sparkiscool/nox/nox/box/box-electronics.md

# Box electronics v1 (24 Oct 2026)

The box's electrical system end to end: mains to the 24 V supply, four rails, the box computer and its I/O, the stepper board, the keep-alive to the funnel panel probes, the two live bays and their charger, the swap state machine with every abort, wire gauges, connectors and the cut list. Numbers: `nox/box/box_electronics.py` (placement search, nets, drops, budget, cut list, diagrams); run `runs/box_electronics/v1/` (`result.json`, `diagram.html` with `schematic.svg`, `brake.svg` (the brake relay wiring and the keep-alive / seat-sense circuit), `layout.svg`, `states.svg`). Interface numbers: `nox/dimensions.md` I "Box electronics v1". Arm harness (the 22-wire twist bundle): `nox/box/box-wiring.md`. Buy rows: `nox/parts-list.md` Box. C unless tagged; board sizes spec or E; **DEFAULT** = chosen without Spark, alternative in `nox/log.md`.

No printed part: every board sits on nylon standoffs on the rear clear sheet, so nothing here goes through `solid_check`.

## What it is
| Block | Choice | Tag |
|---|---|---|
| Supply | Mean Well LRS-350-24 (on hand), 24 V 14.6 A, on the rear sheet (moved from the floor spot, see Layout); IEC C14 fused switched inlet; **set the PSU's 115 / 230 V selector to 115 V** | spec / DEFAULT |
| 24 V distribution | 6-way blade fuse box with negative bus: F1 10 A charger, F2 5 A motion (through the E-stop), F3 3 A keep-alive buck, F4 2 A logic buck, 2 spare | DEFAULT |
| E-stop | 22 mm mushroom, NC, in F2: cuts the SKR (steppers) and the servo buck (all 6 servos). Pi, keep-alive and charger stay on: the drone stays powered and the latch self-locks | DEFAULT |
| Keep-alive | XL4016-class CC/CV buck, **13.0 V CV, 3.0 A CC** (one setting for both drones: Scout ~8.5 W, Overseer ~24 W, E) → relay K1 → INA226 (0x41) → **2 spring pins in the +x plain funnel face (B+); 2 in the −x plain face (B−) = box GND**, panel v9 plain (keep-alive concept, `runs/keepalive_contacts/concept/` (catch, Spark 24 Oct: face probes, belly post and KW11 gone)); seat sense through the drone's 10 kΩ across its pads | E / DEFAULT |
| Servo rail | XL4016-class buck, **6.0 V** for all 6 servos (4 hook-latch MG90S, DS3218, MG995) | DEFAULT |
| Logic rail | 24 → 5.1 V 5 A buck (Pololu D36V50F5 class): Pi on its 5 V pins, relay JD-VCC, the 5 hall switches | DEFAULT |
| Box computer | **Raspberry Pi 4 B 2 GB** + GPIO screw-terminal HAT: Klipper host + Moonraker + `boxd` (the swap state machine, Python) | DEFAULT |
| Steppers | BTT SKR Mini E3 V3 (on hand), Klipper MCU over USB: X = head A, Y = head B, Z = axle, E spare | DEFAULT |
| Servos | PCA9685 (I2C 0x60, A5 bridged) on the Pi: ch 0..3 latch L1, L2, R1, R2; ch 4 gripper A (DS3218), ch 5 gripper B (MG995); 50 Hz | DEFAULT |
| Current sense | 3 x INA226 modules, shunt replaced by **R010 2512** (full scale 8.19 A, LSB 0.25 mA): keep-alive 0x41, bay S 0x44, bay O 0x45 | DEFAULT |
| Relays | one 4-ch 5 V opto board (SRD-05VDC-SL-C, 10 A 30 VDC): K1 keep-alive, K2 bay S, K3 bay O, K4 gripper servo power (stall cut) | DEFAULT |
| **Head and axle brake (arm v6 / v7 requirement, 24 Oct)** | **3 DPDT 24 V relays KB1 / KB2 / KB3 (Omron G2RL-2 DC24 class, 8 A contacts, spec), one per head motor and one on the axle motor, one pole per coil: de-energised (NC) each coil is shorted on itself, energised (NO) it is on its TMC2209; coils on the motion branch after the E-stop, switched by a bare ULN2003A from one SKR `output_pin` per motor, sequenced against the driver enable; self-test at every boot** (section Head brake) | DEFAULT / CHECK |
| Charger | dual-channel DC charger on the 24 V bus, **iCharger 456DUO class (MODBUS over USB to the Pi, CHECK that the 456DUO speaks the 4010DUO map before buying)**, input limit 6.5 A, end 4.15 V per cell, starts below 35 °C | DEFAULT / CHECK |
| Live bays | 2 (Spark 16 Oct: one per drone size): **Scout bay at −90°**, **Overseer bay at 180° (= −180°)**, both bays of that type in the v2 ring (box structure v2 layout, `dimensions.md` System box structure; arm v7 BAYS); 9 bays built (Spark 24 Oct), the other 7 bench-charged until more charger channels (Spark); each bay's XT60E1-M (float carrier) through its relay | DEFAULT |

**Why 6.0 V and not 6.8 V for the servos:** the MG90S is rated 4.8..6.0 V (E); one rail at 6.0 V serves all six with one buck. The grippers need ~0.18 N·m (E, `dimensions.md` I XT60 mate) against ≥ 1.0 N·m available at 6.0 V (E), so the 6.8 V of `box-wiring.md` bought nothing. Alternative: 6.8 V gripper rail + 5 V latch rail (two bucks).

## Gripper servos (heads v7, 24 Oct)
The head grabber's servo (DS3218 on head A, MG995 on head B) opens the blades with a printed cam on two 623ZZ rollers and needs only 2.3 kg·cm (C, heads v7). A DS3218 stalled on a jammed blade puts ~163 N on a roller (76 MPa Hertz on the PETG cam, it dents; heads v7, E). So (heads v7 ask, DEFAULT here):
- **Two dwell positions only:** `boxd` commands each gripper to open or rest, nothing between, and moves one gripper at a time.
- **Stall cut:** the shared 6.0 V gripper pair runs through relay K4 (the spare channel) and an INA226 (0x40; the PCA9685 moves to 0x60, A5 bridged, so every INA226 address is a plain A0 / A1 jumper, CHECK the modules). During a move the idle gripper's PWM channel is off and `boxd` reads the pair's baseline for 100 ms first (E); a rise over the stall threshold for 0.5 s (E) opens K4 and aborts the move (A5): DS3218 1.8 A, MG995 1.0 A (E, CHECK on the bench against the running current at 2.3 kg·cm). K4 cuts both grippers: in PRESTAGE head B waits open under the seat, so its gripper must hold open unpowered: heads v7 confirms both dwells hold unpowered (rest: the spring closes the carriers, the cam 1.0 clear of the rollers; open: both rollers on the cam's constant-radius open dwell, 10° wide, E, forces through the shaft and cancelling), on condition the open command lands inside that dwell (CHECK on the bench: the DS3218 / MG995 settle to about 1..2°, E).
- **Grip halls:** two analog halls per head (DRV5055A4 class, at 3.3 V) at the grip, as in the latch's seat check. Their 3.3 V comes from the rear sheet upstream of K4 (an AP2112K-3.3 on the 5.1 V bus, also feeding the ADS1115 at 3.3 V, so no hall output exceeds the ADC's VDD and the I2C pull-ups stay at 3.3 V), so they stay live through a stall cut and at boot. On each head the two outputs are summed 3:1 through resistors (10 k / 30 k, E) onto one line (DEFAULT): open / squeezed on either side give 4 distinct levels (E, CHECK on the bench); the ADS1115 (0x48) reads H_A and H_B single-ended against the ribbon's servo ground, so `boxd` samples them only with that head's servo idle (no current in the return, DEFAULT; alt: a hall ground of their own, a 6th ribbon conductor). Each head ribbon gains 2 wires (H, 3.3 V) and the twist bundle 3 (19 → 22, `box-wiring.md`). Alt: both hall lines per head (ribbon 6, bundle 24).

## Box computer I/O (Pi 4, BCM numbers)
| Pin | Use | Notes |
|---|---|---|
| GPIO 2 / 3 | I2C1 SDA / SCL, 100 kHz | PCA9685 0x60 (A5 bridged), INA226 0x40 / 0x41 / 0x44 / 0x45 (A0 / A1 jumpers, CHECK), ADS1115 0x48 (ADDR to GND, at 3.3 V); avoid 0x70 (PCA all-call) |
| GPIO 4 | PCA9685 OE | 10 kΩ pull-up to 3.3 V: servo outputs off until `boxd` pulls it low (no twitch at boot) |
| GPIO 5, 6, 7, 8 | relay IN1..IN4 (K1 keep-alive, K2 bay S, K3 bay O, K4 gripper servo power) | active low; these pins boot pulled up (relays off); SPI0 disabled; board VCC = Pi 3.3 V, JD-VCC = 5.1 V bus, JD jumper removed |
| GPIO 17, 27, 22, 23 | hook-latch halls L1, L2, R1, R2 | A3144 open collector on 5 V, 10 kΩ pull-up to 3.3 V at the HAT; **low = plunger fully out** |
| GPIO 24 | seat sense (replaces the KW11) | 100 kΩ (E) pull-up to 3.3 V at the HAT, a 1 kΩ series resistor, a 5 V TVS leaking ≤ 1 µA at 3.3 V (ESD9L5.0 class, CHECK) from the BAT54 side of the 1 kΩ to GND, then a BAT54 Schottky (anode toward the GPIO, cathode on the B+ line at the INA226 out, downstream of K1); an SMBJ15A on the B+ line takes ESD from the exposed pins. With K1 open a seated drone's **10 kΩ** (concept) pulls the pin to ~0.52 V (E, CHECK: 0.29 pull-up current on 10 kΩ + 0.03 on the 1 kΩ + ~0.2 BAT54 at 30 µA) = low = seated; **this needs an ideal diode on both drones** (concept: LM74700, reverse leakage ~µA); a Schottky ORing diode leaks up to ~100 µA warm (PMEG4050EP class, E), 1.0 V on 10 kΩ, over the Pi's 0.8 V low (then 2.2 kΩ, the alternative). The INA226 cannot read the concept's 1.3 mA with K1 closed: its ±10 µV offset on R010 is ±1 mA (spec). No drone = high; with K1 closed the line is at 13.0 V, the diode blocks and the pin reads high (`boxd` ignores it from LATCH_OUT to LATCH_IN, as the KW11 was) |
| GPIO 25 | INA226 0x41 ALERT | open drain, 10 kΩ pull-up; set at 2.5 A: fast trip for A3 |
| USB | SKR (Klipper), later the hub camera | |
Unit naming: L = the W −X seated face, R = +X; 1 = Y_C − 100 (stub side), 2 = Y_C + 100 (`dimensions.md` G Hook latch: drone ±y faces are W ∓X).

## SKR Mini E3 V3 (Klipper, `printer.cfg` sketch; pin names from Klipper's SKR Mini E3 V3 sample config, CHECK)
- `[printer] kinematics: none`; three `[manual_stepper]`: **head_a** on the X driver (PB13 / PB12 / PB14, UART addr 0), **head_b** on Y (PB10 / PB2 / PB11, addr 2), **axle** on Z (PB0 / PC5 / PB1, addr 1). TMC2209 UART PC11 / PC10.
- Heads: `rotation_distance` 50.27 (16T m1 pinion, `dimensions.md` I Rack and pinion v5), run current 2.0 A (XT60 insert), last 12 of an insert at ≤ 20 mm/s. Homing sensorless into a **park hard stop** (X / Y DIAG jumpers on, `endstop_pin: tmc2209_<stepper>:virtual_endstop`, 10 mm/s; the hard stop is the arm session's, PR "kept").
- Axle: `rotation_distance` 72 (degrees per motor turn at 5:1, 16T pulley, C from arm v7); home on the axle A3144 at Z-STOP (PC2, `^`, Z DIAG jumper off), then the detent picks the notch (`box-arm.md` Homing). **Per-bay gravity offset (required, arm v7 concept PASS, PR 79):** each bay's axle step target = its nominal angle + an offset in steps measured at commissioning (jog until the head's insert pose lines up with the bay receiver, store it in `boxd`'s bay table); without it the Overseer roll reads 1.19° against the XT60's ±1.06° float (C, arm). **Sag check** (DEFAULT): at commissioning and after any arm service, per bay, the head's roll at the insert pose with the offset applied is measured (inclinometer on the head flat) and must be ≤ ±0.55° (E: the residual the arm's XT60 budget allows, ≤ ~65 % of the Overseer's 0.85° free roll; the offset as designed leaves 0.43°, E, arm PR 79); a bay that fails is re-offset before use. **Slow notch pass:** every axle move runs ≤ 100 full steps/s (E, arm) through each detent notch it crosses and into the target notch, fast between notches.
- Stall: TMC2209 StallGuard on X / Y reported through `[gcode_button]` on the DIAG pins during fast moves; `boxd` aborts (A5). StallGuard is unreliable at the slow insert speed, so the gate there is the outcome check (mate current, full stroke).
- Hold: idle = the brake order (section Head brake): `MANUAL_STEPPER ... ENABLE=0` on all three, `G4 P30`, then all three brake pins to 0; Klipper's `[idle_timeout]` gets that as its `gcode:` (its default M84 would disable the drivers and leave the brakes released). The detent holds the arm at rest (`box-wiring.md`).

## Head brake (arm v6 / v7 requirement, hub 24 Oct)
**Why:** unpowered, a head carrying a cartridge outweighs the NEMA17's cogging and falls 77.6 (E, arm v7: head + carriage + cartridge onto the TPU bumper) with the driver off. With an Overseer cartridge that fall reads 2.43 on the 625ZZ (E), so the arm's gate is a passed bench drop before the first Overseer swap. With the Scout, the arm's fallback (sized for the fall, 0.83, E) holds. The numbers are in `dimensions.md` System box swap: arm (Head brake, Results; branch part/swap-arm-v7). With each coil shorted on itself, back-EMF brakes the fall to a creep: about 8 mm/s with a Scout head (391 g, E) and about 19..23 mm/s with an Overseer head (~930 g, E). That uses Kt 0.21 N·m/A and 1.4 Ω per coil, rising to ~1.75 Ω with the 26 AWG bundle, pigtails and contacts (E). It lands gently in both cases.
- **Contacts (3 relays, one DPDT per motor, one pole per coil):** pole common = coil wire 1, NO = driver output 1, NC = coil wire 2. Coil wire 2 also stays wired to driver output 2. **De-energised: each coil is shorted on itself and driver output 1 is open, so the driver is never shorted.** Energised: the coil is on its driver as usual. KB1 is on head A, between the arm bundle and the SKR X header; KB2 is on head B, on the Y header; **KB3 on the axle motor, on the Z header (arm v7, hub 24 Oct; kept, required with the boot self-test):** with the detent springs x1.3 at 5:1 the detent holds with a head out at a horizontal Overseer bay (index 1.04, no creep, E from arm v7 PR 79, which also has the brake damp the rest); the brake is the second line on a power cut. The axle runs 5:1 (16T pulley, C).
- **Coils:** 24 V, ~17 mA each (E), from the motion branch after the E-stop (F2). Each is switched low-side by one channel of a **bare ULN2003A** (DIP-16 on a small perfboard, COM pin 9 to the 24 V motion branch for its flyback diodes, pin 8 to the SKR's GND). Do not use a 28BYJ-48 "ULN2003 module": it is rated 5..12 V and its LEDs on COM take ~22 mA each at 24 V (E). **Power off, E-stop, F2 open, a Klipper shutdown or an MCU reset leaves the input low or floating, the relay drops and the brake is on.**
- **Signal (its own pin, never the driver enable):** one free 3.3 V (C, STM32 I/O) SKR pin per motor (EXP1, which pins: CHECK on the SKR Mini E3 V3 pinout), as `[output_pin head_a_brake]` (and `head_b_brake`, `axle_brake`) with `value: 0` and `shutdown_value: 0`. The order is fixed so that the relay never switches a live driver (Trinamic: never connect or disconnect a motor on an energised driver):
  - start: release the brake, dwell ≥ 30 ms, then `MANUAL_STEPPER STEPPER=head_a ENABLE=1` (the heads are `[manual_stepper]`s), then move;
  - stop: `MANUAL_STEPPER STEPPER=head_a ENABLE=0`, dwell ≥ 30 ms, then drop the brake pin. A carrying head is disabled only at its park stop (DEFAULT): off the stop it would drop ~6 mm (E) in the ~35 ms (E) before the NC contacts close, the short then carrying ~5 A (E), inside the 8 A contacts (spec).

  The dwell covers the G2RL's operate time (≤ 15 ms max, spec) and its release with the ULN's flyback diode (several times its bare ~5 ms, E). The motor is unbraked only inside that dwell. `boxd` never moves a head or the axle with an implicit auto-enable: every move goes through this sequence (DEFAULT); the axle is disabled only at a detent stop (DEFAULT).
- **Wiring:** the 8 head-motor wires come off the arm bundle at the rear sheet (26 AWG, C from `box-wiring.md`); the axle motor's 4 the same way. Each coil-1 wire goes to its relay common; each coil-2 wire goes to both its relay's NC and its driver output 2. Short 22 AWG (DEFAULT) pigtails run from NO to the SKR's X / Y / Z motor headers. The ULN board needs 6 wires: 24 V (COM + the 3 relay coil ends), GND to the SKR, and 3 inputs (24 AWG, E). The board sits on 2 nylon standoffs beside the SKR (rerun the placement with the real size, Problem 5).
- **Self-test at every boot (DEFAULT, arm v7 / hub), per motor, before homing:** the TMC2209's open-load flags (`ola` / `olb` in DRV_STATUS, `DUMP_TMC STEPPER=head_a REGISTER=DRV_STATUS` (`head_b`, `axle`: Klipper names a TMC by the section's last word), parsed by `boxd`) are valid only during slow motion (Trinamic datasheet note, CHECK), so both reads are taken during a slow commanded move in spreadCycle (`SET_TMC_FIELD STEPPER=head_a FIELD=en_spreadcycle VALUE=1` for the test, stealthChop back on after for the sensorless homing): (1) **brake off first** (release, dwell 30 ms, enable; so stealthChop's standstill tuning never sees an open coil, CHECK): 8 full steps out and back at ~2 full steps/s (E): `ola` = `olb` = 0 (proves NO closed, coil whole); (2) disable, dwell 30 ms, **brake on**, dwell ≥ 50 ms (DEFAULT: the NC contacts close ~35 ms after release, E), enable, the same slow move: `ola` = `olb` = 1 (output 1 open on NO: proves both poles opened; the shaft does not turn); (3) disable, dwell, brake stays on. Then the normal homing (heads into the park stop, axle on its hall) proves motion. Any mismatch: `boxd` stays in FAULT, no swap, a log line naming the relay. The NC short itself has no sense path; the bench drop proves it once.
- **Bench drop test (current-parts Spark, Tests):** a head carrying a loaded **Overseer** cartridge (~930 g with head and carriage, E), driver off, brake on, released at the top of its stroke. It must creep (≤ ~25 mm/s, E: 77.6 in ≥ 3.1 s) and land without a bang. Repeat with the relays dropped by the E-stop. Then once with a Scout cartridge (391 g, ≤ ~10 mm/s, E).

## Keep-alive and mate check (no current is ever switched by the XT60 or the panel probes)
1. K1 closes only after the latch is out, while the drone's old pack is above 13.0 V: 0 A through the pads (the drone's ORing diode is reverse biased).
2. The pull unmates the drone XT60; the pads take over: INA226 0x41 reads > 100 mA at the end of the pull stroke.
3. The new pack mates: the drone bus rises above 13.0 V and the box current falls: **< 50 mA within 1.0 s = mate** (`dimensions.md` I XT60 mate).
4. K1 opens at ~0 A; the pins are dead before the latch goes in and the drone lifts off.
**Face pins (the catch's, keep-alive concept, `runs/keepalive_contacts/concept/` (catch, Spark 24 Oct: face probes, belly post and KW11 gone)):** 2 spring pins per plain ±x face of panel v9 plain (B+ on +x, B− on −x), ~1.5 A each, travel 7.5, on a 22 x 12 copper pad on the drone's lower ring; the pin follows the pad from landing through the XT60 lift (pressed ~6 at seat, 2.0 at the top), so WAIT_SEAT sees the drone before LATCH_OUT (concept). + on the INA226 output, − to the keep-alive buck's −; the 10 kΩ seat-sense resistor sits on the drone across its pads. **Drone side (Scout v3, Overseer):** an ideal diode (LM74700) from the + pad into the bus on both (the seat sense needs its low leakage) and ~1.2 mF (Scout) / ~4.5 mF (Overseer) (research 2026-10-11, E); the drone must run from ~12.9 V during the swap (13.0 less the ideal diode's drop, E).

## Live bays and charging
- Charger CHn + → relay Kn → INA226 (bay side) → 16 AWG → the bay's XT60E1-M +; **CHn − goes straight to the bay's XT60 −, never to box GND** (it would bypass the charger's own current shunt). The INA226 reads the bay's bus voltage through the charger's input ground: check with a meter that each CH − is within 1 Ω of the charger's input − (non-isolated, E, CHECK); if isolated, tie each CH − to the GND bus at one point.
- **A bay mates and unmates only with its relay open:** before any head move into a live bay, `boxd` stops the channel, waits for I < 50 mA, opens the relay (A9 interlock). After a store, **bay mate = bus voltage 13.0..17.0 V with the relay open** (the INA226 bus input, ~830 kΩ, is the only load). The relay then closes onto the idle charger (inrush into the charger's output capacitors on the relay contacts, never on the XT60) and the channel starts.
- Charge end: the charger's done flag, or current under C/10 with a rest voltage ≥ 4.15 V per cell read through the open relay. Scout bay 2C (3.0 A), Overseer bay ~1C (6.0 A) under the 6.5 A input limit (E).
- The other bays hold bench-charged packs. Rotation rule (DEFAULT): take the fullest pack; the dead pack goes to the live bay when it is free, else to the free bay, and the arm shuffles the live bay while the drone flies.

## Layout (rear sheet, `box_electronics.py` search)
Everything electrical sits on the **rear clear sheet's inner face (Y −66)** and the floor behind the stub, in Y −66..−2: the stub face is Y 0 and the motor bodies start at Y 2 (`dimensions.md` I), so nothing reaches the arm sweep. Boards on **10 mm nylon M3 standoffs**, holes drilled in place through each board's own holes (≥ 15 from a sheet edge, as every sheet hole). Wire the whole sheet flat on the bench, then stand it in; only the arm bundle, the latch leads, the 2 panel probe leads and the bay leads cross to the rest of the box.
- **PSU on the sheet:** X 42..157, Z −170..45, its bottom face on the sheet with 4 x M4 x 6 through the 3.0 sheet (3.0 thread engagement = the spec max), terminal end up, air out the bottom end 31 over the floor. **The floor spot in `box-stand.md` (X 25..89, Y −50..−10, kb keep-out) is 64 x 40 and cannot take a 215 x 115 x 30 PSU**; it is released (stand part: "kept").
- **Charger** standing on the floor against the sheet, X −162..−44, Z −200..−29, Y −66..−7 (5 to the stub face), strapped through 2 sheet holes. IEC inlet over the PSU (X 78..128, Z 56..86, cut-out 48 x 28 E); E-stop X 112..152, Z 188..228 (hole 22.5).
- Keep-out: mast + kb X ±40, Z ≤ 50 (mast X ±30, head top Z 40, + 10). The arm bundle leaves the stub v3 lead channel at X −27 and drops beside the mast to the SKR.
- **Search:** 14 boards placed by simulated annealing over centres (2.5 grid) and 90° turns, legal moves only (sheet X ±160, Z −195..232, 6 board-to-board, keep-outs), objective Σ conductors x (0.25 + I cont) x route length; 12 seeds, best taken (`result.json` `search`). Result (centres, W X / Z): SKR (−22.5, 185); relay (−112.5, 10); INA226s keep-alive (−82.5, 62.5), bay S (−57.5, 10), bay O (−137.5, 55), gripper (−32.5, 67.5); ADS1115 (145, 65); fuse box (97.5, 125); keep-alive buck (−5, 120); servo buck (70, 185); Wago bus (35, 72.5); PCA9685 (−95, 182.5); 5 V buck (−127.5, 170); Pi (−117.5, 115). Closest pair 6.0 (ADC to PSU, C); every board inside Y −2 (C).

## Nets, gauges, drops (`result.json` `nets`; E resistance and ampacity tables in the script)
| Net | Wire | Peak A | Drop at peak (C on E lengths) |
|---|---|---|---|
| Mains (IEC → PSU) | 3 x 18 AWG, fork crimps, PE to the PSU FG | 6.8 (115 VAC, spec) | |
| PSU → fuse box | 2 x 14 AWG | 11.9 | 0.16 % |
| F1 → charger | 2 x 16 AWG (charger input plug CHECK) | 6.5 | 0.33 % |
| F2 → E-stop → SKR, servo buck | 2 x 18 AWG | 5.2 | ≤ 0.12 % |
| F3 → keep-alive buck; F4 → logic buck | 2 x 18 / 2 x 20 AWG | 1.8 / 1.0 | ≤ 0.07 % |
| Keep-alive → K1 → INA → +x panel probes, −x panel probes | 18 AWG | 3.0 | 0.28 + 0.11 % |
| Charger → K2 / K3 → INA → bay XT60, CH − → bay | 16 AWG | 6.5 | ≤ 0.29 % |
| 6.0 V servo bus; → PCA9685 V+ | 2 x 18 AWG | 8.0 / 3.2 | 0.83 % |
| 6.0 V gripper pair (in the twist) | 2 x 22 AWG | 5.0 (both stalled) | 2.3 % via K4 and INA226 0x40 (servo rail rule 10 %) |
| Latch servos (PCA ch 0..3 → unit) | 3 x 22 AWG servo extension, stock plug at the servo | 0.8 | ≤ 0.86 % |
| Latch halls, seat sense, axle hall, PWM | 3 / 2 x 28 AWG | signal | |
| Steppers (SKR → motor, through the twist) | 4 x 26 AWG each (`box-wiring.md`) | 2.0 | 1.0 % |
| 5.1 V → Pi pins 2 / 4, 6 / 9; → 5 V bus | 2 x 20 AWG | 3.5 | 0.30 % |
| I2C chain Pi → PCA → INA x3; relay IN | 4 / 5 x 26 AWG | signal | |
| GND bus → fuse box negative bus (star) | 18 AWG | 8.0 | |
Every net is inside its E ampacity (`result.json` `checks`).

## Connectors
| Where | Connector | Qty |
|---|---|---|
| Mains | IEC C14 fused switched inlet + cord; fork crimps M3.5 on the PSU (3 mains, 2 x 14 AWG out) | 1, 5 |
| Bays | XT60E1-M panel mount on each live bay's float carrier, 16 AWG soldered (the drone receiver's is the Scout's) | 2 |
| Bay leads at the sheet | XT60 pair inline (sheet side female, bay side male) so the sheet unplugs | 2 |
| Panel probes | 3.5 mm bullet pair per panel, one conductor each (keep-alive B+ on +x, B− on −x), inline at the sheet | 2 |
| Latch units | servo plug at the PCA9685 header (22 AWG extension), hall soldered + heat-shrink at the housing, ferrules at the HAT | 4 + 4 |
| Steppers | JST-XH 4-pin crimped at the SKR end (motor ends keep their pigtails, `box-wiring.md`) | 3 |
| Axle hall | JST-XH 3-pin at Z-STOP (VCC from the 5 V bus) | 1 |
| Gripper servos | signal + GND into PCA ch 4 / 5 (3-pin housing, V+ pin empty); power pair into the 6.0 V Wago | 2 |
| Buses | Wago 221-415 (6.0 V, 5.1 V, GND) | 3 |
| Screw terminals (fuse box, bucks, relay, INA226, HAT) | bootlace ferrules on every stranded end | ~60 |
| Pi → SKR | USB-A to USB-C, 0.3 m | 1 |

## Cut list (sheet side; +20 % and 2 x 20 strip, E; arm side in `box-wiring.md`)
- **14 AWG** red / black: PSU → fuse box 2 x 275.
- **16 AWG** red / black: F1 → charger 2 x 595; CH1 + → K2 225, K2 → INA 110, INA → bay S 725, CH1 − → bay S 605; CH2 + → K3 225, K3 → INA 125, INA → bay O 475, CH2 − → bay O 560.
- **18 AWG** red / black: F2 → E-stop 2 x 200; E-stop → SKR 2 x 270; E-stop → servo buck 2 x 160; F3 → keep-alive buck 2 x 170; buck → K1 305, K1 → INA 140, INA → +x face pins 730, buck − → −x face pins 325; servo buck → bus 2 x 220; bus → PCA V+ 2 x 330; GND bus → star 180; mains 3 x 205 (3-core cord).
- **20 AWG**: F4 → 5 V buck 2 x 365; 5 V buck → Pi 2 x 120; → 5 V bus 2 x 355.
- **22 AWG**: latch servo extensions 3-core L1 305, L2 545, R1 535, R2 775; relay JD-VCC 2 x 295; gripper 6.0 V bus → K4 295, K4 → INA 0x40 205.
- **26 AWG**: relay IN + VCC 5 x 175; I2C 4-core 150 + 200 + 135 + 190 + 185 + 260; INA 0x41 ALERT to GPIO 25, 1 x 300 (E, laid with the I2C chain).
- **28 AWG**: latch halls 3-core L1 355, L2 595, R1 640, R2 880; seat sense 1 x 145 (GPIO 24 → 1 kΩ → BAT54 at the INA226 out); grip halls 3 x 555 (H_A, H_B, 3.3 V) to the stub exit (board end; arm side in `box-wiring.md`).
- **Arm bundle fixed tails (stub exit → board), now from the layout:** steppers and axle hall 268, servo pair 152, servo signals 330, grip halls 316 (C on E positions; the placement moved with the gripper INA226 and the ADS1115). Totals per gauge, every net end to end incl. the bundle: 14 AWG 0.6 m, 16 AWG 4.2 m, 18 AWG 5.0 m, 20 AWG 1.7 m, 22 AWG 8.3 m, 26 AWG 13.9 m, 28 AWG 12.3 m (`result.json` `wire_totals_mm_by_awg`).

## Power budget (E; `result.json` `budget`)
| Load | Rail | W cont | W peak |
|---|---|---|---|
| Pi 4 + HAT + a later USB camera | 5.1 V | 6.0 | 9.0 |
| relay coils, halls, PCA, INA logic | 5.1 V | 0.9 | 1.6 |
| SKR + 3 NEMA17 at 2 A (drivers off while idle) | 24 V | 1.5 | 30 |
| 2 gripper + 4 latch servos (budgeted together) | 6.0 V | 1.8 | 49 |
| keep-alive (CC 3.0 A at 13.0 V) | 13.0 V | 8.5 | 39 |
| charger, input limit 6.5 A | 24 V | 156 | 156 |
| **at the PSU (bucks 90 %)** | 24 V | **177** | **296 = 85 % of 350 W (12.3 A)** |
The research's ~600 W of nonstop 2C charging does not fit the LRS-350; the 6.5 A charger input limit keeps the box under it with the Overseer bay at ~1C. Alternative: an LRS-600-24 for the charger alone (research 2026-10-11).

## Swap state machine (`boxd`; DEFAULT, times E; `states.svg`)
| State | Action | Pass | Limit | Fail |
|---|---|---|---|---|
| IDLE | drone away; live bays charge; heads parked; K1 open; latch in | swap request from the mission script | | |
| PRESTAGE | head A picks the fullest charged pack (its bay relay open, I < 50 mA first); head B waits open at 81 under the seat | both heads at pose, no stall | 6 s | A5 |
| WAIT_SEAT | drone lands under its own landing mode, kill at first touch | seat sense low 100 ms | 30 s | mission retries |
| LATCH_OUT | PCA ch 0..3 to OUT (per-unit pulse from calibration); seat sense ignored from here | all 4 halls low | 0.5 s | A1 |
| KA_ON | close K1 (old pack higher: 0 A) | bus 12.8..13.2 V, I < 0.5 A for 0.2 s | 0.5 s | A3 |
| PULL | head B rises to 89.6, closes, retracts with the dead pack (XT60 unmates) | full stroke, no stall, I > 100 mA at its end | 2 s | A4 |
| TURN | axle 90°: head A to the top, ≤ 100 full steps/s through each notch, step target + the bay's gravity offset | no stall, hall matches phi | 1.1 s (E: ~0.5 s for the slow notch pass) | A5 |
| INSERT | head A extends, last 12 at ≤ 20 mm/s, to the bolt seat, 1 over-travel into the TPU strip | full stroke | 2 s | A5 |
| MATE_CHECK | hold the stroke, read INA 0x41 | I > 100 mA seen during INSERT (the pins carried the drone), then I < 50 mA (the new pack took over); CHECK: also the drone's bus voltage ≥ 14.0 V (E) over the mission link | 1.0 s | A6 |
| RELEASE | gripper opens, head A to park | park, no stall | 1 s | A5 |
| KA_OFF | open K1 at ~0 A | I < 50 mA before, bus < 1 V after | 0.3 s | A3 |
| LATCH_IN | PCA ch 0..3 to IN, only with a pack mated (MATE_CHECK passed) | all 4 halls high | 0.5 s | A11 |
| READY | SWAP_DONE to the mission (it arms the drone); take-off | seat sense high | 60 s | mission decides |
| STORE | axle to the free bay (the live bay when free); head B inserts the dead pack, bay relay open | full stroke | 4 s | A5 |
| BAY_MATE | read the bay INA bus voltage, relay open | 13.0..17.0 V | 1.0 s | A7 |
| CHARGE | close the relay at 0 A, start the channel | done flag, or I < C/10 and rest ≥ 4.15 V/cell | | A8 |
| CHARGE_END | stop the channel, wait I < 50 mA, open the relay | relay open | 5 s | A8 |
The box never arms or disarms the drone: it disarms on the kill and the mission script arms it after SWAP_DONE. The swap request comes from the mission script over the network (Moonraker JSON-RPC, DEFAULT).

## Aborts
**Pack-out hold (box catch PR 93, DEFAULT):** the hook latch never retracts while the drone's pack is out. With the pack out the face pins' spring force lifts 2.8 of a Scout's 3.3 N and puts a 48 N·mm yaw couple on it (C, `box-hook-latch.md`), so only the latch holds the drone. Every abort after PULL keeps the latch OUT and K1 closed until a pack mates (mate check passes; then the normal KA_OFF, LATCH_IN) or a person lifts the drone off (A12). LATCH_IN runs only after MATE_CHECK has passed (or before PULL, with the old pack still in). Alt: the B− pins at y +12 / +22 (C, catch), which moves the Scout's −x pad.

| Abort | Trigger | Action |
|---|---|---|
| A1 latch not out | a hall still high 0.5 s after OUT | all 4 IN, OUT once more; second fail: IN, SWAP_FAIL, the drone keeps its pack (nothing has moved) |
| A2 latch lost mid-swap | a hall goes high between LATCH_OUT and LATCH_IN | stop all motion, K1 as it is, alarm (the plungers self-lock under load) |
| A3 keep-alive fault | bus outside 12.8..13.2 V, or I > 2.5 A for 0.2 s (ALERT) with the old pack in, or K1 will not open at 0 A | open K1; before PULL: SWAP_FAIL with the old pack in; after PULL: alarm, K1 and the latch stay as they are (pack-out hold) |
| A4 pull / keep-alive lost | I < 100 mA at the end of the pull | the pack did not come out or the pads did not make: head B re-inserts what it holds; the keep-alive current cannot prove a mate here (the pins were not carrying), so always the pack-out hold (latch OUT, K1 closed), SWAP_FAIL, alarm; Spark clears it (DEFAULT; alt: LATCH_IN on the drone's bus voltage ≥ 14.0 V (E) over the mission link, CHECK) |
| A5 stall | TMC2209 DIAG on a fast head move, Klipper shutdown, E-stop, the axle hall out of its window, or the gripper pair (INA226 0x40) over its stall threshold for 0.5 s | stop all motion, latch stays out, K1 as it is (closed with the pack out: the drone stays powered); a gripper stall also opens K4 (both grippers unpowered); alarm; Spark clears by hand, heads re-home before the next cycle |
| A6 mate fail | I ≥ 50 mA 1.0 s after the full stroke | back off 5, push again once at 10 mm/s; still ≥ 50 mA: pull the pack back into head A, the drone stays on keep-alive (no time limit), alarm |
| A7 bay mate fail | bay bus not 13.0..17.0 V with the relay open | re-insert once; then leave the pack uncharged, alarm (off the flight path) |
| A8 charge fault | charger error, bay I > 7 A, pack over 45 °C (charger probe, CHECK), or no current 5 s after the start | stop the channel, wait I < 50 mA, open the relay, mark the pack |
| A9 bay interlock | a head move into a live bay with its relay closed or I ≥ 50 mA | refused before the move |
| A10 seat lost | seat sense high before LATCH_OUT | back to WAIT_SEAT |
| A11 latch stuck out | a hall still low 0.5 s after IN | OUT, IN once more; then alarm, no SWAP_DONE: the drone sits disarmed on its new pack |
| A12 keep-alive at 0 A, pack out | after PULL, no pack mated, keep-alive I < 50 mA for 2 s (E) | open K1 (~0 A by then) and read seat sense: high (no 10 kΩ, the drone was lifted off) → latch IN, SWAP_FAIL, alarm; low (the drone is still seated: pins lost contact, or K1 / buck / F3 failed) → latch stays OUT, alarm "keep-alive lost" (DEFAULT, catch PR 93) |

## Interfaces other parts use (`dimensions.md` I "Box electronics v1")
- Face pins (box catch PR 93, panel v9 plain): 2 brass spring probes in each ±x A panel, ~1.5 A a pin (catch), 13.0 V CC 3.0 A behind K1 on +x, GND on −x; one 18 AWG conductor per panel (+ on +x, − on −x) from the sheet top, a 3.5 mm bullet pair inline at the sheet; seat sense on the + line (GPIO 24 through 1 kΩ and a BAT54).
- Drone (Scout v3, Overseer): an ideal diode (LM74700) + bulk capacitance on the + pad; 10 kΩ across its two pads (seat sense); 22 x 12 copper pads on the lower ring (concept), dead unless K1 is closed; runs from ~12.9 V during a swap.
- Arm (v5 rails): a park hard stop per head for sensorless homing; drivers at 2.0 A.
- Hook latch: per unit one 3-core 22 AWG servo extension (stock plug) + one 3-core 28 AWG hall lead; plunger OUT = hall low.
- Stand: the electronics own Y −66..−2 behind the stub on the rear sheet; the PSU leaves the kb floor spot; 4 x M4 + standoff holes drilled in the rear sheet in place; charger strap holes.
- Bays: Scout live bay −90°, Overseer live bay 180°; XT60E1-M + 16 AWG pair per live bay.

## Problems
1. **Driver heat in a closed box:** TMC2209 at 2.0 A on the SKR without a fan. The detent keeps the drivers off between moves, so the duty is low (E). Check the driver temperature in the first soak test; fix = the priced 24 V 4010 fan on SKR FAN1 (`controller_fan`) over the drivers on 2 standoffs.
2. **Charger protocol (CHECK before buying):** the MODBUS map names only the 4010DUO (sold out). Without a protocol, the alternative (2 x ISDT PD60 on USB-C bricks, or a ToolkitRC M8D) charges but someone presses start; the box still switches relays and reads every number it needs through the INA226s.
3. **Charge without balance leads:** `dimensions.md` I Balance charging drops the balance lead; most balance chargers refuse a LiPo program without it. CHECK the charger's non-balance LiPo mode (iCharger: yes per its menu, E); else the bays need the balance path back (Spark).
4. **Face pins** (Q20, box catch's part): spring pins ~1.5 A, travel 7.5 in panel v9 plain; their model and the drone pads are the catch's (was: pogo pins with ≥ 8 travel on a belly post).
5. **Board sizes E** (relay, INA226, bucks, fuse box, Wago strip): the placement keeps 6 between boards; re-run `box_electronics.py` with the real sizes when they arrive (a minute), then drill.
6. **Route lengths are E** off the sheet (latch, panel probes, bays): cut long, trim at fit.
7. **PSU on 3.0 acrylic:** 0.76 kg on 4 x M4 with 3 of thread; add 2 fender washers outside (E). The 115 / 230 V selector: CHECK before first power.
8. **Charger output and input grounds:** measure (Live bays section) before wiring the bay − leads.
9. **Brake pins and the self-test (CHECK):** which free SKR Mini E3 V3 pins take the three brake `output_pin`s (EXP1); on the bench, that `ola` / `olb` read 0 / 1 reliably in the slow spreadCycle move with the brake off / on (and whether they behave in stealthChop); and `boxd` must route every head and axle move through the brake sequence (an implicit Klipper auto-enable would energise the driver with the brake on: harmless to the driver, since its outputs are open on NO, but the head would not move).

## Status
24 Oct (box structure system session, hub ask): brake on the axle too (3 relays), boot self-test (section Head brake). Earlier: head brake added: 2 DPDT relays, bare ULN2003A, its own SKR pin per head sequenced against the enable; bench drop with the Overseer cartridge in the Spark Tests line.
24 Oct: v1 designed (docs + `box_electronics.py` + `runs/box_electronics/v1/`). Next: Spark buys (`parts-list.md` Box, status to buy); bench-wire the rear sheet; first power with no loads (rails 13.0 / 6.0 / 5.1, K1 at 0 A); latch calibration (OUT / IN pulse per unit until its hall reads); mate check on the bench with a pack and the drone receiver.
