sparkiscool/nox/runs/keepalive_contacts/concept/summary.md

keepalive_contacts concept: visual only (not a part yet)
Artifact: https://claude.ai/artifact/Vq39eVb3z1mKJnuXByFjie (source keep_alive.html here)
Design: spring pins in the plain funnel faces (panel v9 plain, next) on a copper pad on the drone lower ring; numbers in nox/dimensions.md G (6) / (8) when v9 plain lands.
