sparkiscool/nox/nox/dimensions.md

# Nox: dimensions (current values only)

The only source for Scout and box numbers. mm unless stated. Tags: P part, M mesh, C CAD, E estimate. **CHECK** = unconfirmed. Changes: one line in `nox/log.md`. Rules: `CLAUDE.md`. Box system: `nox/box/box.md`. Sections E, G, H and J hold Scout v2 numbers carried into v3 until v3 replaces them (`archive/scout-v2/` for the v2 design).

**Coordinates.** Drone axes: x forward (nose +), y left +, z up, CG at x 0. Plate top z 22; z 0 is the old pusher prop plane (kept so part numbers stay valid). **Props are on top since 14 Oct 16:41: prop plane z ≈ +41.2 (E: plate top 22 + D12 19.2, listing; Spark 17 Oct 00:52: go with it; row "Motor / prop layout" in C).** Rows below that still describe props at z 0 (prop rule in H, the underside's below-the-props placement) are pusher-era until their chats update them (`nox/current-parts.md` Scout v3 row). Each part doc defines its own part coordinates.

## A. Bought hardware (Scout)
| Item | Value | Tag |
|---|---|---|
| Frame | SpeedyBee Bee35 arm plate, 153 wheelbase, ducts off; details in C | P |
| Props | Gemfan 3520, 3.5 in (r 44.45), 3 blade; hubs at (±54.1, ±54.1); tips span ~197 square | P / C |
| Motor shaft / prop mount | Ø3 motor shaft; prop on a T-mount, Ø1.5 locating shaft, two M2 (section M, 22 Oct) | C / spec |
| Battery 4S 1500 | 70 x 32 x 33, 165 g; leads and balance lead out one end | P |
| FC MicoAir743 AIO | 36 x 36 diamond at (1.9, 0) (was 35 x 35; MicoAir spec, section M, 22 Oct), hangs under the plate on standoffs; USB-C at the tail corner, slightly right. Board detail: section H | P |
| Camera | DECXIN 2633V2 global shutter, 102° diagonal; board 38 x 38, M2.5 on 28 x 28 (Spark 23 Oct: the board takes M2.5; read as M2 before), M2.5 heat-set inserts in the mount (E: OD 3.5 x 5.7, hole Ø3.2) | P / E |
| Flow sensor MTF-02P | board 22 x 16, 8 tall (P, spec 6.5 CHECK), 1.5 g; lens 6 from the nose edge and 6 from the drone-right edge; plug exits the tail; `SENS_FLOW_ROT 4` | P |
| Companion Radxa Zero 3W | section H | C |
| Firmware, radio, wiring | `nox/scout/scout.md` | P |

## C. Scout shared numbers
| Item | Value | Tag |
|---|---|---|
| All-up now | about 500 g | Spark 23 Oct, approximate (P reading CHECK) |
| All-up target | none (Spark 23 Oct: no weight target) | Spark |
| Frame | Bee35 arm plate, every mount cut off except the arms and the FC area (Spark 8 Oct). Listed as 3.5 thick carbon; bare mass 24 to 32 g. Still has the v1 pocket holes and the XT60 cut-out (Spark 11 Oct). **Motor centres 153 apart on both diagonals (Spark 12 Oct 21:33, P): motors at (±54.1, ±54.1).** **Width at the side bolts about 94 across, edge at y ±47 (E, 93.8 M).** The XT60 cut-out sits at the tail edge of the plate; Spark can grind the plate end shorter if needed. Plate tail end about x -50 (E, CHECK). **Plate is the carbon one, 3.5 thick (D8, Spark 17 Oct 00:52; listing 3.5): underside z 18.5, top 22** | P / listing / E, CHECK: weigh |
| Frame plate decision line | under ~22 g keep it; over that, quote a 3 mm X plate with narrower arms (~20 g) | E |
| Motor / prop layout | **tractor: motors on top of the arms, props above (Spark 14 Oct 16:41; was pusher).** **Prop plane z ≈ +41.2 (D12 = arm top to prop hub face 19.2: EMAX ECO II 2004 listing height, E; Spark 17 Oct 00:52: go with it, not caliper-measured; was 40.5)**, blade sweep ±4. Motor centres unchanged. Standard (not reversed) props on top; motor spin directions re-checked after the flip (PX4 quad X, Actuators test) | Spark / listing / E |
| Prop gap | closest reach of two diagonal props 65 (Spark 12 Oct 21:39, P) = 153 - 89 disk; adjacent disks 19 apart. **Centre strip \|y\| ≤ 9.6 is never reached by a disk at any x or z.** Disk edge is 13.8 from (±32.5, 0) and 9.6 from (±54.1, 0) | P / C |
| Battery | **XT60 back, contact pads dropped (Spark 23 Oct: the touch contacts won't work). Pack still under the drone on the bottom latch (DEFAULT); the swap push now has to mate and the pull unmate an XT60 (box chat). Older text:** contact pads, no XT60 (Spark 8 Oct); kept over the XT60 for the machine-only swap, subject to the bench gate in `archive/scout-v2/s2-contacts.md` (Spark 12 Oct). **Mounted under the drone, installed from below straight up on the drone axis, held by the S2 bottom latch (Spark 14 Oct 16:31 / 18:12 / 21:56; section J)** | decided |
| Contacts | **Retired 23 Oct (Spark: XT60). History:** Mill-Max 0854-0-15-20-82-14-11-0 spring pins on the drone, hard-gold PCB strips on the cartridge sides (Spark 12 Oct); 1000 µF 35 V low-ESR cap on the drone bus; INA226 in the box for an after-swap resistance check. **8 pins horizontal, B+ 4 left, B- 4 right, straight to the bus, no diodes; pads make only after the latch seats.** Same pins and strips in every charging bay. Positions follow the bottom layout (current-parts Problem 31); pin and strip data in section E | Spark 11 / 12 Oct, DEFAULT 14 Oct |
| Flight current | hover about 6 to 10 A, bursts 30 A+ | E, not measured |
| Battery swap | **Box swap wheel (Spark 14 Oct 18:12 / 19:26 / 21:56, `nox/box/box.md`; arm v4 16 Oct, `nox/box/box-arm.md`):** the drone lands in the static collar funnel, the hook latch holds it (23 Oct; was an electromagnet), two pogo pads keep it powered. Under it a vertical wheel on one horizontal axle: bolted bay modules round it (the box's standing frame), the drone position at the top, and two 2040 bars at 90° on the axle, one head each. Each head = a two-finger gripper on a belt-driven carriage; the fingers squeeze the cartridge's two central tabs: that grips the pack and retracts its side bolts in one motion. Pack out: squeeze, retract. Pack in: extend with the pack held, open the fingers, the bolts spring into the pockets (drone and bays alike). **Cartridges lie long side along the axle (Spark 16 Oct 17:34): a wheel turn rotates a pack, never mirrors it.** Section I | Spark 14 / 16 Oct, C 16 Oct |
| Cartridge | **v3 (16 Oct 19:15, `archive/scout-v2/s2-cartridge.md`, `archive/scout-v2/s2_cartridge.py`, `archive/scout-v2/tray_to.py`): flat-bottom box 38 x 48 x 79, 40 over the full-length guide rails; tabs sunken in a recess in the bottom (Spark 15 Oct 01:17); generated tray (run 4, fixed 2.0 plates) 20.1 g + latch block 6.3 g (M); drone receiver v1 with 30° lead-ins (±3.3 capture) carries the pockets and pin blocks, 18.6 g (M) (Spark 16 Oct 17:51 / 17:54: centering, function first).** Positions on the drone from the bottom layout | C 16 Oct |
| Prop protection | **S2 guard v2 (16 Oct 19:02 / 19:33): two rings around the raised prop plane, side contact only, top and bottom open; 8 print-in-place PETG wheels built into the corner nodes are the catch contacts (no pyramid, no foot frame).** Mount: 2 side hubs on the side plate bolts + 1 tail hub under the plate carry 3 struts; 4 floor feet tie in by legs to the side hubs. Section G | Spark 12 Oct / 16 Oct 19:02, DEFAULT 14 Oct |
| Box catch | **static collar funnel v4 on top of the box (Spark 16 Oct 19:02 / 19:33, all PETG): 4 flat 45° faces, 76 tall, mouth 320 square, open bottom 168 square; the drone's 8 node wheels roll down the bare PETG faces and centre.** The drone lands under its own control, seated switch, electromagnet on. **One funnel for both drones (Spark 12 Oct 22:37); the only shared numbers are the catch interface (section G).** The pack hangs through the open bottom to the swap wheel's top head (section I). Section G, `nox/box/box-funnel.md`, scripts `archive/scout-v2/catch_v4/` | Spark 16 Oct 19:02 |
| Camera | redesigned for v2 (Spark 12 Oct 21:20); placeholder: board centre z 5, 13° up, lens x 92.7, outside the prop disks. **Collar keep-out: bottom above z 13 at x 95 (section G)**. Mount owner open (nose bracket). Recheck against the new prop plane (Problem 33) | E, open |
| Underside | S2 underside (Spark 12 Oct 22:13 / 22:22): one stack under the plate on the drone axis, top to bottom FC, Radxa, flow sensor. Section H. **The bottom pack now shares this space (Problem 31)** | Spark 12 Oct |
| Prop keep-out | 12 from the prop disks and ±4 sweep. **One exception (Spark 14 Oct 01:25): the S2 underside's nose post (x 33.5 to 38.3, \|y\| ≤ 2.5) sits ≥ 9.5 from the front disks in plan (9.52, C)**; the Radxa's front corners 7.8 from the disk + sweep. Both moot once the props are up (Problem 33) | C, Spark 14 Oct |

## D. To measure (Spark)
Closed 17 Oct 00:52 (Spark: go with these, carbon plate): D8 plate thickness 3.5; D12 arm top to prop hub face 19.2 (listing, E). Both in section C.
1. Bare Bee35 arm plate (g), next time it is apart.
2. The cage alone (g), or the drone without the battery (g), and which cage is fitted.
3. Exact all-up scale reading.
5. Motor base temperature after a full-pack hover (decides what may be printed near the motors).
6. Pin as delivered: body / collar diameters (bore 3.4 E; potted, so a few tenths only change the epoxy).
7. Hover scatter over the box, 2 min ulog, tag fused: sigma x, y, z and yaw. Not a gate; sets the funnel size (Problem 36).
9. MG90S on hand? (head gripper, section J).
10. Overseer: pack size done (148 x 48 x 45, Spark 16 Oct 19:02); still pack mass, landing gear height and skid spacing, lowest point under the frame plate.
11. ~~Electromagnet~~ retired 23 Oct (hook latch).
13. Arm hardware (section I, last row): NEMA17 length and boss, 80T pulley OD / width / boss / web, 20T width, idler OD / bore / width, slip ring body and flange, servo body / ears / shaft offset. One number at a time, before the hub and head prints.
14. Wheel coupon: one printed corner node with its print-in-place wheel on a printed PETG 45° face: the wheel turns free after printing (no fused pin), and the node slides sideways on PETG at μ ≤ 0.4 (section G gate).
15. Head belts (nox/box/box-arm.md "Head belt clamp v2" (tension bullet)): weigh the 918 spare GT2 6 mm piece (g, for the pluck target's g/m); the M3 heat-set inserts' OD and length; belt clamp coupon: 10 kg hang, slip or not.
16. 3.0 solid carbon rod on hand: length (m) and true diameter (P); current-parts item 23. It is now the only rod size in the project.
18. MG90S (hook latch): body length / width / height, shaft from the body end, dome Ø and height, ear span, thickness, height and hole spacing, and the radii of the stock horn's holes (P). Until then E in `nox/box/hook_latch.py`.
17. XT60 mate and pull force (box swap, section I "XT60 mate"): a luggage scale on one new pair and on a pack's own plug, push in and pull out, 5 times each (P); which half (pins or sockets) the packs carry.

## E. Cartridge and contacts (DEFAULT unless tagged)
| Item | Value | Tag |
|---|---|---|
| Pack in the cartridge | 70 x 32 x 33 (P); 0.5 clearance per side; ~6 of lead room at the lead end; leads and balance lead exit that end face | C / P |
| Cartridge | **v3 (16 Oct 19:15, `archive/scout-v2/s2-cartridge.md`): box 38 x 48 x 79; guide rail x ±19..±20 at y 38..48 full length = the x datum for the receiver and the bays (2 x 5 pin chamfer on top); five 2.0 plates with generated holes; drawn end top bands (z datum) and bottom bands 0..4 all round (flat bottom, bay lip edge); open under the floor; pack snaps in under 0.6 lips, cavity y 14 to 47.2 (fits 32 or 33 tall); tray run 4: 20.1 g (M), worst index 0.29 (pins, sustained), one body at print resolution; latch block 38 x 14 x 14 at z 30.5 to 44.5 (pack centre), 6.3 g (M); total 26.4 g (M) + 1 spring.** Orientation key: both strips at the same z off the bolt plane, so a turned pack touches no pin | C / M |
| Receiver (drone side) | **v3.3 (17 Oct 14:00, `archive/scout-v2/receiver_v33.py`; Spark 02:23: fits the ring's open slot like any bay, mounts on the 3 plate holes; 09:16 more support; 12:38 the cage's nodes): one generated PETG part on the 3 plate bolts, 42.5 g (M), prints mouth down.** Cartridge interface = the bay's (`s2_cartridge.py`: 30° lead-ins ±3 at y 2, locating faces x ±20.3 and z -0.3 / 79.3, both latch pockets, both copper shoe modules). **Placement (the bottom layout, Problem 31): pack long side nose-tail, cartridge z 0 (closed end) at drone x 37.5, pack centre on the CG; cartridge x = drone y; cartridge y 0 (flat bottom) at drone z -44.5 (E), so the seated pack bottom sits at ring r 100 like every bay.** Pads: nose Ø15, sides Ø17.2 (outboard rim trimmed flat at y ±39, C) x 2.5, M3 nylocs under them in 3.5 rings (wrench slots open). **Cage C3 skirt sockets (cage chat's `archive/scout-v2/cage_v2/receiver_skirt.py`): roots (±30.5, ±26.5, 5), 10 deep, 0.48 inside the slot planes (C); cut for 2.5 rods (2.8 bore) in v3.3. Rods are 3.0 since 17 Oct 21:33 (section G "Cage rods"): v3.3 prints get drilled to 3.3 by hand, v3.4 is drawn at 3.3 (Problem 49).** Rest of the part 1.3 inside the open slot's ±15° planes (C). Camera mount keep-out kept clear. Carries the flow sensor (section H) | C / M / E |
| Pins | **Retired 23 Oct (Spark: XT60).** 8 Mill-Max 0854 lying horizontal, B+ 4 on the drone's left, B- 4 right, one group, straight to the bus, no diodes; bores 3.4 (E, D6), potted; free tip set by gauge; compression 1.14 on a pad (2.29 max); cups and wires out the side. **In cartridge coords (v3): pins at y 41.5, z 58.4 to 74.6 (pitch 5.4, centre 66.5), free tip x ±18.56, in the receiver; a pin reaches gold only in the last 1.5 of the install (DEFAULT)** | C |
| Pin data | **Retired 23 Oct (Spark: XT60).** 9 A at 10 °C rise (12 A max at 30 °C); 20 mΩ max; stroke 1.14 mid, 2.29 max; 25 g initial, 120 g at mid stroke; 15.21 long; solder cup ≤ 16 AWG, tail Ø2.54 | Mill-Max datasheet |
| Pads (cartridge) | **Retired 23 Oct (Spark: XT60).** hard-gold PCB strips 0.6 thick (FR4, 2 oz copper, hard gold ≥ 50 µin over ≥ 100 µin nickel, not ENIG), 4 wide, **22 long (both sides), in a 0.9 recess in the guide rail, y 39 to 43, z 55.5 to 77.5, face 0.3 under the rail (19.7); rail top edge 21.8° lead-in; 45° sanded ends; solder window 5 x 3 at the lead-end end** (make only after the latch seats) | Spark 12 Oct (gold) / C 16 Oct |
| Plate bolts (shared) | **round holes, no slots (Spark 12 Oct 21:39):** sides (3.9, ±31) M3 socket head, through the plate and the S2 underside, nylocs under the underside; whatever carries the guard sockets sits on these two above the plate. Nose (45, 0): the S2 underside's, button head on the plate top | Spark / C |

## G. Guard and box collar funnel (DEFAULT unless tagged)
Guard: `archive/scout-v2/s2-cage-v2.md` (C3; the older rows below that say 2.5 / 2.0 rings, struts, hubs, feet and legs are pre-C3 and superseded by that doc). Catcher: `nox/box/box-funnel.md`. Scripts: `archive/scout-v2/catch_v4/` (`s2_catch_opt.py` layout search, `s2_collar_settle.py` MuJoCo drop sim with Coulomb friction, `s2_corner_opt.py` and `s2_dome_place.py` contact placement, `s2_slope_trade.py`, `s2_node_wheels.py` node wheels and slope). **One funnel for both drones (Spark 12 Oct 22:37); the only numbers they share are the "Catch interface" row. Every guard row is Scout only.** Seat frame = drone coordinates of a seated Scout. Sim cases: offsets 0 / 20 / 40 in 8 directions, ±5° yaw, 0 / 2° tilt, 0.15 m/s drift in and out, 204 drops; centred = within 0.5 and 0.3° of the centred seat.
| Item | Value | Tag |
|---|---|---|
| **Shared bottom ring (Spark 27 Oct: one reverse funnel for both)** | the Overseer's base loop on the datum: catch (grip line) centre, plane 3.0 under the cartridge flat bottom, Ø20 nodes. **The Scout uses its 4 side nodes** (cage v5, PR 122: (+85.8, ±116.1), (−68.9, ±119.7) about the catch), plane 2.12 lower so both cartridges stop alike (rods bear; ramps stop 20 short of the nodes); no link within 30 above the plane inside the opening or 40 past its ends, shell items only where the ramp check clears them (System Scout v3) | C |
| **Carbon rods (whole project)** | **3.0 solid carbon is the default stock for every rod and pin** (Spark 17 Oct, was 2.5 / 2.0); thicker solid or tube carbon is allowed where the frame model needs it (Spark 24 Oct). Epoxied socket bore 6.2 (6 mm tube) / 3.2 (3.0 rod), standing or sideways (Spark 27 Oct, coupons v2: the largest fits; OD + 0.3 was loose in PETG), 0.6 lead-in, depths per the cage doc; a rolling bore (wheel on its pin) = 3.4. 3.0 properties (C): area 7.07 mm², I 3.98 mm⁴, ~11.0 g/m (1.55 g/cm³ E). Cut list: `archive/scout-v2/s2-cage-v2.md` | Spark / C |
| Guard outline | clipped square: flats at ±112 (224 across), chamfer corners (±112, ±100) to (±100, ±112) (c 100 from the contact placement sweep). Rods to the prop disks: flats 12.1 static (need 12), chamfers 27.7 (C); worst 1 m/s hit ~2.2 left (E, scaled from the legs-era frame model: rerun). Motors at (±54.1, ±54.1) (P) | C / E |
| Guard rings | **pre-C3 row, superseded: rods are 3.0 (row above), rings at z 33.2 / 49.2 per the cage doc.** lower 2.5 solid carbon, centre z 32.5; upper 2.0 solid, centre z 48.5 (set on prop plane 40.5 ± 8; **prop plane is now 41.2 (D12, 17 Oct): the cage chat moves the rings with it in the frame rerun**); 13.75 between rod surfaces; upper ring joined at the corner nodes only, free over the tees (as v1). Cut list (C, superseded): 2.5 rod 1 x 189 (nose flat) + 6 x 90 (either side of a tee) + 2 x 57.5 skids; 2.0 rod 4 x 189; 3.0 rod: struts 2 x 51 + 1 x 63.7, legs 4 x 69.5 | C / E |
| Catch wheels | **8 print-in-place PETG wheels, one in each corner node (Spark 16 Oct 19:02 / 19:33)**, at (±112, ±100) and (±100, ±112): **bore 3.4 on a Ø3 carbon pin epoxied in the node cheeks (3.3 holes) (Spark 17 Oct 21:45; was a Ø2 pin). Radius: printed cage v3.2 = R 4 (rim 2.25 proud of the 3.0 rod); v4 node set (18 Oct) = R 5 (rim 2.5 proud); the shared interface is the wheel points and the 45° face planes, not the radius**, radial gap 0.2, axial 0.40 (E until D14), **axle horizontal along its face so the wheel rolls down the slope**; rim **2.5** proud of the lower-ring rod surface toward its face (v4 set; v3.2 2.25, same rim position in space) (cage v2 CAD 16 Oct 20:50: node walls 1.35 beyond the rod + 1.0 face clearance); 2 per face, 200 apart. Everything but the wheels stays ≥ 1.0 off the faces (1.02, C). Seated, the drone rides 3.5 above ring-on-face. Node sweep on bare PETG (μ 0.4, 35°): fixed dome 6 %, wheel rolling across the slope 92 %, at 45° in the face 50 %, mixed 65 %, **rolling down the slope 92 % (100 % at 0.3)** | C (sim) |
| Nodes | **cage v2 drawn v1 (16 Oct 20:50, `archive/scout-v2/cage_v2/`): 4 corner nodes, PETG, each spanning a chamfer and carrying both its wheels (the 17 chamfer is too short for a rod), 3.08 g each solid (M) + 2 wheels 0.17 g each (M); 3 tee nodes TPU for AMS (the tail one is its own variant for its lower strut), 1.05 g each (M).** Lower-ring sockets 12 deep, upper 10, strut 12; bores rod + 0.3, 0.6 lead-in. Pinwheel rods, foot frame and pyramid sockets removed | C / M, DEFAULT |
| Guard mount | **2 side hubs + 1 tail hub (16 Oct 21:50; the one-piece bracket is gone: its cross bar and tail spine ran through the FC zone and the pack-lead lane once the top case put the FC on the plate top).** Side hub (PETG, 1.86 g M each, mirrored pair): on its side M3 bolt (3.9, ±31), pad Ø9.5 x 4 under the top case's own pad (bolt 4 longer), a lip hooking the plate edge (y ±47.1) so one bolt can't let it turn; side strut root (0, ±58, 25) plus both leg sockets. Tail hub (PETG, 0.48 g M): under the plate's tail end, root (-47, 0, 15.5) (`archive/scout-v2/cage_v2/tail_route.py`), flat top on the plate underside; the underside is built around it. **3 struts, 3.0 solid: sides 2 x 51, tail 63.7 (C); 12.01 to the swept prop disks (C, need 12).** Top case v2 can absorb the side hubs (its problem 2) | C / M, DEFAULT |
| Guard mass | **42.0 g (M, solid prints + rods + pins, feet, legs and skids included; 17 Oct 04:00) + epoxy ~1.5 (E)**; budget 55. **C3 at 3.0 rods ~70 g (E, cage doc): over budget, Spark's call** | M / E |
| Guard strength | frame model rerun pending: hits with props on top, c 100 and PETG corners; floor landing (now on the cartridge); 50 N swap pull on 2 wheels (XT60, was 15 N push) | open |
| Lowest point / floor feet | **4 TPU floor feet + 2 skids (17 Oct 03:27, receiver v3 bottom layout, Spark: feet and skids only; `archive/scout-v2/cage_v2/foot_opt.py`, `cage_cad.py`):** pad R 3.2 centred (±25.75, ±30.75, -45.24), flat bottoms z -47.5 = 3 under the pack bottom (the drone's lowest point); each foot carries a 3.0 leg socket and a 2.5 skid socket. **Skids 2.5 solid, 2 x 47.5, along x at y ±30.75, axis z -44.6, each joining a side's front and back foot (never under the pack or the head path).** Legs 3.0 solid, 4 x 61.9, foot to the side hub root (0, ±50, 20.75) (C). Foot 0.84 g each (M, was 0.49), leg 0.68 each, skid 0.36 each (C). Stance 51.5 x 61.5, tip-over 26.6° (C, was 28.8; CG (0.57, 0, 2.79) E with the pack lowered). Gaps (C): pack + lead-in prism 2.82, flow view cone 24.4, collar planes extended below the opening at ±5° yaw / ±2° tilt: x faces 3.08, **y faces 0.07 (need 3; no y gives both 3.0 to the collar and 1.0 to the pack)**. **Sim (`s2_feet_sim.py`, seat at the 33.2 ring, 300 drops, gate ±40): 100 % centred; feet + legs alone 98.7 % (previous layout 98.7 %), touching the collar in 30 of 300 drops (previous 28), 2 of them at 20 off (legs, ∓y side); floor drops at 0.5 to 1 m/s, 0 to 30° tilt land on the feet and settle upright.** **Frame model (F): the x-skids lower the foot hit to 1.66 (no skids 1.73) and the 6 g landing to 0.16 (0.23); worst stays 1.84 (side strut)** | C / M / sim / F |
| Catcher type | **collar funnel v4: 4 flat faces at 45°, all PETG, static on the box top, open bottom (Spark 16 Oct 19:02 / 19:33)**; nothing on it moves; only the 8 node wheels touch it | Spark / C |
| Funnel | **collar 75.9 tall: bottom edge z -0.8 (opening 168 square), top z 75.1 (mouth 320 square), seat frame (wheels 2.5 proud).** 4 faces, each printed as 2 half-faces on the A1 mini (contact face down, DEFAULT), glued on the face centre lines and the valley bisector planes x = ±y; ribs generated behind (noxopt, next); bare PETG faces, no tape; ~475 g (E, v3 panel density). v3 panels, hub and corner blocks retired. **In the box (Spark 17 Oct 02:28, lowered ~15 so the Scout pack sits at r 100 like a bay): seat z 0 = W Z 144.5 (E, was 159.2), collar centred on the tab line W Y = Y_C 175 (C); the funnel-post chat checks the ribbed panels against the neighbour bays (~1 clear, E)** | C / E |
| Slope choice | same mouth 320 and opening 168, down-slope wheels, centred %: 35° (53 tall) 92 / 40 at μ 0.4 / 0.5; 40° (64) 95 / 82; 42.5° (70) 97 / 84; **45° (76) 100 / 84**, 100 at μ 0.4 with axle μ 0.7 too. At 35° and 40° the only misses are 40 straight off with outward drift. 45° keeps all of ±40 on bare PETG | C (sim) |
| Opening limit | **v8 plain (24 Oct, DEFAULT): 191 along drone x x 168 along drone y** (the ±x faces end at seat z 12.8, the ±y faces at z 1.3, C). Centring is unchanged: a wheel only runs on its face above its seat contact, which is 43.6 up the slope from the z 1.3 edge, 27.3 above the ±x faces' new edge (C); at 40 off along x the near wheel meets its face at seat x 152, z ≈ 69 and the far one hangs at x −72 at that height, ≈ 56 above the new edge, until it reaches its face at or above its seat (C, wheel centres, E). The 16 Oct sweep (168 the largest at 35° that centres 100 %; 176: 94 %, 188: 85 %, the far side dropping into the hole at 40 off) was square openings with the whole face ring ending lower (a different case, C sim). Everything of either drone below the edges stays inside the opening at ±5° yaw, 3 a side (G (2)) | C (sim) / C, DEFAULT |
| Seated switch and hold | **Seat sense and keep-alive through 4 spring probes in the plain ±x faces (panel v9 plain, Spark 24 Oct: keep-alive stays; G (6), row Keep-alive probes); the KW11 and the belly post are gone.** **Hold = the hook latch (row below, Spark 23 Oct: a hooked latch, no steel belly, no magnets); the electromagnet and steel belly plate are retired.** The XT60 insert push is ~60 N (E, section I "XT60 mate"), ~55 N net up on the Scout (4.9 N weight). The pull-out (~50 N E) seats the drone harder on its wheels and needs no hold | Spark / E, DEFAULT |
| **Hook latch v2** (24 Oct, on the panel v7 skin 2.0: flange w −9.0..−13.0, plunger 32.95; v1 23 / 24 Oct; `nox/box/box-hook-latch.md`, `nox/box/hook_latch.py`, system `nox/box/catch_system.py`) | **4 plungers, one behind each catch wheel on the two seated faces (drone ±y, over the 45 / 135° bays): PETG 8 (along the slope) x 12 (along the edge), square to the face, out 12 through a 9 x 13 skin window at x ±100, axis 54.1 up the slope from the bottom edge (wheel contact 43.6 + R 5 + gap 1.5 + 4.0, C); 45° lead-in 2.0 on the downhill top edge (C, DEFAULT).** The XT60 push lifts the drone 2.12 (C) onto them; the held wheel centre is 6.5 off the face (C). The wheel loads each plunger across its travel, so it holds with the servos off; a hall switch per plunger (A3144 + Ø3 x 2 magnet, E) reads fully out. **Error tolerance (Spark 24 Oct, swept, C): wheel e −2.5 .. +1.0 along the slope held with 0.5 rise clearance (drone lift 0.71 .. 5.66), ±4.5 sideways with the whole rim on the plunger; beyond +1.5 the plunger stalls on the wheel and the swap aborts.** MG90S per unit, scotch yoke (pin r 13, ±27.5°, C). Housing 23.7 g (M) on 4 M3 into panel v7 bosses; plunger 3.9 g (M); set of 4 110.3 g (M). System pass (C, E loads): worst plunger 28.3 N in the XT60 insert, 85.8 N in a 100 N hand lift at a cage corner, assembled worst index 0.44; the piece's own 100 N misuse 0.51 (C hand calc) at the highest held wheel centre 9.0 (C). Out after the seat sense (the drone's 10 kΩ across the probes, G (6)), in after the head clears; the probes follow the 2.1 .. 5.7 lift (pad 4.0 further off the face, travel 7.5, C) | C / M / E, DEFAULT |
| **Funnel panel v7** (24 Oct, the 4 panels of the seated faces, `nox/box/box-funnel.md`, `nox/box/catch_v4/funnel_panel_v7.py`) | **skin 2.0** (v6 1.6 fails the 2.0 floor; contact face unchanged), square to the face at the bottom edge (no lip under it); skin window 9.0 (slope) x 13.0 (edge) at lateral ±100, centre 54.1 up the slope; 4 bosses Ø12 x 7 per latch from the skin's back (**w −2.0 .. −9.0, housing flange face −9.0**), M3 x 5.7 heat-set, hole Ø4.0 x 6.5; low ribs 6.7 behind the skin over the housing footprint + 1.0 (0.3 under the flange), **nothing behind the skin over the guide block + 1.0 (unit u ±13.2, v −10.2 .. 11.2): the guide top must sit at w ≤ −2.3** (hook latch `SKIN` 2.0); 80.0 / 79.9 g A / B (M). **v8 plain** on the 2 unlatched faces (drone ±x, 24 Oct, box catch DEFAULT; DESIGN, do not print: v9 plain next; supersedes v7 plain 75.1 / 75.0 g, also not printed): the same skin 2.0, no latch features, **bottom edge at seat z 12.8** (half 95.5, 16.26 up the slope from the v7 edge), seat block + M3 14 up the slope from it (entry (105.4, ±36, 22.7) seat frame, **bay posts under it +11.5**, the landing must clamp the panel square: the FE hangs it there), rib fraction 0.062, grow 1.0, wheel-track strut at u 100, as-built FE 0.911 on the seat landings + valleys (C), 53.8 / 53.7 g (M), files only in `runs/funnel_panel/v8_plain/`; the v6 1.6-skin panels are retired (reprinted as v9 plain). **v9 plain** (24 Oct, READY, the ±x faces, `catch_v4/funnel_panel_v9.py`): v8 plain + the 2 keep-alive probes in each A panel (row below) + on the −x pair (W −Y side) the arm notch: r ≥ 161 about the axle over W X −37..49.5, W Y ≤ 75.75 (2.0 off the carriage lane, DEFAULT; v8 plain cleared it by 0.61), 4.55 mm³ off each seam flange heel (C); 4 files A px / B px / A nx / B nx, A 60.3 g, B 53.7 g (M); as-built FE on the seat landings 0.786 A / 0.795 B (C, v8 plain 0.911) | C / M, DEFAULT |
| **Keep-alive probes** (panel v9 plain, 24 Oct; `nox/box/box-funnel.md` v9 plain, `catch_v4/funnel_panel_v9.py`) | **2 per plain face, in panel A: tips on the contact face at seat (±115.7, ±12, 33) and (±115.7, ±22, 33) (+x: y +12 / +22 = B+; −x: y −12 / −22 = B−), axis on the face normal (C).** Each: brass pin Ø3.0 x 36.5, domed tip (E, DIY), in a Ø3.2 guide bore 6.0 deep from the face (skin 2.0 + 4.0 of boss); brass collar 4.0 / 3.0 x 3.0 soldered 14.0 from the tip stops on the floor of a Ø5.0 spring bore: **free tip 8.0 off the face, fully pushed 0.5 (stroke 7.5)** (C). Spring (E, buy): music wire OD 4.0 x wire 0.25 x free 25.0, ~16 active coils, **k 0.045 N/mm**, installed 13.0 at the free tip (preload 0.54 N), 5.5 at full stroke (solid ~4.6), τ ≈ 590 MPa (E, music wire allowable ~1200). **Force (C on that spring): 0.585 N with the pad 7.0 off the face, 0.81 N seated (2.0 off), 0.855 N at 1.0 off, 0.88 N solid (target ≥ 0.5 / ≤ 1.0; holds for k −14 % .. +17 %).** Boss: one drawn block per panel A (both bores + a cap screw lobe), wall 4.0 round each Ø5.0 bore (3.2 at the cable-tie groove, w 13.0 .. 16.2), 22.0 deep behind the face, 4.4 gussets into the seam flange and the seat strut (C); back cap PETG 2.4 (tail holes Ø3.3, drill), 1 x M2 x 6 self-tapping into a Ø1.6 x 6 pilot: springs serviceable from behind. Lead: 20 AWG silicone soldered to the pin tail 4.1 behind the cap, service loop ≥ 15, tied in the boss groove, both pins of a panel to its 3.5 mm bullet (box electronics v1). **Current: 3.0 A CC total (13.0 V), 2 probes a pole, ~1.5 A each (3.0 A if one lifts): brass pin 0.36 mΩ (E) → < 3 mW; 20 AWG silicone is good for ≥ 5 A in free air (E); contact on the copper pad at ≥ 0.5 N ~10..20 mΩ (E) → ≤ 45 mW at 1.5 A, 0.18 W at 3 A.** Fits (C): pins, collars and springs 0 mm³ in their bores at free / seated / solid; boss 0 mm³ in front of the face, 3.0 off the post room, nothing cut of the seat block, keys or valley, 21.5 inside the wheel track's u 50; boss, cap, pins at solid and the lead room (r 3 to w 40) 0 mm³ to every box structure v2 part, ≥ 15.7 (M). Drone side: G (6), (8) | C / E, DEFAULT |
| Capture and pose | ±40 offset, ≤ 0.15 m/s drift, ±5° yaw, ±2° tilt (Spark 21:26 / E). **Sim at 45°: 100 % centred at wheel-to-face μ ≤ 0.4 (PETG on PETG, E), 84 % at 0.5.** **Full flight physics (`s2_catch_real.py`: 402 g build-up inertia, velocity controller on the approach from a gate 10 above first contact, kill at touch, props spin down τ 0.08 s, drag, compliant bouncy contacts): inside a ±30 gate 100 % of 300 drops; ±35 95 %; full ±40 spec 86 %: every miss is 40 off drifting outward, which reaches the face 46 to 61 off, past the mouth (a taller mouth only gets 97 %). Open (Spark, shared number): landing gate ±30 in the landing mode.** Gate: wheel coupon (D14). Fixed contacts need μ ≤ 0.20 (they jam: two faces carry the weight and their friction stops the slide in the other direction); the v3 pyramid's 2D "μ 0.3, 2.3x margin" did not hold in 3D | C (sim) / E |
| Catch sequence | drone descends into the mouth under its own landing mode, first face touch = motors kill, wheels roll onto their faces, seat sensed (1.3 mA through the drone's 10 kΩ across the keep-alive probes, G (6)) (~0.5 s E), hook latch out (0.1 s E). Miss (no switch within 1.0 s of the kill): climb, retry. Leaving: hook latch in, spin-up, take off out of the mouth | C / E, DEFAULT |
| Catch loads | face hit ≤ 0.09 m/s normal at 0.15 m/s drift: 0.004 J Scout, 0.02 J Overseer (E); nothing fixed inside the mouth above the faces | C / E |
| Camera keep-out | the 45° face reaches x 98 at z 13.2 (seat frame): the nose camera's bottom above z 13 at x 95; the placeholder (z 8 to 26) overlaps 5 | C |
| **Catch interface: the only dimensions both drones share** (Spark 12 Oct 22:37 one catcher; 16 Oct 19:02 node contacts and collar; 19:33 all PETG) | **(1) Wheels:** 8 PETG wheels (**R 4 (v3.2 printed) or R 5 (v4 set), 3 wide, Ø3 carbon pin**, 17 Oct 21:45 / 18 Oct 06:40; was Ø2) built into the drone's own nodes or belly frame, at the Scout's points (±112, ±100), (±100, ±112), axles horizontal along their faces, rims on the 45° face planes when seated; the Overseer uses the same points on its belly frame so it seats the same way and keeps the ±40 capture (DEFAULT). Nothing else of the drone within 1.0 of a face. **(2) Below the wheels:** everything inside 191 along drone x (the ±x faces end at seat z 12.8) x 168 along drone y (±y faces end at z 1.3), ±5° yaw, 3 a side (box catch 24 Oct, DEFAULT; alt 181 square by cutting all 8 panels at z 7.83); **the latch set (receiver + cartridge) must be centred on the catch centre along drone x** (hub DEFAULT 24 Oct + arm PR 79: each drone's catch centre on its set's centre; E until the Overseer chat moves its wheel nodes). Checked on the latch v1 meshes (M) centred, ±5° yaw, lift 0..5.7, cartridge swept down: Overseer 190.2 fore-aft incl. 3 a side (|x| ≤ 92.08), 3.42 / 3.42 (latch_ctx meshes as on main after PR 86; the motion artifact shows the earlier meshes at 3.15 / 3.27) to the +x / −x panels (at the ±x bottom edge, yaw 5°), 0 mm³; Scout 40 / 38.99 to +x / −x with its receiver as placed by the layout (C, `runs/funnel_panel/v9_plain/`; v8: `runs/funnel_panel/v8_plain/opening_sets.json`, motion `runs/funnel_panel/v8_plain/motion.html`). **(3) Hover:** within ±40 and ±5° yaw at the gate, ≤ 0.15 m/s. **(4) Friction:** wheel sideways on the face μ ≤ 0.4, wheels turn free. **(5) Each drone's own check:** its wheels take its own face hit (Scout 0.004 J; Overseer 2.0 kg 0.02 J), its floor landing at 6 g and **a 50 N swap pull on two wheels (XT60 pull-out, E, 23 Oct; was a 15 N push)**. **(6) Keep-alive (Spark 24 Oct: keep-alive stays, face probes; panel v9 plain):** 2 spring probes in each plain ±x face (B+ in +x at y +12 / +22, B− in −x at y −12 / −22, tips at seat x ±115.7, z 33, on the face normal; row Keep-alive probes), pads on the drone's lower ring (8); **no belly post, no KW11**; seat sense = a 10 kΩ across the drone's pads (1.3 mA at 13.0 V) + an ideal diode (LM74700 class) from the + pad into the bus, so the pack never drives the pads (box electronics v1). 13.0 V CC 3.0 A total, ~1.5 A a probe. Through the hook latch: rejected (the wheel is 0.5..4.0 off the plunger except under the push, C). The probes push the drone up ≤ 4 x 1.0 x 0.71 = 2.8 N and put a 48 N·mm yaw couple on it (C, at 1.0 N): the Scout stays seated with its pack (4.9 N) and, pack out, with the latch out (catch system, C). **(7) Latch zone (23 / 24 Oct, hook latch):** nothing of the drone within 1.0 of the extended plunger uphill of each ±y-face wheel (12 wide at x ±100, slope 50.1..58.1 from the bottom edge, 12 off the face, C): no corner post straight up from those wheel nodes; each of those 4 wheels, its pin and node take 34 N along the slope (functional, E; Overseer insert with the pack out, `catch_system.py` 24 Oct, was 30) and 175 N misuse (Overseer 100 N lift at a guard corner, E; was 100) (DEFAULT: one number for both drones; alt per drone, Scout 30 / 100); the drone rises up to 5.7 (C) before it is held. **Overseer:** pack 148 x 48 x 45 (P), latch v1 cartridge 174 x 55 and receiver 179.6 x 76.2 (M, battery latch PR 69): 3.3 a side in the 191 x 168 opening, centred (C, (2)); S500 skids come off or stay above the faces; the L2 at the nose stays above the faces. **(8) Keep-alive pad and keep-out (drone side, agreed 24 Oct; the Scout v3 and Overseer chats draw it):** a copper pad 22 x 12 x 1.6 on the lower ring at each ±x face, its face 2.0 ± 1.0 off the funnel face seated, y +6..+28 (+x, B+) / −28..−6 (−x, B−), along the slope 8 below to 4 above the probe line (z 33), lower edge 45° so a pin rides on; the pad covers ±4.5 sideways and the 4.0 slide up the slope under the 5.7 lift (C); **nothing else of the drone within 9.0 of the ±x faces over y −35..+69 (+x) / −69..+35 (−x) below the pad top** (the pins stand 8.0 proud before landing, C) | C / P / E |

## H. Underside: FC, Radxa, flow sensor stack (DEFAULT unless tagged)
Under the plate on all three plate bolts (M3, Spark 13 Oct 17:16; nose bolt back 14 Oct 01:25). All heights in drone z. **Stack, top to bottom: FC, Radxa, flow sensor, one above the other on the drone axis (Spark 22:13). The FC cannot move up.** The "below the props" rule and the prop rule below are pusher-era (Problem 33): with the props on top the stack and the bottom pack can sit right under the plate. **The bottom pack goes on the drone axis too (section J): lay out pack and stack together before latch CAD (Problem 31); the flow sensor stays lowest.** Problems and fixes: `archive/scout-v2/s2-underside.md`.
Prop rule (pusher-era): blade tips sweep z -4 to +4. In plan nothing is under a disk inside \|x\| ≤ 9.6 or \|y\| ≤ 9.6; along the axis the clear half-width is 20.5 at \|x\| 25 and 15.25 at \|x\| 32.5 (C).
| Item | Value | Tag |
|---|---|---|
| FC MicoAir743 AIO | top of the stack, on its plate standoffs as now, **on grommets (Spark 14 Oct 00:24: nothing hangs from its bolts)**, cannot move up (Spark 22:22). Board 36 x 36 x 8, mounting 25.5 x 25.5, Φ3 holes (MicoAir spec, 12 Oct 22:38; replaces "30 square"). Lowest point 9 below the plate (Spark 22:13, read as below the plate underside, CHECK) = drone z 9.5 (3.5 plate) / 11.0 (2.0 plate). v1 said 11 below the plate face (P): if both hold, the plate is 2.0 thick. **Plate is 3.5 carbon (D8, Spark 17 Oct 00:52): use z 9.5** | P / spec / CHECK |
| Radxa Zero 3W, from Radxa's official STEP (v1.11, read 12 Oct 22:46) | Board coords: origin at a corner, X along the 65, Y along the 30, Z 0 = PCB top (component side). Board 65 x 30, PCB 1.6. **Holes Ø2.8 (M2.5) at (3.55, 3.60), (3.60, 26.45), (61.40, 3.60), (61.40, 26.50)**: 57.85 x 22.85 to 22.90. Top side: two USB-C 3.16 tall (X 37.1 to 46.0 and 49.6 to 58.5), micro HDMI 3.03 (X 9.2 to 15.7), all three on the Y 0 long edge and overhanging it by 1.25 to 1.5; everything else on top ≤ 1.6. Bottom side: ≤ 1.55 under the PCB, except the microSD slot 2.86 under at the X 0 short end (X 0 to 4.9, Y 7.8 to 22.3; the card sticks out past X 0). **No 40-pin header on Spark's board (Spark 22:55, P): body 6.31 thick (7.62 over the SD slot).** The header rows (Y 24 to 29) are bare plated holes, used as solder pads | C / P |
| Radxa Zero 3W, placement (underside v2, pusher-era) | component side up toward the FC (DEFAULT), board centre on the drone axis, long side along x; ports edge (board Y 0) to drone y -15 (right), header-pad edge to y +15, SD end (board X 0) to the tail (DEFAULT). Holes in drone coords (-28.95, -11.40), (-28.90, +11.45), (+28.90, -11.40), (+28.90, +11.50). **z: USB-C tops -7, PCB top -10.16, PCB bottom -11.76, body bottom -13.31, SD slot bottom -14.62 at the tail end only.** 5 V in on GPIO pins 2 / 4 and the FC UART on GPIO, soldered, no plug; USB-C 1 = OTG + 5 V in, USB-C 2 = USB 3 host (camera), micro HDMI, microSD, optional eMMC, WiFi antenna onboard or external. Runs without cooling at light to moderate load; SoC throttles at 85 °C. Plug room for the camera USB-C on the drone-right edge. **Moves with the bottom layout (Problem 31)** | C / DEFAULT |
| Flow sensor MTF-02P | **on receiver v3.3 (17 Oct; Spark 12:3x: under the camera, the camera mount keeps its pose): board centred on the axis, x 47..69, z -24..-16, tape land z -16..-14 with a 1.2 rim (1.2 under the camera board, C); lens at (63, -2, -24) (C), lens to the nose, ToF to the tail (`SENS_FLOW_ROT` unchanged), plug out the tail end, lead chases up both sides.** 23° view half-angle (42° FOV + 2) clears the cartridge corner (C). PX4 flow position from the CG (FRD): x +0.063, y +0.002, z +0.028 m (CG z 4.2, E). Stiffness cases 10 N each axis: index ≤ 0.36 (C). MicoAir spec 21.6 x 16 x 6.5, 1.5 g; 8 tall kept (P). Flow works from 8 cm up, ToF from 2 cm (MicoAir spec) | P / spec / C |
| Carrier path (underside v2) | **all three plate bolts (Spark 14 Oct 01:25):** M3 through Ø3.3 holes in Ø9.5 x 2.5 pads under the plate, M3 nylocs under the pads (5.5 open wrench from outboard / from the nose). **Nose post** x 33.5 to 38.3, y ±2.5, from a 2.5 strip on the plate face back from the nose pad down to z -21, 1.0 in front of the Radxa. Side posts: fore-aft blades at y ±22.6 to ±26.0 (9.0 wide tapering to 7.6, z -9 to the pads). Below them the generated frame to the 4 bosses and the sensor land, down to z -22 (2.5 above the lens). FC to Radxa gap z 9.5 to -7 holds only the FC-to-Radxa leads | C / E |
| **Required by the catch** | everything of the underside and the pack below the collar's bottom edge (z -0.8) inside the 168 opening at ±5° yaw, and ≥ 3 off the faces above it (section G). The guard is no longer the lowest point (props on top) | C, DEFAULT |
| Camera | not on the underside: its own part, the S2 camera bracket (DEFAULT 22:13; the README's PETG-CF trial part). Collar keep-out: bottom above z 13 at x 95 (section G) | DEFAULT / C |
| Wiring | Radxa 5 V and FC UART on its GPIO pads (no plug, DEFAULT 22:38); camera on USB-C 2, plugged; all leads run up the centre strip to the FC and toward the tail | E, DEFAULT |
| Mass and modes (underside v2) | budget was 8 g (E); **v2 11.8 g (M)** (v1 10.9, never printed), set by stiffness; first modes 230 Hz sway, 251 fore-aft (C), inside 80 to 350: checked in the first hover (`archive/scout-v2/s2-underside.md` Problem 2) | E / M / C |

## I. Box swap wheel: arm, bay modules (C unless tagged; `nox/box/box-arm.md`, `nox/box/box-case.md`, numbers in `nox/box/arm_layout.py`)
Wheel coordinates (W): origin on the axle at the inner face of the stub-side wall; Y axial (+ away from that wall) = the cartridge's length z (closed end toward −Y); Z radial, up at the drone position; X tangential at the top = the cartridge's slide axis (X = −x, a proper rotation: a wheel turn rotates a pack, never mirrors it). phi = head A's bar direction; head B's bar at phi + 90 (counter-clockwise). Head frame: bar along +Z, u from the glide's inner end, s = Y − Y_C.
| Item | Value | Tag |
|---|---|---|
| Ring | **R 100 = flat bottom face of a seated cartridge (v3), bays and drone alike**; contact strips r 139..143 (retired 23 Oct, XT60), pack top r 148, TPU strip to r 149.5, bay back plates r 149.5..152.5, casing inner half width 154. **8 positions at 45°: drone at the top; Scout bay modules at 0, −45, −90, −135° (one arc; the 0° bay is 90° from the drone so head A picks while head B waits); Overseer bays reserved at 45, 135, 180°** (positions from the swap cycle, DEFAULT) | C |
| Axial stack (Y) | stub flange 0..6, stub Ø50 to 42; hub 7..50 (6010s 8..24, 24..40); motor plate 50..54 (motor bodies 2..50); 80T 54..64, its belt 56..62 and head B's belt 56..62; head A's belt 66..72; posts 52..74; bars 74..94; glide top 97.3; **tab centre Y_C 136, pack Y 98.5..177.5** (1.2 past the glide); head servo Y 125.5..166 (ears 118.5..173); bay modules Y 94..182; **Y 184 = the wheel envelope's far end** (+10 vs v3; no casing); stub spider and electronics: `nox/box/box-stand.md` | C |
| Motors (XZ, rotated squares 42.3, bodies Y 2..50) | head A (34, −59) turned 25°; head B (61, 55) 0°; axle (−34.7, −60.1) 50° (`arm_pose.py`) | C (pose search) |
| Axle drive | **v4 (17 Oct, Spark 01:37: no closed belt, only 6 mm open GT2 on hand): planetary: the 80T sun is fixed on the sun post (Stub axle row), the axle motor rides on the arm and walks its 20T round it (4:1).** Loop of 122T cut from the open belt (cut 274 = 244 + 30 lap), lap-spliced (15 teeth, rubber-toughened CA), C 69.4. **Axle motor seat slotted ±1 along the motor-to-axle line (hub v4): C 68.4..70.4 = loop 242.2..246.0, tensions the jig-made loop (C).** The lap only ever passes the 80T: 422° of arm travel before it reaches the 20T, the cycle uses 315° (phi −225..90, E): bounded travel, soft limits phi −278 / +143. **Leads (DEFAULT, slip ring retired): a 12-wire bundle twists along the axle inside the post's Ø8.5 bore, ±210° over ~90, outer wire strain 0.75 % (E).** Printed m1 gears 28T : 111T (C 69.5) rejected: the 111T hits the inner bar posts, head B's belt and head B's clamp at every Y 50..80. 80T: bore drilled Ø12, web drilled for 3 x M3 on Ø36 at 0 / 120 / 240° (DEFAULT, CHECK) | C / E, DEFAULT |
| Bars (v4 demo build) | two 2040s, 112 each, flat (Y 74..94 x X ±20), r 22..134 along each head's axis; two hub posts each (r 32 and 76, 2 x M5); idler ends under each bar end | C |
| **Arm v5 rails (layout)** (`nox/box/arm_v5_layout.py`; drawn `arm_v5_cad.py`, rails A / B v1, 24 Oct) | printed PETG V-rail per head on the hub posts: Y 74..93 (top 1.0 under the carriage plate), r 27..134, body X ±9 full depth, 90° ridges to X ±12 at Y 88 ±3 (tip flat at 11.5, ends tapered to X 10 over 2.5), foot pads X ±16 x Y 74..80 x r ±10 at the posts; **rail to post: 1 x M5 x 16 socket head per post down from the rail top at X 0 (counterbore Ø9 to Y 84, Ø5.5 through) into an M5 heat-set insert in the post top (hole Ø6.4 x 8, E) at r 35 (A) / 38.75 (B) and 76**; ribbon channel X −2..2, Y 89..93 (4 at the floor, 3.2 mouth); **park hard stop X ±9 x Y 93..97 x r 27..31 (carriage plate inner edge meets it at z0 31; home = stall there)**; 49.7 / 50.0 g (M) | C / M / E |
| **Carriage v5** (in heads A / B v6; B = A mirrored in X) | plate Y 94..98, X −28..28, **u 0..40** + **boss r 8.6 round the eccentric bush bore Ø11.2 at (−22, u 18)**; wing X 28..46.5, u 0..30; 3 printed V-wheels v1 OD 24 x 10 (90° groove, apex flat r 10.25) on 2 x 625ZZ (press + epoxy), M5 x 25 axles at X ±22, Y 83..93, **at (22, u 4), (22, 32), eccentric (−22, 18)** (24 Oct: moved 6 inward, the +6 drone push kept the reach at r 141.3 / 138.5) in the **printed eccentric bush v1** (shank Ø11 x 3.9, hex flange AF 13 x 2.5 at Y 98..100.5, 0.8 throw); 5 x 10 x 1 shims Y 93..94; nylocs Y 79..83; **rack web X 40.5..46.5, Y 64..94, u −47..30** (rack 77), m1 teeth on +X at Y 64..73 (pitch X 45.5); head keep-outs Ø10 x Y 98..106 over each axle, Ø26 x Y 98..101 over the bush, nothing at u < 0 inside X ±10 Y 93..98 (park stop) | C |
| **Rack and pinion v5** | pinion v1 16T m1 involute 20° (r 8, tip 8.9 with 0.06 tip relief, root 6.75, 0.1 backlash), teeth Y 64.5..72.5, boss Ø14 Y 56.5..63 + Ø12 neck to 64.5, D-bore Ø5.15 (flat 2.075 off the axis), M3 grub tapped in the boss at Y 59.75; axis at head X 53.5, Z 55 (6.4 / 7.0 inside the rack at the drone insert / park); 50.3 mm per turn, stroke 63.6 = 1.27 turns; 3.0 g (M) | C / M |
| **Motors v5** (XZ, bodies Y 2..50) | head A (53.5, 55) turned 45.8°; head B (−55, −53.5) turned −135.8°; axle (53.9, −43.7) at −39° on C 69.4 (balance search, residual 10.1 g·m E); loop band at −39°; drop lane r 34; **detent roller at −135° (`detent.CHOSEN_V5`, 24 Oct: pivot (−7.4, −28.6), hook (31.6, −28.6), anchor (31.6, −66.6), tower column (18.5, −28.4), ring v1 unchanged)**; hub v6 stays ≤ Y 72 under the carriage path (X ±24.5: the M5 x 25 tails reach Y 73) | C (search) |
| **Axial stack options (v5 compaction)** | v5 on the posts: rails 74..94, Y_C 175, modules 94..255, funnel 15..335, enclosure −66..337 (403). C1 Scout-length modules: Y_C 138, modules 94..184, funnel −22..298, enclosure 366. C2 rails on the motor plate (hub v6 without posts): rails 54..74, pinion plane 55..63, carriage plate 74..78, Y_C 118, modules 74..164, funnel −42..278, enclosure 346. Height, width unchanged. Spark decides (`current-parts.md` Spark section, Decide: arm v5 stack) | C |
| Head (x2, 90° apart, A and B mirror variants) | v1-style glide 44 long round the flat bar, **belt clamp v2 (`nox/box/box-arm.md` clamp section; the Head v5 features line below)**; a generated body under the carried pack (Y 97.3..183, u −26..14) to a **rack guide block** (X 17..44, u −12..−2) and a **servo plate** (u −21..−15, 4 x M3 heat-set). **Gripper v4: servo standing radially, shaft +u at X 33.5 (B −33.5), body u −50.5..−14, 40.5 along s (−10.5..30); 12T module-1 pinion (axis u) at u −10..−4; racks side by side, s ±(6..12), moving along X; blades 13 wide (s ±6.5), 3 thick to u 22.9, 5 thick below u 14; inner faces X ∓10 on the tabs, ∓11 open, ∓6 squeezed; rib 0.8 at u 19.4.** Placement rules: parked, X + z0 + u ≥ 1.5 (heads ≥ 3 apart); at every position outside the own mouth (|X| ≤ 19) inside r 98.5. **Heads A and B v5 with the belt clamp v2 (A v5 56.1 g M, worst 0.45; v4 was 50.0 g, worst 0.34)** | C / M |
| Head belts | A: 20T at (34, −59), idler at u 120, runs X 27.65 / 40.35, Y 66..72. B: 20T at (55, −61) in B's frame, idler at u 124, Y 56..62. **Loops A 398, B 410 (idler pitch = 20T's, CHECK); open-belt cuts with clamp v2: A ~445, B ~457 (each end uses 38.1 inside the clamp + ~5 tail, mouths 39.7 apart; nox/box/box-arm.md clamp section), cut long, trim the tails. Preload 20 N (E, DEFAULT): pluck the free return run to A 143 Hz (span 179), B 139 Hz (span 185) at 7.6 g/m (E, D15)** | C / E |
| Head stroke (z0 = glide inner end) | **v5 (24 Oct, XT60 + hook latch): park 32, wait 81, bay 86.1, drone 89.6, drone insert 95.6 (+6 E: the drone rises 2.1..5.7 onto the plungers), home 31 (park stop); the last 12 of every insert at ≤ 20 mm/s (E)**. v4: **park 32** (packs r 47.4..95.4, corners r 97.5: 2.5 inside the seated packs' faces; glides 11 apart); bay 84.6 (+1.5 into the TPU strip); drone 89.6 (the latched pack sits at r 105); B waits at 81 until the drone has landed. Drawn layout swept every 1 s and 6° of turn: 0 overlaps, closest 0.14 (rack teeth on the pinion); full sweep after the reruns | C |
| Hub | **v5 (17 Oct 09:05, `arm_run_hub.py` h 2.5, 55 cm3, `arm_layout.HUB_DETENT`): hub v4 + the detent tower drawn in (Ø10 column at (17, −29.4) on head A's motor spoke, webs Y 66.3..71.3 to the pivot boss and the anchor post, hall pocket; 5.3 g C), loaded with the pivot 22 N and the anchor 8.4 N (E).** From v4: no pulley; Ø45.5 hole through web and motor plate for the sun post (1.0 radial, C / M); plate held at Y ≤ 53 inside r 29 (1.0 under the 80T flange); inner bar posts r 35 (A) / 38.75 (B) (1.0 off the 80T, 1.04 off the loop, C); axle seat slotted ±1. Bore Ø80 x 33, motor plate Y 50..54, four bar posts 32 x 12, Y 52..74. **215.8 g (M; v4 211.3), worst 0.31 (detent pivot, across layers, misuse; v4 0.15), function 0 / 0 / 0, one body, thin 0 on 3 offset grids (M; on-grid: 25 one-voxel slabs on the Y 44 / 50 faces, sampling artefact).** Sweep `arm_kinematics.py 1.0 all` / `axle` (drawn heads and bay modules): 158 states, 0 overlaps; closest to the hub 0.3 (roller arm over the tower web, designed, C). Print sleeve end down, plate up, tree supports under the motor seats and the tower webs (E), 172 x 172 x 67 (M) | C / M / E |
| Stub axle | **v2 (17 Oct): Ø90 x 6 flange, 4 x M5 at r 38 on the 45° diagonals; Ø50 x 34 shaft to Y 40, flush with bearing 2's inner race (seat Ø49.9 E); Ø24 bore; 2 x M3 heat-set at Z ±21 for the sun post; slip ring pocket and inserts removed; 109.7 g solid (C).** **Sun post v1 (fixed, replaces the cap):** flange Ø57 x 4 (Y 40..44) clamps bearing 2's inner race (r ≤ 28.5, 6010 d1 58.3 E, CHECK), 2 x M3 x 10 into the stub down two open Ø6.5 flutes; column Ø43.5 to Y 54 with 3 x M3 heat-set on Ø36 at 0 / 120 / 240° for the 80T; spigot Ø11.9 x 8 into the 80T bore; Ø8.5 lead bore; 30.4 g solid (C); prints flange face down, no supports. Assembly: bearings on the stub, post, hub over bearings and post, 80T, loop | C / E |
| Bay module (Scout, one design, printed 4x) | **drawn = the drone receiver** (`archive/scout-v2/s2_cartridge.py` receiver(): 30° lead-ins ±3 at r 102, locating faces 0.3 off the guide rails and end faces, the latch pockets, both contact shoe modules (**retired 23 Oct: the receiver's XT60 float carrier instead, row "XT60 mate"**)) + back plate r 149.5..152.5 with a TPU 95A strip 36 x 76 x 1.5 + **5 AA spring contacts for the balance pads** (holder at X 23.5..26.5, r 124, Y 106.5..146.5 at 10 pitch, ~2 compressed, ~1.5 N each E) + 4 link bosses on the −Y face (r 125, 146, 6 inside each 22.5° plane). Sector ±22.5° less 0.3 per side; modules never touch. **Link plate** per joint: PETG 3 thick, 2.5 g (C), 4 countersunk M3, Y 95.5..98.5. No snap lips: the latch bolts hold the pack in the bay. Supported by its link bosses (no casing). **Without springs / shoes (20:00): 67.8 g (M), worst 0.13; rerun running.** **Linked modules = the standing frame (Spark 16 Oct 23:39, `nox/box/box-stand.md`); the bay ring chat adds the front feet, 4 funnel seats and 4 spider-tie bosses** | C / M / E |
| Casing | **retired (Spark 16 Oct 21:09)**: the linked bay modules stand the box (`nox/box/box-stand.md`). Funnel hub slot for the Scout cartridge path: X ±23, Y 96..180 | C |
| Balance charging (bays) | **Through each bay's XT60 (23 Oct; was the copper shoes), no balance lead. 2 bays wired live (one per drone size) on the dual-channel charger; the rest hold bench-charged packs. All 7 live needs more channels or a relay mux (purchase): Spark decides after DubHacks** | Spark 16 Oct 20:39 |
| **XT60 mate (box side, 23 Oct, Spark: XT60 back, contact pads retired)** | **Every swap mates and unmates an XT60 along the install axis (radial in the wheel = drone z = cartridge y).** The pack's own plug is fixed in the cartridge facing that axis; the mating half (an XT60E1-M panel mount, section M) sits on a **float carrier** in the drone receiver and in every bay module, the bay a copy of the receiver as before: carrier ±1.0 lateral, ±2° tilt, axially hard (2 screws in holes 2.0 over size, TPU 95A washers, DEFAULT); the receiver lead-ins (±3.3) and locating faces (0.3) centre the cartridge before the XT60 noses meet (pins touch in the last ~9, E). Where on the cartridge: the Scout v3 bottom layout (DEFAULT: the lead end, facing the drone); its stack sets full mate at or before the bolt seat, the 1 mm over-travel goes into the TPU strip, never the XT60 housing. **Forces: mate 18 to 44 N, pull 18 to 44 N (Amass XT60L spec sheet, 1.8 to 4.5 kgf; plain XT60 CHECK, D17); design insert push 60 N (45 XT60 + 12 preload + 3 lead-ins, E; was 15 to 20 N), pull-out 50 N (45 XT60 + bolt wedge, E; was ~8 N).** Hold: section G "Hook latch": the drone rises 2.1 (R 5 wheel at its interface point) to 5.7 (the tolerance band's edge) (C) onto the plungers before it is held, so the drone insert stroke runs up to 6 further (E, arm session). Head: v5 pinion r 8 needs 0.48 N·m at 60 N; stall ~74 N at 2 A (E, from the 93 N at r 6.37 in `box-wiring.md`), 1.2x: the last 12 of every insert at ≤ 20 mm/s (E, DEFAULT), drivers at 2 A (the 1.2 A fallback is out); alternative 12T m1 pinion (r 6, ~99 N stall E). Carriage at 60 N: ~4.5 N·m, ~165 N on a wheel flank (E, 3x the v5 layout's 20 N case). Gripper: a 50 N pull through the 10° tab pockets splays each finger ~8.3 N (E, scaled from 2.5 N at 15 N) against the 8 N spring: spring ≥ 15 N per finger (DEFAULT; the servo opens it, ~0.18 N·m at the 12T, E). Bay module load cases: insert 60 N, pull 50 N (were 20 / 20); the shoe ±10 N cases drop. Electrical: drone mates onto its bus held at 13.0 V by the face pins (no arc, `claude/research/2026-10-11-keepalive-swap-power.md`); a bay mates and unmates only with its charger relay open; mate check = box keep-alive current under 50 mA (E), seat check = latch, as before | Spark / spec / E, DEFAULT |
| Swap timing | axle 90° 0.38 s at speed (5:1, GT2 16T on the axle motor at 200 rpm; 0.3 s at round 2's 4:1) + **~0.5 s for the slow pass through its 3 detent notches** (≤ 100 full steps/s near each, ~36°/s at the arm, E) = ~0.9 s; head stroke 0.6 s, +0.6 s on an insert for the slow last 12 (E, XT60); drone seated to leaving ~4.3 s (one 90° turn between the pick and the insert, E) | E |
| **Box electronics v1** (24 Oct, `nox/box/box-electronics.md`, `nox/box/box_electronics.py`) | **Rails:** LRS-350-24 (on the rear sheet, X 42..157, Z −170..45, Y −66..−36; the kb floor spot is released); keep-alive **13.0 V CV, CC 3.0 A** behind relay K1 and INA226 0x41 to 2 spring probes in each plain ±x funnel panel (B+ +x, B− −x, panel v9 plain; keep-alive concept `runs/keepalive_contacts/concept/`, Spark 24 Oct: belly post and KW11 gone), seat sense = the drone's 10 kΩ across its pads (needs an ideal diode on both drones, E) on GPIO 24 through 1 kΩ + a BAT54, low-leakage 5 V TVS, SMBJ15A on B+; servo rail **6.0 V** for all 6 servos (was 6.8); logic 5.1 V. **Panel probes (was the pogo post):** 2 spring probes per plain ±x panel (≥ 1.5 A per probe, E; stroke the catch's), dead unless the latch is out and K1 closed. **Grippers (heads v7, DEFAULT):** each gripper servo only to open / rest; stall cut on the shared 6.0 V pair via K4 + INA226 0x40 after 0.5 s (E; DS3218 1.8 A, MG995 1.0 A, E), PCA9685 to 0x60; 2 analog grip halls per head at 3.3 V (upstream of K4) summed 3:1 onto one line, read on an ADS1115 0x48; the twist bundle 22 wires (Ø7.6 E in Ø8.5, CHECK arm). **Pack-out hold (catch PR 93, DEFAULT):** the latch never retracts with the pack out; aborts after PULL keep the latch out and K1 closed until a pack mates or the drone is lifted (A12: I < 50 mA for 2 s with no pack, then K1 open and seat sense high; low keeps the latch out, E). **Checks:** drone pull = keep-alive I > 100 mA at the end of the pull; drone mate = I < 50 mA within 1.0 s; **bay mate = bus 13.0..17.0 V with the bay relay open**; a head enters a live bay only with its relay open and I < 50 mA. **Live bays:** Scout −90°, Overseer 180° (DEFAULT), 16 AWG pair per bay XT60E1-M, CH − never to box GND; charger input limit 6.5 A. **Electronics zone:** Y −66..−2 behind the stub on the rear sheet, keep-out mast + kb X ±40, Z ≤ 50; boards on 10 nylon standoffs. **Hook latch I/O:** plunger out = hall low (GPIO 17 / 27 / 22 / 23 for L1 / L2 / R1 / R2; L = W −X face, 1 = Y_C − 100); PCA9685 ch 0..3, grippers ch 4 / 5. **Budget:** 177 W cont, 296 W peak = 85 % of 350 W. **Head and axle brake (24 Oct):** 3 DPDT 24 V relays (8 A contacts, G2RL-2 class, spec), one per head motor and one on the axle motor (arm v7 PR 79: detent springs x1.3 at 5:1 hold a head out at a horizontal Overseer bay, index 1.04, no creep, E; the brake stays as the second line, required with the boot self-test; per-bay gravity offset in the axle step target measured at commissioning + a sag check ≤ ±0.55° roll at the head (E, the arm's residual budget), required; ≤ 100 full steps/s through each notch (E); swap ~4.3 s seated to leaving (E, arm); numbers from arm PR 79, open: follow it if they change), one pole per coil, self-test at every boot (TMC2209 open-load flags read during a slow spreadCycle move, ~2 full steps/s E: 0 with the brake off, 1 with it on; then the normal homing), NC = coil shorted on itself; coils ~17 mA each (E) on the motion branch via a bare ULN2003A from one SKR `output_pin` per motor; sequence: brake released, ≥ 30 ms (DEFAULT; G2RL operate ≤ 15 ms, spec), then the driver enabled, the reverse to stop; fall 77.6 (E, arm v7), creep ~8 mm/s Scout head 391 g, ~19..23 mm/s Overseer head ~930 g (E; Kt 0.21 N·m/A, 1.4..1.75 Ω per coil, E); bench drop CHECK | C / E, DEFAULT |
| Hardware sizes assumed (CHECK, DEFAULT until D13, Spark 16 Oct 23:39) | NEMA17 42.3 x 48, boss Ø22, holes 31; 80T OD 51.6 / flange 56 / 10 wide / boss Ø24 x 8; 20T Ø12.7, 14 wide; idler Ø16 x 10, bore 5; slip ring Ø22 x 18, flange 44 x 1.5; servo 40.5 x 20 x 36.5, ears 54.5 at 27 up, shaft 10.5 from the front; AA spring contact free ~7 | E |
- **Head v5 features (17 Oct 19:10, head A chat, C):** belt clamp v2 in the head: slot centre X 27.77 (A) / 48.77 (B, own frame), body X ±5.63 about it, Y 63.8..74.2 (A) / 53.8..64.2 (B), pins (Ø3.3 along Y) at u −3.0 and 5.5 (A) / 0.0 and 8.5 (B), mouths u −18.6 / 21.1 (A), −15.6 / 24.1 (B); slot width = coupon pick (1.8 / 2.0 / 2.2), DEFAULT 2.0. Wiring entry: Ø4.5 channel along Y at X −10 (A; B +10), u 8, through the glide top skin (Y 94.3..97.3) to Y 100.3; zip fin on the skin X −7..−5 (A), Y 97.3..102.3, u 4..12, slot 3.4 x 1.6 through it along X at Y 98.3..99.9; servo plate zip tab X P_SH ±6, s 41..47, u −20.6..−14.6, slot 3.4 (X) x 1.6 (s) at s 43..44.6.

## System box swap: arm (v7 round 3d after concept review round 3 FAIL, 24 Oct 2026, swap arm system worker; model `nox/box/swap_system.py` (NOX_ARM v7), layout `arm_v7_layout.py` (LOW stack), assembly `nox/box/box_swap_arm.assembly.json`, results `runs/arm/v7/system.json`; C geometry, E loads unless tagged; v6 pass: PR 71, `runs/arm/v6/`)
The system pass of the swap arm carrying both packs (Spark 24 Oct: 9 bays, 4 Overseer + 5 Scout). Every arm part in pose through the swap cycle (`arm_kinematics.py 1.0 v7:<pack>:<pick>:<ret>`), the latch cartridges from **main's `battery_latch.py` (latch v4, 24 Oct; was 258becf staged read-only)** (`battery_latch.latch_assembly`; XT60 end at the arm side; the latch's TAB_OFF and receiver pitch guidance), every bay at R 113 as a latch receiver with a seated cartridge. Frame model (beams + contact springs) with every case where it acts; the receiver as gap + spring (0.3 gaps, 0.40° tilt, then 2e3 N/mm / 2e6 N·mm/rad, E); every guided case also free (misuse bound). Not yet in the model: the funnel and hook latch (the catch moves `box_catch.assembly.json` to Y_C 167.1, was 165; its panel v9 notch keeps the insert lane below). Each piece's run takes the rows below as its parameters.
| Item | Value | Tag |
|---|---|---|
| **Concept check** | **PASS (review round 4, 24 Oct)** after round 2 FAIL (6 findings) and round 3 FAIL (roll lever, head-out pose and indexing torque, grabber guide and cam, pinion face, stale values), fixed in rounds 3b to 3d. Piece pass: hub v6 topology, detent v6, pinion16 v3, then the heads v7 pieces (Spark 24 Oct: plug / unplug loads, parts-optimised, servo research `claude/research/2026-10-24-servo-gripper-head-v7.md`). The funnel at Y_C 167.1 with the insert-lane notch is the catch's part (session catch) | E |
| Layout v7 round 3b (DEFAULTs) | rails on the hub motor plate to **r 151**, carbon ties (2 x 3.0 per rail, hub lower rim Y 22.5 / r 78 to the keel at Y 41.6 / r 128); **one ring R 113**; **grip line Y_C 167.1 = each cartridge's tab line = the funnel centre** (24 Oct: 165 → 167.1 for latch v4's Overseer receiver v2, DEFAULT; see Sets on the grip line) (hub DEFAULT; one funnel for both drones, the 191 opening): the Overseer's tab line on its latch set's centre, the Scout's on its swap CG (its set 3.7 off its catch centre, inside the opening); **TAB_OFF (tab line from the swap CG toward the XT60): Scout 0 (latch / hub DEFAULT: its tail corner vs the collar; the Scout set 3.7 off its catch centre), Overseer 5.18** (latch 258becf); low carriage stack: nothing under a cartridge above Y 74.35; rack tails A u −63, B u −54; **detent v6: tower (21.9, −28.6)**; **axle 5:1 (GT2 16T on the axle motor)**, driver on for every insert and pull, each detent notch passed at a slow step rate; **detent springs x1.3** | C / E |
| Low carriage stack (C) | rail top Y 66.75, ridge 62.75, wheels Y 57.75..67.75, shim to 68.75, **plate Y 68.75..74.35** (X ±28, u 0..40 in the arm model, heads v7 may grow it to u −18 inside the keep-out; top 74.35 per heads v7, 24 Oct: 1.0 under the Overseer receiver, was 72.75); wheel axles **M5 x 20 ISO 10642 countersunk, flush in the plate top**, DIN 439 thin nuts under the wheels (Y 55.05..57.75, threadlocker), tails Y 54.35 (1.35 over the hub's wheel lanes); eccentric bush flange flush in a plate counterbore (Y 71.85..74.35); rack teeth Y 59.25..73.25 (grown down, the top 1.1 under the plate top 74.35) and pinion16 v3 teeth Y 59.75..73.25 (X 40.5.., beside the cartridge); park stop on the rail top Y 66.75..72, bumper over Y 68.75..72 | C |
| Bays (box structure v2 set, via the hub) | 30° pitch, **Overseer 0, −60, −120, −180; Scout 30, −30, −90, −150, −210**; drone 90; alternating (two Overseer receivers side by side overlap 937 mm³ at R 113). Either head reaches every bay in phi −300..90 | C / M |
| Strokes (z0) | park 32 (home 31), wait 94, bay 99.1, drone 102.6, drone insert 108.6; every insert commanded 2.7 past its seat at 2 A, ending on stall detection (bay 101.8, drone 111.3); wheel rim r 156.9 at the commanded drone insert (**the stand's arm lane to ≥ 159**) | C / E |
| Cases | **swap** (≤ 0.5): insert 60 N at the drone and at every bay of the pack at its angle, by head A and head B, pull 50 N at the drone and every bay, receiver gaps, driver on; **XT60 mate** at all 20 places with gravity and the driver on; **misuse** (≤ 1.0): each free, head stall 74 N, axle stall 2.95 N·m, dropped cartridge 50, hand 50 N on a rail tip, power cut carrying (bumper at X 0), **power cut with a head out at each bay (driver off)**; **handling** 3 g + 2 g; **sustained**. Scout 216.5 g, Overseer 755.4 g (latch v4, C / M + P) | E |
| Results (worst index per class) | Scout: swap 0.45 (16T on the rack tail, drone insert), handling 0.29; Overseer: swap 0.49, handling 0.43; misuse free 0.57 / 0.61 (16T at the 74 N stall). **Power cut carrying without the brake: Scout 1.34, Overseer 2.80 (625ZZ, Y_C 167.1)**: the brake is required for both packs (row Head brake). Hub turn in the power cut 2.8° / 2.0° | E |
| XT60 mate and budget | **per axis (the latch: the XT60E1-M float carrier allows ±2.37° about the cartridge x axis = the arm's slide-tangential axis, ±1.06° about z = roll):** free tilt (absolute, gravity, driver on, all 20 places) + the arm RSS 0.41°: **about x Scout 0.87 + 0.41 = 1.28° (46 % margin), Overseer 1.07° (55 %)** (Y_C 167.1, F), + a 5 mrad stub 1.56 / 1.36°, the stub allowed 10.8 / 14.4 mrad at a 20 % margin: no pitch guide needed; **about z (roll): free Scout 0.46, Overseer 0.86° (the arm's in-plane turn under gravity at the horizontal bays); with the per-bay gravity offset in the axle's step target (30 % left, DEFAULT; **required: without it the Overseer reads 1.19°, out; inside the float needs ≤ ~65 % left**, to box electronics: a per-bay offset measured at commissioning and a sag check) 0.32 / 0.43°, inside the receiver's x side faces' hold (2 x 0.3 over the cartridge height engaged at first pin contact: 31 / 44 → 1.10 / 0.78°): 0.74° (31 %) / 0.85° (20 %) vs ±1.06** (Y_C 167.1, F) | C / E |
| **Receiver pitch guidance (to the latch)** | not needed about x (±2.37° float, row above): the guide posts can go, which also removes the moment they force back (with posts: Scout ≤ 2.1 / 2.9 / 5.6 N·m at stub 1.9 / 5 / 15.1 mrad, Overseer 1.6 / 2.4 / 5.0; arm pitch stiffness at the mate 4.6 N·m/°, F); the x side faces stay; ≤ 40.7 N across at the seat | E / F |
| **Stub stiffness (to box structure)** | the arm puts **5.9 N·m (Scout) / 5.5 N·m (Overseer) about the tangent + 57 N** on the mast front face (Y 0) at an insert; **tilt ≤ 10 mrad (k ≥ 0.59 N·m/mrad, DEFAULT)**: the XT60 about x keeps ≥ 20 % margin up to 10.8 mrad (row above, Y_C 167.1, F; close to the 10 mrad target); v1 measured 15.1 mrad (Scout 2.14° vs ±2.37, 10 %, F) | E |
| Capture at the lead-ins | positional RSS 0.30° (ring on the 80T 0.10, homing 0.10, belt backlash and splice 0.22, microstep 0.03, **each bay located to the mast ±0.15°, not chained**) + the driven axle's load turn (k 198 N·m/rad at 5:1; belt run on the 80T's pitch radius 25.46) with the cartridge at the side faces' mouth: worst **0.55 of the 1.20° capture**, 0.34 with the per-bay gravity offset (DEFAULT); once centred the lead-ins force the 0.30° offset: **≤ 7.6 N side, 1.05 N·m on the receiver** | E |
| Seat state vs TARGET 0.5 mm / 0.5° | Scout ≤ 0.42 mm / 0.42°; Overseer ≤ 0.42 mm / 0.43°; receiver after the gaps close ≤ 40.7 N across, ≤ 0.08 N·m | E |
| Unpowered arm (driver off) | **detent v6, springs x1.3 at 5:1 (DEFAULT), hold 1.065 N·m:** passing a notch at a slow step rate (0.5 N·m pull-out x 5, E) against the detent peak + both parked heads carrying: **1.28** (1.51 on holding torque); **a power cut mid-swap, both heads parked carrying: 1.20**; **a cut with a head just out of a horizontal Overseer bay's side faces (z0 45.9, carrying; inside them the bay holds the arm): 1.09**; the axle motor on the head brake's relay damps the rest. Alternatives: x1.5 (1.21 / 1.31 / 1.20), x1.25 (1.34 / 1.09 / 1.00); 4:1 x1.8 indexes at 1.04 on holding torque | E |
| Alternatives | one ring R 113 (chosen) vs two radii (infeasible, a carried Overseer passes seated Scout packs); low stack at Y_C 165 (chosen) vs round 2's carriage at Y_C 177 (the least it clears at: 1.85 to the Overseer receiver; box 12 longer; free tilt about x 1.10 / 0.88° vs 0.82 / 0.62°; `runs/arm/v7/alternatives.html`) vs the low stack without the keel (Scout 0.83°, out); keel (chosen, rail 18 x 28.75 from r 89) vs ties alone; 5:1 + x1.3 (chosen) vs 4:1 + x1.8 (index 1.04 on holding torque) | E |
| Compact (system_check, M) | **arm alone at Y_C 167.1: Scout cycle park 11.43 L, 227.9 x 212.1 x 236.5, largest 236.5, hull 4.5 L, worst 12.59 L / 253.0; Overseer cycle worst 15.65 L / 266.0**; fit 0.0 mm³ at all 10 poses, access 9/9; sweeps 0 overlaps (Scout pick −210 / return 30, Overseer −180 / 0), wheel-axle tails Y 54.35, 1.35 over the hub's wheel lanes (C); closest sweep pairs detent arm / hub 0.30 (the arm's pivot seat), axles / receivers 1.00 at the insert (M) | C / M |
| Hub v7 (topo, `hub_v6_topo.py` + `hub_v6.py`, NOX_ARM v7; v6 runs 1..3 superseded) | as round 2 (envelope r 110 clipped ±88, Y 7..54 + pads + tower, 6010 seats, drawn plate Y 50..54, 4 pads at r 40 / 78 with one M5 heat-set each (insert hole Y 47..54 in a boss Y 44..54; rail v5's M5 x 10 tip at Y 47.75, 0.75 above the hole floor, C), 4 tie sockets at Y 22.5 / r 78, **tower at detent v6's (21.9, −28.6)**, Ø9 harness hole) **plus: wheel lanes X ±13..31 along each rail at Y 53 (the axle tails 1.35 over it), plate edge at r 88 (the keel starts at r 89), the axle motor's 16T**. Loads: the 82 cases of the round 3d frame with detent v6 (`runs/arm/v7/system.json`; setup checked at h 2.0, design 800 cm³); run 1 (`runs/hub/v6/`, h 2.25, FAILED: solid FAIL on the drawn hall pocket's 0.8 side walls, misuse 3.40 in the unbraked Overseer power cut, swap 0.561, M / F); run 2 (`runs/hub/v6r2/`, h 2.05, 40 cm³, FAILED: 15 sub-0.25 mm lips under the plate where the generated region met its underside edge-on, swap 0.596 under the wheel lanes, sustained 1.33 at the tower column root, 184.4 g, M / F; power cuts out (the head brake is required for both packs, DEFAULT; alt a drawn gusset at the park stop), cases enveloped at 15 % (E), hall pocket walls 2.0 (C)); run 3 (`runs/hub/v6r3/`, h 2.05, 52 cm³: solid PASS, 199.3 g M, swap 0.523 at the sleeve-to-plate corner r 43, sustained 1.075 on the single tower column above its flare, misuse 0.47, F): the generated region 1.0 into the plate, column flare r 7.5 → 5 over 6 (C). **Three strikes: system pass (24 Oct) → hub v7: (1) the axle loop is two tangent strands round the 80T and the 16T (C; the old 8 band on the centreline filled the loop's inside and read the hub 0.00 off it); (2) the detent tower's column is a 14 x 14 block inside the loop (s 33..47 along it), 1.05 off the strand's tooth tips (C; GT2 tips 1.0 inside the pitch line; the splice lap is on the belt's back, outside the loop), on a plate pad 3.0 larger all round (the attachment gusset), no leg outside the loop (the spliced loop slides on under the free web ends); net tower load 15.3 N at the web, sustained ≤ 0.5 (E, hand: section modulus 457 vs 98 mm³ gives ~0.23 at run 3's moment, ~0.5 with the full lever to the pad top); legs under P / A rejected (they close a window round the strand, concept review FAIL); (3) swap 0.5 at a stated mass: gen 62 cm³, ~212 g, ~0.46 (E, the run 2 → 3 slope 0.0061 per cm³, 0.5 at ~56; a landing 0.5..0.52 counts as v7's first strike); skirt rejected (a structural member, not mounting); (4) the generated region 1.0 into the plate (C, the lips of runs 1 / 2). Loads, supports and cases as run 3 (power cuts out, 15 % envelope: a merged case is within 15 % of a kept one, E; the 6010 seats rigid over Y 8..40, E: a corner miss may be the support model). Run on `run/hub-v6r2` → `runs/hub/v7/` (h 2.05)**. **Hub v7 result (`runs/hub/v7/`): solid PASS on the file (M), 213.3 g (M), sustained 0.596, misuse 0.468, swap 0.524 at (37.4, 47.6, 22.1) (F): hub v7 strike 1 (swap 0.524 > 0.5; the concept's ~0.46 estimate (E) missed). Next (DEFAULT): find whether the corner is the model (rigid 6010 seats, the voxel corner) by an FE on the saved mesh with the seats compliant; alt: a drawn fillet at r 43 / Y 47.5, then a rerun.** Index ≤ 0.5 swap, ≤ 1.0 misuse; budget_g 215 (DEFAULT 24 Oct, was 180; v5 214 M, v6 run 3 199.3 M) | C / M / F / E |
| Rails A / B v5 (`arm_v7_cad.py`, PETG; DESIGN, `runs/arm_rail/v5/`; v4 superseded) | rail v2 on the low stack (top Y 66.75, no feet, **M5 x 10 ISO 4762 heads Y 57.75..62.75 under the channel floor, cbore Y 57.75**; **ribbon channel X ±3.25 at the floor Y 62.75, 5.0 mouth at Y 66.75** for the 5-conductor head ribbon ~6.1 wide (E, box electronics PR 103); arm bundle 22 wires Ø7.6 (E) in the post's Ø8.5 bore (0.45 radial, E), the hub's Ø9 drop and stub v3's 10 x 6 lead channel, twist strain ~0.54 % (E); inner step and park stop from r 27.5: 1.0 off detent ring v4) + **keel X ±9 x Y 38..54 from r 89 to r 151** + tie sockets in the keel at r 128; 56.5 g each (M); solid_check PASS | C / M |
| Heads A / B v7 (requirements) | carriage on the low stack: **nothing above Y 74.35 within X ±28.6 under a cartridge**; inside the insert-lane keep-out; wheels (22, u 4), (22, 32), eccentric (−22, 18); TPU bumper in the plate notch X ±10, u 0..5; rack web X 40.5..46.5, Y 59.25..74.35, **teeth Y 59.25..73.25** (tail u < −40 from Y 63, over the axle loop): A u −63..30, B u −54..30; grabber at **Y_C 167.1** to the latch's grabber interface (PR 69: recess x ±15.5, z ±11.5, tabs, halls at x ±7.5); carried cartridge bottom u 15.4, Scout top u 61.0, Overseer u 74.0 | C / E |
| **Heads v7 grabber concept (Spark 24 Oct: plug / unplug loads, parts-optimised; `nox/box/head_v7_concept.py`, `runs/head/v7-concept/`)** | **two PETG blades (3 x 13) sprung closed by bought steel compression springs (15 N squeezed, 19.5 open, k 1.0 E) onto the tabs: squeezed = unlatched and held; one servo cam between them opens them (base 4.5 + rise 6.0 = the open position 10.5, over 90°, a dwell at open)**: holds with the servo unpowered; release margin x5.0 / x3.3; hold while the XT60 unmates 26.1 / 28.6 N per tab vs an opening 4.7 / 4.9 N (x3.2 / x3.1); servo 1.98 kg·cm (DS3218 x10.1, MG995 x4.6), the blades' forces cancel on the spline (≤ 5.8 N friction imbalance; bought metal horn, no outboard pin); **pull path pocket → blade → a guide boss 16 long in x in line with the tab (≥ 15 slides without racking), outboard of its blade (x 1..17 squeezed, 5.5..21.5 open: 2.0 apart at the centre) and above the cam (y −11..−5 vs its top −14.5) → 2 x 3.0 carbon rods along x fixed in the head body's walls (span 52: 14.3 N each, 70 MPa, index 0.07, 0.09 mm)**; head body 5.3 N·m pull / 6.8 N·m stall at the grip (lever 92.2): its topology run. Alternatives: servo toggle fingers (more parts, a tuned stop per pack), v4 servo fingers (the servo holds: a power cut drops the pack), a push pad under the XT60 (tilt 0.822 → 0.817°: not taken). Research: `claude/research/2026-10-24-servo-gripper-head-v7.md` | C / E |
| Pinion16 v3, detent v6 (ring v4, arm v3), V-wheels v1, bush v1 | **pinion16 v3** (`runs/arm_pinion16/v3/`, solid_check PASS, 3.7 g): teeth Y 59.75..73.25 (13.5, fully on the rack; 10.25 on its tail), D-bore on the shaft's flat (Y 59..74), boss Y 55..59.25 with an M3 grub on the round shaft: Lewis 0.45 / 0.49 at the 60 N drone insert, 0.57 / 0.61 at the 74 N stall, 0.66 dropped Overseer. **Detent v6** (`detent_v6.py`, `runs/detent/v6/`, CHOSEN_V8; the x1.3 springs put ~54 MPa on ring v3's rim under the 683ZZ, index ~0.8, and 0.68 on arm v2's pivot): **623ZZ roller (Ø10 x 4) on the 3.0 carbon axle, ring v4 r 12.25..26.5 with a rim the roller's width (Hertz 30.6 MPa, index 0.45; walls to the 80T bolt pockets 2.24 / 2.34), arm v3 3.5 with r 6 bosses (0.16), tower at (21.9, −28.6), every gap 1.0; two springs x1.3 hold 1.065 N·m**; solid_check PASS on ring v4 (8.7 g) and arm v3 (3.3 g). 625ZZ 1.34 / 2.80 unbraked (Y_C 167.1, F) (Scout / Overseer power cut carrying: the brake is required); GT2 16T 6 mm on the axle motor (bought, replaces the 20T) | C / E |
| **Head brake (to box electronics)** | NC relay contacts short both coils of each head motor **and the axle motor** whenever its driver is not enabled, driver side broken first; heads creep ~8 mm/s (E). **Required for both packs at Y_C 167.1** (unbraked power cut carrying: Scout 1.34, Overseer 2.80, F). **Gate: a bench drop of a loaded head passes before the first swap, and a brake self-test at every boot** (one coil short read back) | E |
| Sets on the grip line (Y_C 167.1, C) | **Overseer (latch v4 receiver v2, main): receiver Y 75.35..258.95 (1.0 over the plate top 74.35), cartridge body 81.65..252.65, XT60 axis Y 88.85; Scout: receiver 110.35..215.95, cartridge body 116.65..209.65, XT60 123.85** (C, `system.json` sets_on_the_grip, latch v4); each receiver inside the 191 opening's ±92.5 about the catch centre. Y_C ≥ 167.1 is the limit (the Overseer receiver's end 1.0 over the plate top 74.35; Y_C 167.1 sits on it, F). 24 Oct (DEFAULT, latch session agreed): latch v4's receiver v2 lead end is 2.15 longer (its 3.0 capture lead-in); a trim to 1.0 capture needs the arm's lead end within ±0.7 along Y, and the arm's Y error is ±1..1.8 (stub tilt ≤ 10 mrad under load ±1.1..1.6 at r 113..158, 6010 play ±0.1, print stack ±0.3, E): the grip line moves instead (alt: the latch trims, Y_C 165). Rerun at 167.1: sweeps 0 overlaps both cycles, fit 0.0 at 10 poses, access 9/9 (M); assembly 6534 / 6865 g (E, latch v4 parts). The Overseer's catch centre ~21 behind its thrust axis (the Overseer's call) | C |
| **Insert-lane keep-out (to the catch and the structure)** | at the drone (head A along +Z, X tangential, Y along the axle): **carriage lane X −35..47.5, Y 53.75..75.35, r 89..159** (wheel rim r 157.0 at the commanded insert, carriage X −34..46.5, M; plate top 74.35 + 1.0); **head and grabber X ±47.5, Y 75.35..219.1 (Y_C + 52), r 95.0..159.6** (heads v7, 24 Oct: the plate grows to u −18 where the arm leaves room; checked against the catch (Z ≥ 154), box structure v2's bay envelopes and the arm sweep with the head envelope, 0 overlaps); the carried pack: the latch cartridge. Drawn orange in the layout pages | C / M |

## System Scout v3 (27 Oct 2026, layout v3 / cage v2, race-car shape; `nox/scout/v3/layout_v3.py`, assembly `nox/scout/v3/scout.assembly.json`, run `runs/scout_layout/v11/summary.md` (earlier: `v6/` cage v1, `v7/` octagon, `v8/` camera on top, `v9/` v3 middle rectangle, `v10/` Radxa standing); drone frame: x nose, y left, z up, plate underside 18.5, thrust centre = plate centre x 0; C geometry on E sizes unless tagged)
| Item | Value | Tag |
|---|---|---|
| Brief (Spark 27 Oct) | the latest Scout layout (PR 94 run v5) in a triangulated cage: **every rod 3 mm, about half the rods, any rod length; the bottom = the Overseer base loop's 4 side nodes (one reverse funnel, the Scout on fewer ramps); a race-car look; the camera low, no sharp section under it; small triangles to one node**; one camera; the Bee35 carbon base kept; one design | Spark |
| **Bottom (G Shared bottom ring)** | the Overseer cage v5 base loop's 4 side nodes (PR 122; Spark 27 Oct): (+85.8, ±116.1), (−68.9, ±119.7) about the catch centre, 154.7 long, 232.2 / 239.4 wide; plane 3.0 + 2.12 seat under the cartridge flat bottom (DEFAULT); nodes Ø20, rods 3.0; catch (tab line) x −2.50 (2.5 aft of the thrust centre, v13 re-trim for the real node mass), plane z −49.6; funnel band clear of links; swap column: receiver + 26.5 at the nose end, + 17.6 at the tail, + 30 at the sides | C |
| Rods | **58 (layout v13), all 3.0 solid carbon**: shell 50 (61..239, 6.34 m) on 19 nodes (4 on the ring, PETG nodes with 3.2 epoxy sockets, incl. the waist pair (−1.0, ±125.1, −11.9)); links 8, none on the carbon arms: 4 a side from the tie saddle's face (y ±44.3, z −7); none in the funnel band; nose top node (v13 node 17) sockets toward +x within 5 of its centre (camera mount 5.45 away, C); **every rod 3.0, every socket 3.2 (Spark 27 Oct: "lets just stick with 3mm rods for the scout"; the frame model's 6/4 sizing dropped)** (seat −2.12 and the catch's side sleeves stay) | C / Spark |
| Tie saddle | printed PETG (DEFAULT 27 Oct), 17 g E: a rail a side x −50..42, y ±36.3..42.3, z −15..6, outside the belly mount and the receiver TPU end pieces, rail and ties ≥ 2 off the flow bipod and cradle (y −50..−27.5, x −30..30, z −32..18.5; now 2.8 rail, 9.8 saddle ties, 42.3 shell rods, C); 2 tabs a side to the plate underside at x ±14..26, 4 M3 into the plate (4 new plate holes); rod sockets 3.2 epoxied; the cage ties' root and fuse, ahead of the latch; alt: core ties on the plate edges (42 rods, 651 g, bare carbon roots) | C / E |
| Shell (race-car look) | flat roof at the drone's top (109 between node centres), a clean raked front behind the camera (no nose point, Spark), a raised tail point (55 behind the margin hull, 18 under its top; it adds 54 of length), corners of the margin hull grown 24 mm along 6 directions; no triangle with all edges under 70, no rod under 45 (small triangles merged to one node); mirror-exact; node extents 362 x 266 x 111, 6.4 L, largest cell Ø129 (v13); rods 13.9 off the swept disks | C / DEFAULT |
| Strength (frame model v4 on v13, `runs/scout_frame/v4/`) | 35 g crash (313 N at 912 g) through the saddle ties: **every rod 3.0 fails** (31 of 58 buckle, 12 crash and 22 handling stresses over 600 MPa, first mode 34 Hz, nodes by the fit); **Spark 27 Oct: 3.0 everywhere, accepted** (rods are the fuse, a cheap swap; lift it by the nodes or the plate); the camera mount v2 must reach 100 Hz on 3.0 rods (clips near nodes) | F on E / Spark |
| Balance | **tail bay out of the prop wash, CG in the middle of the props** (Spark 27 Oct, DEFAULT): Radxa on edge and the UBEC behind the rear disks, riding with the catch on the electronics session's mount (round 5 concept 49.2 g + cables 6.3 g, E; Radxa post keep-outs cut); XR2 fixed in the frame at x −110..−94, y −27..−15 (3.8 out of the wash); catch set **2.5 aft** (v13, for the real node mass): CG 0.7 mm off pack in, 0.7 pack out (system_check, x and y); FC IMU offset x −2.50 (PX4) | C on E |
| Camera (one) | DECXIN 2633V2 89 x 73 (E), horizon, **lens (149, 0, 42), close in at the nose, outside the cage, printed PETG only** (Spark 27 Oct): cradle 0.5 clear, lips 6 over and under (x 128..153, z 17..67); mount v1: one PETG print 21.8 g (M), lens hood 4.0 ahead (DEFAULT 3), truss arms into **4 snap clips pushed on from the front after the cage is built** (9 long, bore 6.2, mouth 5.6 into the cage): top (110.5, ±18.0, 61.1) rod 7-8, bottom (122.6, ±18.0, 11.5) rod 14-15; 2 CA'd stop collars; pop 23 N a clip (E) = the fuse; 109.3 Hz (F) | C / M / E / F |
| Funnel fit | funnel band (30 above the plane, inside the opening or 40 past its ends): no link in it; the shell rods leaving the 4 bottom nodes rise through it; 2 shell rods reach it at the nose low node (106.7, 0, −19.0); no tail low node (every node past x −130 about the catch ≥ 91 above the plane); the design center's ramp check decides | C |
| Landing | the 4 bottom nodes are the lowest points; no link lands on them. **Box catch F (PR 155, DEFAULT):** TPU foot caps Ø16 x 3 under the 4 ring nodes, the same as the Overseer's (both drones' side tubes at one height, cartridge 16.2 above the deck, C); 6 mm printed sleeves on the 2 side rods over x ±32 (2 x ~1 g E; they fall away if the ring rods go 6/4); alt: the loop 9.2 lower, ring on the deck | C / E / DEFAULT |
| Props shadow | 3.0 % above, 8.2 % below (plan shadow weighted by r, v13) | E |
| Mass | 912 g all-up (system_check, v13, E): cage 298 (shell rods 70, nodes + caps 203 by the fit to the saved nodes v2, saddle ties 8, tie saddle 17); camera 10 (E) + mount v1 21.8 + 2 collars 0.5 (M) = 32.3 (M + E); the electronics session's tail bay mount 49.2 and cables 6.3 (round 5 concept); bought, latch set and wires 526; budget 500 soft (L) | E |
| Access | swap down (cartridge, pack, plug); 4 receiver bolt keys from below; FC USB-C cable out the tail-left through a cell: 8 / 8; 25 / 25 with the belly mount v1's keys and paths | C |
| Electronics tail bay (mount v2 on v12) | v12 poses, catch −5.0 (C); tail block 15.9 g E (web under the plate to x −31.0, 2 M3 through the tab at (−42.0, ±16.0) C, fin + foot to z 34) + carrier 33.2 g E (4-M3 yoke = lateral fuse, tube spine 14, UBEC box 6, XR2 floor z 21); mount 49.2 g E at (−84.0, −0.2, 10.7) C, cables 6.3 g E; L crash worst 0.27 E; 235 / 476 Hz E; CG 0.56 / 1.49 at −5.0 C (main, camera mount); belly mount tail face x −31.0 (req). `runs/scout_electronics/v2/envelope.json` | C on E |
| Belly mount (concept v1) | PETG 25.0 g E at (2.1, −10.7, 6.8) C: 2 yokes, plate to receiver; receiver 4 M3 inserts (−37.65, ±26.55), (48.28, ±26.55); 4 new plate M3 (−25, ±13), (30, ±13), Bee35 holes empty; tail face x −31; ESC vents x ±18 (641 mm²); flow (0, −40, −30) on a bipod; flow clear air DEFAULT slipstream (10.7 out), alt column (2.6 % under a disk; no pose passes); FC on AIO holes, soft-mount req 5.2 columns, rib ≤ 6.5. `runs/scout_belly_mount/v1/` | C on E |

## System Overseer v5 (27 Oct 2026, layout v5 / cage v5; `nox/overseer/layout_v5.py`, assembly `nox/overseer/overseer.assembly.json`, frame `nox/overseer/cage_frame.py`, runs `runs/overseer_layout/v5/summary.md`, `runs/overseer_frame/v1/`; drone frame: x nose, y left, z up, z 0 bottom plate top; C geometry on E sizes, F frame model unless tagged)
| Item | Value | Tag |
|---|---|---|
| Brief (Spark 26-27 Oct) | the L2 and 2 cameras outside a geodesic disk cage, half v3's tubes, close nodes merged, perfect mirror; the L2 and cameras on one printed PETG head; the lidar stiff ("max performance"); 6 / 3 mm tubes only | Spark |
| Base loop (shared, G) | 6 nodes at z −57.0 (cartridge bottom − 3): (−98.9, ±119.7), (55.8, ±116.1), (161.2, 0), (−242.6, 0); 404 x 239, node r 10.15; swap zone centre x −30 | C |
| Cage | 24 nodes, 63 tubes 6/4 (116..446, 15.9 m), 670 x 655 x 211, mirror-exact; nodes PETG (15 designs with node 17; Spark 27 Oct, was TPU); links 31: 25 tube 6/4 (incl. the 3 head rods) + 6 rod 3.0 (bay ties), 5.54 m | C |
| Sensor head (one print) | PETG, v5: drawn only the 4 L2 bolt bosses (Ø16), 4 insert bosses per camera (Ø12) and 3 rod sockets 6.2 x 12 deep with a 3.0 floor (rod forces <= 126 N F; 21.1 g drawn, C), the topology between them; no guard ring, camera plates or bars, no cage node; the L2 rolled 180 about its axis (cable down, DEFAULT 28 Oct); on 3 rods 6/4 to the cage (row Sensor head supports); drawn 167 across (fits 180, C); 143.7 g in the system model (E, v4 M) | C / E |
| Sensor head requirements | all 3 rod sockets hold the head (28 Oct); the head's own 35 g in 14 directions and flight 4 g: the L2 230 g (P) at its CG (411.3, 0, 46.0) through its 4 M3 (force + moment), cameras 15 g (E) at their bosses, the mount's mass; the cage-crash forces through the rods (<= 25 N, F) left out; first mode >= 100 Hz (DEFAULT): 119.4 / 94.2 Hz rigid / PETG joints (F on E), under on the PETG bound, Spark to decide | F on E |
| Node requirements | a socket per member that ends there (6/4 tube bore 6.2, 15 deep; 3.0 rod bore 3.2, 10 deep; Spark 27 Oct, coupons v2), 2.0 walls (28 Oct, was 2.5), a 3.0 solid floor behind each bore, PETG; drawn Ø7 arms to a Ø12 hub (one body); loads from `node_loads.json` (largest axial 1405 N, F); drawn first: saved v5, 24 nodes 289.4 g (M), worst 0.252 (F); node 17 a cage node again; breaking order: the halved cage's long tubes buckle first (row Frame results, exception) | F / DEFAULT |
| Frame results | reported over in the 35 g crash: tubes 11-18 / 12-19 1.59, 15-16 1.21 (k L buckling, pinned ends); every link <= 0.74; lowest mode 104 Hz with the head moving (rigid joints, lumped); no member over stress; the body tie roots taken as rigid core (parked, Spark 27 Oct). Breaking order: these tubes buckle before a node fails (nodes <= 0.27), an exception of the halved cage (Spark 27 Oct "ignore the tests"), reported | F |
| Arm requirements (to the arm session) | spokes from the arm nodes (ARM_NODE: front (178.9, ±146.7, 8), rear (−53.3, ±119.7, 25), C); nothing else ends on an arm (no L2 braces or keels since the 3-rod head, 27 Oct); summed link force on the arm: rear spoke node 2027 N, front 1147 N (drone 3405 g E) (35 g crash, core rigid; `arm_loads.json`); the arm root joint carries it (Spark 27 Oct: "just assume those are good"); the arms' third screw (arm v8): top clear (arm 2 once core v4 moves the RX), bottom blocked by the receiver (top only, DEFAULT) | F on E |
| Balance and mass | CG 0.2 off the thrust centre pack in, 25.4 pack out (L exception, Spark); 3405 g (layout) / 3447 g (system check), the nodes 289.4 g M, the head 143.7 g E (v4 M) until v5 saves; T/W 1.94 | E / M |

## J. Bottom latch: battery under the drone (DEFAULT, C from the coupon, E where tagged)
Doc: `archive/scout-v2/s2-bottom-latch.md`. CAD: `archive/scout-v2/s2_latch_coupon.py`. Research: `claude/research/2026-10-14-bottom-cartridge-latch.md` (hook era). Coupon coords: x = slide axis (0 at centre), y = up toward the drone, z = thickness = print Z (14). Positions on the drone come from a sweep once the bottom layout (pack + underside stack, Problem 31) is set; the numbers below are the slider, pocket and gripper themselves.
| Item | Value | Tag |
|---|---|---|
| Loads (pack 165 P + cartridge ~9 E + sliders ~5.4 E = ~180 g, all pulling the pack out) | hover 1.8 N; flight 4 g 7 N; catch 6 g 10.6 N; upright drop 35 g 62 N; side hit 35 g 62 N in shear | E |
| Sliders (cartridge side, 2, mirrored) | one-piece PETG: side bolt + bar + tab, printed in place in a channel in the latch block (**v2: bar y 8 to 12, channel 7.65 to 12.35, 0.35 clearance; the tabs sit in one 29 x 14 x 7.65 recess open to the flat bottom, x 4 to 10 at rest, 0 to 6 squeezed: the tabs meet at 4.0 = the stop**); outboard stop = the block wall; 2.0 g each (M; coupon 3.9) | C 15 Oct |
| Bolt | 13 wide (z 0 to 13) x 4 thick; **fitted v3: bar x 4 to 23.3, receiver face at x 20.3 (0.3 off the guide rail) = 3.0 overlap** (coupon 25 to 28); **bearing face = underside**, undercut 10° over the 3.0 overlap (tip drops 0.53) so pull-out drives it outward; 1.0 lead-in chamfer on the tip's top edge; wall hole 0.7 deeper than the channel for the wedge. Worst overlap left 2.35 after ±0.2 per part and 0.25 lateral play | C / E |
| Return | **fitted v2 (15 Oct 02:40): one Ø3 pen-type coil spring, free ~17, between the two tabs in Ø3.2 x 4 blind seats at y 9; ~1.5 N at full squeeze (E), compressed to 8 when the tabs meet (DEFAULT; fallback a 2.4 TPU strip).** No printed leaf: with sunken tabs it would run over 2 % strain. Coupon leaf stays in the coupon only | DEFAULT / E |
| Tab | 6 thick x 14 wide, **v2: faces x 4 and 10 at rest (0 and 6 squeezed), y 0 to 12, inside the bottom recess (nothing below the flat bottom)**; outer face carries the grip pocket: 8 (z) x 4 (y) mouth, 10° included taper on all four walls, 3.0 deep, centred y 4. **Box fingers: 3.0 blades, open at x 11 to 14, reach 7 into the recess, 1.0 clearance** | C 15 Oct |
| Pockets (drone side, passive) | one per side, **in the receiver (v3, 16 Oct)**: mouth y 7.75 to 12.3 at x 20.3, 3.3 deep, floor dropping 10° going in (7.17 at the back), flat ceiling, 1.0 chamfer on the mouth's top edge, **14.6 wide in z (bolt + 0.8 per side: the receiver locates z, the pocket only holds)**; 3.0 walls behind and beside it; bolt bottom 0.25 above the floor at rest. Nothing on the drone moves | C 16 Oct |
| Preload | TPU 95A strip between cartridge top and drone, 12 N (≥ the 6 g catch load, so the pads never lift); it presses the cartridge down onto the pocket floors, so through the undercut it wedges each bolt outward ~1 N and adds ~1.8 N friction: the preload locks the bolts | E |
| Strength (hand calc) | per bolt at 35 g + preload 37 N: bolt bending ~1.3 MPa, index ≤ 0.1; pocket wall index ≤ 0.1; outward wedge into the frame stop 6.5 N. Side hit 35 g along the slide: coupon slider inertia 1.3 N vs 2.8 N hold, index ~0.5 (0.3 slimmed) | E |
| Gripper (box side, one per swap-wheel head) | **drawn 15 Oct on the head (section I, `nox/box/box-arm.md`): rack and pinion on one standard servo (DS3218 / MG995), two 13 x 3 blades on 6 x 6 racks, inner faces x ±10 on the tabs, ±11 open, ±6 squeezed; frustum rib 0.8 deep (0.15 per side) at pocket height: shallow, the fingers open only 1 before a deeper rib drags (`nox/box/box-arm.md` Problem 11: v3 recess 31 wide).** Spring-closed at 8 N per finger (servo only opens; spring not drawn, DEFAULT a band); **≥ 15 N per finger with the XT60 pull (section I "XT60 mate", 23 Oct)**. Squeeze seats the ribs (zero play from the taper) and drives the tabs to the stop: bolts out. Hold in any orientation through the pocket walls, 10 N design (3 g index x 2); ~0.3 MPa in the rib. Coupon finger (20 x 30 x 14 block, 10.5 g M) is superseded | C / E |
| Release and insert | **XT60 (23 Oct): the release now also pulls the XT60 apart (~45 N E) and the insert pushes it home (~60 N E in all); forces and speeds in section I "XT60 mate"; the steps below stand, "pads make" = the XT60 is home.** Release: fingers open, head extends to the tabs, spring closes: 4 N per finger while the bolt wedges out under preload, 2 N after; head retracts with the pack (no lift step; 1 mm over-travel is the fallback). Insert: head extends with the pack held, bolts retracted, **the receiver's lead-ins capture the cartridge (±3.3) and its faces locate it (0.3)**, to the preload (~15 N through the pocket upper walls; 10° taper splays the fingers ~2.5 N, under the 8 N spring), 1 mm over-travel, servo opens: the spring pushes the bolts into the pockets, preload wedges them home, pads make | E |
| Contacts | **Retired 23 Oct (Spark: XT60).** pads reach the pins only after the bolts seat (a half-in pack can't arm); latched check = pack voltage on the drone bus via the keep-alive link (no tug test). Orientation is fixed by the swap wheel (section I), so B+ left / B- right stands | DEFAULT |

## System box swap: latch (24 Oct 2026, battery latch v1 + receiver v2 (Scout v3) + cartridge v6; `nox/box/battery-latch.md`, `nox/box/battery_latch.py`, run `runs/battery_latch/v4/` (v3, v2, v1 superseded); C unless tagged; owner: battery latch worker)
One latch + cartridge standard for every pack: the v2 squeeze latch (J) as one module, the same on every cartridge; supersedes J's positions and E's cartridge v3 / PR 44 v4 rows for new work. Cartridge coords c: x across the pack, y up the install axis (0 = flat bottom = ring R 113 in every bay and at the drone, arm v6), z along the pack (0 = closed end); tab line z_T = the swap CG + TAB_OFF toward the XT60 end (Scout 0, Overseer 5.18). **The lead (XT60) end faces the arm side (−Y) = the drone nose (hub 24 Oct, arm passes; DEFAULT); the XT60E1-M's float carrier takes the mate's pitch (row XT60 pitch).** W: X = x, Y = Y_C − (z − z_T), Z = R + y (R 113, grip Y_C 165, arm v7 PR 79). Scout drone: d = (z − z_T, x, y − 44.5).
| Item | Value | Tag |
|---|---|---|
| Packs | Scout 4S 1500 70 x 32 x 33 (P), 165 g (P); Overseer 4S 6000 148 x 48 x 45 (P), 650 g (E, Q9). Cavity +0.5 a side, floor top y 12.0, 0.6 keeper lips 1.0 over the pack | P / E |
| **GRABBER INTERFACE (identical on every cartridge, relative to the tab line)** | **Recess** open from the flat bottom: x ±15.5, z z_T ± 11.5, y 0..12.0, 1.0 x 45° on its mouth edges. **Tabs** (one per slider): faces x ±5.0 (inner) / ±10.0 (outer) at rest = latched, **±2.0 / ±7.0 squeezed on the cartridge v6 centre rib (stroke 3.0 per tab; v5: ±0 / ±6, the tabs met each other). Centre rib x ±2.0 (4.0 thick: 3.0 necked in the gate's erosion), y 0..11.5, notched to y 7.9 over z_T ± 2.5 for the spring, held by two 6.0 cross walls frame to frame at z_T ± 11.5..17.5 (heads v7 ask, DEFAULT): each tab stops on it, so the squeezed tabs clamp the cartridge to the head and both bolts retract 3.0 at any head offset (need 2.6); rib index 0.25 at the 43.5 N across, 0.04 / 0.13 at a 3 g carry (E)**, y 0..11.5, z z_T ± 11.0, 1.0 x 45° on the bottom outer edge. **Grip pocket** in each outer face: mouth 8 (z) x 4 (y) centred y 4.0, z z_T, 3.0 deep, 5° per wall (10° included), 0.5 mouth chamfer. Blades (heads v7): inner faces ±11 open, ±7 squeezed. Same y stroke for both packs: the flat bottom sits at R 113 (arm v6) in every bay and at the drone | C |
| Grabber forces and tolerance | squeeze to release (cartridge v6): spring 2.0 N squeezed + the 1 g hang's wedge and friction = **2.6 N (Scout) / 4.1 N (Overseer) per finger** (E); **hold while the XT60 unmates: 57 N + 1 g of the swap mass = 59.1 / 64.4 N, 30 / 32 N per tab along y** (tab bar index 0.37 / 0.40, E); finger spring ≥ 15 N (heads v7: 16.3 N per blade); **head offset ±1.0 in x**: each tab stops on the rib, both retract 3.0, each bolt's tip ends 0.7 inside the locating face (needs 0.3), 0 mm³ against cartridge, receiver and each other, pull-out clear (swept) | C / E |
| Grip moment (Overseer, tab line 5.18 off its swap CG) | 0.04 N·m at 1 g, 0.11 N·m at 3 g about x; rib on the pocket's y-walls: index 0.04 / 0.11 (functional SF 4, E). Scout tab line on its swap CG (no moment) | E |
| Latch module | slider = tab + bar + bolt, one part for both sides (turned 180° about y), PETG, printed loose; bar y 6.5..11.5, z z_T ± 9 (18 wide), channel 0.35 clearance; **bolt 2.3 into the pocket past the locating face**, underside **undercut 15°**, 1.0 tip chamfer; one o 3 compression spring between the tabs (music wire 0.3, mean o 2.7, ~20 active coils, free 20, k 0.2 N/mm E: spring slots 3.0 deep: rest 0.8 N at the 16 gap, squeezed 2.0 N at 10.0, solid ~6.6); **receiver pocket**: mouth y 5.75..11.85 at x ±RF, 2.6 deep, floor 15° down going in, 1.0 mouth chamfer, z z_T ± 9.8, 3.0 walls; bolts bear after a 0.8 drop. **Side hit 35 g along x: the inboard slider's 1.0 / 1.3 N inertia against spring + its 1 g share's wedge and friction 1.4 / 2.9 N (x1.42 / x2.27, E); the outboard bolt is pushed in** | C / E |
| Engage / release | insert stroke alone: the receiver feet's 30° lead-ins (capture ±3.0 from y 0.2) cam each free bolt in, it snaps into its pocket at the seat (cartridge top on the TPU strips, y = Y_TOP); releasing the grip lets the spring throw the bolts out = locked; squeezing retracts both = unlatched and held. Insertion swept every 1.0 from 50 below seat, also 0.3 off in x: no stuck step, 0 mm³ cartridge vs receiver | C |
| **Latched state** | **o 2 x 2 N52 magnet press-fit in each tab bottom at x ±7.0, z z_T + 8, y 0..2.2**; **one analog hall per tab on the head (DRV5055A4-class, ±169 mT, E, CHECK) at x ±7.5, 1.0 under the flat bottom, z z_T + 8**, read separately: 157 mT latched, 1.7 half in (bolt on the plate face, retract 2.6), 2.9 squeezed at nominal (C, model); **worst over head offset ±0.5 and gap ±0.3: latched ≥ 109, half in ≤ 16 (x6.8, threshold ~62 mT); at ±1.0: ≥ 76 vs ≤ 38 (x2.0, threshold ~57)**, so the head's x offset is held to ±0.5 at the read (DEFAULT, calibration). **Seat check (box, DEFAULT): after an insert the head opens, both halls must read latched AND the keep-alive current < 50 mA (XT60 home) before the hook latch lets the drone go; else re-push once, then pull and flag.** A half-in pack has no preload and both bolts on the plate faces: it reads unlatched, only the XT60's friction holds it | C / E, DEFAULT |
| XT60 | pack plug (battery side, E) face up at z Z_X, face y Y_TOP − 2.0, keyed pocket 15.8 x 8.4 on its rear 10, 2 x M3 cup-point set screws in the end wall; receiver XT60E1-M in the **XT60 carrier** (receiver v2: base with the pull lips 2.0 under the flange + cap = the float ceiling, clamped by the lead-end bolts, replaceable with its pigtail), float ±1.0 x / z (2.0 over size), 0.5 axial; plug face 1.5 under the flange at seat: 6.0 engaged, 0.5 to the housing with the 1.0 head over-travel (PR 44 stack). **Mating life: Amass lists ~100 cycles for most XT60s (GB/T 5095.1), one sheet 1,000 (E, CHECK): the XT60 sets the service interval (carrier swap), far below the 5,000 / 10,000 swap life** | C / E |
| **XT60 pitch and roll (hub ask 24 Oct, arm PR 79; receiver v2)** | the XT60E1-M floats ±2.37° in pitch (about the cartridge's x: 0.5 axial play over the flange's 12.1 depth) and ±1.06° in roll (over its 27.1 width) (C). **Pitch: the arm's free mate 1.23° (Scout) / 1.03° (Overseer) fits, so no guide posts on either pack and no guide couple (arm 24 Oct); the receiver allows > 4° at first contact. Roll: the x side faces (gap 0.3, the cartridge's full length) engage before the XT60's first contact and hold it to 0.40° (arm: 0.80 vs ±1.06)**. End gap 0.3; below the rails the end walls stand 3.3 off the cartridge ends | C |
| Scout set (**HOLD, do not print**: until the Scout's own pass reads fit 0 and probes PASS on run v4) | cartridge 93.0 x 40.0 x 45.6 (z x x x y), z_T 42.55 (= swap CG; the arm's 3.71 would put the pack's tail-bottom corner 6.4 inside the collar planes: DEFAULT 0), swap 216.5 g (with the strips and skids) at z_T 42.55; Z_X 85.8; **cartridge ends clipped at inset 14.0 except round the pack, 2 TPU end skids (1.4 / 3.1 g) fill back to the set's clip at 11.0**; **receiver v3** (Scout v3 keel back + PR 109 review, 24 Oct): **head flats at y 24.5, bolts at x ±26.55, tail pair at z −0.1** (every seat bearing 1.0, ring 1.0, C); clip inset 11.5 (collar 7.45); **|x| ≤ 25.5 below y 6.5 (drone z −38)** (the clip already held the columns inside 25.9 there; the pocket blocks' outer 0.4 shaved for y 5.75..6.5, wall 2.6), so the keel's printed nodes (r 4 at drone (x, ±29.6, −47.5)) clear it by 1.2 (need 1.0); x ±32.75 at the seat rings, y 0.2..54.1, z −6.3..99.3 | C |
| **Scout TPU skids (cartridge v6 / receiver v3, Scout v3 asks 24 Oct: cage role, bonded on)** | **cartridge strips** (2, move with it, every cartridge): L section, foot x ±19.2..23.2 under the flat bottom (y −2.0..0, 2.0 proud of the sliders), leg x ±19..21 to y 3.0 on the wall, z z_T ± 32; bonded by the leg, 192 mm² each, peel-loaded (E, DEFAULT; alternative: a dovetail rail); **receiver end pieces** (drone receiver only, DEFAULT, alternative every receiver), one TPU print each, bonded on: **nose** = 2.2 plate on the lead end wall face (x ±27, drone z −22..−6) + 2 Ø3.5 bars on the 45° chamfer at drone y ±34 (axis 1.0 off it) from (59.2, ±34, −16) to (35.2, ±34, −40), joined by ears at \|y\| 26..34.5, bond 369 mm²; **tail** = 2.2 on the tail end wall face and its chamfer (\|y\| ≤ 27, drone z −31.5..−6, Ø9 round each tail bolt key; below −31.5 the swap path and the key holes leave slivers, the bars cover) + 2 bars from the wall (−49.95, ±34, −25.25) to (−35.2, ±34, −40), bond 1198 mm² (M). Bars at y 34 (Scout spec 31: the bolt rings at y 26.55 cut 31 / 31.5 to 0.5 skins), stopping at z −40 (keel); the receiver bottom strips are dropped (keel). **Clipped at funnel inset 6.25: margins at ±5° yaw / ±2° tilt nose 1.21, tail 2.24, cartridge strips 3.15 (need 1.0); bolt key lines 5.7 / 4.5 / 11.2; keel nodes 5.6 clear** (C, `result.json` skids, keel). Heads v7 deck and pads \|X\| ≤ 18.2 clear the cartridge strips. TPU: cartridge strips 2 x 1.1, nose 3.2, tail 5.0 g (M). **A 0.81 J hit through 2 mm of TPU peaks ~4 kN on a flat floor (E): the skids are a scrape layer, the Scout's suspension takes the hit** | C / M / E |
| Overseer set (**DESIGN, do not print**: mount bolts and the Overseer system open; files in `runs/battery_latch/v4/stl/`) | cartridge 171.0 x 55.0 x 58.6 (prints 174 tall), **tab line z_T 85.5 = swap CG (0, 33.1, 80.3) + 5.18 toward the XT60 end (arm v7 PR 79)**, swap 755.4 g; Z_X 163.8; **receiver v2 66.8 wide (x ±33.4: pocket blocks; walls ±32.8), y 0.2..68.8, z −6.3..177.3 (183.6: prints deck down on the bed's diagonal, needs 177.1 of 180)**; Overseer bays alternate with Scout bays at R 113 (arm v7) | C / E |
| **Receiver mount interface (drone belly frame, Overseer sled, bay body)** | mount plane y Y_M (Scout 54.1, Overseer 68.8), unchanged by v2; the v2 body's top bears on it (bosses, walls, end walls, ribs, the carrier cap) except a 1.0 relief over the Scout's FC (tab line −5..+9); **bolt positions (±BX, tail z) and (±BX, Z_X); Scout (receiver v3, PR 109 review 24 Oct, DEFAULT; the Scout frame and the Scout bay bodies) BX 26.55, tail z −0.1, i.e. drone (−42.65, ±26.55) and (43.25, ±26.55) (v2: 25.6, z −1.3); Overseer 27.8, tail z −1.3 (+ (±27.8, z_T 85.5))**; M3 bolts up from below into M3 x 5.7 heat-set inserts in the partner. **Scout: each bolt in a full-height column beside the wall, head on a flat at y 24.5 (drone z −20.0), the seat and the 3.0 ring round the head's band (y 21.5..24.5) whole inside the collar clip (bearing 1.0, ring 1.0, C): 4 x M3 x 35, 5.4 past the mount plane, the partner's hole ≥ 6 deep under each M3 x 5.7 insert (DEFAULT, E); the lead-end pair clamps the XT60 carrier (body boss → base ear → cap → partner).** **Overseer: open (v1 too): from below its bolts pass through the cartridge's rail zone (rails x 26.5..27.5 to y 58.6); options (a) from above into heat-set inserts in deck bosses, (b) outboard bosses, 76.2 wide (Overseer and box sessions).** The partner keeps the XT60E1-M rear + leads window x ±9.25, z Z_X ± 5.55 clear. Scout in the drone: mount plane drone z 9.6, bolts at drone (−41.85, ±25.6) and (43.25, ±25.6); the FC (z 9.5..17.5) sits on the partner side | C / E |
| Joint reactions per boss (rigid plate, E; tension = away from the partner; receiver v2; the Scout's v3 pattern (x 26.55, tail z −0.1) moves them by < 5 %, `runs/battery_latch/v4/result.json` reactions) | Scout (4): hover 0.5, flight 3.2, catch 3.1, crash −y 18.2, crash +x 19.7 (shear 18.2), crash +z 11.6 (shear 18.1), corner (+x −y +z) 28.5 (shear 14.8), insert 60 N 14.9 compression, pull 50 N 25.0 on the lead-end pair. Overseer (6): hover 1.9, flight 10.7, catch 11.3, crash −y 66.0, crash +x 55.0 (shear 65.8), crash +z 27.3 (shear 64.2), corner 85.6 (shear 53.3), insert 14.5 compression, pull 25.0. Swap set: the 74 N stall is at most 18.5 (Scout) / 12.3 (Overseer) compression per boss if the bosses alone took it; the body top bears on the partner too. Full table: `result.json` reactions | E |
| Strength (receiver v2, `battery_latch_topo.py --swap-v2`: body + XT60 carrier + cap clamped, bolts at the boss seats, the mount face bearing on the partner for +y; deck-down print, layers across the install axis; misuse SF 2.5 / flight SF 4; Scout h 1.0, Overseer h 1.5; M mesh, E loads) | **Swap set (hub / arm 24 Oct: 74 N stall insert, 57 N pull, 43.5 N across, 7.6 N / 1.05 N·m centring, no guide couple; every swap case flight class = 10.8 MPa in-layer / 5.4 across at 1.0): Scout worst 0.51 (receiver v3 0.413, 43.5 N across 0.34 mm), Overseer 0.55 (43.5 N across: 4.6 / 2.7 MPa in-layer, 2.8 / 3.0 across layers)**; 74 N + 43.5 N 0.41 / 0.45; deflection at 74 N 0.001 / 0.001 mm (≤ 0.1), 43.5 N across 0.35 / 0.78 mm (inside the float's ±1.0). L cases: crash 0.07 (Scout at 15.3 g) / 0.39 (Overseer 35 g), handling 0.12 / 0.07, flight 0.03 / 0.07. **First mode of the seated pack 546 Hz (Scout, receiver v3) / 458 Hz (Overseer)** (≥ 100 Hz). Hand calc: sliders at a 74 N stall on one bolt 0.22, grip pull 57 N + 1 g 0.37 / 0.40, cartridge v6 rib 0.25. v1 on the same set: across 2.08 / 1.53 with 5.4 / 4.4 mm (`fe/fe_*_receiver_v1.json`) | M / E |
| Mass (`budget_g`, soft; **the slots are the v4 masses, not a system split**) | Scout: cartridge v6 37.9 + 2 sliders 5.8 + 2 TPU end skids 4.6 + 2 TPU strips 2.2 = **50.5**, receiver v3 94.4 + XT60 carrier 4.8 + cap 5.5 + 2 strips 2.0 + TPU end pieces 8.2 = **114.9** (bays without the end pieces: 106.7); **165.3 g per drone set, 157.1 per bay set (v3 159.6, v1 91.0)**; the v4 grams buy the whole head seats, the tail end piece and the wider bolt pattern. Overseer: cartridge v6 97.6 + 2 sliders 7.5 = **105.0**, receiver v2 216.2 + 5.0 + 8.1 + 4.1 = **233.5**; **338.5 g (v1 185.9)**. The cartridge v6 rib and its cross walls are +5.7 / +7.2 g. The grams buy the swap set: solid 5.0 walls and 6.0 end walls to the feet; truss windows on the Overseer save ~34 g but moved 1.15 mm across. A receiver topology pass is the follow-up. Bought per receiver: XT60E1-M 6 (E) + pigtail, M3 bolts (inserts in the partner); per cartridge: spring, 2 magnets, 2 set screws | M / E |
| Scout fit (the Scout chat's latch refit, snapshot `runs/battery_latch/v1/scout_v3_refit/`, current latch parts (receiver v2, cartridge v6) with every skid as a cage-role part; `battery_latch.scout_system()`) | **The Scout's own pass decides** (Scout v3 session, its cage with the keel back and the v3 bolt pattern, run v4 meshes). Reference only: the latch manifest on its collar-band stand-in `System: battery_latch_scout, cage first 5.8 mm (E), fit 0.0 mm³ (E), mass 515 g (E), CG 0.9 / 1.8 mm (E), probes 2.9 mm (E) (cartridge)`; my old refit snapshot (its cage predates the skids, the keel and the bolt pattern) `System: Scout v3, cage first 4.5 mm (E), fit 2.6 mm³ (E) (mount + nose legs (Scout) / receiver skid nose) FAIL, mass 812 g (E), CG 1.3 / 1.8 mm (E), probes −27.9 mm (E) (receiver) FAIL, access 7/7 clear`. **Probe exemption (DEFAULT): the cartridge set and the receiver round the swap opening are exempt to 40° (the swap path); alternative: no exemption, the receiver recessed ≥ 3 inside the cage's bottom plane.** **Scout set HOLD** until that pass reads fit 0 and probes PASS. Assembled worst index (one set of numbers): Scout frame model every case ≤ 0.98 (F); the latch parts under them: receiver crash ≤ 0.08 at the suspension's ~16.7 g, flight 0.03, landing 0.05, handling 0.12, swap set ≤ 0.413; sliders ≤ 0.37, cartridge v6 rib 0.25; cartridge floor 0.14 (E) | C / F / E |
| Overseer fit | **pack 30 behind the thrust axis (Spark 24 Oct: B, decided)**; `overseer.assembly.json` on main, cartridge, pack and receiver replaced: `System: Overseer, cage first −59.0 mm (E) (Unitree L2) FAIL, fit 27792.2 mm³ (E) (belly sled + pods / receiver) FAIL, bbox 85.7 L, extents 634 x 570 x 237 mm, mass 2636 g (E), CG 10.7 mm off thrust axis, 26.8 mm without swap parts FAIL, probes −0.0 mm (E) (Unitree L2, unshielded) FAIL` (pose B, XT60 end forward); the latch set 66.8 x 68.8 x 183.6 (0.84 L, M); the belly sled was cut for receiver v1 and must be cut round the v2 box + 1.0; also cage lower vs pack, feet and down camera vs receiver (Overseer session). The balance numbers are the Overseer layout's | C |
| **Overseer vs the funnel opening (catch G (2), box structure v2, 24 Oct)** | everything below the wheels passes the 168 opening at ±5° yaw, 3 a side: need = 0.996 L + 0.087 W + 6. **The 162 target is not reachable with the 148 pack**: an empty tray round it (153 x 55, no lead room, no receiver end plates) needs 163.2; a shortest credible set (lead room 6, XT60 over the pack end, receiver z located by its pockets) 159 x 55 needs 169.2, with receiver end plates 178.8. **The v1 set (receiver 179.6 x 66.8) needs 190.7 along the drone's fore-aft. Hub DEFAULT 24 Oct: latch v1 stays as drawn; the catch widens the opening along the drone's fore-aft (~191); the arm (now Y_C 165, PR 79) clears the arm-side ends (at Y_C 165: Scout Y 111.6..207.6 incl. the set-screw boss, Overseer Y 76.5..250.5).** Set centre: 9 toward the XT60 end from the pack centre; the pack centre 30 behind the tab line (the thrust axis, Spark B) | C |
| Scout crash case (Spark / Scout v3 24 Oct) | the cage's preloaded TPU suspension gives above ~120 N (plateau, Scout refit), so the core (receiver, cartridge) sees ~16.7 g (120 N / 0.734 kg), the pack ~35 N (E); receiver v2 at 15.3 g: crash 0.07 (FE), its Scout worst is the swap set (0.51), not the crash | E |
| **Build count (Spark 24 Oct: 9 bays, 4 Overseer + 5 Scout)** | receivers: Scout 5 bays + 1 drone = **6 sets** (receiver v3 + XT60 carrier + cap + 2 strips; TPU end pieces on the drone one only: 114.9 g drone, 106.7 g bay), Overseer 4 + 1 = **5 sets** (233.5 g); cartridges: one per bay + one flying = **Scout 6** (50.5 g), **Overseer 5** (105.0 g). Print time per unit (E, ~10 g/h PETG with tree supports, CHECK on the slicer): Scout receiver ~9.5 h, Overseer receiver ~22 h; totals ~2.63 kg, ~263 h. Spare XT60 carriers (with XT60E1-M + pigtail) per bay for the XT60 service interval | M / E |

## O. Overseer (bought hardware)
| Item | Value | Tag |
|---|---|---|
| Mass | 2.0 kg with battery | P |
| Frame | S500 **2015 edition, PCB version with carbon fibre landing gear (Spark 23 Oct, AliExpress listing in M)**. **Stock motor centres r 243.2, wheelbase 486.4 (derived: Holybro S500 V2 STEP, the same S500 moulding, M row; listings round it to 500 or 480; CHECK one diagonal with a tape).** **Printed shorter arms (Spark 23 Oct; motor placement now per Cage v0: square 279 kept, 52.1 ahead of the plate centre): wheelbase 395 (C at 25 tip gap, DEFAULT; alt 15 gap 380), motor r 197, tip-to-tip span 533 (C): each arm 46 shorter than stock (stock tip gap 89.9). Floor 359 (tips touching). Roll authority (torque / inertia) x1.07 vs stock (E): retune rates (PX4 autotune) on the new arms. `nox/overseer/arm_reach.py`** | Spark / derived / C / E |
| Arms and hub (printed, Spark 23 Oct: the arms are what the plates screw into, so make that part taller and put the electronics between the plates) | **arm root 45 tall between the plates (DEFAULT; stock gap 17.94, derived), top flat at the arm-top level, bottom tapering to 16 under the motor; the hub grows down 27 so the top plate and the L2 keep their height.** **Plate interface (derived, M row): per arm 2 x M3 into the top plate (Ø3.1 at u 63.17, v ±15), 2 x M3 into the bottom plate (Ø3.0 at u 63.74, v ±10; drill 3.2), 2 Ø6 locating pegs up into the top plate (u 57.66, v ±11, pegs Ø5.8 x 1.5); M3 heat-set inserts in the root (hole Ø4.0, boss Ø10); the stock third top screw (u 34.66, v 0) and its 5 mm tongue are dropped so the Pi deck reaches the top plate (DEFAULT, alt keep it and lower the deck).** Root inner face u ≥ 58 for |v| ≤ 20, so a centred rectangle fits between the roots when its half sizes sum ≤ 82: Pi 5 85 x 56 (sum 70.5) fits with ~8 to spare (C); Pi beside the FC stack does not (sum 90), so two decks: FC stack (17.5) on the bottom plate, Pi deck above (Pi with cooler ~21, E). First vertical bending, symmetric arms at r 197 (v0; Cage v0 has front r 237 / rear r 165 and their modes), PETG box arm, wall 2.4, clamp u 75 (E, `arm_reach.py`): root 18: 93 Hz (on 1P hover 87, bad); 32: 160 Hz (top of 1P 87..158); **45: 223 Hz** (above 1P full, 28 % over 2P at hover 174); ~37 g per arm. Stock arm (CAD sections, PA66-GF 6 GPa, no carbon rod modelled): ~27 Hz (E), below the band; the tune flies on it. Sides stay open between the roots for air and cables. Hub under the disks at 395: 140 square 1.5 % of disk area (C) | derived / C / E, DEFAULT |
| **Layout v0 (rough, 24 Oct, Spark: no cage, everything between the two plates, L2 on top, down camera + flow at the bottom, battery centred under; `nox/overseer/layout_v0.py`, `runs/overseer_layout/v0/`)** | drone frame x fwd, y left, z up, z 0 = bottom plate top. **Between the plates (z 0..45):** FC + ESC stack 36 x 36 x 17.5 at the centre on 1.0 standoffs; printed Pi deck z 20..22 on 4 posts, Pi 5 on it z 22.5..42 (3.0 under the top plate, E Pi height; deck corner 3.6 off the root faces); FCHUB-12S PDB on the rear wing (x -95..-45); UBEC, 12 V buck and RX on the front wing (x 50..98); 4 ESCs under the arms at u 92..137 (model open). **Top:** L2 on a printed mast: a 4-leg spider on the top plate under the arm-top screws (load straight into the arms), 44 square column, Ø75 seat; **L2 base z 125** = props z 82 + 5 blade band at r 324 under the -6° cone + 3 (C on E prop height: pad + 37). Front camera on the column face, centre z 95, 30° up: **the props sit in its lower corners (9 % of the disk points, ≤ -4° elevation, E): mask them in the colouring (DEFAULT); alt 45° tilt clears them and loses the view below the horizon.** **Under:** printed belly sled on the bottom plate; pack 148 x 48 x 45 centred, top z -7 (5 for the latch block, E), bottom z -52; down camera in a pod at y +49, flow MTF-02P in a pod at y -42, both lenses at the pack bottom level looking down, views clear of the pack, feet and wheels (C); 4 TPU feet at (±68, ±34) to z -61 (lowest point). **Catch wheels hang from the arms:** each pair at the G points sits under its arm (u 149.9, v ±8.5), wheel centres z -12 on a short leg: no belly ring (DEFAULT, alt a belly ring). **Funnel, seated:** bottom plate top at seat z 44.9; closest non-wheel point to a face 3.2 (G rule ≥ 1.0); below seat z -0.8 max 75.8 at ±5° yaw vs 84; props at seat z 127 over the funnel top 75.1. Span 533, height 251 (feet to L2 top). Mass ~2.12 kg (E), CG (0.4, 0.5, 25.2), 57 under the prop plane; PX4 flow position from the CG (FRD) x 0.000, y +0.043, z +0.080 m (C on E masses) | C / E, DEFAULT |
| **Layout v1 (rough, 24 Oct, Spark: L2 turned 105° so its axis points 15° below +x, at the nose clear of the props, balanced with the battery and parts; `nox/overseer/layout_v1.py`, `runs/overseer_layout/v1/`; supersedes v0 for the L2, the camera, the arms and the catch; follows the hook latch of 24 Oct: no steel plate, R 5 wheels, plunger keep-out)** | drone frame as v0, plate centre x 0. **L2:** base centre (352.8, 0, 49), axis 15° below +x: every drone point behind its field in both modes (96° negative-angle cone kept clear; closest the props 1.0, C on E prop height); body lowest z 2.7, 1.9 over the funnel top seated (z 0.8). Front camera rigid to it on a bracket behind the L2 base plane (30 behind, 74 up the plane), aimed at the horizon, portrait (DEFAULT, O Camera): lens (352, 0, 128), L2 and props out of its view. Nose boom: root block between the plates on the front wing, beam over the funnel top to a block behind the L2 seat. **Balance (CG 0.1 off the thrust centre, E masses):** the printed arms carry the motor square 76.5 ahead of the plate centre: motors (216.0, ±139.5) front, (-63.0, ±139.5) rear, tip gaps 25 kept; front arms r 257, 34 → 28 wide, 38 deep at the motor, first bending ~164 Hz (over 1P full 158, under 2P hover 174, E); rear r 153, ~443 Hz. The catch (wheels, cartridge, pods, feet) sits 30 aft of the plate centre (best of 0 / 10 / 20 / 30 aft, searched with the first front arm size and rerun at 30 aft with the final one: the shortest front arms, C). Hub as v0, but the UBEC, buck and RX sit on the PDB on the rear wing (the front wing carries the boom root). **Funnel and latch:** the front arms run past the mouth, so the R 5 wheels hang lower (centres z -40) and the drone sits higher (bottom plate top at seat z 74.3); the cartridge hangs to keep v0's cartridge bottom (seat z -7.7 on R 5 wheels; the swap wheel's R 100 fixes it for both drones, matching the Scout's is the cartridge part's job, CHECK). Legs from the arms, longest 89 in plan; the ±y-face wheel legs knee 15 inboard at axle height before rising, so the hook latch plungers (G (7)) keep 2.0 (≥ 1.0). Closest other point to a face 2.9 (≥ 1.0); below seat z -0.8 incl. the 157 cartridge 80.6 at ±5° yaw vs 84. Pogo pads (G (6)) not placed yet. **Size and mass:** 607 long (rear prop tips x -190 to the L2 nose x 417), 533 wide, 237 tall; ~2.54 kg (E; v0 2.12 E, the 2.0 kg P was the stock frame: + nose boom and camera bracket, deeper front arms, longer wheel legs). T/W ~2.6 at 6.6 kg static. PX4 offsets from the CG (FRD, m): flow x -0.107, y +0.043, z +0.090; IMU (FC centre) x -0.077, z -0.003 | C / E, DEFAULT |
| **Cage v5 (27 Oct; `nox/overseer/cage_v5_shell.json`, frame `runs/overseer_frame/v1/`)** | 24 nodes, 63 tubes 6 mm (15.9 m, 116..446), 670 x 655 x 211; base loop 6 nodes (404 x 239) at **z -79.9** (cartridge bottom -3; was -57); 31 links (25 tube 6/4, 6 rod 3.0; the head on 3 of them); front core ties from (114, 0, 20) aimed forward; TPU feet Ø16 x 3 caps under the loop nodes, contact z -93.1; ~3226 g, T/W 2.04 | C / E / F, DEFAULT |
| Sensor head supports (Spark 27 Oct: max 3 rods) | 3 carbon 6/4 rods to the cage, none to the body: head rod c from (u +40 on the L2 up axis, 12 behind its base plane) to node 17, head rod ±1 from above the cameras (u +100, y ±80, 12 behind) to nodes 15 / 16; every socket boss clear of the head's keep-outs; 119.4 / 94.2 Hz rigid / PETG joints (F on E); cameras 5.2, L2 51 behind the cage (system_check, E); `runs/overseer_head_rods/v1` | F on E / C, DEFAULT |
| **Cage v3 (26-27 Oct, superseded 27 Oct by Cage v5: half the tubes)** | 48 nodes, 131 tubes (`nox/overseer/cage_v3_shell.json`) | C / E |
| **Cage v2 (26 Oct, superseded the same day by Cage v3: Spark wanted the L2 and the front camera outside the cage)** | disk round everything, L2 inside; `runs/overseer_layout/v4/summary.md` | C / E |
| **Cage v1 (26 Oct, superseded the same day by Cage v2: Spark wanted the v2 layout kept, not a sphere)** | sphere R 363, L2 on top; `runs/overseer_layout/v3/summary.md` | C / E |
| **Cage v0 (superseded 26 Oct by Cage v1; layout v2, rough, 24 Oct, Spark: "the lidar should be mounted on the cage and not extend out from the body to save weight, lets make the cage first, it must fit in the funnel"; "use the 3mm rods whenever we can"; `nox/overseer/layout_v2.py`, `runs/overseer_layout/v2/`; supersedes v1 for the L2 mount, the wheels and the balance)** | drone frame as v0. **Rods and nodes:** every cage member is 3.0 solid carbon (G Carbon rods); every node PETG (corner, ring, apex, front hub; DEFAULT 24 Oct: rigid L2 mount, epoxied sockets, catch rule all PETG; alt TPU on the 6 rear and side ring nodes for crash give), TPU feet only; 36 rods, 6.69 m, 74 g (C); thicker carbon only where a 3.0 rod cannot carry the load (DEFAULT, Spark 24 Oct; none needed yet). **Guard:** two octagon rings round the motor square at z 68 and 92 (prop plane 82 -14 / +10, DEFAULT: the lower one low enough that the arm-tip spokes pass 15.2 under the swept band, ≥ 12), flats 280 from the motor-square centre, chamfers on x + y = 477.7: every ring rod 12.0 off the swept disks in plan (C, the Scout's 12); 8 ring nodes; 2 spokes per motor from the arm tip to the 2 nearest ring nodes. The front flat is a V to the L2 apex node: sockets on side lugs beside the L2 body (y ±46, behind its base plane), so the V never comes inside the front flat; 2 keels from a front hub on the bottom plate front wing to the lower sockets. **Wheel ring (in the funnel):** 4 corner nodes at the catch points, each spanning its chamfer with 2 R 5 wheels (Scout-style), a lower ring of 4 rods on the wheel centre lines (rims 3.5 proud), wheels at z -38; one strut per corner node from the x-face wheel cheek up to the nearest arm (longest 88), clear of the hook latch plungers. **L2 on the cage:** base centre (336.4, 0, 51), axis 15° below +x; the normal 90° field is kept clear (DEFAULT; the 96° negative-angle mode would see the far ends of the front V unless the L2 moves ~20 further out, E): closest the apex 2.0 behind it; body lowest z 4.7, 1.9 over the funnel top seated. The L2 body is the only thing ahead of the cage. Front camera on a 3 printed plate on three 3.0 rods from the apex block, horizon, portrait, lens (336, 0, 130). **Balance (CG on the thrust centre, 0.0 off, E masses):** motor square 52.1 ahead of the plate centre: motors (191.6, ±139.5), (-87.4, ±139.5); front arms r 237 (34 → 28 wide, 38 deep) ~197 Hz, rear r 165 ~359 Hz (E); catch 30 aft (best of 0 / 10 / 20 / 30: 71.4 / 65.1 / 58.6 / 52.1 ahead, C). **Funnel:** bottom plate top at seat z 72.3; closest non-wheel point 2.9 (≥ 1.0); plungers 2.0 (≥ 1.0); below seat z -0.8 incl. the cartridge 80.6 at ±5° yaw vs 84; guard rings and arms above the funnel top. **Size and mass:** 615 long (rear prop tips x -214 to the L2 nose x 401), 533 wide, 237 tall; cage ~96 g without the apex (E); drone ~2.33 kg (E; v1 2.54 with the boom). PX4 from the CG (FRD, m): flow x -0.082, y +0.043, z +0.087; IMU x -0.052, z -0.003 | C / E, DEFAULT |
| Props | 1045 (254 dia); disks reach 304 from the centre along x and y at 500; adjacent tips 99.6 apart (C), the room the printed arms take back | C |
| Propulsion | SunnySky X2216 II 880 KV x4, 4S; 1650 gf per motor at 27.2 A = 6.6 kg static (C); T/W ~3.3 at 2.0 kg (stock frame, P mass), ~2.8 at the cage v0 ~2.33 kg (E) | C / E |
| FC / PDB | **ESC: 4-in-1 under the FC in the hub stack (Spark 27 Oct; model open), none on the arms.** MicoAir743-Lite (single IMU, no compass), 30.5 mount, Ø4 holes; MATEK FCHUB-12S V2, 30.5 mount, Ø3 holes (section M) | P / spec |
| Battery | 4S 6000, XT60, 3 on hand; out the bottom. **148 x 48 x 45 (P, Spark 16 Oct 19:02); mass and lead exit E until weighed (Spark 16 Oct 23:39: go on these)**; balance pads: the Scout's 5-pad layout and pitch (Spark 16 Oct 20:39) | P / E |
| Flow + range | MTF-02P, lens at X +22.5, Y 0, Z +74 from the FC centre (FRD) on the stock frame (P); **moves to the belly pod beside the cartridge in the new layout (layout v1 row: offsets from the CG), set SENS_FLOW_POS when it flies** | P / C |
| Lidar | Unitree L2, 230 g, 75 x 75 x 65, 12 V 10 W. **At the nose, axis 15° below +x (Spark 24 Oct), outside the cage with nothing in its field (Spark 26 Oct): Cage v5 base (384.0, 0, 51) (C); every cage member 3.0+ behind its base plane; guard ring r 62 behind the plane; mount: the printed sensor head mount (Spark 27 Oct, topology; `runs/overseer_layout/v5/head_system.json`) with 2 carbon keels and 4 braces; the lugs are the fuse (let go before the L2 base); field cone 75° (cage first gated outside it), 64 out along its axis** | P / Spark / C |
| Camera | **2 x DECXIN 2633V2 global shutter, 102° diagonal (same as the Scout), both beside the L2, field maximized; no down camera (Spark 27 Oct)**. Landscape (89 x 73), yawed 45° out, pitched 10° down, lenses (390, ±75, 122) (C), 13 behind the L2 base plane, so the head and both cameras are one print (Spark 27 Oct, box ≤ 175); 3.42 sr together, no overlap, fields meet at the nose (2° gap), 54 % of the L2 field; nothing of the drone in view (C). On the printed sensor head mount; a guard bar over each behind its lens. Yaw ≤ 30°/s while colouring (E) | P / Spark / C / E, DEFAULT |
| Firmware | PX4 1.18.0rc, airframe 4001, DShot, CRSF; flies perfectly in Position mode (Spark 23 Oct); `MAV_SYS_ID` not set yet (Spark 23 Oct; DEFAULT Overseer 1, Scout 2); backup `claude/overseer_params_2026-09-26.params` | P |
| Catch | **Cage v2 (26 Oct): no wheels; the new funnel is designed round the shell (box catch session).** Was: the shared collar, section G "Catch interface", 8 PETG R 5 wheels on the cage v0 corner nodes | DEFAULT |

## System Overseer: arms (27 Oct 2026, arms system pass on layout v5 / cage v3; script `nox/overseer/arm_topo_v1.py`, page `nox/overseer/arm_view_v1.py`, doc `nox/overseer/arms.md`, runs `runs/overseer_arm_front/`, `runs/overseer_arm_rear/`, pair `runs/overseer_arms/v1/`; C geometry, E loads unless tagged)
- Plate gap 45 kept (27 Oct, with the core session: its stack + leads reach z ~26.5, Pi 5 on the rear wing to 39.6, its minimum ~32; the arms want ≥ 45; O Arms and hub).
- Pose v1 (layout v5 at af98ac52, pinned in `runs/overseer_arms/v1/inputs`, C): motors (200.3, ±139.5), (-78.7, ±139.5). **Pose v2 (cage v5 on main, C): motors (205.9, ±139.5), (-73.1, ±139.5); root centre to motor 183.9 front, 96.1 rear; front rods 145.7; keep-outs = the core session's parts + 1 (`arm_topo_v2.py`).** z 45 motor face = arm top = top plate underside, z 0 bottom plate top; root centre r 66.5 on each 45° diagonal; root centre to motor 179.0 front, 97.8 rear (C).
- Pairs: front and rear differ; each right arm is the mirror of its left (every case is mirror-symmetric). Motor holes are radial slots r 8..9.5 on all four 45° lines, so a mirrored pad takes the X2216 with its leads to the root.
- Left off v1 (Spark 27 Oct: "ignore the cage nodes on the arms for now"): cage nodes, spokes, L2 brace sockets. The cage pass adds them and the arms rerun (spokes and L2 braces are 6/4 tube: arm sockets 6.2 x 15, `nox/overseer/link_sizes.json`); the spoke socket sits off the motor axis (the Ø27 screw pocket under the pad is the key path, open below).
- **Cage links (v2, Spark 27 Oct "add the arm nodes"):** 3 spokes of each arm meet in a printed node beside the motor, off the key column (front (178.9, ±146.7, 8), rear (-53.3, ±119.7, 25); every spoke line ≥ 17 from the motor axis in plan, C); 2 L2 braces ended in the front beam at (72.95, ±62.11, 30 / 39) until v5b (now on the cage's top-plate block, none on the arms, cage session 27 Oct); 6/4 sockets 6.2 x 15 + 0.6, wall 2.5.
- Cage link loads: the cage frame model's summed force per case (`arm_joint_loads.py`, `runs/overseer_arms/v2/joint_loads.json`): worst front tip 1108 N, rear tip 1811 N, braces 904 N (F, core held rigid).
- **Root joint (Spark 27 Oct: "just assume those are good"):** the 4 M3 heat-set inserts and the S500 plates are taken as adequate for the cage crash loads (worst bolt ~2.4..2.7 kN least-norm, no contact, vs ~0.6 kN an insert, E; frame v1 arm_loads: rear node 2320 N, front 1075 N, braces 896 N, F). One printed arm, no fuse node. Reported, not a gate.
- Supports: the two plate contact faces of the root (main), and the 4 M3 insert bores alone for the thrust and handling cases (concept review 27 Oct).
- Joint (E): a vertical tip load's root moment goes into the plates in plane over the 45 root height: handling 9.0 / 4.9 N·m gives 199 / 109 N along the arm, ~100 / 55 N shear per insert if friction carries none; twist about the arm axis gives < 60 N tension per insert.
- Masses: motor 81 (M) + prop 10 + screws 5 = 96 g at the motor CG z 60. ESC: a 4-in-1 under the FC, the stack on top of the top plate (Spark 27 Oct, core session), none on the arms. Motor leads along each arm's flat top (z 45) to the ESC corners, zip-tied (front: round the top rods).
- Loads (E): thrust 1650 gf at 14.8 V (C) x (16.8 / 14.8)² = 21 N; yaw reaction 0.5 N·m both signs (DShot braking); prop gyro 0.2 N·m (5.4e-5 kg·m² x 995 rad/s x 3 rad/s + margin).
- Rotor band at 3380 g (E): 1P hover 113 / full 158 Hz, 2P hover 227 / full 317 Hz. **Mode target: every first mode ≥ 190 Hz (1.2 x 1P full; lateral counts: 1P imbalance is in-plane) with the root on the 4 inserts alone (DEFAULT; alt ≥ 300 Hz).**
- FC requirement (2P passes 190 Hz in descents): PX4 dynamic notch on ESC RPM (`IMU_GYRO_DNF_EN`, `DSHOT_BIDIR_EN`); the 4-in-1 runs AM32, BLHeli_32 or Bluejay (DEFAULT; parts list when the ESC is chosen).
- **Front pair carbon chords, v1..v4** (superseded by the v5 tube chords below; concept review 27 Oct: PETG alone tops out near 190 Hz at ~60 g; a plain 30 wide box read lateral 130 Hz, C): 4 x 3.0 rods, top z 41 / bottom z 4 each side, from shoulders (arm frame x 25, y ±35, outside both plates) to y ±12 at x L - 15; 140.9 each (C); bore 3.2 (Spark 27 Oct from the printed coupons, P; was 3.3) open at the shoulder, blind in the pocket wall.
- Rods in the topology: `Part.insert` (engine 27 Oct): solid at 120 / 2.78 GPa = x43, voxel area corrected to Ø3, never printed, out of the PETG indices; tie cases see them absent, so the print holds its drawn bodies by itself. Drawn: 18 mm sockets (OD 8.6) at each end (epoxy ~340 N an end, E); the bore cuts collars through webs.
- Rod install (Spark 27 Oct, `--rodcheck`): bore clear from 160 behind the shoulder to the blind end, sockets ≥ 80 % gripped; the insertion line past the 30 mm bore cut lies outside the envelope (0 mm³, C).
- Assembly: ream the bores with a 3.2 drill, epoxy in the tip socket, rod in from the shoulder, wick epoxy into the collars (`arms.md`). A free span carries its chord force (3.0 over 60 buckles at ~1.3 kN, E). Shaft bore Ø8.6 (2.0 web to the slots; stock Ø10.5; CHECK P, DEFAULT).
- **Strength, generous (Spark 27 Oct: "if this arm is flimsy the drone is fucked"):** index targets half of L: ≤ 0.25 flight and landing, ≤ 0.5 crash, handling and blow; handling 100 N (2 x L); a direct 150 N blow on the motor end in 6 directions (crash class); generated volume front 40, rear 25 cm³ (E). Weight reported, never traded for strength. Breaking order (L) once the cage nodes exist.

- **v5 system pass (27 Oct, after three strikes on each pair; `arm_topo_v5.py` .. `arm_topo_v5d.py`, chain to `arm_topo_v1.py`):** chords on both pairs are 6/4 carbon tube (OD 6, ID 4, bore 6.2, C), top z 38.5 / bottom z 6.5 (C), 20 mm sockets (C), a full-length 2.5 sleeve (C) and a 2.5 wall closing the blind tip end (C); front shoulders arm x 25, y ±35 (C), rear x 20, y ±28 (C), both to y ±12 at the motor (C); tubes front 145.7, rear 63.1 (C).
- **v5 root:** solid root block (u 58..84, C), top / bottom flanges 6 thick (C) x 0..40 and from the root to both shoulder sockets.
- **v5 loads:** no L2 brace sockets; the cage frame `arm_loads.json` (cage branch claude/gracious-mccarthy-5rctc9 @ b61353a9, snapshot `runs/overseer_arms/v5/arm_loads.json`): rear spoke node 2354 N, front 1013 N (F on E); main's System Overseer v5 line still reads 2317 / 1074 (before the brace move; the cage session updates it). Generated volume rear 50, front 45 cm³ (E).
- **v5 results (M unless tagged):** rear v5d HOLD (balance: the assembled CG gate; `print/overseer_arm_rear_v5d.stl`, `_mirror.stl`): 187.4 g PETG + 6.1 g tubes (E), modes 435 Hz on the inserts, worst index flight 0.04, handling 0.16, blow 0.11, cage crash 11 0.94 at the top plate corner (the root joint, Spark 27 Oct), 0.77 in the arm at the shoulder socket:
- **Rear v5d crash margin:** the 0.5 crash target is missed in that one cage case; reported, not a gate (DEFAULT keep; alt: more volume or a lighter cage load on the rear node).
- **Front v5d DESIGN:** 228.2 g + 14.2 g tubes (E), strength 0.62, solid PASS, modes 131 Hz vertical / 162 lateral < 190: back to the system pass (v6: carbon space frame, 12 x 3.0 diagonals, modal what-if 193..200 Hz, C).
- **Assembled (system_check on `runs/overseer_arms/v5d/overseer_arms_v5d.assembly.json`, E):** cage first 7.7, fit 0.0 mm³, access 21/21, mass 3555 g (was 3212 with the layout's arm meshes), CG 5.8 mm aft of the thrust axis (FAIL, tol 3; was 0.2): the pack position is the layout's (cage session told 27 Oct).

| Piece (qty) | Envelope | Interfaces | Cases (front / rear root moment) | budget_g | Stiffness | Worst index |
|---|---|---|---|---|---|---|
| Front arm (arm 1, mirror 4), v5d + 4 tubes 6/4 x 145.7 | hull of root block (u 58..84, v ±21), 2 Ø18 shoulders, Ø40 at the motor, the spoke node; z 0..45; less core keep-outs (+ 1) | root: 2 + 2 M3 heat-set (top u 63.17 v ±15, bottom u 63.74 v ±10), Ø4.0 x 7, boss Ø12, pads 9; motor pad Ø36 x 6, slots, Ø8.6 bore, Ø27 pocket; tube sockets 6.2 x 20, sleeves 2.5; spoke node 3 x 6.2 x 15 | as the loads bullets; cage crash x14 + flight 4 g (1013 N node, F) | 60 soft; v5d 242 (M + E) | modes ≥ 190 Hz on inserts (v5d 131: v6) | ≤ 0.25 / ≤ 0.5; v5d 0.62 |
| Rear arm (arm 2, mirror arm 3), v5d READY + 4 tubes 6/4 x 63.1 | root block + 2 Ø18 shoulders + Ø40 at the motor + the spoke node | as front | as front (2354 N node, F) | 55 soft; v5d 193.5 (M + E) | 435 Hz on inserts | ≤ 0.25 / ≤ 0.5; v5d 0.94 cage crash (joint), 0.77 arm |

## System Overseer core (27 Oct 2026, Spark: everything inside the cage but the arms and the nodes; core v4 (27 Oct): no head load, the cage hangs the L2 on 3 rods to its own nodes; the battery side an empty rectangular slot (latch later); cameras, lidar head and cage nodes not this section's; screwdriver access, fewest pieces; FC stack on the top plate, no mount; system pass `nox/overseer/core_v4.py` (older: `core_v1.py`..`core_v3.py`), assembly `nox/overseer/overseer_core.assembly.json`, results `runs/overseer_core/v4/`; drone frame as O; C geometry on E sizes, loads E unless tagged)
| Item | Value | Tag |
|---|---|---|
| Latch set in pose (battery latch v4 Overseer meshes) | receiver mount plane (deck top) **z -8.1** = bottom plate underside -2.1 - sled 6.0 (DEFAULT: receiver v2 asks a hole >= 6 deep under each M3 x 5.7 insert); XT60 end aft (x -108.3); receiver x -121.8..61.9, y ±33.4 | M / C |
| Latch set (cont.) | **pack top z -19.9, cartridge bottom z -76.9**; the cage shell (opening plane = cartridge bottom - 3) and the funnel follow it. **v2: the drone side is an empty rectangular slot x -121.8..61.9, y ±33.4, z -76.9..-2.1 (Spark 27 Oct: "the drone side just have an empty rectangle slot for now")**; its top 6 (z -8.1..-2.1) is kept for the receiver's own mount (DEFAULT); the latch set's masses stay in the model for balance | M / C |
| FC stack (Spark 27 Oct: no PDB, the ESC under the FC; "the fc mounts to the top plates lines", no mount) | MicoAir743-Lite 36 x 36 x 8, 10 g (spec) on a MicoAir 55A AM32 4-in-1 44 x 43.5 x 5.2, 14 g (listing; model CHECK); turned 45° so its 30.5 holes sit on the plate axes at r 21.57 in the top plate's 3.0 slots ("the lines": r 14.5..35.5 on -X, ±Y; r 25.2..35.5 on +X, so the +X hole sits at the central cutout's edge, CHECK); ESC z 49.6..54.8, FC top z 67.1 (C); PX4 SENS_BOARD_ROT yaw 45 | spec / C / E |
| Pi 5 + Active Cooler | board 85 x 56 x 1.6, holes 58 x 49 (3.5 from the far edge, 23.5 from the ports, spec); Active Cooler 63.5 x 42.5 x 13.7, intake on top (Raspberry Pi product brief, Jan 2026); right side up between the plates, board x -53.5..31.5, z 8..9.6 (C); cooler top z 23.3, 21.7 under the top plate; ports aft through the gap between the rear roots; GPIO 5 V from the UBEC (DEFAULT) | spec / C |
| Hub deck (PETG, on the bottom plate; core v4, 27 Oct: no head load) | 6 feet Ø14 x 6.5, M3 x 5.7 inserts in Ø4.0 through holes, on the plate's 360° holes (-24, ±36.5), (65, ±22.5) Ø3.1, (96, ±17) Ø3.5 (v4: the (60, ±17) pair and its slot pockets dropped); M3 x 8 up from below (x 10 through the clip's flange); drawn (v12): 6 feet, 4 Pi posts Ø7 x 8 on Ø12 x 6 root webs (M2.5 self-tapping Ø2.2 x 4), 4 pads Ø12 a bay under the UBEC (x 34..82, y -19..2) and buck (x 34..58, y 4..22), VHB tape; 11.8 cm³ drawn (E), the topology joins them (the bars are core v4's concept body only) | C / DEFAULT |
| Hub deck head load (core v4) | **none**: the cage session hangs the L2 head on 3 rods to cage nodes 15 / 16 / 17 (Spark 27 Oct: "max of 3" rods to the lidar); the 2 keel and 4 brace sockets, the tower and its loads (core v3, hub deck v9..v11) are gone | C |
| Hub deck (cont.) | carries Pi 55, UBEC 15, buck 6, wires 20 g (on the bays); v12: FE bolt reactions <= 11.4 N a foot, pull <= 0.5 N (35 g, SF 1.1, `runs/overseer_hub_deck/v12/modes.json`, C on M); worst 0.17; Pi mount >= 100 Hz (L): first mode 432 Hz; budget_g 30 (DEFAULT), v12 37.1 (M) | C / M |
| Flow clip (PETG, under the front wing) | MTF-02P pocket (21.6 along x, 16 along y, + 0.2), sensor top on the plate underside, lens z -8.6, centre (94, 0); 3.0 floor and walls with the lens window 12 x 10 (E); a 3.0 flange at (96, ±17): the deck's 2 front M3 x 10 clamp it (no screws of its own); 42° view clear of the slot, cage and links (C). budget_g 5 (5.0 M, print/overseer_flow_clip_v1.stl) | C / DEFAULT |
| Assembly order (every bolt with a straight screwdriver, Spark) | 1. hub deck: 6 M3 x 8 up from below into its inserts (slot empty); 2. flow clip: 2 M3 x 10 up into the deck's front inserts; 3. Pi: 4 M2.5 down; 4. UBEC, buck on VHB tape; 5. on the bench: 4 M3 x 30 up through the top plate's slots as studs, nylon standoff nut on top of each (+X stud: Ø9 washer); 6. arms, top plate; 7. stack onto the studs, 4 M3 nylon nuts from above, before the cage shell (its top tubes cross 2 nut lines). Nothing of the head lands on the core (core v4). | C / DEFAULT |
| Service | FC service: nothing off. Pi service: boots from a USB stick in an aft port (DEFAULT; its microSD end is 2.5 from the UBEC, unused), plugs aft; the Pi itself: top plate off (8 M3, the stack comes with it on its studs) | C / DEFAULT |
| Floor contact | TPU feet on 4 opening ring nodes of the cage (cage session; review alternative B: no cantilevered skids, no rails in the prop wash), contact <= 6 under the lenses (z <= -82.9), footprint round the CG (61.4, -0.2, 15.8) | DEFAULT |
| Asks of other sessions | **cage** (core v4, 27 Oct): the front core ties still root at (114, 0, 20), the deleted tower's point: nothing of the core is there now (body tie roots parked with the body nodes, Spark 27 Oct; theirs to re-root); keep body nodes off x 83..107, \|y\| <= 10 under the plate and the flow's view cone; shell on this belly (unshielded slot at -X); top tubes off the stack's nut lines (sent 27 Oct). | |
| Asks (cont.) | **arms**: gap 45, roots u >= 58 for \|v\| <= 21; motor leads over the arm tops; the arm v8 top screws at (±24.5, ±24.5) keep an Ø8 driver + 1 clear (RX moved, core v4). **latch**: the slot is its own (core v4: no pockets; the (60, ±17) feet are gone) | |

**Mounting holes, every part this section holds (checked 27 Oct; plate holes re-read from the STEP's cylinder faces, 360° only)**
| Part | Holes and screws | Positions (drone frame) | Source | Tag |
|---|---|---|---|---|
| Bottom plate, hub deck feet | Ø3.1 / Ø3.5 (360°), M3 up through the plate (x 8; x 10 through the flow clip's flange at the front pair) into an M3 x 5.7 insert in the deck foot (Ø4.0 through) | (-24, ±36.5), (65, ±22.5) Ø3.1; (96, ±17) Ø3.5 (core v4); every head clears the slot ((24, ±36.5), (-65, ±22.5) free) | S500 STEP | derived |
| Bottom plate, arm bottom screws (clear below the plate: the slot is empty) | Ø3.0 (360°) | (±52.14, ±38), (±38, ±52.14) | S500 STEP | derived |
| Not holes (do not use) | (-72.5, ±31.75) R3 outline fillets (90° faces); (-65, ±36.5) Ø3.1 sits under the rear arm roots | | S500 STEP | derived |
| Top plate, FC stack | the top plate's 3.0 slots on its axes (r 14.5..35.5 on -X, ±Y; r 25.2..35.5 on +X: the +X hole at r 21.57 sits at the central cutout's edge, CHECK on Spark's plate); M3 studs up through them | (±21.57, 0), (0, ±21.57) (the 30.5 square turned 45°) | S500 STEP ray probe (review 27 Oct) + Spark 27 Oct | derived / CHECK |
| MicoAir743-Lite | 30.5 x 30.5, Ø4 (M3 + grommets) | on the stack | maker | spec |
| MicoAir 55A AM32 4-in-1 (assumed model) | 30.5 x 30.5 (Ø4 one listing, M3 another) and 20 x 20 M3 | under the FC | listings disagree | listing, CHECK |
| Pi 5 | 58 x 49, Ø2.7, M2.5 self-tapping into Ø2.2 x 4 posts (DEFAULT) | holes 3.5 from the far edge, 23.5 from the ports: (-30, ±24.5), (28, ±24.5) | Raspberry Pi | spec |
| MTF-02P, XR2, UBEC, buck, cap | no holes: pocket (MTF-02P 21.6 x 16 x 6.5 + 0.2 / 0.3), tape or zip ties | | makers | spec / E |
| RX XR2 (top plate, core v4) | taped / zip-tied, x -30..-18, y 30..46, z 46.6..52.6: 5.5 off arm 2's top screw axis (-24.5, 24.5), the Ø8 driver + 1 needs 5 (cage ask 27 Oct) | | core_v4.py | C |

## S. Scan stick (23 Oct 2026; `nox/overseer/scan_stick/scan_stick.md`; C from the run scripts unless tagged; one bolted unit on the pole tip, Spark 23 Oct)
| Item | Value | Tag |
|---|---|---|
| Pole | EXTEND-A-REACH 1.5-3 ft telescoping extension pole (B08LL28XZW); tip 3/4"-5 ACME (major 19.05, pitch 5.08) | spec |
| Thread | base socket: female 3/4-5 ACME, 27 deep, 0.40 radial clearance, boss Ø40 x 34 (v12; Ø32 left a feather at the tube step), no entry chamfer; test ring 12 tall | C |
| Base | 168 tall; drawn column: thread boss Ø40 x 34 then a Ø36 tube (4 wall), Ø28 bore z 36..154 (wires), Ø10 cable hole through the flange centre from z 150, 10 x 30 cable window in the tube wall at y -19.5..-12.5, z 40..70 (shelf side); top flange Ø40 x 8 at z 160 with 4 x M4 heat-set (Ruthex RX-M4x8.1, spec: Ø5.6 holes 9.5 deep from z 158.5, 4.5 floor over the bore; M4 x 12 = 4 clamp + 8 in the insert) at (±8.5, ±8.5) = 17 square, Ø24 bolt circle; Pi tray plate 5 thick x 15..20, y ±32, z 8..99 and the switch strip y ±44, z 99..123 (one plate), standoffs Ø8 x 7 from x 20 on 58 x 49 (Pi holes 3.5 off the board edges), Ø2.3 x 6 deep for M2.5 self-tap; panel strip: rocker 19.4 x 13.2 at y +28, button Ø12.3 at y -26, LED Ø5.2 at y -39 (beside the Ø36 tube; 4.25 between the button and LED holes, 2.4 to the strip end), body keep-outs behind: rocker 22 x 22 x 21 deep (flattens the tube at y 17 to a 3.0 wall, M), button Ø14 x 15, LED Ø7 x 8 (E); pack face x -20: 5 mm back plate x -20..-15, y ±39, z 5..160; ledge 6 thick z 5..11, lip 4 thick at x -69..-65 to z 20, web x -20..-12, y ±16, z 11..70; rails 14 wide at y ±(25..39), x -30..-20, full height, strap slots 20 x 3.5 through rail + plate at y ±(30.25..33.75), z 47 / 121; shelf plate 5 thick y -23..-18, x ±26, z 5..66, 6 zip slots 3 x 8 at x ±12, z 12 / 32 / 52; UBEC bay (keep-out) x ±14, y -53..-23.5, z 4..68; keep-outs 0.5 off every drawn face, bore ends 2 off the boss top and the flange bottom | C |
| Head | 34 tall; flange Ø40 x 8, 4 x Ø4.3 at (±8.5, ±8.5) (17 square, Ø24 circle) with Ø8 counterbores 4 deep and Ø8 driver pockets to z 26 (open sideways between the arms, 18 mm, M; Ø5 key holes from z 25 up through the arms), Ø10 cable hole through the centre; L2 pads Ø12 x 6 on Ø51 at 22.5°, seat z 34 (world 202), Ø3.4 holes with Ø6.0 counterbores 3 deep from below (3.0 wall) and Ø9 driver clearance down to z 10, 6 x 10 gussets to r 8; camera block 34 x 10.5 x 30 at x ±17, y 12..22.5, z 2..32 (the 112.5° pad's Ø9 driver clearance passes its -X end, 2.9 wall, M); 2 x Ø4 heat-set (Ruthex M3, 5.7 long, spec) 20 apart at z 6, 7 deep from y 22.5 (3.5 floor, 3.0 to the M4 pockets, 2 below the pad clearances that start at z 10); bracket screws M3 x 12 (6 pad + 6 of the 7 deep holes, v7), L2 screws M3 x 8 (3 under the head + 5 of the L2's 6 deep holes); camera-bracket keep-out y 22.5..44, z -1..25 (the bracket hangs from its tab holes at z 6); L2 cable notch 14 wide on -X. Bolted to the base turned -90° about z: camera block over the Pi tray (+X), cable notch on +Y | C |
| Camera bracket | 44 x 60 x 16 envelope (6 plate + 10 posts; Spark 23 Oct: room for the plug and parts behind the board; plate 6 since v7, a 4 mm layer is under the topo engine's 4.53 mm robust plate); 2 bolt pads Ø12 x 6 at y 53, 20 apart (M3); posts Ø9 x 10 above the plate on Ø12 x 6 foot pads, Ø3.2 through (M2.5 inserts pressed 7 deep from the top), 2.9 wall; centre 32 below the bolt holes, 8 x 10 gussets; USB slot 16 x 4 | C |
| Keep-outs | pack 148 x 48 x 45 + 1 all round (P + C); Pi board + parts 30 deep off the standoffs; UBEC / buck bay 28 wide x 30 deep x 64 tall off the shelf (Spark 23 Oct: the UBEC is taped on, Q4 closed); camera bracket plate 48 x 21.5 x 26 off the block (y 22.5..44), hanging from head z 6 down to world z 121 beside the base's +X side; posts and board reach world x 39.5..41.1 (v7), board centre at world z 142 | C |
| Loads | 25 g knocks (14 dirs) on lidar 0.23 kg, camera 0.03, Pi 0.08, pack 0.59, head 0.30; 50 g impact (6 dirs); 100 N side hits; 150 N drop; hand 20-50 N; strap 120 N | E |
| Power | 4S 6000 → rocker → 12 V 2 A buck (L2, spec) + 5 V 5 A UBEC (Pi 5 + camera); ~19 W | spec / E |
| Network | L2 192.168.1.62 → Pi 192.168.1.2, UDP 6101 → 6201 | spec |
| Masses | base v17 340.1, head v13 42.0, cam v7 13.35 on the unit; thread test ring 8.3 (PETG); unit 395 printed + 230 L2 + ~30 camera + ~50 Pi + 590 pack (E) ≈ 1.30 kg | M / E |

## L. Standard drone cases and design targets (every drone part, Scout and Overseer; CLAUDE.md "Every drone design"; DEFAULT unless tagged)
Each case acts at the CG of the mass it moves (a mount carries its payload's mass x the case at the payload's CG, never at the bolt face). A part's own section may raise a value, never lower it.

| Case / target | Value | Tag |
|---|---|---|
| Hover | 1 g down at every mass | E |
| Flight (max thrust, manoeuvre) | 4 g along the thrust axis; 2 g lateral | E (from J Loads) |
| Landing / catch | 6 g up at the cage feet or catch wheels | E (from J, G) |
| Crash | 35 g along each of the 6 face directions and the 8 corner directions, the drone hitting through the cage member that touches first | E (from J Loads) |
| Swap | insert push 60 N, pull-out 50 N on the cartridge and receiver (G XT60 mate); **plus, once the receiver's 0.3 gaps close, ≤ 40.7 N across and ~0 N·m from the arm's compliance; once the lead-ins centre it with the axle driver on, ≤ 7.6 N / 1.05 N·m from the arm's position error (v7 round 3c, Y_C 165; no pitch guide couple: the XT60's ±2.37° float about x takes the arm's tilt; System box swap: arm)**. Same receiver in the drone and every bay | E |
| Handling | 50 N on any one cage member or node, any direction | E |
| Cage first | cage ahead of every protected part by ≥ 3 mm in every direction; box openings ≥ 0 inside their cone; a field sensor outside the cage (Spark 26 Oct) free inside its field cone only (`field: true`: Overseer L2 75° on its axis, each camera 55° on its lens axis), gated everywhere else | DEFAULT (alt 1 mm) |
| Balance | CG within 3 mm horizontally of the thrust centre, pack in and pack out. **Overseer exception (Spark 27 Oct: "as long as with battery the drone is centered we are okay"): pack in gated, pack out (pack + cartridge out, receiver stays) reported: 32.0 mm (E, Cage v5: the pack aft of the thrust centre balances the nose L2); alt pack on the thrust axis (0.6 mm, front arms r 373, +263 g, T/W 1.81)** | Spark |
| Sensor mounts (FC, camera, lidar) | first mode ≥ 100 Hz, reported in Hz | DEFAULT, E until the vibration log |
| Breaking order | in the crash case the frame, every mount and the pack holder stay at ≤ 1 / 1.5 of the worst cage node or foot index (the node goes first) | DEFAULT |
| Index target | worst as-built index ≤ 1.0 in the crash case, ≤ 0.5 in flight and landing | DEFAULT |

**Mass budget (24 Oct; soft, Spark: "as low as we can but never sacrifice design for weight").** The system pass splits each structure allowance into a `budget_g` per printed piece in its "System <name>" section as a target, not a limit: each piece's topology aims at its slot, but strength, stiffness, cage first, access and function come first. `system_check` reports mass against `mass_budget_g` / `budget_g` and warns when over; it never fails on mass. An over-budget piece says in its summary what the extra grams buy.

| System | Whole (`mass_budget_g`) | Bought, fixed | Structure allowance (printed + rods + fasteners) | Tag |
|---|---|---|---|---|
| Overseer | 2200 g (DEFAULT, 5 % under the 2330 g cage v0 estimate; alt 2330) | 1649 g: L2 230, pack 650, 4 motor + prop 364, 4 ESC 100, Pi 5 + cooler 55, plates 84, wires 80, cameras 30, PDB 21, UBEC 15, FC 10, buck 6, RX 2, flow 2 (`layout_v2.py` cg_of) | ≤ 551 g: cage rods + nodes, arms, apex / L2 mount, deck, sled + pods, feet, cartridge | E |
| Scout v3 | 500 g (DEFAULT: never heavier than today's ~500 g; Spark set no target, alt none) | from the Scout v3 bottom layout (pack 165 P, frame 24 to 32 E, ...) | 500 minus bought, split by the Scout v3 system pass | E |
| Box | no cap (ground station); each piece reports its mass, a new version may not be heavier without a reason in its summary | | | DEFAULT |
| Scan stick (on the Overseer) | counts inside the Overseer's 2200 g when mounted; its own section sets its slot | | | DEFAULT |

## T. Strength calibration (24 Oct 2026; protocol `docs/tests.md`, coupons `nox/tests/coupons.py`, readings `tools/calibrate.py`)
**Spark 24 Oct: use assumed numbers, no tests.** Every factor stays 1.0 (E) and the assumed PETG strengths, XT60 forces, glue bond and rod pull-out stay as tagged; the design margins (index × 0.85 / 2.5, the L index targets) carry the uncertainty. The table is kept in case a test is run later.
Predicted = break load: the load at which the method's stress reaches the material strength (nox/topo as-built index, misuse class, x 0.85 / 2.5 = 1; grid h 1.0 as the parts use). Factor = measured / predicted; use the min factor: a part's real index = its reported index / factor. Until a row reads P every factor is 1.0 (E) and the attachment rule stands (index ≤ 0.5 at attachments, log 17 Oct). PETG allowables behind the predictions (nox/topo `material.py`): Xt 51 (E), **Zt 25.5 (= 0.5 Xt, E)**, S 25.5 (E) MPa; bond 2.0 MPa (E, `box/box-funnel.md` 7). `tools/calibrate.py` reads the Predicted cell of these rows.

| Key | Test (coupon) | Predicted (N) | Measured (N) | Factor | Tag |
|---|---|---|---|---|---|
| `post_pull_6x6` | post pull, 6 x 6 post upright, side pull 25 above the root, copy A 100 % (`print/test_post_pull_v1.stl`) | 37.7 (nox/topo FE h 1.0, across layers at the root; h 0.5 26.4; beam 36.7) | to test | 1.0 | E |
| `post_pull_4x3` | post pull, 4 x 3 post upright (pulled across the 3), side pull 18 above the root, copy A 100 % | 13.3 (nox/topo FE h 1.0; h 0.5 8.4; beam 8.5) | to test | 1.0 | E |
| `post_pull_6x6_B` | post pull 6 x 6, copy B at the box-part default (4 walls, 15 % gyroid) | 37.7 (as copy A) | to test | 1.0 | E |
| `post_pull_4x3_B` | post pull 4 x 3, copy B (4 walls, 15 % gyroid) | 13.3 (as copy A) | to test | 1.0 | E |
| `layer_pull` | layer pull, 3.6 x 3.6 neck upright, straight pull: Zt = F / A, A 12.96 mm² (`print/test_layer_pull_v1.stl`) | 326.8 (nox/topo FE h 1.0, gauge / flare junction; h 0.5 258.0; Zt A 330.5) | to test | 1.0 | E |
| `glue_epoxy` | glue lap, 2-part epoxy, 24 h, single lap A 60 mm² (`print/test_glue_lap_v1.stl` x 2) | 120 (2.0 MPa x 60, hand) | to test | 1.0 | E |
| `glue_methacrylate` | glue lap, methacrylate (MMA) adhesive, 24 h, A 60 mm² | 120 (2.0 MPa x 60, hand) | to test | 1.0 | E |
| `socket_pull` | socket coupon, 3.0 rod epoxied 24 h in the bore the fit picks, pull out; A 88.6 mm² (rod face, `print/test_socket_coupon_v2.stl`) | 177 (2.0 MPa x π x 3.0 x 9.4, hand) | to test | 1.0 | E |
| `xt60_insert` | XT60 push-in force, new pair and a pack's own plug (D17) | 60 (I "XT60 mate", E) | to test | 1.0 | E |
| `xt60_pull` | XT60 pull-out force (D17) | 50 (I "XT60 mate", E) | to test | 1.0 | E |

Socket bore fit (no load): the bore a 3.0 rod slides into by hand without wobble, of 3.5 / 3.6 / 3.7 (socket v2 uses 3.6, C): to test.

## System Box catch (24 Oct 2026; system pass `nox/box/catch_system.py`, assembly `nox/box/box_catch.assembly.json`, results `runs/box_catch/v9_plain/system.json` + `system_table.md` (v8 plain and before: `runs/hook_latch/v2/system.json`); C unless tagged, loads E)
Seated drone on 8 catch wheels (Scout 4.9 N with its pack, 3.3 N without; Overseer below), collar (panels v7 on ±y, v9 plain on ±x: opening 191 along x x 168 along y), 4 hook latches, **4 keep-alive probes at ≤ 1.0 N each on every case**, cartridge push. **Cases (v9 plain): per drone and CG, seat and 6 g with the latch in, pull 50 N (pack in) or insert 60 N and the latched seat (pack out), head stall 74 N up (every insert ends on stall detection: swap class, flight index), hand lift 100 N (misuse); Overseer at CG 25 / 36.3 (hub) and 29.7 / 41.0 (v1B). The receiver pitch couple is not a case (the XT60 float takes it; reference: plunger 55.5 N, index 0.45, Overseer pack out). Result (C): every operating case seated (residual 0), all 8 wheels loaded on landing for both drones; stall 74 N worst plunger 43.7 N, index 0.36 / guide 0.21 (Overseer pack out), Scout 37.0 N, 0.30; probes add ≤ 1 N to a plunger. The Scout without its pack with the latch in is not held by the model (residual 0.03 N, C): the probes lift 2.8 N of its 3.3 N and their 48 N·mm yaw couple (B+ at y +12/+22, B− at y −12/−22) needs wheel side friction μ ≈ 0.63 at 1.0 N probes, 0.24 at the nominal 0.81 N (C), over the 0.4 ceiling. DEFAULT: the latch never retracts while the pack is out (an abort keeps the latch out and K1 closed until a pack is in or a person lifts the drone), so that state does not occur; alt: put B− at y +12/+22 (panel B on −x) so the couple is 0, which moves the Scout's −x pad. Landing drag: brass on copper μ 0.4 x 0.81 N x 4 = 1.3 N (E) along the faces over the last 8.5 mm; the pack-in Scout still has ~3.2 N net down of 4.9 N (E), so it seats.** Supports unilateral (8 face normals, 4 plungers along the slope), equal joint stiffness (DEFAULT; alt measured per joint after first fit), least-norm non-negative reactions. Target: assembled worst index ≤ 0.5 in flight / swap cases, ≤ 1.0 in misuse (L Index target, misuse as crash, DEFAULT). **The catch needs from box structure: the two ±x posts rise 11.5 (C) and must clamp the seat landing square (M3 + the flat 45° post seat on the landing disc r 8): v8 plain reads 0.911 clamped, 1.10 pinned (r 3), 4.0 on a point (C); panel v7 0.827 / 0.854 / 1.09 (C).** Result: Scout latch-path worst 0.44 in the hand lift; catch worst 0.91 (Overseer hand lift, panel v7 skin at the seated wheel); fit 0.0 mm³ (M) latch out and in with the probe pins seated and at solid (4 pins + 2 caps in the file, pins 'moves' −6.0 free .. +1.5 solid), mass 689 g (E, v9 plain on ±x + probes; was 665), CG [-0.0, 165.0, 197.4] in W (E, `assembly.py --check`). **The assembly file is posed in box W of box structure v2 (24 Oct): pose = SEAT_TO_W @ seat pose, Y_C 165, Y_FUN 165 (the funnel centre on the grip line, L v2 layout), Z_SEAT 155.3, R_RING 113 (C, `catch_system.py`; seat y → W −X, seat x → W Y); the loads stay in the seat frame.** **Overseer (layout B, hub 24 Oct: pack 30 behind the thrust axis; run v1B E: 2850 g, CG 29.7 ahead of the catch centre, seat z 91.9; pack out 2065 g, CG 41.0 ahead):** landing on the faces with the latch in: all 8 wheels loaded at both CGs (min 0.6 N seated, 4.5 N at 6 g, C); insert 60 N (pack out) plunger 33.7 N, index 0.28; pull 50 N 5.3 N; hand lift 100 N at a guard corner (300, 200) plunger 175 N, plunger 0.89 / guide 0.53 (misuse), bolts 43.8 N shear each, panel FE 0.15 and bosses 0.26 scaled linearly (C), boss deflection 1.28 mm; panel skin at the seated wheel spot (FE press u100 v40, linear, C): v7 0.91 hand lift (122.5 N wheel), 0.41 at 6 g (55.2 N), v8 plain 0.25 / 0.17 at its seated wheel (u100 v43.6, wheel-track strut; v7 plain was 0.58 / 0.40) (19.5 MPa rule). **Catch worst under the Overseer loads 0.94 (panel v7 wheel spot on its real supports, hand lift, ≤ 1.0, flight allowable so a ceiling; 0.91 on the old bottom-edge support); latch pieces 0.89; panels' own cases v7 0.83 (press u60 v90), v8 plain 0.91 (top edge), C**. Boss stiffness target ≤ 1.0 mm holds in flight and swap cases (0.37 Overseer insert); in misuse it is reported (1.28), not a target (DEFAULT; alt a stiffer boss web).
| Piece (qty) | Envelope | Interfaces | Joint reactions per case: insert 60 N / pull 50 N / hand lift 100 N / catch 6 g | budget_g | Stiffness at the joint | Worst index to reach |
|---|---|---|---|---|---|---|
| Hook latch housing A / B (2 + 2) | 57.5 x 49.8 x 44.4 unit with servo and plunger out, behind the panel v7 skin in the rib field | 4 M3 into the panel v7 bosses (valley at u ±18.5, v 0); guide top at w −2.3; window 9 x 13 | guide top 45.4 / 2.7 / 137.8 / 0 N (Overseer 54.2 insert / 281 hand lift; head stall 74 N: Scout 59.5, Overseer 70.1, v9 plain run); bolt shear 7.1 / 0.4 / 21.5 / 0 N each (Overseer 8.4 / 43.8) | 24 (M 23.7) | guide holds the plunger square: ≤ 0.2 mm tip deflection at 34 N (E) | ≤ 0.5 flight, ≤ 1.0 misuse (reached 0.16 / 0.53, Overseer insert / hand lift; Scout 0.14 / 0.26) |
| Hook latch plunger A / B (2 + 2) | 8 x 12 x 32.95 | guide slot 0.25 clearance; yoke pin r 13; hall magnet Ø3 x 2 | 28.3 / 1.7 / 85.8 / 0 N along the slope at the wheel (Overseer 33.7 / 5.3 / 175 / 0); head stall 74 N (swap): Scout 37.0 N, index 0.30, Overseer 43.7 N, 0.36 (C, `runs/box_catch/v9_plain/`) | 4 (M 3.9) | ≤ 0.3 mm at the wheel at 34 N (E) | ≤ 0.5 flight, ≤ 1.0 misuse (reached 0.28 / 0.89, Overseer insert / hand lift; Scout 0.23 / 0.44) |
| Funnel panel v7 (2, ±y) | panel v7 envelope (`box/catch_v4/funnel_panel_v7.py`) | 4 latch bosses Ø12 per unit, gussets; window 0.5 a side | 2 units: Scout 28.3 N x 2 / 1.7 N / 85.8 N at one unit / 6.1 N per face wheel; Overseer 33.7 N x 2 / 5.3 N / 175 N + 67 N on the two units of one panel / face wheel 15.8 / 32.2 / 122.5 / 55.2 N | 80 (M 80.0) | boss deflection ≤ 1.0 mm in flight / swap (C 0.31 Scout, 0.37 Overseer insert); misuse reported, not a target (DEFAULT): 0.63 Scout, 1.28 Overseer (linear, C) | FE util ≤ 0.5 flight / ≤ 1.0 misuse (reached 0.12 / 0.15 Overseer, 0.10 / 0.08 Scout; linear from the one-unit FE, rerun with both units loaded in the next panel version); bosses 0.08 / 0.26; skin at the seated wheel 0.41 (6 g) / 0.91 (hand lift) Overseer |
| Funnel panel v9 plain (2, ±x: A px + B px on +x, A nx + B nx on −x) | panel v8 plain envelope (bottom edge seat z 12.8) + the probe boss behind the A skin (22 deep) + the −x notch (r ≥ 161 about the axle over W X −37..49.5) | face wheels; 2 probes per A panel (≤ 1.0 N each, sustained); seat landing clamped on a bay post 11.5 taller | Scout 11.9 / 9.6 / 0 per plain face wheel (pull / hand lift / stall, pack in); Overseer 17.4 / 50.8 / 35.2 N (pull / hand lift / 6 g) | 61 A / 54 B (M 60.3 / 53.7; v8 plain 53.8 / 53.7) | face ≤ 1.0 mm at a wheel (E; 0.30 Overseer hand lift, C); probes 0.005 mm | its own FE 0.786 A (top edge u40) / 0.795 B (press u−60 v90), probes 0.005 mm / 0.2 MPa; skin at the seated wheel 0.17 (6 g) / 0.25 (hand lift) Overseer (C) |

**Concept F, push-bar catch (27 Oct, concept, `runs/box_catch/bars_concept/summary.md`, artifact https://claude.ai/artifact/XfUFHJZZrfnNdi9nnuuHQB; replaces the funnel + hook latch + wheels + probes when drawn; C unless tagged).** Seat frame: catch centre, z 0 = the Overseer's ring tube centres; deck at z −4.0 (its TPU feet, M). Shared interface: the Overseer base loop side nodes (85.8, ±116.1), (−68.9, ±119.7) = the Scout's rectangle (v11 and v12), tubes r 3 (Overseer) / r 1.5 in a 6 mm printed sleeve over x ±32 (Scout, DEFAULT).
| Piece | Numbers |
|---|---|
| End pads (2) | 3 tall from the deck (top z −1); face profile along y: notch ±6, flanks 30° from y (120°), apex at x_n / x_t; relief |y| 6..28 receding 14 behind the apex; V wings |y| 28..80, 18° from y, inner end 7.4 behind the apex, outer corners 9.5 ahead; nose : tail travel 1 : 1.361; nose apex 203.2 (Overseer clamped), 97.1 (Scout); tail apex −224.6 / −80.2; park 293.2 / −347.1; nose travel at the clamp 90 / 196 |
| Pad slide and spring | preload 30 N, 0.5 N/mm (E), stroke 80 (used ≤ 74) |
| Side bars (2) | x −25..25, 6 thick, 11.5 tall; face on the tube line + 3.25 (gap 0.5 over the surfaces, the line tapers 3.6 over 155); lip 3 thick, underside z 4.5, edge 2 inside the tube line; park |y| 258; travel 137 over 60 of carriage (2.3 : 1 lever), after the x clamp only |
| Carriage | T8 x 2, NEMA 17 (the fourth), thrust bearing F8-16M; travel to the stall 150 (Overseer) / 256 (Scout); at the stall ~120 N (E) |
| Hold-down | 74 N head stall on the two lips (5 MPa cantilever, E); the screw holds the bars |
| Envelope (C) | Scout: every landing in |y| ≤ 60, any x, yaw ±15; Overseer: yaw 0: |y| ≤ 40 at every x, y ±80 at x −40..60, y ±60 only at x 0; ±5: |y| ≤ 40 at every x; ±10: y 0 at every x, y ±20 for |x| ≤ 20; ±15: y 0 at every x. Seated: y ≤ 0.23, yaw ≤ 0.9°, x median 0.8 / 0.5, 90 % 2.7, max 6 (Overseer inside ±20: 86 % of the seated within 2.3, 81 % of all) |
| Scout plane | −50.7 with the sleeves (cartridge 7.0 above the deck like the Overseer's), −47.5 with a 6/4 ring (Scout session) |

## System box structure (24 Oct 2026; system pass v1 `nox/box/box_system.py`, assembly `nox/box/box_structure.assembly.json`, results `runs/box_system/v1/` (`summary.md`, `requirements.md`, per-piece `req/<instance>.json`); W frame; C geometry, M mesh, F model, loads E)
**Model (F):** the built demo (stand, bay modules v4i at −90 / −60, 5 mid + 2 end frames, enclosure), every piece from its exact print file (sha match or `topo.compare` fit 0 mm³), the catch (panels v7 + hook latch v2 from `box_catch.assembly.json`, seat frame → W: z 0 = W Z 142.3, x → W Y + 177, C) and the arm (stub, sweeps) as context. Voxel FE h 4 (119k cells, 520k dofs): every piece keeps its own nodes, pieces join only where their surfaces come within 1.33 mm, ring neighbours only at r ≥ 150 (lugs, dovetail); floor contact unilateral (active set). Then each piece alone at its own grid (box-stand FE grids) with the system's joint reactions as loads, held at its largest joint or its floor contact. Index targets (DEFAULT, as System Box catch): ≤ 0.5 functional (flight class, SF 4, C `topo.material`), ≤ 1.0 misuse (SF 2.5, C) and sustained (SF 10, C); new versions aim ≤ 0.8 of that (coarse system model). Alt: ≤ 1.0 in every class (then only kb and the frames fail).
| Case | Class | Load (E unless tagged) |
|---|---|---|
| Standing, Scout / Overseer seated; uneven floor (front-right quadrant unsupported) | sustained | 1 g: pieces (M), sheets (C), arm 2900 g at (0, 60, 0) on the stub face, funnel + latch 640 g on the 4 pads, electronics + PSU 2000 g on the rear sheet, 2 loaded bays 440 g, drone 520 / 2330 g |
| Scout / Overseer catch, 30 off on the diagonal at 0.15 m/s (G Capture, gate ±30) | functional | energy / 3 mm (box-stand weak spot 4): 0.16 J → 53 N, 0.71 J → 237 N at (±60, 177 ± 30, 175), 0.25 F inward; the Overseer both diagonals |
| Scout free fall 0.15 m; Overseer motors cut at the gate (10 above + 30 roll) | misuse | 255 N; 314 N, same point |
| XT60 insert 60 N / pull 50 N at the drone, at the −90 bay (pull too), at the −60 bay | functional | I "XT60 mate": on the funnel pads or the bay back plate / receiver, reaction on the stub face at the arm tip (r 140, Y 175) |
| Axle motor stall | functional | 1.8 N·m about Y on the stub (0.45 x 4:1) |
| 50 N sideways on the funnel rim; set down hard 5 g; knocked over onto the +X side 5 g lateral | misuse | (a full fall from standing is ~19 g, a crash the box is not designed for) |
| Lifted by the two side sheets (hands Y 100..250, Z 0..150) | functional | 2 g |
**Results (`runs/box_system/v1/summary.md`):** box 10.31 kg (M pieces, E bought / lumps); with the Overseer seated 12.64 kg, CG (16, 100, 29) (E), tip 36.3° (−Y edge, E); the System line's 5080 g counts the structure, sheets and PSU only (no arm, catch, lumps). Fit: 0 mm³ between pieces (M) except the cradle seat 0.15 (M, module mesh 0.08 into the cradle top, a seat face) and cradle_keel / barB 0.2 (E, system_check's voxel fallback; 0.0 M on manifold); **front sheet vs panels v7 9.8 cm³ (the panels reach Y 345.4, M; the sheet is at 337)**; **the end frames' +Y seat pads (Y 213) vs panels v7 320 mm³ each** (X ±91..104, Y 204..224, Z 144..157, M; the Y 141 pads clear); access: the −90 module cannot slide out (+Y) past cradle_keel (75 mm³). Stiffness (F): XT60 insert at the drone tilts the stub face 15.1 mrad (mast lean on the kb and its floor), the arm tip moves 3.8 (Y) / −3.0 (radial) mm against the drone receiver; at the −90 bay 2.2 mm radial; the Overseer catch moves the pads 0.9 mm.
| Piece | Assembled worst (case) | Own FE | Verdict |
|---|---|---|---|
| mast v6 | 0.59 (XT60 insert at the drone) | 0.08 | FAIL (> 0.5) |
| cradle_keel v6 | 0.60 (XT60 pull at the −90 bay) | 0.18 | FAIL (> 0.5) |
| kb v7b | 1.08 (XT60 insert at the −60 bay); 3.77 (knocked over, misuse) | 0.09 | FAIL; also the lean compliance above |
| toe v7b | 0.08 | 0.19 | strength PASS; fit FAIL (its front plate sits on the front sheet, which moves) |
| bar_half v8 (x2) | 0.35 (XT60 insert at the drone) | 0.38 | PASS |
| frame_mid v6 (x5) | 1.60 at 0°, 1.49 at −180° (Overseer catch) | 0.59 | FAIL |
| frame_endR / L v7b | 1.59 / 1.65 (Overseer catch) | 0.86 / 0.90 | FAIL; fit FAIL vs panels v7 |
| post_seg v7 (x12) | 0.16 | 0.16 | PASS |
| bracket_jA v8 (x2) | 0.62 (Overseer catch, 165°) | 0.05 | FAIL (> 0.5) |
| bracket_jB v7 (x2) | 0.33 | 0.09 | PASS |
| bracket_e v7c (x2) | 0.24 | 0.14 | PASS |
| bay module v4i (x2) | 0.55 (Overseer catch, −60) | 0.05 | FAIL (> 0.5; solid FAIL already) |
| sheets 3.0 acrylic | 0.47 misuse (rear, knocked over), 0.33 functional (side, Overseer catch) | | PASS strength; front sheet fit FAIL |
**Piece requirements (the next versions' topo parameters):** per piece and instance `runs/box_system/v1/req/<instance>.json`: every joint (partner, contact points W, F and M on the piece per case), external loads, floor contact per case, case class and acceleration; the largest reactions per joint in `runs/box_system/v1/requirements.md` (e.g. frame_endR ↔ frame_mid@0 342 N / 4.9 N·m, bracket_jA ↔ side sheet 307 N, mast ↔ kb 147 N / 17.1 N·m, kb ↔ rear sheet 99 N / 24 N·m). Stiffness the base must give (DEFAULT): stub face tilt ≤ 5 mrad (DEFAULT) at the XT60 insert (arm tip ≤ 1.0 mm against the receiver, a third of its ±3.3 lead-in, C), pads ≤ 1.0 mm at the Overseer catch. Envelopes: the piece's present envelope, plus the decisions below. budget_g: no cap (L Box); a new version may be heavier only for strength or stiffness.
**Interfaces for the other box systems:** *swap arm:* stub v3 on the mast front face Y 0 (4 x M5 at X ±10, Z ±30); the structure takes the arm's wrench there (case loads above, up to 60 N at the tip, 2.9 kg at Y 60) and keeps r ≤ 145.5 clear over Y 7..222 outside the bays and r 106.5 over Y 2..50 (0 mm³, C). *catch:* the 4 seat pads of the v1 demo (end frames, seat face 37.4 off the 45° / 135° end planes, rho 166.5..186.5, Y 141 / 213 ± 10, M3 x 25 into the collar inserts; v2: the 8 seat landings of the v2 layout); the pads carry the catch cases above (up to 342 N between the end frame and its neighbour); the panels must stay ≥ 1.0 inside the sheets (front sheet inner face, decision 1) and clear of the end pieces.
**Decisions (DEFAULT, `log.md`):** (1) front sheet inner face Y 337 → 347 (panels v7 reach 345.4); side sheets 407 long (C); the toe's front plate moves with it (alt: trim the panels' front rim). (2) Sheets' top Z 240 → 220, level with the panel rim Z 219.5 (Spark 19 Oct "walls level with the funnel"; the stand's 237 was from the v6 mount); posts 3 x 140.33 (C) (alt: keep 240). (3) **Box structure v2 = the system pass on Spark's 9-bay ring (24 Oct: every cartridge slot built, 4 Overseer bays at −60..−150, 5 Scout; PR 67) with the swap arm v6 asks (PR 71: seated faces at R 113, Overseer modules 172 long at Y_C 175, arm lane ≥ 159, all C on the arm's E)**: R 113 accepted (alt: the Overseer cartridge lowered 13 so R 100 stays). The frames are retired as ring pieces (every slot is a bay); the end slots (30°, −210°) take end-bay modules that carry the funnel pads and the end-bracket blocks. Every failing piece above gets its new version from the v2 requirements; none is run on the v1 envelopes, which v2 moves (R +13: floor, sheets, brackets, pads). (4) Crash probes off in `box_structure.assembly.json` (floor-standing box, the floor shields the open bottom; alt: probes on read −34.0 mm (E) at −Z on the PSU, a bottom sheet would clear it). (5) Targets: alt ≤ 1.0 in every class (then only kb and the frames fail).

**v2 layout (concept, 24 Oct; `nox/box/box_layout_v2.py`, `runs/box_system/v2/layout/`; alternatives `layout_clip_bottom/`, `layout_R128_bottom/`, unclipped `layout_bottom/`; 3D https://claude.ai/artifact/AioyNWKzpTH96znsmfrAXp, the four side by side https://claude.ai/artifact/Mn5JGDkjEGSQXyPhjqrpxb (`box_layout_v2_views.py`); system file `nox/box/box_structure_v2.assembly.json` with both drone-insert keep-outs, for the catch and arm checks):** 9 bays at 30° (C) and **R 113** (C, arm v6), **Overseer at 0, −60, −120, −180 and Scout at 30, −30, −90, −150, −210** (DEFAULT, hub-confirmed 24 Oct; alt the arm's set, Overseer 30 / −30 / −90 / −150); **common grip line Y_C 167.1** (C, arm DEFAULT 24 Oct: latch v4's longer Overseer lead end, Y_C_min 167.1 F; was 165 from arm PR 79 via the hub, 24 Oct; alt 138 (arm v7 round 3, its dimensions row until it is updated) or 175; was 175, then 138). **Funnel centre = the grip line = each drone's catch centre = its latch set's centre (hub 24 Oct, C)**, placed in the layout by each latch's tab line Z_T on Y_C (hub DEFAULT 24 Oct: the arm grips there and fixes Y_C; the Scout set's mid sits 5.4 off the funnel centre, inside the 191 x 168 opening; the Scout chat keeps its catch centre within 2 of its tab line): receivers Scout Y 110.35..215.95, Overseer 75.35..258.95 (latch on main @ b70e63d, `latch_ctx_export.py`, M; was 258becf). The v1 seat pads (Y 141 / 213 above) are the v1 demo's. **Funnel v8 plain (catch PR 81, merged; now panel v9 plain on main; `box_catch.assembly.json` in W at Y_C 167.1 since catch PR 115, R 113; the layout recentres any W file on Y_C by its panels): opening 191 along W Y x 168 along W X (C), made by raising the plain panels' bottom edge to seat z 12.8 (W Z 168.1), not by moving the faces out; the v2 model now loads this file as is.** Latch v1 receivers (`runs/box_system/v2/latch_ctx/`, 258becf, M): 0 mm³ between neighbours (M). Bay body envelopes (design spaces, C): the sector from r R − 1.0 (the parked heads' r R − 1.5, arm v6, + 0.5) to the mount plane + 12 (Scout r 179.1, Overseer 192.1) over the receiver's Y range ± 4, less each neighbour's receiver swept toward −Y (so a body slides out +Y past them), less the arm's rail disc + 1.0 (below). Catch at the new seat: seat frame z 0 = W Z 155.3 (C, +13), rim Z 232.5, panels Y -3.4..333.4 (M); 8 seat landings in `layout.json` (C; funnel v8 moves the 2 under the ±Y plain panels 11.5 out and 11.5 up, below). **Enclosure (C): sheets' inner faces X ±206, Y -66..337, floor Z -236, top Z 234; outer 418 x 409 x 470 (80.4 L; v1 demo 70.4 L, M); cut list side 2 x 397 x 470, front / rear 2 x 406 x 470; posts 3 x 156.7; the front sheet is the service door (DEFAULT: bay bodies leave along +Y with it off; alt: a bay leaves inward past the parked arm).** Alternatives (C): Overseer at the 4 bottom slots with receivers clipped to their sectors less 0.3 (unclipped neighbours overlap 3324.9 mm³, E, `layout_bottom/`): 406 x 409 x 476, 79.0 L (E), needs the latch clip; bottom slots at R 128: 434 x 409 x 506, 89.8 L (E). Concept check (`concept.assembly.json`, `concept_check.json`; its mass counts the envelopes as solid PETG, not a design mass): cage first 3.0 mm (E, the PSU at the rear sheet, at the threshold); arm turning envelopes (hub r 88 Y 7..74, rail disc r 151 Y 38..73, motors r 106.5 Y 2..50, parked heads r R − 1.5, drone insert: the carriage r ≤ 159, Z ≥ 89 over X −35..47.5, Y 53.75..75.35 and the head + grabber X ±47.5 over r 95..159.6, Y 73.75..Y_C + 52 (arm, heads v7: plate top 74.35, 24 Oct; was Y ..73.75, r 111.5, arm PR 79; C), v1 mast and PSU clear every structure envelope (0 mm³, M); access 18 / 18 (every cartridge out to park; every bay body out +Y 270 with the front sheet off). **Fit with the catch file on main (funnel panel v9 plain, catch): PASS, 0.0 mm³ (E, system_check), access 18 / 18: the Overseer drone set passes the 191 opening and both drone-insert lanes clear the −Y plain panel, at r ≥ 161.0 over the carriage band (C on M: 2.0 over the lane's r 159; v8 read 159.61). With panels v7 it read 980.6 (drone set) + 123.5 / 512.3 mm³ (lanes) (E); `v8_lane_check.json` now measures the v8 file as is (0 mm³, M).** **Coarse system topology (`runs/box_system/v2/topo_r2/`, round 2, PR 105; round 1 `topo/` had the sheets carrying the box, record only):** sheets are clip-on cladding (DEFAULT; alt 3 mm acrylic at its stiffness, not run), the floor the only support; 3000 cm³ chosen (sweep 2000 / 3000 / 3000 + ring / 4000): every bay, seat post and the stub on one floor-standing body (M), 3.89 kg generated + 0.81 kg drawn at 1.27 g/cm³ (E), stub tilt 0.41 mrad (M on h 8), worst bay rotation about the axle 1.8 mrad against 2.6 (±0.15°) without the datum ring (DEFAULT: no ring; with it 1.3 mrad for +1.09 kg), floor contact 9 cm² in 7 patches on the bay −60 / −120 / −90 bodies and the mast (M, TPU feet there). Load path: a top frame under the funnel, bay-to-bay links r 150..200, a rear frame round the board stack (M). The cut and its system FE: `runs/box_system/v2/cut/` (worker). Overseer bay bodies 184..200 long: split at Y 158 (DEFAULT). The rear-sheet boards are re-placed round the frame after the cut (DEFAULT; was: the frame round the boards). **Stub stiffness (to the XT60 float): tilt ≤ 10 mrad (arm DEFAULT) at a 60 N insert (v1 demo 15.1, F, fails it); the v2 number comes from the v2 system FE on the cut pieces.**

**v2 requirements from the swap arm (round 3, 24 Oct; `dimensions.md` System box swap: arm, PR 79), DEFAULT for the v2 pieces:** (1) **stub face stiffness**: an insert puts 5.9 N·m (Scout) / 5.5 N·m (Overseer) about the slide-tangential axis + 57 N radial on the mast front face (E); allowed tilt **≤ 10 mrad at the mast face, k ≥ 0.59 N·m/mrad (E) (arm worker DEFAULT 24 Oct: without the pitch guide the arm's tilt about the cartridge x axis sits in the XT60's ±2.37° float, which at a 20 % margin leaves 11.6 mrad (Scout) / 15.2 (Overseer) for the stub; replaces 1.9, then 5 mrad)**; v1 demo 15.1 mrad, ~0.39 N·m/mrad (F): the mast / base load path is redesigned round it (the v1 kb + floor lever is out). (2) **bay location: each bay located to the mast (the stub's frame) within ±0.15° (±0.30 mm at R 113, C), not chained module to module**: the v2 cut needs a direct datum from every bay body to the axle frame. (3) **arm's rail disc Y 38..73 out to r 151 (C)**: bay body envelopes stay 1.0 off it (C, trimmed in `box_layout_v2.py`); at Y_C 167.1 the Overseer receivers start at Y 75.35 inside r 152 (M): 2.35 off it. Lane r ≥ 159 over the carriage and grabber (layout paragraph above). **Receiver bolts (battery latch PR 69, via the hub 24 Oct): each receiver's M3 bolts come up from below through Ø3.4 holes in its bosses into M3 x 5.7 heat-set inserts in the bay body (latch PR 69 258becf, 0.15 end gap: Scout 4 x M3 at (−41.70, ±25.6), (43.25, ±25.6); Overseer 6 x M3 at x ±26.8, z_c 0.85 / 85.5 / 163.8, receiver frame; mount plane R 113 + Y_M, C): every bay body carries those inserts in bosses (wall ≥ 3), keeps the bolt access from below clear (the corner guide posts are dropped, hub 24 Oct). Receiver spans: the layout paragraph above (tab line on the grip line, hub DEFAULT).** **Funnel seat posts (catch PR 81, funnel v8 plain): the 2 posts under the plain ±x faces (W ±Y) rise 11.5 out and 11.5 up the face: landing (109.6, ±36, 18.5) seat frame = W (±36, Y_C ± 109.6, R + 60.8) (C); every post must clamp its landing square (catch FE: v8 plain 0.911 clamped, 1.10 pinned, 4.0 point; latched v7 0.827 clamped, 0.854 pinned): the post end is a flat 45° seat matching the landing disc (r 8) with the M3 drawn tight (C, catch PR 81).** **XT60 swap loads for the v2 piece runs (Spark 24 Oct via the arm and hub, arm v7 round 3b at Y_C 165, E; the arm row and L Swap still give 54 N across and 5.5 N·m + 69 N at stall at Y_C 175, the arm's to update): each bay receiver takes 60 N insert (functional), 74 N at head stall (misuse), 50 N pull-out, 43.5 N across (hub; the arm's L Swap gives ≤ 40.7, the larger is kept) and the centring 7.6 N / 1.05 N·m (the pitch-guide couple is gone: the XT60 float allows ±2.37° about the arm's worst tilt axis, so the latch drops its guide posts, hub 24 Oct); the stub / mast face takes the arm's reaction 5.9 N·m + 57 N. Bay-body and mast / stub cases carry these at the receiver mount plane and the stub face.**

## M. Mounting interfaces of bought parts (22 Oct 2026 web research; for every future mount)
Maker numbers for every bought part a printed mount bolts to. Tags: **spec** maker datasheet, drawing or CAD; **listing** store page; **typical** one maker of a generic part; **derived** measured off a maker's drawing or CAD. None is P yet: when a part is measured, its P value replaces the cell. **Rule (Spark 22 Oct): where sources agree or differ only slightly, the value is used; where they are not close, or no source has it, the cell says "open, Qn" and the question below is settled by the chat that first designs a mount for that part (measure the part, then write P here).** Sources and the long tables: `claude/research/2026-10-22-mounting-dimensions.md`.

**Flight electronics**
| Part | Body | Mounting | Notes | Tag |
|---|---|---|---|---|
| MicoAir743v2-AIO-35A (Scout FC) | 36 x 36 x 8, 10 g | 4 x Ø3 (M3) on 25.5 x 25.5 | grommet size open, Q1; USB-C on one edge, battery pads on the next, DJI SH1.0-6P opposite USB | spec |
| MicoAir743-Lite (Overseer FC) | 36 x 36 x 8, 10 g | 4 x **Ø4** on 30.5 x 30.5 | screw size open, Q2; FC + ESC stack 17.5 tall, 24 g | spec |
| Matek FCHUB-12S V2 (Overseer PDB) | 55 x 50 x 6, 21 g | 4 x Ø3 (M3) on 30.5 x 30.5 | battery pads on a top tab, ESC pads at the 4 corners, JST-SH 8-pin at bottom centre | spec |
| MicoAir MTF-02P flow + ToF | 21.6 x 16 x 6.5, 1.5 g | **no holes**: pocket, clamp or tape | SH1.0-4P on a short edge, exits sideways; flow FOV 42°, ToF 2°, both windows face down, clear; protocol jumper on the back | spec |
| Radxa Zero 3W | 65.0 x 30.0 | 4 x Ø2.82 (M2.5) at 57.85 x 22.85 | Radxa DXF v1.11 agrees with section H's STEP to 0.05 | spec |
| DECXIN 2633V2 camera | board 38 x 38 (A, P); lens and thickness open, Q3 | M2.5 on 28 x 28 (A, P; Spark 23 Oct) | no maker data online | P / open |
| RadioMaster XR2 (Nano) | 16 x 12 x 6, 0.8 g | **no holes**: solder pads, tape or heat-shrink | on-board tower antenna | spec |
| 5 V 5 A UBEC (generic) | open, Q4 | no holes: tape or zip tie | leads out both short ends | open |

**Airframes, motors, props, lidar, packs**
| Part | Body | Mounting | Notes | Tag |
|---|---|---|---|---|
| SpeedyBee Bee35 frame (Scout) | 153 wheelbase, 138 g | FC stack 20 x 20, 25.5 x 25.5 (AIO) or 30.5 x 30.5 (maker: not recommended), hole size open, Q5; motors 12 x 12 M2 | top plate 3.5, bottom 2.0 (Pro: aluminium bottom); camera width 19 / 20; frame kit uses M2.5 x 20 and M3 x 15 standoffs | spec |
| EMAX ECO II 2004 (Scout motor) | bell size open, Q6; 16.4–18 g | base 4 x M2 on 12 x 12 | motor shaft Ø3; prop T-mount on a Ø1.5 locating shaft, 2 screws (spacing open, Q6); KV 1600 / 2000 / 2400 / 3000 | spec / listing |
| Gemfan Hurricane 3520 prop | Ø89.5, hub 5.5 tall, 1.8 g | T-mount 1.5 | the D90 is a different prop (ducted, 3.0 in pitch) | listing |
| S500 frame (Overseer): "S500 Quadcopter Multicopter Frame Kit PCB Version With Carbon Fiber Landing Gear" (Spark 23 Oct: AliExpress item 2251832276919319; listing 500 wheelbase, 454 g with gear). Geometry from Holybro's S500 V2 STEP (`nox/overseer/s500/S500-C1_ASM.step`, read by `s500_cad.py`): the same S500 moulding (arm 234 x 42 vs generic spare S500 arm listings 233 x 40; top plate arm holes match an independent Printables S500 top plate to 0.7) | top plate 120.5 square, 1.6 thick; bottom plate 196 x 118, 2.0, PDB pads; plate gap 17.94; arm 234 long (u 30.1..264.3), 42 wide at the root block (u 55..75, full 18.04 between the plates), outer beam ~23 x 8.5 rising ~4° to the motor pad (top y 32.5) | arm to top plate: 3 x M2.5 x 6 (Ø3.1 plate holes at u 63.17 v ±15 and u 34.66 v 0; X / Z (±55.27, ±34.06), (±34.06, ±55.27), (±24.51, ±24.51)), 2 Ø6 pegs at u 57.66 v ±11; arm to bottom plate: 2 x M2.5 x 6 (Ø3.0 at u 63.74 v ±10; X / Z (±52.14, ±38.00), (±38.00, ±52.14)); u along each 45° diagonal, v across, from the plate centre | motor pad M3 on 16 and 19 + slots, centre bore Ø10.5 at r 243.2; landing gear Ø16 poles, Ø10 rails 59 apart (section M note). Not the 480 glass fibre / polyamide "S500" (405 g, 170 tall) | listing / derived; top plate arm holes 30 apart P (Spark 24 Oct); wheelbase CHECK |
| SunnySky X2216 II 880 KV (Overseer motor) | bell Ø27.7, can 32, 68 g + 13 g parts | base 4 x M3 x 0.5, 2.8 deep, pairs at 16 and 19, 45° to the leads | shaft Ø3.175; prop adapter M5 x 0.8 on 3 x M2 at Ø12; X-mount cross 34 x 34 x 3 | spec |
| 1045 prop | Ø254, hub 9.5–10 thick; mass open, Q8 | bore 6, rings to 5 for the M5 adapter | | listing |
| Unitree L2 lidar (Overseer) | 75 x 75 x 65, 230 g, base flange Ø75 | 4 x M3, 6 deep, on a Ø51 circle (≈ 36.06 square), 22.5° off the cable axis; 4 locating slots 3.5 wide in the base rim | cable notch at the base on -X; FOV 360 x 90° hemisphere above the base (96° in negative-angle mode): nothing in it, not even clear glass; cooling room on all 4 sides; body carries no load; base ≤ 85 °C | spec |
| 4S 1500 pack | section A (P) | strap | | P |
| 4S 6000 pack | section O envelope; mass open, Q9 | strap | | P / open |

**Box**
| Part | Body | Mounting | Notes | Tag |
|---|---|---|---|---|
| NEMA 17 (StepperOnline 17HS19) | 42.3 square, 48 long (38 and 48 common) | 4 x M3, 4.5 deep min, on 31 ± 0.2 | pilot Ø22 x 2; shaft Ø5 x 24 with a 15 D-flat | spec |
| BTT SKR Mini E3 V3 | 103.75 x 70.25 | 5 holes in the Ender-3 pattern, not a rectangle: offsets in the research note 3.2; hole size open, Q10 | microSD sticks out 2.8 past one edge | spec |
| Mean Well LRS-350-24 | 215 x 115 x 30 | bottom 4 x M4 on 150 x 50, 32.5 from the terminal end and from each side, screw in ≤ 3; sides 4 x M4 at 150, 12.5 up, screw in ≤ 5 | terminals on a 115 end; fan on top, air out the far end | spec |
| DS3218 servo | 40 x 20 x 40.4 | ears 4 x Ø4.5 on 49.5 x 10; 54.5 over the ears; ear underside 27.7 above the base | 25T spline; output axis position open, Q11 | spec |
| MG995 servo | 40.9 x 20, 37 to case top, 55 g | 54 over the ears, ear underside 26.8 above the base; ear holes open, Q12 | 25T (listing); not the DS3218 ears | spec / open |
| 6010-2RS bearing | 50 x 80 x 16, r 1 | shaft shoulder 54.6–59.7, housing shoulder ≤ 75.4 | C 22.9 kN | spec |
| 2020 / 2040 extrusion, 6 slot | 20 x 20 / 20 x 40, R1 corners | slot opening 6, inner 12, lip 2, ~6 deep; core Ø4.2 tapped M5 (2040: two, 20 apart) | V-slot (opening 6.13, 6.1 deep) is close enough to use the same slot features | spec |
| GT2 80T, 8 bore (Phidgets) | OD 50.42, belt width 11, 19 long | hub Ø36 x 8, 2 x M4 set screws | no flanges | spec |
| GT2 20T, 5 bore (kit) | OD 12.22, 16 long (LDO) | hub Ø15 x 7.8; set screw size open, Q13 | | spec / open |
| GT2 toothless idler (kit) | 8.5 wide | flange and bore open, Q14 | | open |
| KW11-3Z microswitch (Omron SS-5GL footprint) | 19.8 x 10.2 x 6.4 | 2 x Ø2.35 at 9.5 ± 0.1 (Ø2.4 or M2.3 in the mount) | generic KW11 listed 20 x 10 x 6, which is close | spec |
| A3144 hall module | open, Q15 | open, Q15 | | open |
| 24 V P20/15 electromagnet (retired 23 Oct, hook latch) | Ø20 x 15 | rear thread open, Q16 | 2.5 kg at zero gap on flat steel | typical / open |
| Heat-set inserts (Ruthex = CNC Kitchen) | M3 OD 4.6 x 5.7; M4 OD 5.6 x 8.1 (RX-M4x8.1); M5 OD 7.1 x 9.5 (short M5 5.8) | hole M3 Ø4.0, M4 Ø5.6, M5 Ø6.4; depth ≥ L + 1 | short M3 length open, Q17 | spec |
| ISDT PD60 charger (listed as PD60S) | 56 x 85 x 21, 87 g | no holes | USB-C PD in, 60 W | spec |
| 4010 fan | 40 x 40 x 10.5 | 4 holes on 32 square; hole size open, Q18 | | spec / open |
| XT60 | F face 15.5 x 8.1, pins 7.2 apart; mate and pull 1.8 to 4.5 kgf (XT60L-M.G sheet; plain XT60 CHECK, D17) | panel XT60E1-M: flange 27.1 x 12.1 x 3.0, screws 20.5 apart; screw size and cutout open, Q19 | | spec |
| JST-XH | housing 2.5 (n − 1) + 4.8 long, 5.7 deep | 2.5 pitch | 9.8 tall mated above the PCB | spec |
| Mill-Max 0854 pogo pin | body Ø2.413 x 5.563, flange Ø3.175 x 0.762, 15.215 overall | press or bond in a Ø2.413 bore on the flange | stroke 2.286 max, 120 g at mid; 12 A. Other pogo pins (P75): open, Q20 | spec |

**Open questions (settle when a mount for the part is designed: measure, write P in the cell, strike the line)**
- Q1 Scout FC grommet size: not published.
- Q2 MicoAir743-Lite screw: Ø4 holes, size not stated (M3 in grommets is usual).
- Q3 DECXIN 2633V2 lens barrel Ø and height, board thickness, mass: no maker data anywhere online.
- Q4 UBEC body: makers range 43–50 x 17–25 x 7–10, 11–21 g.
- Q5 Bee35 FC stack hole size: not published.
- Q6 EMAX 2004 bell: listings give 24.7 x 19.2 without saying which is the diameter; prop screw spacing not published.
- Q7 S500 frame: answered from Holybro's S500 V2 STEP (M row, derived, 24 Oct); top plate arm holes 30 apart confirmed (P, Spark 24 Oct). Left: motor centre diagonal, 486 CAD vs 500 listing (Spark 24 Oct: ruler too short; plate centre to a motor shaft is 243 vs 250 and fits a 30 cm ruler).
- Q8 1045 prop mass: listings 7 to 12 g.
- Q9 4S 6000 pack mass: listings ≈ 590 g for 144 x 45 x 40, ours is a larger envelope.
- Q10 SKR Mini E3 V3 hole size: not published (M3 in practice).
- Q11 DS3218 output axis: about 10 from one end, scaled off the drawing only.
- Q12 MG995 ear holes and output axis: not published.
- Q13 20T pulley set screws: LDO uses M4, generic kits often M3.
- Q14 Kit idlers: listings have flange 13 or 18 with bore 3, or 18 with bore 5; the buy list's Ø16, 5 mm bore exists in none.
- Q15 A3144 module: sellers give 29.2 x 11.2 with one Ø2 hole, or 32 x 14 / 27 x 15.5 with a 2 or 3 hole.
- Q16 Electromagnet thread: M3 on most listings, M4 on one; the Heschen part has no maker data.
- Q17 Short M3 insert length: 4.0 (Ruthex) vs 3.0 (CNC Kitchen).
- Q18 4010 fan hole size: Ø4.3 on one maker, others not stated.
- Q19 XT60E1-M panel cutout and screw size: not in the Amass sheet.
- Q20 P75 pogo pins: barrel 1.0 to 1.5 and length 16.5 to 33 across listings.
