sparkiscool/nox/nox/log.md

# Nox: log (from 14 Oct; Scout v2 lines are history)

- 28 Oct (Scout v3): layout v13 (`runs/scout_layout/v13/`): node mass fitted to the saved nodes v2 (192 g M; v12 assumed 39, CG read 4.65): catch 2.5 aft (was 5.0 fwd), 58 rods on 19 nodes, 912 g E, CG 0.7 / 0.7 E; frame v4 34 Hz F. Nodes, electronics stale (redraw); camera v1 for mass only (6.2 clips).
- 28 Oct (Overseer): cage nodes v5 saved READY: 24 print files (15 designs + 9 mirrors), drawn first (no topology run), 2.0 walls (v4 2.5: 345 g), 289.4 g PETG (M), each solid_check PASS, worst 0.252 (F); in the assembly, system_check PASS; runs/cage_nodes/v5
- 28 Oct (Overseer): head v5 sweep (3 rods) all solid FAIL, worst 1.6-2.7 (M): one held socket took all load; the L2 plane cut the side bosses (1.2 wall, M). Fix: all 3 sockets hold; bosses checked on the exact keep-outs; L2 rolled 180 (DEFAULT); rods 12 behind (C): 119.4 / 94.2 Hz (was 151.8, unbuildable) (F on E)
- 27 Oct (Overseer hub deck v12): saved, READY. Core v4 deck (no head load): 6 feet, Pi posts, bay pads joined by topology, 37.1 g (v9 68.0), worst 0.17, 432 Hz, solid PASS; assembled on main (cage PR 165) fit 0, access 39/39. `print/overseer_hub_deck_v12.stl`, `runs/overseer_hub_deck/v12/summary.md`; v9 print removed.
- 27 Oct (Overseer core v4): the cage hung the L2 head on 3 rods to its nodes (no keels, braces), so the hub deck carries no head load: no tower or sockets, 6 feet (the (60, ±17) pair dropped), worst bolt 13.5 N (E); RX 6 to +y off arm 2's top screw (cage ask), access clear. `overseer/core_v4.py`, `runs/overseer_core/v4/`. Hub deck v12 next.
- 27 Oct (Overseer core v4, DEFAULT): hub deck A, one topology deck on the plate's 6 holes (~29 g, E), over B, the Pi on nylon standoffs through 4 holes drilled in the carbon plate (~4 g, heads in the receiver's zone), and C, v9 with empty sockets (68 g). Seat rails became pads (drawn is attachment only). `runs/overseer_core/v4/alternatives.png`.
- 27 Oct (Overseer hub deck v9, Spark): HOLD, "the topology looks so sloppy, material towards the surface of the nodes and not the back": 76 % of the tower ahead of x 55 is my drawn patches (v7 core blocks, v9 bars, constant-wall sockets), design room past the mouths. Third strike (v6, v8, v9): back to the system pass for the front hub.
- 27 Oct (Overseer, Spark: max 3 rods to the lidar): head on 3 6/4 rods to the cage only (centre to node 17, pair from above the cameras to 15/16; head_rods.py search 2241 sets): 151.8 / 128.4 Hz rigid / PETG (F on E), cams guarded 9.6 (system_check), no braces/keels/struts, node 17 a cage node. Alt y±85 169 Hz, over the bed
- 27 Oct (rule, Spark: why run topology after checks passed): Drawn first: run_estimate runs topo.drawn_check (drawn part alone: solid gate + strength on system loads); PASS = save drawn, no run (run_bg refuses, --force + Forced: line); review_precheck 14. Node load lookup missed every tube (fixed). All 14 nodes drawn-first running
- 27 Oct (Overseer): head redo (Spark: v4 flimsy, ring does nothing). Guard ring + camera bars off (cage guards L2 52.8, cams 7.7, E); keels off (duplicate low braces: 186 vs 187 Hz F); head loads from cage_frame head_loads.json (node-17 hit 758 N, F); head_mount.py v5 draws only bosses + sockets (31.7 g C, 8-rod; 21.6 g on 3 rods). Sweep h 4 running (alt: keep ring, V5_HEAD_GUARDS=1)
- 27 Oct (rule, Spark): Drawn is attachment only ("the extra materials cannot happen again"): the smoke (`tools/run_estimate.py`) now audits that every loaded drawn feature faces the design room (>= 35 %, else no run), and `review_precheck` 16 fails drawn growth after a FAILED version. CLAUDE.md, generative.md, review and run-part agents.
- 27 Oct (box master, Spark): every designed box component in the one artifact: the 3D viewer now sits in the master view (262 real meshes): full latch sets in every bay (battery_latch.latch_assembly posed as box_layout_v2.place), the printed v1 stand + frames and the superseded funnel + hook latch as off-by-default groups. `nox/box/ground_unit_export.py`, `ground_unit_page.html`
- 27 Oct (rule, Spark): "Saved parts go into their system as CAD" replaces the cage-sync line: the turn a part is saved its mesh replaces its placeholder in the system assembly and the system artifact is republished (CLAUDE.md, `docs/generative.md` Save and print, `docs/sessions.md`, review item 15).
- 27 Oct (Overseer): head mount v4 (run/head_mount-v4) solid FAIL: 8 voxel specks where each drawn socket boss ended on its bore floor. `head_mount.py` socket gets a 3.0 solid floor (FLOOR, as the cage nodes, DEFAULT); the v4 mesh plus the new drawn passes solid_check (C). v5 run next (strike 3) (alt: ream the floors on the mesh, not allowed)
- 27 Oct (Scout v3, Spark): every rod 3.0, sockets 3.2 (6/4 sizing dropped; crash fails accepted, rods are the fuse); FC on top of the plate; camera mount v2 by topology (worker). Rows: dimensions Rods, Strength; current-parts; v12 summary.
- 27 Oct (Scout v3): Scout artifact v24 (Spark: no visible part updates): the other sessions' parts now stand out, saved teal (camera mount v1), concepts amber (belly v1, tail block, carrier), listed first, plus "camera mount" and "belly" views (`layout_v3_view.py`).
- 27 Oct (Overseer): cage nodes: solid boss floor 3.0 behind each socket (was 1.0; `cage_node.py` FLOOR, DEFAULT). Node 2 at the lowered loop failed solid_check: the Ø7 arm met the boss through the 1.0 floor, a neck under 1.8. All 14 designs pass drawn-alone; node 2 to rerun (alt: flared arms, cut into by neighbour bores) (C)
- 27 Oct (box catch): the Overseer cage sync moved its loop to z -79.9 on foot caps 13.2 under the tube centres (ee944ce8): concept F takes it as parameters (DECK, OVR_PLANE_Z, OVR_REF, SCOUT_CAPS; pads 12.2 tall, bars 20.7, same plan); the Scout gets the same caps under its 4 ring nodes (DEFAULT, alt its loop 9.2 lower). Smoke in `runs/box_catch/bars_concept/`; full sweep: box catch session.
- 27 Oct (Scout v3): Landing row takes the box catch F requirements (PR 155, DEFAULT): TPU caps Ø16 x 3 under the 4 ring nodes like the Overseer's, 6 mm sleeves on the side rods over x ±32 (fall away if the ring goes 6/4); alt: loop 9.2 lower. No Scout geometry moved.
- 27 Oct (Overseer hub deck v9): saved, print/overseer_hub_deck_v9.stl 68.0 g (M), worst 0.30, solid_check + build test PASS, first mode 659 Hz, FE insert pull <= 70 N; low brace roots. v8 build test FAIL (+y tower via the centreline) fixed by drawn bars to the mid feet. Open: head mode with the socket springs (cage).
- 27 Oct (Overseer hub deck v6/v8): v6 (tower, braces at z 22/32) FAILED strength 2.72 (top hit, keel/front-foot joint); DEFAULT: brace roots lowered to z 12/18 (cage what-if: max root force 190 vs 403 N, tipping 8 vs 20 N m, head 166 -> 155 Hz; alt: v7 with more material, stopped). v8 running on the low roots.
- 27 Oct (Overseer core v3, cage + arm ask): the L2 braces root on a tower in the hub deck (B over a top-plate block A: 788 N a fastener), closed by deep webs to 4 mid feet + feet (60, ±17) after 2 review FAILs (pried toe; one-way pads); concept PASS. Hub deck v6 next (per-case root forces). v4/v5 not to print.
- 27 Oct (Overseer hub deck v4): READY, print/overseer_hub_deck_v4.stl 38.9 g (M), worst 0.24 (keels push), solid_check PASS, run 1.60 h (smoke 0.94..2.25), 6.25 members; flow clip v1 READY (5.0 g); keel hub coupon v2 (13.0 g). Rear Pi posts 99.8 % in the build drawn test (reported).
- 27 Oct (Overseer hub deck v3/v4): v3 ran 2.08 h (smoke said 1.5..3.6), 34.5 g, worst 0.35, CLI gate PASS but the drawn-body test FAILED: the arm box cut the mid feet and the zip-tie channels split the deck, capping members at 4.44. v4: real arm envelope, feet Ø14, UBEC/buck on VHB tape (DEFAULT; alt zip ties), every body reachable at 6.25.
- 27 Oct (Overseer core v2, Spark): scope = everything but arms and nodes, the L2 keel roots included; battery side an empty slot. Sled v3 stopped (it 68), hub deck v2 stopped. `core_v2.py`: hub deck + keel front hub (2 sockets 6.2 x 15, 6 insert feet, 129 N a bolt), flow clip under the front wing; fit 26.5 mm³ with a parked cage body node. Restored the core rows in current-parts.
- 27 Oct (Overseer): core's saved parts (hub deck v9 etc.) in the assembly (`runs/overseer_layout/v5/saved/core/`); cage base loop down 22.9 to z -79.9 (cartridge bottom -3); front core ties root on the deck tower (114, 0, 20), aimed forward (clear of the FC nut lines); TPU feet = caps under the loop nodes; bay ties root on the sled sides (y ±56). system_check PASS, CG 0.2 (C/E)
- 27 Oct (Overseer): L2 brace roots moved off the front arms into the core's hub deck tower, low: lo (97, ±26, 12), hi (97, ±14, 18) (C; head 155 Hz F on E); nodes get drawn arms to a hub (one body); saved node 20 / node 2 and the rear arm v5d shown in the layout artifact; head v3 solid FAIL (socket-rim specks), socket fixed; core_root_forces.json.
- 27 Oct (Overseer arms): rear v5d READY -> HOLD (review): assembled CG 5.8 mm with the pack in fails the 3 mm gate; the cage session rebalances (motor square) when the front is final, which moves the rear arm's ends, so the rear reruns then. Do not print v5d.
- 27 Oct (Overseer arms): v5 system pass written to dimensions System Overseer: arms; assembled system_check with the v5d arms: cage first 7.7, fit 0, access 21/21, 3555 g, CG 5.8 aft (FAIL tol 3, was 0.2; the layout's pack, cage session told). `runs/overseer_arms/v5d/`
- 27 Oct (Overseer arms): front v5d 228 g: solid PASS, strength 0.62 (cage crash 6), rods OK, modes 131 Hz vertical / 162 lateral (target 190): third front strike, back to the system pass. DEFAULT front v6: carbon space frame (4 x 6/4 chords + 12 x 3.0 Warren diagonals, sides, top, bottom; modal what-if 193..200 Hz on v5d's mass); alt: accept 131 Hz (in the 1P band).
- 27 Oct (Overseer arms): rear v5d READY: solid PASS, 187 g (M), modes 435 Hz, flight 0.04, handling 0.16, blow 0.11, cage crash 11 0.94 at the top plate corner (joint), 0.77 in the arm (generous target 0.5 missed in that case, reported). `print/overseer_arm_rear_v5d.stl` + `_mirror.stl`.
- 27 Oct (Overseer arms): front v5c 228 g: strength PASS (worst 0.62, cage crash 6), solid FAIL only at the blind tip socket walls (1.58), same as rear; front v5d (tip caps) runs in the sibling. Build OOM fixed by the voxelise chunking.
- 27 Oct (Overseer arms): rear v5c 174 g: solid FAIL (1.58 walls at the blind tip sockets); crash 11 1.10 at the top plate corner (joint), 1.01 in the arm; modes 418 Hz; rods OK. v5d: 2.5 tip caps, rear gen 50. `arm_topo_v5d.py`
- 27 Oct (Overseer arms): correction: the front v5b OOM was a sibling box missing /usr/local/lib/libmkl_rt.so.3 (pypardiso failed, fem fell back to splu, 14 GB); fixed there with `pip install --force-reinstall --no-deps mkl`. Threaded Pardiso climbing past 6 GB here was seen only beside another run (M). Front v5c runs single-threaded, done ~09:31..11:03 PDT (E).
- 27 Oct (Overseer arms): rear v5b: solid FAIL (1.1 collar walls where webs met bare tubes), cage crash 11 1.47 at the shoulder socket off the flange corner, 161 g. v5c (both): full-length 2.5 tube sleeves + flanges spanning root to shoulders. `arm_topo_v5c.py`, picture `runs/overseer_arms/v5c/layout.png`
- 27 Oct (Overseer arms): front v5b smoke OOM'd (14 GB) on a sibling: threaded MKL Pardiso climbs past 6 GB in the run's early iterations at 240k dofs; MKL_NUM_THREADS=1 holds 3.2 GB (M, probe). Front reruns single-threaded (DEFAULT; alt h 2.5). Engine fix left to a topo session.
- 27 Oct (Overseer arms): v5 stopped; v5b runs: L2 braces off the front arm (top-plate block, cage session), cage arm_loads.json (rear spoke node 2354 N, front 1013 N, F). Rear on this box, front in a sibling. `nox/overseer/arm_topo_v5b.py`
- 27 Oct (Overseer arms, system pass after 3 strikes each): rear v4: solid PASS, 96 g, modes 277 Hz, flight 0.09, handling 0.35, cage crash 1.09. v5 front + rear: 6/4 carbon tube chords (bore 6.2, 20 sockets), rear shoulders, solid root, flanges; braces-to-core asked of the cage. `nox/overseer/arm_topo_v5.py`
- 27 Oct (Overseer arms): front v3 FAIL (strike 3: v1 unchecked, v2, v3): solid (5 walls 1.1..1.5), 165 g, modes 104 / 123 Hz, cage crash 1.94, handling 0.65; rods OK; bed fits on the diagonal (168 square, C). Back to the system pass: cage loads (front tip 1.1 kN, braces 0.9 kN) vs 3.0 rod chords. Rear v4 running here (its box never started).
- 27 Oct (Overseer arms): front v2 built here (layout done on its box): 93.1 g, 1 body, solid FAIL (1.2 wall under a bottom rod bore), root open middle: flight 1.58, handling 5.5, cage crash 9.1. Front v3 started: solid root block, flanges to x 50, bottom rods z 5.5, gen 45. `nox/overseer/arm_topo_v3f.py`
- 27 Oct (Overseer arms): rear v3: 80.9 g, solid PASS, flight 0.09, handling 0.26, modes 268 / 274 Hz; cage crash 1.22 on the arm top face past the top plate edge (pivot). Rear v4 started: drawn root flanges 6 thick to x 40 (third rear version). `nox/overseer/arm_topo_v4.py`, `arm_strength_band.py`
- 27 Oct (Overseer arms): rear v2 done: solid PASS, 56.8 g, flight 0.22, handling 0.58, cage crash 2.44 at the top-plate edge (joint, Spark: assume good), modes 158 / 184 Hz. Rear v3 started: gen 45, root pads to the plate corners. `nox/overseer/arm_topo_v3.py`
- 27 Oct (Overseer arms, Spark): one printed part per arm (no fuse node); root joint (4 M3 inserts, S500 plates) assumed good for the cage crash loads (reported, not a gate). Replaces the fuse-node DEFAULT. `dimensions.md` System Overseer: arms
- 27 Oct (Overseer arms, decide): cage crash 2320 N at the rear node (frame v1 arm_loads, F) beats the S500 root joint (~1 kN an insert vs ~600). DEFAULT B: replaceable fuse spoke node (~600 N), arm sized for 1.5x; alt A through-bolts (plate holes not coaxial, PCB bearing ~1.2 kN), C printed hub plates. Runs keep full loads meanwhile. `runs/overseer_arms/v2/joint_options.png`
- 27 Oct (Overseer arms v2, Spark): cage nodes on the arms: one spoke node beside each motor (off the key column), 2 brace sockets in the front beam (inside, flat top); frame-model loads front 1108 / rear 1811 / braces 904 N (F). Root inserts at ~1 kN: asked the cage to cap the spokes. `runs/overseer_arms/v2/`
- 27 Oct (Overseer arms v2): cage v5 on main moved the motors 5.6 forward (205.9 / -73.1); v2 runs start beside v1 (v1 pinned to its inputs, finishes as the method check): core parts as keep-outs, bore 3.2, front rods 145.7. Fit 0 mm³. `nox/overseer/arm_topo_v2.py`
- 27 Oct (Overseer arms): rod bore 3.2 (Spark's coupon pick, P; was 3.3): the v1 meshes are rebuilt from their layouts with it (no rerun: the cut is exact at the build); spoke / brace sockets 6.2 x 15 for arms v2. `nox/overseer/arm_topo_v1.py`
- 27 Oct (Overseer arms, Spark): rod install check `arm_topo_v1.py --rodcheck` (bore clear 160 behind the shoulder to the blind end, sockets ≥ 80 % gripped, bonded length); insertion line outside the envelope (0 mm³). `nox/overseer/arms.md`
- 27 Oct (Overseer arms): runs restarted at h 2.0 front / 1.5 rear (topo README: h ~ min member / 3): at h 1.5 / 1.0 the solver fell to multigrid with 86 cases, no fine iteration in 80 min; now direct, ~2.4 GB. `nox/overseer/arm_topo_v1.py`
- 27 Oct (Overseer arms): cage v5 (PR 122, unmerged) moves the motor square 1.6 forward (62.4); arms v1 keep main's 60.8 (DEFAULT: CG 1.6 off < 3, runs not restarted); arms v2 takes the merged motors with the spoke sockets. Alt: restart both runs now
- 27 Oct (Overseer arms, Spark): strength generous: index targets half of L (≤ 0.25 flight, ≤ 0.5 crash / handling), handling 100 N, a 150 N blow on the motor end x6, generated front 40 / rear 25 cm³. Both runs restarted. `dimensions.md` System Overseer: arms
- 27 Oct (Overseer arms + core): plate gap stays 45 (core stack + leads z 26.5, Pi on the rear wing to 39.6, its minimum ~32; arms want ≥ 45). Core's arm-1 motor lead stand-in to go beside the root, not through it. `dimensions.md` O Arms and hub
- 27 Oct (topo engine): `Part.insert`: a bought stiff insert (carbon rod) solid in the layout and strength FE at its own modulus, never printed, out of the PETG indices; ties see it absent and never let it join two drawn bodies. Default off; test_topo 15/15. First use: Overseer front arms. `nox/topo/part.py`, `layout.py`, `build.py`
- 27 Oct (Overseer arms v1): system pass for the 4 printed arms (`dimensions.md` System Overseer: arms), topo setup front + rear (`nox/overseer/arm_topo_v1.py`); reviews 1-2 fixed: front on 4 x 3.0 carbon chords (engine inserts), insert-only cases, motor slots; ESC under the FC (Spark). Cage nodes off (Spark). `runs/overseer_arms/v1/`
- 27 Oct (Scout v3): belly mount v1 concept (PR 150) system model in `scout/v3/scout.assembly.json` (`scout_assembly_updates.py` belly(); FC 36 x 36 C and flow at (0, −40) C in `runs/scout_layout/v12/belly_v1/`); view draws the assembly's parts. 746 g E, CG 0.2 / 2.2 E, access 25/25. Saddle ≥ 2 off the flow (2.8 C). Open: FC 1.0 / 0.9 C to plate / receiver (under 2.0). Artifact v23.
- 27 Oct (Scout electronics mount): belly mount v1 round 2 (review FAIL): rails beside the FC removed, ESC vents 641 mm² both sides; flow on a bipod; options drawn; inserts 600 N, prying: crash 0.23 E; flow clear air DEFAULT slipstream (alt column: no pose); FC A as built DEFAULT (alt B on the plate top); soft-mount req to redo. `runs/scout_belly_mount/v1/`
- 27 Oct (box master): ground unit artifacts updated for catch concept F (PR 125): the sheet's top board, numbers and decisions; the 3D scene draws the concept's deck footprint 656 x 528 (C) in the reserved slot, wider than the enclosure (X ±206, Y −66..337): the parks come in or the top grows. Nothing drawn. `nox/box/ground_unit_export.py`
- 27 Oct (Scout electronics mount): belly mount v1 concept: PETG 25.2 g E, receiver partner + 4 new plate M3, tail face x −31; FC on the plate AIO holes (M2 grommets DEFAULT, alt M3), flow by search at (0, −40) on a post; system_check PASS, CG 0.2/2.2 C; FC 1.0/0.9 gaps fail 2.0 (as built). `runs/scout_belly_mount/v1/`
- 27 Oct (box catch, Spark: one-motor latch for both cages): concept F, push-bar catch on a flat deck: NEMA 17 + T8 x 2 carriage; two end pads clamp x through a sprung slide, then two side bars with lips (y, yaw, 74 N hold-down); stall = seated. C: Scout all landings in |y| <= 60, yaw +-15; Overseer |y| <= 40 at every x at yaw 0, y 0 at every yaw. `runs/box_catch/bars_concept/`, PR 125.
- 27 Oct (Scout electronics mount): v2 round 5 on v12: fit table 33/33, no allowances (C); sized on L (14 crash dirs): variant V8, mount 49.2 g E, crash worst 0.27 E; CG 0.56/1.49 at −5.0 C (main assembly, camera mount): PASS; system_check PASS; belly mount tail to x −31.0 (DEFAULT, alt: inserts in it). `runs/scout_electronics/v2/`
- 27 Oct (Scout v3): electronics round 5 (concept) in `scout/v3/scout.assembly.json` via new `scout_assembly_updates.py`: mount 49.2 g E, cables 6.3 g E at their CGs, 4 Radxa post keep-outs (Ø8.4, H); 746 g E, CG 0.6 / 1.5 E, catch held. Artifact republished.
- 27 Oct (Scout v3): the saved camera mount v1 (PR 146) replaces the layout's cradle in `scout/v3/scout.assembly.json` (layout_v3.py, view) and the Scout artifact (v21): 735 g E, cage first 6.2 E, CG 1.9 E. Frame model v3 (`runs/scout_frame/v3/`): real clip points, 32.3 g M+E mount, tube mass: sized 111 Hz F (810 g E), all 3.0 fails. Node 16 socket rule in dimensions.
- 27 Oct (Scout v3): camera mount v1 READY: one PETG print 21.8 g M (cradle, lens hood 4.0 C ahead, truss arms, Ø12 board pads, 4 snap clips on tubes 7-8/14-15, pop 23 N each E) + 2 CA'd stop collars; nothing in view, 109.3 Hz (F), system_check PASS. Alt B (bolted clips) for Spark. `runs/scout_camera_mount/v1/`
- 27 Oct (box master, Spark): no design work yet; the 4 part sessions stopped and archived. Nox Ground Unit 3D https://claude.ai/artifact/VyTyzuieTjrbBnURYPDgmG: 143 real meshes in W (arm v7 + its 22 s cycle, PR 113 cut pieces, receivers, cartridges, electronics, sheets, reserved top slot); `nox/box/ground_unit_export.py` -> `runs/ground_unit/v1/`, page `ground_unit_3d.html`.
- 27 Oct (box master, Spark): Nox Ground Unit artifact https://claude.ai/artifact/RX2CexkfhB5UoQHnGTVgCC (`nox/box/ground_unit_page.html`): the whole box to scale, the top slot reserved for the design center's landing mechanism (no funnel), one session per system started (arm, latch, structure v2, electronics v2); owners in current-parts System recheck.
- 27 Oct (Scout v3, Spark rule via PR 143): the sessions making the Scout's cage parts are listed in `nox/scout/v3/README.md` (electronics mount, design center funnel, the camera mount worker); every cage change goes to each, and each saved part goes into the assembly and the Scout artifact.
- 27 Oct (rule, Spark): cage sessions keep their parts in sync: every cage change goes to every session making its parts, and the cage artifact is republished with the newest saved parts each time one is saved (CLAUDE.md, docs/sessions.md, review item 15).
- 27 Oct (Scout v3): DEFAULT for the cage pieces: 6/4 tube on the 39 members the frame model sizes (6.2 sockets), 3.0 on the rest (3.2); the layout keeps 3.0 per the Scout clause until Spark rules (alt: 3.0 everywhere fails every crash case). `runs/scout_frame/v2/`
- 27 Oct (Scout v3): rerun on the electronics mount (38.6 g + cables 6.4 g, UBEC 7 out, XR2 kept off the rear prop): catch 5.0 forward, CG 0.9/0.8, 55 rods, 730 g E; alt bay fixed in the frame (61-64 rods, CG 1.3/2.9) out. Frame v2: all-3.0 fails, 6/4 on 39 (+74 g) passes at 138 Hz. `runs/scout_layout/v12/`
- 27 Oct (Overseer): arm session ends in (spokes from the arm nodes, L2 brace roots in the front beam) and core v2 (keels 5 into the hub deck, hub block off the head); frame: rear arm node 2317 N, front 1074, braces 897 (F, `arm_loads.json`), the arm root takes it (told); `cage_node.py recut` makes saved sockets 6.2 / 3.2 (C) without a rerun (Spark).
- 27 Oct (Scout v3, Spark): firmware check: the AM32 ESC can reverse; PX4 has no ESC passthrough (why the app failed) and no turtle mode; `dshot reverse/save` sets direction without soldering; ArduPilot Copter has Turtle mode on this board. Choice: ArduPilot, or PX4 + flip arm. `runs/scout_selfright/v1/summary.md`
- 27 Oct (Scout v3, Spark question): one-way props cannot right the Scout (upside down they press it down, on its side they roll it onto its back); the v11 cage rests in 6 poses. Ways: turtle mode (reverse ESC + ArduPilot or a PX4 add-on), a flip arm (~15-20 g), or a self-righting cage (sides ±170). `runs/scout_selfright/v1/`
- 27 Oct (Scout v3): frame model v1 (`nox/scout/v3/cage_frame.py`, `runs/scout_frame/v1/`): the all-3.0 cage fails the 35 g crash (31 of 50 buckle, saddle ties 2800 MPa) and the camera mode is 25 Hz; 6/4 tube on 38 members (+73 g) passes all, 79 Hz. Spark decides vs the 3 mm Scout clause; nodes wait on it.
- 27 Oct (rule, Spark): socket bores from the coupons: "the largest of the coupons we just printed was the one": 6.2 (6 mm tube) / 3.2 (3 mm rod), standing and sideways; CLAUDE.md, docs/generative.md, dimensions.md Carbon rods, head_mount.py, cage_node.py. Fixed a merge duplicate in generative.md. All socket sessions told.
- 27 Oct (Scout v3, Spark): rod sockets 3.2 for the 3 mm rods (coupon pick, the largest bore) in the cage nodes, tie saddle and every epoxied Scout socket; the camera snap clips keep their own grip fit. `dimensions.md` System Scout v3
- 27 Oct (Scout v3, Spark): tail bay out of the prop wash (Radxa on edge on the centre plane, UBEC behind the rear disks; DEFAULT, alt flat Radxa in the wash) and CG centred: tail bay + catch scanned on true centroids, CG 0.8/0.9 off (was 2.7/1.3); no low tail node; 50 rods, 680 g E, 387 long. `runs/scout_layout/v11/`
- 27 Oct (rule, Spark): Measure before quoting. `tools/run_estimate.py` smokes a topo run (3 iterations a stage: s/it, cases, peak GB) into `estimate.json` before it starts; times quoted as a range in Pacific; parallel only if peaks fit 75 % RAM. CLAUDE.md, generative.md Heavy runs, run-part step 2, precheck 14.
- 27 Oct (rule, Spark): socket bore = the coupon pick (DEFAULT 6.1 / 3.1; OD + 0.3 was loose in PETG) in CLAUDE.md and docs/generative.md; TPU only for feet, skids and strips. PR 122 review round 4 PASS, its notes fixed.
- 27 Oct (rule, Spark): cage nodes PETG, not TPU ("would it be better using petg if so we will just use that"): F on E, PETG joints lift the L2 head 120 -> 206 Hz and the cage's lowest mode 26 -> 126 Hz; CLAUDE.md Hard rules, docs/generative.md Geodesic cage, review check 14, cage_node.py material. Plus PR 122 review round 3 fixes.
- 27 Oct (Overseer): PR 122 review fixes: System Overseer v5 in dimensions.md (head and node requirements), shared ring row to the v5 loop, cage alternatives picture `cages_alt.png`, frame report with modes and cage mass, summary rewritten on current numbers, artifact labels (head printed, cage v5) republished.
- 27 Oct (Overseer): the head's 4 struts are layout links now (mass, props 13.7, views clear): 3215 g, T/W 2.05, links 36 (30 tube 6/4); frame: every link ≤ 0.63, 4 shell tubes reported over in the crash (1-19 / 3-18 1.59 on the top hit, 11-18 / 12-19 1.29); system_check cage first 7.7, fit 0, CG 0.2.
- 27 Oct (Overseer): socket bores DEFAULT 6.10 / 3.10 (v2 coupons' middle; v1 OD + 0.3 loose) in head_mount.py and cage_node.py until Spark picks; cage_node takes the one-piece head's 4 struts (6/4) at nodes 15/16/18/19.
- 27 Oct (Overseer, Spark): one-piece head (L2 + both cameras, `head_mount.py head`): drawn 56 x 177 x 163 (fits 180), L2 loaded at its CG with its moment through the 4 bolts, 4 struts 6/4 to side nodes 15/16/18/19 (searched clear of views): head mode 222 / 119 Hz rigid / TPU (F on E). Top hit now on the camera guards: tubes 1-19 / 3-18 1.62 (reported).
- 27 Oct (Overseer, Spark): cameras on the same print as the L2 mount: the camera search gets a one-print fit (the head oriented box ≤ 175, `HEAD_ONE` in `layout_v5.py`): lenses (390, ±75, 122), same field 3.42 sr; system_check cage first 7.4, fit 0, CG 0.2. One-piece head setup next.
- 27 Oct (Overseer, Spark): rod coupons v2 ready to print: v1 loose in PETG, bores 6.00/6.10/6.20 and 3.00/3.10/3.20, each standing and sideways (a sideways hole prints tighter; sockets take the bore by their angle to the bed); solid PASS; `runs/rod_coupons/v2/`.
- 27 Oct (Overseer): frame v1 rerun on the fixed solver: 9 links 3.0 -> 6/4, buckling k 0.7 for links with a core end (E); 4 members reported over in the 35 g crash (tubes 11-18 / 12-19 1.15, core ties left.1 / right.1 1.06), not split: each split moved it to the next long tube (halved cage, Spark "ignore the tests"; buckling is reported, not gated).
- 27 Oct (Overseer, Spark): head stays on the keels + 4 L2 braces ("keep the design we have right now i need the lidar to have max performance"): 200 / 119 Hz rigid / TPU, the stiffest option; head-on-cage kept as alt `V5_HEAD_ON=cage` (32 Hz). Frame: 6 members still buckle (4 core ties 1.2..2.2, tubes 11-18 / 12-19 1.15): next.
- 27 Oct (Overseer, Spark): L2 on the cage tried (`head_cage_concept.py`, `runs/overseer_head_cage/concept/`): cage-only ~50 Hz on TPU nodes vs 100 target; DEFAULT keep 4 L2 braces, drop 2 keels (101 Hz); alt cage-only D. Frame solver regularisation bug fixed: 9 links to 6/4, 6 members still buckle (core ties, 2 side tubes), node runs stopped.
- 27 Oct: Overseer v5 docs: one head mount mass (100 g E, system model = head_system.json), mass 3178 g, T/W 2.08, shell 63 tubes 15.9 m, L2 base 384, camera field cones per lens; `layout_v5.py`, `runs/overseer_layout/v5/summary.md`.
- 27 Oct (Overseer, Spark): rod socket coupons v1 ready to print: 6 mm tube (bores 6.30/6.45/6.60) and 3 mm rod (3.30/3.45/3.60), glue rings, floor vent, entry chamfer; solid PASS. Spark picks the bore. `print/rod_coupon_*_v1.stl`
- 27 Oct (Overseer): frame model v1 (`nox/frame_model.py`, `nox/overseer/cage_frame.py`): 19 links buckled as 3.0 -> 6/4 tube, 3 long tubes split; cage 24 nodes / 63 tubes, worst 0.87 (3 core ties 1.01-1.15 pinned, marginal). Head centre v2 + 14 TPU node runs restarted on it. 3178 g E. `runs/overseer_frame/v1/`
- 27 Oct (Overseer, Spark): cage v5 close nodes merged (tubes < 95 become one node; base loop 8 -> 6, told funnel + Scout), node angles >= 20: 21 nodes, 54 tubes, 3084 g, T/W 2.14. Head mount (centre + wing) and 12 TPU node topology runs started. `runs/overseer_layout/v5/`
- 27 Oct (Overseer, Spark): cage v5 = cage v3 with half the tubes (25 nodes, 64 tubes, mirror-exact, 3120 g, T/W 2.12); same-length cage v4 (11 lengths) dropped by Spark. Camera pair beside the L2 (landscape 45° out), flow pod 15 fwd, printed sensor head mount replaces the short rods (budget 73 g). `runs/overseer_layout/v5/`
- 27 Oct (Overseer, Spark): flow pod 15 forward (every rear arm screw through a sled hole, nothing unplugged); pack-out CG 32 mm accepted by Spark ("as long as with battery the drone is centered"), the L Balance exception. CG 0.2 mm pack in. `runs/overseer_layout/v5/`
- 27 Oct (Overseer, Spark): down camera removed; the 2 cameras beside the L2, orientation searched for the largest union field: portrait, 50° out, 15° down, 3.45 sr with no overlap, nothing of the drone in view (alt landscape 3.44). L2 31 forward, motors 72.4 ahead, 3368 g E. `runs/overseer_layout/v5/`
- 27 Oct (Scout v3, Spark): bottom on Overseer v5 loop's side nodes, plane 2.12 lower; links out of funnel band; no rods on carbon arms: 6 ties from a printed tie saddle by the receiver (DEFAULT reading of "cartridge"; alt core ties on plate edges 42 rods 651 g); 50 rods, 679 g E, CG 2.4/0.9. `runs/scout_layout/v10/`
- 27 Oct (Scout electronics mount): tail fin concept v1 failed review x3 (root joint, CG true centroids need catch set 7.4 fwd, hand-placed): back to the system pass v2 (later on scout_layout v10..v12). `runs/scout_electronics/v1/`
- 27 Oct (Scout electronics mount, Spark: pointed tail): concept A, PETG fin in the race-car tail bolted to a belly mount block, C-clip fuse on the tail tie: Radxa on edge, UBEC, XR2; out of the wash, walls ≥ 13.9; CG needs catch set 3.5 fwd (DEFAULT; alt B tray: 3.8 aft). `runs/scout_electronics/v1/`
- 27 Oct (Scout v3, Spark): the Scout = race-car cage: 54 x 3.0 rods (was 123), flat roof, raked front, tail point, no small triangles; bottom = Overseer ring's middle rectangle (+13.7/+21.6 ends, was +30); camera close in, PETG cradle snap-clipped onto cage rods after the build; DEFAULT tail bay; CG 2.3/1.0; 662 g E. Rule: CLAUDE.md, generative 0, precheck 13. `runs/scout_layout/v9/`
- 27 Oct (Scout electronics mount, Spark): list confirmed (FC AIO, XR2, MTF-02P, Radxa + microSD, UBEC, camera, wiring); no lights; battery side (pack, XT60, cap, pads, diode) left out of the mount. `scout/v3/README.md`, `scout/scout.md`
- 27 Oct (Overseer core, Spark: "do we really need that many"): 4 plate bolts, not 6 ((24, ±36.5), (-65, ±22.5)): 193 N a bolt in the 35 g crash vs 137 (E); coupons 16.0 / 28.1 g, solid PASS. `runs/overseer_core/v1/`
- 27 Oct (Overseer core, review): FC stack turned 45° into the top plate's slots ("the lines", r 21.57; +X hole at the cutout edge, CHECK), on bench-set M3 studs with nuts from above; front bay bars inside |y| 20 (arm envelopes); access 34/35 (Pi plugs vs v5 body ties: cage). `runs/overseer_core/v1/`
- 27 Oct (Overseer core, Spark): round 5: no stack mount, the FC + 4-in-1 bolts straight through the carbon top plate (Spark); 2 pieces, 2 coupons (hub deck 17.9 g, sled 29.2 g); every mounting hole checked against the STEP (360° faces) and the makers, table in dimensions System Overseer core
- 27 Oct (Overseer core, Spark): round 4: FC + 4-in-1 stack on the top plate (stack mount), Pi 5 between the plates, UBEC + buck on the front wing; rear feet on real holes (-65, ±22.5) (review: (-72.5, ±31.75) were outline fillets); 3 coupons 8.6 / 17.9 / 29.2 g, solid PASS. `runs/overseer_core/v1/`
- 27 Oct (Overseer core, Spark): round 3: no PDB (4-in-1 under the FC), cameras/lidar off our list, 2 pieces (hub deck: stack, Pi 5 aft right side up, UBEC/buck/RX; sled: receiver face + flow pod), every screw straight down; mounting coupons hub deck 33.8 g + sled 27.9 g READY. `runs/overseer_core/v1/`, `print/overseer_core_coupon_*`
- 27 Oct (Overseer core, Spark): system pass for everything inside the cage but the arms: hub frame, power tray, sled, mirror skids with the pods, TPU feet; real latch set in pose puts the cartridge bottom at z -76.9 (22.9 under v5); feet now span the CG. Shell FAILs go to the cage session. `runs/overseer_core/v1/`
- 27 Oct (rule, Spark): Parallel by default tightened: a check / smoke run never gates its full runs (all start in the same turn; a failed check stops the full run), a full box means a sibling session at once. `run_bg.txt` records the start; `review_precheck` 12 fails runs started > 30 min apart without `Waited for:`. CLAUDE.md, docs/generative.md Heavy runs
- 27 Oct (Scout v3, Spark): layout v3 / cage v1 geodesic: PR 94 drone + geodesic shell (34 nodes, 91 tubes 6 mm), bottom ring = the Overseer's (same 8 nodes, 3 under the cartridge bottom: funnel shared), one nose camera outside on a braced boom, Bee35 base kept; catch 13.5 aft, CG 2.2 / 1.3; 933 g E. Alts drawn: own ring 935 g, camera on top +31 tall. `runs/scout_layout/v6/`
- 27 Oct (superseded by F) (box catch, Spark: drop keep-alive, one servo): **hook catch, one servo**: a lift frame under the deck round the swap column drives all 4 hooks through sprung links, over-centre lock at the bottom; keep-alive contacts dropped (seat sense: a hall at frame locked + servo current). Not yet checked. `runs/box_catch/hooks_concept/`
- 27 Oct (superseded by F) (box catch, Spark: servo hooks idea): **hook catch concept**: flat deck, 4 servo hooks rise after landing and pull the 4 shared bottom nodes (Overseer v5 hexagon side nodes = Scout v11 bottom) into V-seats, over-centre lock for the swap; vs ramps (Scout +-20/25, Overseer +-25, yaw +-2.5). Not yet checked. `runs/box_catch/hooks_concept/`
- 27 Oct (superseded by F) (box catch + Scout v3, Spark: no rim, ramps into the opening): **catch concept E**: Scout opening = Overseer's middle rectangle; 2 shared side ramps, 2 Overseer end, 2 Scout end (low, beside its receiver); cages unchanged. Tolerance (kinematic): Scout +-5, Overseer +-30 x / +-10 y; pods in to |y| 46: +-15..25 / +-30. `runs/box_catch/ramps_concept/`
- 27 Oct (superseded by F) (box catch + Scout v3, Spark: "funnel that works for both and only depends on the bottom opening"): **catch concept D (DEFAULT)**: 4 posts at 45 deg into a shared 220 rim at each cartridge bottom; +-30 landings pass on Scout + Overseer v5, one head stop. Alt C: belly crown, funnel 79 lower; B: Overseer 61 off. `runs/box_catch/posts_concept/`
- 27 Oct (superseded by F) (Scout v3, Spark: bottom looks bad, wastes performance): **bottom concept B (DEFAULT)**: wheels on the shell crown (box catch unchanged), pack 1.0 under the FC, receiver box -> 2 latch rails in the shell's bottom ring: -73 g, -7.4 mm, hover -15 % (E); system_check PASS. Box ask: head stop +7.4. Alt C: wheels on the bottom ring + new funnel. `runs/scout_bottom/concept/`
- 27 Oct (Overseer, Spark): cage v3 structure kept (same 48 nodes, 131 tubes; scan pinned); symmetry already exact (0 tubes without a mirror, links too), none to add; cameras back to v2's format (down camera + flow pods at v2's place, v4 had them 35 forward); 3 rear-arm screws need a pod board unplugged. `runs/overseer_layout/v5/`
- 27 Oct (Overseer, Spark): cage v3 mirror-exact (symmetric triangulation, system_check mirror gate), no tube-length limit, 6/3 mm tubes only; review fixes: camera guard bar, L2 braces to the arm beams, lug fuse, field cones replace exempt (L2 75°, camera 55°). 48 nodes, 131 tubes, CG 0.6 mm, 3382 g E. `runs/overseer_layout/v5/`
- 26 Oct (Overseer, Spark): cage v3: L2 + front camera outside the geodesic disk, nothing in their views (shell 25 behind the L2 plane, under the camera view), guard ring behind the L2; one layout, CG 0.6 mm (pack out 29 mm: L exception). 636 x 678 x 190, 3375 g E. Rule: field sensors outside the shell. `runs/overseer_layout/v5/`
- 26 Oct (Overseer, Spark): cage v2 = v2 layout + geodesic disk cage (freq 2, 6 mm tubes, 715 x 703 x 253), pack top z -7, L2 nose; prop shadow 7.4 / 14.6 % (secondary to structure). Pack out 22.7 mm: L Balance exception (DEFAULT, alt pack on axis r 336 arms). 3288 g E. Rule: shells formed to the drone. `runs/overseer_layout/v4/`
- 26 Oct (Overseer, Spark): cage v1 = geodesic sphere (Elios format, v0 scrapped): NU 2, 6 mm tubes, R 363, opening clear Ø305 for pack + swap; L2 on top (DEFAULT, alt nose fails pack-out balance; L2 blind below -6°). 3361 g E, T/W 1.96. Rule + system_check shell. `runs/overseer_layout/v3/`
- 24 Oct 16:39 scan stick nodes v2 x8 printed in PETG on Jarvis (Spark: "just use petg", TPU not loaded); rigid test set, against the TPU-nodes rule; reprint in TPU 95A for flight. Row in `nox/print-log.md`.
- 24 Oct (rule, Spark): carbon rods are 3.0 wherever one passes, thicker solid or tube only where the frame model needs it; CLAUDE.md Hard rules, generative.md rule 0 (Carbon rod size), dimensions.md G row, review_precheck 11 message
- 24 Oct (usage session, Spark: implement the usage plan): sessions compact at 300k; loops in workers; heavy runs via tools/run_bg.py (one wake); sync by pull (CLAUDE.md rule reworded); Spark notified only when done, print-ready or a decision; review_precheck.py, dim.py, opus-run sweep report; organiser 12 h, cheap exit, paused. `docs/sessions.md` Usage, `docs/usage-plan.html`.
- 24 Oct (swap arm worker): **swap arm grip line Y_C 165 → 167.1** (DEFAULT, latch session agreed): latch v4's Overseer receiver v2 lead end is 2.15 (M) longer (3.0 capture, C); a trim needs ±0.7 Y (E), the arm holds ±1..1.8 (E). Rerun: 0 overlaps, fit 0.0, access 9/9 (M), swap 0.45 / 0.49, XT60 x 1.28° / 1.07° (F). Shared: latch, catch, structure, heads told. Alt: latch trims.
- 24 Oct (box structure system session): grip line Y_C 165 → 167.1 (arm DEFAULT: latch v4's longer Overseer lead end); latch receivers re-exported from main (b70e63d). Variants rerun: A fit 0.0, 418 x 409 x 470 (80.4 L), lanes clear the catch by 2.0 (C on M). `box_layout_v2.py`, dimensions.
- 24 Oct (box catch chat, box structure): catch moved to the new grip line Y_C = Y_FUN 167.1 (was 165; swap arm DEFAULT, latch v4): `catch_system.py` constants, box_catch.assembly.json poses +2.1 in W Y, fit 0.0 (E); v9 plain unchanged (the -Y panel clears the arm lane by 2.0 in r at 167.1, structure C on M).
- 24 Oct (swap arm worker): **hub v7** (PR 111): solid PASS (M), 213.3 g (M), sustained 0.60, misuse 0.47 (F), swap 0.524 (F) at the sleeve-to-plate corner: **hub v7 strike 1** (concept est. 0.46, E). Next DEFAULT: an FE on the saved mesh with compliant 6010 seats; alt a drawn fillet. Assembled recheck: latch v4 receiver clash (Y_C_min 167.1, F). `runs/hub/v7/`
- 24 Oct (swap arm worker): **hub v6 run 3**: solid PASS, 199.3 g (M), swap 0.523, sustained 1.075 (F): third miss, so a system pass → hub v7 (DEFAULT): belt loop modelled as strands; tower column 14 x 14 inside the loop (C, sustained ~0.5 E); gen 62 cm³, ~212 g, swap ~0.46 (E); budget 215 g. Rejected: legs (close the belt window), skirt. `runs/hub/v7-concept/`
- 24 Oct (swap arm worker): **hub v6 run 2 FAILED** (h 2.05: solid FAIL on 15 sub-0.25 mm lips under the plate (M), swap 0.596, sustained 1.33 at the tower column root, F). Run 3 (`run/hub-v6r2`): generated region 1.0 into the plate, column flare r 7.5 → 5 (C), gen 52 cm³; h 3.0 test solid PASS, swap 0.32, sustained 0.76 (F). `runs/hub/v6r2/summary.md`
- 24 Oct (swap arm worker): **hub v6 run 1 FAILED** (h 2.25: solid FAIL at the drawn hall pocket's 0.8 walls, misuse 3.40 in the unbraked Overseer power cut, swap 0.561, F). Run 2 (`run/hub-v6r2`, h 2.05): power cuts out (brake required, DEFAULT; alt gusset), cases enveloped 15 % (E), pocket walls 2.0 (C). `runs/hub/v6/summary.md`
- 24 Oct (battery latch worker): **battery latch v4** (PRs 69 + 109): receiver v2 closed channel + XT60 carrier; Scout receiver v3 (head seats in the clip, bolts x 26.55, narrowed under its keel, worst 0.413); cartridge + slider v6 rib (heads v7); Scout TPU end pieces; Scout HOLD, Overseer DESIGN. DEFAULT: 40° probe exemption, M3 x 35, end pieces on the drone only. `box/battery-latch.md`.
- 24 Oct (organiser): light pass 12:04: 8 nox sessions, none to archive; XT60 chat blocked on Spark's go to print funnel v9 plain panels (reported); check_state clean; hub mentions removed from docs/organiser.md and README (no hub since 09:00); tools/sweep_eval.py added.
- 24 Oct (box structure system session, box electronics): heads v7 confirms both gripper dwells hold unpowered, so K4 cutting both grippers is safe if the open command lands inside the 10° open dwell (bench CHECK); the 5-wire ribbon and the 3:1 hall sum are fine on the head. box-electronics.md.
- 24 Oct (box structure system session): round 2 topology recorded in dimensions System box structure (sheets as cladding, 3000 cm³, no datum ring, DEFAULT; Overseer bay bodies split at Y 158, DEFAULT; boards re-placed round the frame after the cut, DEFAULT; alt: frame round the boards). Cut + system FE worker started.
- 24 Oct (box_system v2 topo round 2, run-part): sheets as cladding, floor only support: 3000 cm3 stands alone (9/9 bays, 8/8 posts, stub tilt 0.41 mrad, bay rot 1.8 mrad, 9 cm2 floor, 3886 g generated E); 2000 too soft, 4000 2x stiffer +1.2 kg; datum ring not needed; Overseer bays 200 long. `runs/box_system/v2/topo_r2/`.
- 24 Oct (swap arm worker): **rails A / B v5** (DESIGN): ribbon channel X ±3.25 / mouth 5.0 (C) for the 5-conductor head ribbon ~6.1 wide (E, box electronics PR 103), M5 x 10 heads sunk under its floor (C; v4 had them in it). 56.5 g (M), solid PASS, access 9/9 (M), rest unchanged. Bundle 22 wires Ø7.6 (E) fits the Ø8.5 post bore (C). `runs/arm_rail/v5/`
- 24 Oct (box structure system session, box electronics): heads v7 gripper items: dwell positions only, stall cut (K4 + INA226 0x40, 0.5 s, E; PCA9685 to 0x60), grip halls at 3.3 V upstream of K4, 2 per head summed 3:1 on an ADS1115 0x48 (DEFAULT; alt 2 lines per head); bundle 19 → 22 (CHECK arm). Script rerun.
- 24 Oct (swap arm worker): **swap arm v7 recheck**: carriage plate top 74.35 and insert-lane keep-out Z 89 / 95 (heads v7 asks, DEFAULT; Y_C_min 165.0); rerun 0 overlaps, swap 0.45 / 0.49, XT60 x 1.25° / z 0.84°; review notes folded. Shared: keep-out row (catch, structure told). `box-arm.md` v7
- 24 Oct (box structure system session): insert keep-outs per the arm / heads v7: carriage Y to 75.35 (plate top 74.35), Z ≥ 89; grabber from r 95 (was 111.5). Variants rerun: fit 0.0, the lanes clear the catch (panel v9 plain) by 2.0 (C on M), box 80.0 L unchanged. `box_layout_v2.py`, dimensions.
- 24 Oct (control chat, Spark: "we dont need a digest session"): no hub; one task per session with Agent workers inside it, a new cloud session only for heavy runs or a full box; sessions message Spark only for print-ready files or his decisions (`CLAUDE.md`, `docs/sessions.md`). The control session is archived.
- 24 Oct (tooling, from scout v3): system_check crash probes: protected parts shadow each other (a probe stops at the first solid); failing probe rows Scout v3 (live layout) 21 -> 12, Overseer 28 -> 24, worst margins unchanged (-27.8, -0.0 unshielded); box manifests have no probes. `system_check.py`, `ASSEMBLY.md`.
- 24 Oct (hub, Spark: "only use tokens when absolutely needed"): no timed 30 min digests; the hub messages Spark only for ready-to-print files or his decisions (`CLAUDE.md` Quiet workers, `docs/sessions.md` Reporting).
- 24 Oct (box_system v2 coarse topology round 1, PR 96, run record): 3000 cm³ (3.84 kg generated, E) joins every bay and post (M; at 1500 only bays 30 / −210 join); top frame under the funnel, mast on the rear sheet, sheets carry the box (floor 12 cm², M); stub tilt 0.37 mrad (M). Not cut from: round 2 with the sheets as cladding. runs/box_system/v2/topo/summary.md.
- 24 Oct (hub, Spark: "no need for that"): belt connector measurement dropped from the Spark list; swap arm heads A / B v5 HOLD, superseded by heads v7 (rack and pinion, no belt connector).
- 24 Oct (box structure system session, box electronics): pack-out hold (catch PR 93, DEFAULT): latch never retracts with the pack out; aborts keep it OUT and K1 closed; A4 always holds (alt: drone bus voltage); A12 reads seat sense first; MATE_CHECK needs I > 100 mA during INSERT first. box-electronics.md.
- 24 Oct (box catch chat): **funnel panel v9 plain READY** (±x): 2 keep-alive spring probes per A panel (u 12/22, z 33), −x pair notched r ≥ 161 (2.0 off the arm lane, DEFAULT); FE 0.80 (C); catch + probes + 74 N stall: all seated, worst 0.91 (C). DEFAULT: latch never retracts while the pack is out (alt B− at y +12/+22). `runs/funnel_panel/v9_plain/`.
- 24 Oct (swap arm worker): **swap arm v7 round 3d, concept PASS** (PR 79): Y_C 165 = tab line (latch 258becf), low carriage + rail v4 keel, 5:1 axle, detent v6 x1.3 (623ZZ), pinion v3; XT60 x 1.24° / ±2.37, z 0.84° / ±1.06; stub ≤ 10 mrad; heads v7 grabber concept. Shared: L Swap. `box-arm.md` v7
- 24 Oct (box structure system session): funnel v8 file (catch PR 81) loaded as is: fit 0.0 mm³, both arm insert lanes clear the −Y panel (r 159.61 vs 159, C on M), v9 notch not needed for fit; v8 needs no Y room, box 418 x 407 x 470 (80.0 L). `box_layout_v2.py`, dimensions System box structure.
- 24 Oct (rule): carbon where its length earns it (Spark): short cage members printed, break-even 33 mm DEFAULT; CLAUDE.md Hard rules, generative.md The rule 0, review check 11.
- 24 Oct (box structure system session, box electronics): from arm v7 (PR 79): per-bay gravity offset in the axle step target (commissioning) + sag check ≤ ±0.55° (E, arm budget), ≤ 100 full steps/s through each notch, TURN 1.1 s; detent now holds (x1.3, index 1.04), KB3 stays. box-electronics.md, dimensions I.
- 24 Oct (box catch chat): **funnel panel A / B v8 plain** (±x, DESIGN, do not print: v9 plain next): bottom edge seat z 12.8, opening 191 x 168 (DEFAULT; alt 181 sq), Overseer set centred 3.3 a side (C); FE on the seat landings 0.911 (C), 53.8 / 53.7 g (M); v7 plain do not print; box_catch.assembly.json in box W (Y_C 165). `runs/funnel_panel/v8_plain/`.
- 24 Oct (box structure system session): stub tilt ≤ 10 mrad at the mast face, k ≥ 0.59 N·m/mrad (arm worker DEFAULT: XT60 float ±2.37° at 20 % margin leaves 11.6 / 15.2 mrad; replaces 1.9 mrad, merged an hour ago). dimensions System box structure.
- 24 Oct (box structure system session): stub tilt back to ≤ 1.9 mrad, k ≥ 3.1 N·m/mrad (DEFAULT, arm: the pitch guide that allowed 5 mrad is gone; alt 5 mrad); across load kept at 43.5 N (hub) over the arm's 40.7. dimensions System box structure.
- 24 Oct (box structure system session): the receiver pitch-guide couple (3.5 / 6.1 N·m) leaves the bay-body and stub cases and the guide posts leave the bay-body clearances (hub: the XT60 float takes ±2.37°, the latch drops its guide posts). dimensions System box structure.
- 24 Oct (box structure system session): insert keep-outs from the arm's swept meshes (PR 79); latch receivers at PR 69 258becf placed by tab line on Y_C (hub DEFAULT; alt receiver mid); box 82.1 L; funnel v8 ±x landings +11.5, posts clamp; v8 lane check committed (492.6 mm³, E); XT60 loads for bay / mast cases.
- 24 Oct (box structure system session): v2 layout visual, the four variants side by side from the concept meshes (`box_layout_v2_views.py`, artifact Mn5JGDkjEGSQXyPhjqrpxb); system file `nox/box/box_structure_v2.assembly.json` with both insert keep-outs (hub); bay bodies take the receiver inserts from below (latch PR 69); summary at Y_C 165.
- 24 Oct (box structure system session, box electronics): axle brake (3 relays), boot self-test (open-load flags, slow spreadCycle), idle = brake order; keep-alive to the face pins per the keep-alive concept; seat sense GPIO 24 (1 kΩ, BAT54, TVS) on the drone's 10 kΩ, needs ideal diodes (alt 2.2 kΩ with a Schottky); brake + seat wiring sheet; script rerun.
- 24 Oct (organiser): full pass 1: sweep 0 archived (all 9 nox sessions active); check_state clean; CLAUDE.md 12.8 to 11.0 KB (design list and session rules to one line each, detail moved to generative rule 0 and sessions.md, no meaning change); no new slim candidates; docs drift sent to owners.
- 24 Oct (box catch chat, Spark: "for all future designs when showing me an idea it should always a a visual not just words"): rule: every idea shown to Spark comes with a visual (artifact, source committed). CLAUDE.md Hard rules, `docs/generative.md` The rule 0 Visuals, review checks (concept mode + PR check 10), part skill reply.
- 24 Oct (box structure system session): **v2 at Y_C 165** (arm / hub; alt 138): funnel on the grip line, room for funnel v8 (±Y 11.5, C), box 81.4 L (C); arm round 3: stub ≤ 5 mrad (E, DEFAULT), bays located to the mast within ±0.15°, rail disc keep-out. New: the −Y funnel panel's bottom meets the carriage wheels at the drone insert (hub).
- 24 Oct (box structure system session): **v2 layout** (`box_layout_v2.py`): 9 bays at R 113 (C), Overseer 0 / −60 / −120 / −180 alternating (DEFAULT, alt arm's set), Y_C 138 (C), funnel Y 140 (DEFAULT, alt 177), room for funnel v8 at +Y (32.5, E: the Overseer set is lopsided), box 80.6 L (C), front sheet = service door (DEFAULT), access 18/18 (M).
- 24 Oct (box structure system session, box electronics): **head brake** (hub / arm ask): 2 DPDT 24 V relays (G2RL-2 class), one pole per coil, NC shorts each head-motor coil; bare ULN2003A from its own SKR pin, released 30 ms before the driver enables (never switched on a live driver); E-stop or power off = brake on. Overseer bench drop in Spark Tests.
- 24 Oct (swap arm worker): **swap arm v6 system pass** (supersedes PR 43 / 45), `swap_system.py`: concept FAIL x2 (XT60 mates free: 2.56° Scout, 3.47° Overseer vs ±1.06°, E), v7 follows. Shared L Swap row: + receiver pitch moment 3.5..5.5 N·m (E). v6 pieces, wheels, bushes DESIGN (head brake). DEFAULTs: dimensions System box swap: arm
- 24 Oct (box catch chat, hub: Overseer cartridge 171 vs the 168 opening): fallback worked out, not built: cut the collar bottom edge to seat z 7.85 (opening 181 at ±5° yaw + 3 a side, C); mouth, capture, centring and hook latch v2 unchanged, collar 69.4 tall, seat blocks and bay posts up 6.55, panel v8 rerun ~1 h. `box/box-funnel.md`.
- 24 Oct (box catch chat, hub: Overseer cartridge 171 vs the 168 opening): fallback worked out, not built: cut the collar bottom edge to seat z 7.83 (opening 181 at ±5° yaw + 3 a side, C); mouth, capture, centring and hook latch v2 unchanged, collar 69.4 tall, seat blocks and bay posts up 6.53, panel v8 rerun ~1 h. `box/box-funnel.md`.
- 24 Oct (box catch chat, hub: Scout v3 blocked): keep-alive through the hook latch plungers rejected (needs ≥ 5.5 travel along an 8 plunger, pad off the plunger at ±4.5 sideways, halls give no seat), DEFAULT: belly post + KW11 stay, pads move off the +y belly, Scout v3 places them (alt: hook latch v3 with leaf contacts). G (6), box-hook-latch.md.
- 24 Oct (box structure system session): **system pass v1** (`nox/box/box_system.py`, `box_structure.assembly.json`, `runs/box_system/v1/`): whole box, 18 cases, joint-loaded piece FE. FAIL: frames (1.65 Overseer catch), kb, mast, cradle_keel, jA, bay v4i; front sheet vs panels v7. DEFAULT (alts in dimensions): targets 0.5 / 1.0, sheet Y 347, top Z 220, probes off (floor), v2 on 9 bays at R 113.
- 24 Oct (box catch chat, hub: Overseer layout B): `catch_system.py` Overseer pack in / out (2850 / 2065 g, E): lands on all 8 wheels; plunger 33.7 N insert, 175 N hand lift; catch worst 0.91 (panel skin at the wheel, C). G (7) nodes 34 / 175 N both drones (DEFAULT, was 30 / 100; alt per drone). DEFAULT: boss 1.0 mm for flight / swap only (alt stiffer web).
- 24 Oct (box catch chat, hub): funnel panel v7: one preview per print file (`runs/funnel_panel/v7/preview_A`, `_B`, `_A_plain`, `_B_plain.png`, render_preview on each exact file), named in summary.md (PR 68 picture rule).
- 24 Oct (box catch chat, Spark: "for all future print ready parts i expect to see a picture of the part"): rule: every ready-to-print reply shows a picture of each print file (preview PNG per file, SendUserFile render). CLAUDE.md Hard rules, `docs/generative.md` Save and print, check in the `review` agent (6).
- 24 Oct (box catch chat): **hook latch v2 READY** on panel v7 skin 2.0 (v1 do not print). `catch_system.py`: plunger 28.3 N insert, 85.8 N hand lift (E loads), assembled worst 0.44 over plunger, guide, panel FE, bosses (C); `dimensions.md` System Box catch. Concept: belly hook and rim swing hook (clash 5.8 < 6.0) rejected. DEFAULTs: equal joint stiffness (alt panel FE); node cheeks 1.0 (alt 3mm).
- 24 Oct (funnel chat): **funnel panel A / B v7 + v7 plain READY**: skin 2.0 (C), latch window + 4 Ø12 bosses on the 4 seated-face panels, plain on the other 4; 80.0 / 79.9 and 75.1 / 75.0 g (M); plate FE 0.913 / 0.933 (C); collar 1 body, hook latch v2 fit 0 mm³ (C). The 3 printed v6 panels fail the gate: reprint as v7 plain (DEFAULT, alt keep).
- 24 Oct (workflow chat, Spark: "just use assumed numbers for all those"): strength / XT60 calibration tests dropped; coupons HOLD (files kept), `dimensions.md` T factors 1.0 (E) stand, Spark Tests line trimmed.
- 24 Oct (workflow chat, Spark: weight is a soft limit, never sacrifice design for weight): system_check `mass_budget_g` / `budget_g` never FAIL or change the exit code; System line keeps "mass <g> of <budget> g (<pct> %)" + "over budget (...)", report adds a WARN line.
- 24 Oct (workflow chat, Spark: "weight a soft limit, as low as we can, never sacrifice design for weight"): mass budget soft: reported + warned, never a gate; CLAUDE.md design list item 1, dimensions L, review check 7 (FAIL only if lightening broke a target), generative mass target.
- 24 Oct (workflow chat): **system_check v2**: `access` paths (swept cylinder / box / the part itself vs every part, ≤ 0.5 mm³, names the blocker), crash probes (infinite edge + r10 post, 12000 orientations, cage ahead ≥ 0 DEFAULT, ~6 s at 73k tris), `mass_budget_g` / `budget_g`; all gate.
- 24 Oct (workflow chat): **assembly.py**: one assembly file per system (`nox/<machine>/<system>.assembly.json`, system_check format + owner, version, source, moves), every tool reads it; seeded Overseer (cage v0), box catch (panels v6 + hook latch v1), Scout v3 skeleton; `nox/ASSEMBLY.md`.
- 24 Oct (workflow chat): **CI** `.github/workflows/checks.yml` on every PR: state, tests (topo stays local), solid_check on changed print/*.stl, log lines ≤ 400. `tools/pr.py merge` refuses on red CI, waits ≤ 15 min on pending. solid_check: noxopt-free voxeliser (contains fallback ran OOM).
- 24 Oct (workflow chat, Spark: an organisation agent that runs without me): **organiser** `docs/organiser.md`: every 6 h into the workflow session (tagged keep; fresh sessions lack the repo and session tools), light pass (sweep, check_state, board) + daily full pass (rules in one place, ownership, stale work, weight, log).
- 24 Oct (workflow chat, Spark: no status updates from running parts, one session reports every ~30 min): **quiet workers, one reporter**: hub = control session, digest every 30 min only on change, board refresh; `tools/board_data.py` + Nox Board dashboard; CLAUDE.md, sessions.md, /part, run-part.
- 24 Oct (workflow chat): **mass budget** in `dimensions.md` L: Overseer 2200 g (DEFAULT, alt 2330; structure ≤ 551 g), Scout v3 ≤ 500 g (DEFAULT, Spark set no target); system passes split slots `budget_g` per piece; review check 7 fails a piece over its slot.
- 24 Oct (workflow chat, Spark ok): repo slim: 46 retired runs, 741 MB of meshes, .npz and videos removed from the tree (history kept; `RETIRED.md` in each has the recovery `git checkout`); 29 runs kept (print sources, newest, inputs). PR chore/slim-runs; DEFAULT window (c) 1 h not 48 h.
- 24 Oct (test coupons): post pull, layer pull, glue lap v1 + socket v2 READY (solid PASS); predicted via nox/topo FE: posts 37.7 / 13.3 N, layer 326.8 N; `docs/tests.md`, `tools/calibrate.py`, `dimensions.md` T. DEFAULT copy B at 4 walls 15 % (alt 100 % only).
- 24 Oct (workflow chat, Spark: clean up sessions whose use is over, autonomously): `docs/sessions.md` lifecycle + sweep rules; CLAUDE.md rule; 10 finished idle sessions archived; scheduled sweep every 6 h (fresh session). DEFAULT idle 6 h before archive (alt 24 h).
- 24 Oct (workflow chat, Spark: light, compact and accessible, cage first, balanced, mounted for what it carries): CLAUDE.md **Every drone design** ordered list 1-9 (6-9 added DEFAULT: sensor modes, breaking order, air / view / wiring, fits the box); `dimensions.md` L standard cases + targets; generative rule 0 mount rule; review check 4.
- 24 Oct (workflow chat): **system_check.py**: one manifest of the assembled system (parts, poses, roles, openings, contact pairs) gates cage first (≥ 3 mm, 0 in openings), fit (≤ 0.5 mm³/pair), CG ≤ 3 mm off thrust axis with and without swap parts; reports bbox, extents, mass; System line.
- 24 Oct (workflow chat): **workflow v2**: root `README.md` (map + session prompts); `tools/check_state.py` (print files, orphans, cell / log length, branches); CLAUDE.md rules compressed, step 6 one rule one place; concept check + three strikes DEFAULT (`docs/generative.md` 0; alt: none); `review` concept mode.
- 24 Oct (control chat, relayed from the scan stick chat, Spark: "use the most compact design possible ... compact is the way to go never just stack things together"; "confirm all parallel sessions any main session controls is always up to date"): **compact by default** (`CLAUDE.md` hard rule, `docs/generative.md` rule 0 Compact layout: the system pass minimises assembled bounding volume and largest extent, reports both) and **children stay in sync** (`CLAUDE.md` hard rule: a controlling session sends every decision and rule change to each live child the same turn, children merge `origin/main` each step, the controller checks each child's state before reporting, finished children are archived). Text as written on `claude/zen-mccarthy-vqak7h`.
- 24 Oct (scout v3 chat, Spark: "this design seems very flimsy, for all future designs for all it needs to be as structurally secure while light as possible but all drones need to have a full cage meaning in all contact points the cage should be touching first"): **new CLAUDE.md hard rule "Cage first, strong and light"** and review check 4. Every drone: full cage top, sides, bottom; the cage touches first in every direction (support check, cage ahead ≥ 3 mm DEFAULT; alt 1 mm); box openings recessed behind cage members; cage layout from an optimisation on the system load cases.
- 24 Oct (control chat, Spark: "make sure the entire ground station system is being worked on with no overlapping"; "new arm design here"; "new latch system for all batteries so the grabber can follow it"): **box owners, no overlap**: the control session owns Box swap = arm v5 + heads / grabber + the battery latch and cartridge as one standard for every pack (drone receiver and every bay, Scout and Overseer); the box swap arm session is stood down. Box structure owns bay module bodies (latch block from Box swap), box electronics and the whole-box model; box catch keeps funnel and hook latch; Scout v3 and Overseer keep where the receiver sits on their drone. Handoffs into Box swap: PR 43 (hub / heads v6), PR 45 (detent + sweep), the receiver v4 / cartridge v4 latch parts of PR 44.
- 24 Oct (control chat, Spark: "all parts that are ready or being made" ... "sessions can still run topology in their own chats"): **system first, revised**: (1) every READY, BUILT, HOLD and DESIGN part gets the assembled recheck now (was: from the next version on); a READY part that fails goes back to DESIGN, do not print; PRINTED / PRINTING parts are reported and fixed in their next version. (2) The system pass writes each piece's requirements (envelope, interfaces, joint reactions per case, stiffness and worst index for the assembled strength) to `dimensions.md` "System <name>"; each piece then runs its own `topo` in its own session with those parameters; no engine assembly mode needed (removed from `nox/topo/README.md`). Owners per system in `current-parts.md` System recheck; new sessions for box swap arm and box structure. `CLAUDE.md`, `docs/generative.md`, `/part`, `run-part`, `review`.
- 24 Oct (control chat, Spark: "think about the whole drone or thing as a system ... then cut it into its individual pieces"): **system first, then cut**: every design models the assembled system (all parts and bought parts in pose, system load cases, load path through the joints), lays out and checks strength on the whole, then splits it into printable pieces with joints drawn at low-stress cuts; checks report the assembled result. `CLAUDE.md` hard rule + step 5 (a system session owns its pieces), `docs/generative.md` The rule 0 + System line in the ready block, `/part`, `run-part`, `review` (new check 3), `nox/topo/README.md` assembly mode wanted. DEFAULT: until `topo` has an assembly mode, a system solve over the whole envelope sets the cuts and each piece takes its joint reactions as loads (alt: wait for the engine mode). DEFAULT: applies to designs merged from 24 Oct on; printed and READY parts stay until their next version (alt: re-check every READY part now).
- 24 Oct (overseer arms chat, Spark): **Overseer cage v0** (`nox/overseer/layout_v2.py`, `runs/overseer_layout/v2/`): "the lidar on the cage, not out from the body", "cage first, it must fit in the funnel", "3 mm rods whenever we can". 36 rods of 3.0 carbon, 6.69 m, 74 g (C): two octagon guard rings 12 off the disks on arm-tip spokes, a front V to the L2 apex node (L2 body the only thing ahead of the cage), a wheel ring with 4 corner nodes in the funnel; camera on three 3.0 rods. Balanced: motors 52.1 ahead, catch 30 aft (C). Funnel 2.9, plungers 2.0, guard 12.0 (C). ~2.33 kg (E; v1 2.54). DEFAULTs: L2 normal 90° mode kept clear (alt negative-angle mode, L2 ~20 further out, E); every node PETG, TPU feet only (alt TPU rear and side ring nodes); rings at prop -14 / +10 (C); thicker carbon only where 3.0 cannot carry (none yet).
- 24 Oct (control chat, Spark: "never wait on something queued unless it needs the other things done first"): **parallel by default**: independent work (runs, parts, checks, research, reviews) goes to separate workers at once, worktrees for anything that commits, sibling cloud sessions when the box is full; only a real dependency waits. `CLAUDE.md` hard rule, `docs/generative.md` Heavy runs (several runs per box inside one 75 % memory budget, was one run per box), `run-part` and `/part`. DEFAULT: the box's memory budget is split evenly over its runs (alt: one run per box, the rest in sibling sessions).
- 24 Oct (topology control session, Spark: "make this the new default"): **`nox/topo` is the default engine** for every generated part, organic finish on (smooth round members, fillets; only holes and contact faces geometric). Final engine merged from `topo/new-engine`: mounting features stay whole, held ties, gate member 6.25 mm, sliver-free build. Final organic runs, all solid_check PASS (M): holder organic-v11 11.73 g, worst 0.493 (battery channel edges r 3 mm, Spark); bracket_jA organic-v5 36.85 g, same-grid 0.127 (v8 38.37 g, 0.133); bar_half organic-v2 74.94 g, same-grid 0.833 (v8 77.58 g, 0.929); motor_mount organic-v2 18.03 g, 0.122. `docs/generative.md`, `CLAUDE.md`, `/part` and `run-part` now point at `nox/topo`; `noxopt` is kept for old scripts only.
- 24 Oct (arm-mech worker): **arm v5 rails A / B v1, V-wheel v1, pinion16 v1, eccentric bush v1 READY** (`nox/box/arm_v5_cad.py`, `runs/arm_rail/v1/`), solid_check PASS on all 5; layout changes forced by checks (`runs/arm/v5-layout-b/`): rail top 94 → 93 (0.0 under the plate), rail to post = 1 x M5 per post from the top at X 0 into a hub-post insert (inner posts have no bolt access from below), ribbon channel centred (1.0 wall), drone insert +6 → rack web u −47, carriage wheels and plate 6 inward (u 4 / 32 / 18, plate u 0..40: the push had put the wheel rim at r 147.3), bush boss r 8.6 (3.0 wall), park hard stop on the rail (box electronics v1) and rail start r 27. DEFAULTs: rail body full depth Y 74..93 (alt: foot-only bottom, 3.1x less stiff); wheel bearings press + epoxy with no centre lip (alt 12-wide wheel with a 2.0 lip); printed eccentric bush (alt OpenBuilds spacer); grub tapped in PETG (alt M3 nut trap). Loads E: carriage couple 6.39 N·m (rack plane), 228 N per outer wheel, Hertz 60 MPa (0.66). Open: the −45° detent spot is closed by the longer rack tail (next PR).
- 24 Oct (box electronics worker): **box electronics v1 designed** (`nox/box/box-electronics.md`, `box_electronics.py`, `runs/box_electronics/v1/diagram.html`): LRS-350-24 on the rear sheet (the kb floor spot is 64 x 40, too small), fuse box, E-stop on the motion branch, keep-alive 13.0 V CC 3.0 A through relay K1 + INA226 to the pogo pads, Pi 4 (Klipper host + `boxd`), PCA9685 for 4 latch + 2 gripper servos, SKR for the 3 steppers, 2 live bays through relays with INA226 mate checks (bay mate = bus 13..17 V relay open), state machine with 11 aborts; board placement by annealing, 296 W peak (85 %, E). DEFAULTs: one 6.0 V servo rail (alt 6.8 V grippers + 5 V latch); Pi 4 (alt Pi 5); iCharger 456DUO class on 24 V, input limit 6.5 A (alt 2 x ISDT PD60 started by hand, or an LRS-600 for the charger); live bays −90 / 180 (alt any Scout bay); electronics on the rear sheet (alt a printed tray); no driver fan (alt the 4010 if the soak test runs hot). `dimensions.md` I "Box electronics v1"; `box-wiring.md` rail 6.0 V and fixed tails 164 / 311 / 276 (was 250 E).
- 24 Oct (overseer arms chat, Spark): **Overseer layout v1**: L2 turned 105° (axis 15° below +x) at the nose, base (352.8, 0, 49) (C), all of the drone behind its field in both modes; balanced (CG 0.1 off the thrust centre, E) by printed arms that carry the motor square 76.5 ahead of the plates plus the catch 30 aft (C, DEFAULT; alt a counterweight, or keep the L2 on top); front arms 34 wide, 38 deep, ~164 Hz (E); follows the box chat's hook latch: no steel plate, R 5 wheels, legs from the arms hang to z -40 (C) and the ±y ones knee clear of the plungers (2.0, C); cartridge hung to keep its seat height (CHECK vs the Scout); front camera at the horizon behind the L2 (alt 30° up, O Camera). 607 long (C), ~2.54 kg (E). v0 review notes folded in.
- 24 Oct (box chat, Spark: "a hooked latch, not a steel belly, no magnets"; "a bit more error tolerance"): **hook latch v1 READY** (`nox/box/box-hook-latch.md`, `hook_latch.py`, `runs/hook_latch/v1/`): 4 PETG plungers (8 x 12, out 12, 2.0 lead-in) slide out of the two seated collar faces 1.5 uphill of the catch wheels at x ±100; the XT60 push lifts the drone 2.12 (C) onto them and the wheel loads them across their travel, so they hold with the servos off; a hall switch per plunger reads out. Tolerance (swept, C): wheel −2.5 .. +1.0 along the slope with 0.5 rise clearance, ±4.5 sideways (first draw 0 .. +1); a wheel past +1.5 stalls the plunger and the swap aborts. MG90S + scotch yoke (r 13, ±27.5°, the lightest of a 20-case servo-pose search); housing A / B 23.7 g, plunger 3.9 g (M); solid_check PASS on all 3; 0 mm³ moving overlaps, bolts reachable, 0 mm³ vs the panel bosses; index 0.49 misuse / 0.24 functional (hand calc, E). Review fixes: round 3 (walls under 2.0 at the hall recess, magnet pocket and yoke pocket), round 1 (blocked bolts, 0.95 ear-hole webs now open slots, plunger pocket walls, held wheel height vs plunger top, Ø12 panel bosses), round 2 (valley-row bosses into the guide block, now at u ±18.5; the lead-in does not move a seated wheel, so the claimed band was cut to what holds and a hall switch added). Electromagnets + steel belly plate retired. Shared: Catch interface (6) no steel plate, new (7) latch zone (no corner post straight up from the ±y wheel nodes) and 30 / 100 N on those 4 wheels; drone insert stroke up to +6 (E, arm session); pogo pins ≥ 6 travel (E). Needs funnel panel v7 (spec in the part doc; the 3 printed v6 panels go on the unlatched faces). DEFAULT: plunger through the face (alt: a belly hook on a post, needs a drone feature and room in the swap opening; a swinging rim hook hits the upper cage ring when it opens). DEFAULT: out-sensing by a hall switch + Ø3 x 2 sense magnet per plunger (a sensor, not a hold; alt: a microswitch per plunger tripped by a ramp on the plunger side).
- 24 Oct (overseer arms chat, Spark): **Overseer layout v0** (`nox/overseer/layout_v0.py`, `runs/overseer_layout/v0/`): no cage, all electronics between the plates (FC stack centre, Pi deck over it, PDB rear wing, UBEC / buck / RX front wing, ESCs under the arms), L2 on a mast (base z 125 so the props clear its -6° cone), pack centred under, down camera + flow in pods beside it. DEFAULTs: catch wheels hang from the arms (alt belly ring); front camera props in its lower corners masked (alt 45° tilt). All clearances pass; ~2.12 kg (E). Spark: top plate arm holes 30 apart (P); wheelbase still 486 CAD vs 500 listing.
- 24 Oct (scan stick chat): **scan stick cam v7** READY `print/scan_stick_cam_v7.stl`: 4 Ø9 x 10 (C) standoffs with Ø3.2 (E) through holes for M2.5 inserts (Ø9 on the mesh from z 6 to 16, M), generated web in a 6 thick (C) plate layer only, 13.35 g (M; v4 12.5), worst 0.32 (F) in the 50 g E impact, solid_check PASS, assembly fit 0 mm3 (M) for every pair. v6 stopped because its 4 mm layer was under the engine's 4.53 mm (M, run log) robust plate (eroded design in 6 pieces, M); v5 (13.0 g M, gate PASS) was not saved because its web wrapped the posts; bracket screws now M3 x 12 (C). DEFAULT: 6 mm plate; alternative: a 4 mm plate with a drawn web (no optimisation). Cam v4 superseded, kept in `print/` and marked do-not-print in `print/README.md`.
- 24 Oct (overseer arms chat): **S500 plates found: Holybro S500 V2 STEP is the same S500 moulding** (arm 234 x 42 = generic spare arm 233 x 40; top plate holes match a Printables S500 plate). STEP + `nox/overseer/s500/s500_cad.py`: plate gap 17.94, top 120.5 sq x 1.6, bottom 196 x 118 x 2.0, per arm 3 x M2.5 top (u 63.17 v ±15, u 34.66) + 2 bottom (u 63.74 v ±10) + 2 Ø6 pegs, motor r 243.2 (486 wheelbase, not 500). Printed arm: 395 (46 shorter per arm), root 45, M3 inserts, inner tongue dropped DEFAULT (alt keep it, lower the Pi deck); modes 18 / 32 / 45 root: 93 / 160 / 223 Hz (E). dimensions O + M, Q7 closed but a tape check.
- 23 Oct (scan stick chat): **rule: ready to print = a slicing prompt** (Spark): every reply that calls a file ready to print ends with a filled-in, ready-to-paste prompt for a laptop slicing session (template in `docs/generative.md`, Save and print; line in `CLAUDE.md`). DEFAULT: the prompt slices and reports, sends to the printer only after Spark says go; alternative: it sends straight away.
- 23 Oct (overseer arms chat, Spark): **S500 identified: AliExpress "S500 ... Frame Kit PCB Version With Carbon Fiber Landing Gear"** (item 2251832276919319). Listings: 500 wheelbase, 454 g with gear, motor holes 16 / 19 / 25, carbon rod in the arms, PDB pads on the centre plate. AliExpress specs blocked by captcha; no seller or CAD gives the plates: outline, arm bolt holes, thickness and plate gap stay Q7 (calipers). `dimensions.md` M S500 row, O Frame.
- 23 Oct (overseer arms chat, Spark): **S500 is the 2015 edition; arm roots made tall so the hub between the plates holds the Pi 5 and electronics.** Wheelbase 395 at 25 tip gap (C; floor 359, alt 380 at 15), 53 shorter per arm than 500; root 45 tall DEFAULT (alt 32, one deck): first bending ~209 Hz vs 92 at a stock 19 root (E, `nox/overseer/arm_reach.py`); hub grows down, top plate stays. `dimensions.md` O Frame + Arms and hub, Q7 lists what to measure.
- 23 Oct (box chat): **box re-sized for the XT60 swap** (Spark: XT60 back, pads retired): every swap mates and unmates the pack's XT60 on the install axis, insert 60 N / pull-out 50 N (E; Amass 18 to 44 N, D17 to measure; were 15 to 20 N); mating half = XT60E1-M on a ±1.0 float carrier in the drone receiver and every bay (the shoes go); hold ≥ 85 N: DEFAULT 4 x P20/15 on a ≥ 3 mm steel belly plate (alt: hooked latch on the post, no steel); heads: last 12 of an insert slow at 2 A on the 16T (1.2x stall margin; alt 12T pinion); gripper spring ≥ 15 N per finger (was 8); carriage, heads, bay module and stand cases to 60 / 50 N; catch interface (5) now a 50 N pull on two wheels (shared, was 15 N push); bays charge through the XT60 with the relay open; swap ~3.7 s (was 3.1). `dimensions.md` D17, G, I "XT60 mate", J, M; `box.md`, `box-arm.md`, `box-case.md`, `box-stand.md`, `box-wiring.md`, `parts-list.md` (3 x XT60E1-M, 2 more magnets, steel plate to buy). No geometry drawn: the bay module and arm v5 sessions draw it.
- 23 Oct (session cost chat): **`.claude/settings.json` tidied**: allow list cut to blanket tools (the 11 `Bash(...)` lines were covered by `Bash`), added Write, Glob, Grep, NotebookEdit and the GitHub, Gmail, Drive and Docs connectors (Spark: sessions keep as much access as possible); merge rule names `tools/pr.py merge`. Session start ~73k tokens (E), repo share ~2k (E); settings are not in context, so 0 tokens saved.
- 23 Oct (briefs chat, Spark): **XT60 back, contact pads retired** (dimensions C / E / J); Scout no weight target, ~500 g; both fly in Position; no MAV_SYS_ID set; Overseer generic S500, printed arms ~395 wheelbase (E) DEFAULT (alt: stock arms); camera 30° up.
- 23 Oct (briefs chat): **Scout v3 and Overseer scope briefs filled** from the record (`nox/scout/v3/README.md`, `nox/overseer/README.md`): job, what stays, priorities, done-when, parts order, open questions; Spark-dated lines are his, the rest DEFAULT.
- 23 Oct (lidar chat): **Overseer cameras: 2 (front + underside), lidar coloured by yawing the drone** (Spark). L2 top-mounted kept (collar opening, landings, scan stick match). Front camera portrait 30° up DEFAULT (alt 45°: reaches the zenith, worse forward view); a fixed ring would need 5 at 27° up (+1 up) with 10 % overlap (E, 4:3 assumed). Underside camera colours almost no lidar points. `dimensions.md` O Camera, `parts-list.md` camera qty 2.
- 23 Oct (scan stick chat): **scan stick base v17** = the v7 nox/topo layout (finish drawn, 25 cm3 E, h 2.0 C) rebuilt with the exact cuts, a Ø40 C thread boss (the Ø32 C boss left a 0.14 mm M feather at the Ø36 C tube step in v8-v11) and the review fixes of PR 22 (round 1: a drawn 5 mm C Pi tray plate with Ø8 C standoffs, UBEC bay x ±14 C so it no longer cuts the -Y rail; round 2: the switch strip beside the tube with the rocker, button and LED bodies cut free behind it, M4 insert holes Ø5.6 x 9.5 C for Ruthex M4 x 8.1 (spec) on a 4.5 mm C floor, bore top at z 154 C; round 3: strip to y ±44 C, LED at y -39 C, 4.25 mm M between the button and LED holes): 340.1 g (M; v12 300.1), worst 0.26 (F; v12 0.56) in the 50 g E pack impact, 67 cases (E) incl. 100 N side hits and a 150 N drop (E), solid_check PASS, READY `print/scan_stick_base_v17.stl`; cradle v1, v12, v15, v16 retired. Lessons: `Part` widens the envelope by the drawn bodies, so exact drawn bodies swapped in at a rebuild need the exact envelope = layout envelope + exact drawn or they are clipped (v13 / v14); a cut through a plate is measured against what sits behind and beside it on the mesh (v15: 0.7 mm M of tube wall; v16: 1.25 mm M between two holes). The scan stick set is complete: base v17 + head v13 + cam v4 + thread test v1, 395 g (M) on the unit; `assembly_view.py` fit check 0 mm3 (M) overlap for every pair incl. bracket x board. DEFAULT: the engine's pre-export body count (4, M) is reported in the summary, the gate on the exact file (1, M) rules; alternative: a v18 with the boss / tube step moved off the grid.
- 23 Oct (scan stick chat): **scan stick head v13** (nox/topo v8 layout: finish drawn, 12 cm3 E, h 1.5 C, bolt flange to the base, impact cases E; rebuilt with the Ø10 C flange cable hole, Ø6.0 C pad counterbores for a 3.0 mm C wall, Ø5 C key holes through the arms above each M4 pocket, and the camera block 34 x 10.5 x 30 C with its Ruthex M3 (5.7 long, spec) insert holes 7 deep C at z 6 C: 3.3 mm M from the M4 pockets and below the pad driver clearances, reviews of PR 22): 42.0 g (M), worst 0.30 (F) in the 50 g E lidar impact, solid_check PASS, READY `print/scan_stick_head_v13.stl`; bolts on turned -90° (C) so the camera hangs over the Pi side from the block's bottom (board centre world z 142 C); the M4 x 12 go in sideways between the arms (18 mm M of room) and a 3 mm C key reaches them from the top; screws M4 x 12, M3 x 8 into the L2, M3 x 10 for the bracket (C). History: v2 noxopt 61.9 g (M) with no gussets, v4 organic FAIL, v5 keep-out sheet, v6 hung in Pardiso on the coarse grid, v7 a 1.5 mm C hole floor (lesson: blind insert holes leave ≥ 3 mm C), v8 40.8 g (M), v9 2.9 mm C pad wall, v10 4.5 deep C camera holes, v11 holes 0.5 mm M from the M4 pockets, v12 the -X hole inside the 112.5° pad's Ø9 C driver clearance (lesson: every new cut is probed on the mesh against every pocket and clearance round it, both sides).
- 23 Oct (scan stick chat): **scan stick cam v4** (nox/topo, finish drawn, 5 cm3 E): 12.5 g (M), worst 0.28 (F) with the impact cases, solid_check PASS, READY `print/scan_stick_cam_v4.stl`. v2 (organic) failed on necks and 0.96 (F); v3 failed on Ø8 (C) posts at the 2.0 mm (C) drawn erosion (lesson: a drawn post needs ≥ 4.3 mm (C) wall round its hole, so Ø12 (C) round M2 / M3).
- 23 Oct (env check): **Claude in Chrome handoff** (Spark): a GitHub action a cloud session cannot do goes to Spark as one paste-ready Claude in Chrome prompt (CLAUDE.md Git).
- 23 Oct (env check): **`noxopt._voxelise` casts its Z rays in chunks of 20k**: all 425k rays of bar_half v8 at pitch 0.25 in one call took over 14 GB and was killed; now `solid_check.py` peaks at 2.45 GB (P) and bar_half v8 passes at the default pitch. Voxels identical to the old code on 4 parts (P); every file in `print/` rechecked with the same results (31 files, 25 PASS, the same 6 FAIL); `test_noxopt.py` PASS.
- 23 Oct (scan stick chat): **scan stick head v2** topology run (`run/scan_stick-v2`, `head_topo_run.py` h 1.75 (C), 20 cm3 generated (DEFAULT, E)): 61.9 g (M) vs 86.8 g (M) drawn, worst 0.03 (F) in the 25 g (E) lidar knock, solid_check PASS, 35 min / 3.5 GB (M); far over-strong, next run at 10 then 6 cm3 (E).
- 23 Oct (scan stick chat): **scan stick assembly visual**: `nox/overseer/scan_stick/assembly_view.py` builds the motion artifact (`runs/scan_stick/assembly/motion.html` + mp4 / gif / png; the folder moved from `runs/scan_stick/v2` with the one-piece layout) of every printed part on the pole with the L2, camera, Pi 5 and pack as context (sizes spec / P / E as tagged in the script).
- 23 Oct (scan stick chat): **scan stick v1** (`nox/overseer/scan_stick/`): the Overseer's L2 + DECXIN camera + Pi 5 + 4S 6000 on the EXTEND-A-REACH 3/4-5 ACME pole; printed head (ACME female thread, L2 pads, camera block), thread test ring, camera bracket, Pi / pack cradle; `pi/` recorder (ROS 2 bag or pcap + video, button + LED). DEFAULTs: lidar up-facing (Overseer L2 is top-mounted, section O; `lidar_facing="down"` exists), pole lower tube OD 25.4 (E) until measured, 12 V (spec) buck for the L2, 25 g (E) misuse loads for the v2 topology run; head rear notch removed after review. `dimensions.md` section S, `parts-list.md` Scan stick, `cloud/setup.sh` installs openscad + xvfb.
- 23 Oct (env check): `tools/pr.py merge` waits up to 20 s for the repo's auto-delete before reporting the head branch (it said "left on origin" for PRs 6 and 15, whose branches were deleted seconds later).
- 23 Oct (env check): **solid_check backlog run on every file in `print/`** (27): PASS stub v3, sun post v1, idler ends A / B v3, 4 fingers v4, mast v6, cradle_keel v6, kb v7b, toe v7b, bar_half v8 (pitch 0.3: 0.25 peaked over 14 GB and was killed, P), frame_mid v6, frame ends v7b, post_seg v7, brackets jA v8 / jB v7 / e v7c. **FAIL: hub v5 (1.0 wall, the bore film), detent ring v1 (2 necked blobs), detent arm v1 (1.5 wall), pinion v4 (2 eroded bodies), bay module v4i (necked blob)**: those rows go back to DESIGN, files kept, "do not print"; belt clamp coupon set is 3 loose coupons (HOLD, unchanged). DEFAULT: the swap arm set row split into its passing parts (READY) and the failing ones (DESIGN); alternative: one row at DESIGN.
- 23 Oct (engine check): **lidar mount row added (Overseer, DESIGN, not started)** so it is generated with the new `nox/topo` engine, not `noxopt` (Spark: lidar mount must use the latest engine). `topo/new-engine` not merged yet: beats v8 on bracket_jA and bar_half, solid PASS on every round 2 part, but the default organic finish has run on bracket_jA only and `/part` + `run-part` still name `noxopt`.
- 23 Oct (arm-v5 chat, Spark: no 2040 bars): **arm v5 layout** (`nox/box/box-arm.md` v5; `nox/box/arm_v5_layout.py`; `runs/arm/v5-layout/`): printed V-rails on hub v5's posts, 3-wheel carriages (printed V-wheels on 625ZZ, one eccentric), 16T m1 pinion per head motor on a 71 rack in the head; bars, belts, idlers, idler ends, T-nuts, head 20Ts and glides out; motors v5 A (53.5, 55) / B (−55, −53.5) / axle −39° (10.1 g·m E), every 2D gap ≥ 1.0 over the stroke, detent re-placed at −45° (candidate, ring unchanged); compaction C1 / C2 = Y_C 138 / 118, enclosure 403 → 366 / 346 (Spark section, Decide); dimensions I rows; found: the v4 axle shaft tip runs through the detent anchor post (box-arm Problem 24); artifact "Nox Box Mechanism" v4 / v5 / v5-compact.
- 23 Oct (env check): **PR 5 (docs/session-reads) brought up to main** (merge, no rebase): CLAUDE.md = PR 5's slim form + main's newer facts (`tools/pr.py` open / merge, review then self-merge, never wait on Spark, `/part`, amazon-parts, GraphQL 403, no LFS); `nox/README.md` gone (its cloud lines are in CLAUDE.md, the rest in `docs/generative.md`); **`nox/parts-list.md` kept** (DEFAULT: the amazon-parts skill writes its status words there; alternative: fold it into `current-parts.md` Spark section as PR 5 had); `print/latest/` dropped as PR 5 had (the `/part` skill now points at `docs/generative.md` Save and print).
- 23 Oct (cloud check): `cloud/setup.sh` now also installs the amazon-parts MCP deps (`mcp`, `httpx`), so the Nox environment snapshot has them; fallback smoke check (script run outside the repo, as when pasted) no longer imports pypardiso without noxopt's MKL path, which aborted the script; tested both ways, exit 0 (P). Spark creates the "Nox" environment (cloud sessions cannot create one) and pastes the script.
- 23 Oct (cloud check): PR 11 merged by Spark (a cloud session may not merge a PR that touches `.claude/`). Branch deletion is refused from cloud boxes both ways (`git push --delete` and REST DELETE ref, 403), as is the repo-settings write that would turn on auto-delete: `tools/pr.py merge` tries the delete, checks the branch and prints the true outcome; Spark turns on "Automatically delete head branches" once in the repo settings (Settings -> General). Stale `tooling/cloud-fixes` branch left for that.
- 23 Oct (cloud check): first Claude Code cloud session on the repo, checked end to end: attach + clone + push OK, `cloud/setup.sh` 2.5 min (P), `test_noxopt.py` PASS 61 s (P), hook 2 s with packages present, ffmpeg + Chromium + three.js present, box 4 cores / 16 GB / 30 GB (P). Found: cloud boxes block GitHub GraphQL, so every `gh pr` subcommand fails (403, `create` and `merge` included); new `tools/pr.py` opens and merges PRs over REST (`gh api`); CLAUDE.md step 4, `/part` steps 5 and 6 and `run-part` step 6 name it. LFS steps removed from `cloud/*.sh` (no-LFS rule). README: the "Nox" environment does not exist yet (only Default, no setup script); every session must be started on the repo. A cloud session cannot edit `.claude/` files itself (auto-mode classifier); the `/part` step 6 line went in as a PR suggestion Spark clicked.
- 23 Oct (connector chat): **no Spark gates** (Spark: automate every restriction that can be): `.claude/settings.json` defaultMode bypassPermissions, allow Bash / Edit / WebFetch / WebSearch / amazon-parts, deny force-push, auto-mode rules for merging any PR after review or self-check, AskUserQuestion auto-continues after 60 s; CLAUDE.md step 4 + "Never wait on Spark" (was "Ask Spark"), README rule, `/part` steps 1 and 6. Sessions still do not spend money or delete work on `main` alone.
- 23 Oct (connector chat): **`tools/amazon-parts-mcp/`** + root `.mcp.json`: the `amazon-parts` MCP server (parts catalog per build by ASIN, one-click Amazon cart links, order log; PA-API and Amazon Business ordering optional, off by default). `cloud/session_start.sh` installs its two packages; skill `.claude/skills/drone-parts/`; `catalog.json` seeded with scout, overseer, box.
- 23 Oct (workflow chat): **sessions merge their own reviewed PRs**: `.claude/settings.json` allows `gh pr merge` / the REST merge call and tells the auto-mode classifier a merge after `review` PASS is expected; CLAUDE.md step 4, README Split the work, `/part` step 6 updated. Spark merges only what a session could not.
- 23 Oct (workflow chat): **`nox/motion.py` + `.claude/skills/part/`**: generic motion artifact (any meshes + a pose function or frame list -> one HTML file (meshes embedded, three.js from the CDN) with scrub / views / groups / printed-only / exploded / readout strip, and headless mp4 + gif + png via Playwright Chromium + ffmpeg; replaces per-part artifact pages) and the `/part` skill (one prompt from brief to Done = saved + motion artifact + PR). `cloud/setup.sh` now installs shapely (print_orient needed it), fast_simplification (arm artifact needed it), playwright, and caches three.js from npm (the CDNs are blocked in cloud boxes). Smoke test in this box, output not committed (tool test, not a design): hub v5 (207k faces, M) + detent ring / arm + pinion, 0.67 MB page (M), 180 frames (C), 113 s incl. video (T, measured in the box).
- 23 Oct (docs chat): **model and effort per agent and session** (PR docs/session-reads, Spark): `run-part` sonnet medium, `review` opus high (agent frontmatter); `.claude/settings.json` default model opus with per-model effort (opus / fable high, sonnet medium, haiku low); `CLAUDE.md` table says which model and effort each kind of session runs on.
- 23 Oct (docs chat): **session reads cut to the minimum** (PR docs/session-reads, Spark's keep-or-drop pick): `CLAUDE.md` = session loop + 5 hard rules + where things are (2.4 KB); `nox/open.md` and `nox/parts-list.md` folded into `nox/current-parts.md` (rows + a Spark section; open-item numbers retired); `docs/printing.md`, `docs/rules.md`, `docs/workflow.md` folded into `docs/generative.md` and `CLAUDE.md`, then deleted; `print/latest/` dropped (DEFAULT on Problem 52: `print/` + the File cell is the source); `claude/` kept as a citation only; `dimensions.md` numbers untouched.
- 23 Oct (docs chat): **session reads reorganized** (PR docs/session-reads): `CLAUDE.md` cut to the session loop, a "read when you need it" table and the hard rules; the rule book `nox/README.md` split into `docs/` (`rules.md`, `workflow.md`, `generative.md` incl. the old `nox-generative.md`, `printing.md`, `README.md` map); `nox/current-parts.md` rewritten to current facts only, Scout v2 rows frozen in `archive/scout-v2/current-parts.md`; open problems + Spark questions moved to `nox/open.md` (new Problem 52: `print/latest/` is empty); `dimensions.md` title and headings stripped of history, rows unchanged; `nox-print-log.md` renamed `print-log.md`; `dubhacks-queue.md` archived; `cloud/PROMPT-migrate-docs.md` and the 16 Oct bundle manifest deleted; every live pointer updated.
- 22 Oct (parts chat): **`nox/parts-list.md`** (every part of the box, Scout and Overseer, bought + printed, with status) and **`dimensions.md` section M** (mounting holes and sizes of every bought part, web research, spec / listing / CHECK; sources `claude/research/2026-10-22-mounting-dimensions.md`). Close conflicts applied to rows A (FC 36 x 36, motor shaft Ø3) and O (FC holes); the rest are open questions Q1..Q20 in M, settled when a mount needs them (Spark 22 Oct).
- 22 Oct (repo reorg): **Scout v2 retired to `archive/scout-v2/`** (docs, scripts, `s2_*` print files); Scout v3 starts in `nox/scout/v3/`, Overseer development in `nox/overseer/`; box docs into `nox/box/` unchanged; `current-parts.md`, `dimensions.md` and this log moved up to `nox/`; box funnel doc + scripts into `nox/box/`. Older lines keep their old paths.
- 21 Oct 03:10 (layout chat): **cage v13 finish v2** (Spark 23:41 "much smoother"; `v2/s2-layout.md` Finish pass v2; artifact "Scout v2.1 Layout" v15): fillet 2.0 / round 0.9, field low-pass 0.8 (generator contours gone), exact sockets + foot pads blended back, rounded 0.5 off keep-outs, hub as one field from 25 tiles; all 17 pass the current solid check, index ≤ 0.44, 100.0 g, cage ~152 g E; collar 0.70, arm 0.55, head lane 0.64.
- 20 Oct 22:45 (layout chat): **cage v13 finished** (Spark 22:16: smooth every node, one body, no sharp edges; `v2/s2-layout.md` Finish pass; artifact "Scout v2.1 Layout" v14): SDF pass per part (fillet 1.0 in, round 0.6 out, rounded blend into keep-outs, bores / pad holes / foot faces re-cut exact); tail knees + rail sleeves rerun with the skeleton (rail sleeve glove socket at tip 7, side glove rods 110.4); all 17 pass the current solid check, index 0.12..0.40, 101.6 g, cage ~154 g E; collar 0.64.
- 20 Oct 20:50 (layout chat): **cage v13: thick drum + flat feet** (`v2/s2-layout.md`; artifact "Scout v2.1 Layout" v13; Spark 20 Oct: thicker topology parts round the prop guard, rods stay 3.0; 20:23: flat feet that fit the funnel): drawn skeleton + socket sleeves + 3.0..4.2 members on the 8 columns and hub (ring r 36 x 6 x 6), 4 flat pads (bottoms z -52, stance 100 x 78) on the nose legs and sled tails with a 6 g landing case; 13 of 17 parts pass the current solid check incl. the neck test (tail knees, rail sleeves still v12); 101.2 g printed, cage ~153 g E; clearances held (collar 0.39, arm 0.54, lens 0.32).
- 20 Oct 18:40 (kb chat): kb v8 topology run 1 **not shipped**: solid PASS, 158.7 g, but FE 0.096 vs v7b 0.091 (yaw at the spigot corner under the sleeve); **kb v7b stays**; kb setup fixed (access shells, 0-element support, PSU keep-out) + OOM fixes in `stand_v7_topo*.py` (box-stand Problem 24).
- 20 Oct 18:25 (bar_half chat): **bar_half v8 READY** (topology; roofed M5 boss at the tip, flat bed skin): worst 0.38 vs v7b 0.54, 77.6 g, solid PASS, fits 0; v7b file removed.
- 20 Oct 17:55 (bracket_jA chat): **bracket_jA v8 READY** (topology; cheeks widened + 3.0-walled U-bosses round the lug bolts, ring keep-out r 180.2): worst 0.05 vs v7 0.12, 38.4 g, solid PASS, fits 0 / 0.3; v7 file removed.
- 20 Oct 17:05 (stand chat): bracket_e topology run 4 (drawn = v7c cheeks + bosses, h 1.5, gmg, 107 it) **rejected**: solid check PASS but worst 0.26 on the same FE (v7c 0.14), 125.1 g, a 3.4 mm³ sealed void inside; **bracket_e v7c stays the print part**; no more bracket_e topology runs (drawn beats generated here).
- 20 Oct 16:25 (layout chat): **cage v12: sockets v2 + merged parts** (`v2/s2-layout.md`; artifact "Scout v2.1 Layout" v12; Spark 02:42 wider resin sockets, 02:43 merge touching nodes, no too-short rods): socket v2 = 3.6 bore, 4 ribs on 3.3, 2 lock rings 3.9, bleed slot, 45° lead-in, closed 2.0 floor, OD 7.9; posts / nose legs / camera rails folded into 8 columns + 2 nose legs: 17 printed parts 73.1 g M, 29 rods, cage ~125 g E; keep-outs now cuts (v11 nose legs were 1.2 in the arm sweep, nose post in front of the lens): nose x 37.5, tail knee (-66, ±52), tail cross x -52; all pass index ≤ 0.96, function 0/0/0, 02:30 solid check; **fail the 14:45 neck test** (socket roots, 3 necks): skeleton fix ~+20..30 g, Spark to decide; coupon `s2_socket_v2_coupon_v2` READY (v1 removed, reamed bores).
- 20 Oct 14:45 (stand chat): **neck test + bracket_e v7c READY** (Spark 14:19 "why is the bracket disconnected"): v8 run 3's bolt pads hung on 2..3 mm necks (r 5.5 access cut wider than the 10.2 pad; the 0.9 erosion passed it): pulled. `solid_check.py` neck test (erode 1.2 / 1.5, joint < 4 t² fails); v7b fails it too; **v7c** drawn (cheeks to t −18, 10-long bolt bosses, r 5 counterbores): worst 0.14 (v8 0.20, v7b 0.55), 109.8 g, PASS, fits 0, `box_bracket_e_v7c.stl.b64.txt` (55f717ab05f8); every other stand file PASSES; README access-cut rule; topology run 4 on the v7c cheeks running.
- 20 Oct 05:00 (stand chat): **bracket_e v8 topology run 3 READY** (`box_bracket_e_v8.stl.zip.b64.txt`, sha dda1d41a1b06): drawn = 2 bolt pads + flange only, ring band opened outside the pads, h 1.5 gmg 60 cm³: worst 0.20 on the 1 mm FE (drawn v7b 0.55), drop deflection 0.07 mm (0.49), 101.3 g, solid check PASS, fits 0; run 2 (h 2.0) rejected at 1.00 on the same FE; v7b bracket_e removed. gmg wrapper fixed (prune passed `masked`), script in Nox Source. **Pulled 14:30 (see 14:45 line).**
- 20 Oct 02:30 (stand chat): **no disconnected structures, hard gate** (Spark 01:08): `nox/solid_check.py` (one body after a 0.9 mm erosion, every drawn feature in it, no wall under 1.8) in Nox Source, built into `arm_topo.run_part`, `stand_v7_topo_build.py`, `stand_v7_parts.py`; README Rules "Solid parts" + Done / ready-to-print lines; project preference saved. bracket_e topology run 1 pulled (cheeks on 0.85 mm ligaments beside the M5); every stand file checked: kb, bar_half, toe, frame_endR / L, bracket_e reissued as **v7b** (walls ≥ 2.35 round holes, hex pockets turned, bar tip ribs), all PASS, fits 0, FE unchanged or better; v7 files removed; topology setups get fastener access keep-outs; current-parts Problem 51 (backlog: every other READY part to be checked by its owner).
- 20 Oct 00:50 (layout chat): **cage v11 nodes generated + assembled CAD** (superseded by the 17:30 v12 line) (`v2/s2-layout.md` Topology run; artifact "Scout v2.1 Layout" v9, 3D view now the glTF assembly with Nodes-only and per-node close-ups; Nox Source `nox/v2/lantern/`; Spark 23:25: run through topology, show the assembled artifact with CAD): 12 node types through noxopt (h 1.25, hub 2.0, PA12-CF E values, sockets drawn, 80 N E per socket in 6 directions, ring / peg held, mass stepped): 27 nodes **54.5 g M** (was ~50 E), indices 0.15..0.67, all one body, function 0/0/0, thin 0; knees and the corner elbow needed the full target (pure bending), hub 8.2 g with a drawn octagon ring (slab envelope starved, ring envelope split into 3 bodies); cage ~116 g E. Gate before print: finer pass h 1.0 / 0.5, 25 g case, D21 load, recheck at h ≤ 1.5.
- 20 Oct 00:25 (stand chat): bracket_e v8 run 1 published (worst 0.43, 77.2 g); **retracted 01:10** by the solid check (see 02:30 line).
- 19 Oct 22:10 (layout chat): **cage v11 = lantern + research applied** (`v2/s2-layout.md` Applied from the research; report `claude/research/2026-10-19-cage-collision-designs.md`; artifact "Scout v2.1 Layout" v8; Spark 21:13 deep research + compare, 22:00 apply and show): geometry unchanged; nodes PA12-CF (or PC; buy a spool) 61 → ~50 g; TPU sleeves on both drum rings +6 g; 8 UHMW skid strips 90 x 5 x 2.5 on the skid ring flats replace the 8 pads (line contacts, yaw clocking kept) +4 g; TPU 95A grommets at the 2 side hubs and 4 sled sleeves (~1.5 mm cage-to-core travel) +2 g; clip-in tees as the sacrificial joint; turtle mode as fallback (D22 ESC firmware); ToF ring and 4-pad seat not applied; ~102 g E. Field: Elios 1 cage ~100 g, ASIO <100 g, Gimball 3 m/s / 1.7 J with ABS nodes, every benchmark fails at a node or glue line, never the carbon. New gates: D21 rod bend test (0.5 J / 100 span assumes ~130 GPa; measured hobby rod 85..113), settle sim rerun with the mount travel, D14 strip coupon.
- 19 Oct 21:35 (stand chat): **box stand v7 enclosure READY** (Spark 20:43 bolt the ring to the side walls, compact; 21:03 design all of it): 4 clear 3.0 sheets (2 x 397 x 441, 2 x 366 x 441) inside X ±186, Y −66..337, Z to 240, in 12 identical corner post segments (42.5 g each, one part for all corners); ring bolted to the side sheets through 6 brackets (jA / jB U-clips on the ±15° joint lug pairs with M5 x 25, bracket_e on the end frames' station blocks with M5 x 35 along Y); kb v7 (rear plate), bar_half v7 (tip pad to the sheet), toe v7 (front plate), end frames v7 (webs 5.0, bracket holes); mast, cradle_keel, mid frames stay v6; no inner bolt pair (the groove leaves no room) and no front / rear cross bars (KB runs under the mast). Chain FE with brackets 0.017 (v6 0.22, ~9 mm play); worst parts: end frames 0.86 / 0.92 and bracket_e 0.80 under a Scout drop (misuse); fits 0 mm³ everywhere; tip-over 2.5, no ballast (decision 31 closed). 24 new pieces 1127 g (M). Nox Print Files: 9 v7 files added, v6 kb / bar_half / toe / end frames removed; Nox Source: `stand_v7_parts.py`, `_check.py`, `_fe.py` + jsons, `ring_chain_fe` 4 configs; `stand_v7_walls` / `v7c` / `v7d` deleted. `box-stand.md` rewritten; current-parts rows + enclosure row + decision 32 + buy 15; queue rows 8 / 8b / 8c.
- 19 Oct 21:25 (layout chat): **cage v10 lantern, structure first** (`v2/s2-layout.md` The structure; artifact "Scout v2.1 Layout" v6 with side / front / top drawings and every keep-out; Spark 21:01: structure first, then the drone inside it): v5..v9 retired. Four rings, one rod size, four node types, one hub: sled (z −47, y ±32, x −50..40, nose open for the swap head) → glove (8 rods on the funnel's 45°, tail knees at the opening, nose knees at z −7 + legs for the arm sweep) → drum (skid ring z 33.2 with 8 fixed UHMW pads + shoulder ring z 60 + 8 posts; 27 x 100 window, plank-proof) → crown (8 spokes to a printed hub r 40 at z 85). 41 rods 3.78 m 42 g, 27 nodes ~61 g, ~111 g E, 132 tall; props 12.5, collar 1.3, yawed opening 2.2, arm sweep and head body clear; hub flat is the only upper rest (0.16 N·m, climb 34..38 mm, forward blip, D20); catch interface wheels → pads (D14 skid coupon, settle sim rerun); receiver v4 ties by 4 sled sleeves.
- 19 Oct 21:10 (stand chat): **weak-spot sweep** (Spark 20:48): ring arc as a bolted chain (`ring_chain_fe.py`, 3 configs): v6 joints worst 0.22, tip 1.1 mm, but bolt + dovetail play lets the tip move up to ~9 mm; + inner bolt pair 0.20; + v7e wall brackets 0.01 / 0.02 mm; end-frame pads under a Scout drop ~64 N (> the 50 N case, ~0.9): webs 4 -> 5 + the 45° bracket; 12 hand checks (posts, sheet, acrylic bearing, laps, bolts, inertia, creep) all fine; `box-stand.md` Weak-spot sweep + Problems 11 / 13.
- 19 Oct 20:15 (stand chat): **stand v6 FE check + v7 walls proposal**: voxel FE (printopt PETG, misuse) on every v6 part: worst 0.71 end-frame pad web at 50 N on a pad, 0.59 frame lug neck hanging 80 N, 0.58 bar root (6 mm tip flex), rest ≤ 0.2; nothing fails. v7: 4 clear 3.0 sheets (2 x 388 x 441, 2 x 410 x 441) in slot blocks built into the bar tips, toe and KB + 8 corner clips, standing on the floor: tip-over 2.2 with no ballast (E); awaiting approval. `stand_v6_fe.py` / `.json`, `stand_v7_walls.py` / `.json` in Nox Source; `box-stand.md` sections Load path, Structural check, v7 proposal, Problems 6 / 7.
- 19 Oct 19:45 (stand chat): **box stand v6 parts + ring frames READY** (Spark 19:09: all but the servo heads): mast 99.1, KB 116.5, cradle_keel 70.1 (cradle v5e + front keel merged), bar half 43.5 x2, toe 15.7, frame_mid 47.6 x5, frame_endR 81.6, frame_endL 81.2 = 789 g (M); end adapters merged into the end frames (their lug blocked the pad M3 axis); fits 0 / 0 (C / M), tip-over 1.61 / 1.06 (E); found: arm_cad module dovetail has 0 flank clearance (box-case Problem 7, current-parts 50); `box_bay_cradle_v5e`, `box_seat_pad_v5e_A/B` removed from Nox Print Files; `stand_v6_parts.py`, `_check.py`, `_render.py` in Nox Source.
- 19 Oct 19:40 (layout chat): **Scout v2.1 layout** (`v2/s2-layout.md`; artifact "Scout v2.1 Layout"; Spark 19:12: v2 worse than v1, keep only the bottom battery + funnel fit, full cage back): FC on the plate top (only board that clears the disks), Radxa under the plate on the axis on the receiver v4 ceiling, UBEC + RX on a right wing, camera in a nose window at x 99, flow moved to x 63..85 z 2..10 (v3.3 spot is in the box arm sweep); cage v5: wheel ring 33.2 + top ring 60 + top cross + 7 verticals + nose ladder + skirt V to (±44, ±28, −5) + v2 side hubs, 2.84 m rod, 74 g E (over 55). Retired: top case, crown, cage C3/v3.2/v4 (corner nodes carry over), receiver v3.3/v3.4, camera mount v2.
- 19 Oct 18:05 (stand chat): **box stand v6, all printed** (Spark 17:25): mast sleeve on KB's spigot (stub v3 pattern kept, bolts M5 x 12 button), two-piece keel into cradle v5e, one cross bar (2 x 220 halves to X ±200), toe; the bay ring closed with 7 printed 30° frames and carrying the funnel on 2 end adapters; tip-over 1.52 with the PSU on the keel (1.03 without, E); 2040, brackets, seat pads retired; `nox/box/stand/stand_v6.py` + `_parts.json` in Nox Source; `box-stand.md` rewritten, `box.md` 4, `box-case.md` Ring frames, current-parts rows (stand DESIGN, frames, adapters), queue row 8.
- 18 Oct 06:40 (status chat): **cage v4 node set READY** (Nox Print Files `s2_cage_v4_{corner_node,vtee,side_node,side_node_M,wheel}.stl.zip.b64.txt`): corner 6.10 g worst 0.99 (v3 1.13), side node 4.97 g 0.38, vtee 2.99 g 0.06 (M, 3.0-rod loads at 0.89 m/s), wheels R 5 bore 3.4; crown stays v3.2 (v4 crown run: 9 bodies, dropped); side node needed `NOX_OVERHANG=0`; frame model C4 v 0.89, catch sim R 5 95 % vs R 4 100 % at μ 0.4; `layout_C4.json`, `export_c4.py`, patched `node_gen.py` / `layout_v3.py` in this chat, not yet in Nox Source; v3.2 stays the printing cage, v4 = optional upgrade (decision 30).
- 18 Oct 01:15 (stand chat): **stand v5e prints READY**: `box_bay_cradle_v5e.stl` (37.5 g M, back face down), `box_seat_pad_v5e_A.stl` + `_B.stl` (24.8 g M each, print 2 each) in Nox Print Files; cradle bolts placed on the module mesh at (±26, 154) / (±26, 189) (12.6 / 17.6 deep M); the mesh shows the plate face flat at Z −152.6..−152.8 (not r 152.5) and the module sides as ±12° planes, so the cradle body is X ±20.4 with lips to ±30, Y 140..197; `stand_v5_parts.py`, `render_views.py` in Nox Source; `box-stand.md` Problem 2 closed.
- 18 Oct 00:20 (receiver chat): **S2 receiver v3.4 READY**: `s2_receiver_v34.stl` in Nox Print Files (print pose, pads on the bed, sha 28fe49d9da09, 45.7 g M); plate attachment drawn (full 2.0 nut-cup rings, nose cup as a 2.0 skirt into the end tab, r 9.5 collars, 3.0 pocket posts, gussets to y 35), attachment index ≤ 0.43 on every must-hold case (2 reinforcement passes); skirt sockets 3.3 x 10 aimed at (±3.2, ±112, 33.2), loads at 3.0 rods (183 N); shoe-lead channel rerouted off the tail sockets; mouth-down bed columns removed; camera keep-out = mount v2 envelope. `v2/receiver_v34.py` in Nox Source; `v2/s2-receiver.md` written. The v3.3 fit print keeps its own current-parts row.
- 17 Oct 22:50 (arm hub chat): arm hub set READY in Nox Print Files: hub v5 regenerated (214.2 g M, worst 0.31→0.30 pivot, bore Ø80.2 now drawn in `arm_cad.hub_parts`, 0 overlaps), stub v2, sun post, detent ring + arm, idlers A / B, pinions, fingers x4; scripts in Nox Source.
- 17 Oct 22:13 (stand chat): box stand v4 drill template v1 published (artifact "Stand v4 Drill Template", PDF 15 letter pages, 20 board holes + 6 on face patterns); `nox/box/stand/stand_v4_template.py` in Nox Source. v3 board kit runs stopped, nothing published.
- 17 Oct 21:50 (status chat): **every carbon rod in the project is 3.0, wheel pins included (Spark 21:45; decision 22 closed)**: dimensions G row renamed "Carbon rods (whole project)", Catch wheels + Catch interface rows R 5 / Ø3 pin (was R 4 / Ø2); cage v4 adds wheels R 5 bore 3.4, cheek holes 3.3; test 8 coupon rod 3.0; buy 13 one rod size (~2.7 m 3.0). Problem 49 widened.

- 17 Oct 21:36 (status chat): **all cage rods 3.0 solid (Spark 21:33; was 2.5)**: dimensions G "Cage rods" + E receiver row; cage v3 / v3.1 back to DESIGN (2.8 bores, do not print), v4 at 3.3 bores + frame rerun; receiver v3.3 skirt sockets drilled 3.3 by hand, v3.4 at 3.3; wheel pins stay 2.0 (DEFAULT, decision 22); rods ~27 g C, cage ~70 g over the 55 budget (Problem 7 in the cage doc); current-parts Problem 49, items 22 / 23 / 24, buy 13 rewritten.
- 17 Oct 21:24 (bay module chat): bay module v4i saved: `box_baymod_v4i.stl` (print pose, near end Y 133 down, from the Project viewing OBJ, 83.4 g M, sha 472f8808ea9c) in Nox Print Files + `latest\box_baymod.stl`; print_orient pass (462 mm² M); READY, print 2. nb modules dropped.
- 17 Oct 21:21 (cage print chat): S2 cage v3.1: fit check of every socket in drone coords; corner pin holes came out Ø1.98..2.15 (M), re-cut 2.3; plate sliced 38.57 g, 2 h 47, supports 0 g; receiver skirt sockets 1.85° off (Problem 48).
- 18 Oct 04:30 (head B chat): Project hit its 2 MB cap: all 195 scripts, configs, research notes, params and the bay mesh moved to the artifact "Nox Source" (same paths, MANIFEST sha256) + `head_reinforce.py`; README "Where files live".
- 17 Oct 20:11 (head B chat): head B v5 generated (clamp v2, slot 2.0 DEFAULT): 55.5 g (M), worst 0.96 after 1 reinforcement pass (was 1.33, belt stall at the clamp bridge), thin 0, 0 overlaps; BUILT until the coupon pick. New `head_reinforce.py` not saved: Project full.
- 17 Oct 19:10 (head A chat): head A v5 generated with belt clamp v2 (`belt_clamp_v2_head.py`, slot 2.0 DEFAULT as a build-time cut) + wiring entry channel: 56.1 g (M), worst 0.45, thin 0, 0 overlaps; BUILT, READY after the coupon slot pick. Shared `arm_cad.py` now draws the v2 clamp for both heads (v1 `belt_clamp.py` no longer imported).
- 17 Oct 19:20 (head A chat): dimensions I: belt clamp v1 row retired, Head row points at clamp v2.
Change lines, newest first, **one line each, under ~200 characters**. No archive: retired designs are deleted, not kept (Spark 14 Oct 18:18).

## Change log
| Date | Item | Change | Why |
|---|---|---|---|
| 17 Oct 20:05 | S2 cage v3, layout C3, all PETG (`v2/s2-cage-v2.md`, `v2/cage_v2/node_gen.py`, `export_c3.py`; queue 3) | Saved + `latest\`: one plate 42.5 g (M, 19 parts) + rods 18.7 (C); worst corner 1.13 (noted), crown 0.81, side 0.28, vtee 0.08 (F); 2 case side spacers; READY | Spark 03:01 / 03:52 / 09:20 / 10:39 |
| 17 Oct 18:30 | Orientation + supports rule (`nox/README.md` Printing; `nox/print_orient.py`; queue Rules; current-parts header, Problem 47 closed) | Largest flat face down, tree supports, bed contact (M) with every slice, `print_orient.py` pass in Done; Scout READY parts checked: tray, block, camera mount keep their faces; top case stays (printing fine) | receiver v3.3 stood on 8 posts, 94 mm² on the bed (Spark 18:05: well-supported is the default) |
| 17 Oct 18:25 | Receiver v3.3 reprint setup + camera mount v2 sliced (`latest\s2_receiver.3mf` bosses down; `latest\s2_receiver_v33_flipped_supports.gcode.3mf` 48.24 g, 3 h 21; `latest\s2_camera_mount_v2_supports.gcode.3mf` 4.01 g, 48 min) | Receiver READY again (bosses down, 596 mm² M on the bed); camera mount v2 synced to `latest\` and sliced; neither on the SD card (reader I/O errors) | Spark 18:05: make the flipped receiver the default, slice every Scout part ready for the card |
| 17 Oct 17:30 | Attachment rule (`v2/current-parts.md` Problem 46) | Anything that ties a printed part to the plate, a bolt or a mating part is drawn (pads ≥ Ø12, posts ≥ 6 x 6, gussets), never left to the generator; index ≤ 0.5 there until a coupon calibrates printopt (DEFAULT) | receiver v3.3 + cartridge plate snapped at thin members that passed ≤ 0.76 |
| 17 Oct 17:10 | S2 camera mount v2 (`v2/s2_camera/run_cam.py`, `cam_place.py`, `.json`; queue 4) | 4°, props 41.2, collar +0.7, receiver flow seat + nose tube kept out: lens x 81.31 (C), 3.47 g (M), worst 0.65, 0/0/0, thin 0; saved, READY (sha 12419b7a720f) | decision 17 (Spark 15:50) |
| 17 Oct 16:50 | S2 top case v1 (`v2/s2-top-case.md`, `v2/s2_top_case/`; current-parts) | FC on its grommets; UBEC 44 x 20 on edge + XR2 on a tape land; Radxa parts-down on 4 bosses; drawn posts, ears; side pads on cage hub pads; 12.85 g (M), worst 0.84; READY, tree supports | Spark 16 Oct 19:46; UBEC 17 Oct 11:34 |
| 17 Oct 16:12 | S2 receiver v3.3 saved for Gideon (`v2/receiver_v33.py`; laptop `latest\s2_receiver.stl` + `s2_receiver_plate.gcode.3mf`) | Bambu flagged a floating lead-end tab (mouth down): 2 drawn bed columns 3.5 x 3 under it, 43.7 g (M), real ≤ 0.76; sliced 39.03 g, 2 h 35 min; READY, SD card for Gideon | Spark 15:44: slice for Gideon, latest version |
| 17 Oct 15:55 | Head belt clamp v2 (`nox/box-arm.md` clamp section, `nox/box/belt_clamp_v2.py`, `_figure.py`) | Loop and pin: belt folded teeth in, meshed in a slot, M3 pin through the loop; 6 teeth per end, 39.7 per head (C). Coupon set v2 (slots 1.8 / 2.0 / 2.2, 11.6 g M) saved, READY | Spark 15:35: v1 didn't work, use a proven design |
| 17 Oct 15:55 | Every session rule + decisions 15 / 16 / 17 (`nox/README.md` Every session; `v2/current-parts.md`) | Start: read your row + mating rows; every design change reaches Project + Nox Print Files same turn, local = mirror. Latch coupon dropped (`s2_latch_coupon.py` deleted), `s2-guard.md` + `s2-underside.md` deleted, camera 4° (v1 superseded, v2 DESIGN) | Spark 15:37: defaults, clean up, every session on the latest |
| 17 Oct 15:45 | Latest folder (`nox/README.md` Printing; Nox Print Files page) | `Documents\Nox\latest\`: one file per part, fixed name, + `LATEST.md`; done = saved also overwrites it; print chats sync first, slice only from it, reuse the open Bambu window; files > 10 MB zipped | wrong v11 sliced + 9 Bambu windows (Spark 15:34) |
| 17 Oct 15:40 | S2 tray v11 (run 9a) + block v4 (`v2/tray_to9.py`, `tray9_fix.py`, `s2_blade.py`; `v2/s2-cartridge.md`) | Saved: Nox Print Files + `latest\` (tray 15.8 g M, sha 8a159ddb…; block 6.26 g, fdaffa18…; plate 19.27 g); READY; feeler blades, under-floor band, twist 0.90° | Spark 11:07 feeler, 11:32 optimize |
| 17 Oct 15:40 | Live status (`nox/README.md` Live status, `v2/current-parts.md`, `nox/dubhacks-queue.md`) | A part's state lives only in its current-parts State cell (fixed words); queue = order only; "ready" without a saved file = BUILT | Spark 15:25: status inconsistent across docs |
| 17 Oct 15:12 | S2 camera mount v1 (`v2/s2_camera/run_cam.py`; queue row 4) | Saved: `s2_camera_mount_v1.stl.b64.txt` in Nox Print Files (3.61 g M, worst 0.75, sha256 897cc4f9…); READY TO PRINT; tilt 13 / 4 still open (Spark) | Done = saved rule |
| 17 Oct 14:00 | S2 receiver v3.3 (`v2/receiver_v33.py` + `_build.py`, cage `v2/cage_v2/receiver_skirt.py`; dimensions E / H) | Cage C3 skirt sockets + loads in; flow seat under the camera (lens (63, -2, -24)); mouth-down, no supports beyond bridges; side pads r 8.6 + 3.5 rings: 42.5 g (M), one body, thin 0, real ≤ 0.76, pinch 1.36 (misuse); v3 33.4 g needed supports, flow seat on a 30 mm³ link | Spark 02:23 bay slot; 09:16 more support; 12:3x flow under camera; 12:38 cage nodes |
| 17 Oct 12:45 | Arm hardware measured (`arm_layout.py`, `detent.py`, `nox/box-arm.md` Ring) | 6010 50x80x16, NEMA 42.4 (17HS19-2004S1), 20T Ø15.7 x 15.7, 80T flange Ø55 / collar Ø30 / total 18 (P); ring bore Ø24.5 -> Ø30.5, 5.0 g (M); ring base follows the 80T width | Spark calipered |
| 17 Oct 11:50 | Arm print prep (`nox/box-arm.md` hub row + Detent Hardware, `detent.py`) | Hub v5 print file: bearing bore post-cut Ø80.2 (was flats at Ø80.00), 214.9 g (M); ring bore Ø24.5 (r 12.25), 6.92 g (M); pivot backed off 1/4 turn + threadlock, smooth Ø3 band pins | final prep check |
| 17 Oct 11:00 | Detent pull = rubber bands (`nox/box-arm.md` Detent Pull + 20) | One band per pin groove; ≥ 6.7 N total at 38 (margin 1.5), fit 7.5..10 N (E); hang test 0.38 kg on one band, ≤ 38; steel springs stay the later option | Spark 11:00: rubber bands for now |
| 17 Oct 10:55 | Detent solved motion (`nox/box-arm.md` Detent + 20, `detent_kin.py`; artifact "Nox Arm Detent") | Roller rides the notch edges, not the 60° flanks: 0.277 N·m per spring (C, was 0.39 E); margin 0.76 / 1.51, both springs fitted; 0 overlaps, closest 0.30 | moving check asked |
| 17 Oct 10:45 | Cage all PETG (`v2/README.md` Thickness and materials; cage chat to update `v2/s2-cage-v2.md`, dimensions G, `cage_cad.py` / `export_print.py`) | No TPU on the cage: tees, hubs, feet (if any) PETG Basic like the corner nodes; one PETG plate; tee / foot sockets take the PETG socket spec | Spark 10:39: PETG for all of them |
| 17 Oct 10:45 | Engine (`nox/noxopt.py` thin_check, `nox/test_noxopt.py` thin_built) | As-built thin member counts only if 2 shifted grids also see it (`THIN_OFFSETS`, `offsets=()` = old check); hub v5 25 -> 0; real 0.8 rod still fails; self-test passes | face-aligned slabs forced re-prunes |
| 17 Oct 09:05 | Hub v5 regen (`nox/box-arm.md` table, dimensions I, `arm_kinematics.py`, `hub_render.py`, `thin_offset.py`) | Detent tower drawn in: 215.8 g (M; v4 211.3), worst 0.31 detent pivot (v4 0.15), one body, thin 0 off-grid; 158 states, 0 overlaps | arm detent (Spark 04:16) |
| 17 Oct 07:00 | Neighbour bay modules nb v1, 30° / 150° (`nox/box-case.md` 2 / 3 / P7, `nox/box/arm_run_baymod_nb.py`, `post_nb.py`) | Posts (seats X ±98.14, Z 151.46 C) + tie boss; 155.7 g (M), worst 3.27 (1 kN landing, tie root); built on v4c, superseded by v4i: rerun | Spark 03:0x: 30° / 150°, mirror + joint swap |
| 17 Oct 06:30 | Universal bay modules v4i (`nox/box-case.md`, `nox/box-arm.md`, `arm_layout.py` v4c/v4d, `arm_cad.py`, `arm_run_baymod.py`, `post_v4.py`) | Y_C 175; 9 bays at 30°, 90° opening; M5 + nut lugs + dovetails, slide out +Y; DS3218 from photos; module 83.5 g (M), worst 0.05; print near end down | Spark 02:00..04:29 |
| 17 Oct 05:30 | Arm detent, next arm version (`nox/box-arm.md` Detent, `detent.py`, `arm_cad.py` hub v5 tower, `arm_run_hub.py`, `arm_kinematics.py`) | Ring on the 80T, 12 V-notches; 683ZZ roller arm + 0.5x5x25 spring(s) on a hub v5 tower; margin 1.07 / 2.13 (E); hall homing; 0 overlaps | Spark 04:16 / 04:17 |
| 17 Oct 04:25 | Cage v2 re-export + frame rerun (`v2/s2-cage-v2.md`, `v2/s2_guard_frame.py`, `cage_v2/s2_feet_sim.py`, `contact_force.py`, dimensions G) | x-skids: foot hit 1.66, landing 0.16, worst 1.84; plates re-exported (foot 0.84, hub 1.73 g); 42.0 g; flow sensor touches the +x face in 8 to 12 / 300 drops | Spark 03:51: do all here |
| 17 Oct 04:00 | Hub v4 + sun post (`nox/box-arm.md` 2, dimensions I, `arm_layout.py`, `arm_cad.py`, `arm_run_hub.py`, `arm_kinematics.py`, `hub_section.py`) | Fixed sun post through a Ø45.5 hub hole; posts r 35 / 38.75; axle seat slotted ±1; leads twist in the post; hub 211.3 g (M), worst 0.15; 0 overlaps | sun must be fixed |
| 17 Oct 03:50 | Floor feet + skids, receiver v3 layout (`v2/cage_v2/foot_opt.py`, `s2_feet_sim.py`, `cage_cad.py`, dimensions G) | Feet (±25.75, ±30.75), bottoms z -47.5; 2.5 skids 2 x 47.5 along x at y ±30.75; legs 4 x 61.9; tip 26.6°; side hub leg bores re-aimed; y-face collar gap 0.07 | Spark 03:27: pack nose-tail, 3 lower |
| 17 Oct 03:40 | Head belt clamp v1 (`nox/box-arm.md`, `nox/box/belt_clamp.py`, `arm_layout.py` CLAMP_DZ / CLAMP_DZ_B, `arm_cad.py`, `arm_run_head.py`, dimensions I) | Open slot out: toothed bed 8+8+8 land in each head, cover plate + 1 M3; A u −18.6..21.4, B −15.6..24.4; cuts 390 / 402; pluck 143 / 139 Hz; heads rerun as v5. Retired 15:55 (v2) | Spark 03:12: no way to connect the belts |
| 17 Oct 02:00 | Axle drive v4 (`nox/box-arm.md` 2 / 4, dimensions I, `nox/box-buy-list.md`, `arm_layout.py`, `arm_kinematics.py`) | m1 gears 28:111 rejected (111T hits posts, B belt, B clamp at every Y); 80T + 122T loop lap-spliced from open belt (cut 274), 422° travel; sun must be fixed: hub change open | Spark 01:37: no closed belt |
| 17 Oct 01:45 | Balance pads removed (`v2/s2-cartridge.md`; tray run 9 stopped, `tray_to9.py` deleted) | No band, pocket or windows on the tray; bay balance leaves out with it (box chat to update `nox/box-case.md`, `arm_layout.py` BAL_*) | Spark 01:39: no more balance pad |
| 17 Oct 01:45 | S2 tray v8 = print version (`v2/tray_to5.py` run 8 at 3.6 cm³, `v2/s2-cartridge.md`) | 15.3 g (M), worst 0.57 (crash), print 1/1, function 0/0/0, thin 0, fits; cartridge 21.6 g. v7 (4.25): 15.9 g, 0.37. Search stopped | mass search ends: next step ~0.5 g |
| 17 Oct 01:35 | S2 receiver v2, belly-plane run (`v2/receiver_to.py`, re-uploaded: staged `--lean` flow) | 3.0 cm³ on the whole belly plane: 16.9 g (M), 6 bodies, worst 7.42 preload across-layer; not printed | belly support never joins the features: use the 3-bolt mount |
| 17 Oct 01:10 | Shoe-contact receiver (`v2/receiver_to_shoe.py`, `v2/s2_cartridge.py`) | Drawn frame (full-height posts, nut cups, slim shoe modules) + 4 cm³ generated: 29.2 g (M), one body, print 1/1, function 0/0/0; worst 1.28 pinch 20 N (misuse), real cases ≤ 0.92 | Spark 19:19 stronger receiver; 20:08 parts on hand |
| 17 Oct 01:10 | Project file clash | The contacts chat overwrote `v2/receiver_to.py` (the other receiver v2 chat's script) at 01:05; its own script moved to `v2/receiver_to_shoe.py`; the other chat must re-upload `receiver_to.py` | two chats on one part |
| 16 Oct 20:40 | Contacts on hand only (`v2/s2-contacts.md`, `v2/s2_cartridge.py`) | Pins + gold strips retired: copper-clad strips (MCIGICM FR-4 1.6) on sprung copper shoes pushed by AA leaf contacts (B0GTVNBSB5 = MPD BK-209); steel carries no current | Spark 20:08: no new parts |
| 17 Oct 00:52 | D8 + D12 closed (dimensions C / D / G / H, current-parts) | Plate = carbon, 3.5; D12 = 19.2 (EMAX ECO II 2004 listing, E); prop plane z 40.5 -> 41.2; cage, top case and camera chats recheck at 41.2 | Spark 00:52: carbon plate, go with these |
| 16 Oct 23:50 | Box arm v4 + bay modules (`nox/box-arm.md`, `nox/box-case.md`, `nox/box/`, dimensions I, `v2/s2-cartridge.md` Balance pads) | Cartridge long side on the axle; servo radial at X 33.5, racks side by side; bolted bay modules with 5 AA balance leaves; casing retired; head A 50.0 g (M), worst 0.34 | Spark 17:34 / 19:28 / 20:39 / 23:39 |
| 16 Oct 23:25 | S2 tray v6 (`v2/tray_to5.py` run 6 at 5.0 cm³, `v2/s2-cartridge.md`) | 17.0 g (M), worst 0.36 (pinch), one body, function 0/0/0, thin 0, fits; core check = 1 body + 5 single voxels (grid artifact). Run 7 at 4.25 cm³ running | v2 mass search |
| 16 Oct 22:05 | S2 tray v5 (`v2/tray_to5.py` run 5, 6.0 cm³) | Shoe strips z 49.65..65.65; old drawn strip block removed; ramp drawn; pins 6 N -> shoes 2 N/side: 18.3 g (M), worst 0.30, one body, function 0/0/0, thin 0 | Contacts 20:08 (copper shoes); mass |
| 16 Oct 23:20 | Engine (`nox/noxopt.py`; artifact "Nox Engine Bundle") | `Layout.run(vol_gain=1.0)`: damped volume-limit refresh, default unchanged, self-test passes; receiver v2 uses 0.3 + `--lean` (noxopt_local) | receiver v2 limit-cycled 2 to 4.5 % vol, cut load paths |
| 16 Oct 22:40 | Funnel panels v4 ribbed (`v2/box-funnel.md`, `v2/catch_v4/panel_opt.py`, `funnel_panel.py`, `rib_mask.json`) | 8 flat panels (4 A + 4 B), contact face down, no supports; plate-FE rib optimizer: skin 1.6 + 9 ribs, 70.4 g each, 562 g; 2.8 + band panel failed 3.6x | Spark 21:19 flat only; 22:06 optimize |
| 16 Oct 22:00 | Feet tied to the cage; bracket split (`v2/s2-guard.md`, `v2/cage_v2/`, dimensions G; artifact "Scout Cage v2") | Legs 3.0 x 69.5, foot to side strut root (grazes 0.7 % at ±30); bracket -> 2 side hubs (one bolt + plate-edge lip) + tail hub under the plate (FC now on the plate top); 38.6 g | Spark 21:35: the feet connect to the main cage |
| 16 Oct 21:30 | Floor feet (`v2/s2-guard.md`, `v2/cage_v2/foot_opt.py`, `s2_feet_sim.py`, dimensions G; artifact "Scout Cage v2") | 4 TPU foot nodes at (±30.75, ±30.75), bottoms z -44.5, 2.5 skids 57.5, 3.0 mount socket up; tip 32°; never stick in the collar (100 %, grazes 3 to 4 %) | Spark 20:54 / 20:56: support without the funnel, nodes where needed |
| 16 Oct 20:50 | S2 cage v2 drawn v1 (`v2/s2-guard.md`, `v2/cage_v2/`, dimensions G / H / C; artifact "Scout Cage v2") | 4 corner nodes (PETG, 2 wheels each), 3 TPU tees, plate bracket, 3 struts (0, ±58 / -58, z 25), cut list; wheels 2.5 proud; 32.4 g + epoxy; checks pass | Spark 20:31: build the cage nodes, save as the cage |
| 16 Oct 20:40 | Catch full-physics check (`v2/catch_v4/s2_catch_real.py`, dimensions G, `v2/box-funnel.md`; artifact "Scout Collar Catch") | Flown approach, 402 g inertia, prop spin-down, bouncy contacts: ±30 gate 100 %, ±40 86 % (outward drift reaches the face past the mouth); landing gate ±30 proposed | Spark 20:10: realistic physics |
| 16 Oct 19:50 | Catch all PETG (`v2/s2-guard.md`, `v2/box-funnel.md`, dimensions C / D14 / G / H / O, `v2/catch_v4/s2_node_wheels.py`) | Domes + PTFE tape out: 8 print-in-place PETG wheels in the corner nodes roll down the faces; faces 45° (shared, was 34.99°), collar 76 tall, mouth 320, opening 168; 100 % centred at μ 0.4 (sim) | Spark 19:33: optimize the nodes, tweak the funnel, everything PETG |
| 16 Oct 19:30 | S2 guard v2 + collar funnel v4 (`v2/s2-guard.md`, `v2/box-funnel.md`, dimensions C / D / G / H / O, `v2/catch_v4/`) | Pyramid + foot gone: 8 PETG domes in the corner nodes (c 100) on a 53-tall collar, open bottom 168; rings up to z 32.5 / 48.5; Overseer pack 148 x 48 x 45 | Spark 17:12 / 18:37 / 19:02: compact, always centred, PETG in the nodes |
| 16 Oct 19:15 | S2 cartridge v3 + receiver v1 (`v2/s2-cartridge.md`, `v2/s2_cartridge.py`, `v2/tray_to.py` run 4, dimensions E / J) | Guide rail 20.0 full length; plates of fixed 2.0 thickness (topology picks holes only); drone receiver with 30° lead-ins ±3.3; pockets 14.6; tray 20.1 g, worst 0.29, one body at print res | Spark 17:51 / 17:54: centering lost, function first, more support |
| 16 Oct 19:15 | v2 rules (`v2/README.md` Thickness) | Function first: every functional surface drawn, every use load a case; thin-walled parts are fixed-thickness plates; rule 1 restored (overwritten 17:58 by the cartridge chat) | Spark 17:51 / 17:54 |
| 16 Oct 18:58 | Sparks Book cleanup (`nox/README.md` Docs + Cloud sessions, `nox-generative.md` step 5; artifact "Nox Engine Bundle") | `noxopt_local.py`, `interfaces.py`, `reconstruct.py`, `v2/s2_underside/`, Scout params into the Project; noxopt_local + sparse_dot_mkl in the bundle (tests pass); current meshes in its mesh store | Spark 18:36: nothing Nox needs lives only on Sparks Book |
| 16 Oct 18:05 | Cloud setup (`nox/README.md` Cloud sessions, `v2/README.md` rule 1, `nox-generative.md`; artifact "Nox Engine Bundle") | Project is the only source; engine unpacked from a bundle, not read through the chat; meshes rebuilt per chat; PC paths out | Spark 17:23: run the whole project in the cloud as v2 |
| 16 Oct 18:05 | Engine (`nox/noxopt.py`, `nox/test_noxopt.py`) | `prune_thin` keeps the run's `masked` choice; self-test adds a masked=False gradient check; self-test + demo pass in the cloud (10.4 g, 0/0/0, thin 0): closes the 17:30 CHECK | a masked=False run was re-settled with the masked filter |
| 16 Oct 17:34 | Box orientation (`nox/box.md` 4, 8, Open 1 and 5; `nox/box-case.md` Problem 6) | Both cartridges long side along the axle, slide axis tangential, one head for both; ring sweep, bays, top opening and hub v4 reopened; bay v1 and top tiles superseded; everything waits on the Overseer pack (D10) | Spark 17:30: opening 88 x 46 can't pass an Overseer pack; 17:34: same orientation for both |
| 16 Oct 17:30 | v2 rules (`v2/README.md` Thickness, Optimizer settings, Pass line) | 2.0 class dropped: floor = printability 1.2; connectivity at print resolution is the hard rule; shell design band ≥ 3 cells, plain filter | Spark 17:20: no hard limits that leave disconnected walls; the layout decides |
| 16 Oct 17:30 | Engine option (`nox/noxopt.py`) | `Layout(..., masked=False)` and `MaskedFilter(..., masked=False)`: plain cone filter; default True keeps old behaviour. `test_noxopt.py` not rerun in the cloud (CHECK on Sparks Book) | tray runs 1 and 2 made 1-cell sheets along the keep-outs |
| 15 Oct 04:50 | S2 tray generated, run 2 (`v2/s2-cartridge.md`, `v2/tray_to.py`, dimensions C / E) | h 1.0, pack rest pads drawn, 4.5 cm³, clip 0: 12.1 g, worst 0.93 (pinch), thin 7; run 1 (tree, 10.1 g) deleted | Spark 03:35: v1-style generated frame |
| 15 Oct 02:40 | S2 cartridge v2 (`v2/s2-cartridge.md`, `v2/s2_cartridge.py`, dimensions C / E / J) | Flat-bottom box 37.8 x 48 x 78.8, tabs sunken in a bottom recess, 3 mm finger blades, coil-spring return, walls 2.0 | Spark 01:17: notches sunken in, flat bottom |
| 15 Oct 00:45 | S2 cartridge v1 (superseded 02:40) | Fitted cartridge = tray + glued latch block; diagonal cantilever leaves; bolt to x 22.4, rail face 19.4; strips 22 long on 1.0 bosses; bare pocket + pin blocks | Spark 00:18 |
| 15 Oct 00:06 | S2 bottom latch locked (`v2/s2-bottom-latch.md`, dimensions J) | Squeeze-release latch is the design: sliders + leaves on the cartridge, passive drone pockets, spring-closed 2-finger gripper on the head; artifact "S2 Latch Cycle" | Spark 00:06 on the artifact |
| 14 Oct 22:30 | Latch coupon v1 (`v2/s2_latch_coupon.py`, dimensions J) | Standalone rig drawn: cartridge (sliders in place), drone pockets, finger x2; bearing face = bolt underside; leaf 0.8x13x26 fixed-guided 1.4 % (was 1.2x10x25); bolt 13 wide | Spark 22:13: mechanism first, no pack fit |
| 14 Oct 21:56 | S2 bottom latch (`v2/s2-bottom-latch.md`, dimensions J, I; `nox/box.md`) | Squeeze-release sliders on the cartridge (bolt 10x4, 3.0 overlap, 10° undercut, 4.0 travel, leaf 1.2x10x25), passive drone pockets; head = spring-closed 2-finger gripper, holds any orientation; cup, lips, blades, hooks out | Spark 21:50 / 21:56 |
| 14 Oct 20:29 | Box design saved (`nox/box.md`) | Funnel + magnet + vertical swap wheel saved as the box; `v2/box-swap-arm.md` folded in; all retired design docs and scripts deleted; box-funnel and bottom-latch docs cleaned of old mechanisms; Problem 36 (funnel size) | Spark 20:29 |
| 14 Oct 19:26 | Box swap wheel (`nox/box.md`, dimensions I) | Wheel is vertical: one horizontal axle, bays in the wheel's plane, drone at the top, heads radial; cup + bay get TPU snap lips ~5 N (DEFAULT) since packs invert; Problem 35 | Spark 19:26 corrected the 18:12 read (not a flat pivot) |
| 14 Oct 18:18 | Project cleanup | v1 hardware rows moved to dimensions A, Overseer hardware to O | Spark: no old designs in the project |
| 14 Oct 18:18 | Box funnel static (dimensions G) | No Z stage for now; corner blocks lose the LM12UU / T8 features; drone lands into the funnel itself | Spark 18:18 |
| 14 Oct 18:12 | Box swap concept (`nox/box.md`) | Charging bays + one double-ended arm, lead-screw heads (DEFAULT, not scissors), blades on the head; electromagnet hold + 2 pogo keep-alive pads (DEFAULT); batteries = bays | Spark whiteboard 18:12 |
| 14 Oct 16:41 | Scout no longer a pusher (dimensions C "Motor / prop layout") | Motors + props on top; drone z stays on the plate; prop plane z ≈ +40.5 (E, CHECK); Problem 33 | Spark 16:41 |
| 14 Oct 16:31 | S2 bottom latch concept (`v2/s2-bottom-latch.md`, dimensions J) | 2 flexure hooks on the drone, 3.0 overlap, 10° undercut, ledge pocket 0.8; battery under the drone | Spark 16:31 locked |

## Failure log
| Date | Part + version | Print | What happened | Where | Action |
|---|---|---|---|---|---|
| 17 Oct 17:27 | S2 receiver v3.3 (`receiver_v33.py`) | 16:12 / 16:38 plate (Gideon, SD card), mouth down | Snapped (Spark 17:27): the attachment to the carbon plate is too thin. Print setup also wrong (print chat 17:45): mouth down = 8 free-standing posts for 48 mm, two of 10.5 mm², 94 mm² (M) on the bed | plate attachment: the two 3.2 mm² (M) necks are where the nose nut cup (a half ring, drawn to the deck underside only) crosses the deck's end bar; the side cups were drawn to the deck, the nose was not (receiver chat 18 Oct, C) | Re-sliced bosses down with tree supports (reprint, Spark 18:05); **v3.4 (18 Oct 00:20): nose cup runs on as a 2.0 skirt into the end tab on a 15-wide deck tongue, every cup a full 2.0 ring, attachment ≤ 0.43 on every must-hold case**; weigh the broken piece (P) |
| 17 Oct 16:25 | S2 cartridge plate (tray v11 run 9a + block v4) | 15:22 plate, no supports, SD card | Snapped (Spark 16:25 / 16:36); where not recorded | tray (overhangs printed unsupported) | Supports on every part from 16:36; tray reprint `s2_tray_v11_supports` (block + blades on hand) |
| 17 Oct 15:35 | Belt clamp coupon set v1 (`belt_clamp.py`) | 13:18, SD card | Did not work (Spark; mode not recorded) | printed tooth grooves + cover plate | Retired; v2 loop and pin from proven designs (`belt_clamp_v2.py`) |
