sparkiscool/nox/docs/generative.md

# Generative parts, heavy runs, save and print

Every generated part uses the topology engine `nox/topo` (default since 24 Oct, Spark). The old `noxopt.py`, `noxopt_local.py`, `printopt.py` and `noxopt_demo.py` stay in the repo for history and old part scripts only; no new part uses them. Method, settings and test results: `nox/topo/README.md`. Tags: T measured in a cloud run, E estimate.

## The rule
0. **System first, then cut (Spark 24 Oct).** The unit of design is the assembled system, never one piece. Applies to every part that is READY, BUILT, HOLD or in DESIGN, not only new versions.
   - **System pass (one per system, before any piece):** a system model places every printed and bought part in its assembled pose (the system model is `nox/<machine>/<system>.assembly.json` loaded with `nox/assembly.py`, `nox/ASSEMBLY.md`) (`interfaces.py` features, `s500_cad.py`, bought-part data in `dimensions.md` M); the motion artifact and fit checks use the same model. It carries the system cases: flight (hover, max thrust, yaw), crash (drop on an arm, a corner, the nose), swap and catch loads, handling and transport, masses from the parts list, each applied where it acts on the real machine (motor, pack, wheel, plunger). Solve the assembled system (a coarse `topo` run over the joined envelope, or an FE / frame model) and decide the cuts there: pieces that fit the 180 cube, print on their largest flat face, assemble in order and can be serviced, joints where the stress is low.
   - **Piece requirements (the system pass's output):** for every piece, in `dimensions.md` section "System <name>": envelope, interfaces (positions, fasteners, pins, pads), joint reactions per system case, its mass slot `budget_g` (a soft target, `dimensions.md` L Mass budget), the stiffness it must give at each joint, and the worst index it must reach so the assembled system meets its own target. These are the piece's `topo` parameters.
   - **System cases and targets:** `dimensions.md` L for every drone (hover, flight, landing, crash in 14 directions, swap, handling; cage margin, balance, sensor-mount mode, breaking order, index targets), plus the system's own section. Every case acts at the CG of the mass it moves.
   - **Mounted for what it carries (Spark 24 Oct):** a piece's supports are the faces and fasteners it really bolts to, its loads are the masses it holds times the L cases at their CG plus the joint reactions from the system pass. A heavy or one-sided payload (the L2: heavy, one mounting face) is modelled as its mass at its CG on a rigid link to its mounting face, so the piece sees the full moment, and gets a stiffness / first-mode target and a load path back into the core (triangulated, never a stalk).
   - **Piece pass (own session or chat, in parallel):** each piece runs its own `topo` (or drawn design) with those parameters: loads = the joint reactions, supports = the neighbour interfaces, targets from the table. Never an invented support or a guessed load on one piece.
   - **Assembled recheck:** the pieces go back into the system model: fit 0 mm³ between pieces and with bought parts, the assembled worst index per case with the joints modelled, mass and CG of the whole, first modes where it flies. A miss goes back to the system pass, not to a local patch.
   - **Compact layout (Spark 24 Oct, every design):** the system pass places the parts by an optimization that minimises the assembled bounding volume and the largest extent (with the guard / bumper offsets included) under the fit, view (lidar hemisphere, camera frustum), access (fasteners, battery swap, cables) and service constraints. Nest parts round the load path, heaviest on the support axis; no empty column or plate between parts that are only stacked or bolted on. The run reports bounding volume (L) and extents (mm) of the assembled system.
   - **Cage first (every drone, Spark 24 Oct):** the full cage (top, sides, bottom) is in the system model. Contact-first check on the assembled model: for every direction, the support distance of the cage exceeds that of every protected part (pack, cartridge, receiver, electronics, props, motors, camera) by ≥ 3 mm (DEFAULT; alt 1 mm); openings the box needs (cartridge path, head) are recessed behind cage members (margin ≥ 0 inside their cone). The cage layout comes from an optimisation (frame or `topo`) on the system cases, triangulated with load paths closed into the core; report its worst index, mass and lowest mode.
   - **Geodesic cage (every drone, Spark 26 Oct, with a photo of the Flyability Elios 3: "for all cages in the future i want it to be in this format"; "go with the larger cells that save weight, since we will use 6mm diameter tubes"; "not necessarily a sphere, it needs to form itself to the drone and try to be as compact as possible, probably closer to a disk"; "think of it as adding the triangle shapes to the original drone layout ... replacing that cage only"):** the drone layout is designed as usual and only the cage changes. Shell: the convex hull of every part with its margin (prop disks 12 off, the rest 3 off the tube surface, the belly clipped at the opening plane) is the target; a class-I icosahedral geodesic (frequency 2 DEFAULT, Spark; a vertex up, xz a mirror plane, so the shell is symmetric) is laid on an ellipsoid of the hull's half extents x a start scale, then every node is pushed out along its direction until the convex hull of the nodes holds the target; the start scale is scanned and the smallest valid shell is kept (converged, opening ring intact, prop disks 12 off, swap column clear, DEFAULT; no tube-length limit, Spark 27 Oct: "there is no limit for the tube length ... just create the structure ... stay to using 6mm and 3mm tubes"). Mirror symmetry (Spark 27 Oct: "perfect left and right symmetry, the nose and tail can be different"): every node has its mirror partner and moves with it; the hull is merged into flat facets, a facet and its mirror take one triangulation, a facet on the centre plane is fanned from a centre node (or its on-plane vertex near the centre) when its own triangles are not their own mirror; every link without its mirror gets it. Balance: the motor square goes onto the CG with the shell rebuilt each time; where the shell pattern flips between two neighbours (a node more or less) the closer one's pattern is kept and the motor square trimmed onto the CG with it. Tubes 6 mm carbon (6/4 DEFAULT, socket bore 6.2, Spark 27 Oct from the coupons, `runs/rod_coupons/v2/`) on printed PETG nodes (Spark 27 Oct: PETG, not TPU; on the frame model PETG joints lift the cage's lowest mode from ~26 to ~126 Hz and the L2 head from 120 to 206 Hz, F on E, `runs/overseer_head_cage/concept/`; a node is the cheap part that cracks first in a crash and is replaced). Opening: a ring of nodes on an ellipse round the swap zone (the receiver footprint + 30 a side, DEFAULT), 3 under the cartridge, chords outside the zone. Load paths: 3 spokes from each arm tip, 2 core ties from each bottom plate edge, the sensor mount tied behind its field, the belly tied to the ring; every link 12 off the disks and clear of the pack. The box funnel, latch zone and keep-alive contacts are designed round the shell by the box catch session. Check: `system_check` shell (the manifest's `cage_shell`: closed outside its declared openings, a cone or the ring of nodes round the hole) gates with cage first. Sensors with a field (Spark 26 Oct: "the lidar needs to be outside the cage and not be blocked at all ... guard is okay as long as it's outside the view"; the cameras' views unobstructed): they are left out of the target; every shell node stays NODE_R + 3 behind each view limit (the L2 base plane for its 90° mode; for each camera the one view face, + 2°, that the target clears; a mirror pair of limits is applied worst-first per node and the pair averaged so the shell keeps its mirror), the sensor placed so the target fits behind those limits with a little slack, a node grid laid on the resulting flat front face; their mount and guard (a ring behind the L2 base plane; a guard over a camera only behind its lens) and every link are kept out of every view; the mount is braced into the core (lugs to the front arm beams, a pyramid, never a stalk on the keels) and its lugs are the printed fuse that lets go before the sensor. In `system_check` such a sensor is a field opening (`field: true`, its field cone: L2 75° of its 90° field so the ring's lateral cover stays gated, each camera its diagonal + 4°). Cameras (Overseer, Spark 27 Oct: "put the two cameras on either side the lidar pointing so their field of view is maximized"): every orientation of the mirrored pair ranked by the union of their fields, then the share of the L2 field they see; the first with a mount beside the sensor where nothing of the drone is in view and the shell target clears a view face wins: no cage-first requirement inside the cone, gated outside it, probes skipped for it (a probe can always reach a face outside the cage) and its protrusion past the cage reported. Thinning (Overseer cage v5, Spark 27 Oct: "divide the number of rods by half", "get rid of the number of same length rule"): the free nodes thinned (mirror pairs, farthest first), the base loop kept, re-triangulated mirror-symmetric, the nodes moved only as far as the target, the view limits and the swap zone need (`nox/overseer/cage_equal.py`, CE_MODE=reduce); the drone is then built round the fixed cage (`layout_v5.py`, `V5_FROZEN`). Reference: `nox/overseer/layout_v5.py`. **Shared ring and the Scout (Spark 27 Oct):** the Overseer's bottom ring is the shared funnel interface (its nodes on the datum: catch centre, 3 under the cartridge flat bottom); the Scout's bottom is that loop's 4 side nodes, its "rectangle part" (nose and tail nodes dropped: "the scout can just use less ramps"; on the Overseer cage v5 hexagon since 27 Oct), so one reverse funnel takes both; its swap opening is what they leave round the receiver. A ring of thinner rods sits (r_overseer − r_scout)·√2 further under its cartridge (a thinner rod rides that much lower on a 45° ramp) so both cartridges stop at the same height, and no link comes within 30 above its plane inside the opening or 40 past its ends (the ramps; design center 27 Oct); shell nodes and rods enter that band only where the funnel's ramp check clears them. The Scout's cage is every rod 3.0 solid ("these are all 3mm"), about half of cage v1's 123 rods (≤ 62), any rod length, a race-car look and no small triangles: a free pattern, not a geodesic: the margin hull is grown by an offset along 6 directions, clipped at the drone's own top (a flat roof), with a raised tail point behind (no nose point under the camera: Spark "get rid of that sharp section under the camera"); nodes go on its corners farthest-outside first in mirror pairs until the hull holds the drone; a hull triangle with every edge under 70 and a mirror pair closer than 70 collapse to one node, and the shell is pushed again; the offset is scanned and, within the rod cap, the most compact shell with no small or sliver triangle (every rod ≥ 45) wins; bottom nodes stay Ø20 (the funnel contact), the others are printed Ø12 for 3.3 sockets. Lean links: up to 2 spokes per arm tip to nodes on its own side, 1 bay tie per receiver corner (nose and tail) to the bottom nodes, the camera as close to the drone as its clear view allows ("as compact as possible"), in a printed PETG cradle round it (lips over and under it, all behind its lens) on printed arms into at least 3 non-collinear cage nodes ("not on rods but on printed petg": no carbon to it, nothing to the drone body; PETG for the ≥ 100 Hz mount, TPU only as board washers); the arm roots are the printed fuse. Balance: the catch shift, with the Radxa and the UBEC in a tail bay behind the receiver to carry the nose camera. The frame model then sizes the long rods (thicker only where it needs). Check: `tools/review_precheck.py` 13 (every rod r 1.5, `cage_shell` total_rods ≤ 62). Reference: `nox/scout/v3/layout_v3.py`.
   - **Carbon rod size (every drone, Spark 24 Oct):** start every rod at 3.0 solid (the geodesic shell: 6 mm tubes, above); the sizing steps a rod to a thicker stock (4.0 / 5.0 solid, then tube from 6/4 up) only where a load case or a cap needs it, socket bore 6.2 / 3.2 (Spark 27 Oct from the coupons, `runs/rod_coupons/v2/`: the largest v2 coupon fits standing and sideways; OD + 0.3 was loose in PETG). Every non-3.0 rod is listed with its stock and length in the summary (carbon list) and in `nox/parts-list.md`.
   - **Carbon where its length earns it (every drone, Spark 24 Oct):** cage members are typed by length in the system model. Break-even L = 2 x socket (0.57 g, M) / (PETG strut g/mm - rod g/mm), with a 6 x 6 PETG strut 0.0457 g/mm (C, 1.27 g/cm3) and a 3.0 carbon rod 0.011 g/mm (C): about 33 mm (DEFAULT). Members shorter than that, or linking printed parts that sit close together, are modelled as printed PETG struts (E 2000 MPa E, sigma allow 25 MPa E; >= 6 x 6 per the attachments rule) with no sockets, and their nodes merge into one printed piece (into the mount when one end is a core joint). The summary lists the carbon rods (count, shortest length, a reason for each below the break-even) and the printed struts; the count objective (fewest carbon pieces + printed parts) is reported next to mass.
   - **Clear air, clear view, clean wiring (CLAUDE.md design list 8, DEFAULT):** nothing but arms and thin rods in the prop wash; lidar and camera fields of view free except thin rods, blocked share reported; every cable has a drawn route, strain relief and a connector it can be unplugged at; heat sources sit in airflow. Sensor mounts (FC, camera, lidar): first mode ≥ 100 Hz (E until the vibration log gives the rotor band), reported in Hz. Breaking order: `dimensions.md` L.
   - **Concept check (before any piece run or detailed CAD, 24 Oct DEFAULT):** the system pass ends with (1) the rule checks run on the layout (the CLAUDE.md "Every drone design" list: cage first, compact bounding volume and extents, access, fit, mass and CG pack in and out, sensor-mount modes; `python3 nox/system_check.py <manifest>`; the manifest's `access` paths (pack swap, connectors, USB, fastener key lines, swept and checked against every part) and the crash probes (edges and posts between cage members, not only flat walls) are part of it and gate like cage first); (2) two alternatives weighed in one line each (what each wins and loses, the numbers); (3) the `review` agent in concept mode on the layout; (4) the layout artifact published and one line to Spark.
   - **Visuals (Spark 24 Oct):** every idea put to Spark (a concept, the alternatives weighed, a proposed change, a decision he is asked about, a mechanism he asks to understand) is shown, not only described: a published artifact drawn from the real geometry and numbers (top view and section to scale, the sequence of states for anything that moves, the wiring for anything electrical, side by side for alternatives), its link in the same reply, its source file committed (`runs/<part>/<version>/` or the part's folder) so the repo stays the only source. A reply that proposes or explains a design without one is incomplete. Then continue on the chosen layout as DEFAULT, never wait. This is where a flimsy, stacked or column layout is caught, before hours of runs.
   - **Three strikes:** a part whose third version in a row fails the gate, a check, the assembled recheck or Spark's look goes back to its system pass (requirements, layout, cuts), never to a fourth version of the same piece. The log line names the strike.
   - **Existing parts:** a READY, BUILT or HOLD part gets the assembled recheck against its system's requirements. Pass: it keeps its state and its summary gets the System line. Fail: State back to DESIGN, File cell marked do not print, a new version from the piece pass. A PRINTED or PRINTING part is reported (the result in its row) and fixed in its next version.
1. **Drawn = mounting + must-haves only:** fastener seats with their boss walls, mating and contact faces, pin bores, rod sockets, connector seats, flexures, hooks, windows, TPU feet, each at its smallest volume. Everything else is generated. Every drawn body lies inside the envelope and the design space can reach it. Access cuts for bolt heads and tools are never wider than the pad they serve. A drawn body must keep a 2 mm core at the solid gate's 2.0 mm erosion (bosses about 12 mm round on an M3, plates at least 6 mm under 6.25 mm members); `topo` checks reachability before the first solve and raises if a body cannot be joined.
2. **Organic finish (default, Spark 23 Oct):** the whole part is one smooth field of round members blended with fillets; only holes, bores and flat contact faces stay geometric. Drawn bodies stay only as 2.5 mm functional skins next to cuts and the envelope's outside; the mounting features the main support holds stay whole. Do not switch it off (`finish="drawn"`) without Spark.
3. **Layout:** robust (eroded / nominal / dilated) stiffness design to a mass target over every load case plus tie loads on every drawn body (`topo` adds those). Minimum member in mm; the engine raises it to what the solid gate needs (6.25 mm). Pick the bed face first.
4. **Stop** at ≤ 2 % grey or the end of the beta 32 stage. Hard cap 6 h, then build from the last checkpoint.
5. **No patching:** no grey fill, dilation, member growing or "keep the largest body". A detached feature means a setup or engine fix and a rerun. `solid_check` PASS or the part does not exist.
6. **Strength:** `topo` writes every case's as-built index. A topology part replaces a drawn or older one only if it beats the old part's worst index on the same FE grid (`python3 -m topo.compare`) and passes the solid check.
7. **Engine first:** a fix that would help every part goes in `nox/topo`, never in one part's script or mesh. One session edits the engine at a time.

## How-to
Worked parts: `nox/topo/demos/holder.py` (strut frame, the look test part), `nox/topo/demos/stand.py` (box stand parts), `nox/overseer/scan_stick/*_topo_*.py`.
```python
from topo import Part, Settings, optimise
def setup(h):
    p = Part("my_part", h, drawn, cuts, env, build="+z", material="PETG")
    p.support("default", region); p.load("case", region, (fx, fy, fz), cls="misuse")
    return p
optimise(setup, h=1.0, gen_cm3=6.0, out_dir="runs/my_part/v1", name="my_part", settings=Settings(), git=True)
```
The run writes `runs/<part>/<version>/` with the STL, `<part>_view.stl`, `preview.png`, `log.txt`, `result.json` (mass, worst index per case, solid check, function check), checkpoints. Then `print_orient.py` and the save steps below. Any `Settings` field can be set per run: `python3 -m topo.run <demo> --set key=value`.

| Default | Value |
|---|---|
| Grid | h 1.0 (a coarse 2h stage runs first); small parts 0.5 to 0.8 |
| Minimum member | 3.2 mm asked, raised to 6.25 mm for the solid gate |
| Finish | `organic`: 2.5 mm skins, 2.5 mm fillets, 1.0 mm rounded rims |
| Case weighting | p-mean, P 6, cases over the full solid's compliance; ties weight 0.5 |
| Mass target | `gen_cm3`, generated volume; lower it while the as-built worst index stays at target; never below what the strength, stiffness and function targets need, whatever the budget slot says |
| Solver | Pardiso on active dofs; multigrid CG beyond the RAM budget, chosen automatically |

Known limits (T): the layout is a stiffness design; strength is reported per case, not optimised. A keep-out with a sharp edge that members must bend round sets the worst index (holder: rounding the battery channel edge r 3 mm took 0.569 to 0.493 at 11.7 g). Engine edit: `cd nox && python3 -m topo.test_topo` once, commit, one `log.md` line.

## Heavy runs (cloud box)
- Branch `run/<part>-<version>`, one `run-part` worker per run, each in its own worktree. Independent runs start together (Spark 24 Oct): as many as fit the box's memory budget below, the rest in sibling cloud sessions (`create_session`), never a queue. Only a run that needs another's result waits for it. **Checks run beside, never before (Spark 27 Oct):** every piece of a system pass (a left / right pair counts once, its mirror is the same run), every variant and every quick check of them (a coarse smoke run, a gate test, a fit probe) start in the same turn; a check that fails stops the full run it covers, which restarts with the fix. A run that does wait writes `Waited for: <the run or result>` in its `summary.md`. `run_bg.txt` records each run's start, and `tools/review_precheck.py` item 12 fails a PR whose runs started over 30 min apart without that line. Start it with `python3 tools/run_bg.py runs/<part>/<version> -- python3 <script>` under Bash `run_in_background` (a run lives only while a command runs; it commits + pushes checkpoints `ckpt <n>` every 10 min and wakes its starter once, `docs/sessions.md` Usage). Checkpoint every ~10 iterations; a reclaimed box keeps the branch, not the files. Commit checkpoints to the run branch while running; the PR to `main` carries only the final mesh, preview, summary, `result.json` and log (drop `ck.npz`, `coarse_ck.npz`, `nohup*.txt`, videos and any `ckpt` subfolder from the PR; keep `density.npz` only if a later rebuild reads it). A run that a newer version supersedes (not in `print/`, not named in `current-parts.md`, `dimensions.md` or a script as an input) is slimmed: delete its meshes, `.npz`, `.npy`, `.mp4`, `nohup*.txt` and checkpoint folders, add `RETIRED.md` with the recovery command; summary, result, preview and log stay.
- **Drawn first (Spark 27 Oct: "why were they doing [topology] after checks passed ... fix it for the future").** The cage node runs spent about an hour each to add 0.3 g to a 14.9 g drawn node (node 7, v3). So before any topology run, `tools/run_estimate.py` first runs `topo.drawn_check` on the exact setup the run would use: the drawn bodies minus the cuts, alone, through `nox/solid_check.py` and the as-built strength check (`topo.build.strength`, every real load case of the part, the system's loads). PASS (solid PASS, worst index <= 1.0, `topo.run.DRAWN_MAX`): `estimate.json` says `"run": "not needed"`, no smoke and no run; the drawn part is saved (it is the part: Save and print below, on that mesh). FAIL: the smoke and the run go ahead, and the run's summary names what the drawn part failed. `--force` runs anyway, only with a `Forced: <reason>` line in the run's summary (a lighter shape the drawn bodies cannot give, a stiffness target the strength check does not see). A part script can do the same step itself (`cage_node.py <node> --drawn`). The load cases must be the system's (a lookup that misses a member falls back to an estimate and passes what it should not: check every member found its load).
- **Drawn is attachment only (Spark 27 Oct).** What a setup draws is only what the part must have at an interface: the pad, post, boss or socket wall round a hole, bore or contact face, and the gusset that joins it (Attachments are drawn). Everything that carries load between them is generated. Two ways this went wrong on the Overseer hub deck, and the check that now stops each: (1) a failed run patched by drawing solid (v7 core blocks after v6's strength fail, v9 bars after v8's drawn-body fail: 76 % of the front was drawn and Spark saw the bulk at the socket mouths) -> `review_precheck` 16 fails a PR whose drawn mass (`result.json` drawn_g) grew > 5 % and > 1 g after a FAILED version unless `summary.md` has a `Drawn added:` line naming each new feature and its interface, which the review checks is an attachment; (2) loaded drawn features left outside the design room (v10: the keel sockets beyond the room's end, so nothing could grow behind them) -> the smoke's room audit measures, for every loaded drawn feature (the solid cells at a load case's nodes and the drawn cells within 8 mm), the share of its exposed surface on the design room and stops below 35 % (exit 3, `estimate.json` room_audit FAIL, no run; `review_precheck` 14 fails the PR). The fix for either is in the setup: open the room round the loaded feature to just short of its mouth or face, move the cuts that pinch it, add volume, or change the loads; then smoke again.
- **Measure before quoting (Spark 27 Oct).** Before a run starts or is quoted, smoke it: `python3 tools/run_estimate.py runs/<part>/<version> -- python3 <script> <args>` (the exact command the run will use). It swaps `topo.optimise` for 3 coarse and 3 fine iterations (no checkpoint, no build, no engine edit) and writes `estimate.json`: s per iteration per stage, cases (load + ties: each is a solve and a full-grid F and U column, so memory scales with cases x cells), design cells, peak memory GB (M), and the wall time as a range (E: coarse 40..70 iterations, fine 50..120, build 5..15 min, the spread of the runs to 27 Oct). The smoke is part of the run: it takes minutes, it is committed in the run folder, and the run-part worker starts the job only after it. Quote Spark that range in Pacific time ("about 1:30 to 2:40 AM PDT"), never a number carried from another part. Runs share a box only when their smoke peaks x 1.15 sum under 75 % of its RAM (about 11.8 GB of 16); the next run goes to a sibling session (`create_session`), never a queue. A smoke whose peak alone is over that budget: cut cases (lean loads, tie settings) or coarsen h before starting. Report only the final numbers. Hard cap 6 h. `review_precheck` 14 fails a PR whose topo run started after this rule without `estimate.json`.
- A box that does not fit in RAM: run it coarse first (h 3.0), then h 2.0 with cells outside that region + 10 mm set void. Give the mass target as volume, not a share.
- Done: `runs/<part>/<version>/summary.md` in the form below, `result.json` (mass g M, worst index + case, solid_check pass, bed face, bed contact mm², peak memory GB, wall time), `preview.png`; `python3 tools/runs_index.py`; commit, push, PR.

## Save and print (done = saved)
A part is finished only when one turn does all of: `solid_check.py` PASS on the exact file; `print_orient.py` pass with the STL saved on its largest flat face (no first-layer island under 20 mm² lasting over 10 mm, no free-standing post over 10 mm); file at `print/<part>_<version>.<ext>` (zip over 50 MB; the File cell in `current-parts.md` is the only pointer to it); State READY; one `log.md` line; `summary.md` + `preview.png` (`render_preview.py <mesh> --mat PETG|TPU --prev <last g>`); committed, pushed, PR open. **Picture of every print file (Spark 24 Oct):** one PNG per file in `print/`, rendered from that exact file (`render_preview.py print/<name> --out runs/<part>/<version>/preview_<name>.png`; a one-file part may keep `preview.png`), named on the summary's Previews line, and sent in the ready-to-print reply with SendUserFile (`display: render`, one call, every file) before the text. Spark sees the pictures and this before "ready to print":
```
<part> <version>: ready to print
System: <system>, assembled worst index <x> in <case> (was <y>), fit <mm³> (M), mass <g> (M), CG <where>
Weight: <g> (M), was <g>
Strength: worst index <x> in <case> (was <y>); weakest spot <where>   [box parts: "fits" + support g]
Solid: solid_check PASS
Print: <bed face>, bed contact <mm²> (M), tree supports <g>; file print/<name>
```
**Into the system as CAD (Spark 27 Oct: "if the nodes are done why wasnt it merged into the artifact as its actual cad files ... thats the default").** Saving a part includes putting it in its system: the saved mesh (the print file placed in the drone or box frame, or its assembled copy in the run) replaces the part's placeholder (box, sphere, mass point, envelope) in `<system>.assembly.json`, system_check reruns on it, and the system artifact is republished at the same URL showing it, saved parts marked apart from concepts. The session that owns the system does it the turn it hears of the save (`docs/sessions.md`); a part session that cannot reach it does it in its own PR. Concept pieces may go in too, marked concept.
Every "ready to print" reply (and every reply that names a file to print) ends with one ready-to-paste prompt for a print and slicing session on the laptop (Spark 23 Oct), in a code block, filled in for that file:
```
Print and slicing session (opus, medium, computer control on the laptop). In the nox clone: git pull on main.
Part: <part> <version>, file print/<name> (<g> g <material>, <x> x <y> x <z> mm, solid_check PASS).
Bambu Studio, A1 mini, <material>: import the file as saved (<bed face> down, do not re-orient), tree(auto) supports 30° global<, brim 5 mm if bed contact < 400 mm²><, part rules>.
Ctrl+R slice; report time, filament g, support g (over ~25 % of the part mass: stop and tell Spark). Check <what to keep clear, e.g. the thread>.
Send to the A1 mini only after Spark says go. Then one row at the top of nox/print-log.md (State PRINTING), commit, push.
```
Slicing: tree(auto) supports, 30°, global; brim 5 mm under 400 mm² of bed contact; box parts 4 walls, 15 % gyroid. Report bed face, bed contact, support g, time; over ~25 % of the mass in supports goes back to the designer. A print that fails for orientation is re-sliced; one that snaps at a member is a design failure (`log.md` failure log). The moment a print is sent: one row at the top of `nox/print-log.md`, State PRINTING. A printed version is frozen; any change is a new version. Bambu Studio on the laptop: one window, never launch it while running, type paths, Ctrl+R slice, Ctrl+G export; set orientation in the `.3mf` transform if a remote session must re-orient.
