sparkiscool/nox/runs/index.md

# Runs

_107 runs · rebuilt 2026-10-27 07:48_

## Latest per part

| Part | Version | Status | Mass | Worst index | Solid | Summary |
|---|---|---|---|---|---|---|
| arm | v5 | DONE | · | ·  | PASS | [runs/arm/v5](runs/arm/v5/summary.md) |
| arm_eccbush | v1 | DONE | 0.8 (M) | 0.11 in eccentric wheel load 52 N (E: preload 30 + separating) bending the shank, 2.8 MPa (E, hand calc) vs 25 across layers (E) | PASS | [runs/arm_eccbush/v1](runs/arm_eccbush/v1/summary.md) |
| arm_pinion16 | v2 | · | 3.1 (M) | [0.76, 'power cut, bumped head']  | · | [runs/arm_pinion16/v2](runs/arm_pinion16/v2/summary.md) |
| arm_rail | v2 | · | 49.4 (M) | [0.28, 'head stall free']  | · | [runs/arm_rail/v2](runs/arm_rail/v2/summary.md) |
| arm_vwheel | v1 | DONE | 2.8 (M) | 0.66 in insert 60 N (E): 228 N (E) axial on an outer fixed wheel, all on one flank, Hertz 60 MPa (E) vs 92 yield onset (E, hand calc) | PASS | [runs/arm_vwheel/v1](runs/arm_vwheel/v1/summary.md) |
| bar_half | organic-v2 | · | 74.9 (M) | ·  | PASS | [runs/bar_half/organic-v2](runs/bar_half/organic-v2/summary.md) |
| battery_latch | v1 | · | · | ·  | · | [runs/battery_latch/v1](runs/battery_latch/v1/summary.md) |
| box_catch_assembly | v0 | DONE | 673 (E) | ·  | · | [runs/box_catch_assembly/v0](runs/box_catch_assembly/v0/summary.md) |
| box_electronics | v1 | DONE | · | ·  | · | [runs/box_electronics/v1](runs/box_electronics/v1/summary.md) |
| bracket_jA | organic-v1 | · | 43.5 (M) | ·  | PASS | [runs/bracket_jA/organic-v1](runs/bracket_jA/organic-v1/summary.md) |
| detent | v3 | · | 6.7 (M) | [0.18, 'detent holding 0.55 N.m, keyed bearing (E)']  | · | [runs/detent/v3](runs/detent/v3/summary.md) |
| funnel_panel | v7 | DONE | 80.0 (M) | 0.91 in press u60 v90 | PASS | [runs/funnel_panel/v7](runs/funnel_panel/v7/summary.md) |
| holder | organic-v1 | · | 10.2 (M) | ·  | FAIL | [runs/holder/organic-v1](runs/holder/organic-v1/summary.md) |
| hook_latch | v1 | · | · | ·  | · | [runs/hook_latch/v1](runs/hook_latch/v1/summary.md) |
| hub | v6 | · | 188.6 (M) | 3.40 in power cut carrying: head A falls to the park stop [Overseer] [misuse] | FAIL | [runs/hub/v6](runs/hub/v6/summary.md) |
| motor_mount | organic-v1 | · | 17.9 (M) | ·  | FAIL | [runs/motor_mount/organic-v1](runs/motor_mount/organic-v1/summary.md) |
| overseer_assembly | v0 | DONE | 2332 (E) | ·  | · | [runs/overseer_assembly/v0](runs/overseer_assembly/v0/summary.md) |
| overseer_core | v1 | · | 3419.7 (M) | ·  | · | [runs/overseer_core/v1](runs/overseer_core/v1/summary.md) |
| overseer_layout | v3 | · | · | ·  | · | [runs/overseer_layout/v3](runs/overseer_layout/v3/summary.md) |
| scan_stick | v13 | DONE | 42.0 (M) | 0.30  | PASS | [runs/scan_stick/v13](runs/scan_stick/v13/summary.md) |
| scan_stick_base | v13 | · | 328.1 (M) | ·  | FAIL | [runs/scan_stick_base/v13](runs/scan_stick_base/v13/summary.md) |
| scan_stick_cam | v7 | DONE | 13.3 (M) | 0.32 in impact 50 g 4 | PASS | [runs/scan_stick_cam/v7](runs/scan_stick_cam/v7/summary.md) |
| scout_layout | v11 | · | · | ·  | · | [runs/scout_layout/v11](runs/scout_layout/v11/summary.md) |
| test_glue_lap | v1 | DONE | 3.9 (M) | ·  | PASS | [runs/test_glue_lap/v1](runs/test_glue_lap/v1/summary.md) |
| test_layer_pull | v1 | DONE | 28.6 (M) | ·  | PASS | [runs/test_layer_pull/v1](runs/test_layer_pull/v1/summary.md) |
| test_post_pull | v1 | DONE | 34.6 (M) | ·  | PASS | [runs/test_post_pull/v1](runs/test_post_pull/v1/summary.md) |
| test_socket_coupon | v2 | DONE | 7.9 (M) | ·  | PASS | [runs/test_socket_coupon/v2](runs/test_socket_coupon/v2/summary.md) |

## All runs, newest first

| Date | Part | Version | Status | Mass | Worst index | Solid | Bed face | Peak mem | Wall | PR |
|---|---|---|---|---|---|---|---|---|---|---|
| 2026-10-27 07:47 | scout_layout | [v11](runs/scout_layout/v11/summary.md) | · | · | · | · | · | · GB | · min | · |
| 2026-10-27 06:53 | scout_layout | [v10](runs/scout_layout/v10/summary.md) | · | · | · | · | · | · GB | · min | · |
| 2026-10-27 06:02 | overseer_core | [v1](runs/overseer_core/v1/summary.md) | · | 3419.7 (M) | · | · | · | · GB | · min | · |
| 2026-10-27 06:02 | scout_layout | [v7](runs/scout_layout/v7/summary.md) | · | · | · | · | · | · GB | · min | · |
| 2026-10-27 06:02 | scout_layout | [v8](runs/scout_layout/v8/summary.md) | · | · | · | · | · | · GB | · min | · |
| 2026-10-27 06:02 | scout_layout | [v9](runs/scout_layout/v9/summary.md) | · | · | · | · | · | · GB | · min | · |
| 2026-10-27 04:36 | scout_layout | [v6](runs/scout_layout/v6/summary.md) | · | · | · | · | · | · GB | · min | · |
| 2026-10-27 02:37 | arm_pinion16 | [v2](runs/arm_pinion16/v2/summary.md) | · | 3.1 (M) | [0.76, 'power cut, bumped head'] | · | · | · GB | · min | · |
| 2026-10-27 02:37 | arm_rail | [v2](runs/arm_rail/v2/summary.md) | · | 49.4 (M) | [0.28, 'head stall free'] | · | · | · GB | · min | · |
| 2026-10-27 02:37 | arm_rail | [v3](runs/arm_rail/v3/summary.md) | · | 56.6 (M) | [0.11, 'dropped Overseer'] | · | · | · GB | · min | · |
| 2026-10-27 02:37 | bar_half | [organic-v2](runs/bar_half/organic-v2/summary.md) | · | 74.9 (M) | · | PASS | · | · GB | · min | · |
| 2026-10-27 02:37 | bar_half | [topo-v2](runs/bar_half/topo-v2/summary.md) | · | 76.1 (M) | · | PASS | · | · GB | · min | · |
| 2026-10-27 02:37 | bar_half | [topo-v3](runs/bar_half/topo-v3/summary.md) | · | 71.2 (M) | · | PASS | · | · GB | · min | · |
| 2026-10-27 02:37 | battery_latch | [v1](runs/battery_latch/v1/summary.md) | · | · | · | · | · | · GB | · min | · |
| 2026-10-27 02:37 | battery_latch | [v2](runs/battery_latch/v2/summary.md) | · | · | · | · | · | · GB | · min | · |
| 2026-10-27 02:37 | battery_latch | [v3](runs/battery_latch/v3/summary.md) | · | · | · | · | · | · GB | · min | · |
| 2026-10-27 02:37 | battery_latch | [v4](runs/battery_latch/v4/summary.md) | · | · | · | · | · | · GB | · min | · |
| 2026-10-27 02:37 | bracket_jA | [organic-v1](runs/bracket_jA/organic-v1/summary.md) | · | 43.5 (M) | · | PASS | · | · GB | · min | · |
| 2026-10-27 02:37 | bracket_jA | [organic-v2](runs/bracket_jA/organic-v2/summary.md) | · | 34.6 (M) | · | PASS | · | · GB | · min | · |
| 2026-10-27 02:37 | bracket_jA | [organic-v3](runs/bracket_jA/organic-v3/summary.md) | · | 36.8 (M) | · | PASS | · | · GB | · min | · |
| 2026-10-27 02:37 | bracket_jA | [organic-v4](runs/bracket_jA/organic-v4/summary.md) | · | 36.8 (M) | · | PASS | · | · GB | · min | · |
| 2026-10-27 02:37 | bracket_jA | [organic-v5](runs/bracket_jA/organic-v5/summary.md) | · | 36.9 (M) | · | PASS | · | · GB | · min | · |
| 2026-10-27 02:37 | bracket_jA | [topo-v2](runs/bracket_jA/topo-v2/summary.md) | · | 35.9 (M) | · | FAIL | · | · GB | · min | · |
| 2026-10-27 02:37 | bracket_jA | [topo-v3](runs/bracket_jA/topo-v3/summary.md) | · | 36.0 (M) | · | PASS | · | · GB | · min | · |
| 2026-10-27 02:37 | bracket_jA | [topo-v4](runs/bracket_jA/topo-v4/summary.md) | · | 36.0 (M) | · | PASS | · | · GB | · min | · |
| 2026-10-27 02:37 | detent | [v3](runs/detent/v3/summary.md) | · | 6.7 (M) | [0.18, 'detent holding 0.55 N.m, keyed bearing (E)'] | · | · | · GB | · min | · |
| 2026-10-27 02:37 | holder | [organic-v1](runs/holder/organic-v1/summary.md) | · | 10.2 (M) | · | FAIL | · | · GB | · min | · |
| 2026-10-27 02:37 | holder | [organic-v10](runs/holder/organic-v10/summary.md) | · | 12.5 (M) | · | PASS | · | · GB | · min | · |
| 2026-10-27 02:37 | holder | [organic-v11](runs/holder/organic-v11/summary.md) | · | 11.7 (M) | · | PASS | · | · GB | · min | · |
| 2026-10-27 02:37 | holder | [organic-v12](runs/holder/organic-v12/summary.md) | · | 12.5 (M) | · | PASS | · | · GB | · min | · |
| 2026-10-27 02:37 | holder | [organic-v2](runs/holder/organic-v2/summary.md) | · | 10.9 (M) | · | FAIL | · | · GB | · min | · |
| 2026-10-27 02:37 | holder | [organic-v3](runs/holder/organic-v3/summary.md) | · | 12.5 (M) | · | FAIL | · | · GB | · min | · |
| 2026-10-27 02:37 | holder | [organic-v4](runs/holder/organic-v4/summary.md) | · | 10.8 (M) | · | FAIL | · | · GB | · min | · |
| 2026-10-27 02:37 | holder | [organic-v5](runs/holder/organic-v5/summary.md) | · | 11.7 (M) | · | FAIL | · | · GB | · min | · |
| 2026-10-27 02:37 | holder | [organic-v6](runs/holder/organic-v6/summary.md) | · | 11.3 (M) | · | FAIL | · | · GB | · min | · |
| 2026-10-27 02:37 | holder | [organic-v7](runs/holder/organic-v7/summary.md) | · | 11.7 (M) | · | PASS | · | · GB | · min | · |
| 2026-10-27 02:37 | holder | [organic-v8](runs/holder/organic-v8/summary.md) | · | 11.7 (M) | · | PASS | · | · GB | · min | · |
| 2026-10-27 02:37 | holder | [organic-v9](runs/holder/organic-v9/summary.md) | · | 11.7 (M) | · | FAIL | · | · GB | · min | · |
| 2026-10-27 02:37 | holder | [topo-v1](runs/holder/topo-v1/summary.md) | · | 10.3 (M) | · | FAIL | · | · GB | · min | · |
| 2026-10-27 02:37 | hook_latch | [v1](runs/hook_latch/v1/summary.md) | · | · | · | · | · | · GB | · min | · |
| 2026-10-27 02:37 | hook_latch | [v2](runs/hook_latch/v2/summary.md) | · | · | · | · | · | · GB | · min | · |
| 2026-10-27 02:37 | hub | [v6](runs/hub/v6/summary.md) | · | 188.6 (M) | 3.40 | FAIL | +y (sleeve end on the bed, as v5) | · GB | · min | · |
| 2026-10-27 02:37 | hub | [v6r2](runs/hub/v6r2/summary.md) | · | 184.4 (M) | · | FAIL | · | · GB | · min | · |
| 2026-10-27 02:37 | hub | [v6r3](runs/hub/v6r3/summary.md) | · | 199.3 (M) | · | FAIL | · | · GB | · min | · |
| 2026-10-27 02:37 | hub | [v7](runs/hub/v7/summary.md) | · | 213.3 (M) | · | PASS | · | · GB | · min | · |
| 2026-10-27 02:37 | motor_mount | [organic-v1](runs/motor_mount/organic-v1/summary.md) | · | 17.9 (M) | · | FAIL | · | · GB | · min | · |
| 2026-10-27 02:37 | motor_mount | [organic-v2](runs/motor_mount/organic-v2/summary.md) | · | 18.0 (M) | · | PASS | · | · GB | · min | · |
| 2026-10-27 02:37 | motor_mount | [topo-v1](runs/motor_mount/topo-v1/summary.md) | · | 13.1 (M) | · | FAIL | · | · GB | · min | · |
| 2026-10-27 02:37 | motor_mount | [topo-v3](runs/motor_mount/topo-v3/summary.md) | · | 17.2 (M) | · | PASS | · | · GB | · min | · |
| 2026-10-27 02:37 | overseer_layout | [v3](runs/overseer_layout/v3/summary.md) | · | · | · | · | · | · GB | · min | · |
| 2026-10-27 02:37 | overseer_layout | [v4](runs/overseer_layout/v4/summary.md) | · | · | · | · | · | · GB | · min | · |
| 2026-10-27 02:37 | overseer_layout | [v5](runs/overseer_layout/v5/summary.md) | · | · | · | · | · | · GB | · min | · |
| 2026-10-27 02:37 | scan_stick_base | [v13](runs/scan_stick_base/v13/summary.md) | · | 328.1 (M) | · | FAIL | · | · GB | · min | · |
| 2026-10-27 02:37 | scan_stick_base | [v14](runs/scan_stick_base/v14/summary.md) | · | 296.6 (M) | · | FAIL | · | · GB | · min | · |
| 2026-10-24 18:00 | box_electronics | [v1](runs/box_electronics/v1/summary.md) | DONE | · | · | · | · | · GB | · min | · |
| 2026-10-24 | arm | [v5](runs/arm/v5/summary.md) | DONE | · | · | PASS | · | · GB | · min | · |
| 2026-10-24 | arm | [v5-layout-b](runs/arm/v5-layout-b/summary.md) | DONE | · | · | · | · | · GB | · min | · |
| 2026-10-24 | arm | [v5-layout-c](runs/arm/v5-layout-c/summary.md) | DONE | · | · | · | · | · GB | · min | · |
| 2026-10-24 | arm_eccbush | [v1](runs/arm_eccbush/v1/summary.md) | DONE | 0.8 (M) | 0.11 | PASS | hex flange face down | · GB | · min | · |
| 2026-10-24 | arm_pinion16 | [v1](runs/arm_pinion16/v1/summary.md) | DONE | 3.0 (M) | 0.56 | PASS | gear face (Y 72.5, C) down with a 0.3 (C) elephant-foot inset step, boss up | · GB | · min | · |
| 2026-10-24 | arm_rail | [v1](runs/arm_rail/v1/summary.md) | DONE | 49.9 (M) | 0.23 | PASS | bottom (Y 74 (C): body + both feet, coplanar) | · GB | · min | · |
| 2026-10-24 | arm_vwheel | [v1](runs/arm_vwheel/v1/summary.md) | DONE | 2.8 (M) | 0.66 | PASS | either face (symmetric, C) | · GB | · min | · |
| 2026-10-24 | box_catch_assembly | [v0](runs/box_catch_assembly/v0/summary.md) | DONE | 673 (E) | · | · | · | · GB | 1 min | · |
| 2026-10-24 | detent | [v2](runs/detent/v2/summary.md) | DONE | 2.3 (M) | 0.22 | PASS | arm top face (Y 74.1) down | · GB | · min | · |
| 2026-10-24 | funnel_panel | [v7](runs/funnel_panel/v7/summary.md) | DONE | 80.0 (M) | 0.91 | PASS | contact face | · GB | · min | · |
| 2026-10-24 | funnel_panel | [v8_plain](runs/funnel_panel/v8_plain/summary.md) | DONE | 53.8 (M) | 0.91 | PASS | contact face | · GB | · min | · |
| 2026-10-24 | funnel_panel | [v9_plain](runs/funnel_panel/v9_plain/summary.md) | DONE | 60.3 (M) | 0.80 | PASS | contact face | · GB | · min | · |
| 2026-10-24 | overseer_assembly | [v0](runs/overseer_assembly/v0/summary.md) | DONE | 2332 (E) | · | · | · | · GB | 8 min | · |
| 2026-10-24 | overseer_layout | [v1](runs/overseer_layout/v1/summary.md) | DONE | 2538 (E) | · | · | · | · GB | · min | · |
| 2026-10-24 | overseer_layout | [v2](runs/overseer_layout/v2/summary.md) | DONE | 2332 (E) | · | · | · | · GB | 30 min | · |
| 2026-10-24 | scan_stick_cam | [v7](runs/scan_stick_cam/v7/summary.md) | DONE | 13.3 (M) | 0.32 | PASS | plate bottom | 3.1 (P) GB | 16 min | · |
| 2026-10-24 | test_glue_lap | [v1](runs/test_glue_lap/v1/summary.md) | DONE | 3.9 (M) | · | PASS | flat face (as saved) | · GB | · min | · |
| 2026-10-24 | test_layer_pull | [v1](runs/test_layer_pull/v1/summary.md) | DONE | 28.6 (M) | · | PASS | plate bottom (as saved) | · GB | · min | · |
| 2026-10-24 | test_post_pull | [v1](runs/test_post_pull/v1/summary.md) | DONE | 34.6 (M) | · | PASS | plate bottom (as saved) | · GB | · min | · |
| 2026-10-24 | test_socket_coupon | [v2](runs/test_socket_coupon/v2/summary.md) | DONE | 7.9 (M) | · | PASS | plate bottom (as saved) | · GB | · min | · |
| 2026-10-23 23:31 | scan_stick_cam | [v5](runs/scan_stick_cam/v5/summary.md) | FAILED | 13.0 (M) | 0.31 | PASS | · | 5.7 (P) GB | 44 min | · |
| 2026-10-23 19:52 | scan_stick | [v13](runs/scan_stick/v13/summary.md) | DONE | 42.0 (M) | 0.30 | PASS | -z (flange) | 4.3 (P) GB | 2 min | · |
| 2026-10-23 18:46 | scan_stick_base | [v17](runs/scan_stick_base/v17/summary.md) | DONE | 340.1 (M) | 0.26 | PASS | -z (bottom) | 5.6 (P) GB | 6 min | · |
| 2026-10-23 18:38 | scan_stick | [v12](runs/scan_stick/v12/summary.md) | RETIRED | 42.8 (M) | 0.28 | PASS | -z (flange) | 4.3 (P) GB | 2 min | · |
| 2026-10-23 18:13 | scan_stick_base | [v16](runs/scan_stick_base/v16/summary.md) | RETIRED | 338.9 (M) | 0.26 | PASS | -z (bottom) | 5.6 (P) GB | 6 min | · |
| 2026-10-23 17:52 | scan_stick | [v11](runs/scan_stick/v11/summary.md) | RETIRED | 40.8 (M) | 0.34 | PASS | -z (flange) | 4.3 (P) GB | 2 min | · |
| 2026-10-23 17:31 | scan_stick_base | [v15](runs/scan_stick_base/v15/summary.md) | RETIRED | 334.3 (M) | 0.26 | PASS | -z (bottom) | 5.6 (P) GB | 6 min | · |
| 2026-10-23 17:11 | scan_stick | [v10](runs/scan_stick/v10/summary.md) | RETIRED | 40.0 (M) | 0.36 | PASS | -z (flange) | 4.3 (P) GB | 2 min | · |
| 2026-10-23 15:31 | scan_stick_base | [v12](runs/scan_stick_base/v12/summary.md) | RETIRED | 300.1 (M) | 0.56 | PASS | -z (bottom) | 5.6 (P) GB | 7 min | · |
| 2026-10-23 15:13 | scan_stick_cam | [v4](runs/scan_stick_cam/v4/summary.md) | DONE | 12.6 (M) | 0.28 | PASS | plate bottom | 3.0 (P) GB | 18 min | · |
| 2026-10-23 | arm | [v5-layout](runs/arm/v5-layout/summary.md) | DONE | · | · | · | · | · GB | · min | · |
| 2026-10-23 | scan_stick | [v1](runs/scan_stick/v1/summary.md) | DONE | 86.8 (M) | · | PASS | head: lidar seat | · GB | · min | · |
| 2026-10-23 | scan_stick | [v2](runs/scan_stick/v2/summary.md) | DONE | 61.9 (M) | 0.03 | PASS | lidar seat (4 pads) down | 3.5 (P) GB | 35 min | · |
| 2026-10-23 | scan_stick | [v4](runs/scan_stick/v4/summary.md) | FAILED | 30.4 (M) | · | FAIL | · | · GB | · min | · |
| 2026-10-23 | scan_stick | [v5](runs/scan_stick/v5/summary.md) | FAILED | 40.1 (M) | · | FAIL | · | · GB | · min | · |
| 2026-10-23 | scan_stick | [v6](runs/scan_stick/v6/summary.md) | FAILED | · | · | · | · | · GB | · min | · |
| 2026-10-23 | scan_stick | [v7](runs/scan_stick/v7/summary.md) | FAILED | 40.7 (M) | 0.36 | FAIL | · | · GB | · min | · |
| 2026-10-23 | scan_stick | [v8](runs/scan_stick/v8/summary.md) | DONE | 40.8 (M) | 0.36 | PASS | flange | 4.3 (P) GB | 53 min | · |
| 2026-10-23 | scan_stick | [v9](runs/scan_stick/v9/summary.md) | DONE | 40.0 (M) | 0.36 | PASS | flange | 4.3 (P) GB | 2 min | · |
| 2026-10-23 | scan_stick_base | [v10](runs/scan_stick_base/v10/summary.md) | FAILED | 291.4 (M) | 0.57 | FAIL | · | · GB | · min | · |
| 2026-10-23 | scan_stick_base | [v11](runs/scan_stick_base/v11/summary.md) | FAILED | 291.4 (M) | 0.57 | FAIL | · | · GB | · min | · |
| 2026-10-23 | scan_stick_base | [v2](runs/scan_stick_base/v2/summary.md) | FAILED | · | · | · | · | · GB | · min | · |
| 2026-10-23 | scan_stick_base | [v3](runs/scan_stick_base/v3/summary.md) | FAILED | · | · | · | · | · GB | · min | · |
| 2026-10-23 | scan_stick_base | [v4](runs/scan_stick_base/v4/summary.md) | FAILED | 123.4 (M) | 5.52 | FAIL | · | · GB | · min | · |
| 2026-10-23 | scan_stick_base | [v5](runs/scan_stick_base/v5/summary.md) | FAILED | 188.5 (M) | 2.35 | FAIL | · | · GB | · min | · |
| 2026-10-23 | scan_stick_base | [v6](runs/scan_stick_base/v6/summary.md) | FAILED | 234.8 (M) | 2.23 | FAIL | · | · GB | · min | · |
| 2026-10-23 | scan_stick_base | [v7](runs/scan_stick_base/v7/summary.md) | FAILED | 290.7 (M) | 0.58 | FAIL | · | · GB | · min | · |
| 2026-10-23 | scan_stick_base | [v8](runs/scan_stick_base/v8/summary.md) | FAILED | 294.5 (M) | · | FAIL | · | · GB | · min | · |
| 2026-10-23 | scan_stick_base | [v9](runs/scan_stick_base/v9/summary.md) | FAILED | 291.3 (M) | · | FAIL | · | · GB | · min | · |
| 2026-10-23 | scan_stick_cam | [v2](runs/scan_stick_cam/v2/summary.md) | FAILED | 5.5 (M) | · | FAIL | · | · GB | · min | · |
| 2026-10-23 | scan_stick_cam | [v3](runs/scan_stick_cam/v3/summary.md) | FAILED | 10.2 (M) | · | FAIL | · | · GB | · min | · |
| 2026-10-23 | scan_stick_cam | [v6](runs/scan_stick_cam/v6/summary.md) | FAILED | · | · | · | · | · GB | · min | · |
