sparkiscool/nox/nox/dubhacks-queue.md

# DubHacks print queue (17 Oct 2026; hand-off = Nox Print Files 17 Oct 15:10; state moved to current-parts 15:40; supports rule 16:38; orientation rule 18:30; receiver v3.4 in row 1, 18 Oct 00:20; stand v5e prints row 8, 01:15; stand v6 all printed, rows 8 / 8b, files saved 19 Oct 19:40; stand v7 enclosure: rows 8 / 8b updated, row 8c added, 19 Oct 21:35; **20 Oct: rows 8 / 8b / 8c moved to the v7b files (strict solid check) and bracket_e v8 topology run 3; 14:45: bracket_e v8 pulled (pads on necks), row 8c prints bracket_e v7c; 17:55: row 8c prints bracket_jA v8 (topology); 18:25: row 8 prints bar_half v8 (topology)**)

**Priority (Spark 16 Oct 23:58): the Scout flown at DubHacks is v2.** Scout v2 flight parts print first; box parts (funnel panels) only fill idle printer time. v1 stays intact until every v2 flight part is printed and fit-checked (v1 is the only fallback: same arm plate and electronics).

Two printers all day. Any chat linked by Remote Control to the Windows CAD laptop (Bambu Studio) can send a print. Design chats generate parts in the cloud and drop files in the artifact **"Nox Print Files"** (https://claude.ai/artifact/7fsE6Y9U8pU91zYkGGo4Lp); the print chat pulls from there.

## How it works
This page holds **print order and print notes only. Every part's state lives in one cell: its row in `nox/current-parts.md`.** Never write a state here.
1. A design chat finishes a part (`nox/README.md` Printing, Done = saved): same turn, it publishes the file into "Nox Print Files" as `<part>_<version>.<ext>.b64.txt`, names that file in its row below, sets its `current-parts` state to READY, and writes its log line. It never needs the laptop.
2. Spark tells a linked chat "next" (or a printer finishes). That chat syncs `Documents\Nox\latest\` (README Printing, Latest folder), takes the top row below whose `current-parts` state is READY, opens that part's file from `latest\` in the Bambu Studio window that is already open (never launch a second copy; close other project windows), runs `print_orient.py` on it, slices, reports bed face / bed contact (M) / time / g / support g, Spark confirms the bed is clear, sends.
3. Same turn: one row in `nox-print-log.md`, `current-parts` state PRINTING. When Spark reports the result: PRINTED, or FAILED with a failure-log line. That's all the logging.

- Printers: Jarvis and Gideon, both A1 mini, both bound in Bambu Studio (17 Oct 15:54). PETG on both (cage all PETG, Spark 17 Oct 10:39; no TPU plate any more).
- Network: both printers + laptop on Spark's phone hotspot (venue wifi blocks printer traffic). SD card when the network fails (prints from 12:58 on went by SD). The card reader on the laptop threw I/O errors at 17:44 and 18:25: re-seat the card before copying.
- Throughput: ~15 g/h per printer at 0.20 Strength (E, from the log), so ~420 g across two printers in a day; the fast profile aims for ~2x. The queue is a priority list, not a plan to finish.

## Profiles
- Drone parts: 0.20 mm Strength @BBL A1M, 6 walls, as before, tree(auto) supports.
- Box parts and coupons (fast): 0.28 mm Extra Draft @BBL A1M, 3 walls, 15 % gyroid, tree(auto) supports, flow calibration off, speed Ludicrous (Sport if it has thin tall features). PETG's volumetric limit caps the gain; trust the slicer time.
- Bambu Studio note: at 100 % sparse infill it forces rectilinear (grid/gyroid can't do 100 %). Typing into a field that already has a value can append (3 -> 23): select all first.

## Rules for DubHacks parts (on top of `nox/README.md` Generative parts)
- **Orientation and supports: `nox/README.md` Printing, "Orientation and supports" (one place).** Short form: largest flat face down, tree(auto) supports on (global + per object, 30°), brim 5 mm on small footprints, `print_orient.py` before every slice, report bed contact (M) and support g. The 15:22 cartridge plate (no supports) and the 16:38 receiver (standing on 8 posts, 94 mm² on the bed) are the two failures behind it.
- **Solid parts only (Spark 20 Oct 01:08):** a part that has not passed `solid_check.py` (README Rules, Solid parts; neck test since 20 Oct 14:45) is not printed; its row in `nox/current-parts.md` says whether it has.
- **Flat prints only** (Spark 16 Oct 21:19): low build height, largest face on the plate; Spark sands seams.
- **Walls, not infill.** Members 2.0 to 3.6 mm so 3 walls fill them; no small holes, no thin webs, one body.
- Done line adds: bed face, bed contact (M), support g, est. time at the fast profile.

## Queue (print order only; **state lives in `nox/current-parts.md`**: print a row only when its state there is READY)
| # | Part | Saved file (Nox Print Files) | Print notes |
|---|---|---|---|
| 1 | S2 receiver v3.4 (18 Oct 00:20) | `s2_receiver_v34.stl.b64.txt` (sha 28fe49d9da09, print pose: pads on the bed, z up) → `latest\s2_receiver.stl` (not synced yet: the print chat pulls it; base64 only, no zip). Superseded files: `latest\s2_receiver_v33_flipped_supports.gcode.3mf` (the v3.3 fit print running on Gideon, Spark 23:06), `F:\s2_receiver_v33_supports.gcode.3mf` (mouth down, snapped) and `latest\s2_receiver_plate.gcode.3mf` (no supports): don't print again | **Gideon, after the v3.3 fit print.** PETG, slice as saved (pads on the bed, 599 mm² M, 3 islands 155 / 222 / 222, `print_orient.py` best of the 6), tree(auto) supports 30° (4453 mm² overhang M, ~9 g E like v3.3), outer + inner brim 5 mm, 0.20 Strength, 6 walls; 45.7 g (M) model, ~3 h 30 (E). Flight-critical. Report bed contact, support g, time |
| 2 | S2 tray v11 + block v4 | `s2_tray_v11.stl.zip.b64.txt`, `s2_cartridge_block_v4.stl.zip.b64.txt`, plate `s2_cartridge_v11_v4_plate.gcode.3mf.zip.b64.txt` (laptop `latest\`) | **Tray only (block + blades on hand, Spark 16:43): `latest\s2_tray_v11_supports.gcode.3mf`** (16:47, 19.34 g incl. 5.17 g tree supports, 2 h 7 min); on the SD card 17:24. Orientation checked 18:20: closed end down is the best face (813 mm² M on the bed, least overhang of the 6), keep. The 15:22 plate snapped, printed without supports; every older plate file here and `F:\s2_cartridge_run9_block_v4.gcode.3mf` has none: don't reprint them. PETG, tray closed end down; 0.20 / 3 walls / 40 % gyroid. Block (if ever reprinted): flat as saved, 378 mm² (M), supports off on the slider gaps (they print in place) |
| 2b | S2 top case v1 | `s2_top_case_v1.stl.zip.b64.txt`; laptop `latest\s2_top_case.stl` | **Sliced: `latest\s2_top_case_v1_supports.gcode.3mf`** (16:58, 16.54 g incl. 5.06 g tree supports, 1 h 52 min), on the SD card 17:24, **printing well on Gideon (Spark 18:15): keep this orientation.** PETG, right side down as saved, outer brim 5 mm, 0.20 Strength, 6 walls. Note: that face has 3 mm² (M) on the bed; the brim + tree supports carry it. A flat alternative is sliced as `latest\s2_top_case_v1_flat_supports.gcode.3mf` (367 mm² M on the bed, 11.48 + 2.92 g, 1 h 21 min) if a reprint ever wobbles |
| 3 | S2 cage v3 (layout C3), whole PETG set on one plate | `s2_cage_PETG_plate_v3.3mf.b64.txt` (19 parts: 4 corner nodes, 2 vtees, side node L + R, crown, 8 wheels, 2 top case side spacers); single STLs `s2_cage_<part>_v3.stl.b64.txt`; laptop `latest\s2_cage_plate.3mf` (17 Oct 20:05) | **Slice `latest\s2_cage_plate.3mf` as saved.** PETG, 0.20 Strength, 6 walls, tree(auto) supports, brim 5 mm on the wheels and spacers. Every part sits on its best face (`print_orient.py`: corner 130, vtee 137, side node 106, crown 548 mm² M on the bed; no thin islands). 42.5 g (M) model; est. ~3 h at 0.20 Strength, ~1 h 30 at the fast profile (E, 15 g/h). Support g from the slicer. Superseded plates in `dubhacks\` (02:58 / 04:00, TPU) must not be printed |
| 4 | S2 camera mount v2 (4°) | `s2_camera_mount_v2.stl.b64.txt` → `latest\s2_camera_mount.stl` (synced 18:09, sha 12419b7a720f) | **Sliced: `latest\s2_camera_mount_v2_supports.gcode.3mf`** (18:23, 4.01 g incl. 0.72 g tree supports, 48 min; project `latest\s2_camera_mount.3mf`). PETG, lies as saved (lower boss flats on the bed, 115 mm² M, the least-overhang face of the 6), 0.20 Strength, 6 walls. Goes on the SD card when it reads |
| 5 | Belt clamp coupon set v2 (3 coupons, slot 1.8 / 2.0 / 2.2) | `belt_clamp_coupon_set_v2.stl.b64.txt` | PETG, fast profile but 100 % infill (small walls), lies flat as saved, tree supports (pocket and slot roofs). 11.6 g (M). Gates heads A / B v5 |
| 6 | Funnel panels A v6 + B v6 (8 total) | none (laptop `dubhacks\` and the SD card) | Idle printer time only. 0.28 Extra Draft, 3 walls, 100 % rectilinear, contact face down, flow cal Off, Ludicrous. 3 printed, 5 on the SD card (sliced without supports, before the 16:36 rule; flat panels, Spark's call whether to re-slice) |
| 6b | Bay module v4i, universal (print 2) | `box_baymod_v4i.stl.b64.txt` → `latest\box_baymod.stl` (21:24, sha 472f8808ea9c) | PETG, box fast profile, 2 copies, near end (Y 133) down as saved: 462 mm² (M) on the bed, one first-layer island, no thin posts (`print_orient.py`, best of the 6). Tree(auto) supports ~21 g each (E); 83.4 g (M) model each. Not sliced yet: report slicer time + support g. Idle printer time, after the Scout parts |
| 7 | Box arm hub set: hub v5, stub v3, sun post v1, detent ring v1 + roller arm v1, idler ends A / B v3, pinion v4 x2, fingers v4 x4 | `box_hub_v5.stl.zip.b64.txt` (sha 6d6b9344e7f6), `box_stub_v3`, `box_sun_post_v1`, `box_detent_ring_v1`, `box_detent_arm_v1`, `box_idler_end_A_v3`, `box_idler_end_B_v3`, `box_pinion_v4`, `box_finger_A_for_head_A_v4`, `box_finger_B_for_head_A_v4`, `box_finger_A_for_head_B_v4`, `box_finger_B_for_head_B_v4` (each `.stl.b64.txt`) | Box fast profile, PETG, every STL as saved (print pose). Hub: sleeve end down (748 mm² M on the bed), tree(auto) supports under the motor plate (12163 mm² overhang M), report support g; 214.2 g (M) model, ~67 tall. Stub plate face down, sun post flange down; ring, roller arm, idlers, pinions, fingers flat as saved (`print_orient.py` pass on all). Small parts fit on one plate. Heads A / B are being regenerated (Spark 19 Oct). Stand prints: row 8 |
| 8 | Box stand base (`nox/box/box-stand.md` v7b): mast v6, cradle_keel v6, KB v7b, **bar half v8 x2 (topology)**, toe v7b | `box_mast_v6.stl.b64.txt` (sha 1fa9e08c17d0), `box_cradle_keel_v6.stl.b64.txt` (c360aed46fc8), **`box_kb_v7b.stl.b64.txt` (f718facc8b4c), `box_bar_half_v8.stl.zip.b64.txt` (aacd009b7ae1, print 2; zip then base64), `box_toe_v7b.stl.b64.txt` (74892913179a)** → `latest\box_<part>.stl` (not synced). v6 / v7 kb / toe and v6 / v7 / v7b bar_half files are gone from Nox Print Files (never printed). **Retired, do not print and delete from `latest\`: `box_bay_cradle.stl` (cradle v5e, now inside cradle_keel), `box_seat_pad_A.stl`, `_B.stl`, `box_seat_pads_x4_layout.3mf`, `box_seat_pads_v5e_x4_2plates_supports.gcode.3mf`, `box_seat_pads_v5e_plate1_3pads_supports.gcode.3mf`** | Box fast profile, PETG, **4 walls** on all (every piece carries bolts), tree(auto) 30°, every STL as saved. Mast standing on its bottom (384 mm² M, 172 tall, brim 5; tall and narrow: Sport speed if it wobbles), 99.1 g. KB floor down (4840 mm²), 115.0 g. Cradle_keel back face down (2030 mm², 135 tall), 70.1 g. **Bar halves v8 on the Y 46 face, saved at 45.12° to fit the bed (164 x 160 x 16; 5833 mm² M on the bed, 2797 mm² overhang at the tip boss roof and the lap step: tree(auto) 30°, report support g), 77.6 g each.** Toe floor down (3384 mm²), 52.7 g. 492.1 g (M), ~18 to 20 h on one printer at the fast profile (E). Print KB + cradle_keel + bars first (they make the base). **Topology v8 versions of KB and toe may come from other chats: if a v8 file has replaced the v7b one here by the time you print, print the v8** |
| 8b | Ring frames: frame_mid v6 x5, frame_endR v7b, frame_endL v7b (`nox/box/box-case.md` Ring frames, `nox/box/box-stand.md`) | `box_frame_mid_v6.stl.b64.txt` (sha 01ff810f6f31, print 5), **`box_frame_endR_v7b.stl.b64.txt` (5bdbb4a9a085), `box_frame_endL_v7b.stl.b64.txt` (35d3bdd29e25)**; v6 / v7 end frame files removed | Box fast profile, PETG, 4 walls, tree(auto) 30°, every STL as saved (joint plane down: mid / endL on the −X plane, 867 mm² M in 4 islands ≥ 128; endR on the +X plane, 1131 mm²). 2 or 3 per plate (mid 51 x 84 x 89; ends 54 x 94 x 126). Supports under the top lugs / tongue (mid, ~1600 mm²) and the funnel pads + station blocks (ends, 3900..4400 mm²): report support g. 415.9 g (M). After the bay modules; the ends are needed before the funnel goes on. Topology v8 end frames may replace the v7b files (same rule as row 8) |
| 8c | Box enclosure (`nox/box/box-stand.md` Enclosure + Topology): post segments x12, **bracket_jA v8 x2 (topology; U-bosses on widened cheeks)**, bracket_jB x2, **bracket_e v7c x2 (drawn; wider cheeks + bolt bosses)** | `box_post_seg_v7.stl.b64.txt` (sha 5cab526b8391, print 12), **`box_bracket_jA_v8.stl.zip.b64.txt` (21af8faad391, print 2; zip then base64)**, `box_bracket_jB_v7.stl.b64.txt` (a48119676bb0, print 2), **`box_bracket_e_v7c.stl.b64.txt` (55f717ab05f8, print 2; base64 only, no zip)**; `box_bracket_jA_v7` and every earlier bracket_e file (v7, v7b, both v8s incl. `box_bracket_e_v8.stl.zip.b64.txt`) are removed: if a copy of any of them is in `latest\`, delete it | Box fast profile, PETG, 4 walls, every STL as saved: posts on leg A's outer face (3107 mm² M, 21 tall; the lengthwise slot roof is a 3.2 bridge, supports off inside the slots), 6 to 8 per plate (147 x 21 x 21), 42.5 g each; **bracket_jA v8 flange face down (3036 mm² M, 43 x 84 x 33.5, 539 mm² overhang = the boss undersides: tree(auto) 30°, report support g), 38.4 g each**; bracket_jB flange face down (2542 mm² M), tree(auto) 30° under the cheeks, 23.0 g; **bracket_e v7c flange face down (3886 mm² M, 80 tall, 200 mm² overhang = the tops of the two r 5 counterbores: tree(auto) 30°, report support g), 109.8 g each**. 852 g (M) total, ~28 h at the fast profile (E): last of the box prints, after the frames. Sheets (2 x 397 x 441, 2 x 366 x 441, 3.0) are cut, not printed. A topology bracket_e v8 (run 4) replaces v7c here only if it beats v7c's 0.14 and passes the neck test |

**Print only from `Documents\Nox\latest\`.** Everything in `dubhacks\` is history. Known traps there: `s2_tray_v11.stl` (02:51, the old soft tray with no blade posts, NOT run 9), `s2_cartridge_v11_block_v4.gcode.3mf` (built on that file), `Resume head A v5 ….gcode.3mf` (misnamed export of the 15:22 plate), `s2_tray_v8/v9/v10.stl`, `s2_cartridge_block_v3.stl`, cage plates `s2_cage_v2_PETG_plate.3mf` / `_TPU_plate.3mf` (02:58 / 04:00), funnel panels v4 / v5, belt clamp v1 (`belt_clamp_coupon_v1*.stl`, `belt_clamp_plate_v1.stl`, `F:\belt_clamp_coupon_v1_plates.gcode.3mf`). In `latest\`: `s2_receiver_flipped.3mf` is a duplicate of `s2_receiver.3mf` (delete); the cradle v5e and seat pad files (row 8) are retired. History of what left the queue: `nox/log.md` and `nox-print-log.md`.

## Setup
1. Link the laptop to a chat; grant Bambu Studio + File Explorer; connect `Documents\Nox`; make `dubhacks\`. DONE 16 Oct 23:40
2. Both printers online in Bambu Studio over the hotspot. (Jarvis online; P2 missing)
3. Filament: ~1 PETG spool per printer per day.
