sparkiscool/nox/nox/box-stand.md

# Box stand v7b: all printed + clear enclosure (v6 base 19 Oct 18:05; v6 parts 19:40; FE 20:10; weak-spot sweep 21:10; v7 enclosure 21:35; **20 Oct: strict solid check (Spark 01:08 "no disconnected structures") → v7b fixes 02:00; bracket_e v8 topology run 3 05:00, pulled 14:30 (pads on necks, Spark 14:19); neck test + bracket_e v7c READY 14:45; bracket_jA v8 (topology, U-bosses) READY 17:55; bar_half v8 (topology, roofed tip boss, bed skin) READY 18:25; kb v8 (topology) not shipped 18:40, weaker than v7b (Problem 24)**)

**Spark 19 Oct 17:25: fully 3D printed, structure first. 19:09: everything except the servo heads. 19:48: analyse the load path and weak spots, then a final design that mounts 4 clear plastic walls. 20:24: funnel inside the walls, walls properly mounted. 20:30: corner connectors in contact with all faces. 20:37: walls level with the funnel. 20:40: skeptical of the bay loop. 20:43: bolt the ring to the side walls, box as compact as possible. 20:48: find the rest of the weak spots. 21:03: design all of it. 23:24: run all of those in topology, don't worry about the weight, make them stronger than the geometric shapes. 20 Oct 01:08: no disconnected structures, make sure that is always true moving forward. 14:19: something is wrong with the topology, why is the bracket disconnected.**
A **mast** behind the wheel carries stub v3; a **keel** on the floor (KB at the back, the front keel inside the cradle part) ties the mast to the −90° bay; one **cross bar** (two identical halves) gives the sideways stance; a **toe** runs from the cradle's back to the front wall. The **bay ring is closed with printed frames** (5 mid + 2 end frames carrying the funnel's 4 seat pads). **The enclosure is 4 clear 3.0 sheets standing on the floor**, held by 12 identical printed corner post segments, and **the ring is bolted to the side sheets through 6 brackets**; the keel and the toe bolt to the rear / front sheets, the cross bar tips to the side sheets. Kept: bay module v4i, stub v3 (M5 x 12 bolts), funnel collar v4 seat faces, floor Z −201. **Retired:** v5e (2040), the v7..v7e proposal layouts (walls in bar grooves, front / rear cross bars, inner bolt pair: see Problem 14), the v7 kb / bar_half / toe / end frames / bracket_e (thin walls, Problem 19), bracket_e v7b and every bracket_e topology run so far (Problems 20, 21), bracket_jA v7 (replaced by v8, Problem 22), bar_half v7b (replaced by v8, Problem 23).
Scripts (Nox Source `nox/box/stand/`): `stand_v6.py` (base layout), `stand_v6_parts.py` (v6 parts, still the source of mast, cradle_keel, frame_mid), `stand_v7_parts.py` (every drawn changed / new part; `VTAG=v7b python3 stand_v7_parts.py [part]` writes `box_<part>_v7b.stl` in print pose + `_W.stl` and runs the solid check; `VTAG=v7c ... bracket_e` for the current end bracket), `stand_v7_check.py` (fits + assembly picture; `V7B=<parts>` swaps the v7b files in, `TAGS=bracket_e=v7c` picks any other tag), `stand_v7_fe.py` (voxel FE, `VTAG` picks the files), `ring_chain_fe.py` (ring arc as a bolted chain, 4 configs), `stand_v7e.py` (enclosure layout numbers, tip-over), `stand_v7_topo.py` (topology regeneration of every part, one part per chat; drawn interfaces, fastener access keep-outs, solid check built in), `stand_v7_topo_build.py` (rebuild from a saved density; **`BED_SKIN` adds a flat bed face from the part's own outline, bar_half**; **saves the `_W.stl` and runs the solid check in its own process before `wrinkle` and the as-built FE, drops 0-volume sheets only (Problem 24)**), **`kb_setup_check.py` (kb setup audit: ≥ 3 drawn round every access cut, design cells, support count)**, **`stand_v8_bar_export.py` (bar_half v8: clean W + print pose at 45.12°)**, `bar_half_v8_hero.py` (preview sheet), **`nox/solid_check.py` (the strict connectivity + thin-wall + neck check, README Rules "Solid parts")**; needs `arm_cad.py`, `arm_layout.py`, `arm_topo.py`, `models/box_baymod_v4i_W.obj`, `nox/printopt.py`, `noxopt.py`, `noxopt_local.py` (pymoto, pypardiso + mkl, `sparse_dot_mkl` for the gmg backend's fast products). Coordinates W (`box-arm.md`): X across, Y along the axle away from the stub face (Y 0), Z up, axle X 0 Z 0, floor Z −201. All C unless tagged.

## Enclosure (C)
- Sheets 3.0 acrylic [DEFAULT], inner faces **X ±186, Y −66 .. 337**, floor to **Z 240** (level with the funnel rim 237). **Cut list: 2 x 397 x 441 (sides, Y −63..334), 2 x 366 x 441 (front / rear, X ±183)**; the sheets stop 3 short of each corner, the post's solid 9 x 9 corner fills it. ~2.4 kg (E).
- **Corner posts:** 4 x 3 identical segments `post_seg` (147 tall; stack = 441), an L of two 9.2-thick legs (3.0 wall + 3.2 slot + 3.0 wall), legs 21.7 long, each sheet in a 15-deep slot closed 3 before the corner; segments butt on each other (the sheets keep them in line), stand on the floor; 1 x M3 x 16 per leg per segment through sheet and post (nut inside). One part serves all 4 corners by 90° turns (`post_place`).
- **Ring to side sheets, 6 brackets:** at the ring's joint planes −15° (frames −30 / 0) and +15° (0 / endR) and at endR's free end 45°; mirrored on the left (165°, 195°, 135°). `bracket_jA` (−15°, and 165° turned 180° about Y), `bracket_jB` (+15°, and 195°), `bracket_e` (45°, and 135° turned about the vertical axis through Y 177). Joint brackets = U-clips on the joint's lug pair (3.7 cheeks on both lug faces, Y 137..149.7 and 204.3..217; the joint's outer M5 pair becomes **M5 x 25** through the cheeks), two arms to a 4-thick flange on the sheet, **2 x M3 x 10** through the sheet at Y 160 / 194. **bracket_jA v8 (topology):** cheeks widened to Y 136..149.7 / 204.3..218, rho 163..183.6, each with a 3.0-walled **U-boss** outside it round the lug bolt (r 8.5, access r 5.5 as an obround, 8 long: head 5 + 3, DEFAULT), open toward the frame's rib web, which sits 5 from the bolt (a full r 8.5 tube hits the rib, 95..215 mm³); the M5 x 25 clamps on the cheek face, head and key down the head-side boss, the bolt tip in the nut-side boss (nut in the lug's pocket, as v7); generated arms to the same flange. **End bracket v7c (drawn):** two cheeks on the end frame's station blocks (t −18..−0.8, rho 153.5..183.6, Y 126..131 / 223..228; the block itself stays t −11..−0.3), each with a 10-long bolt boss outside it (Y 116..126 / 228..238, t −18..+4: the end frame starts at Y 130, so the boss may cross the end plane there), **2 x M5 x 35 along Y** at (t −5.9, rho 170) through cheek + block, head in an r 5 counterbore through the boss (key from outside), nut on the block's inner face between the blocks; arms (hull of the saddle and a pad inside the flange) to a 4-thick flange Y 116..238 on the sheet (M3 at Y 150 / 204). No inner bolt pair on the frames (Problem 14): the brackets alone hold every joint.
- **Base to the sheets:** cross bar tips end in a 9-thick pad at X 177..186 against the side sheet (**M5 x 16** along X at Z −186, nut outside; **bar_half v8: pad Z −201..−175, the head inside a drawn boss r 8.5 (X 165..177) with a flat roof 6.0 over an r 5.0 access along −X**, v7b had the head between two 3.0 ribs); the keel's rear plate (X ±36, Y −66..−60) and the toe's front plate (X ±36, Y 331..337) each take **2 x M5 x 16** at X ±26 through the sheet into nut pockets in 16-wide bosses behind the plate (hex flats facing X, pockets open toward the inside, nut dropped in). Mast and cradle_keel unchanged. PSU beside the mast at X 25..89, Y −50..−10 on the floor, 2 zip ties through KB's +X wall (DEFAULT).
- Tip-over (E): walls' outer faces 378 x 409, ~8.6 kg: **2.5** with no ballast (`stand_v7e.py`); catch tolerance = the collar's ±76; the walls touch the collar mouth at the front, 26 / 83 clear at the sides / back.

## Solid check (20 Oct; `nox/solid_check.py`, README Rules "Solid parts")
One body after a 0.9 mm erosion, every drawn feature in it, no wall under 1.8; **since 14:45 also the neck test: eroded at 1.2 / 1.5 mm, no piece may split off that is ≥ 1.6 thicker than its neck and joins the rest over less than 4 x its thickness²** (a 2.0 erosion was tried and dropped: it flagged 4.0 bolt-down plates joining two thick lumps, e.g. the bracket flange, which are plates, not necks). Run on every stand file 20 Oct 01:30, again with the neck test 14:45:
| Part | Result | Cause | Fix | Now |
|---|---|---|---|---|
| bracket_e (drawn v7 and topology run 1) | **FAIL**: each cheek split off (2 x ~380 mm³ eroded pieces), walls 1.1 | M5 Ø5.5 through a 7.2-wide cheek: 0.85 per side | v7b: cheek and station block from t −8 to **t −11**, hole from t −4.4 to **t −5.9**: walls 2.35 / 2.35 | superseded |
| **bracket_e v7b (drawn)** | **FAIL the neck test** (14:45): the lower cheek (5.0 thick) hangs on a neck under 2.4, joint 30 mm² (M) | the 2.35 walls beside the M5 are the only link between the cheek below the hole and the arm above it | **v7c**: cheek widened on the open side to t −18 (8.4 of material beside the hole there), from r 153.5, + a 10-long bolt boss outside the cheek with an r 5 counterbore | **v7c PASS** (0 necks, 0 thin walls) |
| **bracket_e v8 (topology run 3)** | **FAIL the neck test**: both bolt pads (5.7 thick) on necks under 3.0, joint 44 / 47 mm² (M); passed the 0.9 test (Spark spotted it, 14:19) | the r 5.5 access cut behind each pad was wider than the 10.2 pad (t −11.4..−0.4 vs −11..−0.8): nothing could reach the pad from behind, only round its corners | pulled; topology run 4 draws the v7c cheeks (Problem 21) | pulled |
| frame_endR / endL v7 | FAIL: walls 1.0..1.1 in the station blocks | the same M5 through a 7.7-wide block | v7b: blocks t −11..−0.3, hole t −5.9 | **v7b PASS** incl. neck test |
| bar_half v7 | FAIL: wall 1.5 at the tip | the tip M5 split the 8-wide gusset; that gusset also sat where the bolt head goes | v7b: two 3.0 ribs at Y 46..49 / 59..62, the head between them, hole through the pad only | v7b PASS incl. neck test; superseded by v8 |
| kb / toe v7 | line-thin 1.0 beside the hex pockets | hex corners pointed into 12-wide bosses | v7b: bosses 16 wide (X 18..34), plates X ±36, hex flats facing X: walls 3.7 | **v7b PASS** incl. neck test |
| mast, cradle_keel, frame_mid v6; post_seg, bracket_jA / jB v7 | PASS | (cradle_keel: its 2.4-walled cradle box splits from the keel at 1.5 but joins over its whole perimeter, so it is not a neck) | unchanged | PASS incl. neck test |
| **bracket_jA v8 (topology)** | **PASS** (1 body, 1 eroded body 20319 mm³ M, 0 necks, 0 drawn features outside, 0 thin walls; 7 acute edges, not counted) | (setup: U-boss round each lug bolt, Problem 22) | | **PASS**, watertight, 0 non-manifold edges |
| **bar_half v8 (topology)** | run 1 **FAIL** (drawn tip core split at the 2.0 erosion: 2 x 93 mm³, M); retry + bed skin **PASS** (1 body, 1 eroded body 42220 mm³ M, 0 necks, 0 drawn features outside, 0 thin walls, 0 acute edges) | run 1: two 6-thick generated rails landed on the boss's back top, and its 3.5 wall was their only link to the pad (Problem 23) | flat roof 6.0 over the access cut (boss and pad top to Z −175) | **PASS** on `box_bar_half_v8_W.stl`, watertight, 1 shell |
| **kb v8 (topology run 1)** | **PASS** on `_W.stl` and print pose (1 body, 1 eroded body 72333 mm³ M, 0 necks, 0 drawn features outside, 0 thin walls, 0 acute edges) | (setup: 3.0 shells round the rear nut access and the base-joint head pocket, Problem 24) | | PASS, but not shipped: FE 0.096 vs v7b 0.091 |
The dovetails' 45° lips and similar acute edges show as knife-edge residue, not walls; the check counts them separately (`acute_edges`) and does not fail on them. A FE at 1.0..2.0 mm voxels missed every one of these: the strict check is what catches them.

## Topology regeneration (v8; `stand_v7_topo.py`)
Every part is rerun as a generated part: **drawn** = bolt pads with their bosses, cheeks, plates, slot walls, spigot (the interfaces only); **envelope** wider / taller than the drawn shape; **cuts** = holes, nut pockets, the ring band, sheets, funnel collar, arm sweep, bracket seats, pad key lanes **and an access cylinder for every bolt head, nut and its tool, never wider than the pad it serves**; **loads** = the drawn parts' FE cases; **mass target** high (Spark: weight free). Every run ends in the solid check (`solid_ok` in `<part>_result.json`, neck test included) and, before it ships, the same FE (`stand_v7_fe.py`, same grid) as the drawn part it replaces: it ships only if it is stronger. Cloud RAM: `NOX_BACKEND=gmg` (pardiso dies at 6 GB above ~60k design cells; the gmg wrapper drops noxopt's `masked` keyword, 20 Oct 03:30; **since 18:40 it also moves the as-built recheck onto gmg**); nothing else heavy on the same box during a run.
| Part | Run | Result |
|---|---|---|
| bracket_e | run 3: drawn = 2 bolt pads (10.2 x 20 x 5) + flange, h 1.5, gmg, 60 cm³ | worst 0.20, 101.3 g; **pulled 14:30: pads on 2..3 mm necks (neck test FAIL, above)** |
| **bracket_e** | **run 4 (20 Oct 14:45, running): drawn = the v7c cheeks with their bolt bosses + flange, r 5 counterbore access, h 1.5, gmg, 60 cm³; 293k cells, 198k design** | ships only if it passes the solid check and beats v7c's 0.14 |
| **bracket_jA** | **v8 (20 Oct 17:55): drawn = widened cheeks (Y 136..149.7 / 204.3..218, rho 163..183.6) + a 3.0-walled U-boss outside each (r 8.5, obround access r 5.5, 8 long) + flange; ring keep-out r 180.2; h 1.5, gmg, 12 cm³ generated; 45k cells, 20k design; 75 iterations + 1 prune round (2 rods r 0.5 removed), 438 s; rebuilt from the saved density after the access became an obround (Problem 22)** | **READY: solid check PASS, watertight, function 0 / 0 / 0, thin 0; worst 0.05 on the v7 FE grid (h 1.0; v7 0.12), deflection 0.01 mm (v7 0.02); 38.4 g (M; v7 23.4); fits 0 mm³, 0.3 to both frames, 0 in the collar; wrinkle 0.79 / 0.88 (M)** |
| **bar_half** | **v8 (20 Oct 18:25): drawn = lap + tip pad (X 177..186, Z −201..−175) + M5 boss r 8.5 X 165..177 with a flat roof to Z −175 (6.0 over the r 5.0 access) + 2 feet; envelope Z to −165 (36 tall, v7b 20); h 1.5, gmg, 45 cm³ generated; 51k cells, 22.6k design; 78 iterations, 0 pruned, 478 s; run 1 (no roof) failed the solid check, retry = the roof (Problem 23); then rebuilt from the retry's density with `BED_SKIN` (Y 46..48, the part's own outline at Y 48)** | **READY: solid check PASS, watertight, function 0 / 0 / 0, thin 0; worst 0.38 on the v7b FE grid (h 1.5; v7b 0.54), tip 0.70 mm (v7b 4.64); 77.6 g (M; v7b 45.4); fits 0 mm³; bed 5833 mm², 2797 mm² overhang (M)** |
| **kb** | **run 1 (20 Oct 18:40): drawn = spigot (2.0 wall, bore open) + floor + end plate + rear plate + 2 nut bosses + 3.0 shells round the rear nut access (r 8.5, Y −54..−50.5) and the merged base-joint head pocket (Y 28..46); PSU keep-out; support fixed (Problem 24); h 2.0, gmg, 40 cm³ generated; 170k cells, 43k design; 77 iterations, 0 pruned, 781 s; rebuilt from the saved density after 2 OOM kills** | **NOT SHIPPED: solid check PASS, watertight, function 0.01 / 0 / 0, thin 0, 158.7 g (M); FE (h 2.0, same grid) worst 0.096 vs v7b 0.091: lean 0.078 (v7b 0.091), yaw 0.096 (v7b 0.073) at the spigot corner Z −128, where the generated collar stops (the −130 sleeve keep-out); kb v7b stays** |
| bracket_jB, post_seg, toe, frame_endR, frame_endL | queued, one chat each; any chat started before 20 Oct 14:45 restarts with the fixed `solid_check.py` and the access-cut rule; **bracket_jB uses the same `bracket_j_setup`, so it already gets the U-bosses and the r 180.2 keep-out**; **every part printed on a flat face: check the generated body reaches that face (Problem 23 c)**; **check every setup's support count is > 0 (Problem 24 b)** | the drawn v7 / v7b files stay READY until each v8 beats them |

## Parts (print files in Nox Print Files; every STL saved in print pose; g M; solid check PASS on every file, neck test included)
| Part | File | Qty | g | What it is | Bed face (`print_orient.py`) | sha |
|---|---|---|---|---|---|---|
| mast | `box_mast_v6` | 1 | 99.1 | Hollow 40 x 60 sleeve Z −128..44 on KB's spigot, stub v3 holes, nut bars, 2 cross bolts | bottom, standing (384 mm², brim) | 1fa9e08c17d0 |
| cradle_keel | `box_cradle_keel_v6` | 1 | 70.1 | Cradle v5e interface + front keel Y 62..140 + start plate; toe nut blocks | back face Y 197 (2030 mm²) | c360aed46fc8 |
| frame_mid | `box_frame_mid_v6` | 5 | 47.6 | 30° ring frame at −30, 0, −120, −150, −180 (lugs, tongue / groove, ribs, X-braces) | −X joint plane (867 mm²) | 01ff810f6f31 |
| kb | `box_kb_v7b` | 1 | 115.0 | Back keel Y −66..40: U-channel + spigot + gussets + end plate Y 40..46 (base joint) + rear plate X ±36 on the rear sheet with 2 nut bosses 16 wide; zip slots in the +X wall | floor (4840 mm², 149 tall) | f718facc8b4c |
| **bar_half** | **`box_bar_half_v8`** (`.stl.zip.b64.txt`) | 2 | **77.6** | X −20..186, Y 46..62, topology: 8-thick lap, generated deep web (Z to −165.6), flat bed skin on the Y 46 face; tip pad X 177..186 to Z −175 with the M5 boss (r 8.5, roofed 6.0 over an r 5.0 access), M5 along X | Y 46 face, 45.12° on the bed (5833 mm², 164 x 160 x 16; 2797 mm² overhang = the boss roof and the lap step) | **aacd009b7ae1** |
| toe | `box_toe_v7b` | 1 | 52.7 | Upstand on the cradle's back (2 M5), foot bar X ±10 x 10 tall to Y 331, gussets, front plate X ±36 at Y 331..337 with 2 nut bosses 16 wide | floor (3384 mm²) | 74892913179a |
| frame_endR | `box_frame_endR_v7b` | 1 | 89.2 | End frame at 30°: +X joint + 45° end with 2 station blocks (t −11..−0.3) + 2 funnel pads (webs 5.0, pads 22 x 20 x 15) + M5 along Y through the blocks at t −5.9 | +X joint plane (1131 mm²) | 5bdbb4a9a085 |
| frame_endL | `box_frame_endL_v7b` | 1 | 88.7 | Mirror at −210°, pads at 135° | −X joint plane (867 mm²) | 35d3bdd29e25 |
| post_seg | `box_post_seg_v7` | 12 | 42.5 | Corner post segment (above) | leg A's outer face (3107 mm², 21 tall) | 5cab526b8391 |
| **bracket_jA** | **`box_bracket_jA_v8`** (`.stl.zip.b64.txt`) | 2 | **38.4** | Joint bracket, −15° / 165°, topology: widened cheeks with U-bosses round the lug bolts, generated arms to the flange (above) | flange face (3036 mm², 43 x 84 x 33.5; 539 mm² overhang = the boss undersides) | **21af8faad391** |
| bracket_jB | `box_bracket_jB_v7` | 2 | 23.0 | Joint bracket, +15° / 195° | flange face (2542 mm²) | a48119676bb0 |
| **bracket_e** | **`box_bracket_e_v7c`** | 2 | **109.8** | End bracket, 45° / 135°: wide cheeks + bolt bosses (r 5 counterbores) on the station blocks, arms to the flange (above) | flange face (3886 mm², 80 tall; 200 mm² overhang = the counterbore tops) | **55f717ab05f8** |
**Prints: 24 enclosure / base pieces 1344 g (M)**; with the unchanged v6 mast, cradle_keel and 5 mid frames: 31 pieces, ~1755 g + tree supports (end frames ~3900..4400 mm² overhang, bar halves ~2800, mid frames ~1600, the rest ≤ 540). Kept: bay module v4i x2, stub v3.
**Funnel seat pads (end frames):** 22 x 20 x 15 block 22.4 outside the 45° / 135° end plane on two 5.0 webs + a floor, a 12-wide lane between the webs along the M3 axis (r 176.5): M3 x 25, head on the pad back, driven with a short L-key down the lane.

## Load path (E)
Arm (2.0 kg at Y 60) + head push (20 N at r 150, Y 175) → stub v3 → mast (4.7 N·m lean, 3.5 N·m yaw) → sleeve → spigot (76 engaged, 2 cross bolts) → KB's keel floor. Ring + funnel + Scout (1.7 kg) → the two arcs → the −90° module → the cradle lips → cradle_keel's floor; each arc is held at three stations by a side sheet loaded in its own plane (brackets), so a hand on the rim (13 N) or a drone drop goes into the sheet, not down the chain. The base joint (KB plate + 2 laps + keel plate, 4 x M5) carries the keel's bending; the bar tips, keel plate and toe plate tie the base into the sheet box; the 4 sheets + posts form a stiff tube on the floor: a push on the box loads the sheets in-plane.

## Structural check (voxel FE, printopt PETG, misuse class = SF 2.5; index 1.0 = allowable; load spots masked; `stand_v6_fe.py` for the v6 parts, `stand_v7_fe.py` with `VTAG` for v7 / v7b / v7c / v8)
| Part (voxel) | Load case (E) | Worst index | Where | Max deflection |
|---|---|---|---|---|
| mast (2.0) | lean 4.7 N·m / yaw 3.5 N·m / side 20 N | 0.05 / 0.08 / 0.07 | sleeve wall at the spigot top | 0.04 mm |
| kb v7b (2.0) | the same moments at the spigot top / 13 N on the rear plate | 0.09 / 0.07 / 0.00 (v8 run 1: 0.078 / **0.096** / 0.00, not shipped) | spigot root (v8: spigot corner at Z −128) | 0.08 mm (v8 0.07) |
| cradle_keel (2.0) | 37 N ring weight + pull / 13 N rim push via both roots / fore-aft | 0.03 / **0.18** / 0.06 | lip at the front up-bolt | 0.06 mm |
| **bar_half v8 (1.5)** | the box's full 50 N on one tip (misuse) | **0.38** (v7b 0.54) | lap end at X 22.5, Z −177 (v7b: root web at X 39) | 0.70 mm at the tip (v7b 4.6) |
| toe v7b (1.5) | 13 N push / 13 N lift at the plate / 50 N misuse | 0.02 / 0.19 / 0.09 | foot bar at the cradle gusset | 1.1 mm |
| frame_mid (1.5) | chain couple + thrust / 20 N hand / 80 N hanging on the joint (misuse) | **0.53** / 0.05 / **0.59** | top lug neck at the rib | 0.4 mm |
| frame_endR / L v7b (1.5) | 6 N + 6.5 N rim / 50 N on one pad (misuse) / **Scout drop 64 N on one pad** | 0.08 / 0.67 / **0.86** (L 0.70 / **0.90**) | lug neck at the fixed joint | 0.97 mm |
| **bracket_e v7c (1.0)** | drop 2 x 64 N + 13 N side / 20 N rim pull outward | **0.14** / 0.04 (v8 run 3 0.20, v7b 0.55 / 0.21, v7 0.80 / 0.30) | flange edge at Y 215, Z 143 | 0.10 mm (v7b 0.49) |
| **bracket_jA v8 (1.0)** | 30 N down + side / 30 N up + fore-aft at the lugs | **0.03 / 0.05** (v7 0.03 / 0.12) | cheek corner at Y 137 (W 178, 137, −40) | 0.01 mm (v7 0.02) |
| bracket_jB v7 (1.0) | as jA | 0.09 / 0.08 | arm root at the flange | 0.03 mm |
| post_seg (1.0) | 13 N at the top, one segment standing alone | 0.16 | leg root | 0.6 mm |
**Ring arc as a bolted chain** (`ring_chain_fe.py`): v6 joints worst 0.22, tip 1.1 mm sideways, but bolt + dovetail play can move the tip ~9 mm (E); + inner pair 0.20 (play ~6); **v7 = outer pair + wall brackets: worst 0.017, tip 0.025 mm**. The end frames alone under a drop are the only items near 1 (0.86 / 0.90), and the end bracket at the pad station carries the drop into the sheet (bracket_e v7c 0.14 with the whole drop on it).

## Weak-spot sweep (19 Oct 21:10; E unless M / C)
| # | Where | Check | Result | Verdict |
|---|---|---|---|---|
| 1 | Ring chain, v6 joints | FE | 0.22, tip 1.1 mm; play up to ~9 mm at the tip | the play, not the stress: brackets (v7) |
| 2 | + inner M5 pair at r 150 | FE | 0.20, play ~6 mm | not enough alone, and the groove leaves no room (Problem 14) |
| 3 | + wall brackets | FE | 0.017, 0.025 mm | **the fix, built in v7** |
| 4 | End-frame pads under a Scout free-fall (0.52 kg, 0.15 m, 0.77 J over ~3 mm, 4 pads) | energy | ~64 N per pad: frames 0.86 / 0.90, bracket_e v7c 0.14 | webs 5.0 + the end bracket at the pad station; Overseer (~245 N per pad) out of scope |
| 5 | Posts alone (one segment, 13 N) | FE | 0.16, 0.6 mm | the sheets carry; a bare post stack is floppy: fit the sheets as you stack |
| 6 | Sheet 3.0 x 397 x 441, 13 N at the centre | plate | 2.7 mm, < 2 MPa | fine |
| 7 | Acrylic at the M3 / M5 holes | bearing | ~1 MPa | fine; keep holes ≥ 15 from an edge (Problem 8) |
| 8 | Cross bar lap | clamped 28 thick between the keel plates | the bar root governs (v8 0.38, v7b 0.54) | fine |
| 9 | Bar tip pad under 13 N on the wall | bending | ~1 MPa | fine |
| 10 | Cradle up-bolts (M5 x 11 in PETG) | thread shear | 1500 N allowable vs 9 N | fine |
| 11 | Stub bolts (lean 4.7 N·m over 60) | tension | 39 N per bolt | fine |
| 12 | Wheel indexing inertia (180° in 0.6 s) | 0.7 N·m yaw | case used 3.5 | fine |
| 13 | Head belt stall 12.5 N·m on the hub | `box-arm.md` | arm chat's | |
| 14 | PETG creep under the standing ring load | < 1 MPa sustained | none | fine |
| 15 | Module dovetail flank clearance 0 (C) | geometry | the two printed modules bind | Problem 2: sand |
| 16 | Walls round holes and nut pockets (20 Oct) | `solid_check.py` | 5 parts under 1.8 (above) | v7b |
| 17 | Pads on necks (20 Oct 14:45) | `solid_check.py` neck test | bracket_e v7b and v8 only | v7c |

## Checks (`stand_v6_check.py` for the v6 set, `stand_v7_check.py` with `V7B=bar_half,toe,kb,frame_endR,frame_endL TAGS=bracket_jA=v8,bracket_e=v7c`, 20 Oct 17:50; **bar_half v8: `V7B=kb,toe,frame_endR,frame_endL TAGS=bar_half=v8,bracket_e=v7c`, 18:20**)
| Check | Result | Tag |
|---|---|---|
| Every v7 / v7b / v7c / v8 part vs every part it meets (36 placed bodies, exact volumes) | **0 mm³** at every pair; bracket_e v7c: 0 vs endR v7b / frame 0 / bracket_jB, its 135° copy 0 vs endL v7b (the cheek face sits on the block face: closest 0.0, no volume); bracket_jA v8 0 vs frames −30 / 0 and its 165° copy 0 vs −180 / endL; **bar_half v8 (both halves) 0 vs KB, cradle_keel, toe, each other and every other part (the 18:20 run placed bracket_jA v7; the bars stay below Z −165, the brackets above Z −65)** | C |
| Every part vs the 4 sheets (as 3.0 solids) | 0 mm³ (bar_half v8 too) | C |
| Brackets and end frames vs the bay module mesh at −90 / −60 | 0 vertices inside | M |
| Joint brackets vs their frames | closest 0.3 (the designed gap), 0 inside (bracket_jA v8 too) | C |
| Brackets and posts vs the funnel collar (outer surface rule) | 0 vertices inside | C |
| Ring neighbours, frames vs module, pads vs collar, base stack, arm keep-outs | as v6 (0 / 0 / 0.09 closest); bracket_e v7c cheeks start at r 153.5, the arm keep-out | C / M |
| Frame dovetails | own groove grown 0.3 with 45° flanks, own tongue flanks in 0.2 (0.14 in a module groove) | C |
| Tip-over, as drawn | **2.5** with no ballast (E) | E |
| Funnel vs the walls | mouth X ±160, Y 17..337 at Z 237 vs inner faces ±186 / −66 / 337, top 240: touches the front wall, 26 / 83 clear elsewhere | C |
| **Solid check (one body after 0.9 mm erosion, drawn features in it, no wall under 1.8, no neck under 3)** | **PASS on every file in the Parts table** (bar_half v8 on its `_W.stl`, Problem 23 d) | M |

## Hardware (M5 bolts / nuts on hand unless noted)
- Stub to mast: **4 x M5 x 12 ISO 7380 button head (buy)** + 4 nuts in the side slots. Sleeve to spigot: 2 x M5 x 50 along X + nuts.
- Base joint (KB plate, both laps, keel plate): 4 x M5 x 35 + nuts at (X ±12.5, Z −193.7) and (X ±6, Z −186). Toe to cradle: 2 x M5 x 16, nuts in the cradle's blocks. Cradle to the −90 module: 4 x M5 x 16 up through the lips (drill Ø4.2 x 11 / 14).
- Ring: 2 x M5 x 16 + nut per joint at the 4 unbracketed joints (−45, −105, −135, −165: 8); **the 4 bracketed joints take M5 x 25** (8); end brackets 4 x M5 x 35 + nuts (along Y through cheek + station block, head down the r 5 counterbore).
- Funnel: 4 x M3 x 25 into the collar inserts.
- Sheets: 4 (cut list above); posts 24 x M3 x 16 + nuts; brackets 12 x M3 x 10 + nuts; bar tips 2 x M5 x 16 + nuts; keel plate 2 x M5 x 16; toe plate 2 x M5 x 16 (nuts in the pockets).
- PSU: 2 zip ties through KB's +X wall.

## Assembly
1. KB, the two bar halves and cradle_keel on the floor, the 4 base-joint bolts. 2. Toe on the cradle's back. 3. −90 module on the cradle (4 up-bolts). 4. Mast over the spigot, 2 cross bolts. 5. Stub v3 on the mast face, then the arm. 6. Ring outward from the −90 module both ways: −60 bay, frames −30, 0, endR on the right; −120, −150, −180, endL on the left; each joint slides along its dovetail; at −15 / +15 (and 165 / 195) put the joint bracket's cheeks over the lug pair and use the M5 x 25 (bracket_jA v8: head and hex key down the head-side boss); end brackets onto the station blocks, M5 x 35 along Y dropped down the counterbore, hex key through the boss, nuts between the blocks. 7. Funnel onto the 4 pads, M3 x 25 down each lane. 8. PSU beside the mast. 9. Bottom post segments at the 4 corners; side sheets in, pushed onto the 6 bracket flanges, the bar tip pads (bar_half v8: M5 x 16 head and key in through the boss from the −X side), then front and rear sheets against the toe and keel plates; middle and top post segments as the sheets go up; drill the sheets in place through every printed hole (Ø3.2 / Ø5.5, ≥ 15 from a sheet edge), bolt.

## Problems
1. **Ballast.** None needed with the enclosure (2.5); bare v6 needs the PSU on the keel (1.61).
2. **Module dovetail has 0 flank clearance (arm_cad's design).** `arm_cad._dovetail(-1, 0.2)` grows width and depth by 0.2 each: the groove's 45° flank lies on the nominal tongue's flank (C). Fix now: sand / file the −90 module's tongue flanks ~0.2 before joining; next module version: grow the groove's width only (as `stand_v6_parts.groove_frame`).
3. **Mast fit slop** ~0.3° (0.2 sleeve gap + bolt holes): ~0.9 mm at the far bay, inside the receiver's ±3.3 capture. If the arm wobbles, shim with tape before the cross bolts.
4. **Supports:** end frames ~3900..4400 mm² of overhang (pads, webs and the wider station blocks), bar halves v8 ~2800 (boss roof, lap step), mid frames ~1600, the rest ≤ 540 (bracket_jA v8 539, bracket_e v7c 200): tree(auto) 30°. Report support g with the slice; > 25 % of the part mass sends it back.
5. **Stub bolts** are M5 x 12 button head; `box-arm.md` Problem 23 and the buy list still say x 8 (arm chat).
6. **Cross bar tip flex** 0.70 mm under the box's weight on one tip with bar_half v8 (FE, misuse; v7b 4.6 mm): fine, and the sheet box braces the tips.
7. **FE loads are estimates (E):** 2 kg arm, 20 N head push, 13 N rim hand case; the hang, 50 N pad and 128 N bracket cases are deliberate misuse. Coupon calibration of `printopt` (current-parts test 20) applies here too.
8. **Sheet holes are drilled in place** (DEFAULT): every hole ≥ 15 from a sheet edge (acrylic cracks nearer than ~3 x the hole).
9. **Flat around the funnel mouth:** walls level with the rim, so a drone more than 76 off centre lands on the open flat beside the collar (26 at the sides, 83 behind). The landing gate is ±30 (`v2/box-funnel.md`): margin lost, not a failure; sheet aprons are the fix if the scatter turns out larger.
10. **Sheets' top edges** are free between posts (~2 mm flex under a hand, E); a top rail if it rattles.
11. **Ring chain play without the brackets** ~9 mm at the tip: until the side sheets are on, the ring is floppy, not weak. Fit the sheets before swinging the arm hard.
12. **End bracket reach** is ~60 from the ring to the sheet; v7c's solid arms carry it at 0.14.
13. **Funnel pads under a drone drop:** ~64 N per pad from a Scout free-fall: end frames 0.86 / 0.90 alone; the end bracket at the pad station carries it. An Overseer drop (~245 N per pad) is not covered by this ring.
14. **No inner bolt pair on the frame joints:** the full-length dovetail groove (rho 150..164) and the arm keep-out (r ≥ 145.5) leave no radial room for a second lug; the brackets alone do the job (0.017), so the pair was dropped (DEFAULT).
15. **Posts are 12 loose segments** bolted only to the sheets: nothing holds a post until its sheets are in; assemble corner by corner with the sheets, never stack bare posts.
16. **Corner posts don't touch the floor parts:** the base ties to the sheets through the bar tips, keel plate and toe plate instead.
17. **Topology runs and the cloud's 6 GB:** pardiso OOMs above ~60k design cells; run every part with `NOX_BACKEND=gmg` (3.4 GB at 202k design cells, 38 s / iteration on 2 cores, T). A check or FE beside a run can push the box over: bracket_e run 4's first start died at iteration 1 (20 Oct 14:40). Install `sparse_dot_mkl` first: without it gmg's sparse products run ~3x slower (bracket_jA: 4 s / iteration at 20k design cells with it; bar_half without it: 6 s at 22.6k). **`solid_check.py` on a print pose turned 45° (bar_half v8: 164 x 160 x 16 box, ~27M voxels at 0.25) needs over 7 GB and killed the cloud box once (20 Oct 18:15): run it on the `_W.stl` (axis-aligned, 4M voxels).**
18. **Topology and wide-cheek parts are heavier, by design** (Spark 23:24: weight free): bracket_e 54 → 110 g, bracket_jA 23.4 → 38.4 g, bar_half 45.4 → 77.6 g; the tip-over only gets safer.
19. **Thin walls round holes (found 20 Oct by the solid check, all fixed in v7b):** five drawn parts had walls of 0.85 to 1.5 beside an M5 hole or a nut pocket; the 1..2 mm voxel FE could not see them. Any new hole or pocket gets ≥ 2.0 of material all round, and the solid check confirms it.
20. **bracket_e topology runs 1 and 2 rejected:** run 1 drew 36-long cheeks with the thin-hole flaw and the generated body reached them only in a 4 mm strip (pulled from Nox Print Files 01:10); run 2 fixed the cheeks but the h 2.0 layout left members at the floor (1.00 on the 1 mm FE vs 0.55 drawn).
21. **bracket_e topology run 3 pulled (Spark 14:19 "why is the bracket disconnected"):** it drew only the 10.2-wide bolt pads, but the bolt-head access cut (r 5.5) was wider than the pad, so the generator could reach each pad only round its corners: both pads hung on 2..3 mm necks (joint ~45 mm², M) and the 0.9 mm erosion test passed them. Its 0.20 came from a 1.5 mm FE grid that cannot resolve a 2 mm neck. Fixes: neck test in `solid_check.py`; access cuts never wider than the pad, with a drawn boss wall round the counterbore (README Rules, Solid parts); the drawn bracket redone as v7c (0.14, beats every topology run so far). Lesson for every v8 chat: draw the clamped interface **with its boss**, keep access cuts inside it, and judge on a FE grid at most a third of the smallest neck.
22. **bracket_jA v8 setup (20 Oct 17:55), three findings, all fixed in `bracket_j_setup` (bracket_jB inherits them):** (a) the v7 setup's lug-bolt access cuts (r 5.5) were 11 wide on a 12.7-wide cheek, the bracket_e v8 flaw; Spark: draw an r 8.5 boss tube (≥ 3 wall) round each bolt outside each cheek. A full tube hits the frames' rib webs (Y 150..156 / 198..204, 5 from the bolt): 95..215 mm³ per tube (C). DEFAULT: a **U-boss**, full 3.0 wall on the free side and both rho sides, open toward the rib where the frame already blocks any material; cheeks widened to Y 136..149.7 / 204.3..218, rho 163..183.6 so every boss sits fully on its cheek (0 mm³ outside, C). Moving the ribs would mean new mid / end frames (asked first, not done). (b) **The ring keep-out (r 179.3) sat inside the frames:** frame_mid's X-brace node corners reach r 179.85 (C, Y 150.5); run 1 put generated material 0.6 into them (7..9 mm³, fit check). Keep-out now **r 180.2** (frames + 0.3); `bracket_e_setup` still uses 179.3 (no bracket_e run is planned after run 4's rejection, `v2/log.md` 17:05; raise it before any new one). (c) A box-shaped access slot tangent to the r 5.5 bore left 2 edges shared by 4 faces at the boss end (rerun, M): the access is now one obround (hull of two bores), rebuilt from the saved density; watertight, 0 non-manifold edges.
23. **bar_half v8 (20 Oct 18:25), four findings, all fixed in `bar_half_setup` / `stand_v7_topo_build.py` / `stand_v8_bar_export.py`:** (a) **the v7 setup's tip-bolt access cut (r 5.5, X 140..177) reached Z −180.5, above the pad top (Z −181)**, so it could cut the pad off from behind (Spark 17:07). Fix: drawn boss r 8.5 (X 165..177) round an **r 5.0 access** (DEFAULT: the 16-wide bar leaves only 2.5 beside an r 5.5 cut; r 5.0 = bracket_e v7c's counterbore, M5 head 8.5), pad grown to the boss top. Tip bolt position, lap holes and the sheet plane X 186 unchanged. (b) **Run 1 failed the solid check:** two 6-thick generated rails ran along the top of the access path and landed on the boss's back end, whose 3.5 wall was their only link to the pad; at the 2.0 erosion they and the boss top split off (2 x 93 mm³, M). Run 1 was otherwise strong (0.39, 0.68 mm). Retry: a flat roof 6.0 over the cut (boss and pad top Z −175), so anything landing on the boss reaches the pad through ≥ 4: PASS. (c) **The generated web stopped 0.6 off the bed face** (Y 46.61..61.41, M): the density ends at the grid's cell edge (Y 46.5) and the build holds generated material 0.5 inside the envelope, so ~7400 mm² of the web floated 0.6 above the bed (bed contact 1207 mm², M). Fix: `BED_SKIN` in `stand_v7_topo_build.py`, the part's own outline at Y 48 extruded flat to Y 46 as a drawn body, rebuilt from the retry's density (no new layout; +3.7 g, M): bed 5833 mm², overhang 7408 → 2797 mm². Every v8 part printed on a flat face needs the same check. (d) **Export:** the build leaves ~270 near-degenerate faces (3.6e-12 mm², M) that split into a zero-area shell after the 45° turn and a float32 write; `stand_v8_bar_export.py` merges corners within 1e-3 mm and drops the faces that collapse (volume change 0.0). At exactly 45° one z-ray column of the solid check's voxeliser lands on an edge and reads a 1-voxel second body that is outside the part at 0.05 / 0.1 pitch (as the arm hub, 0.12° turn): the print pose is 45.12°, same bed face. The gate runs on `box_bar_half_v8_W.stl` (Problem 17).
24. **kb v8 run 1 (20 Oct 18:40), not shipped; five findings, (a)..(d) fixed in `kb_setup` / `stand_v7_topo.py` / `stand_v7_topo_build.py`:** (a) **access cuts vs their pads (C):** the rear nut + driver cut (r 5.5) left 2.5 in the 16 x 18 boss; the 4 base-joint head cuts (r 5.0) reached the plate top (0 above the upper pair), sat 0.08 apart and notched the floor to 2.3. Fix (DEFAULT): a 3.0 shell r 8.5 round the rear access (Y −54..−50.5, stops at the PSU) and one head pocket (hull of the 4 cuts, floor kept at 3.0 as v7b) in a 3.0 shell Y 28..46 that also closes the end plate over the upper holes (5.25 above them, was 2.25). `kb_setup_check.py`: 0 mm³ of the 3.0 ring missing round every cut. Spigot bore, sleeve keep-out, joint holes and rear plate bolts unchanged. (b) **the support region held 0 elements** (box Z −201.5..−200 missed the h 2.0 cell centres at −199): the FE would have run unsupported; now the first cell layer (1896 elements). (c) **no PSU keep-out:** the envelope (X ±36) let v8 fill the PSU spot (X 25..89, Y −50..−10, DEFAULT); keep-out X 24.5..89, Y −50.5..−9.5, floor to −129. (d) **OOM after the build (6.1 GB, killed twice):** `noxopt.strength_report` always used pardiso, and `solid_check` at 0.25 pitch shared the box with the build's own grids. Fixes: under `NOX_BACKEND` the as-built recheck runs on `noxopt_local` gmg (`stand_v7_topo.py` and the rebuild); the rebuild saves the `_W.stl` first and runs the solid check as its own process (it PASSES standalone); a 2-triangle 0.0 mm³ sheet at the spigot bore floor (Z −198, a coplanar face from the generated surface) is dropped, components under 0.01 mm³ only. (e) **weaker than v7b:** FE 0.096 vs 0.091 (h 2.0, same grid); lean improved (0.078 vs 0.091) but yaw rose (0.096 vs 0.073) at the spigot corner Z −128, where the generated collar must stop below the mast sleeve (keep-out from Z −130): the bare 2.0 spigot twists against a stiff root. Not fixed: the spigot and the sleeve are fixed interfaces, and the run cannot taper what the keep-out forbids. kb v7b stays.

## Status
20 Oct 18:40 (kb chat): **kb v8 topology run 1 not shipped**: solid check PASS, watertight, 158.7 g, but FE worst 0.096 vs v7b 0.091 (yaw at the spigot corner under the sleeve, Problem 24 e); **kb v7b stays READY**; kb setup fixed (access shells, support, PSU keep-out) and the OOM fixes for every topology run in Nox Source.
20 Oct 18:25 (bar_half chat): **bar_half v8 READY** (`box_bar_half_v8.stl.zip.b64.txt`, sha aacd009b7ae1, print 2): topology with a roofed tip bolt boss and a flat bed skin, worst 0.38 (v7b 0.54) on the same FE, tip 0.70 mm (v7b 4.6), 77.6 g, solid check PASS, watertight, fits 0; v7b file removed (Problem 23).
20 Oct 17:55 (bracket_jA chat): **bracket_jA v8 READY** (`box_bracket_jA_v8.stl.zip.b64.txt`, sha 21af8faad391): topology on widened cheeks with U-bosses, worst 0.05 (v7 0.12) on the same FE, 38.4 g, solid check PASS, watertight, fits 0 / 0.3; v7 file removed; ring keep-out fix r 180.2 (Problem 22).
20 Oct 14:45 (stand chat): **bracket_e v7c READY** (`box_bracket_e_v7c.stl.b64.txt`, sha 55f717ab05f8): worst 0.14 (v8 run 3 0.20, v7b 0.55), 109.8 g, solid check PASS with the new neck test, fits 0; v8 file pulled (pads on necks, Problem 21); `solid_check.py` neck test; every other stand file PASSES it; topology run 4 on the v7c cheeks running.
20 Oct 05:00: bracket_e v8 (topology run 3) READY, pulled 14:30.
20 Oct 02:30 (stand chat): **strict solid check** (Spark 01:08) built (`nox/solid_check.py`, README Rules "Solid parts", in `arm_topo.run_part`, `stand_v7_topo_build.py`, `stand_v7_parts.py`); every stand file checked; **kb, bar_half, toe, frame_endR, frame_endL, bracket_e reissued as v7b** (all PASS, fits 0, FE unchanged or better); v7 files removed from Nox Print Files; bracket_e topology run 1 pulled; topology setups given fastener access keep-outs.
20 Oct 00:25: bracket_e topology run 1 (retracted 01:10). 19 Oct 21:35: v7 enclosure. 21:10: weak-spot sweep. 20:50: v7e proposal. 20:15: v6 FE. 19:40: v6 parts READY. 18:05: v6 layout. 18 Oct 01:25: v5e (2040), retired 19 Oct.
