sparkiscool/nox/nox/box-case.md

# Box bay modules + ring frames (v4i 17 Oct 2026; ring closed with printed frames on the printed stand, 19 Oct)

**Casing and ring frame: retired.** Numbers: `v2/dimensions.md` I, `nox/box/arm_layout.py` (v4c block). Scripts: `arm_cad.bay_module_parts` / `bay_strip`, `arm_run_baymod.py`, `post_v4.py`; the module's drawn receiver comes from `v2/s2_cartridge.py`. Arm: `nox/box-arm.md`. Stand: `nox/box-stand.md` (v6, all printed). Coordinates: W (arm doc).

## Bay modules (v4i, printed 2x as is)
**Spark 17 Oct 02:00..02:29:** every bay is the same module, at least Overseer size, the Scout receiver centred so the gripper lands in the middle of the receiver's notch; modules bolt long side to long side round the ring with one opening for the drone; the opening gets as much room as the funnel allows; M5 bolts and nuts. Scout only now: no Overseer receiver is drawn.
**Positions (C):** 12 positions at 30° (the pitch that packs the modules and divides the heads' 90°); the drone at 90°; the **opening is 90° wide (60..120°)**: a module at 60 / 120 would reach into the collar's 168 opening column and the drone's feet and plate; with the 45° opening edges every module point above Z 102 has |X| > 84. **Built now (stand v6, 19 Oct): the −90° bay on the cradle, the second bay at −60° (DEFAULT, lowest root moment), a printed ring frame (below) in each of the other 7 positions (30, 0, −30, −120, −150, −180, −210); every piece hangs on its neighbour's lugs and dovetail, and the two end frames (30°, −210°) carry the funnel's seat pads on their 45° / 135° ends.** Head A picks from the −90° bay while head B waits under the drone and returns the dead pack to the same bay (`box-arm.md` Swap cycle).
**Each module** (`box_baymod_v4`, v4i) holds one Scout cartridge (v3) long side along the axle, flat bottom toward the axle at r 100, top at r 148, **tab line Y_C 175** (cartridge Y 137.5..216.5):
- **Drawn functional surfaces = the drone receiver** (`v2/s2_cartridge.py` receiver() as of 16 Oct 23:40, mapped X = −x, Y = Y_C + z − 37.5, Z = 100 + y): 30° lead-ins at the mouth (r 102, ±3.3 capture), locating faces 0.3 off the guide rails (±20.3) and the end faces, **the two latch pockets** (the cartridge's bolts spring into them exactly as in the drone), both **contact shoe modules** (copper-clad shoe on an AA spring). The drone receiver's 01:10 slim shoe walls are not in yet (a few grams, next rerun).
- **Back plate** r 149.5..152.5 with a **TPU 95A strip** 36 x 76 x 1.5 under it (`box_bay_strip_v1`): the head installs to the strip as at the drone.
- **Charging: main contacts only (Spark 17 Oct 01:18).** Problem 4.
- **Joints to both neighbours, long side to long side (C):** each module stops 0.3 short of its ±15° planes. Per side, at Y 145 and 209 (over the receiver, Spark 03:25: no long arms): an **M5 lug pair** at r 165..179 outside the frame (14 x 14; head side +X 7 thick with Ø5.5, nut side −X 9 thick with Ø5.5 and an M5 nut pocket 8 AF x 4.3 on its far face; **M5 x 16 + nut, E**), and a **dovetail segment pair** (Y 135..155, 199..219; tongue on +X, groove on −X, 45° flanks, 6 → 12 wide over 3, centred r 157, walls ≥ 4) that holds the joint shut. The groove runs the module's full length. **Its flank clearance is 0 (Problem 7).**
- **Swap a bay:** take out its 4 M5 bolts (heads and nuts outside the ring) and **slide the module out along +Y** (away from the arm); checked at every distance to fully out: no contact with either neighbour (C).
**Run (v4i, 17 Oct 06:20):** env = its 30° sector less 0.3 per side, r 99.5..163, **Y 133..221** (the Scout receiver's length; its near end is the print bed); kept clear: both heads swept to the seat (dilated 1), the cartridge path, the bars' sweep, the groove. Overhang filter on, built from the near end. Load cases (11): head insert push 20 N through the strip, extract pull 20 N through the pockets, contact shoe springs ±10 N, a hand on the back plate 20 N four ways, the pack at 3 g three ways. Support: its joints.
**Result v4i: 83.4 g (M; drawn 54.6), one body, function 0 / 0 / 0 after the post cut (`post_v4.py` cuts every keep-out back out and trims dead-end horns flush), thin 0, wrinkle 0.22 / 0.38, worst 0.05 (extract pull 20 N). Print near end (Y 133) down: 92.6 x 73.2 x 87.6, bed 462 mm², tree supports ~21 g (E, overhang 2714 mm²).** Files: `box_baymod_v4.stl` (print pose), `box_baymod_v4_W.stl` (wheel coords, for the sweep). **Printed as is (no v4j):** publish it to Nox Print Files and print 2.

## Ring frames (v6, drawn 19 Oct 19:40; `nox/box-stand.md` Parts, `stand_v6_parts.frame()`)
A frame is a bay module with no receiver: the same 30° sector and the module's lug pairs (from `arm_cad`), dovetails with real flank clearance (`tongue_frame` / `groove_frame`), and a drawn truss: two ribs at Y 153 / 201 (beside the lugs so nut pockets and bolt heads stay reachable; chords r 148..153 and 174..179, one diagonal each) and X-braces on the outer and inner faces. Drawn, not generated (DEFAULT, speed): the loads are small (E: 2.5 N·m per chain root) and a truss of 2.0+ members prints on the joint plane with vertical ribs. **frame_mid x5** (−30, 0, −120, −150, −180), 47.6 g (M); **frame_endR** (30°, +X joint with a flat pad instead of a tongue so it prints on that face, pads on the 45° end), 81.6 g; **frame_endL** (−210°, −X joint, pads on the 135° end), 81.2 g. Any frame is later swapped for a bay module. Checks: 0 mm³ at every frame joint, 0 module vertices inside the frames at −90 / −60 (M).

## Charging (open, Spark decides after DubHacks)
Main contacts only (17 Oct 01:18), no balance leads in the box. The dual-channel charger charges only 2 bays; parallel charging is unsafe (packs arrive at different voltages). **For now: 2 bays wired live, the rest filled with packs charged on the bench.** With 2 bays the dual-channel charger covers both.

## Problems
1. **Overseer:** not drawn (Spark 17 Oct 02:02: Scout only). A full Overseer cartridge (est. 153 x 51 x 57 E) carried at park reaches r ~107 and only just fits the 30° sector at r 100: grow R ~9 or lower its cartridge when it is designed. Its module reuses this joint pattern (Y 145 / 209).
2. **Module overhangs:** v4i needs ~21 g tree supports each (E, 2714 mm² over 45°). Accepted for this build (no rerun).
3. **Joint stiffness:** the joints sit only at the outer rim (lugs r 172) and r 157 (dovetail); the inner edges near r 100 are unjoined. With the frames the ring is closed through the funnel (end frames' pads), which takes the racking out of each joint (stand v6); check the first chain by hand anyway; add an inner lug pair if it racks.
4. **No cell balancing in the box (17 Oct 01:18):** charging through the main contacts only never balances the packs (`v2/s2-contacts.md` Problem 5). Fix (DEFAULT): CHECK the charger charges LiPo with no balance lead; charge in the box to 4.15 V/cell (E); balance-charge each pack on the bench every 10 cycles (E) or when a cell checker shows > 0.05 V spread (E).
5. **Funnel and drone centre along the axle:** the tab line is Y_C 175, so the seated pack is centred near Y 177; the collar sits on Y 177 on the end frames' pads (`box-stand.md` v6). The collar panels themselves are unchanged.
6. **Dead-end spikes (Spark 17 Oct 09:2x):** the smoothed surface can leave a horn that carries no load. Fix for every generated part: before sending, look for dead-end branches (skeleton endpoints away from drawn parts) and trim them flush with a plane or box at the nearest drawn face.
7. **Module dovetail flanks have 0 clearance** (found 19 Oct): `arm_cad._dovetail(-1, 0.2)` grows width and depth by 0.2 together, which slides the groove's 45° flank along itself, so it lies on the nominal tongue's flank (C). Fix: sand / file the −90 module's tongue flanks ~0.2 before joining the −60 module; next module version grows the groove width only (as `stand_v6_parts.groove_frame`).

## Status
19 Oct 19:40 (stand chat): ring frames drawn and READY (frame_mid x5, frame_endR, frame_endL; `box-stand.md`); the end adapters of the 18:05 layout are merged into the end frames. 17 Oct 09:30: bay module v4i 83.4 g (M), one body. Nothing printed.
