sparkiscool/nox/claude/research-queue.md

# Nox research queue

Driven by a continuous research loop in Spark's research chat. Spark, 11 Oct 15:37: keep running in every direction until he says stop. Spark, 11 Oct 20:58: ramp up, and stop Monday 12 Oct at 7:00 am when his usage limit resets (am assumed). Waves of 10 agents in parallel, one topic and one report each at `claude/research/<YYYY-MM-DD>-<slug>.md`, up to 60 searches+fetches each, every wave time-boxed to ~90 min. WebSearch is capped at 200 per turn, shared by all agents, so each wave runs in its own turn (the loop logs a wave, schedules a 1-minute wake-up, and the next wave starts with a fresh budget; 18 WebSearch per agent, WebFetch for the rest). A scheduled stop fires Mon 12 Oct 7:00; the last wave ends by 6:40. Between waves the loop alone edits this doc: items to Done, follow-ups straight into Open, one Digest line per report, one Run log line per wave. The Mon-Fri scheduled task "Nox research" stays paused.

Spark: add, reorder or delete items freely. Top of Open = next wave. Items starting `!` jump the queue. Other chats may add items, Done or Digest lines; they are kept.

Focus (Spark, 11 Oct): tech first. Competitors' hardware and designs Nox can borrow, then every other direction. Business, market and regulation items sit lower but still run.

Rules for reports:
- Research only. Never edit `nox/` docs, numbers or parts. A finding that suggests changing a shared number or part goes under "For Spark" in the report, tagged E, with the source, naming the Nox doc and quoting the Nox value it was compared against.
- Competitor items: the mechanism (how it actually works, with patents or teardowns where found), the key numbers, and a "Steal for Nox" list naming the Nox part, one line each.
- Every number carries its source, or E. No em dashes. Short, under ~1000 words.
- Primary sources first: datasheets, papers, maker docs, patents, teardowns, product pages.
- Check `claude/*-research.md` and `claude/research/*.md` for overlap first, and build on them.

## Running now (wave 4, 11 Oct ~22:50 to ~00:20)
- Two-drone RC and failsafe setup: ELRS Model Match, second handset, COM_RCL_EXCEPT, box-side kill path, datalink-loss action, MAV_SYS_ID and DDS namespaces (comms, Scout, Overseer firmware)
- PX4 EKF2 without GPS or compass: yaw from external vision or a box tag, EV dropouts and resets, height-reference switching over the box edge (Scout, Overseer firmware)
- Box camera tag pipeline: upward camera tracking a tag on a drone 0.3 to 1.5 m up, latency and pose accuracy, relay latency to PX4 (Box X11)
- Ground effect and downwash at the catcher: sparse bars and closing jaws under 3.5 in and 10 in props (Box catcher, Overseer catch frame)
- Thin carbon-strip rib cages: flexural data, arch buckling and inward crumple, hook mounts, weights (Scout v2 cage)
- Overseer lidar mount: L2 field of view vs props and frame, tilt, motorized sweep (Overseer)
- In-flight collision recovery on caged drones: Flyability US12134488B2 anti-tip, contact-recovery controllers, PX4 options (Scout firmware)
- Inspection payloads that sell on small drones: thermal, gas, UT, zoom; masses, prices, what customers pay for (Scout, Overseer, business)
- US drone sourcing rules: FCC Covered List, NDAA, Blue UAS, state bans; what they mean for the MicoAir FC, Unitree L2, ELRS and Radxa (business)
- Manway and hatch sizes in target facilities vs the Scout cage (277.4 across corners) and a Scout v2 envelope target (Scout v2 cage, pitch)

## Open
1. Box charger control: iCharger 456DUO / X6 / X8 MODBUS map vs the 4010DUO (sold out), ISDT CM1620 CAN / RS-485 protocol and balance-port behaviour, cheaper per-slot CC/CV modules (Box X10; from fast charging and balance/ID reports)
2. Inspection data delivery and export: Orbit, Korial Connect, Gecko Cantilever, Flyability Inspector, Skydio 3D Scan, Nearthlab grading, ScoutDI API into integrity systems, point-cloud viewers; report contents and CMMS/EAM links customers expect (data product)
3. Radxa Zero 3W hardware: Wi-Fi chip, 5 GHz, AP and monitor mode, throughput with the u.FL antenna; 40-pin I2C buses vs UART3 on pins 3/5; Linux / ROS 2 drivers for VL53L1X / L7CX on the RK3566 (Scout; from comms and standoff reports)
4. ROS 2 over Wi-Fi for two drones and the box: Zenoh vs a Fast DDS discovery server, multicast cost, uXRCE-DDS namespaces (comms, firmware; from comms and multi-drone reports)
5. Downwash and wake of a 2 kg S500 on a 0.5 kg caged quad: safe horizontal and vertical separation indoors, measured data (Overseer, Scout; from multi-drone report)
6. Unitree L2 firmware and timing: SDK issue #25 half-rate time base, IMU stamp gaps, 2.8.x firmware notes; how to bench-measure L2-to-Pi latency (Overseer; from Pi 5 SLAM report)
7. Market: will Ondas/Airobotics + Cyberhawk and Beam/ScoutDI dock-plus-data combos move indoors; what they charge per site or subscription; facility inspection buyers and budgets (business, Box pitch; from inspection players report)
8. Batteries for small inspection drones with swaps: LiPo vs HV LiPo vs Li-ion (21700, pouch) vs semi-solid; energy density, C-rate, cycle life at a swap-every-flight cadence (cartridge, Overseer)
9. Motor and prop choice for 3 to 3.5 in caged quads: efficiency data, KV, prop pitch, flight time per gram (Scout, Scout v2)
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
