sparkiscool/nox/runs/arm_eccbush/v1/preview.png

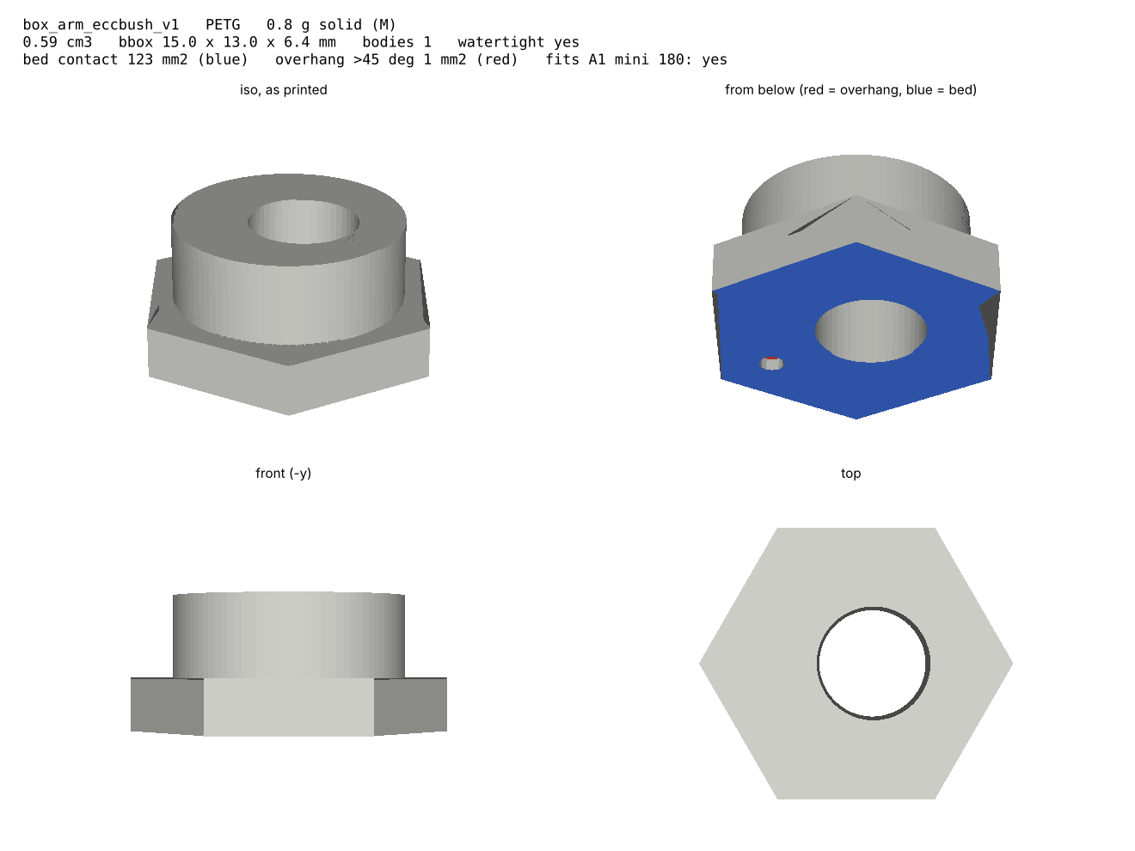
runs/arm_eccbush/v1/preview.png
