sparkiscool/nox/runs/arm_pinion16/v3/preview_box_arm_pinion16_v3.png

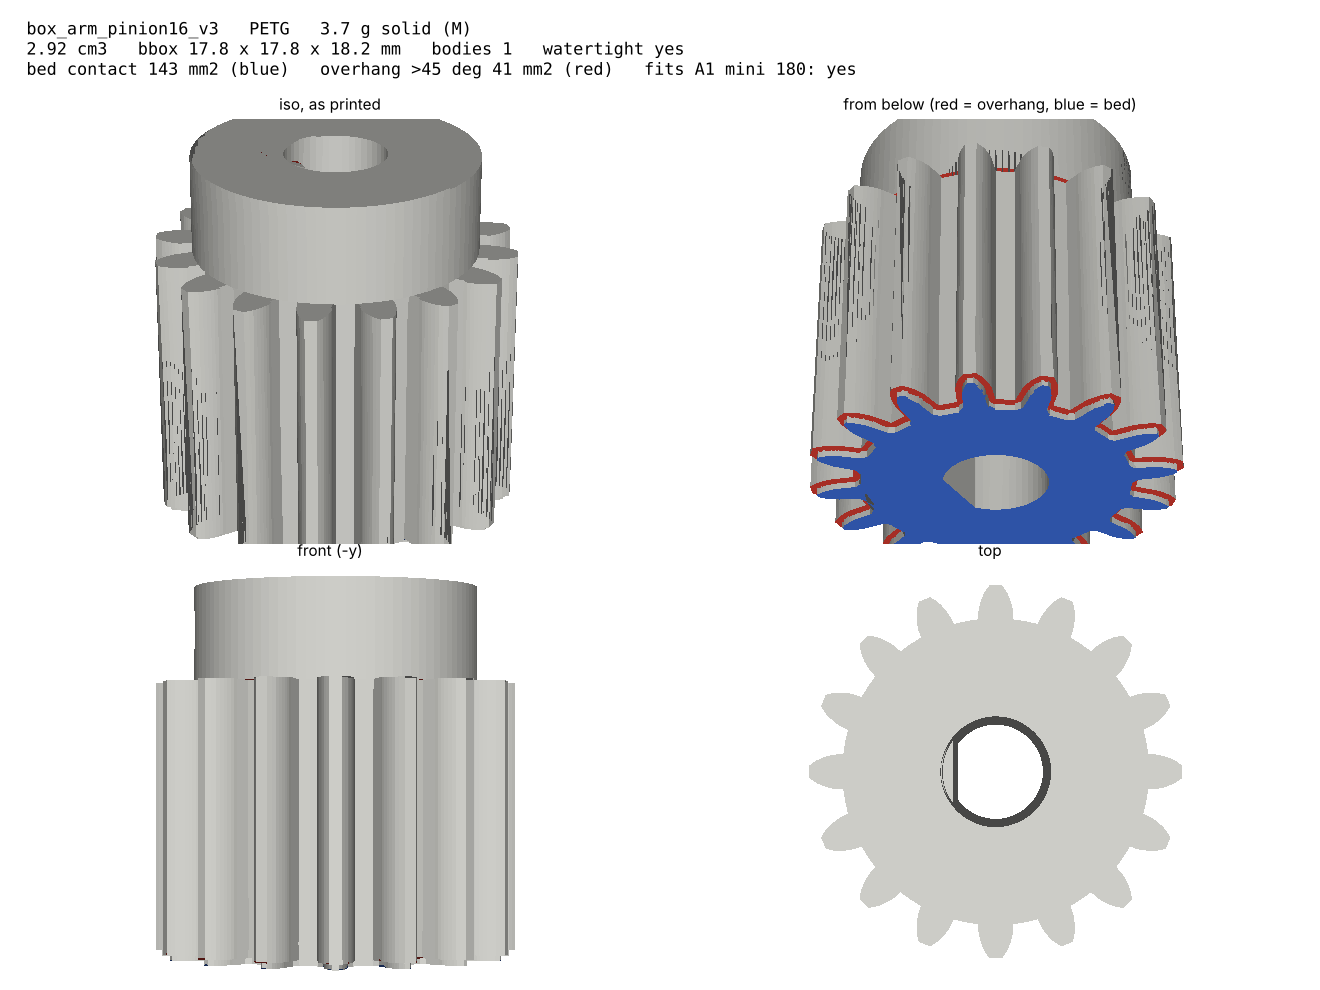
runs/arm_pinion16/v3/preview_box_arm_pinion16_v3.png
