sparkiscool/nox/runs/arm_rail/v5/preview_A.png

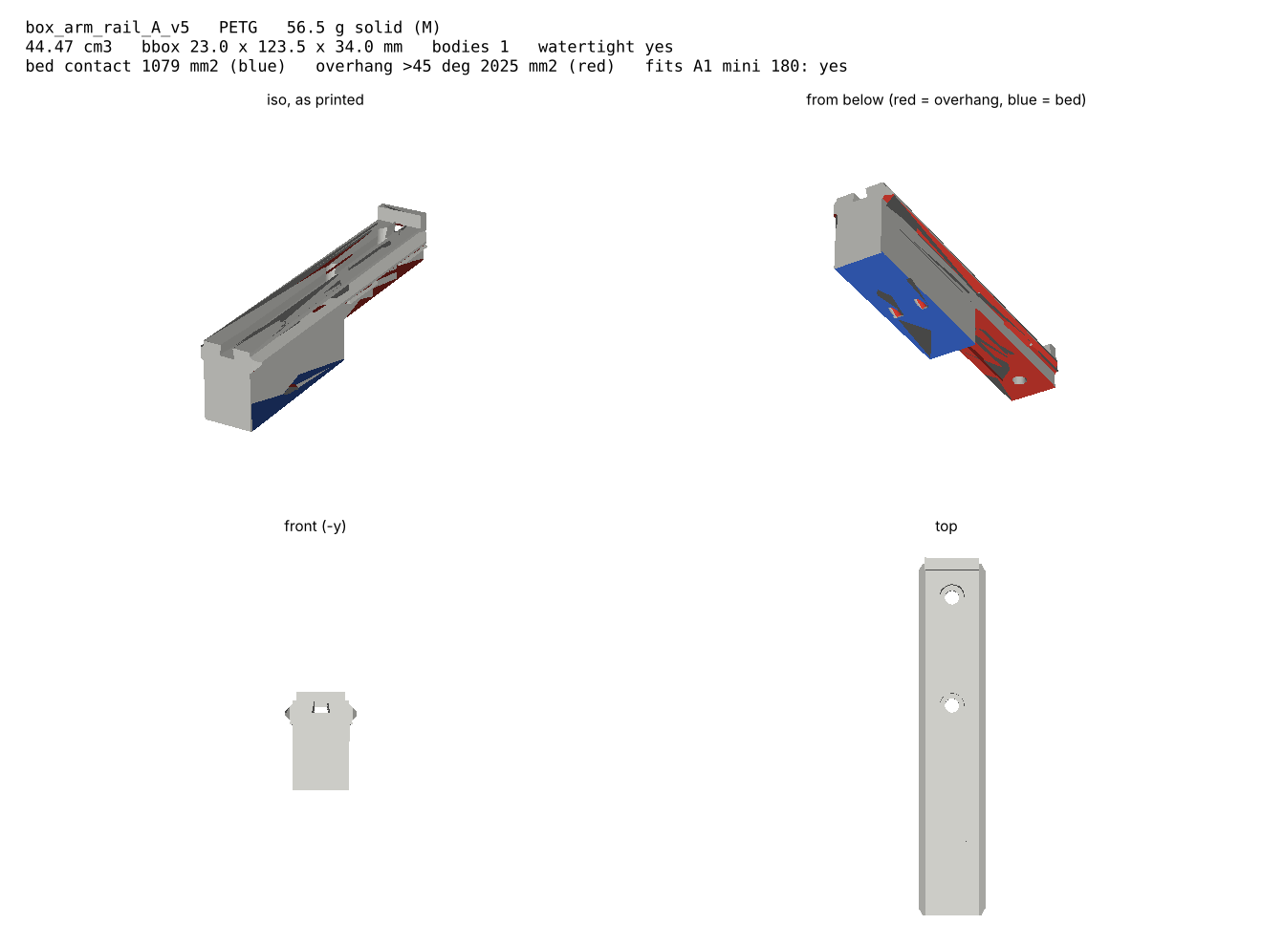
runs/arm_rail/v5/preview_A.png
