sparkiscool/nox/runs/arm_vwheel/v1/preview.png

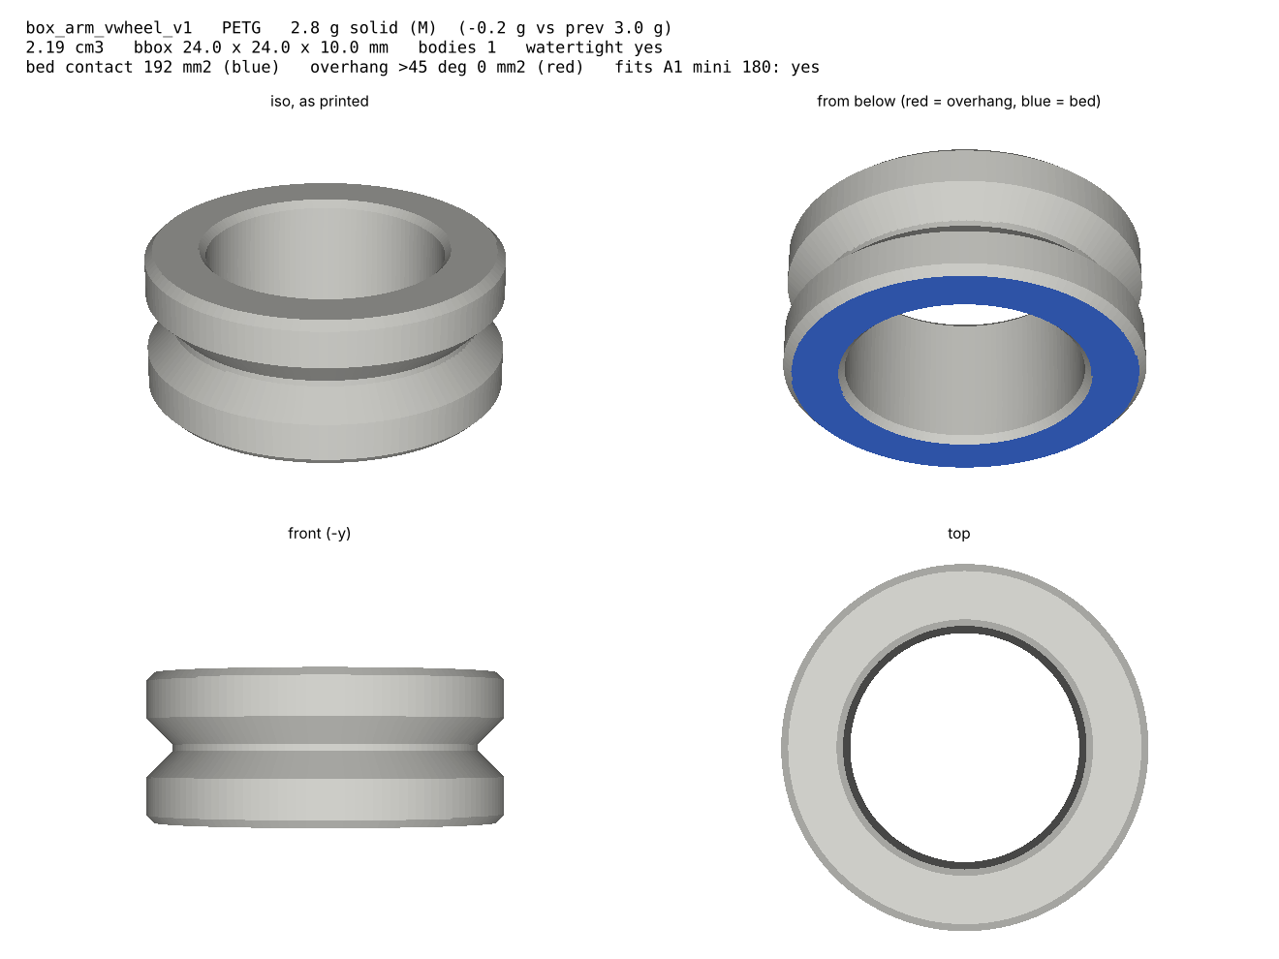
runs/arm_vwheel/v1/preview.png
