sparkiscool/nox/runs/bar_half/organic-v2/preview.png

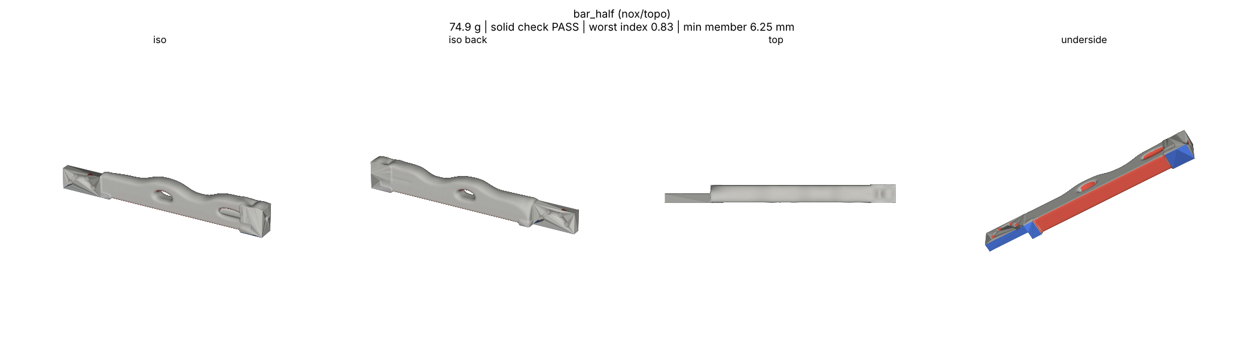
runs/bar_half/organic-v2/preview.png
