sparkiscool/nox/runs/battery_latch/v4/figs/compare_v1_v2.png

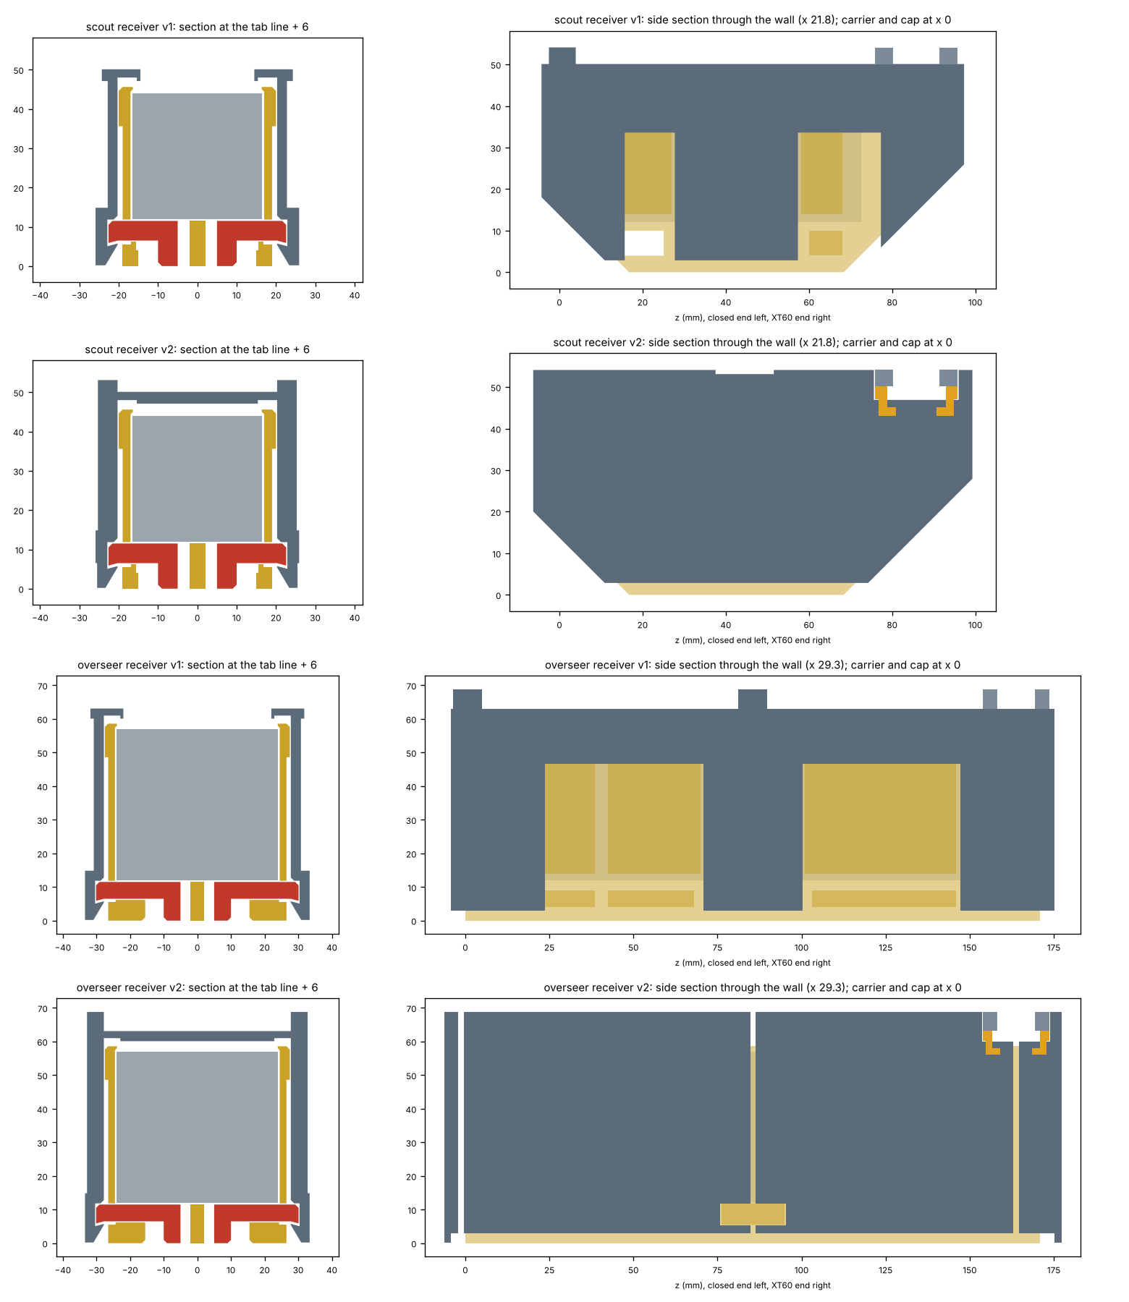
runs/battery_latch/v4/figs/compare_v1_v2.png
