sparkiscool/nox/runs/battery_latch/v4/figs/fe_swap_across_43.5_N_+x.png

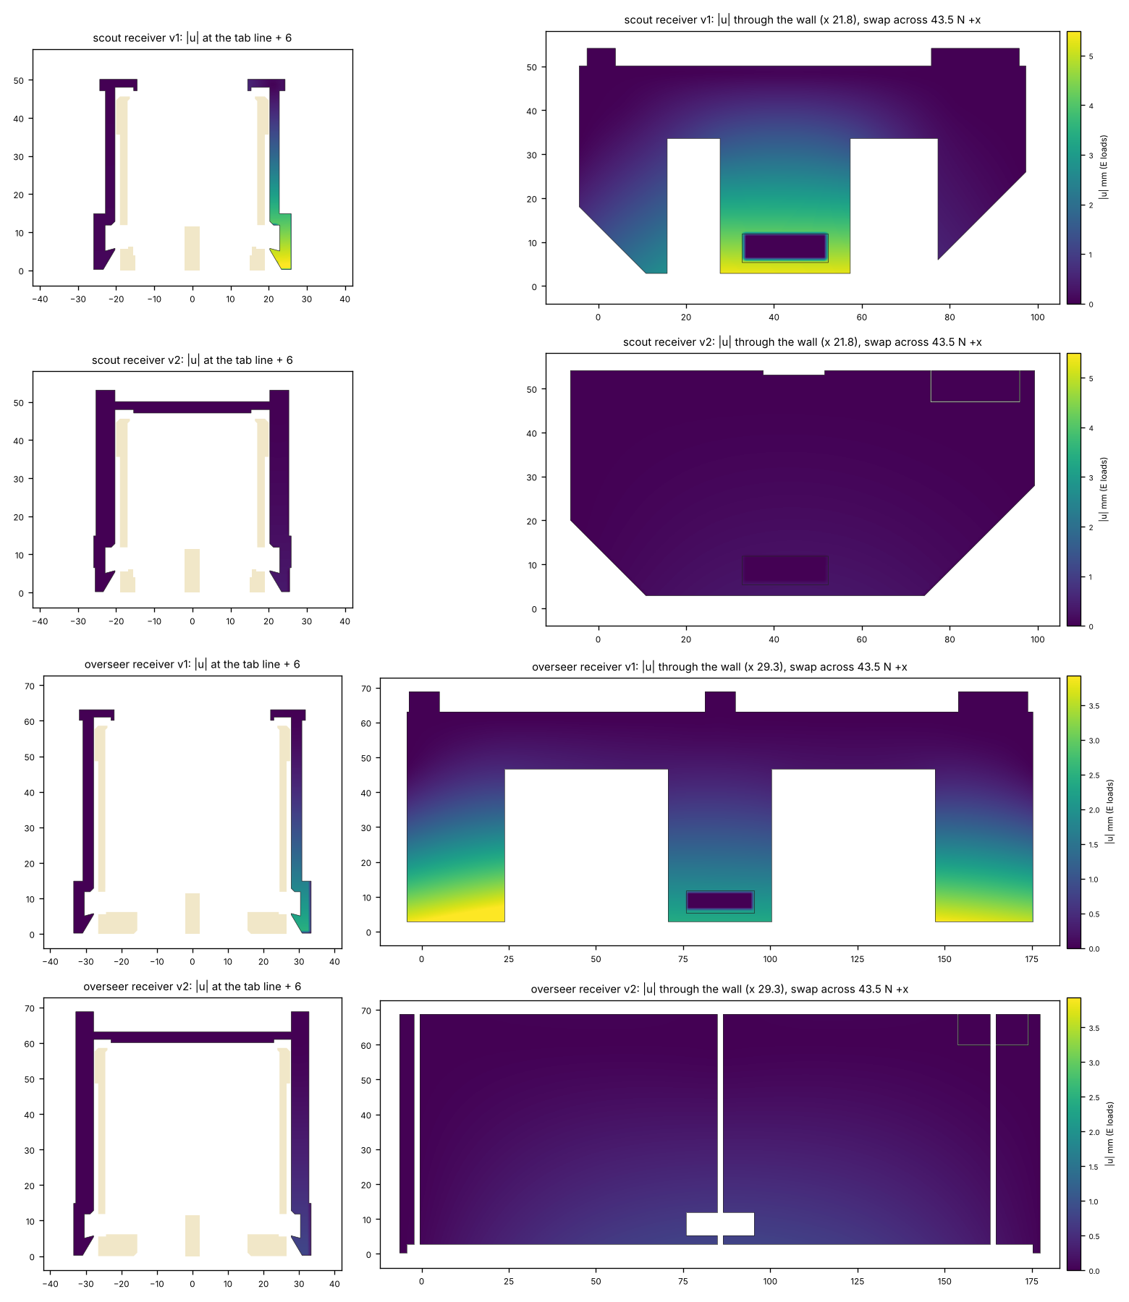
runs/battery_latch/v4/figs/fe_swap_across_43.5_N_+x.png
