sparkiscool/nox/runs/battery_latch/v4/figs/scout_collar.png

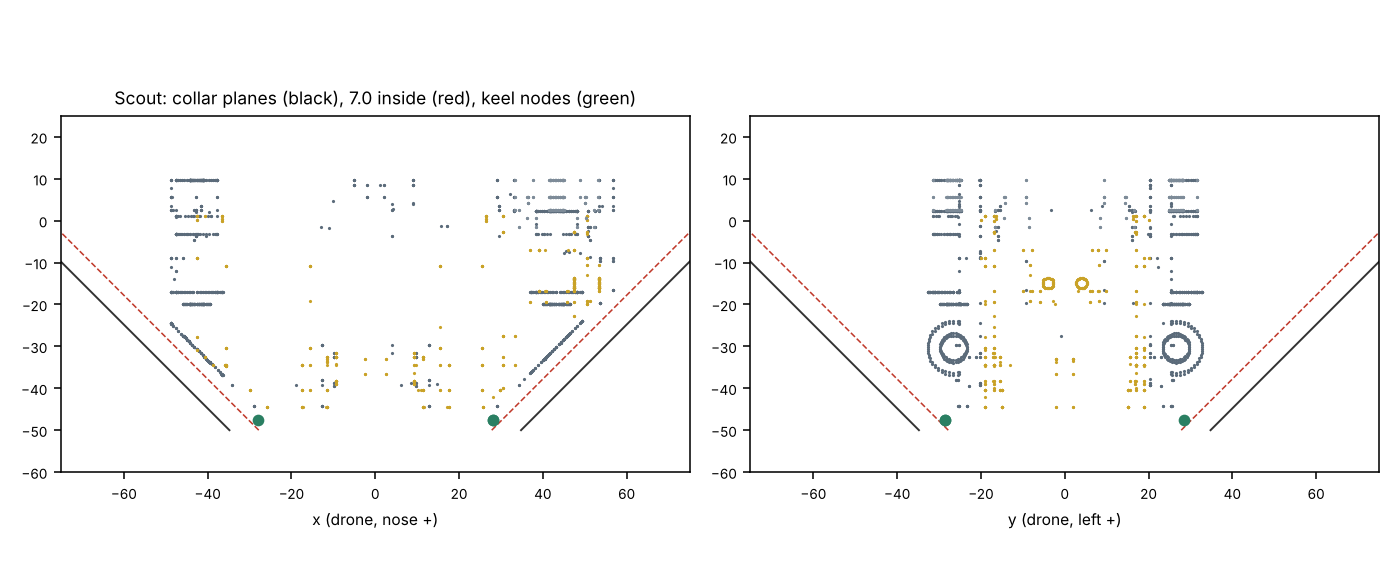
runs/battery_latch/v4/figs/scout_collar.png
