sparkiscool/nox/runs/battery_latch/v4/figs/sections.png

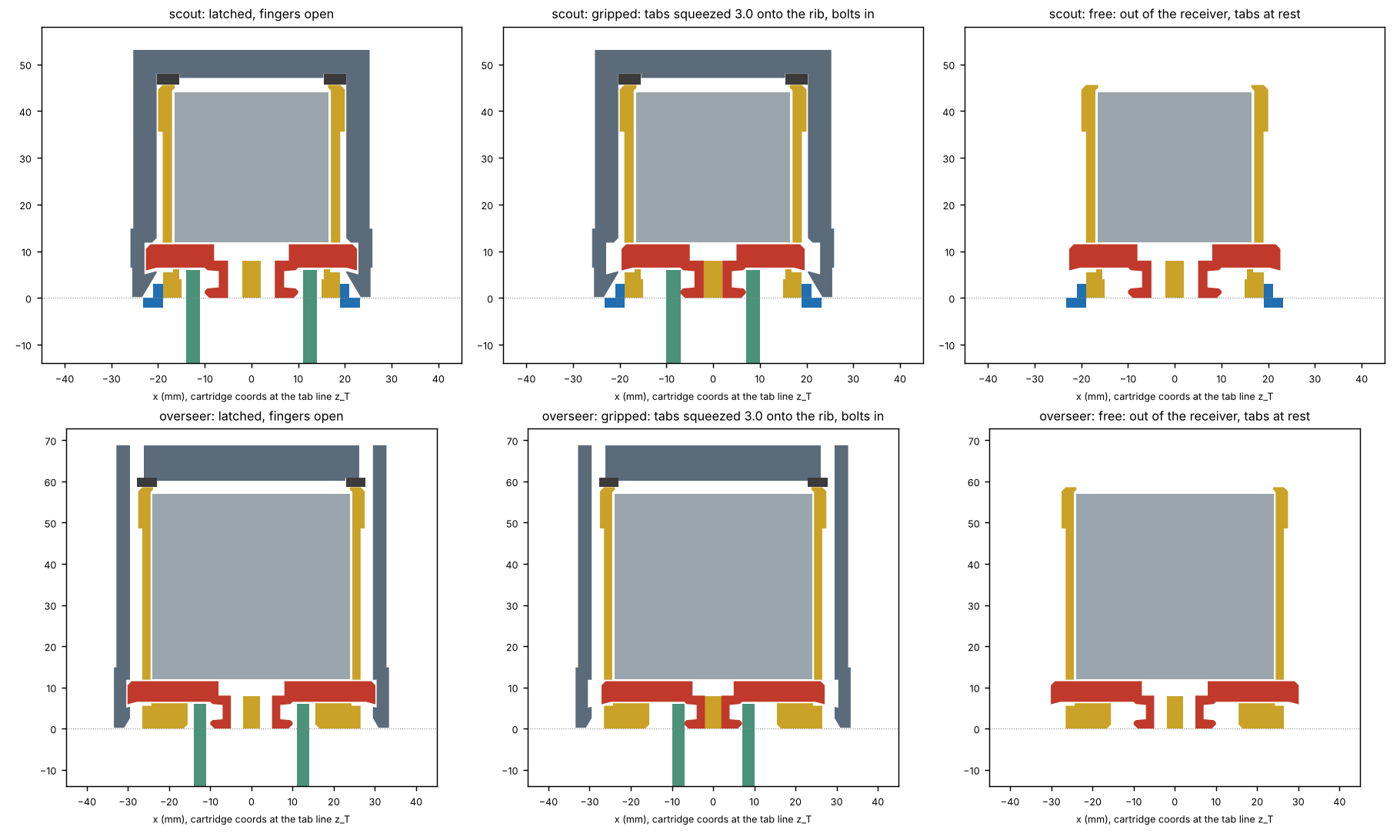
runs/battery_latch/v4/figs/sections.png
