sparkiscool/nox/runs/battery_latch/v4/figs/sets.png

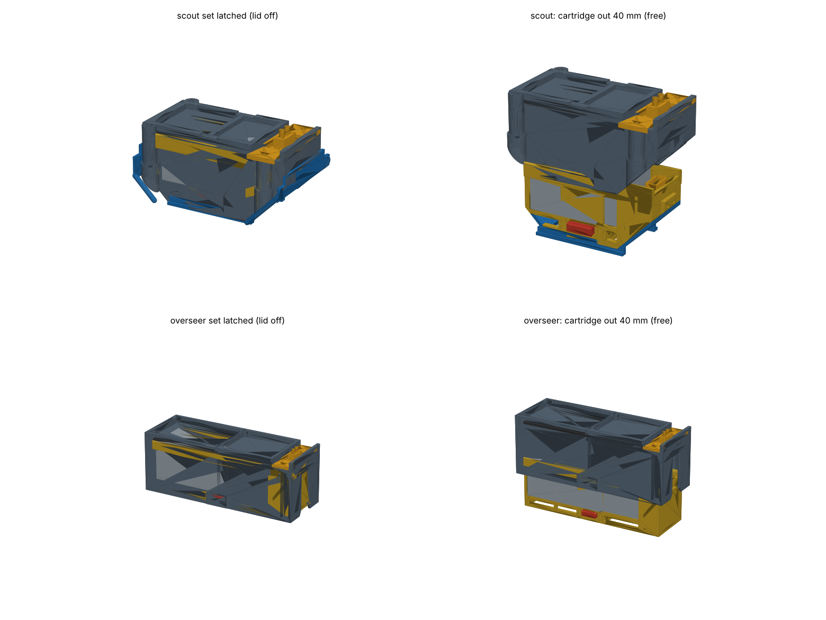
runs/battery_latch/v4/figs/sets.png
