sparkiscool/nox/runs/battery_latch/v4/preview_box_battery_cart_strip_scout_v1.png

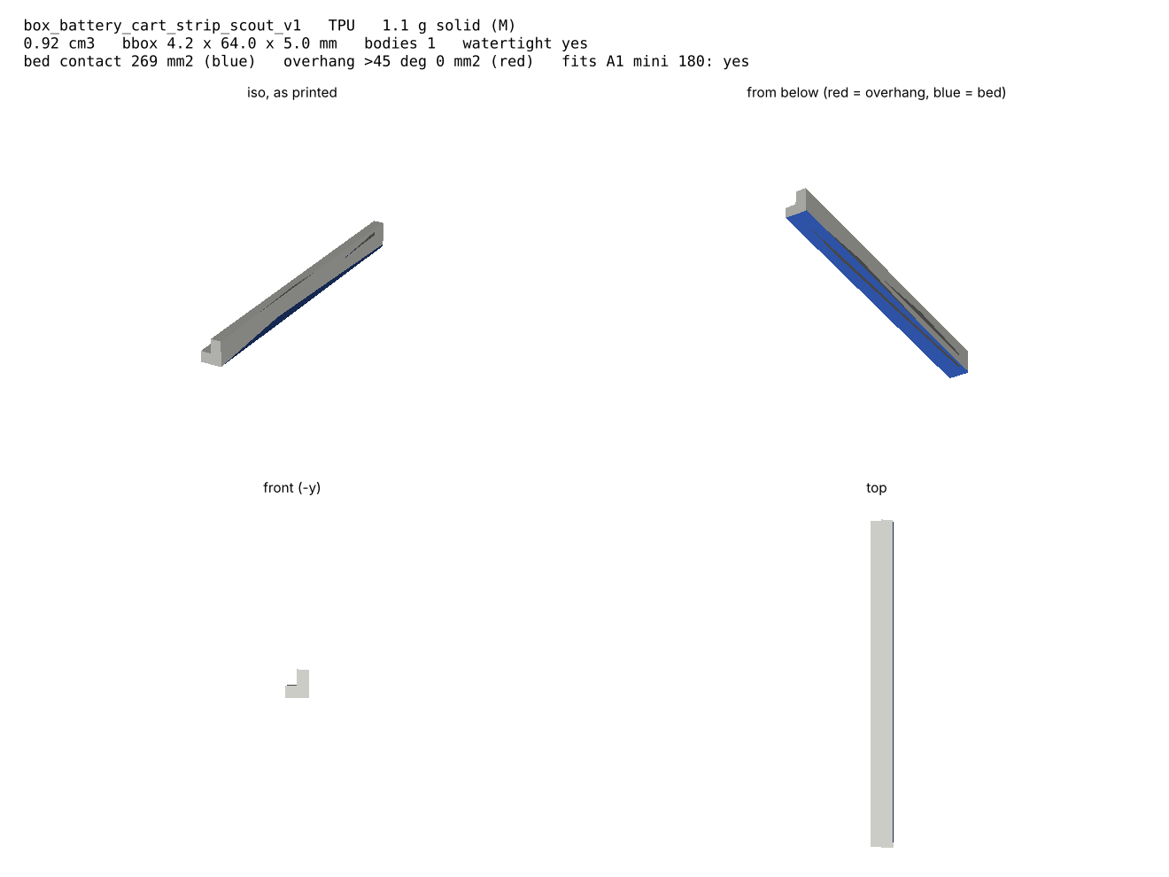
runs/battery_latch/v4/preview_box_battery_cart_strip_scout_v1.png
