sparkiscool/nox/runs/battery_latch/v4/preview_box_battery_cartridge_overseer_v6.png

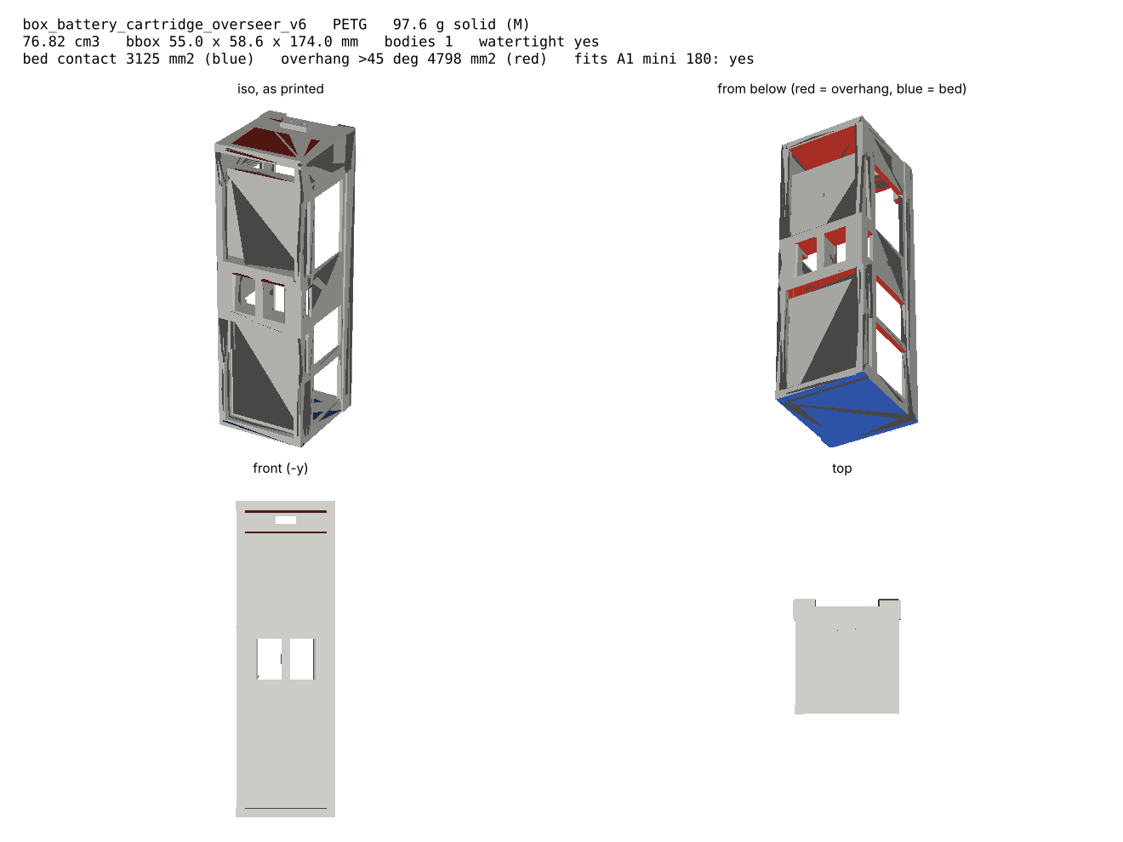
runs/battery_latch/v4/preview_box_battery_cartridge_overseer_v6.png
