sparkiscool/nox/runs/battery_latch/v4/preview_box_battery_cartridge_scout_v7.png

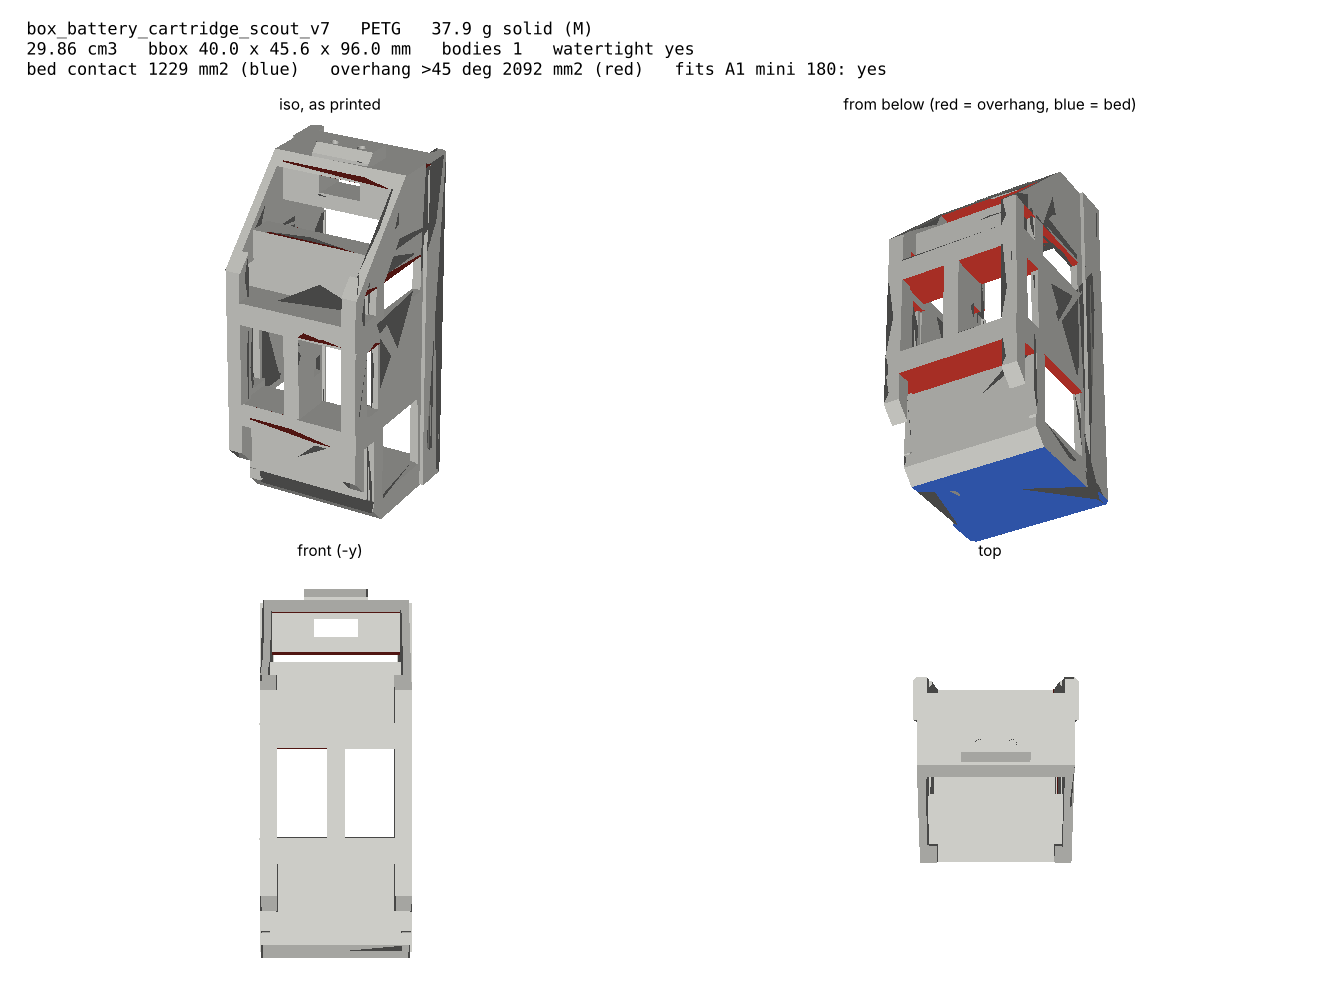
runs/battery_latch/v4/preview_box_battery_cartridge_scout_v7.png
