sparkiscool/nox/runs/battery_latch/v4/preview_box_battery_receiver_lid_overseer_v1.png

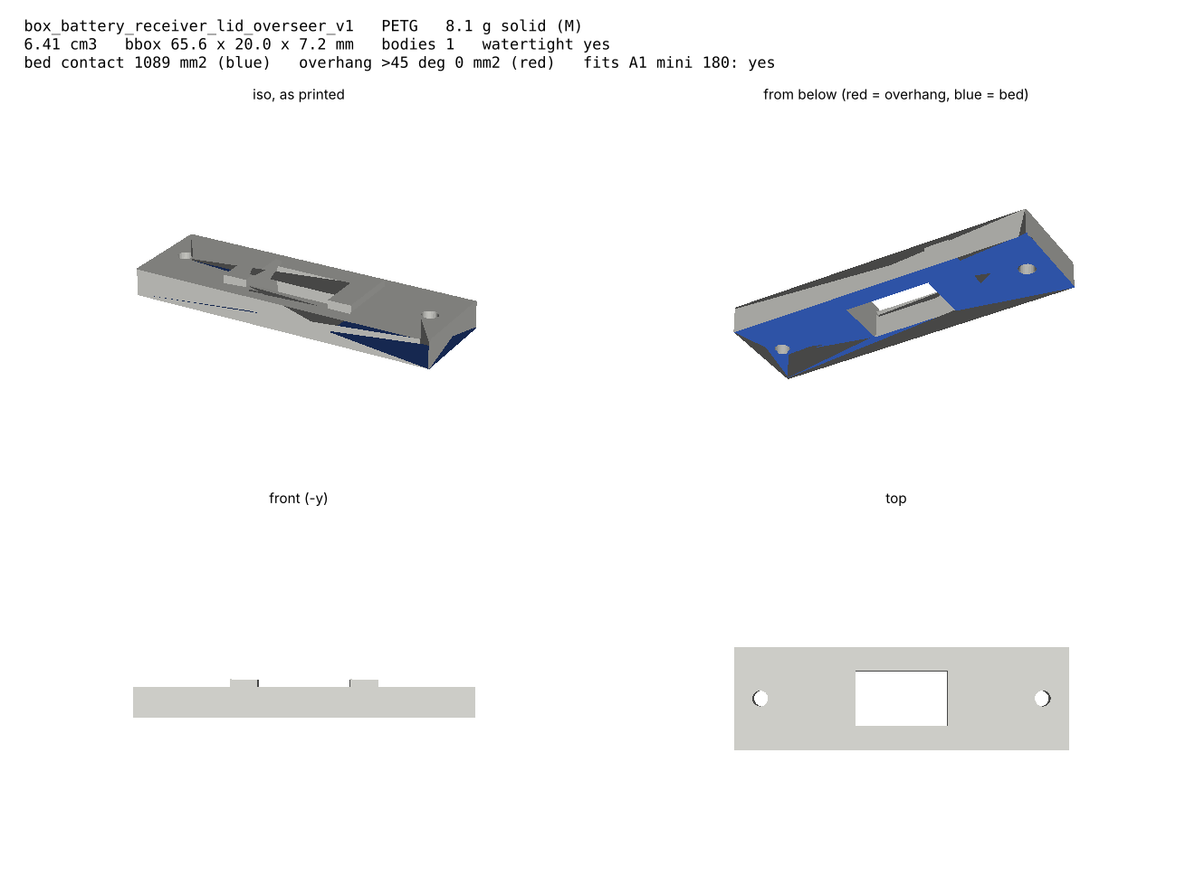
runs/battery_latch/v4/preview_box_battery_receiver_lid_overseer_v1.png
