sparkiscool/nox/runs/battery_latch/v4/preview_box_battery_receiver_scout_v3.png

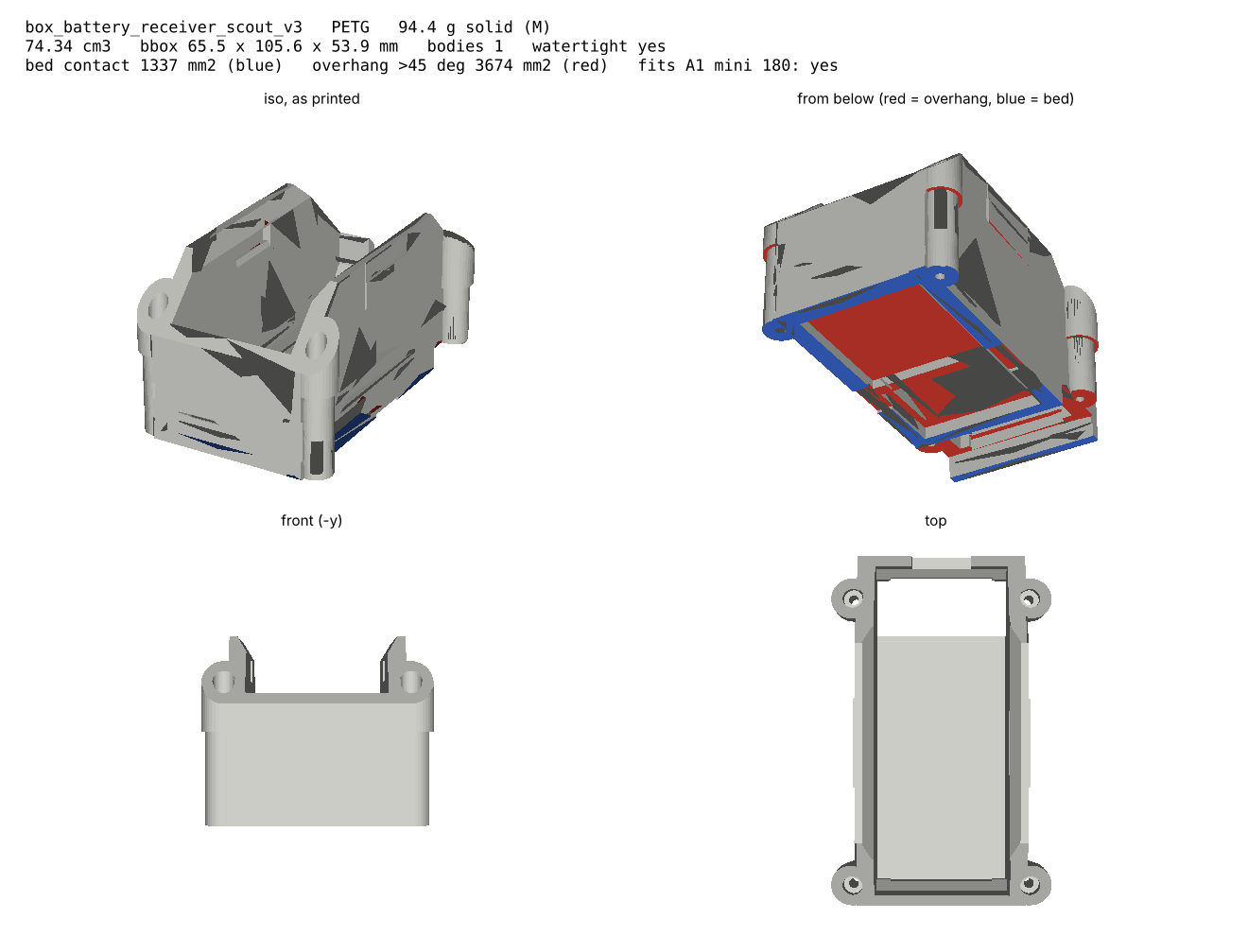
runs/battery_latch/v4/preview_box_battery_receiver_scout_v3.png
