sparkiscool/nox/runs/battery_latch/v4/preview_box_battery_rskid_nose_scout_v2.png

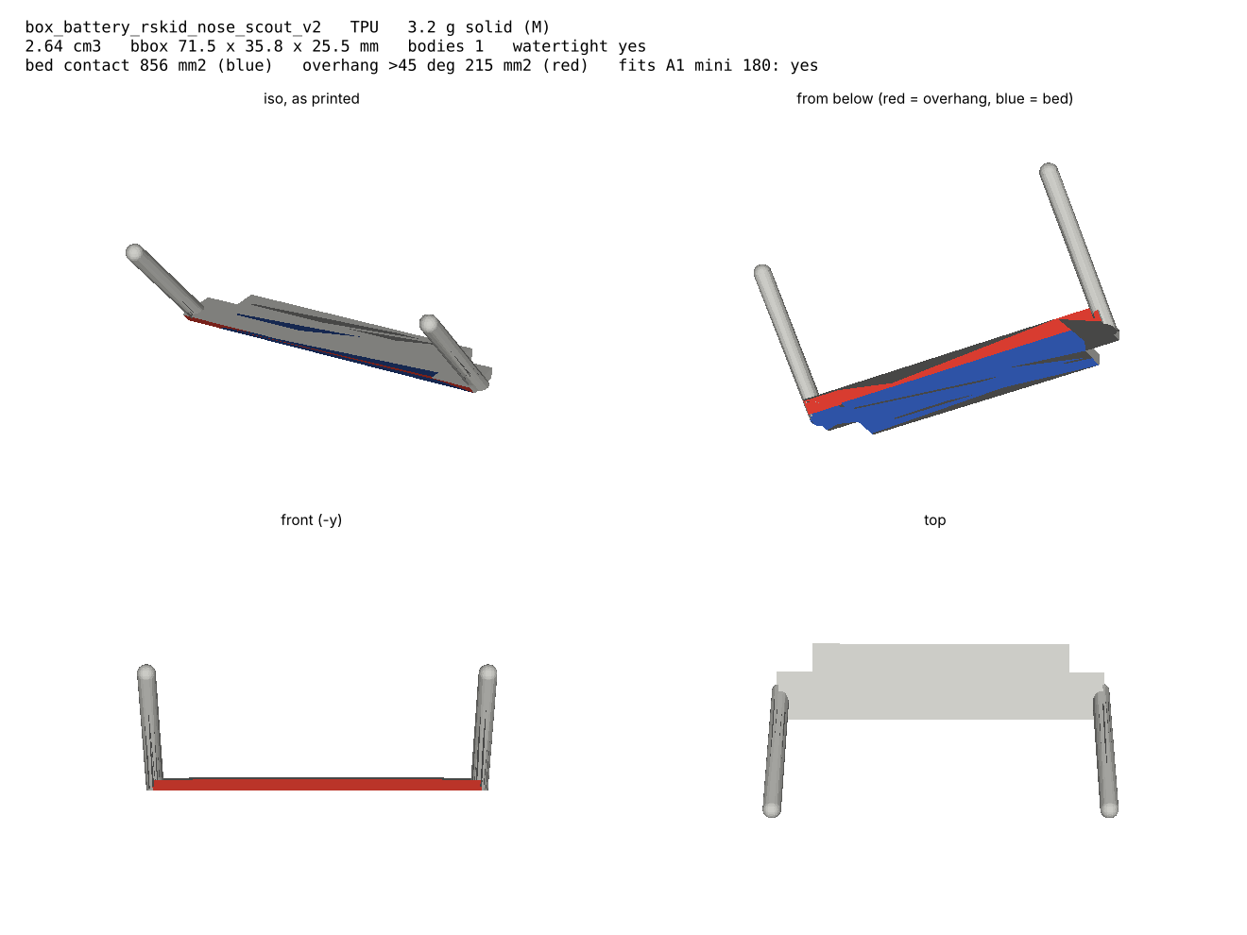
runs/battery_latch/v4/preview_box_battery_rskid_nose_scout_v2.png
