sparkiscool/nox/runs/battery_latch/v4/preview_box_battery_skid_lead_scout_v2.png

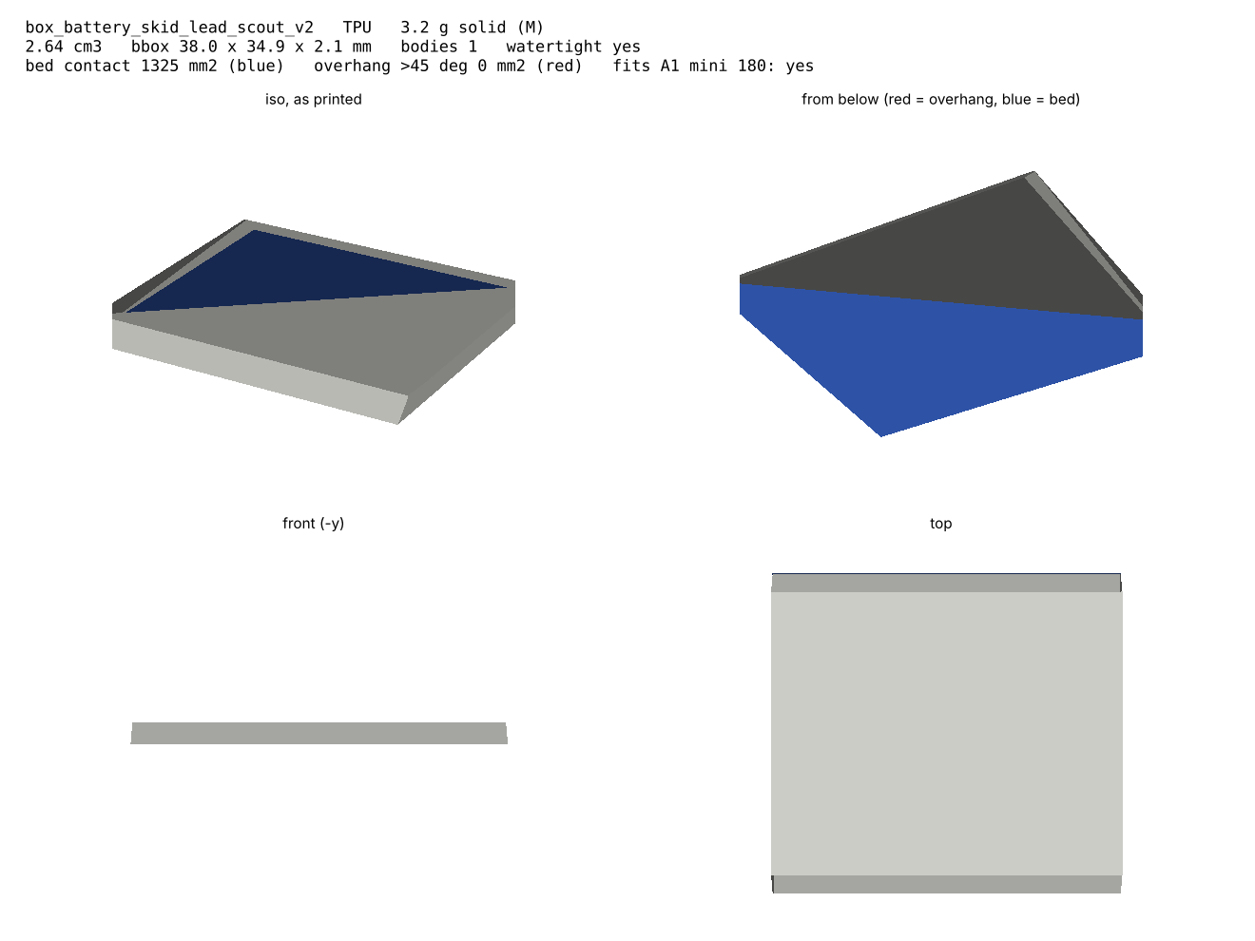
runs/battery_latch/v4/preview_box_battery_skid_lead_scout_v2.png
