sparkiscool/nox/runs/battery_latch/v4/preview_box_battery_slider_scout_v6.png

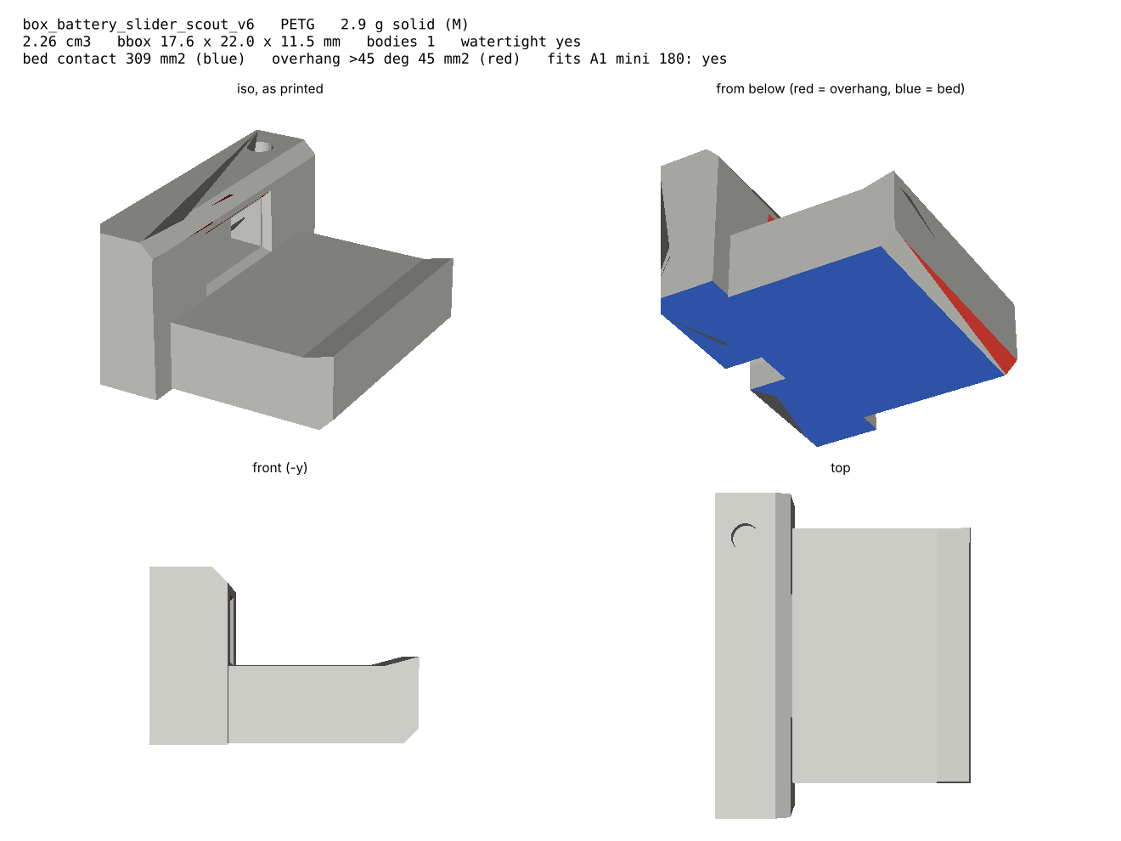
runs/battery_latch/v4/preview_box_battery_slider_scout_v6.png
