sparkiscool/nox/runs/box_electronics/v1/preview.png

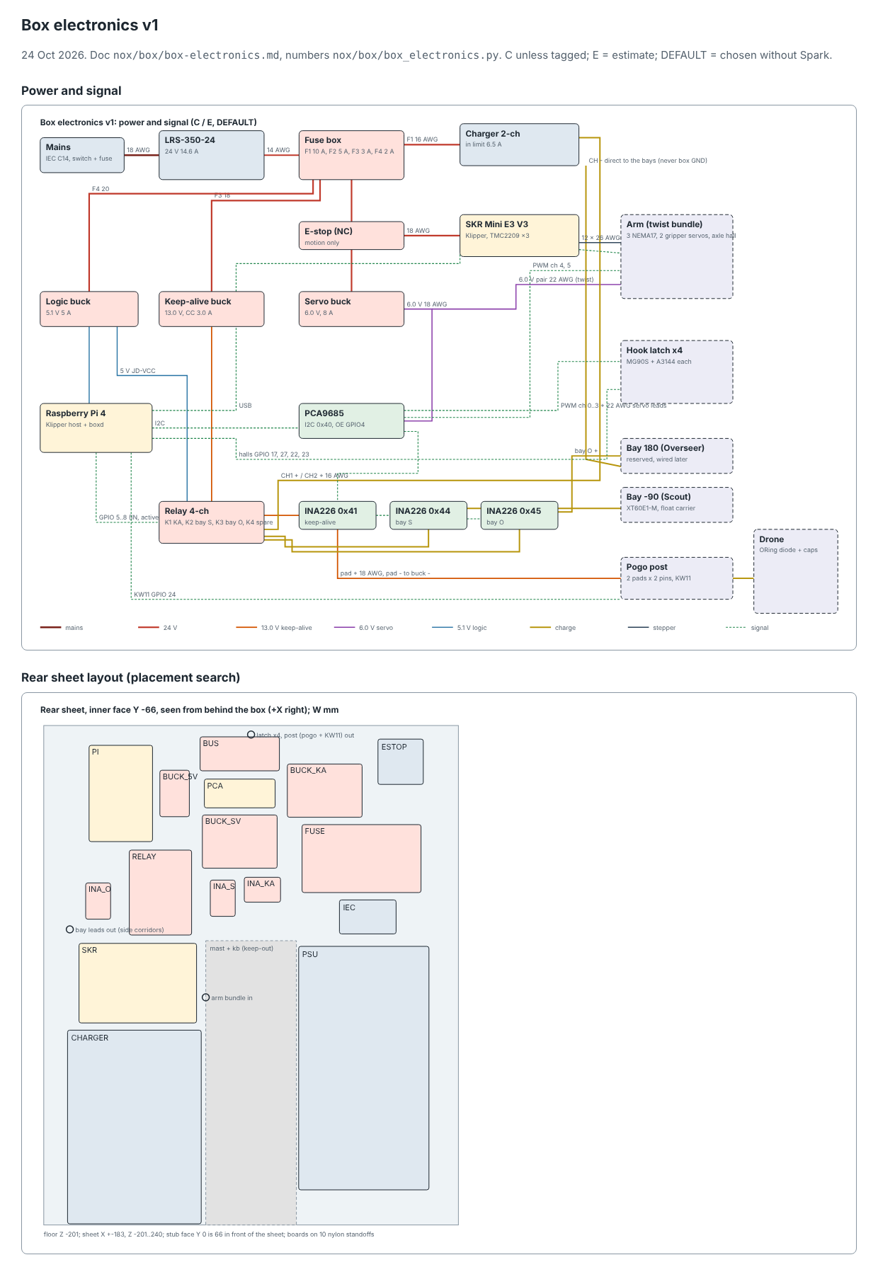
runs/box_electronics/v1/preview.png
