sparkiscool/nox/runs/box_system/v2/topo_r2/g2000/view_iso.png

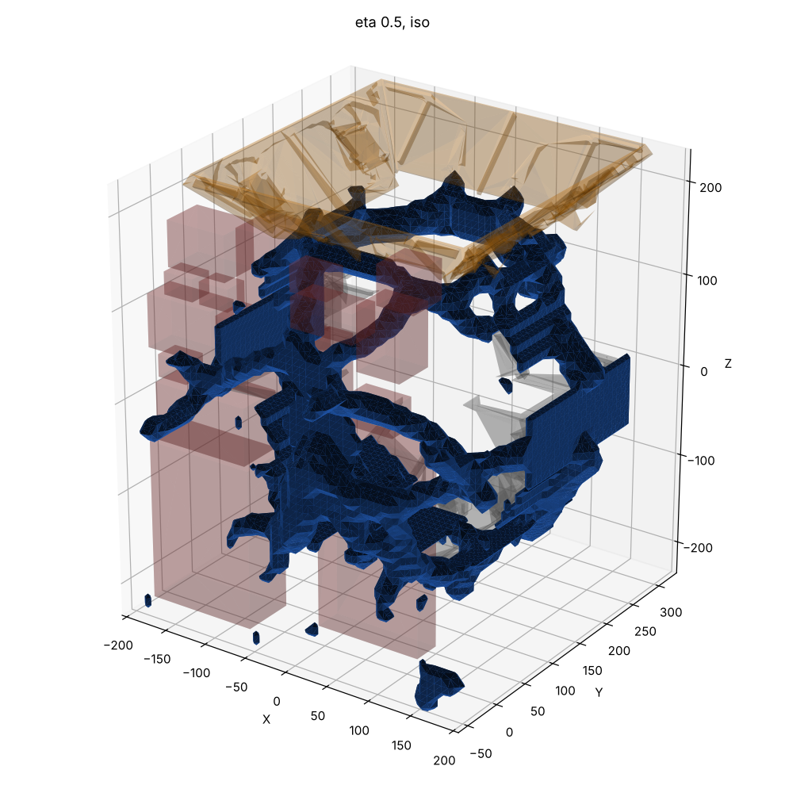
runs/box_system/v2/topo_r2/g2000/view_iso.png
