sparkiscool/nox/runs/box_system/v2/topo_r2/g3000/view_top.png

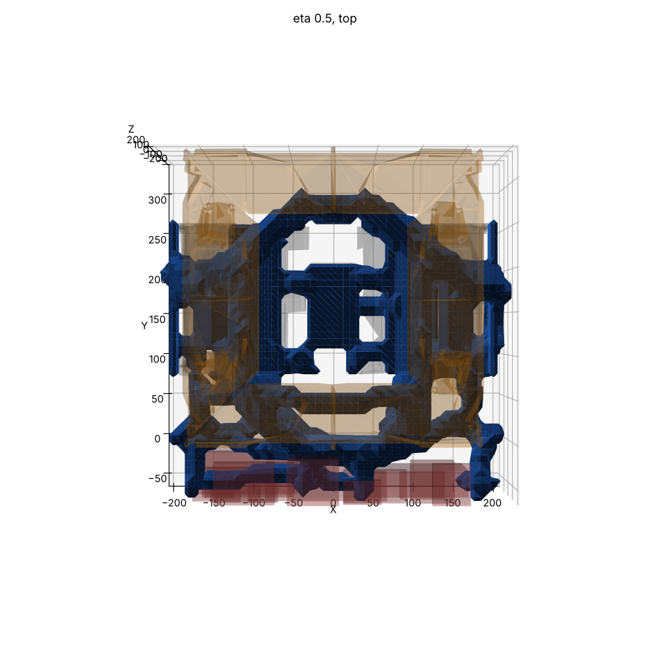
runs/box_system/v2/topo_r2/g3000/view_top.png
