sparkiscool/nox/runs/box_system/v2/topo_r2/g3000_ring/view_iso.png

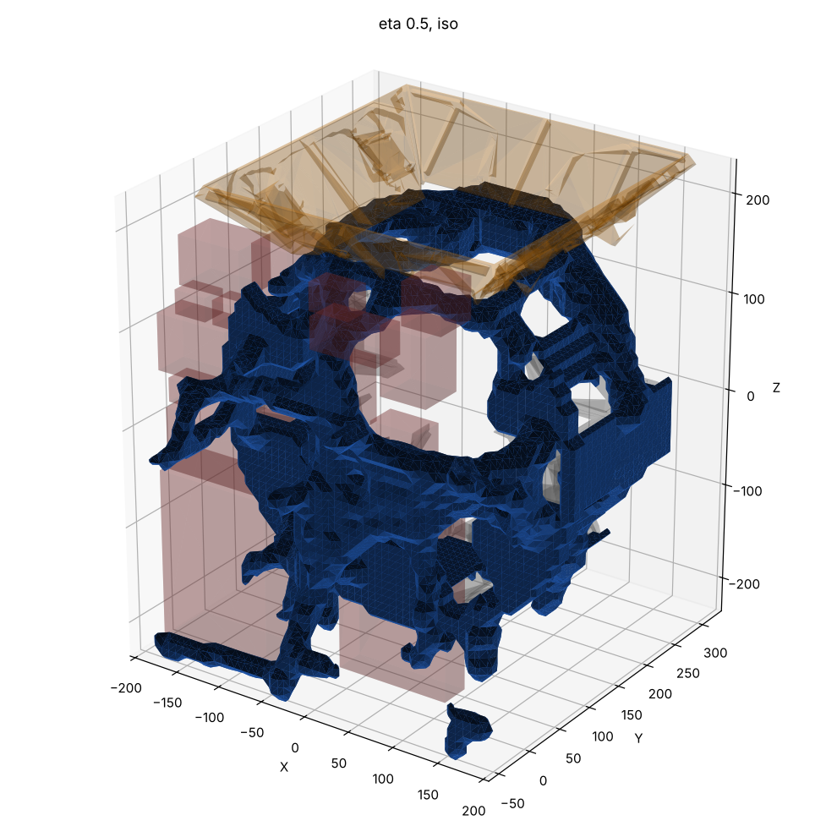
runs/box_system/v2/topo_r2/g3000_ring/view_iso.png
