sparkiscool/nox/runs/bracket_jA/organic-v5/preview.png

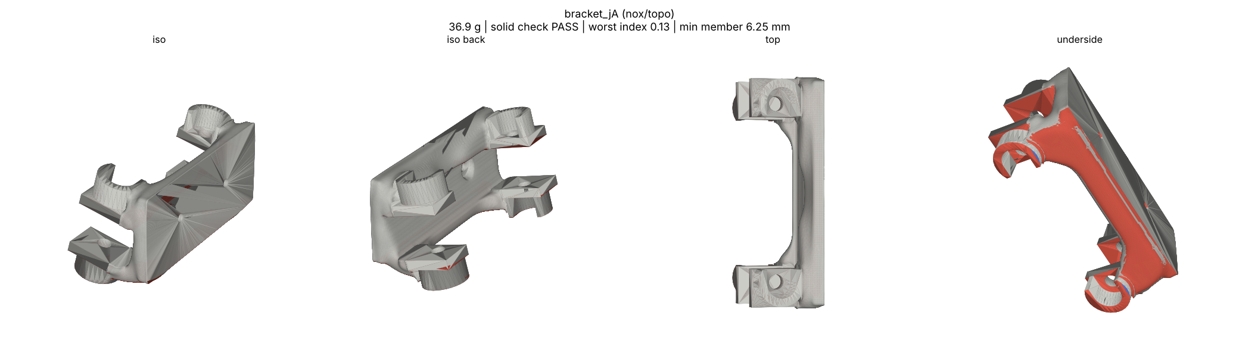
runs/bracket_jA/organic-v5/preview.png
