sparkiscool/nox/runs/cage_nodes/floor/floor_section.png

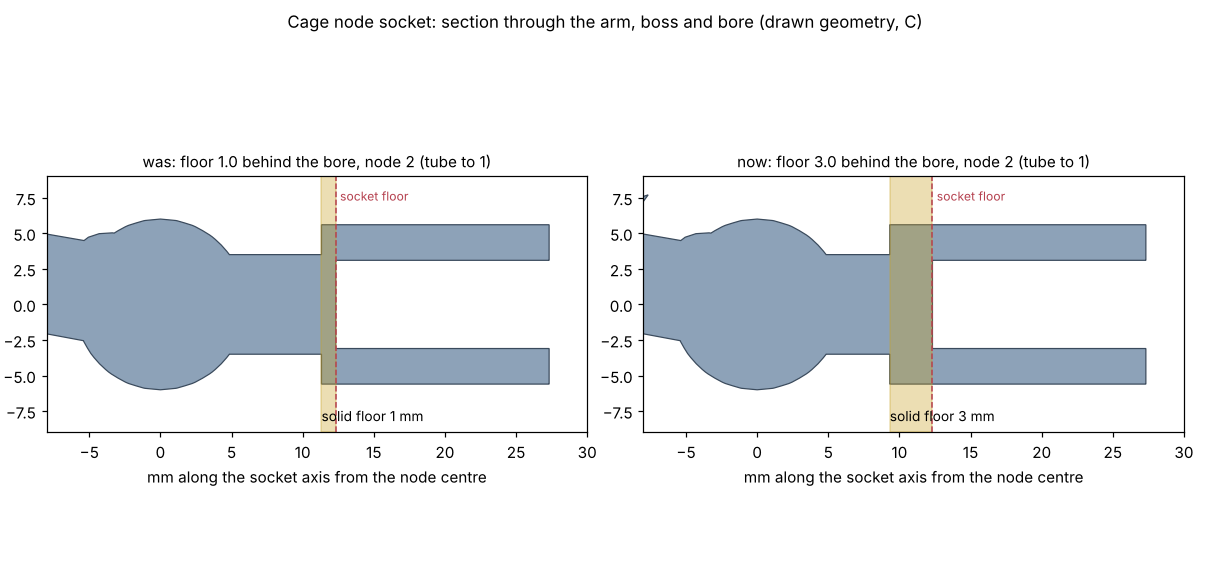
runs/cage_nodes/floor/floor_section.png
