sparkiscool/nox/runs/cage_nodes/v5/preview_0.png

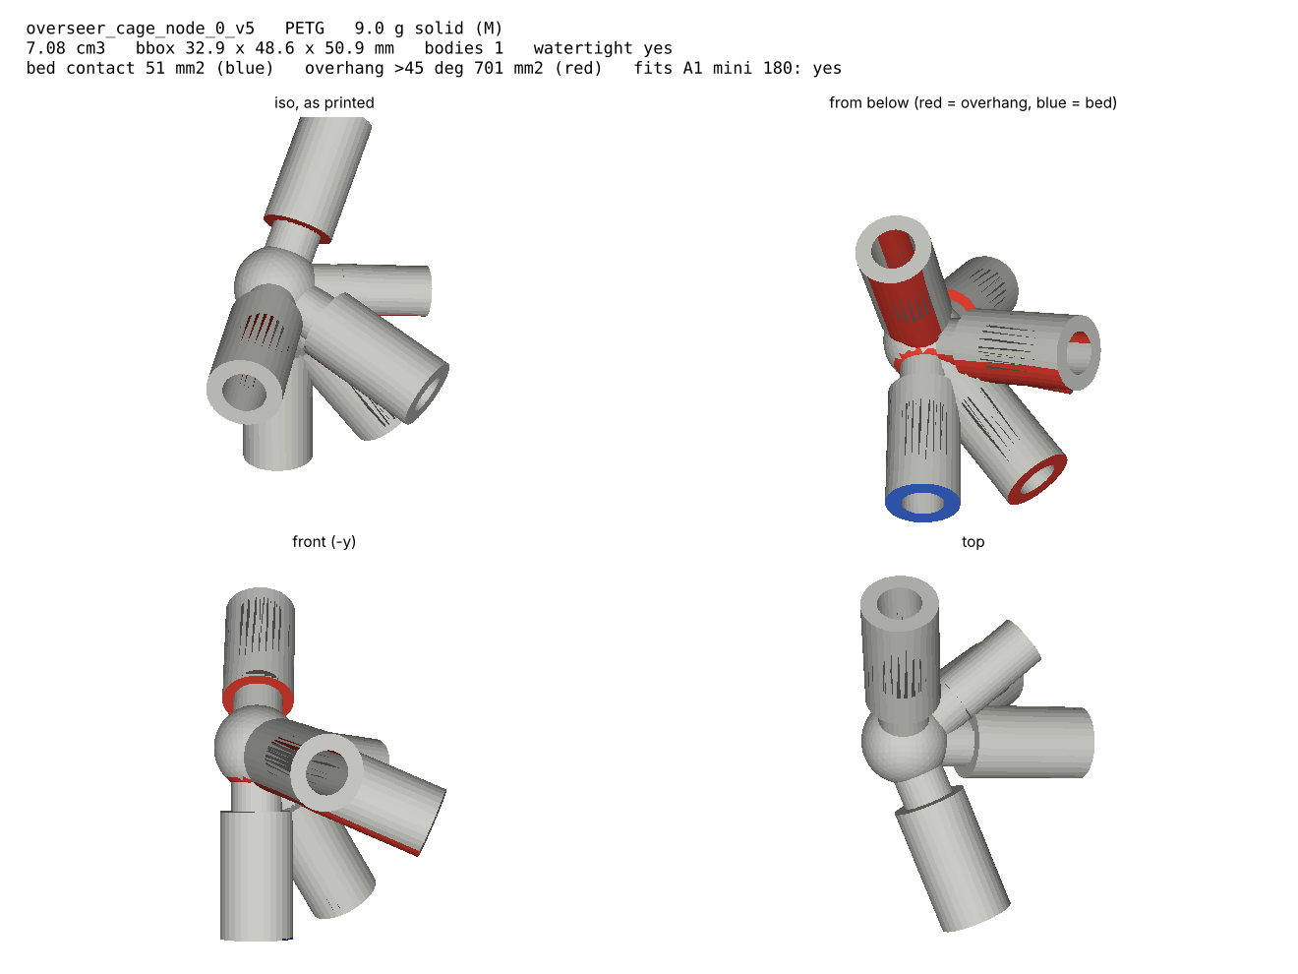
runs/cage_nodes/v5/preview_0.png
