sparkiscool/nox/runs/cage_nodes/v5/preview_1.png

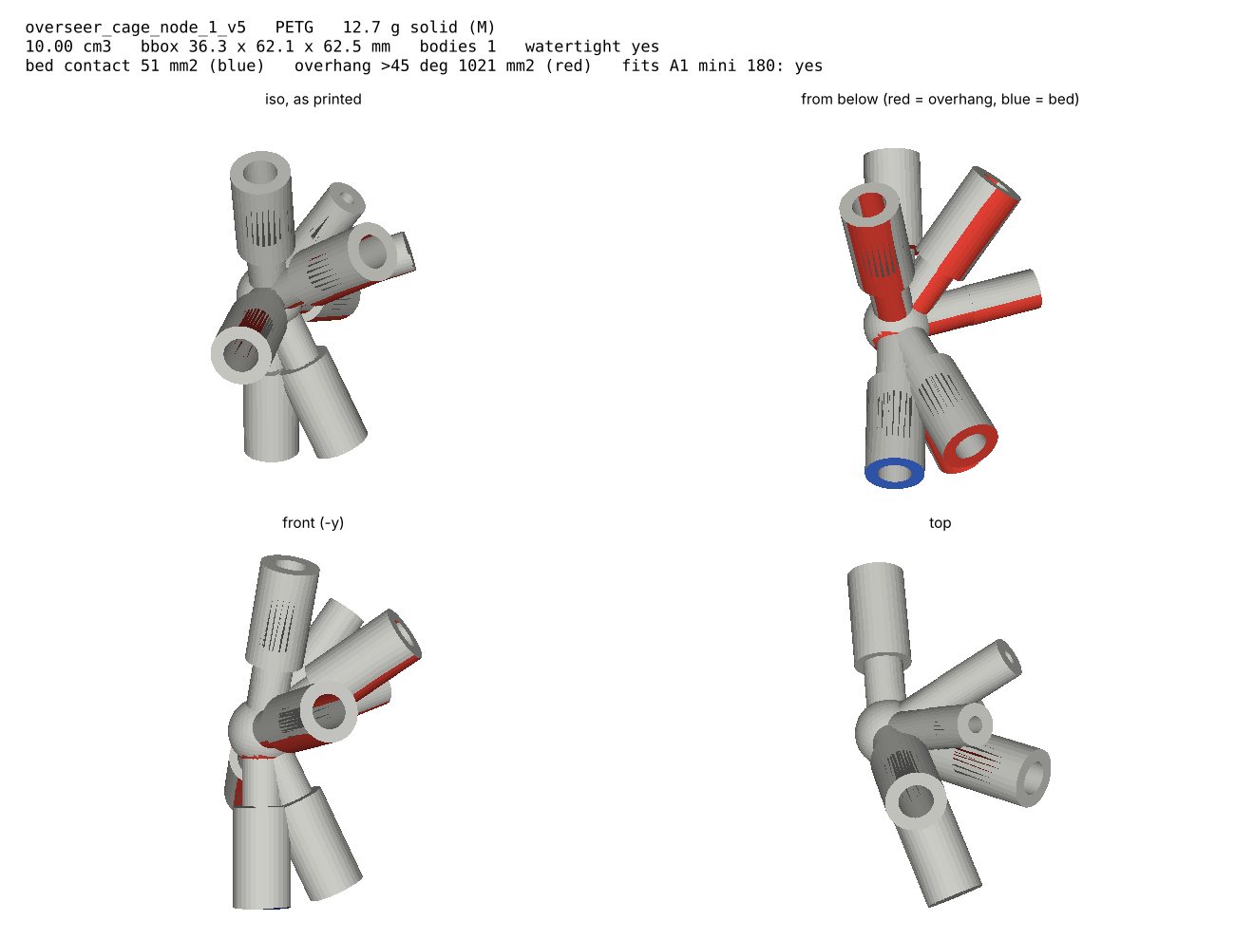
runs/cage_nodes/v5/preview_1.png
