sparkiscool/nox/runs/cage_nodes/v5/preview_2.png

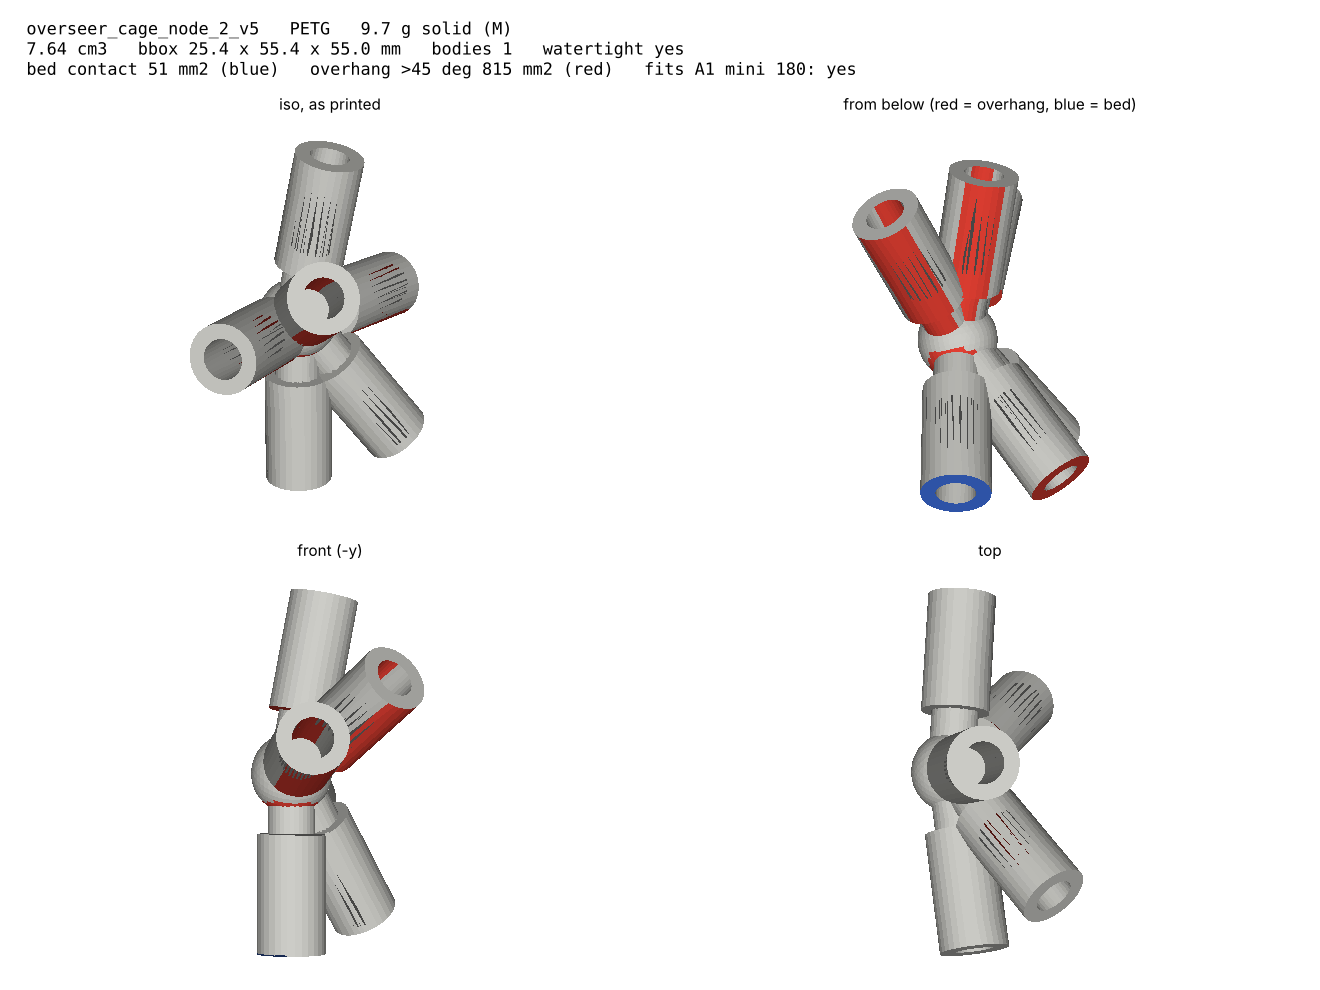
runs/cage_nodes/v5/preview_2.png
