sparkiscool/nox/runs/cage_nodes/v5/preview_3.png

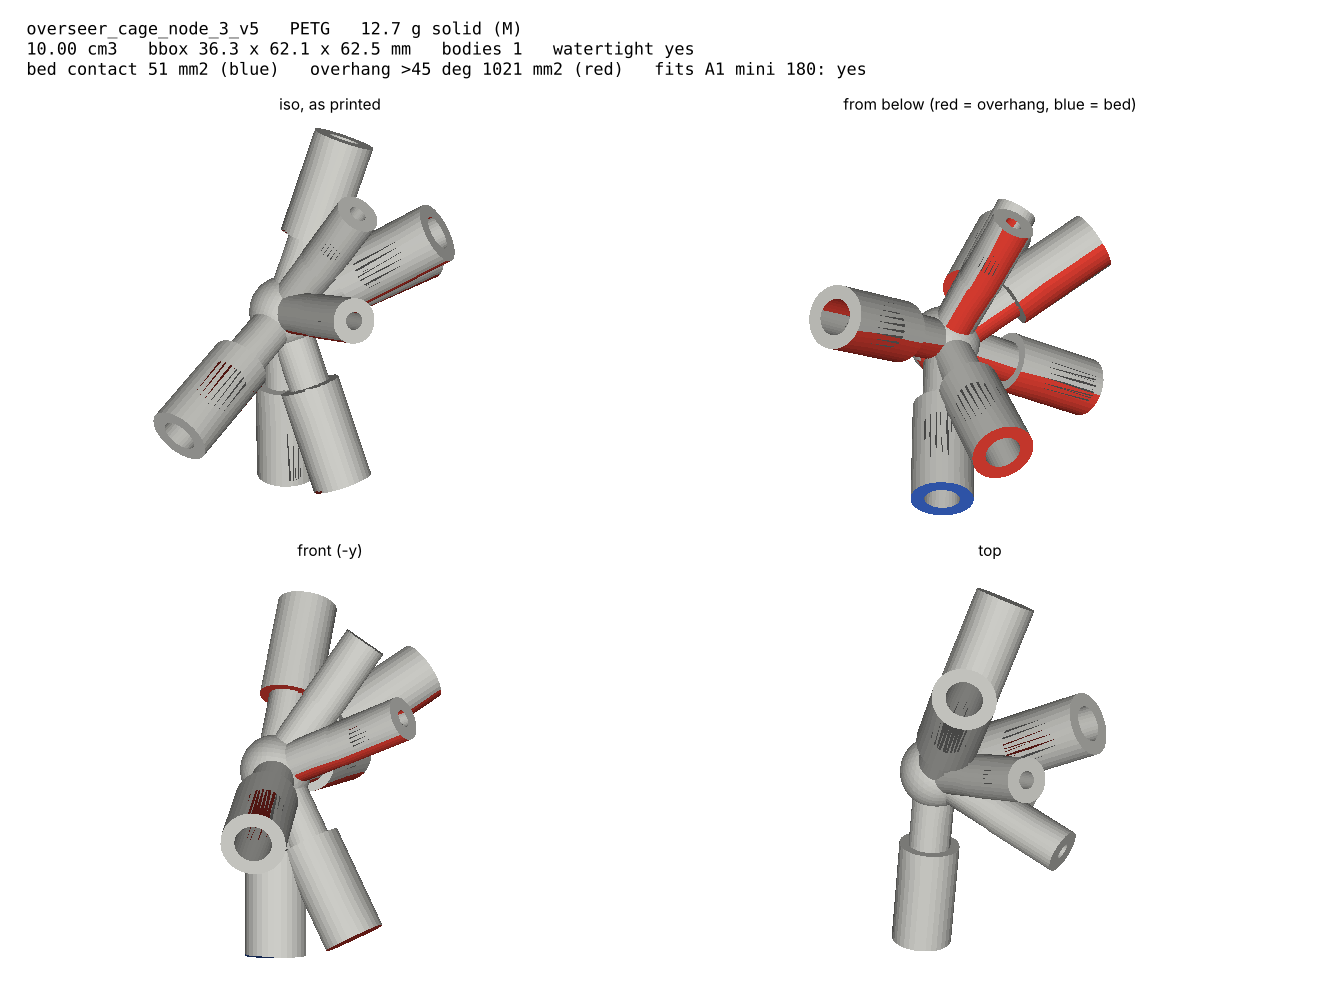
runs/cage_nodes/v5/preview_3.png
