sparkiscool/nox/runs/cage_nodes/v5/preview_4.png

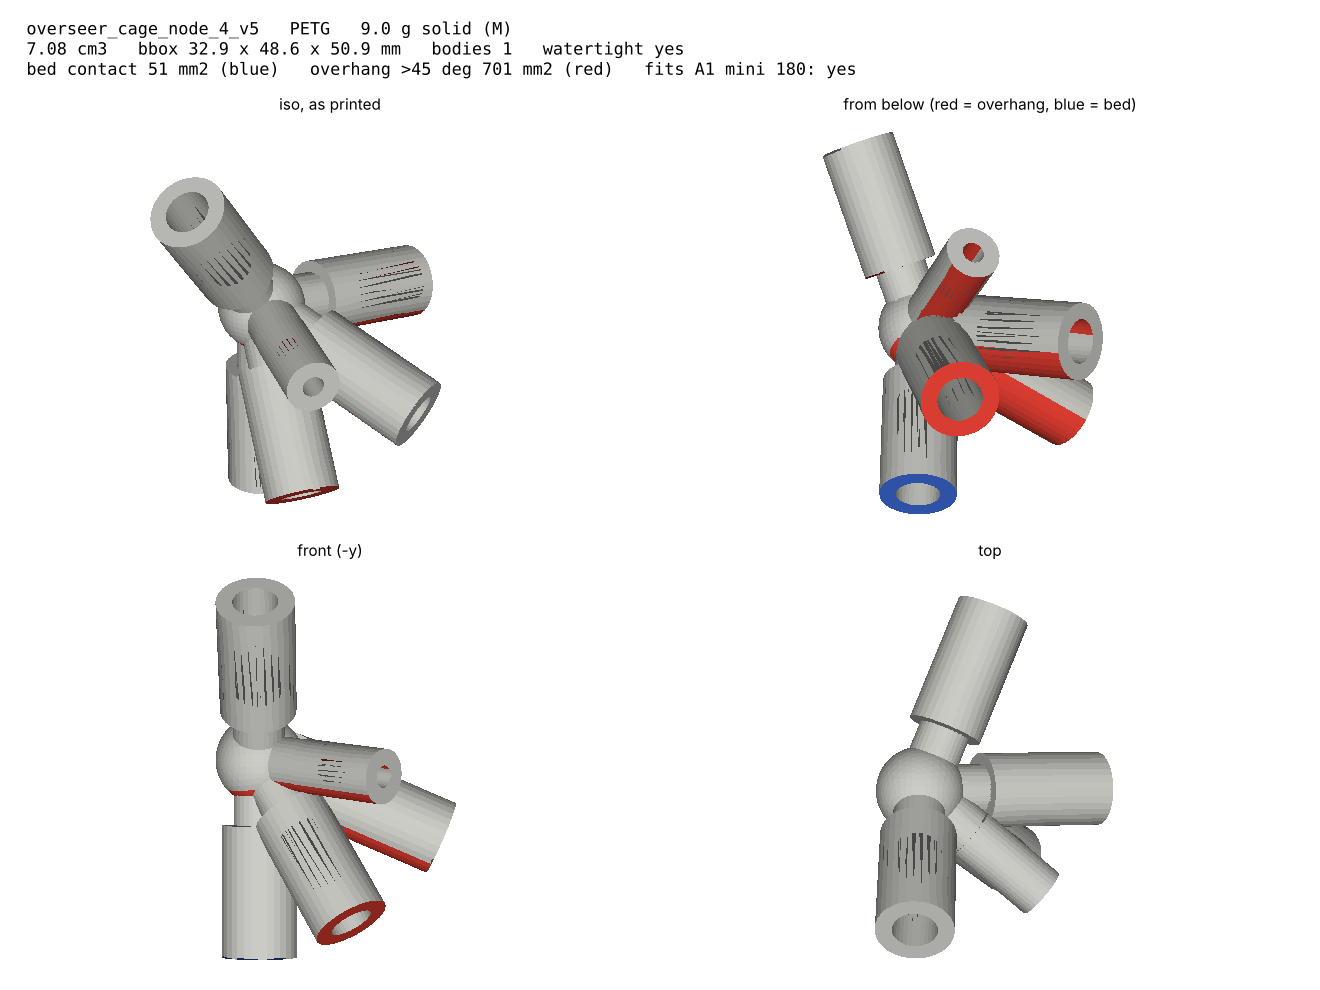
runs/cage_nodes/v5/preview_4.png
