sparkiscool/nox/runs/cage_nodes/v5/preview_7.png

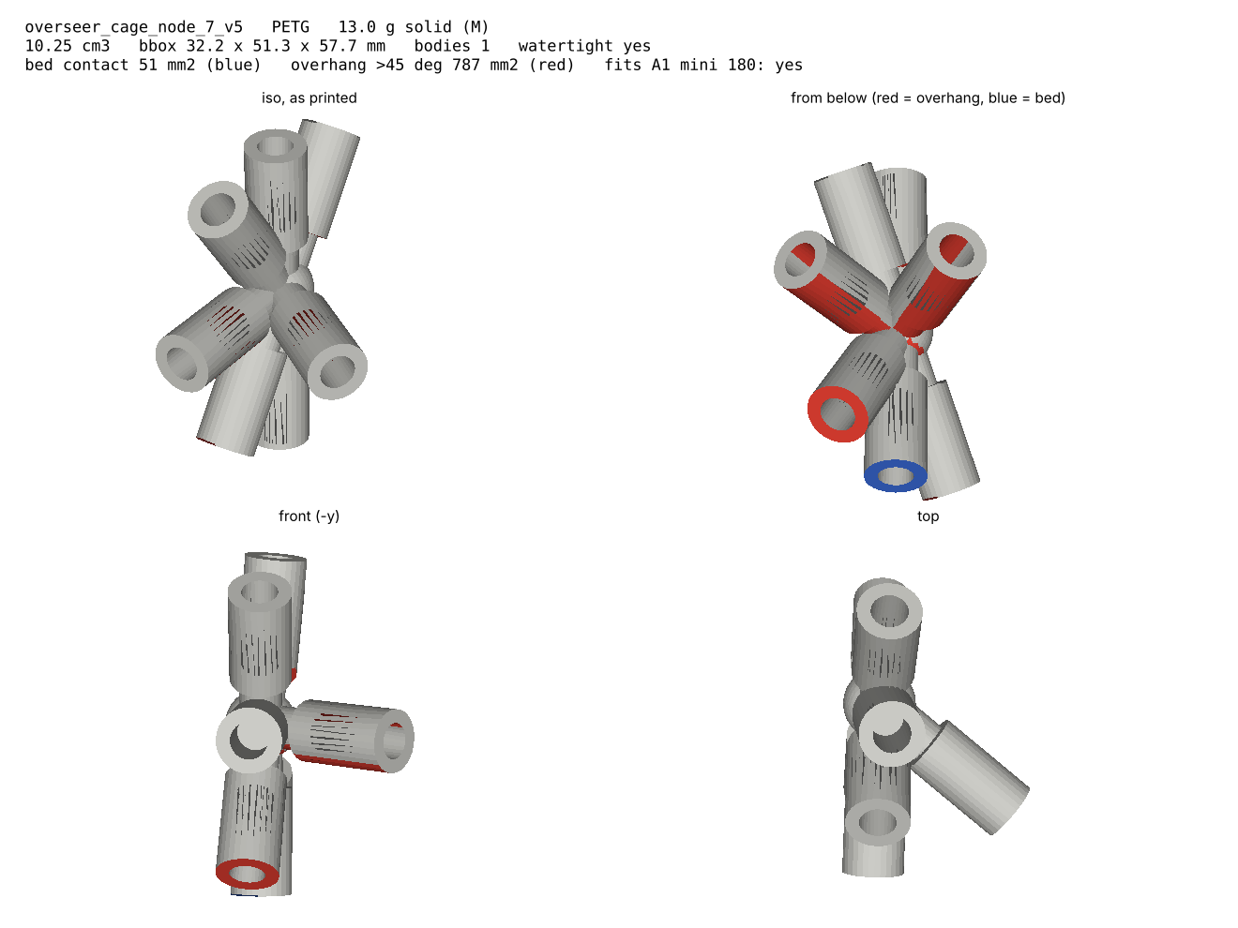
runs/cage_nodes/v5/preview_7.png
