sparkiscool/nox/runs/cage_nodes/v5/preview_8.png

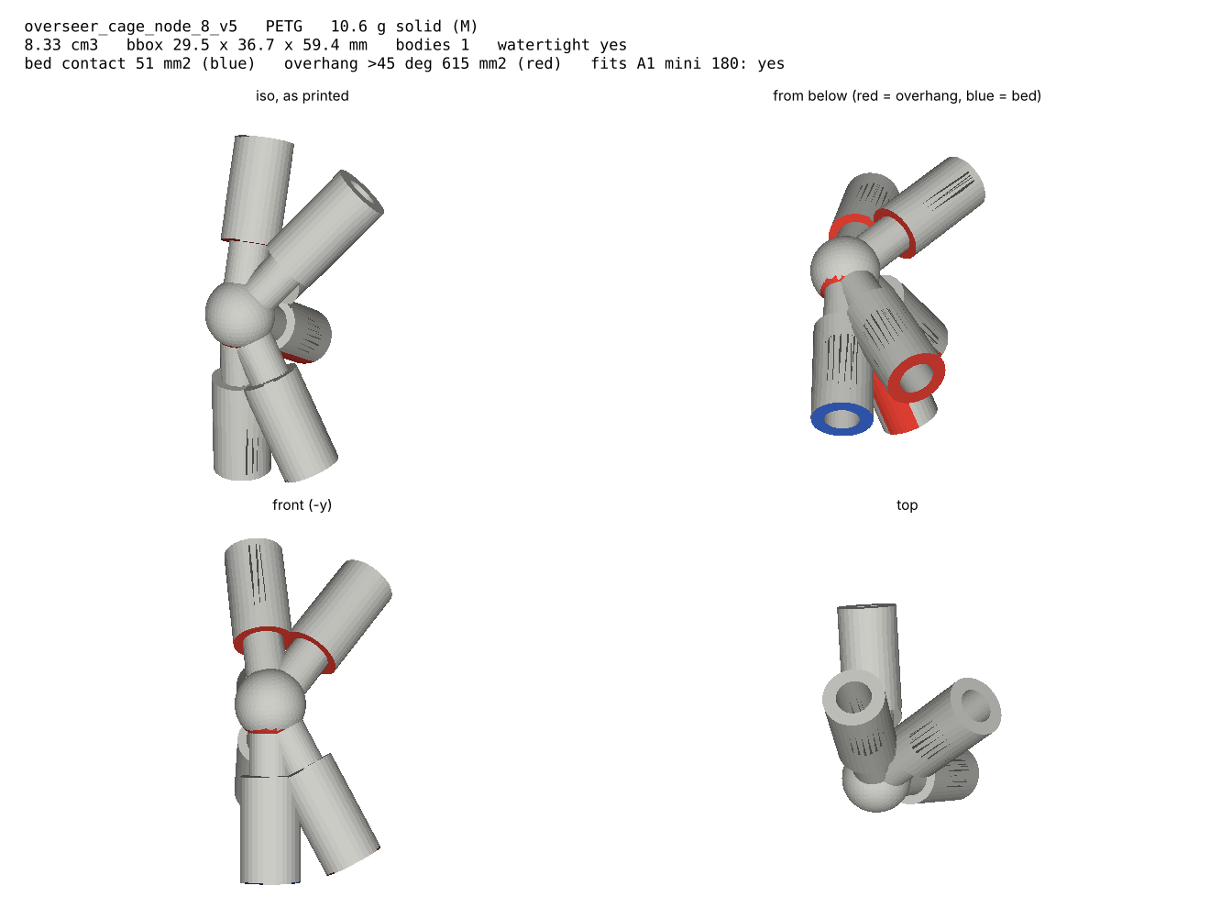
runs/cage_nodes/v5/preview_8.png
