sparkiscool/nox/runs/cage_nodes/v5/preview_9.png

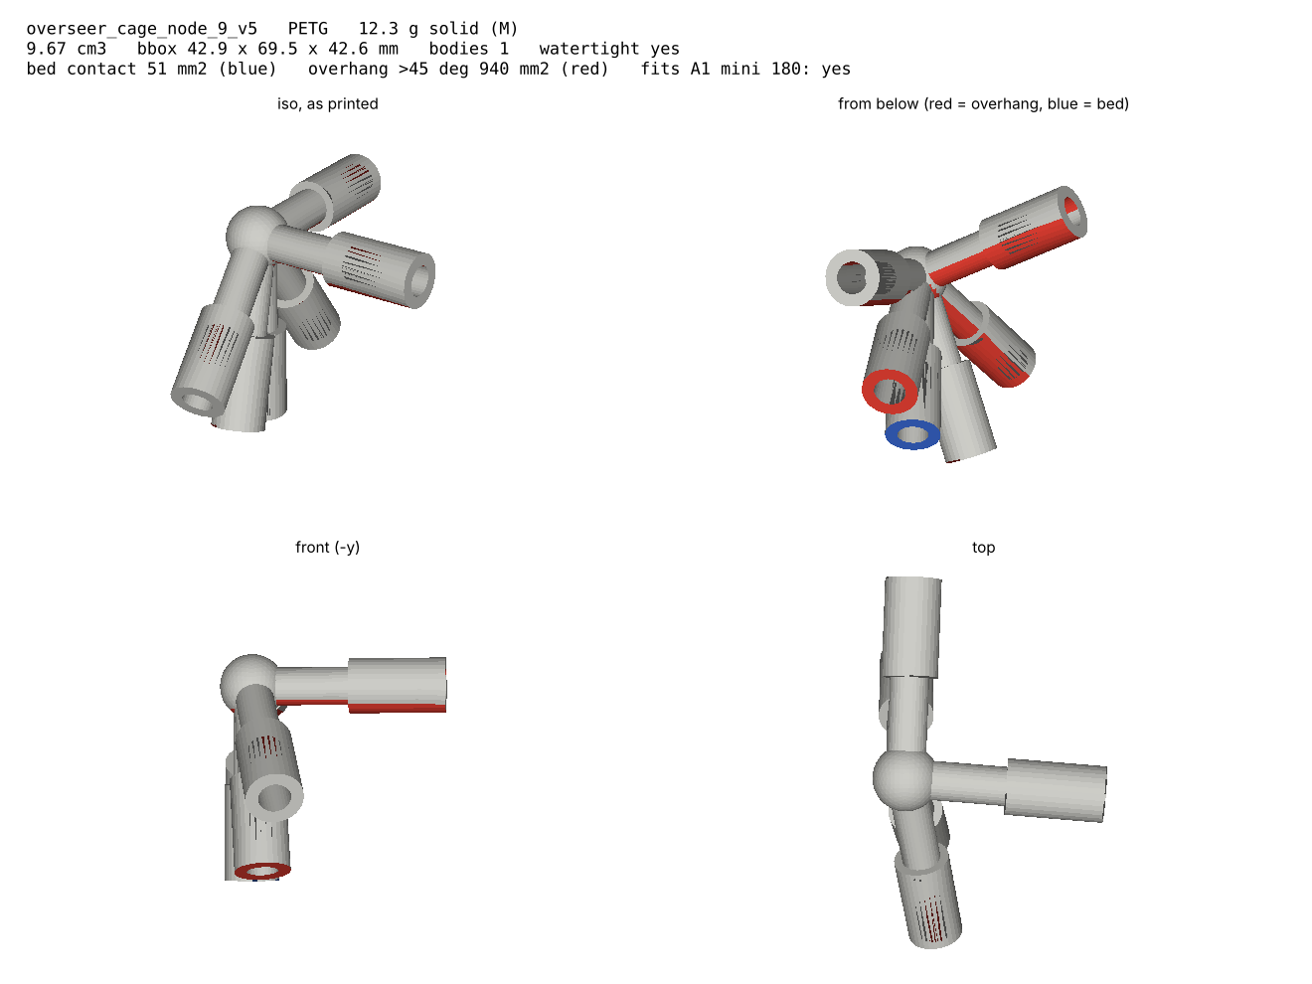
runs/cage_nodes/v5/preview_9.png
