sparkiscool/nox/runs/cage_nodes/v5/preview_10.png

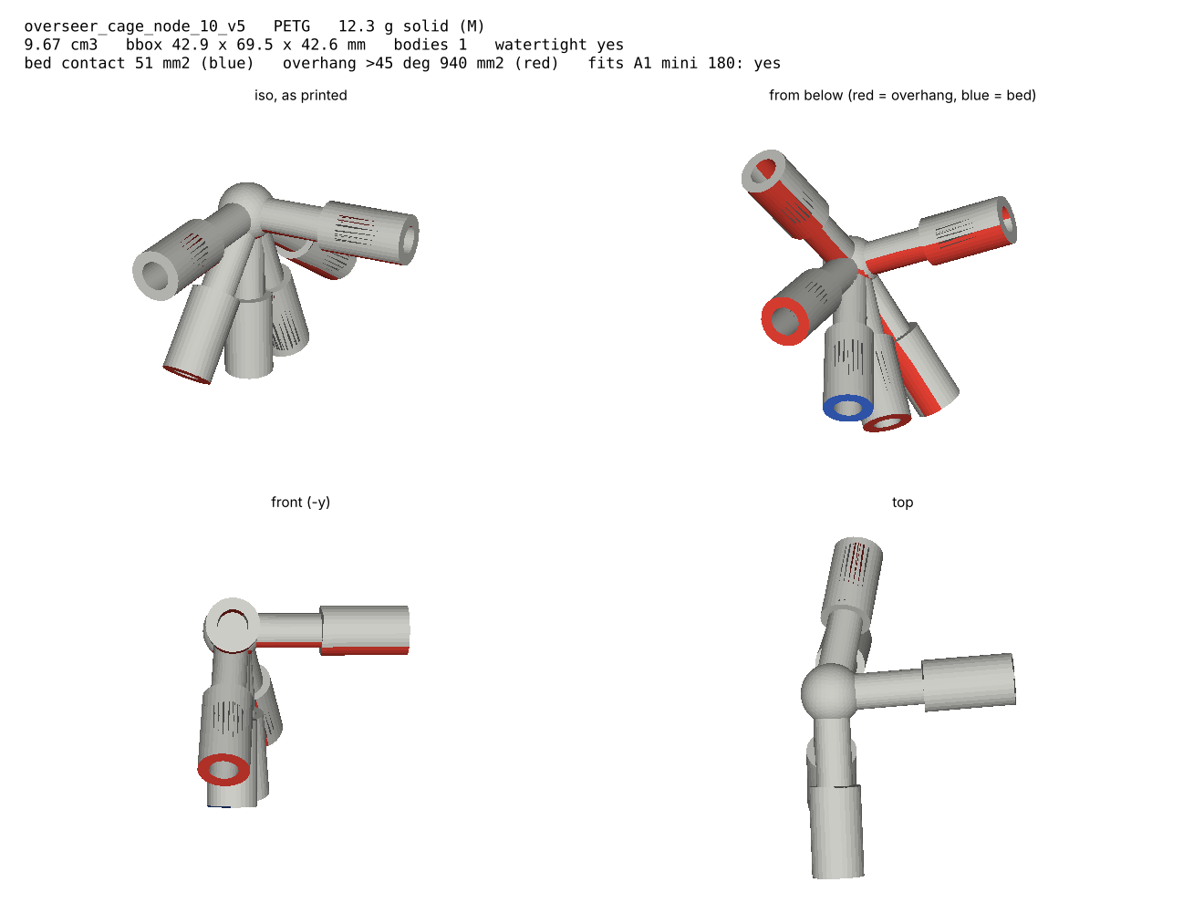
runs/cage_nodes/v5/preview_10.png
