sparkiscool/nox/runs/cage_nodes/v5/preview_11.png

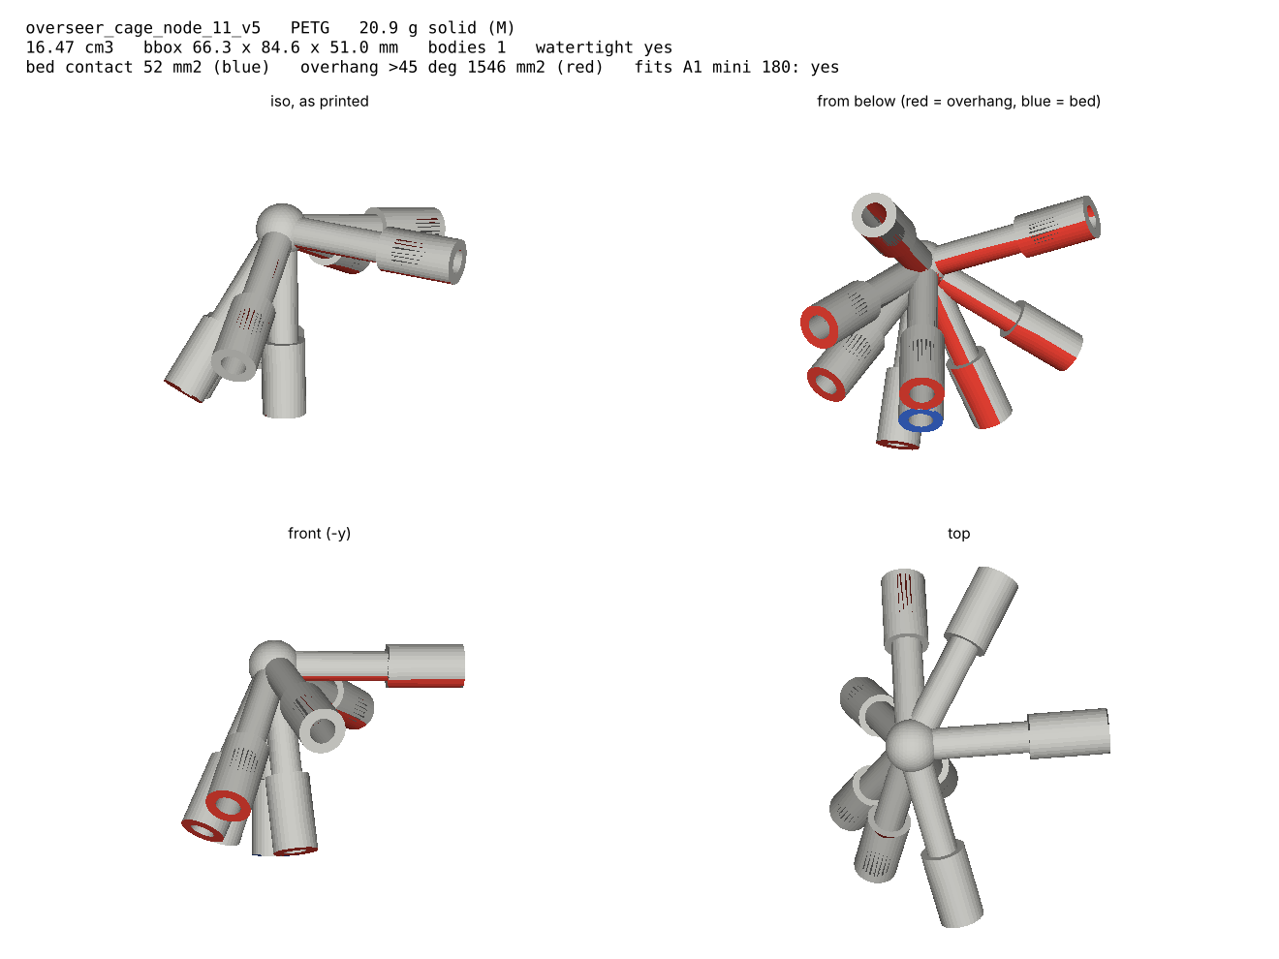
runs/cage_nodes/v5/preview_11.png
