sparkiscool/nox/runs/cage_nodes/v5/preview_12.png

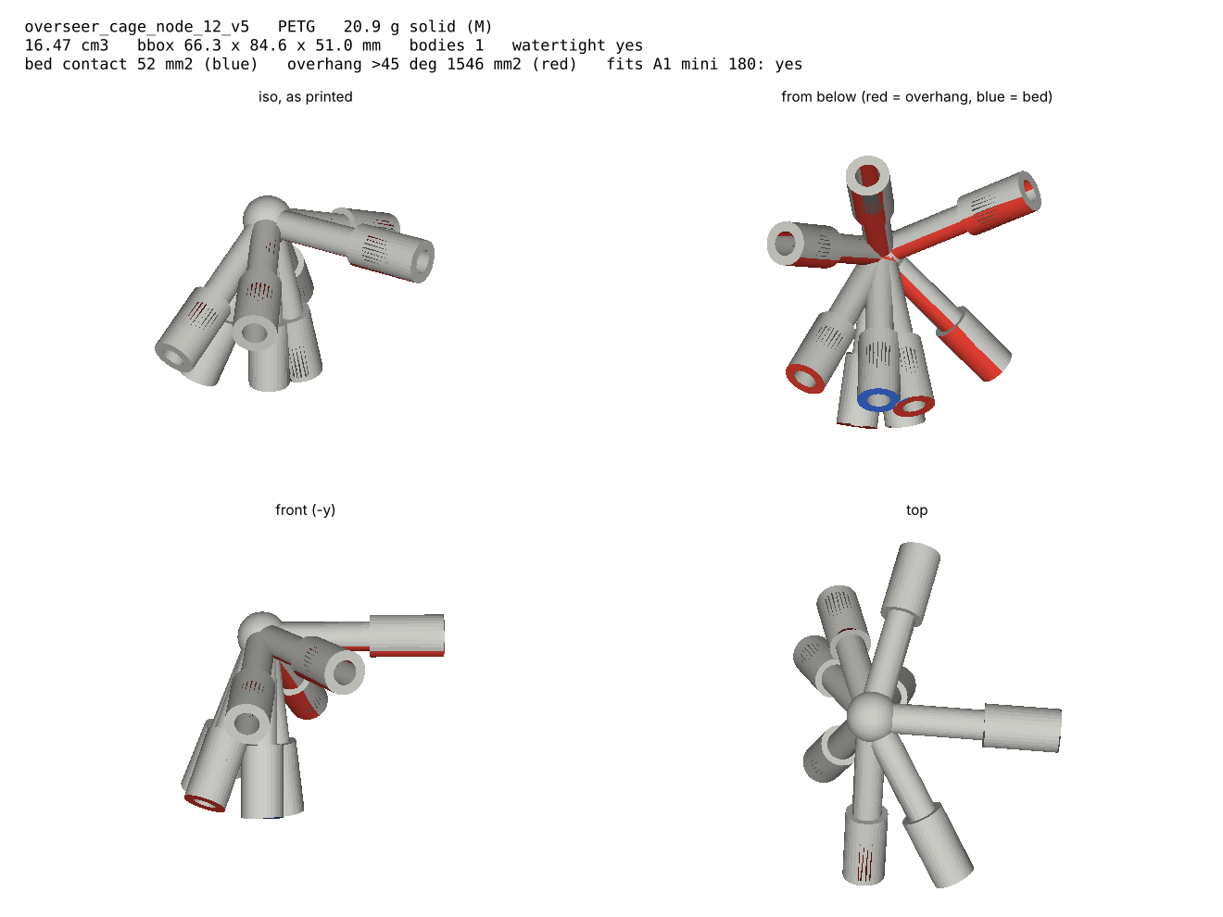
runs/cage_nodes/v5/preview_12.png
