sparkiscool/nox/runs/cage_nodes/v5/preview_13.png

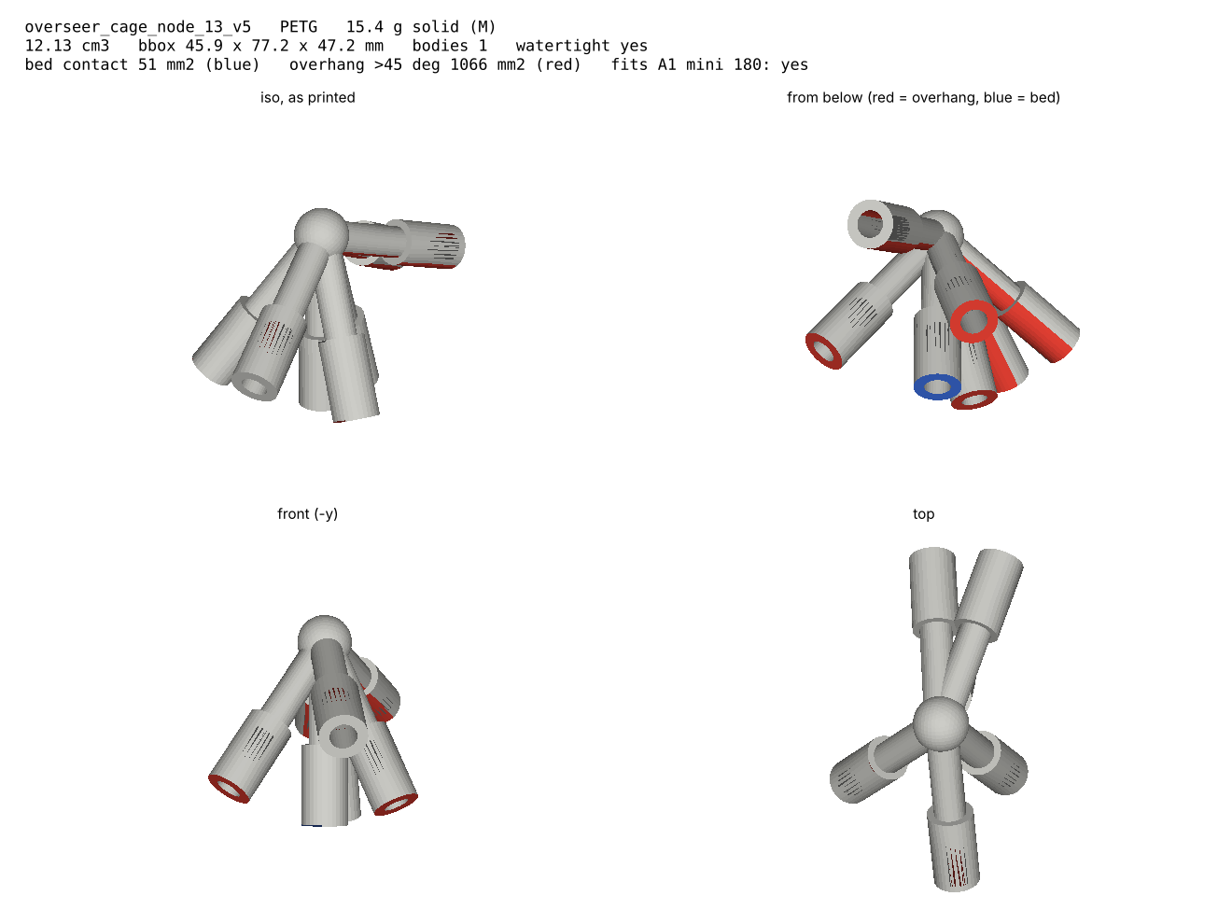
runs/cage_nodes/v5/preview_13.png
