sparkiscool/nox/runs/cage_nodes/v5/preview_14.png

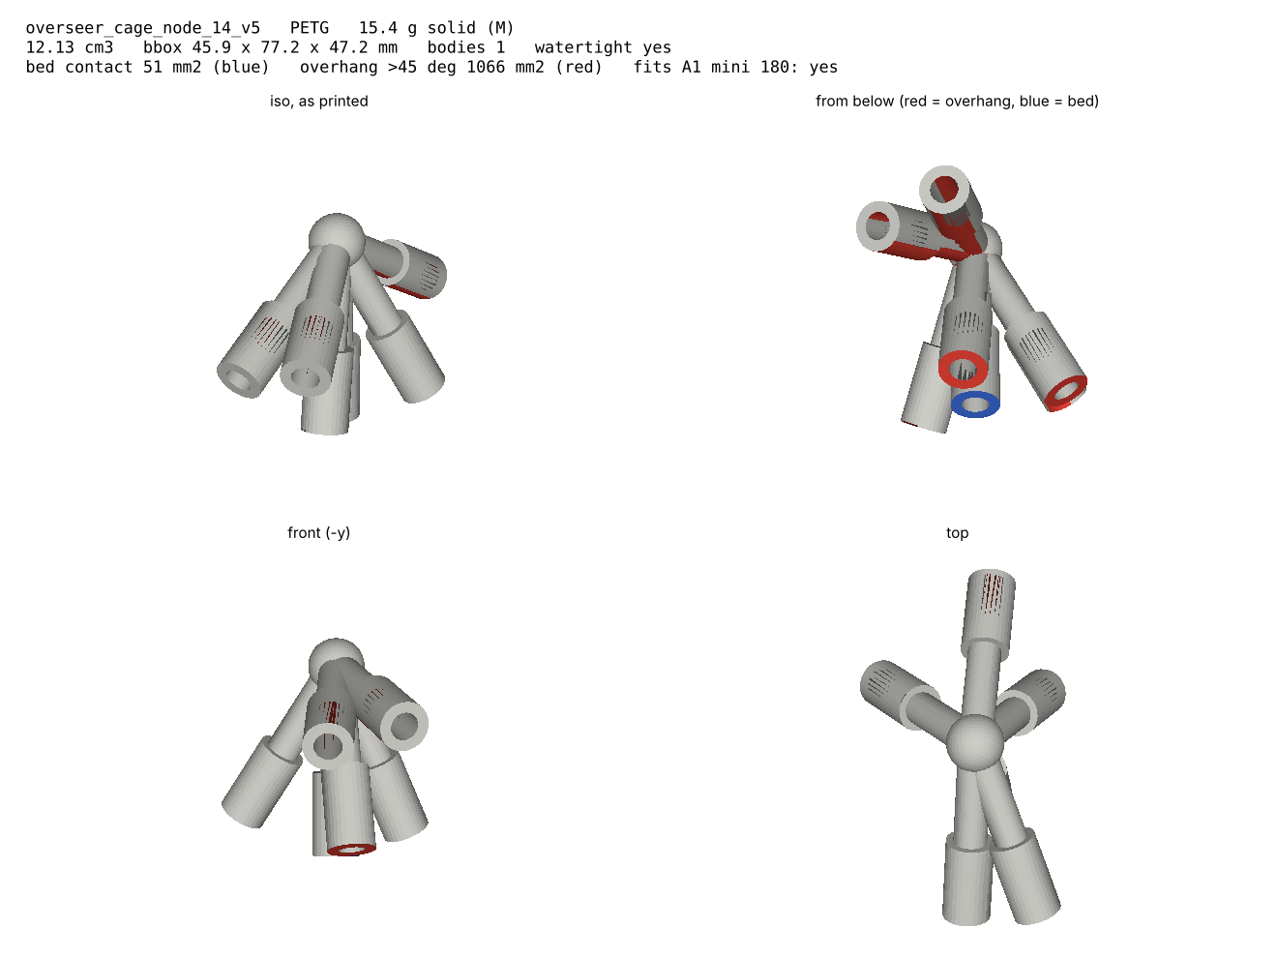
runs/cage_nodes/v5/preview_14.png
