sparkiscool/nox/runs/cage_nodes/v5/preview_15.png

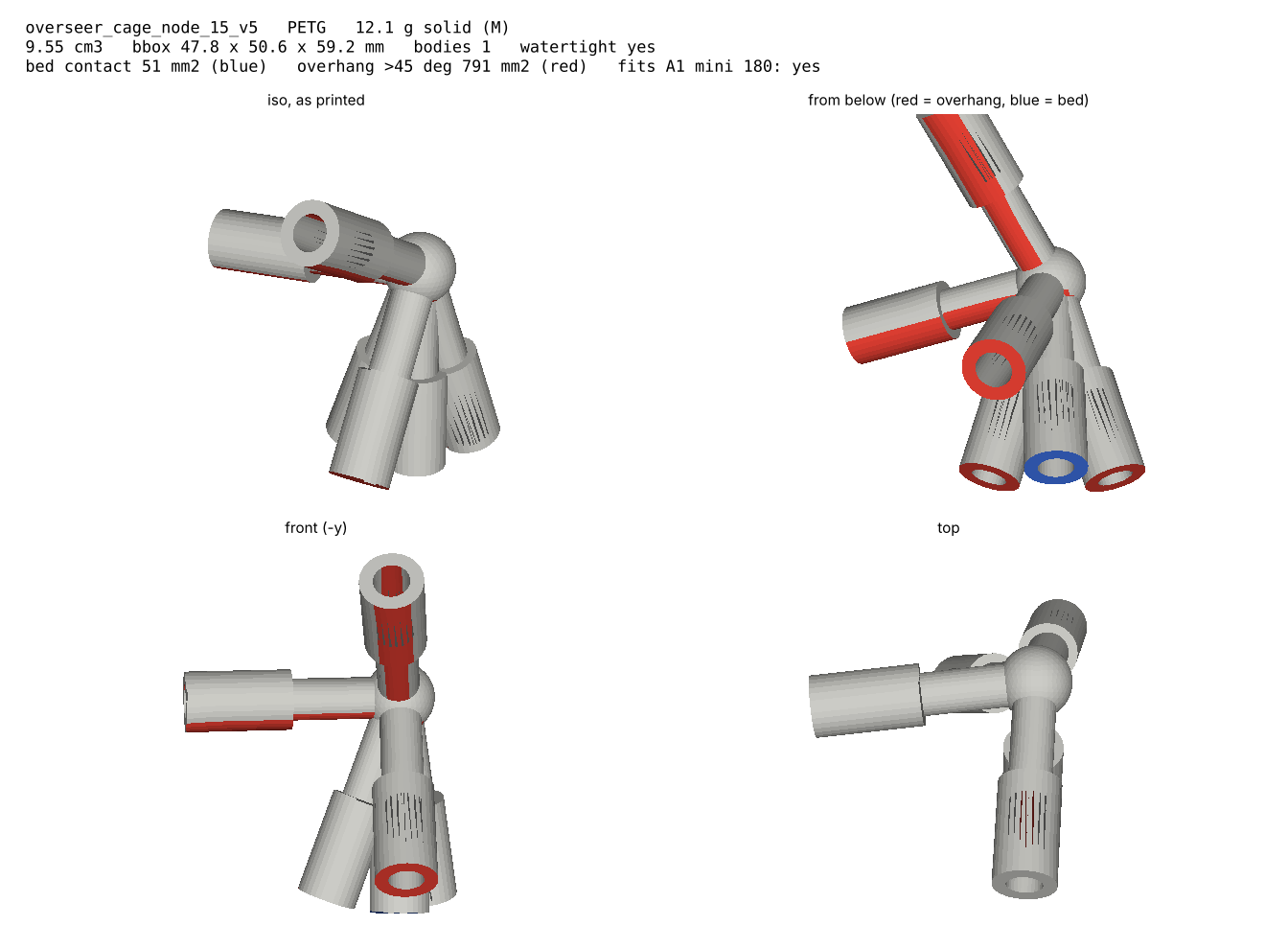
runs/cage_nodes/v5/preview_15.png
