sparkiscool/nox/runs/cage_nodes/v5/preview_16.png

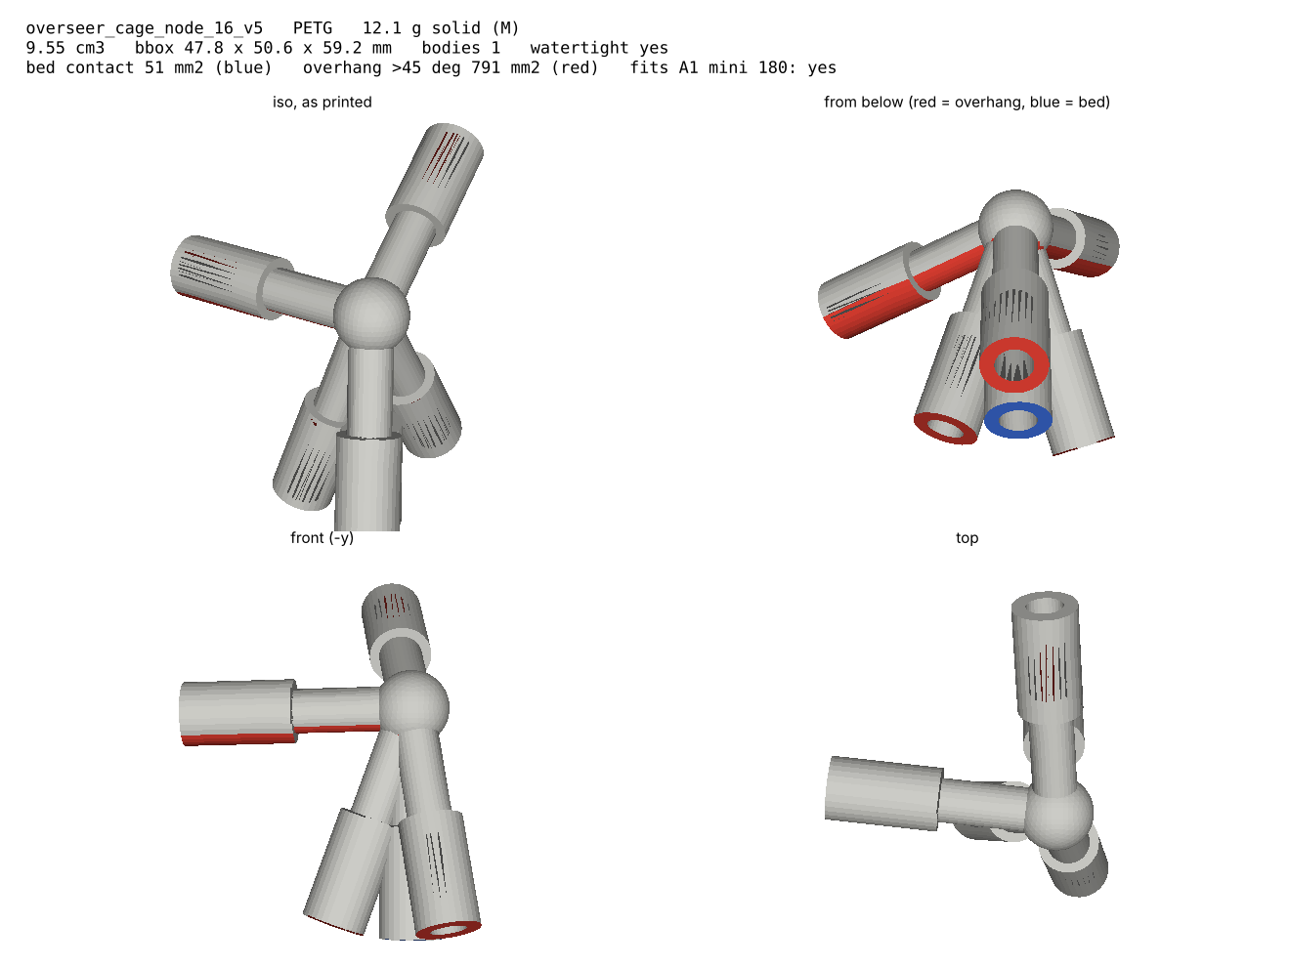
runs/cage_nodes/v5/preview_16.png
