sparkiscool/nox/runs/cage_nodes/v5/preview_19.png

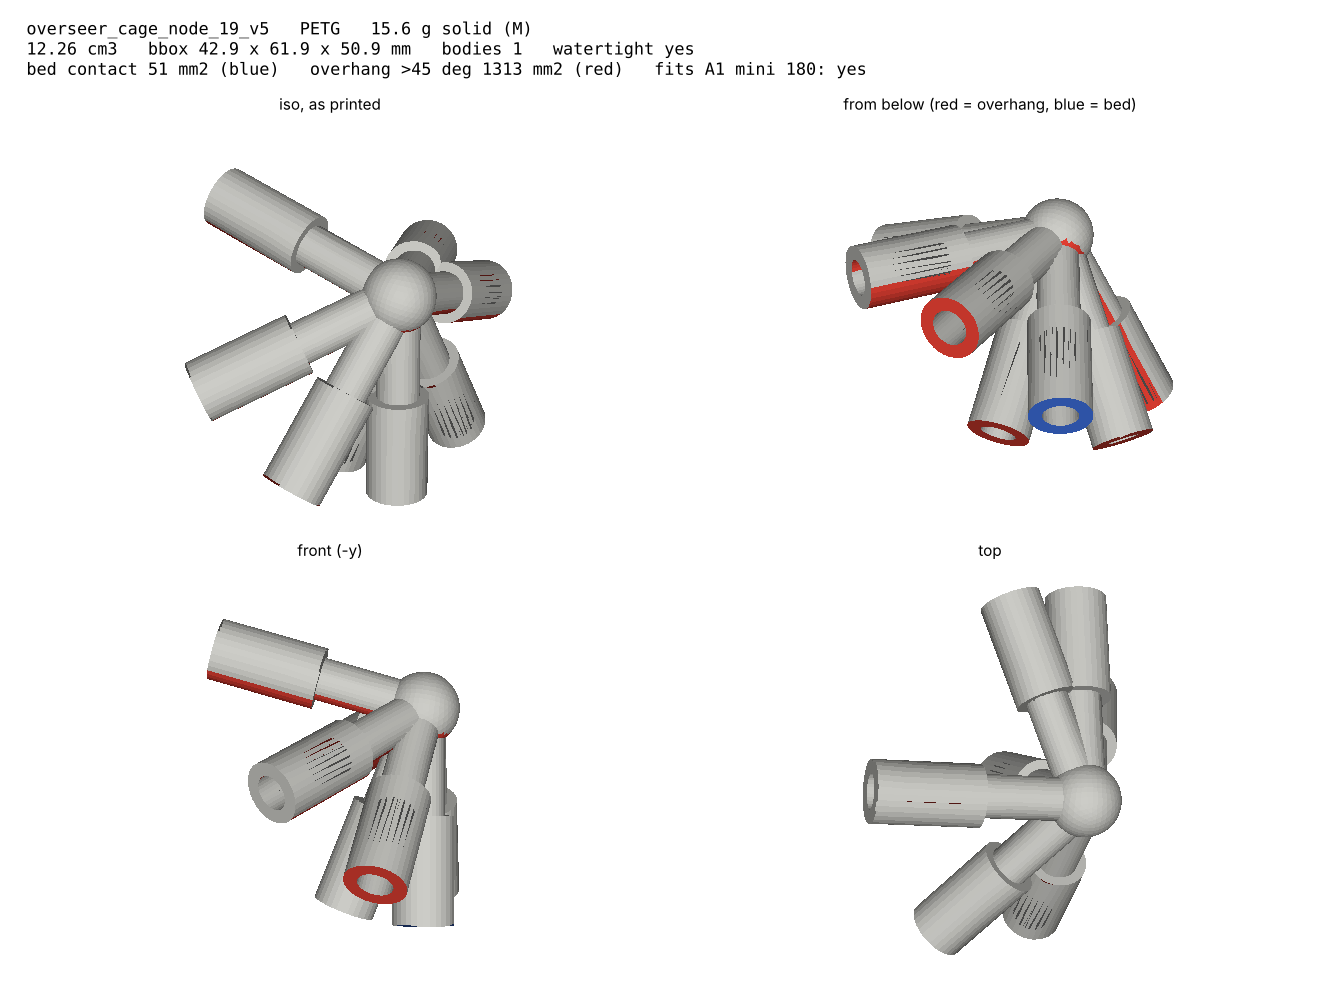
runs/cage_nodes/v5/preview_19.png
