sparkiscool/nox/runs/cage_nodes/v5/preview_23.png

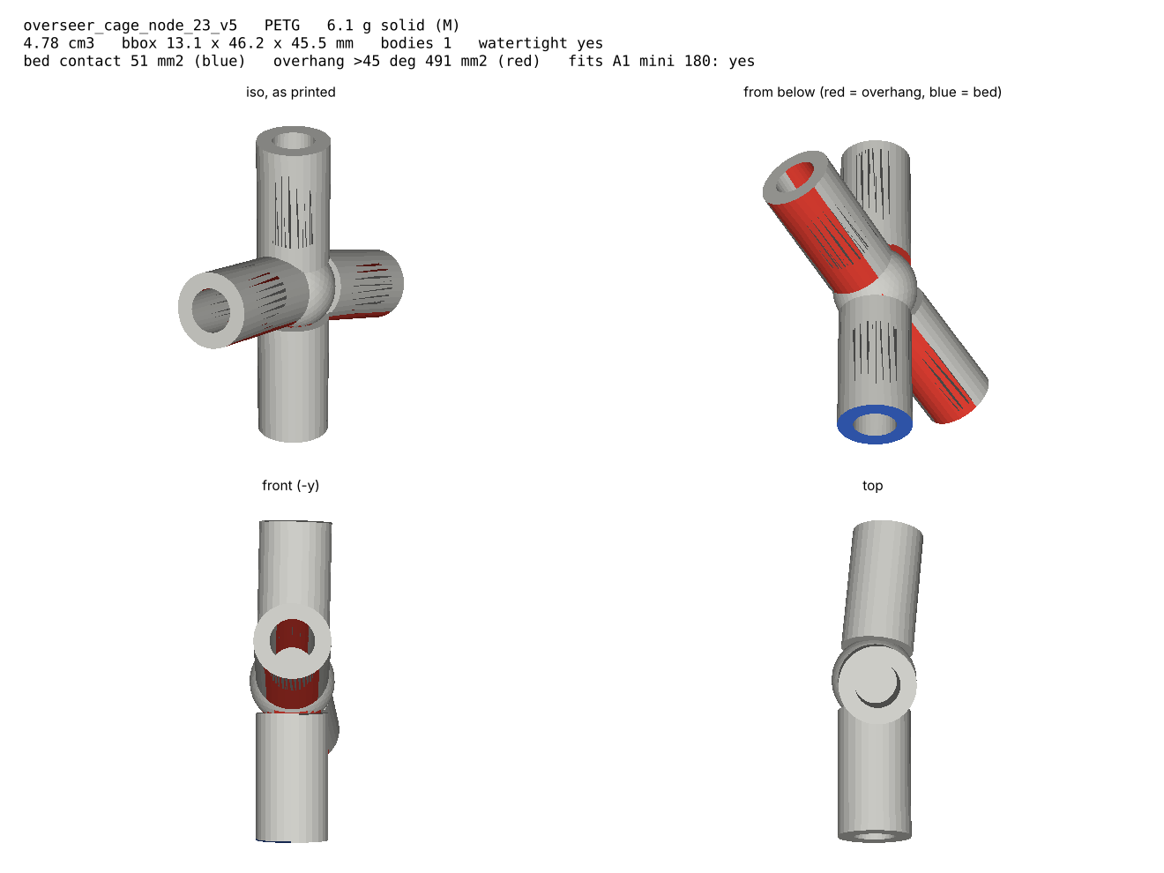
runs/cage_nodes/v5/preview_23.png
