sparkiscool/nox/runs/cage_nodes/v5/sheet.png

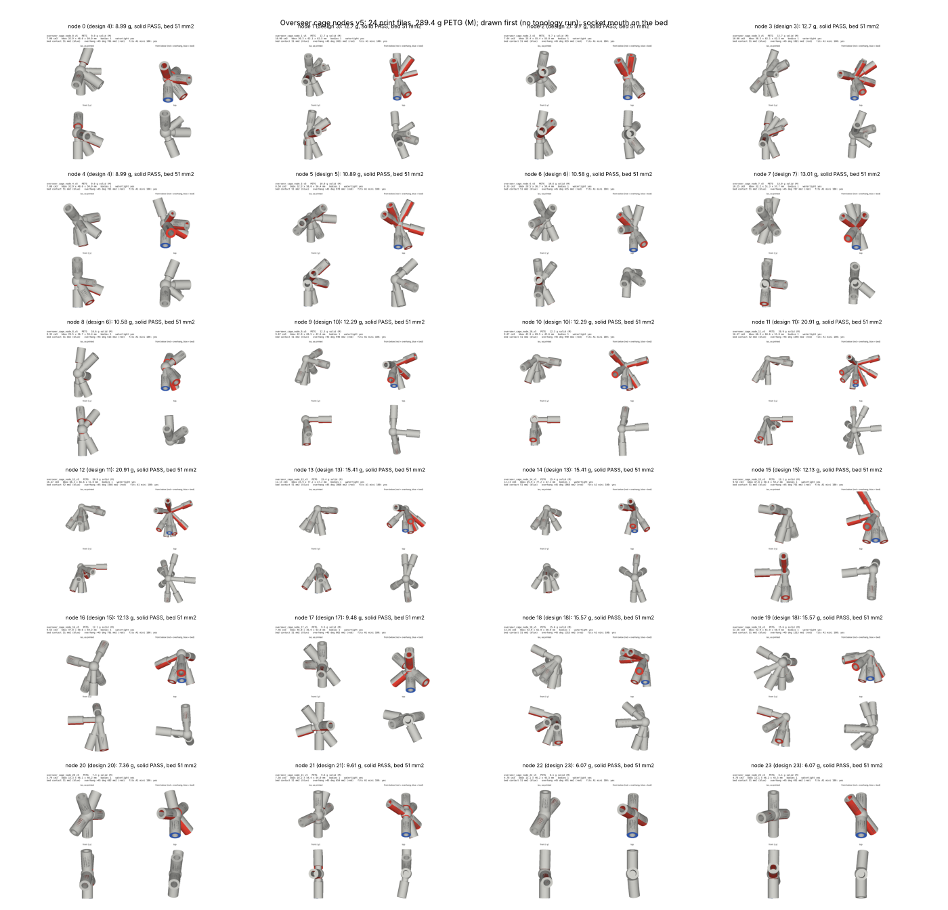
runs/cage_nodes/v5/sheet.png
