sparkiscool/nox/runs/detent/v6/preview_box_detent_arm_v3.png

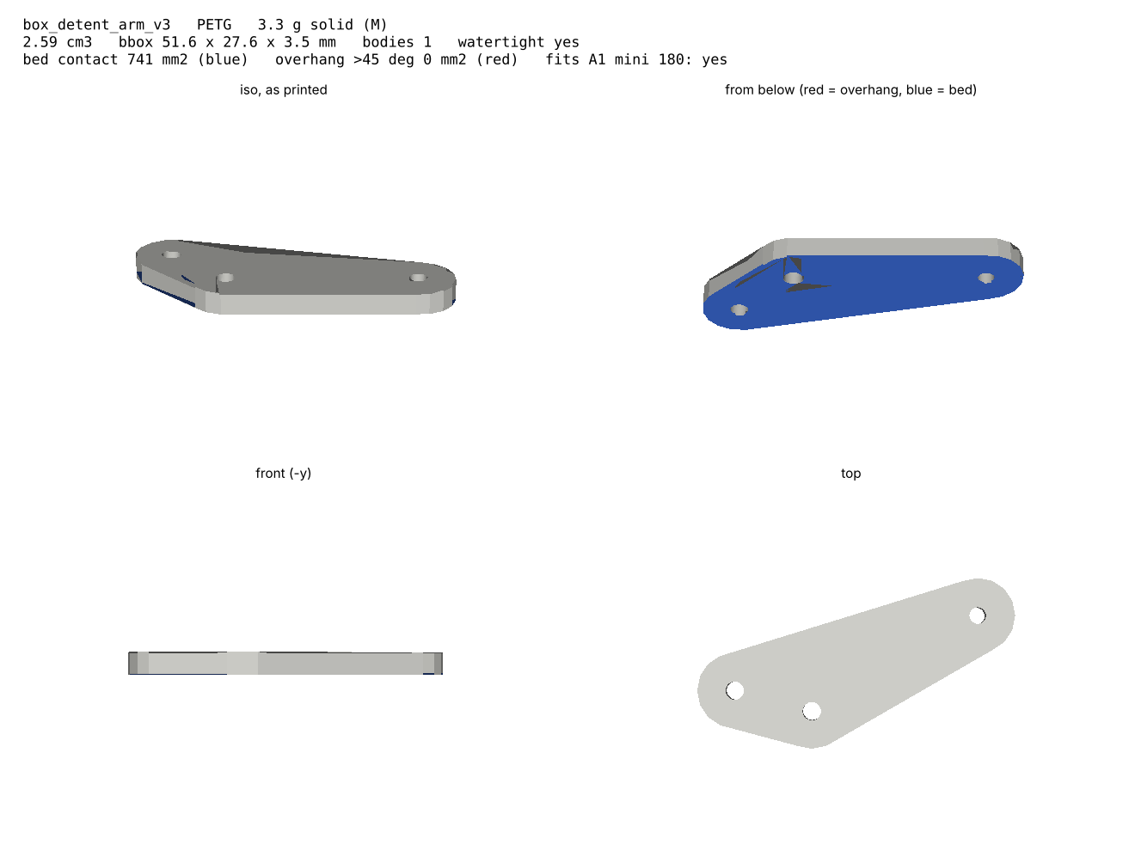
runs/detent/v6/preview_box_detent_arm_v3.png
