sparkiscool/nox/runs/detent/v6/preview_box_detent_ring_v4.png

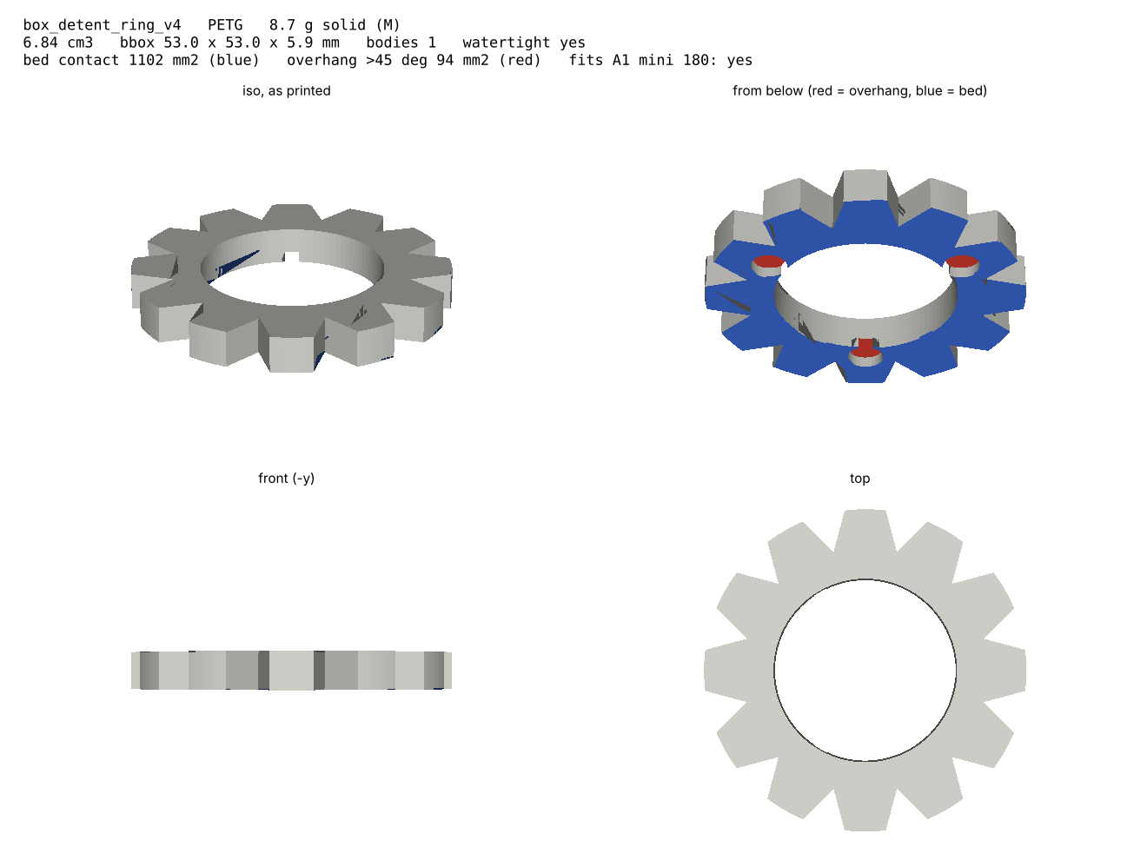
runs/detent/v6/preview_box_detent_ring_v4.png
