sparkiscool/nox/runs/funnel_panel/v7/motion.gif

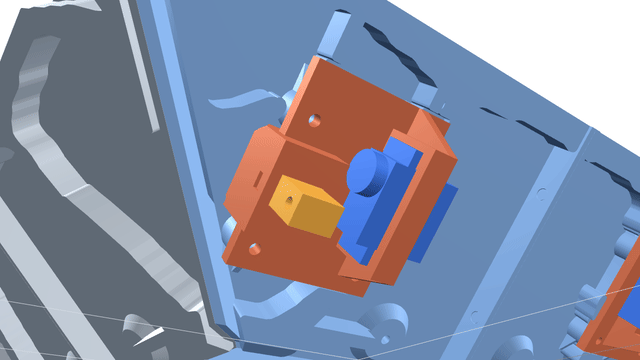
runs/funnel_panel/v7/motion.gif
