sparkiscool/nox/runs/funnel_panel/v7/preview.png

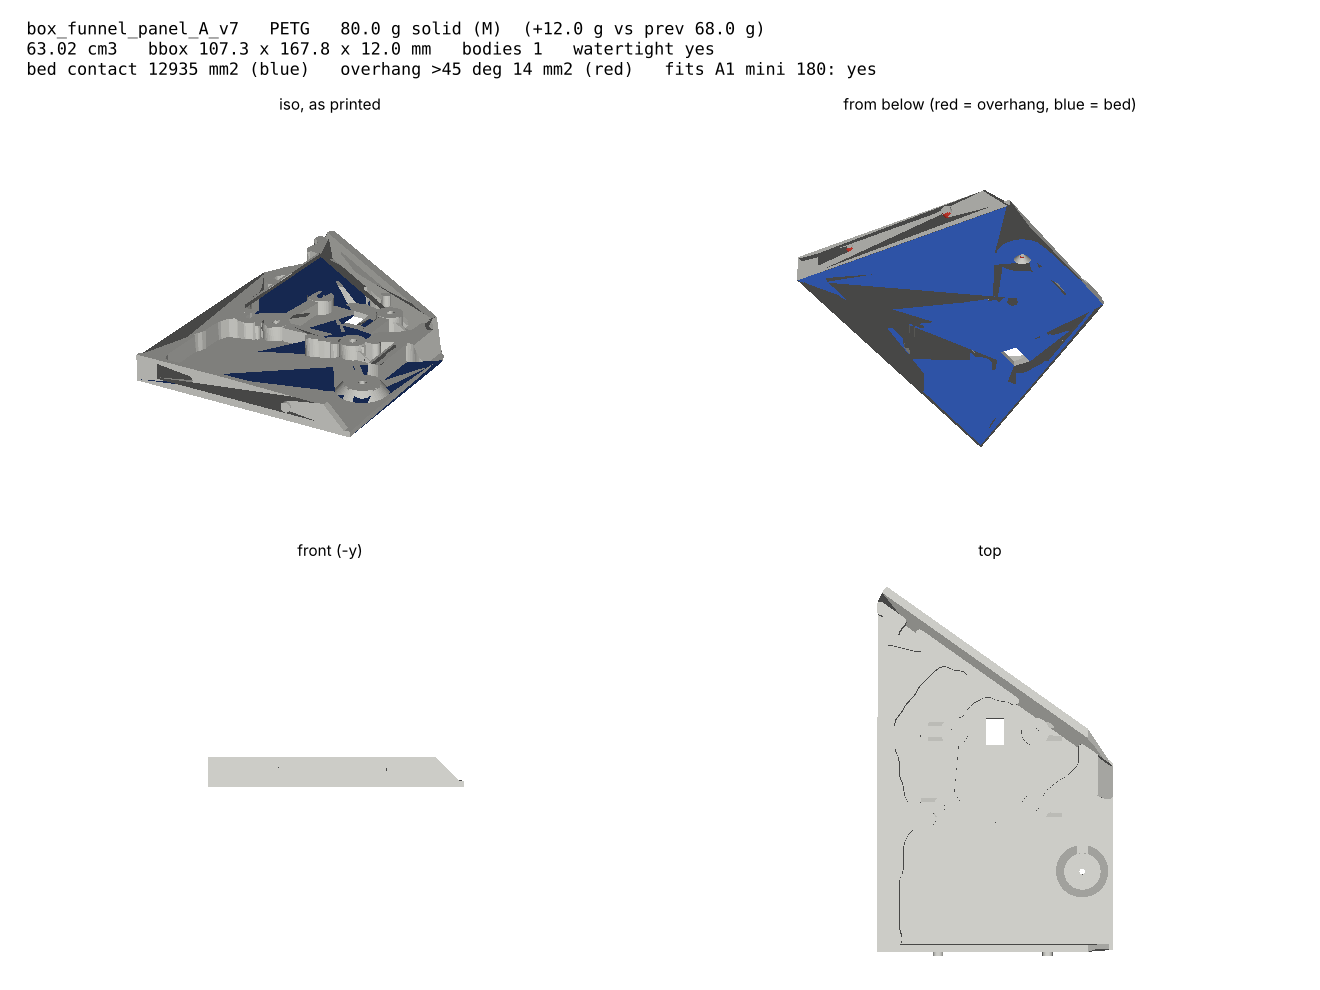
runs/funnel_panel/v7/preview.png
