sparkiscool/nox/runs/funnel_panel/v7/preview_B.png

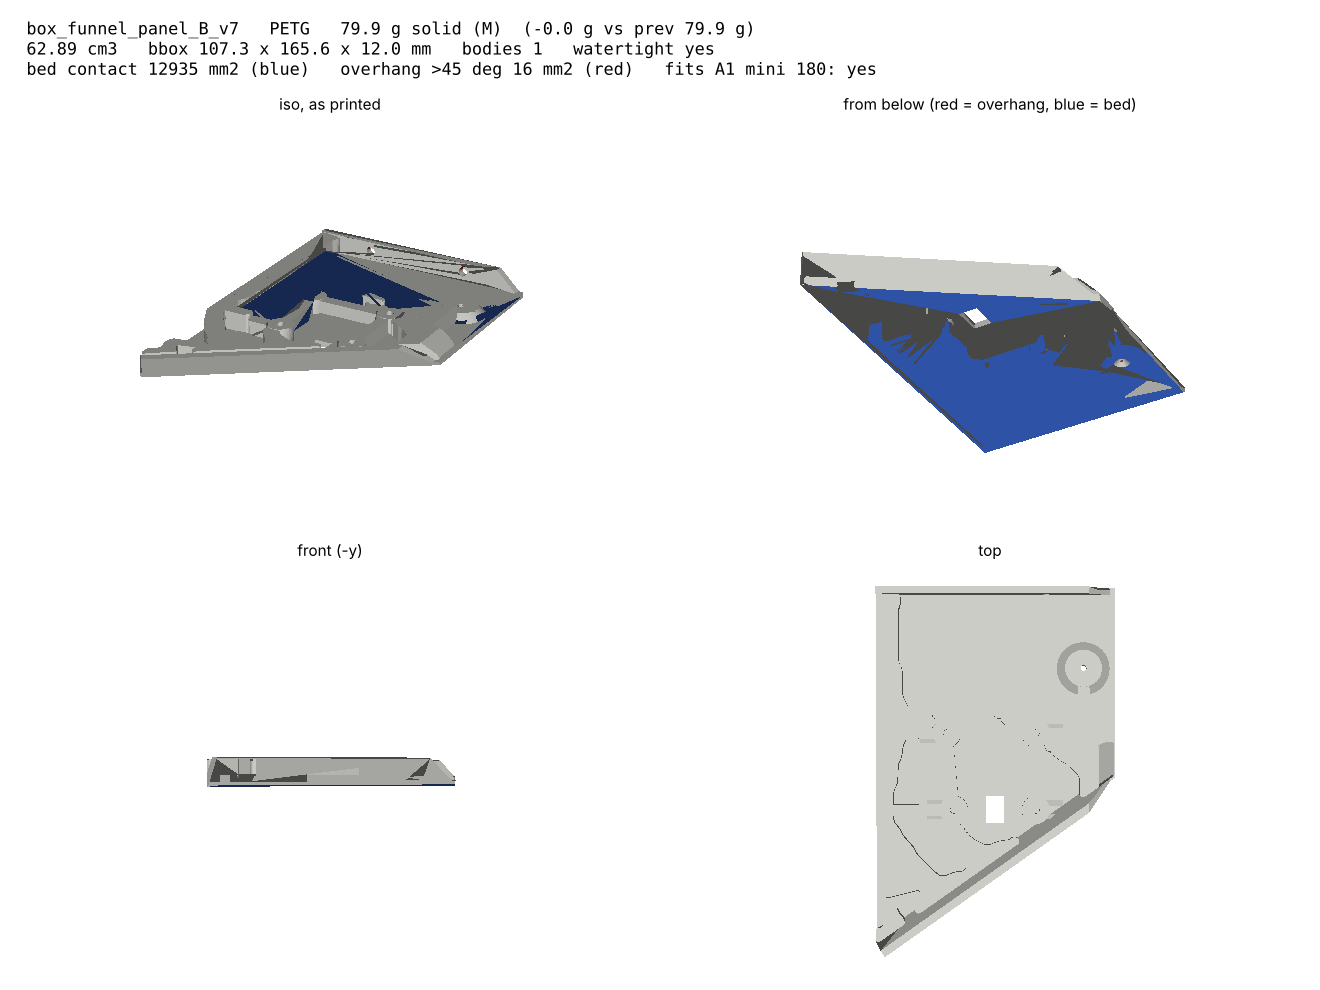
runs/funnel_panel/v7/preview_B.png
