sparkiscool/nox/runs/funnel_panel/v9_plain/motion.gif

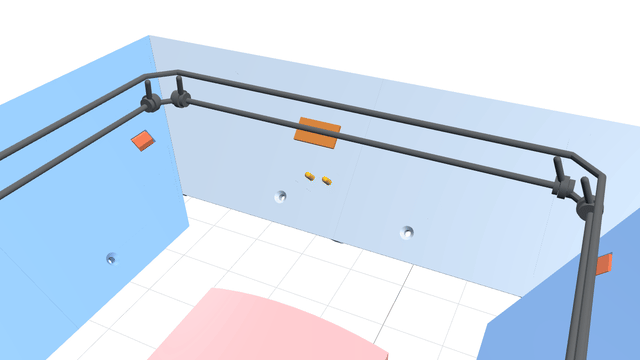
runs/funnel_panel/v9_plain/motion.gif
