sparkiscool/nox/runs/funnel_panel/v9_plain/preview_A_v9_plain_nx.png

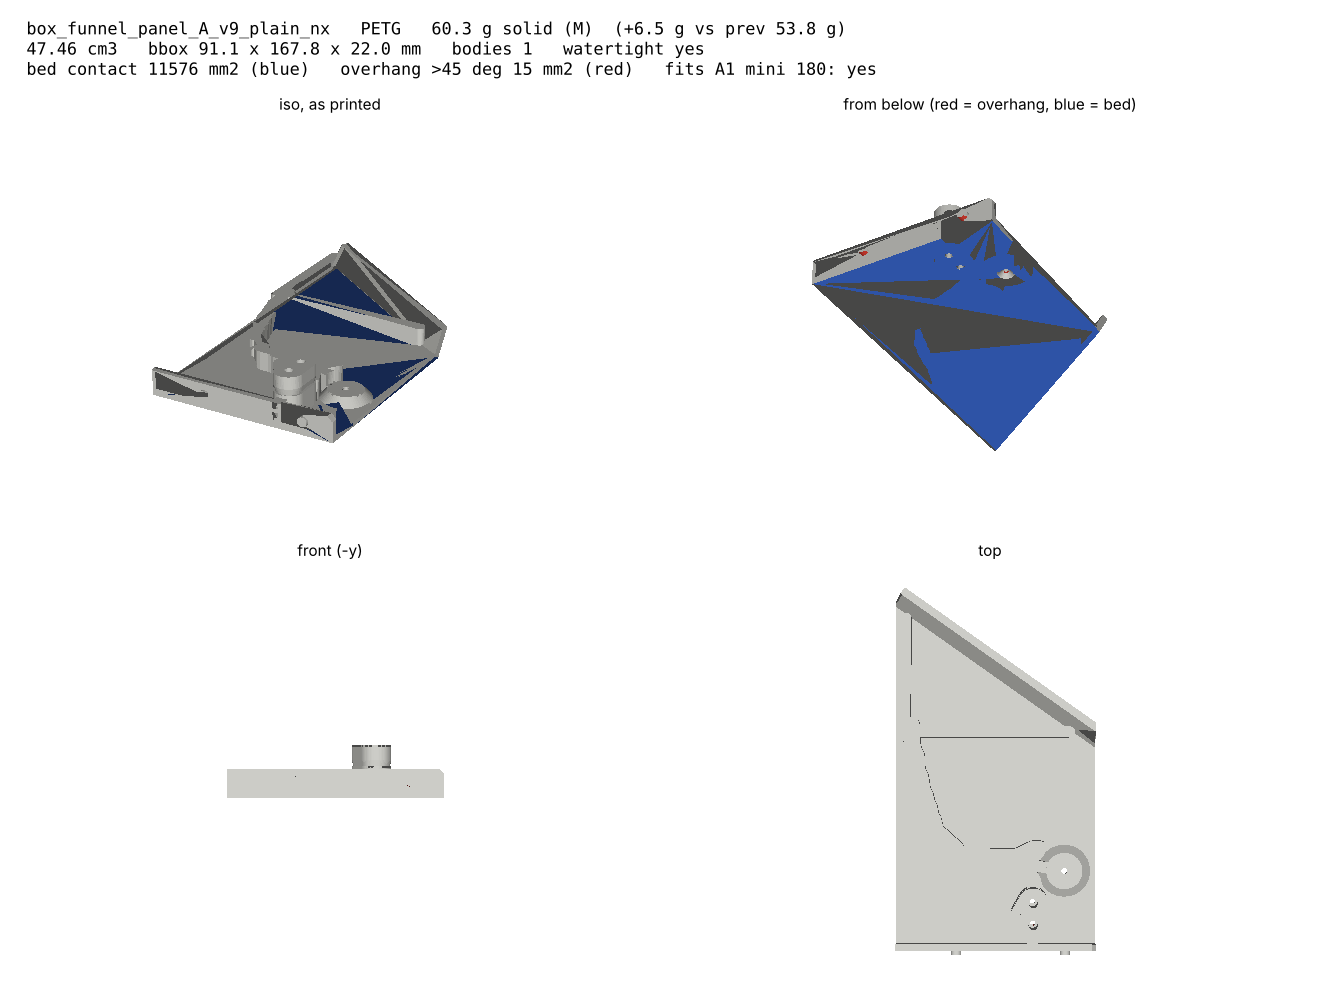
runs/funnel_panel/v9_plain/preview_A_v9_plain_nx.png
