sparkiscool/nox/runs/funnel_panel/v9_plain/preview_probe_cap.png

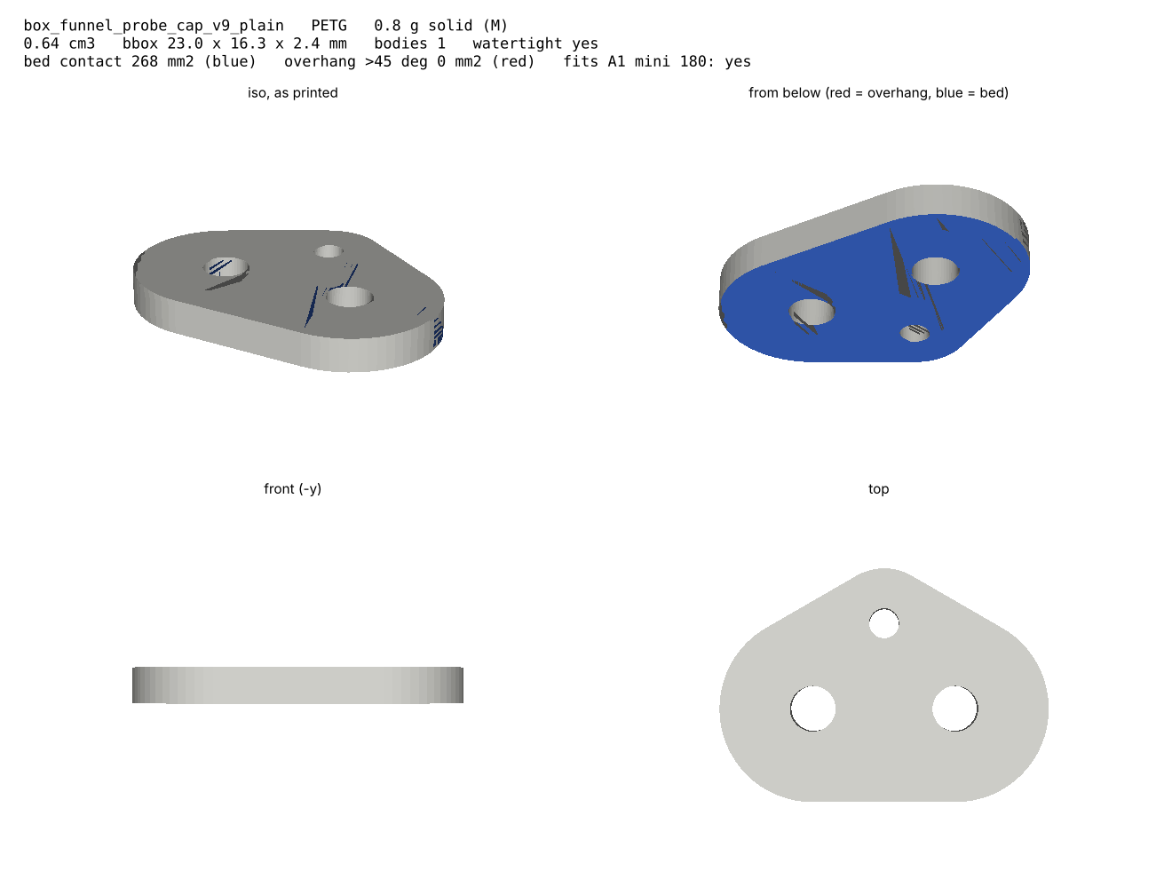
runs/funnel_panel/v9_plain/preview_probe_cap.png
