sparkiscool/nox/runs/funnel_panel/v9_plain/probe_section.png

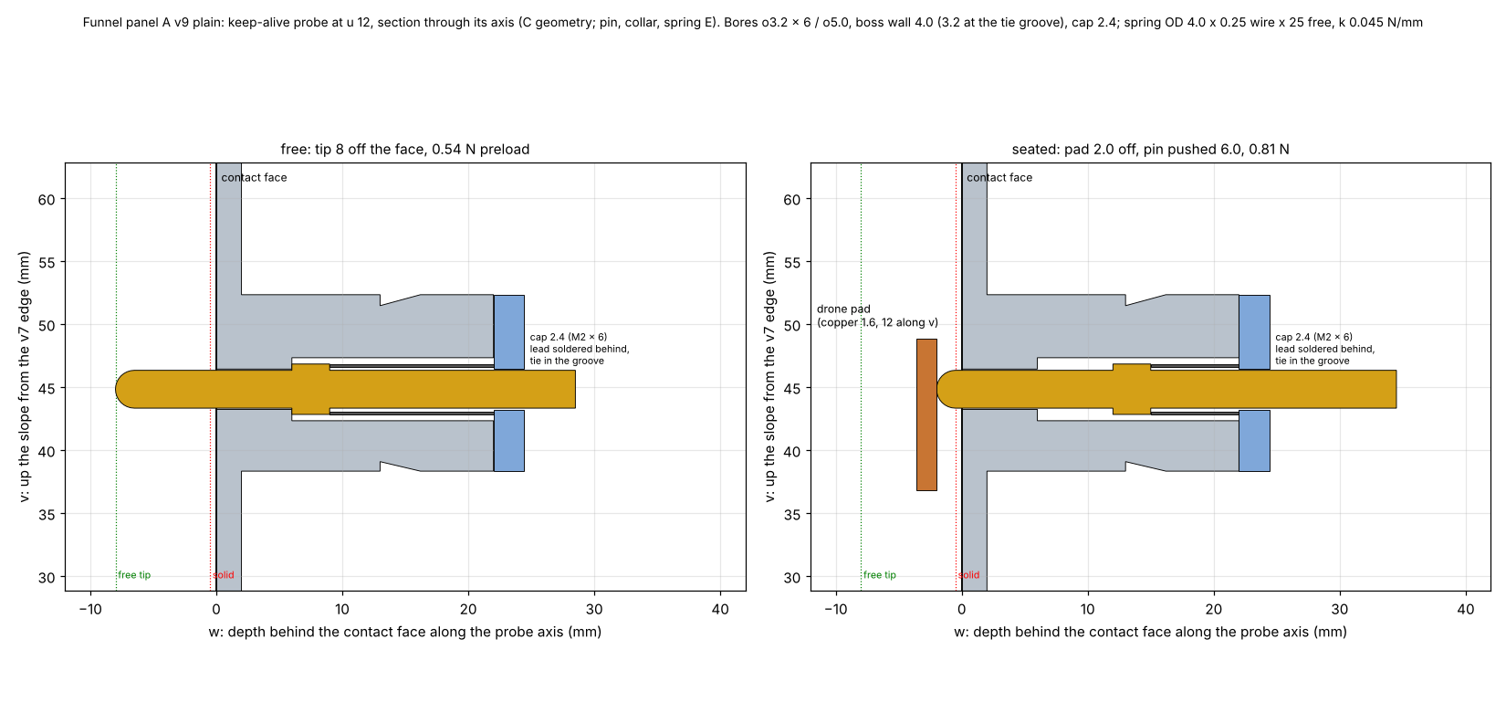
runs/funnel_panel/v9_plain/probe_section.png
