sparkiscool/nox/runs/head_mount/floor/socket_section.png

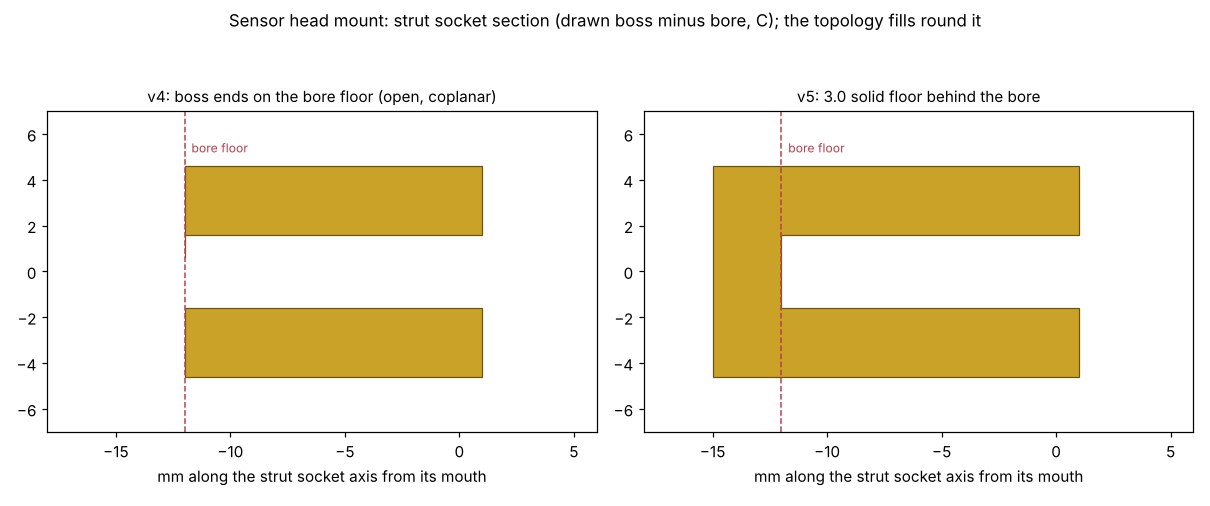
runs/head_mount/floor/socket_section.png
