sparkiscool/nox/runs/head_mount/floor/v4_preview.png

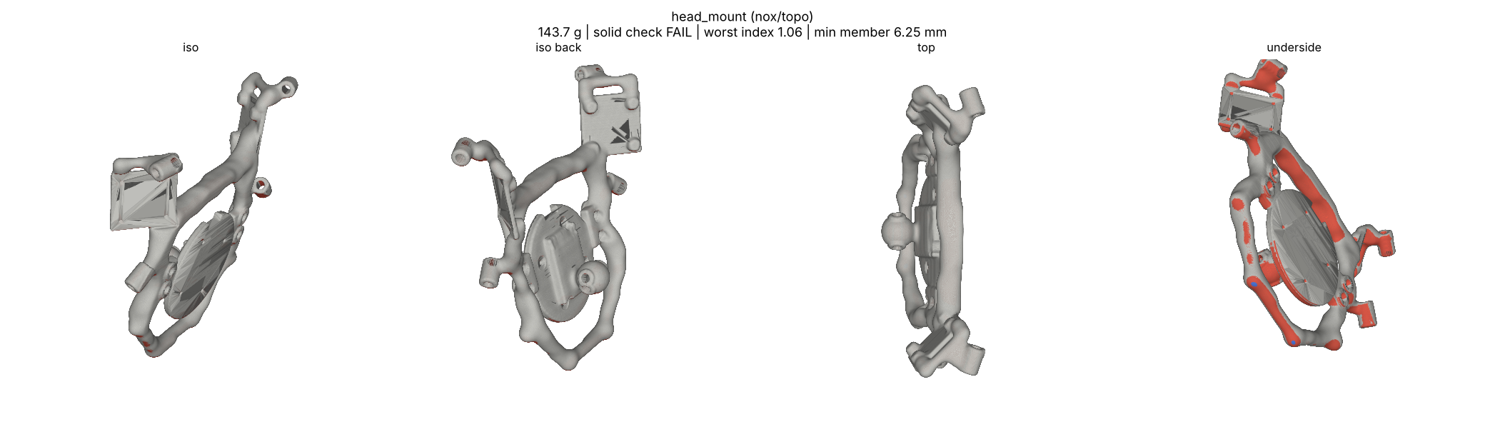
runs/head_mount/floor/v4_preview.png
