sparkiscool/nox/runs/head_mount/v5_sweep3/g25.png

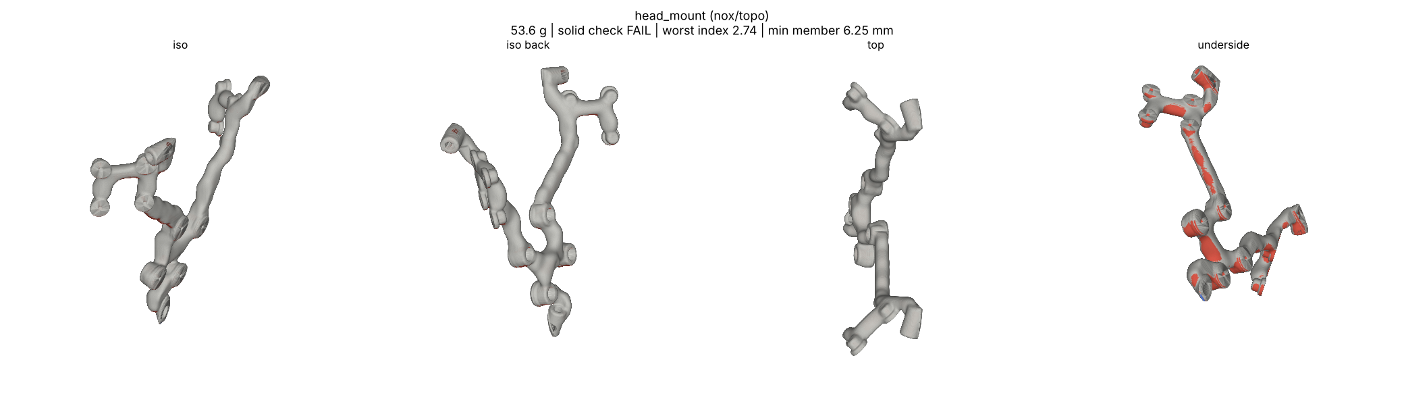
runs/head_mount/v5_sweep3/g25.png
