sparkiscool/nox/runs/holder/organic-v12/preview.png

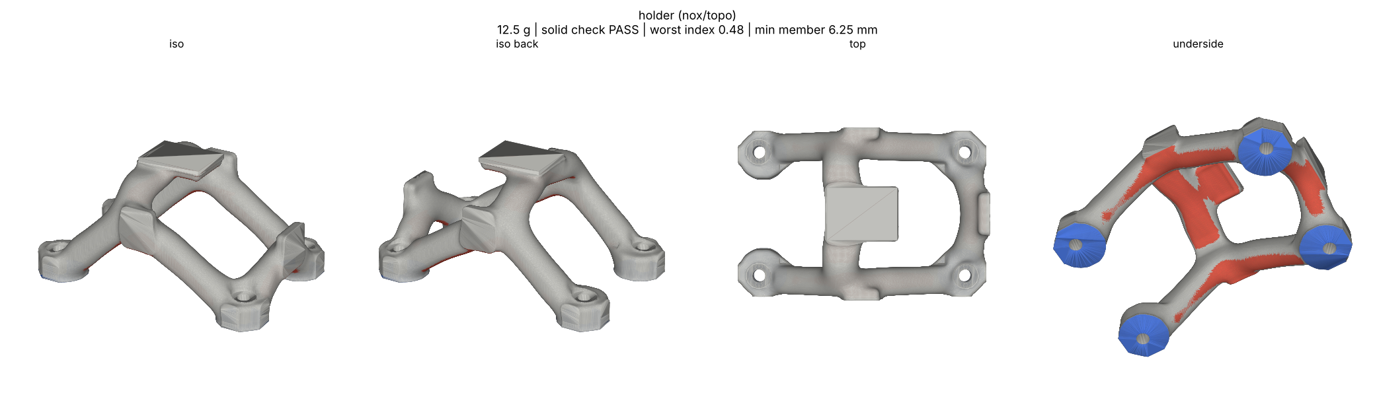
runs/holder/organic-v12/preview.png
