sparkiscool/nox/runs/holder/topo-v1/preview.png

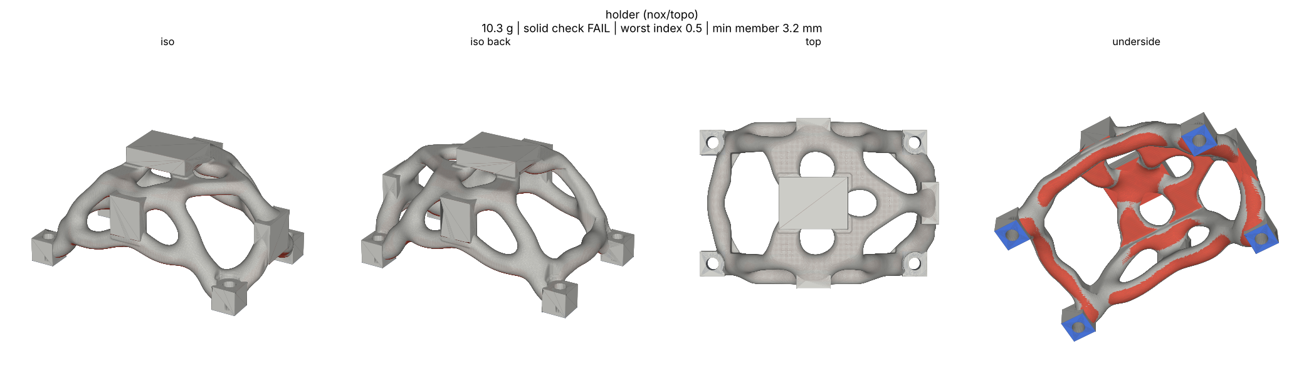
runs/holder/topo-v1/preview.png
