sparkiscool/nox/runs/hook_latch/v2/motion.gif

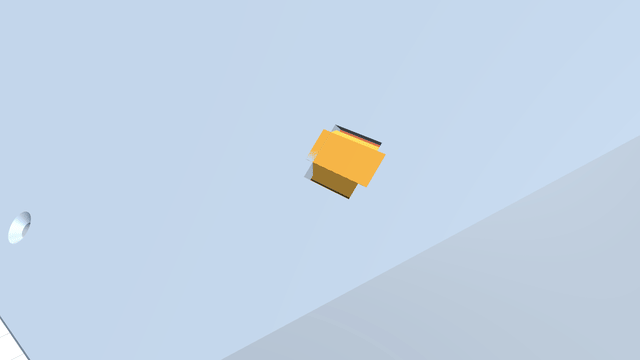
runs/hook_latch/v2/motion.gif
