sparkiscool/nox/runs/hook_latch/v2/preview.png

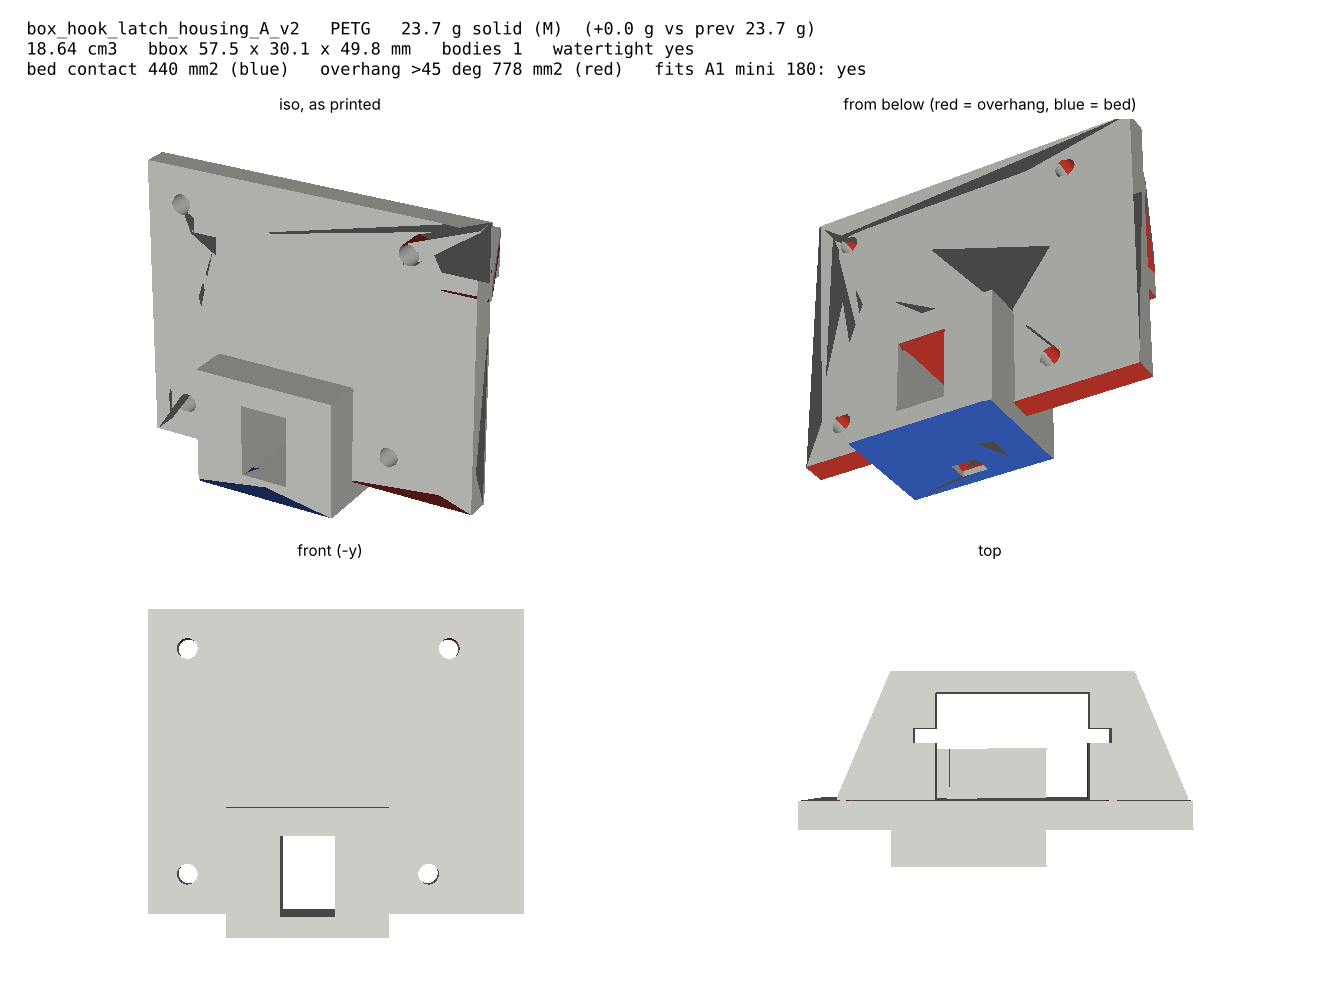
runs/hook_latch/v2/preview.png
