sparkiscool/nox/runs/hook_latch/v2/preview_housing_B.png

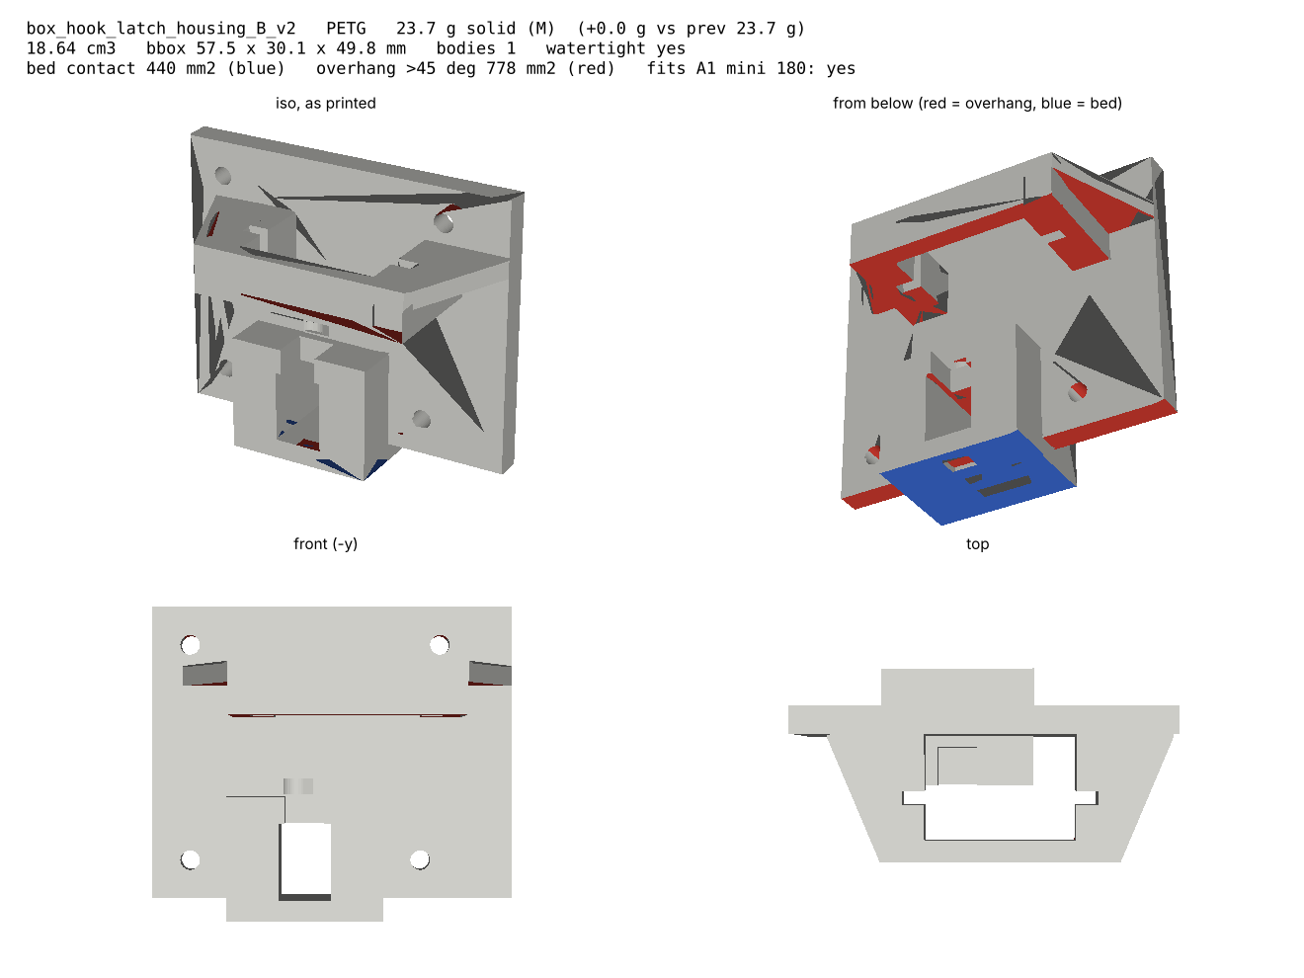
runs/hook_latch/v2/preview_housing_B.png
