sparkiscool/nox/runs/hook_latch/v2/preview_plunger_A.png

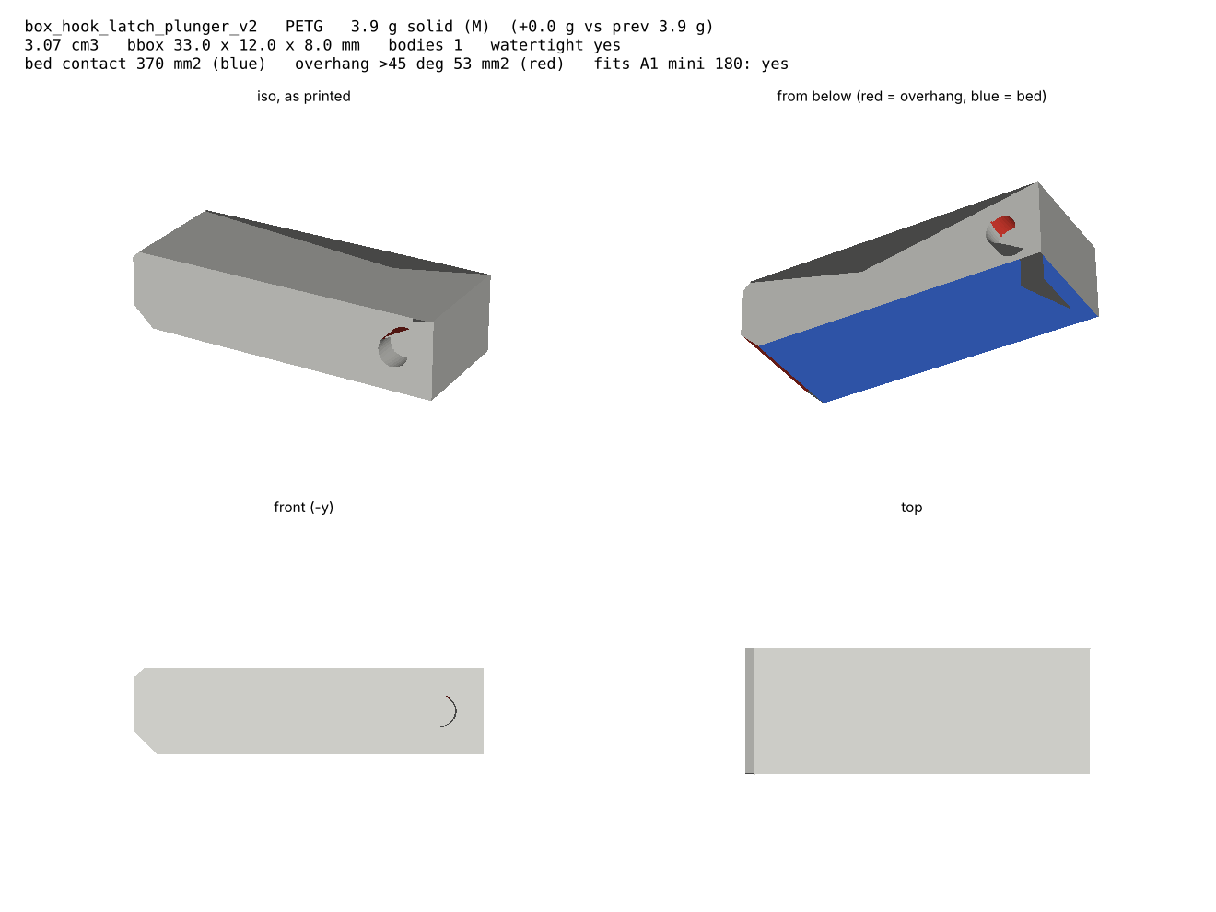
runs/hook_latch/v2/preview_plunger_A.png
