sparkiscool/nox/runs/hub/v6r2/preview.png

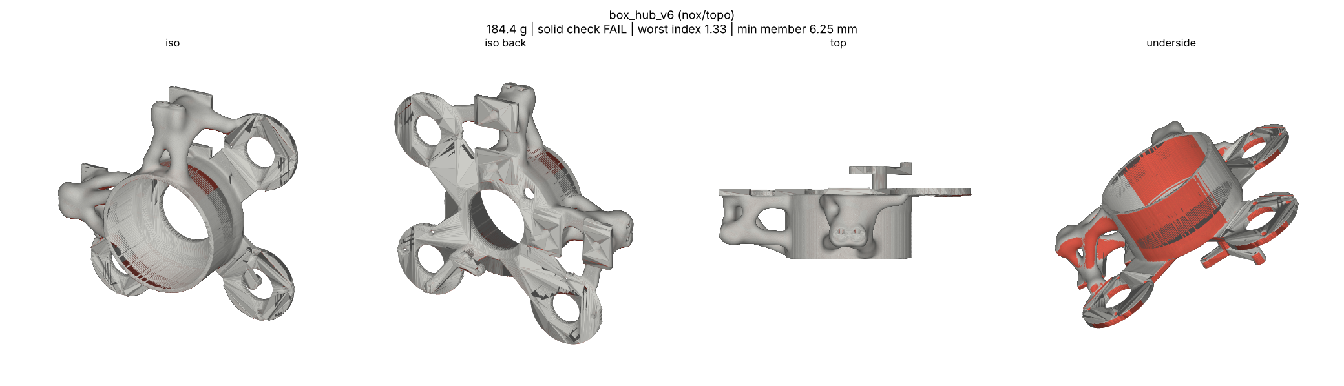
runs/hub/v6r2/preview.png
