sparkiscool/nox/runs/hub/v6r3/preview.png

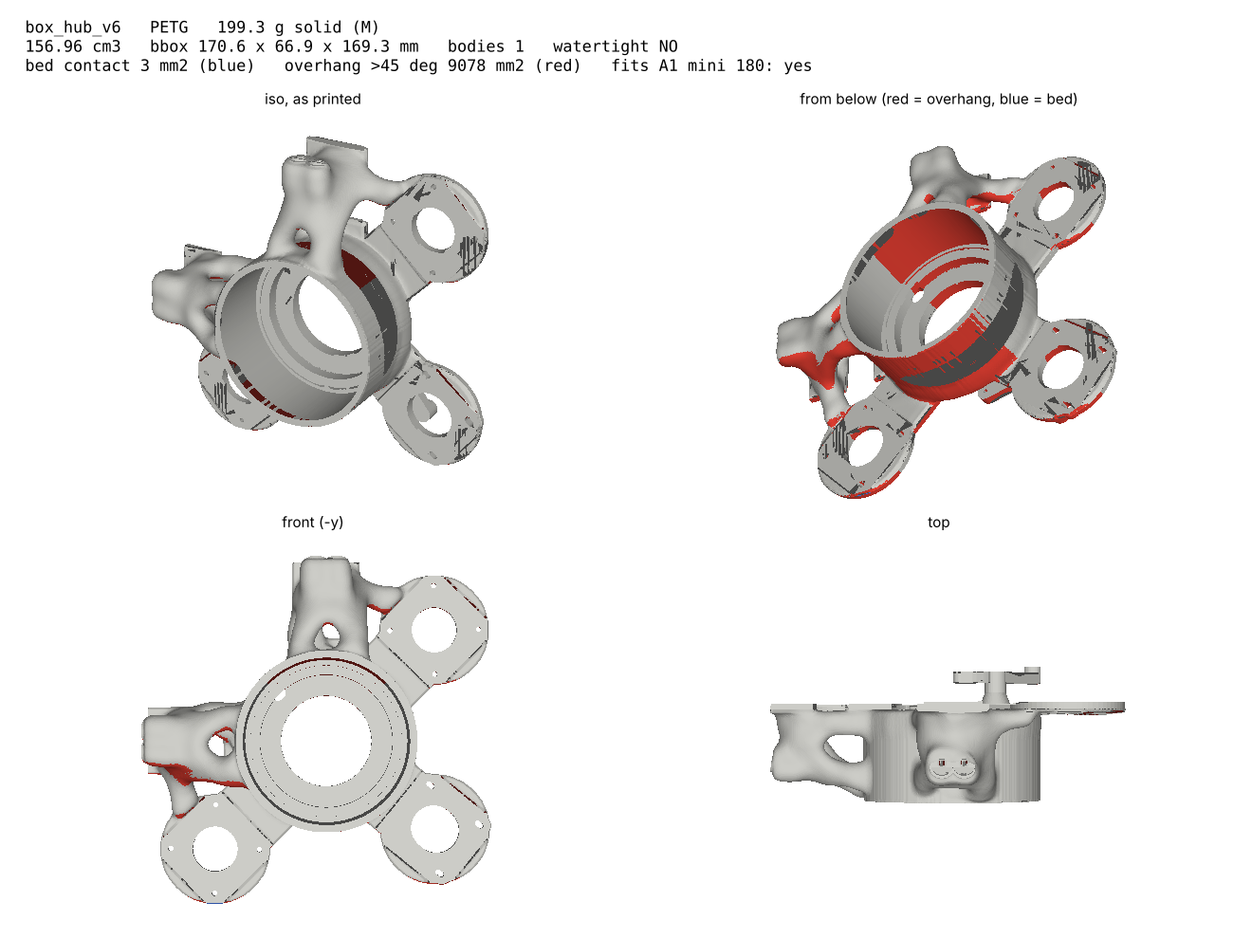
runs/hub/v6r3/preview.png
