sparkiscool/nox/runs/motor_mount/organic-v2/preview.png

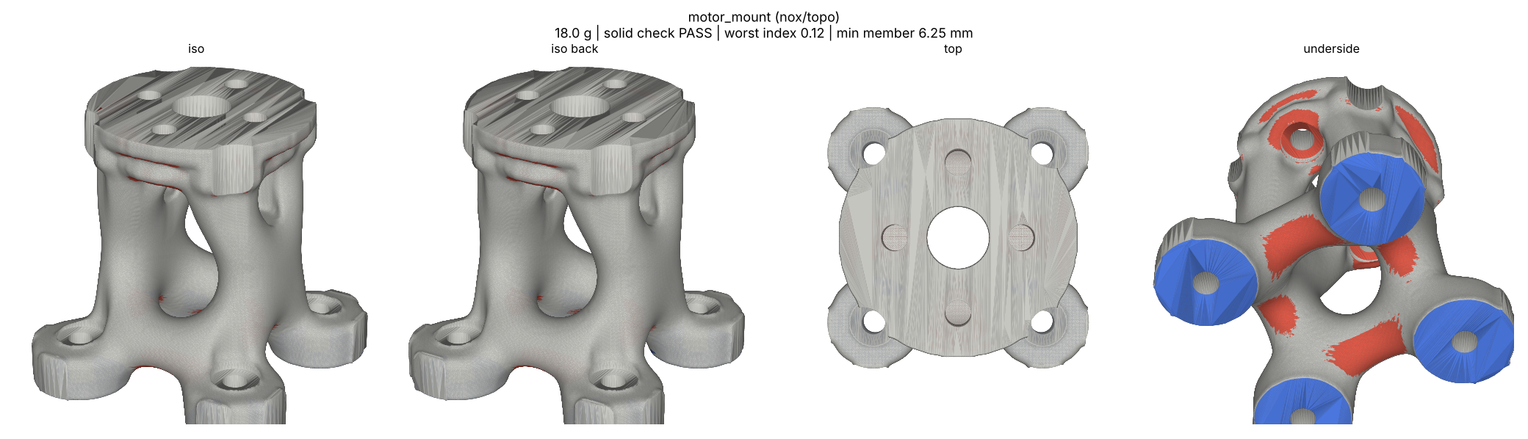
runs/motor_mount/organic-v2/preview.png
