sparkiscool/nox/runs/overseer_arm_rear/v5d/preview.png

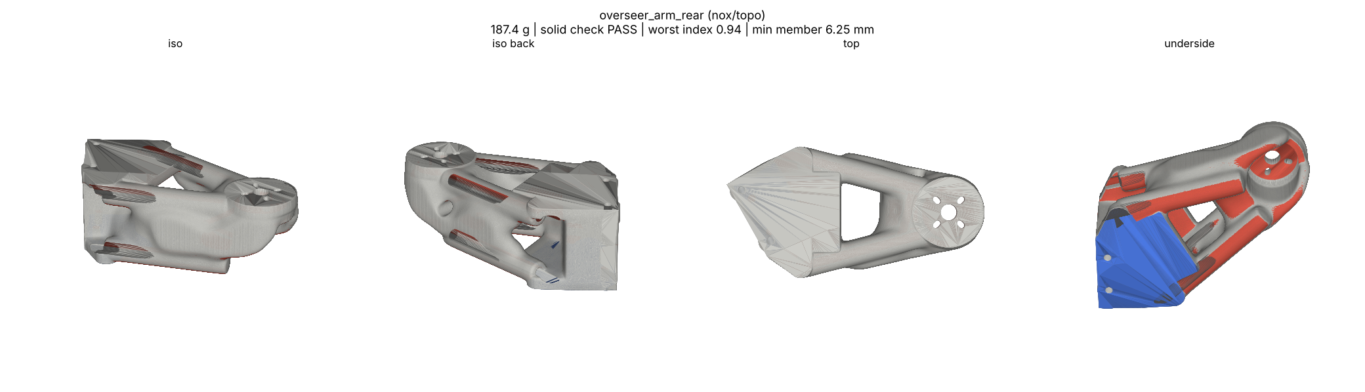
runs/overseer_arm_rear/v5d/preview.png
