sparkiscool/nox/runs/overseer_arm_rear/v5d/preview_overseer_arm_rear_v5d.png

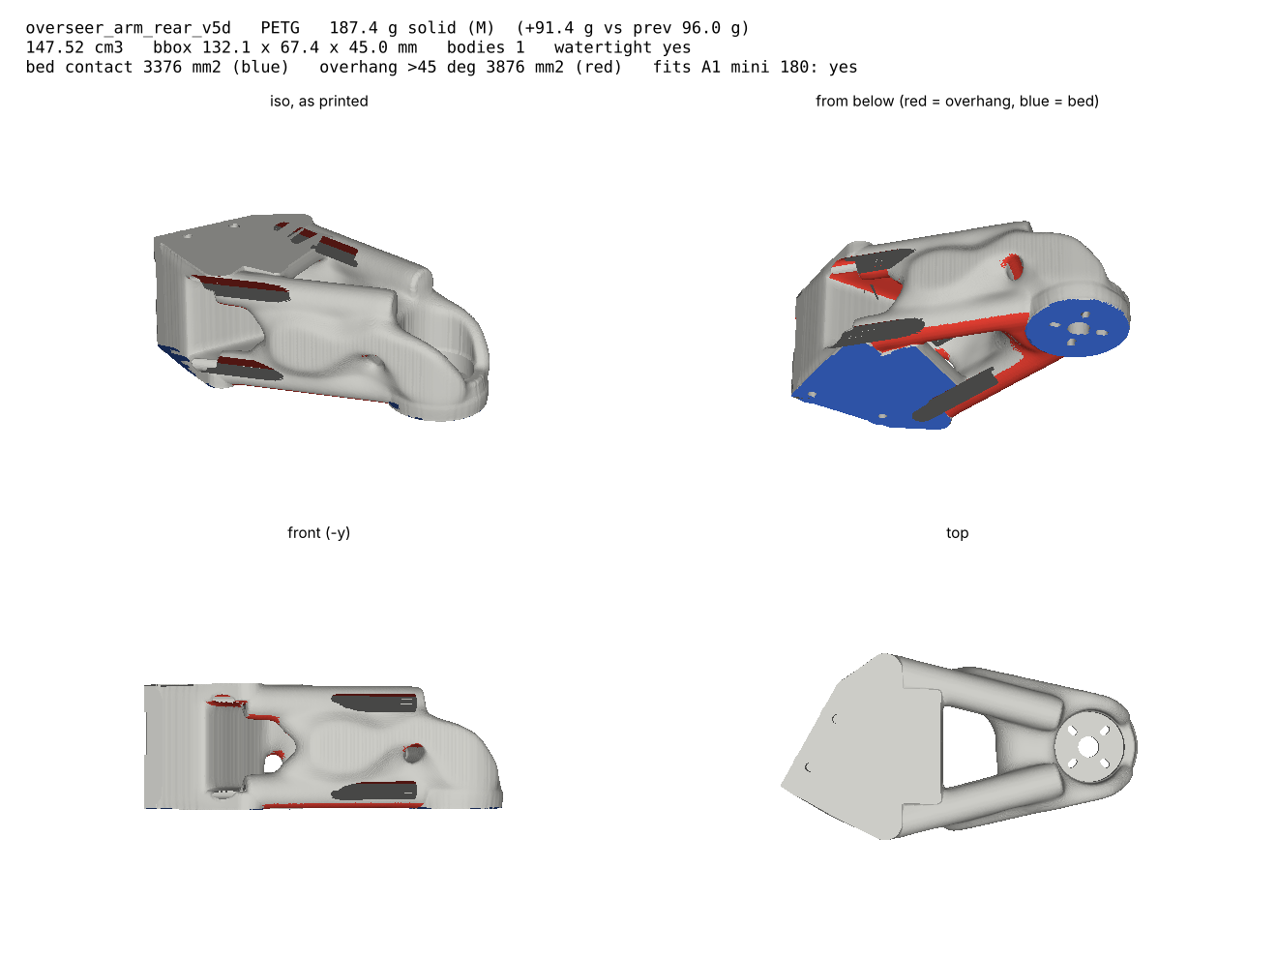
runs/overseer_arm_rear/v5d/preview_overseer_arm_rear_v5d.png
