sparkiscool/nox/runs/overseer_arms/v5/layout.png

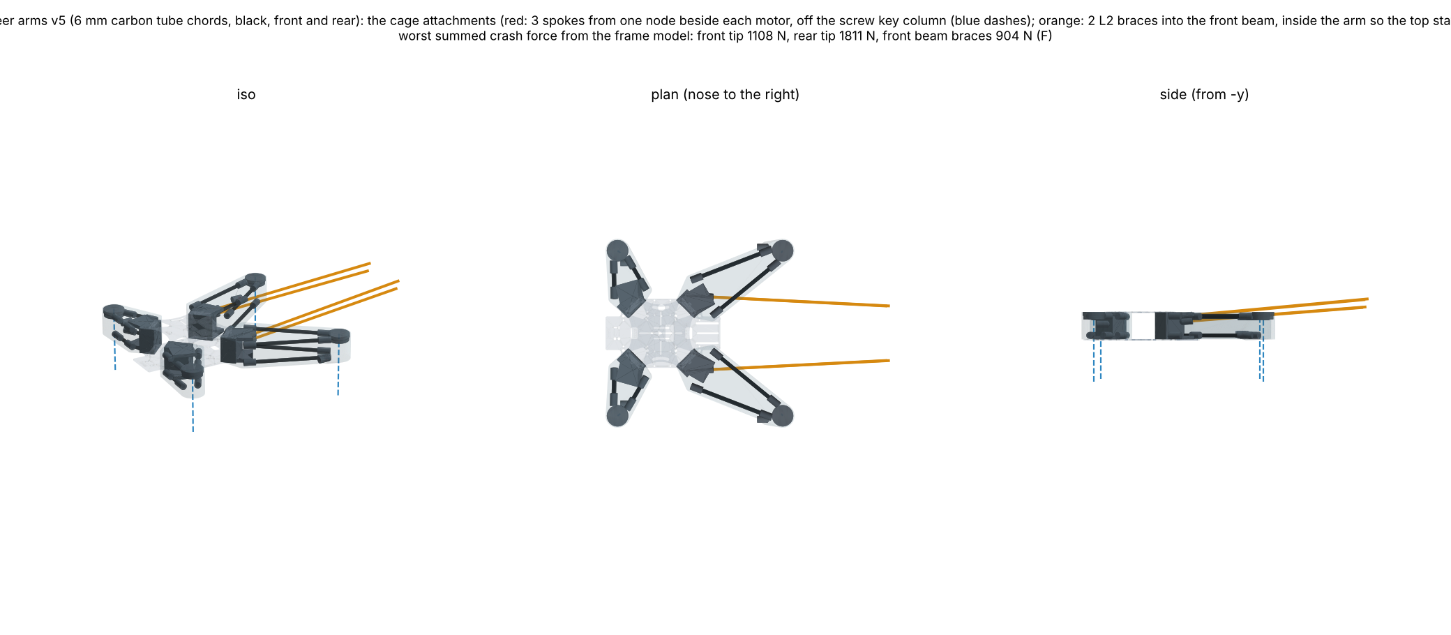
runs/overseer_arms/v5/layout.png
