sparkiscool/nox/runs/overseer_core/v4/alternatives.png

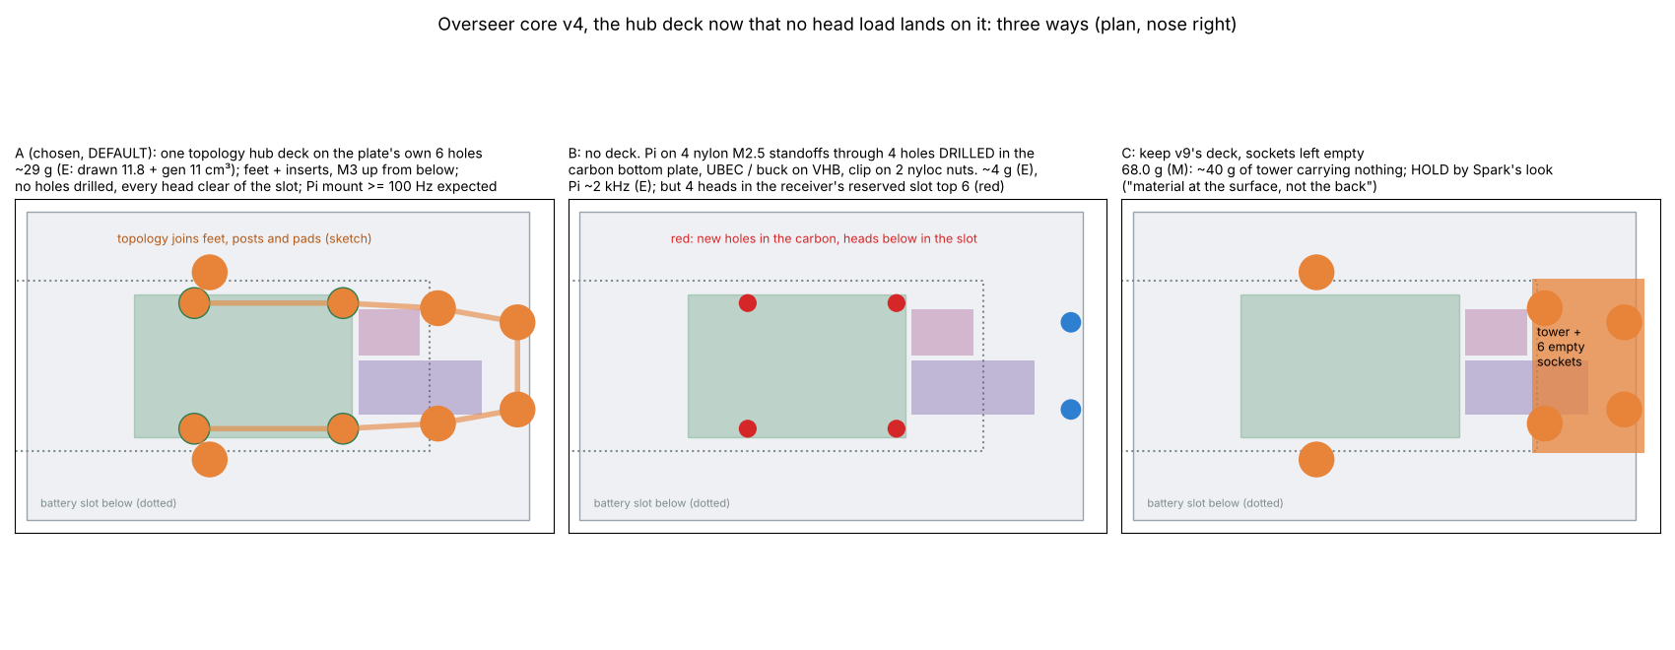
runs/overseer_core/v4/alternatives.png
