sparkiscool/nox/runs/overseer_core/v4/preview.png

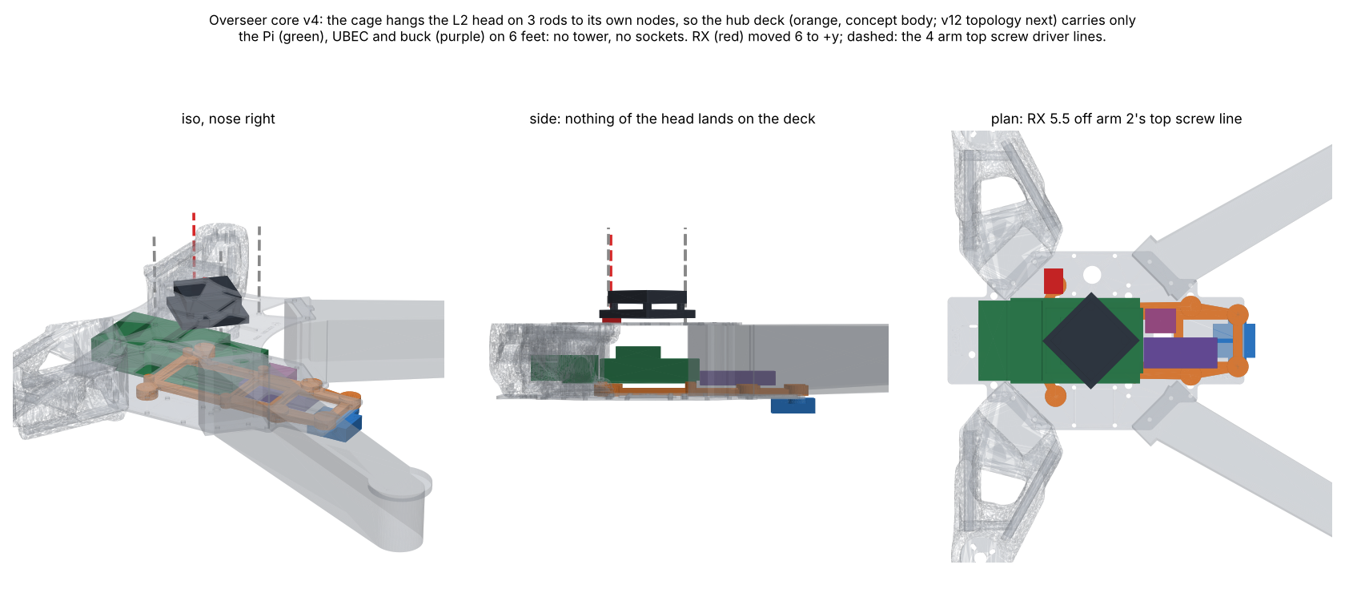
runs/overseer_core/v4/preview.png
