sparkiscool/nox/runs/overseer_core_coupons/v2/overseer_core_coupon_keel_hub_v2_preview.png

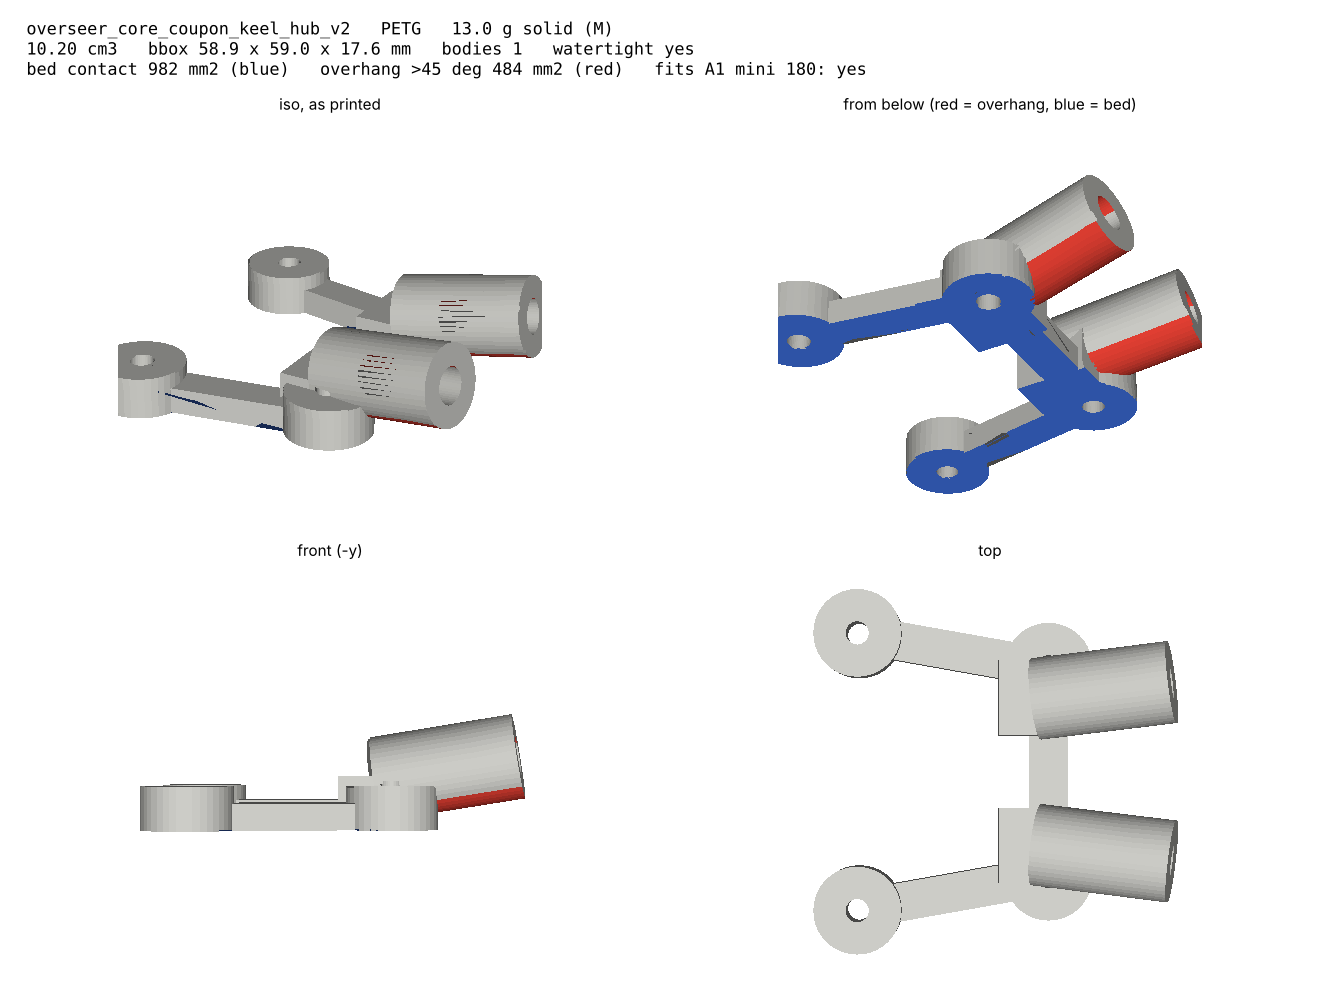
runs/overseer_core_coupons/v2/overseer_core_coupon_keel_hub_v2_preview.png
