sparkiscool/nox/runs/overseer_head_cage/concept/concept.png

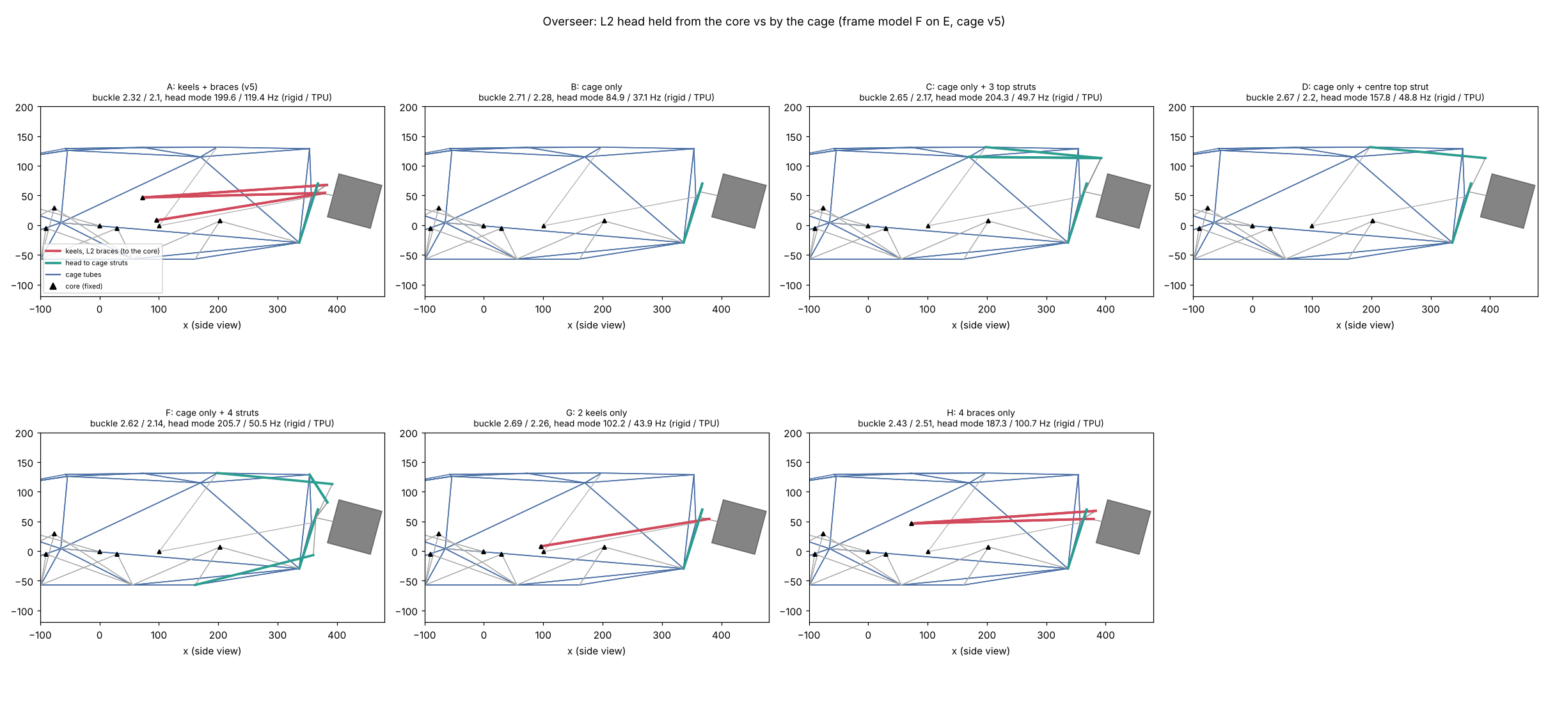
runs/overseer_head_cage/concept/concept.png
