sparkiscool/nox/runs/overseer_head_rods/v1/options.png

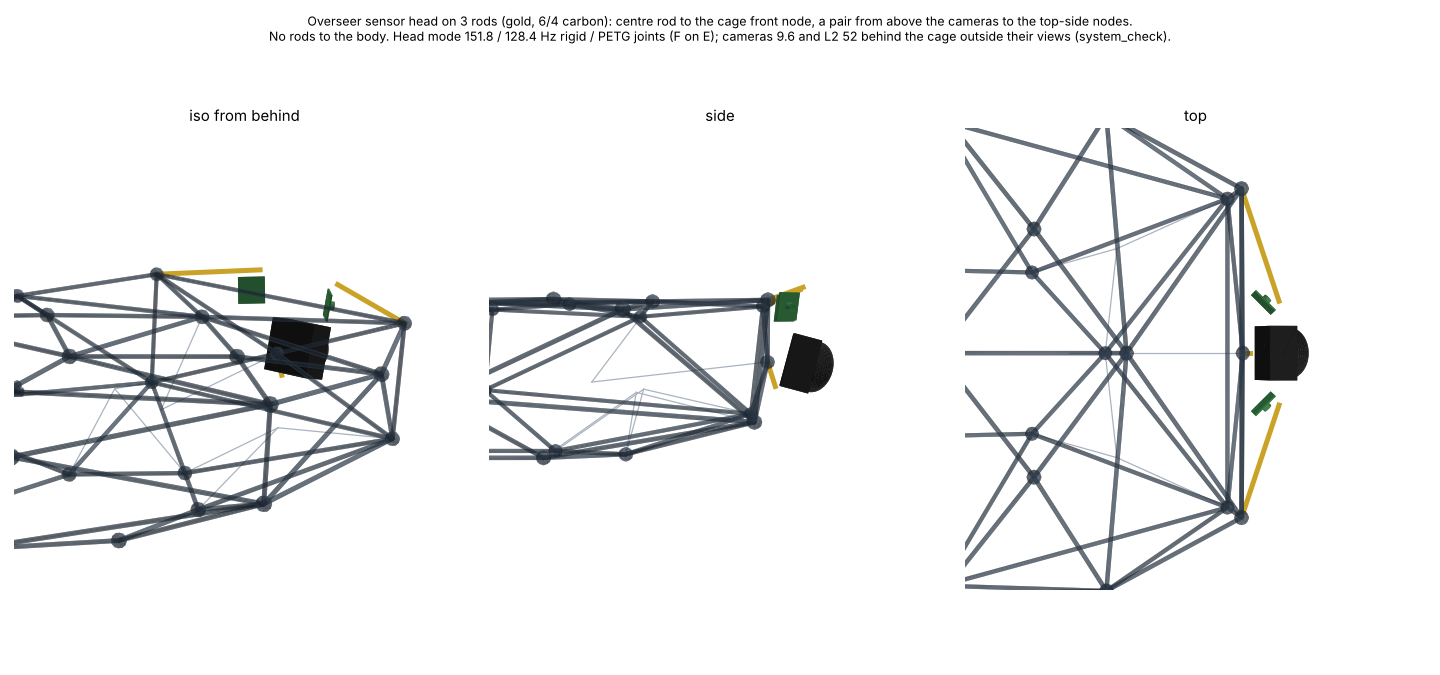
runs/overseer_head_rods/v1/options.png
