sparkiscool/nox/runs/overseer_hub_deck/v12/preview.png

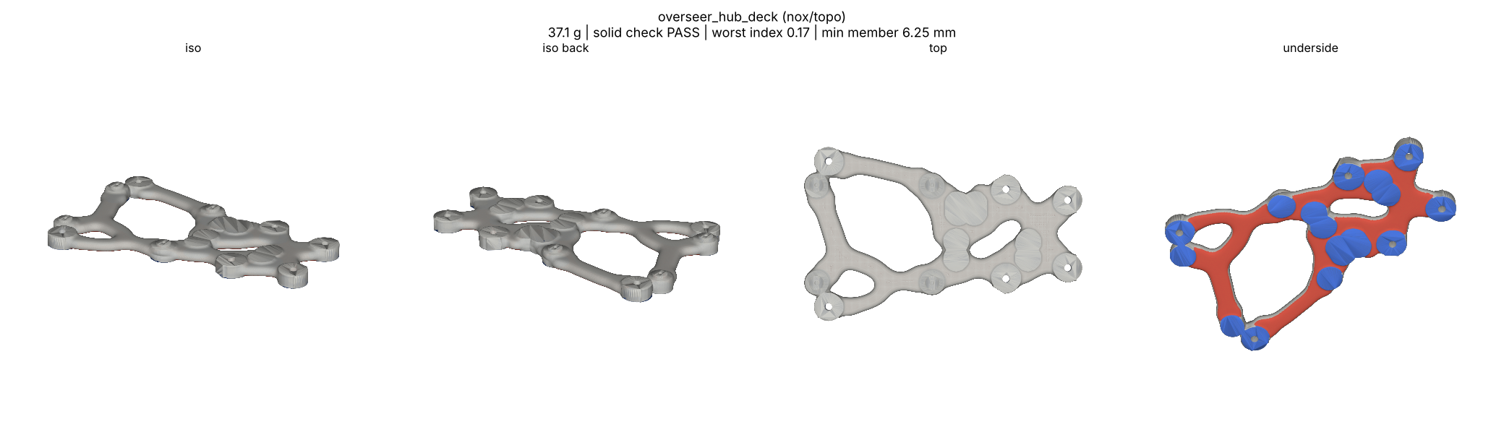
runs/overseer_hub_deck/v12/preview.png
