sparkiscool/nox/runs/overseer_hub_deck/v12/preview_overseer_hub_deck_v12.png

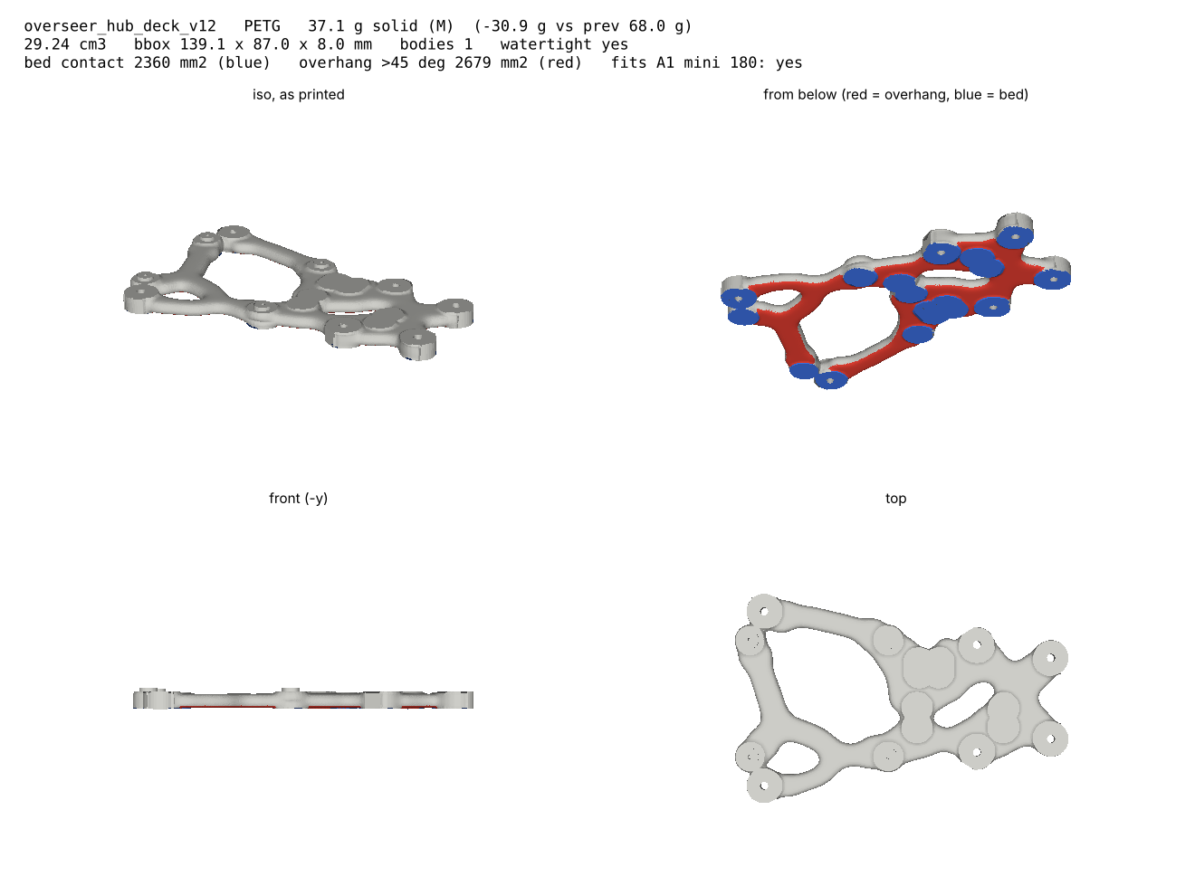
runs/overseer_hub_deck/v12/preview_overseer_hub_deck_v12.png
