sparkiscool/nox/runs/overseer_layout/v5/cages_alt.png

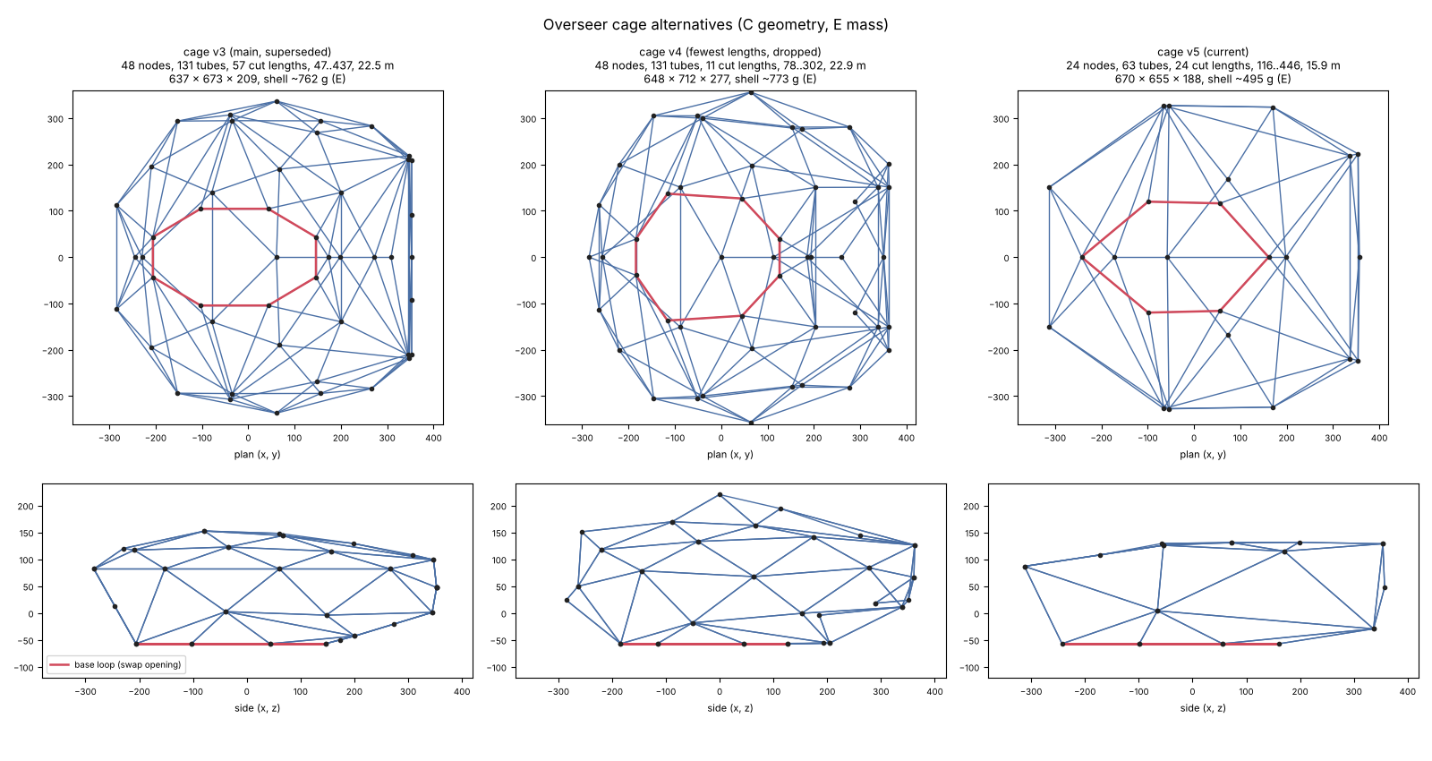
runs/overseer_layout/v5/cages_alt.png
