sparkiscool/nox/runs/overseer_layout/v5/cameras_alt.png

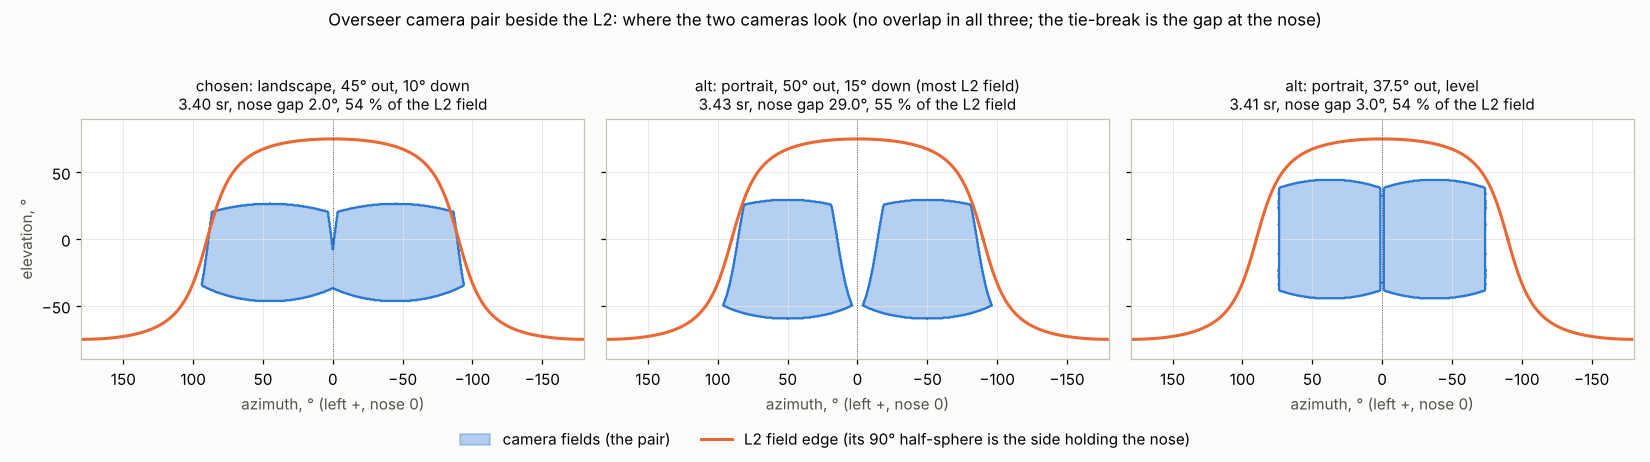
runs/overseer_layout/v5/cameras_alt.png
