sparkiscool/nox/runs/overseer_layout/v5/preview.png

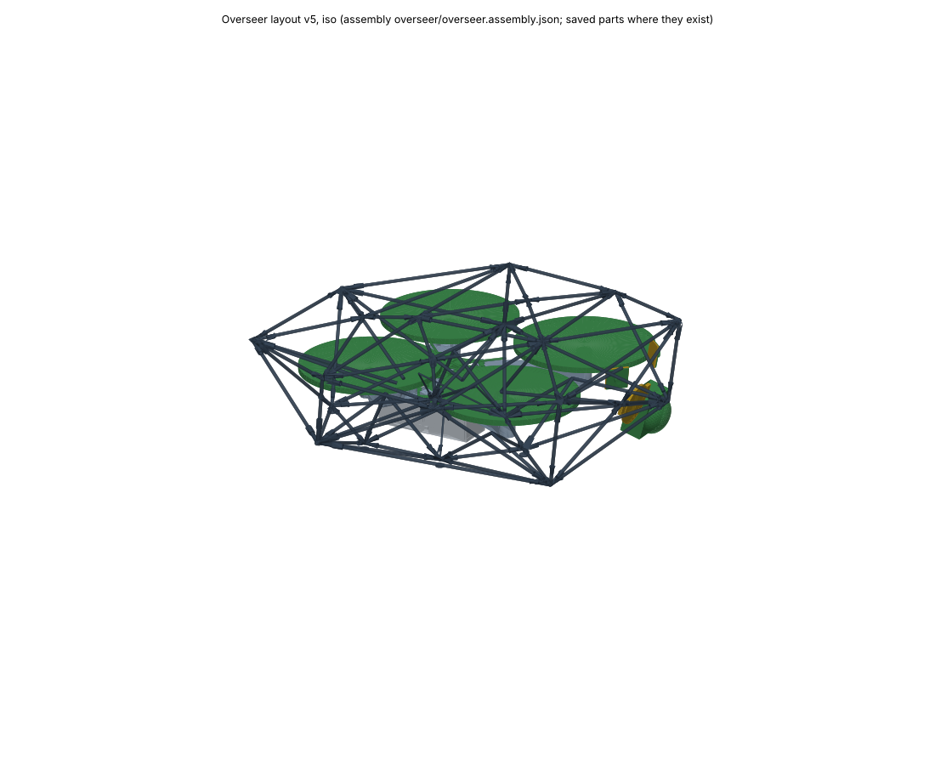
runs/overseer_layout/v5/preview.png
