sparkiscool/nox/runs/overseer_layout/v5/preview_top.png

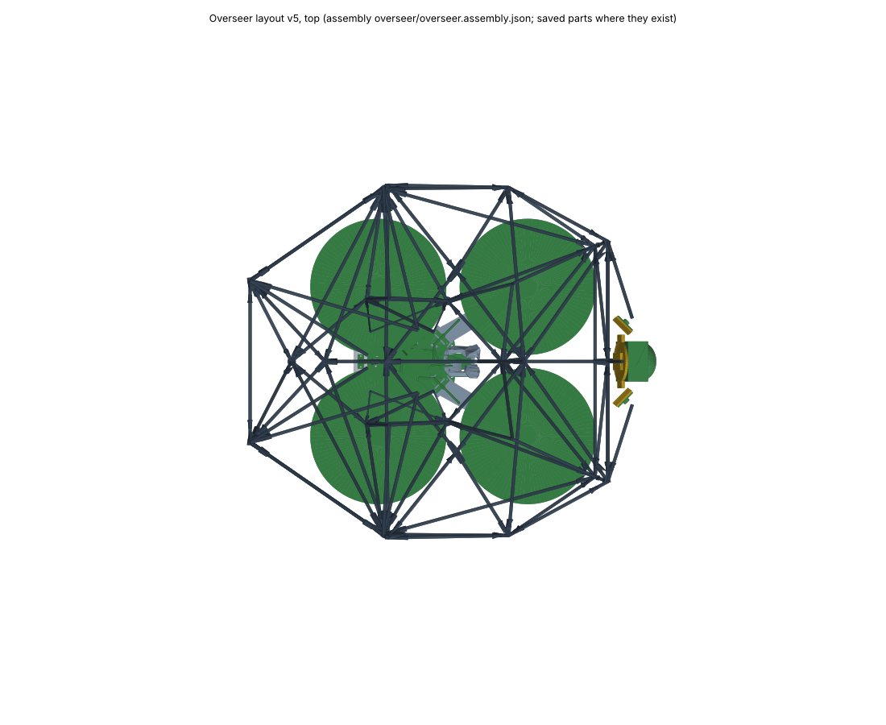
runs/overseer_layout/v5/preview_top.png
