sparkiscool/nox/runs/rod_coupons/v2/section.png

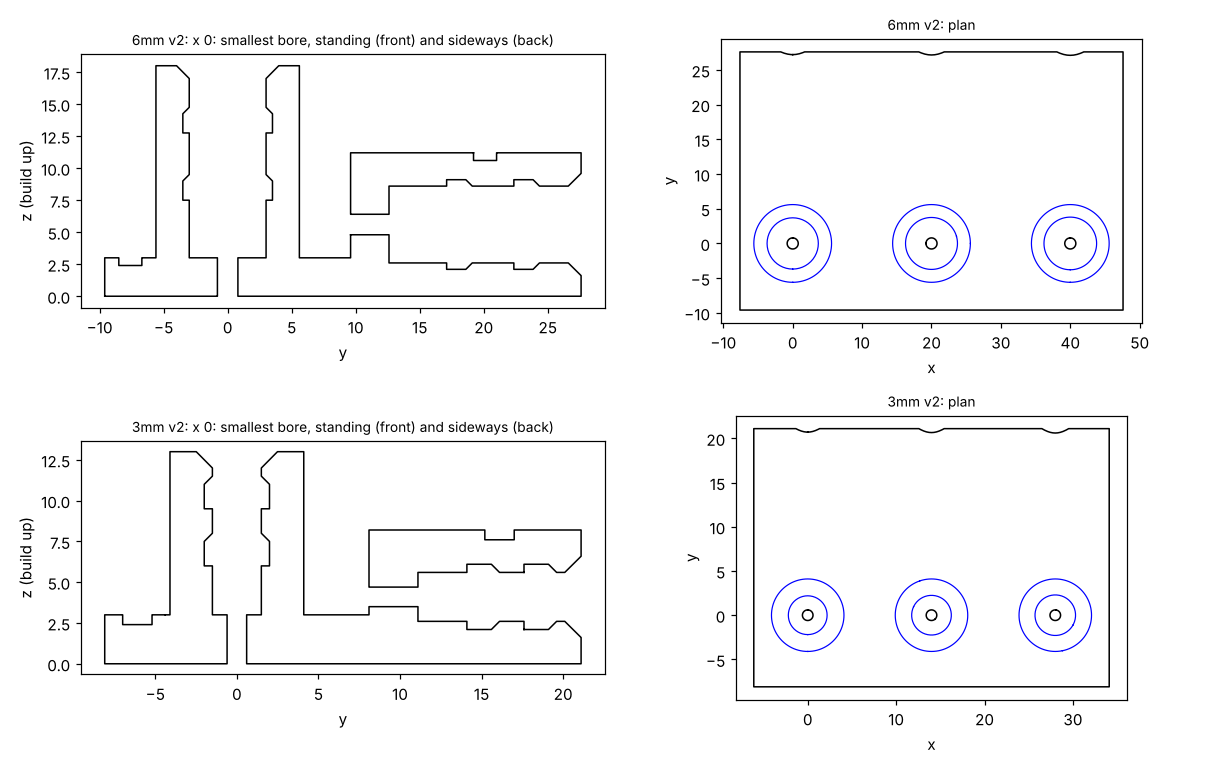
runs/rod_coupons/v2/section.png
