sparkiscool/nox/runs/scan_stick/v13/preview.png

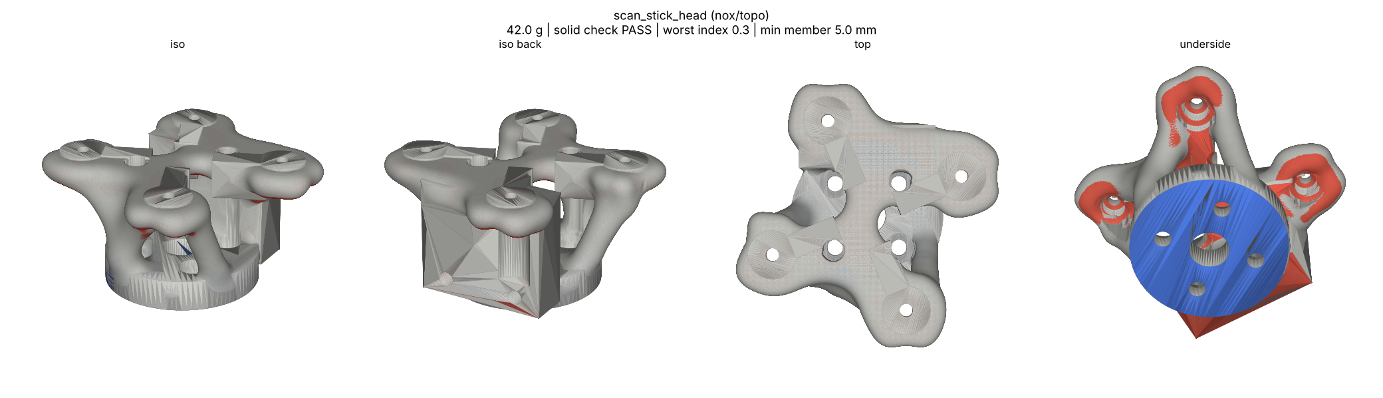
runs/scan_stick/v13/preview.png
