sparkiscool/nox/runs/scan_stick_base/v17/preview.png

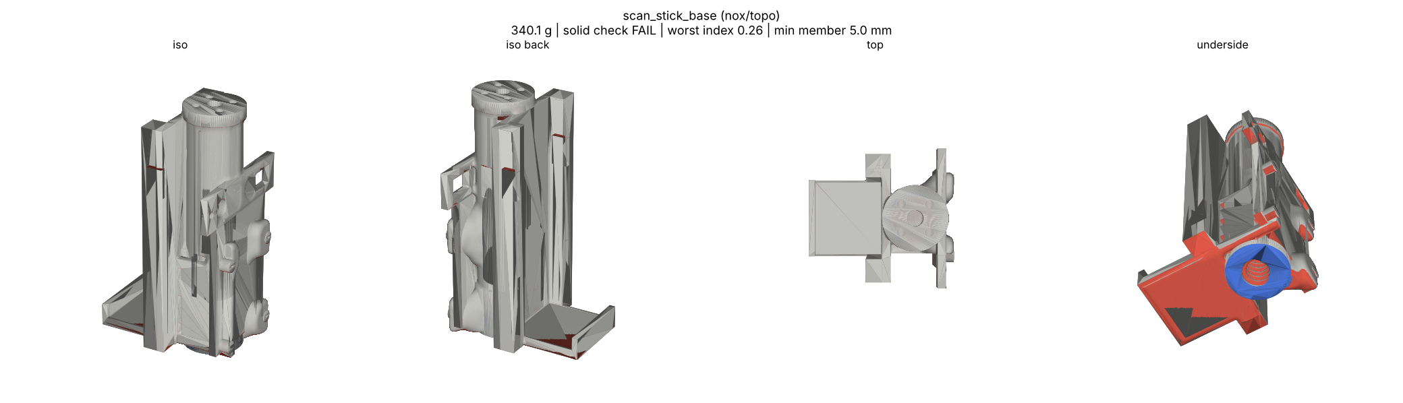
runs/scan_stick_base/v17/preview.png
