sparkiscool/nox/runs/scout_belly_mount/v1/preview.png

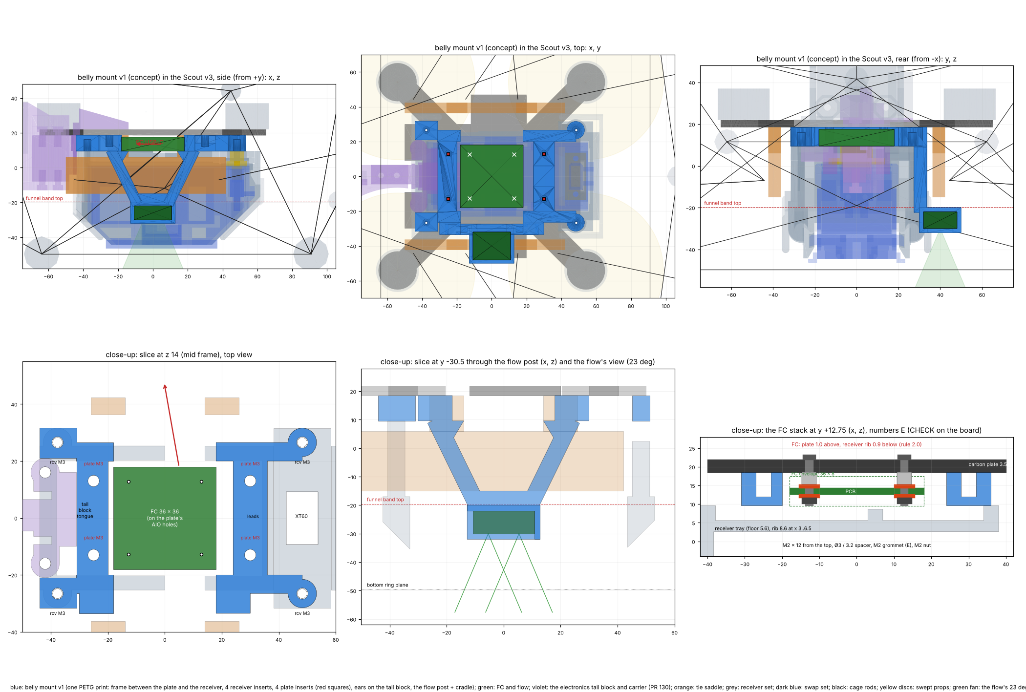
runs/scout_belly_mount/v1/preview.png
