sparkiscool/nox/runs/scout_belly_mount/v1/preview_alternatives.png

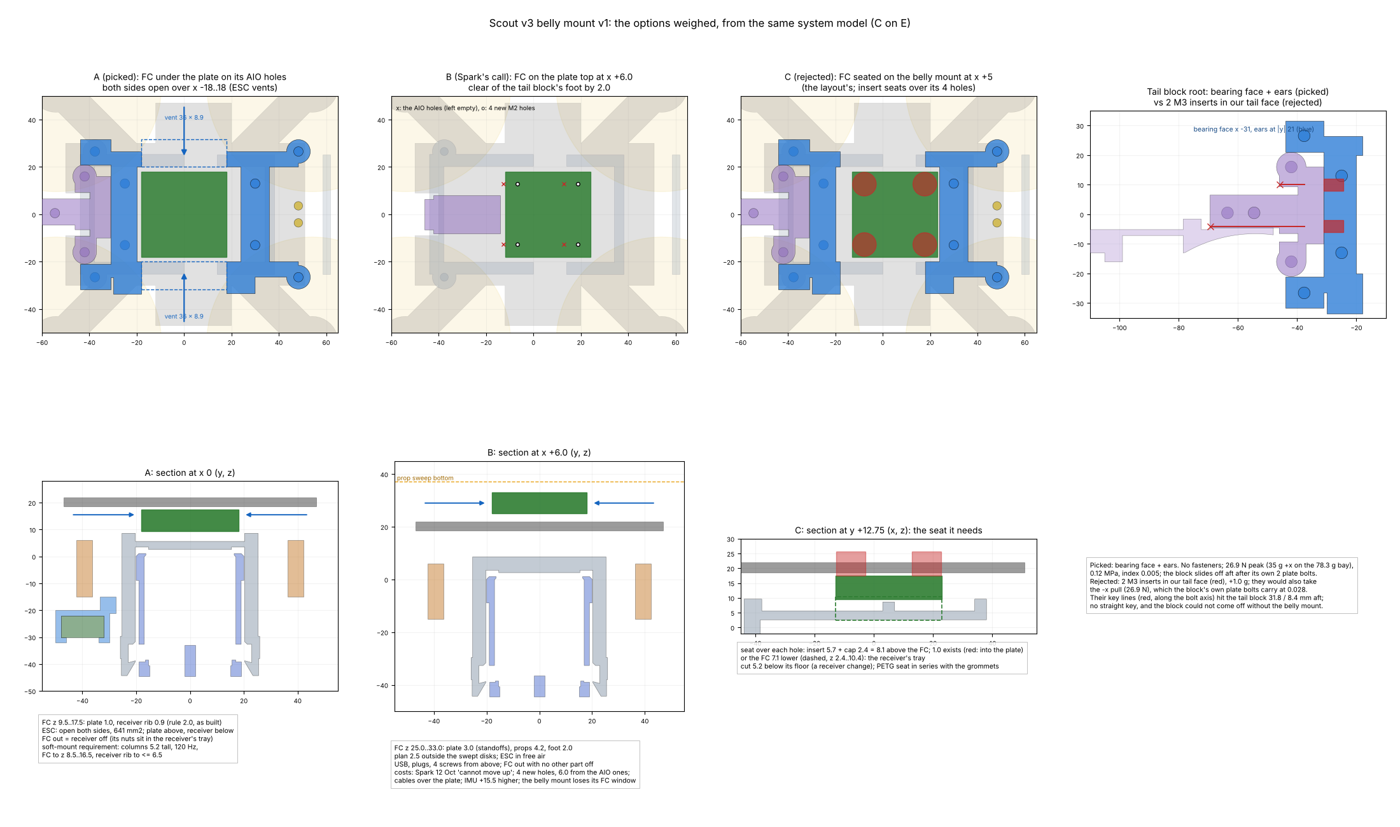
runs/scout_belly_mount/v1/preview_alternatives.png
