sparkiscool/nox/runs/scout_camera_mount/v1/motion.gif

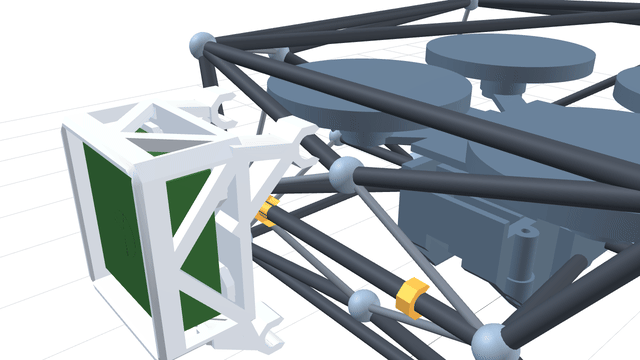
runs/scout_camera_mount/v1/motion.gif
