sparkiscool/nox/runs/scout_camera_mount/v1/preview_scout_camera_mount_collar_v1.png

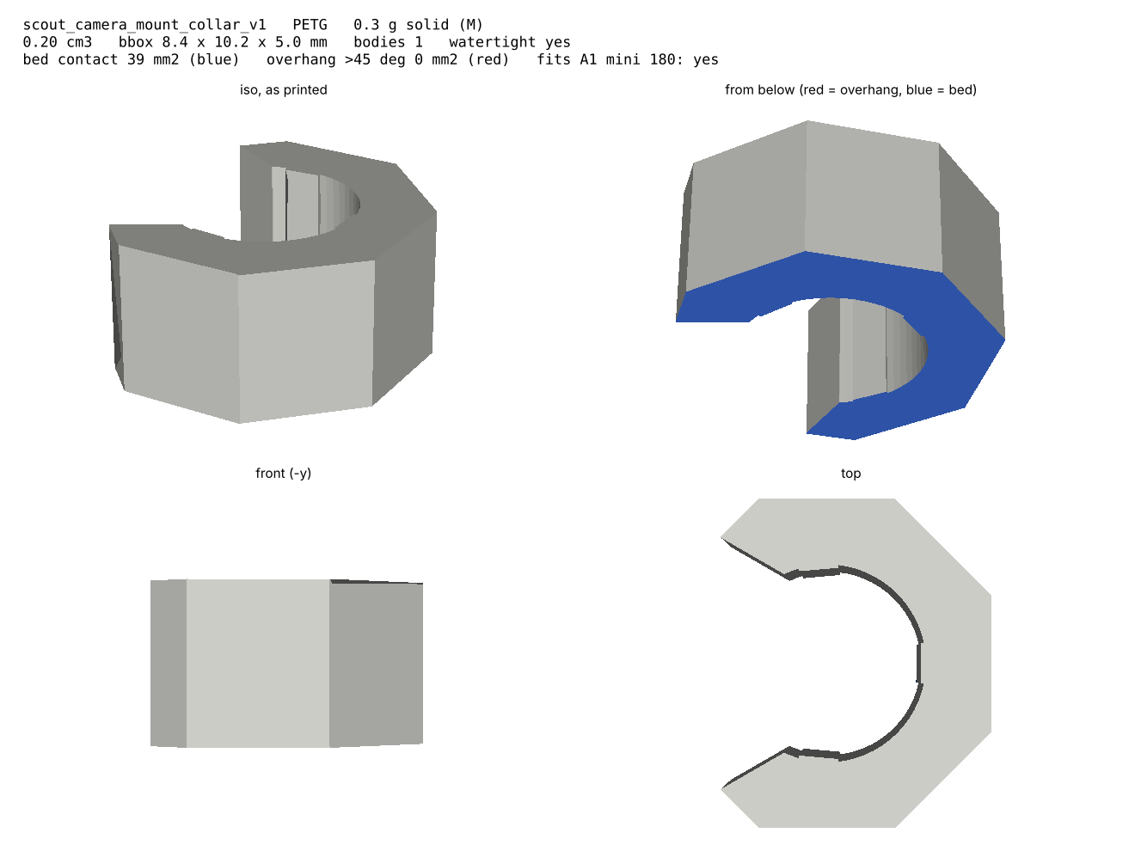
runs/scout_camera_mount/v1/preview_scout_camera_mount_collar_v1.png
