sparkiscool/nox/runs/scout_camera_mount/v1/still_closeup.png

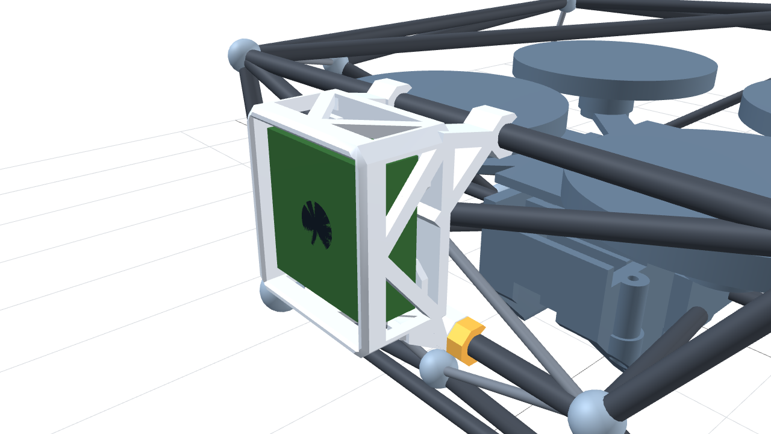
runs/scout_camera_mount/v1/still_closeup.png
