sparkiscool/nox/runs/scout_camera_mount/v1/still_inside.png

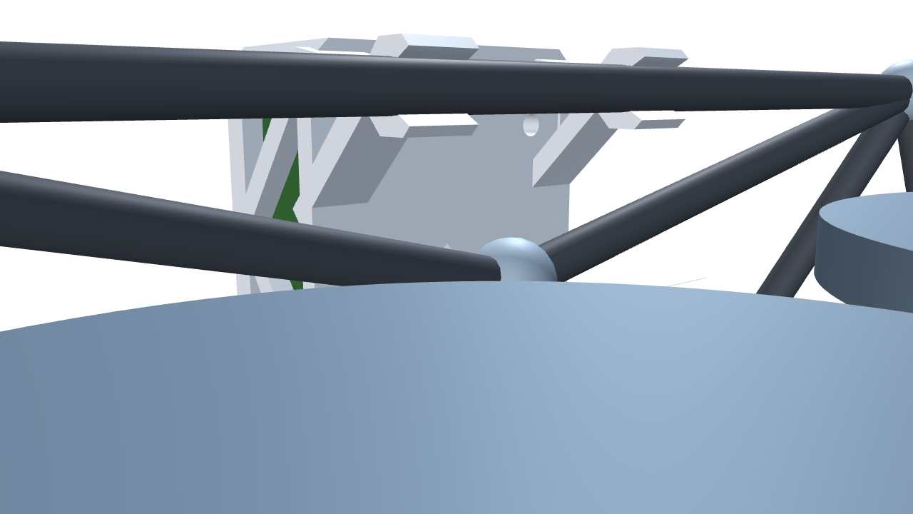
runs/scout_camera_mount/v1/still_inside.png
