sparkiscool/nox/runs/scout_camera_mount/v1/still_side.png

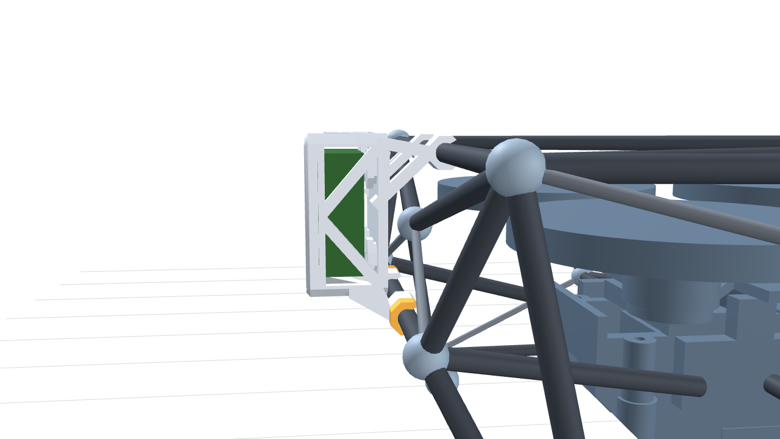
runs/scout_camera_mount/v1/still_side.png
