sparkiscool/nox/runs/scout_electronics/v2/preview.png

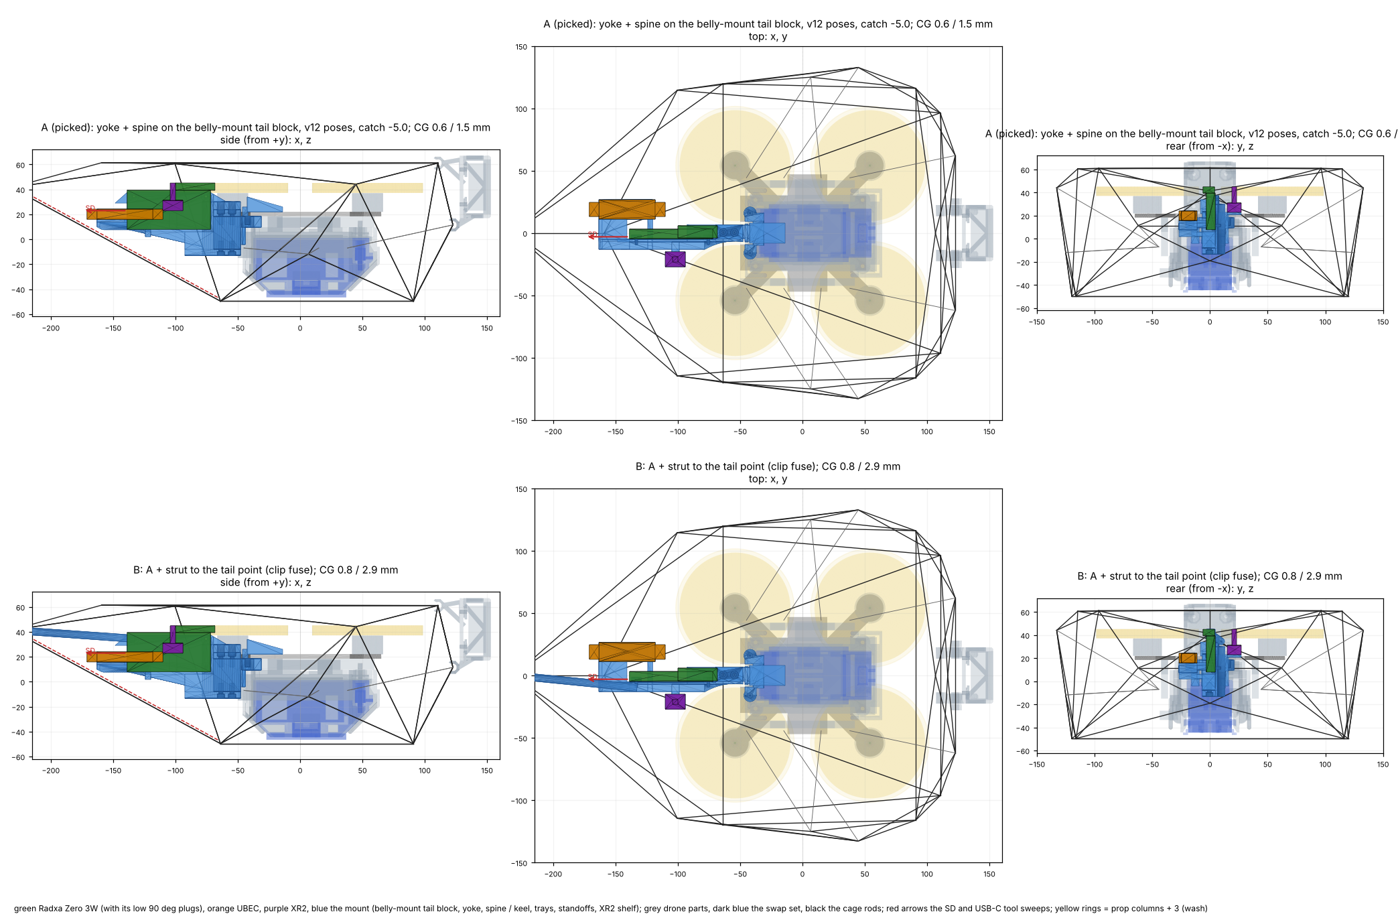
runs/scout_electronics/v2/preview.png
