sparkiscool/nox/runs/scout_layout/v13/preview.png

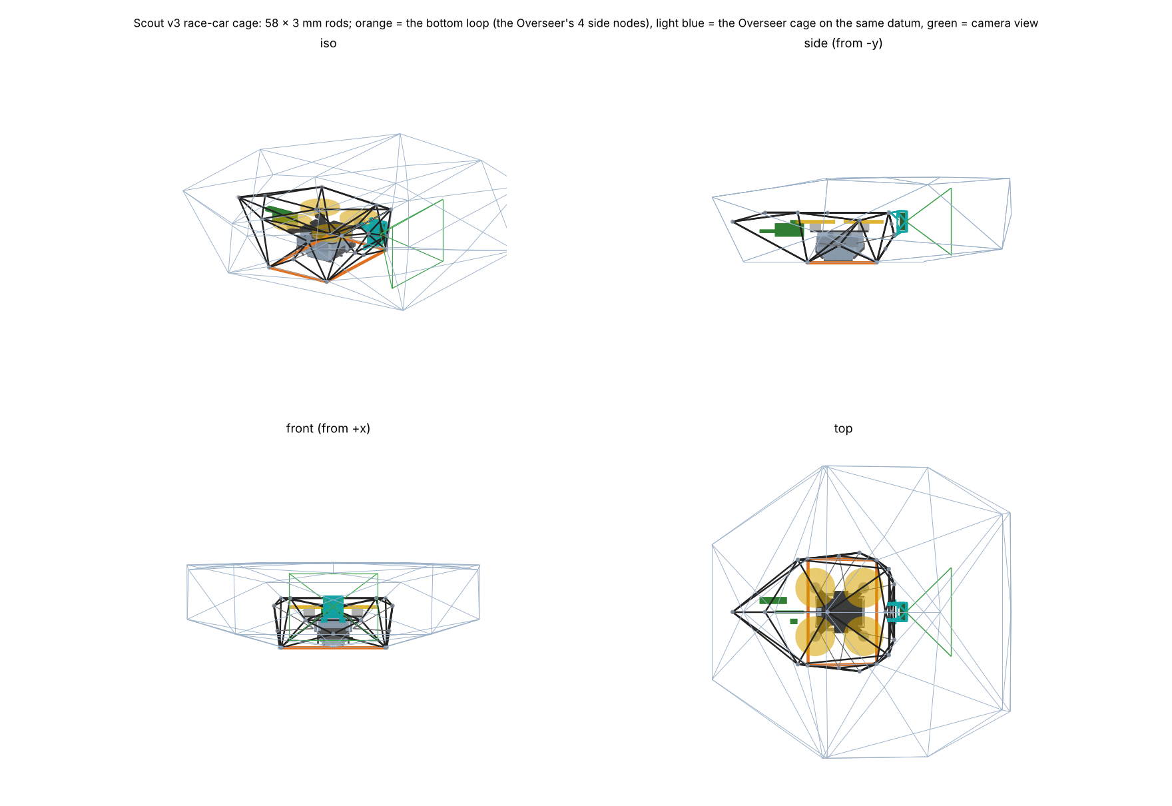
runs/scout_layout/v13/preview.png
