sparkiscool/nox/nox/current-parts.md

# Current parts

One row per part, its state only here. Numbers: `nox/dimensions.md`. History: `nox/log.md`. Pull right before writing, change only your own rows, one cell per fact, no history in a cell (≤ 600 chars; `python3 tools/check_state.py` flags longer ones).

States: DESIGN · BUILT (passes the checks, no file) · READY (file committed in `print/`, the only proof) · PRINTING · PRINTED · TESTED · FAILED · HOLD · ON HAND. The design session moves to BUILT / READY, the print session to PRINTING, Spark's report to PRINTED / TESTED / FAILED. Every file in `print/` was run through `solid_check.py` on 23 Oct; the results are in the rows.

## Box
| Part | Doc / scripts | Version | State | File (`print/`) | g | Next (owner) |
|---|---|---|---|---|---|---|
| Funnel panels A + B | `box/box-funnel.md`; `box/catch_v4/funnel_panel_v9.py` (v9 plain), `funnel_panel_v7.py` (v7, `--v8`), `panel_opt_v7.py`, `opening_sets.py`, `probe_motion.py`; `runs/funnel_panel/v7/`, `runs/funnel_panel/v9_plain/` | v7 (seated faces ±y: latch windows, bosses); v9 plain (24 Oct, ±x: v8 plain + 2 keep-alive probes per A panel, arm notch on −x) | v7 **HOLD**; v9 plain **HOLD** (superseded 27 Oct) (+ 2 probe caps); v8 plain, v7 plain DESIGN, superseded; v6 PRINTED 3 of 8, fails solid_check; superseded, no reprint | `box_funnel_panel_A_v7.stl` (x2), `box_funnel_panel_B_v7.stl` (x2), `box_funnel_panel_A_v9_plain_px.stl`, `box_funnel_panel_B_v9_plain_px.stl`, `box_funnel_panel_A_v9_plain_nx.stl`, `box_funnel_panel_B_v9_plain_nx.stl`, `box_funnel_probe_cap_v9_plain.stl` (x2) | v7 80.0 / 79.9, v9 plain A 60.3 / B 53.7, cap 0.8 (M) | **Superseded (27 Oct) by concept F, the push-bar catch (PR 125, `runs/box_catch/bars_concept/summary.md`): flat deck, no funnel, no hook latch; do not print.** History: v9 plain solid_check PASS x5, FE 0.79 / 0.80 (C), arm lane 2.0 off; probe pins, springs and leads no longer to buy |
| Funnel hub + corner blocks | `box/box-funnel.md` | hub v4, blocks v4 | **HOLD** (superseded 27 Oct) | none | | **Superseded (27 Oct) by concept F, the push-bar catch (PR 125, `runs/box_catch/bars_concept/summary.md`): flat deck, no funnel, no hook latch; do not print.** History: hub opening and foot-frame window were to be sized to the cartridge + 2 per side (56.3 square and 37 vs ~80 x 45 E) |
| Swap arm set: stub, sun post | `box/box-arm.md` Stub v3; `arm_cad.stub()`, `export_hub_set.py` | stub v3 (printed mast post, 4 x M5 x 12 ISO 7380), sun post v1 | **DESIGN** (stub v3: the measured mount tilts 15.1 mrad > the v7 limit 10; sun post v1 unchanged) | `box_stub_v3.stl`, `box_sun_post_v1.stl` (do not print until the recheck passes) | 47.7 / 30.4 (C) | solid_check PASS (23 Oct). Recheck with box structure v2's mast: stub tilt ≤ 10 mrad at a 60 N insert (dimensions System box swap: arm); READY again when it passes |
| Swap arm idler ends A / B, fingers (v4 heads) | `box/box-arm.md` (superseded sections); `export_hub_set.py` | idlers v3, fingers v4 (x4) | **HOLD** (superseded: v6 / v7 have rack and pinion, heads v7 regenerate the fingers to the latch's grabber interface) | `box_idler_end_A_v3.stl`, `box_idler_end_B_v3.stl`, `box_finger_{A,B}_for_head_{A,B}_v4.stl` (do not print) | 9.2 / 11.4 / 4.9 / 3.9 (C) | none: kept for history (printed 18 Oct small set) |
| Swap arm hub, detent ring + arm, pinion | `box/box-arm.md`; `arm_run_hub.py`, `post_hub_v5.py`, `detent.py` | hub v5, detent v1, pinion v4 (x2) | **DESIGN** (solid_check FAIL, 23 Oct; superseded) | `box_hub_v5.stl`, `box_detent_ring_v1.stl`, `box_detent_arm_v1.stl`, `box_pinion_v4.stl` (do not print) | hub 214.2 (M); 5.0 / 2.4 / 0.6 (C) | Superseded by the v6 system pass (rows below): hub v6, detent ring v3, pinion16 v2. Kept for history |
| Swap arm v7 system (both packs, 9 bays; hub v7, heads v7, detent) | `box/box-arm.md` v7 system pass; `box/swap_system.py`, `arm_v7_layout.py`, `arm_v7_cad.py`, `head_v7_concept.py`, `detent_v6.py`, `hub_v6.py`, `hub_v6_topo.py`; `box/box_swap_arm.assembly.json`; `runs/arm/v7/`; dimensions System box swap: arm | v7 round 3d (Y_C 167.1 for latch v4 on main, was 165 with latch 258becf; low carriage stack, rail v4 keel, 5:1 axle, detent v6 x1.3, pinion v3, heads v7 grabber concept) | **DESIGN** (concept check PASS, review round 4; piece pass running) | none | | Hub v7 done (PR 111: solid PASS, 213.3 g M, swap 0.524 F = hub v7 strike 1); grip line Y_C 167.1 for latch v4's receiver v2 (PR 116, the latch keeps its capture). Next: the hub v7 corner check, then heads v7 pieces and READY. XT60 per axis: x 1.28° / ±2.37, z 0.85° / ±1.06 (F); sweeps 0 overlaps, fit 0.0 mm³, access 9/9 (C / M) |
| Swap arm pieces: pinion16 v3, detent ring v4, detent arm v3 | `box/box-arm.md` v7; `box/arm_v7_cad.py`, `detent_v6.py`, `detent.py`; `runs/arm_pinion16/v3/`, `runs/detent/v6/` | pinion16 v3 (x2), detent ring v4, detent arm v3 (623ZZ roller) | **DESIGN** (v7 piece pass; assembled recheck with hub v7 passed at Y_C 167.1, PR 116) | none (meshes in `runs/arm_pinion16/v3/`, `runs/detent/v6/`) | 3.7 / 8.7 / 3.3 (M) | solid_check PASS on all three; pinion v3 face 13.5 (0.45 / 0.49 at the drone insert); detent v6 hold 1.065 N·m, rim index 0.45, arm 0.16. READY after the assembled recheck with hub v7 (grip line Y_C 167.1, PR 116); pinion v2, ring v3, arm v2 superseded |
| Swap arm V-wheels, eccentric bushes | `box/box-arm.md` v7; `box/arm_v5_cad.py`; `runs/arm_vwheel/v1/`, `runs/arm_eccbush/v1/` | vwheel v1 (x6), eccbush v1 (x2) | **DESIGN** | `box_arm_vwheel_v1.stl`, `box_arm_eccbush_v1.stl` (do not print) | 2.8 / 0.8 (M) | v7 round 3d (Y_C 167.1): the power cut carrying reads 625ZZ 1.34 (Scout) / 2.80 (Overseer) without the head brake, so the brake is required for both; the low stack puts the eccentric flange flush in the plate. Do not print until the brake passes its bench drop and the heads v7 piece pass (session_01CN2CVH9uV21E2RDEbEipvG) rechecks them |
| Swap arm rails A / B | `box/box-arm.md` v7; `box/arm_v7_cad.py`; `runs/arm_rail/v5/` (v4: `runs/arm_rail/v4/`, narrow channel, superseded; v3 round 2, superseded) | rail A v5, rail B v5 (low stack, keel Y 38..54 from r 89, tie sockets in the keel, 6.5 ribbon channel, M5 x 10 heads under its floor) | **DESIGN** | v5 meshes in `runs/arm_rail/v5/` (not in print/); v1 files do not print | 56.5 / 56.5 (M) | solid_check PASS; tie rods 2.3 mm³ at the socket mouths (C); inner step and park stop from r 27.5. READY after the assembled recheck with hub v7 (grip line Y_C 167.1, PR 116); the hub plate edge at r 88 and wheel lanes at Y 53 are in hub v7 |
| Swap arm heads A / B | `box/box-arm.md`; `belt_clamp_v2_head.py`, `head_reinforce.py`, `post_v4.py` | v5; v5b pending (bought belt connector's bolt pad replaces the loop-and-pin clamp) | **HOLD** (superseded by heads v7) | none | A 56.1, B 55.5 (M) | Superseded by heads v7 (rack and pinion on the v7 carriage, `part/heads-v7`); no belt connector, so no measurement needed (Spark 24 Oct) |
| Hook latch: housing A / B, plunger | `box/box-hook-latch.md`; `box/hook_latch.py`; system `box/catch_system.py`; `runs/hook_latch/v2/` | v2 (24 Oct: on the panel v7 skin 2.0; v1 files stay in `print/`, do not print) | **HOLD** (superseded 27 Oct) | `box_hook_latch_housing_A_v2.stl` (x2), `box_hook_latch_housing_B_v2.stl` (x2), `box_hook_latch_plunger_A_v2.stl` (x2), `box_hook_latch_plunger_B_v2.stl` (x2) | 23.7 / 23.7 / 3.9 (M); set 110.3 | **Superseded 27 Oct by concept F, the push-bar catch (PR 125, `runs/box_catch/bars_concept/summary.md`): flat deck, no hook latch; do not print.** Kept for history: v2 sat on the panel v7 skin with 4 MG90S; system v9 plain `runs/box_catch/v9_plain/` (head stall 74 N, hand lift 100 N, probes ≤ 1 N). |
| Box electronics (power, Pi I/O, SKR, keep-alive, live bays, swap state machine) | `box/box-electronics.md`, `box/box-wiring.md`; `box/box_electronics.py`; `runs/box_electronics/v1/` | v1 (24 Oct) | **DESIGN** (docs; no printed part) | none | | Designed: LRS-350-24 on the rear sheet, fuse box, E-stop on the motion branch, keep-alive 13.0 V CC 3.0 A (K1, INA226) to the ±x face pins, 6.0 V servo rail, Pi 4 + PCA9685 + 3 INA226, SKR (Klipper), live bays on a dual-channel charger, budget 296 W peak (E); **brake: 3 DPDT relays short each head / axle coil when unpowered, boot self-test (required by the arm)**. Spark: buy the electronics rows (`parts-list.md`), CHECK the charger's MODBUS map and non-balance mode. Then bench-wire, power with no loads, the brake bench drop; at commissioning the per-bay axle offset and sag check |
| Belt clamp coupon set | `box/belt_clamp_v2.py` | v2 | **HOLD** | `belt_clamp_coupon_set_v2.stl` | 11.6 (M) | Nothing unless the connector route fails. The file is 3 loose coupons, so solid_check reads 3 bodies (FAIL); split it into 3 files before any print |
| Battery latch, Scout set: cartridge v7 + TPU end skids v2 (x2) + TPU strips v1 (x2), sliders v6 (x2), receiver block v3 + XT60 carrier v2 + cap (lid v2) + TPU strips v1 (x2) + TPU nose v2 / tail v1 end pieces (drone receiver only) | `box/battery-latch.md`; `box/battery_latch.py`, `battery_latch_topo.py`; `runs/battery_latch/v4/` | cartridge v7, skids v2, slider v6, receiver v3, carrier v2 | **HOLD** (do not print) | none (files in `runs/battery_latch/v4/stl/`) | 165.3 (M) per drone set, 157.1 per bay set; build 6 sets (5 bays + drone) | Receiver v3: head flats at y 24.5, bolts at drone (−42.65 / 43.25, ±26.55) (M3 x 35, DEFAULT), narrowed to drone \|y\| 25.5 under the Scout's keel; swap worst 0.413. Cartridge v6 centre rib (heads v7). TPU end pieces ≥ 1.21 inside the funnel. solid_check PASS on all 11. HOLD until the Scout's own pass (keel back, new bolt pattern) reads fit 0 and probes PASS on run v4 (Scout chat) |
| Battery latch, Overseer set: cartridge v6, sliders v6 (x2), receiver block v2 + XT60 carrier v1 + cap (lid v1) + TPU strips v1 (x2) | `box/battery-latch.md`; `box/battery_latch.py`; `runs/battery_latch/v4/stl/` | cartridge v6, slider v6, receiver v2 (66.8 wide), carrier v1 | **DESIGN** | none (do not print: files in `runs/battery_latch/v4/stl/`) | 338.5 (M) per set; build 5 sets | Receiver v2: swap worst 0.55, 43.5 N across 0.78 mm; solid_check PASS on all 6. Open: mount bolts pass the cartridge rail zone (from above or 76.2 wide, Overseer / box sessions), sled cut round v2, funnel v8 (≥ 190.7) |
| Box structure v2 (system layout) | `nox/dimensions.md` System box structure (v2 layout); `box/box_layout_v2.py`; `runs/box_system/v2/` | v2 layout (24 Oct) | **DESIGN** | none | | 9 bays at R 113 (C), Overseer at 0 / −60 / −120 / −180 alternating with Scout (DEFAULT), Y_C 167.1 (C), enclosure 418 x 409 x 470 (C) with room for funnel v8; access 18/18 (M). Fit 0.0 mm³ with the catch on main (the lanes clear by 2.0, C on M). Topology round 2 (PR 105): 3000 cm³ stands on the floor alone, stub tilt 0.41 mrad, bay rotation 1.8 / 2.6 mrad (M). Next: the cut + system FE (worker), then the piece runs |
| Bay modules | `box/box-case.md`; `box/models/box_baymod_v4i_W.obj`; system `box/box_system.py` | v4i (x2) | **DESIGN** (solid_check FAIL 23 Oct; system FAIL 24 Oct) | `box_baymod_v4i.stl` (do not print) | 83.4 (M) each | System v1 (`runs/box_system/v1/summary.md`): assembled worst 0.55 (F) in the Overseer catch at −60 (target 0.5, DEFAULT); cradle seat 0.15 mm³ (M); the −90 module cannot slide out past cradle_keel (75 mm³, E). Next: box structure v2 system pass (Spark 24 Oct: 9 bays, 4 Overseer + 5 Scout; arm v6 asks R 113 (C), Overseer modules 172 long (C)), then Scout v5 / Overseer v1 / end-bay modules from its requirements (battery latch receiver PR 69 as the drawn seat, XT60 float carrier) |
| Box stand base: mast, kb, cradle_keel, toe | `box/box-stand.md`; `stand/stand_v6_parts.py`, `stand_v7_parts.py`; system `box/box_system.py` | mast v6, cradle_keel v6, kb v7b, toe v7b | **DESIGN** (system FAIL 24 Oct) | `box_mast_v6.stl`, `box_cradle_keel_v6.stl`, `box_kb_v7b.stl`, `box_toe_v7b.stl` (do not print) | 99.1 + 70.1 + 115.0 + 52.7 (M) | System v1 (`runs/box_system/v1/summary.md`): mast 0.59, cradle_keel 0.60, kb 1.08 and 3.77 misuse, toe 0.08 (all F, cases in `dimensions.md` System box structure); the toe's plate moves with the front sheet (Y 347, DEFAULT); stub tilt 15.1 mrad (F) at the insert, need ≤ 5 (DEFAULT). Solid PASS on all 4 (23 Oct). Next: new versions from the box structure v2 requirements (`dimensions.md` System box structure) |
| Cross bar bar_half (x2) | `box/box-stand.md`; `stand_v7_topo.py` + `_build.py`, `stand_v8_bar_export.py` | v8 (topology) | **HOLD** (system v1 PASS; the v2 layout moves the side sheets) | `box_bar_half_v8.stl` (x2) | 77.6 (M) each | System v1 (`runs/box_system/v1/summary.md`): assembled worst 0.35 (F) in the XT60 insert at the drone (own FE 0.38, F), fit 0.0 mm³ (M; system_check reads 0.2 mm³ E vs cradle_keel on its voxel fallback). Solid PASS. Hold printing until the box structure v2 layout confirms its tip at the side sheet (R 113 widens the box) |
| Ring frames: frame_mid x5, frame_endR, frame_endL | `box/box-case.md`, `box-stand.md`; `stand_v6_parts.frame()`, `stand_v7_parts.frame_end()` | mid v6; ends v7b | **DESIGN** (system FAIL 24 Oct; retired as ring pieces) | `box_frame_mid_v6.stl`, `box_frame_endR_v7b.stl`, `box_frame_endL_v7b.stl` (do not print) | 47.6 x5, 89.2, 88.7 (M) | System v1 (`runs/box_system/v1/summary.md`): mid 1.60 / 1.49 (0° / −180°), endR 1.59, endL 1.65 (F) in the Overseer catch; +Y pads 320 mm³ (M) into panels v7. Spark 24 Oct: every slot is a bay, so no frame gets a new version; the end-bay modules take the pads and end-bracket blocks (v2) |
| Enclosure: 12 post segments, brackets jB x2, e x2, 4 clear sheets | `box/box-stand.md`; `stand_v7_parts.py`, `stand_v7e.py` | post v7; jB v7; e v7c | **HOLD** (system v1 PASS; v2 moves the sheets); sheets: do not cut | `box_post_seg_v7.stl` (x12), `box_bracket_jB_v7.stl` (x2), `box_bracket_e_v7c.stl` (x2) | posts 510; jB 46.0, e 219.6 (M) | System v1 (`runs/box_system/v1/summary.md`): post 0.16, jB 0.33, e 0.24, sheets 0.47 misuse (F); fit 0 mm³ among pieces (M). Front sheet vs panels v7 9.8 cm³ (M, FAIL): inner face to Y 347, top to Z 220 (decisions 1, 2, DEFAULT), so the v7 posts (3 x 147, C) do not match until v2; print nothing and cut no sheet before the v2 layout (R 113 widens the box) |
| Bracket jA (x2) | `box/box-stand.md`; `stand_v7_topo.py` | v8 (topology) | **DESIGN** (system FAIL 24 Oct) | `box_bracket_jA_v8.stl` (do not print) | 38.4 (M) each | System v1 (`runs/box_system/v1/summary.md`): assembled worst 0.62 (F) in the Overseer catch at 165° (target 0.5, DEFAULT; own FE 0.05, F); 307 N (F) from the side sheet. Next: new version from the v2 requirements |

## Scout v3
| Part | Doc / scripts | Version | State | File (`print/`) | g | Next (owner) |
|---|---|---|---|---|---|---|
| Scout v3 (scope) | `scout/v3/README.md`; aircraft `scout/scout.md` | v3 | **DESIGN** | none | | Brief filled 23 Oct, Spark's answers in (XT60 back, no weight target, ~500 g, flies in Position). First part: bottom layout with the XT60. Carry-overs to settle in v3: bottom layout (pack, latch pockets, contacts, belly plate, pogo pads; v2 drew it in `archive/scout-v2/s2-receiver.md`); holder group budget (P once drawn); props on top at z ≈ +41.2, `dimensions.md` H rows that say "below the props" are stale; every rod 3.0 (socket bore from the coupon test); a snap-on cover for spare packs' live pads |
| Scout v3 layout + cage | `scout/v3/README.md`; `scout/v3/layout_v3.py`, `layout_v3_view.py`; `runs/scout_layout/v13/summary.md`; dimensions System Scout v3 | layout v3 / cage v2 (race-car), v13 | **DESIGN** (concept; system_check PASS) | none | 912 all-up (E) | 28 Oct: v13 re-trims the catch for the real node mass (nodes v2 192 g M vs 39 assumed): catch 2.5 aft, 58 x 3 mm rods on 19 nodes, CG 0.7 / 0.7 (E); camera mount v1 in for mass and pose only (its 6.2 clips don't grip 3.0 rods). Spark 27 Oct: every rod 3.0, FC on top, camera mount v2 by topology. Next: nodes rerun on v13 (PR 166), electronics redraw on the new catch, camera mount v2; each saved piece into the assembly and the artifact as its CAD |
| Scout camera mount | `scout/v3/camera_mount.py` (+ `_view.py`, `_sheet.py`); `runs/scout_camera_mount/v1/summary.md`; dimensions System Scout v3 Camera | v1 (one piece: cradle, lens hood, truss arms, 4 snap clips on the 6/4 tubes 7-8 / 14-15) | **READY** (solid_check PASS x2) | `scout_camera_mount_v1.stl`, `scout_camera_mount_collar_v1.stl` (x2) | 21.8 + 2 x 0.25 (M) | Hood 4.0 (C) ahead of the lens, nothing in view, 109.3 Hz (F). Bore 6.2 holds only if the 6/4 DEFAULT stands; SCM_ROD=3 otherwise. Print one, try the snap on a 6/4 offcut (snap 0.20, grip 0.05 E). Spark: A or B (bolted clips) |
| Scout v3 electronics mount (tail carrier + belly-mount tail block) | `scout/v3/README.md` Electronics mount; `scout/v3/electronics_system.py`; `runs/scout_electronics/v2/` (summary.md, result.json, envelope.json, preview.png); dimensions System Scout v3 (Electronics tail bay (mount v2 on v12)) | v2 round 5: mount on v12's poses, variant V8 (concept) | **DESIGN** (concept, to review) | `runs/scout_electronics/v2/*.stl` (concept, solid_check PASS) | 49.2 mount (E) | 27 Oct: round 4 review fixed: no overlap, fit table 33/33 with no allowances (C), XR2 floor z 21 (C); sized on L: crash worst 0.27 (E), flight / landing ≤ 0.02 (E), cage first order holds vs the worst rod (0.27 ≤ 0.59 / 1.5, E; node index open); CG 0.56 / 1.49 at −5.0 (C, PASS); system_check PASS. Open: yoke / block order in pure ±x (≤ 0.07, E), belly mount tail face x −31.0 (req). Next: concept review, piece passes |
| Scout v3 belly mount (FC frame, receiver partner, flow bipod) | `scout/v3/belly_mount.py`; `runs/scout_belly_mount/v1/` (summary.md, result.json, preview.png, preview_alternatives.png); dimensions System Scout v3 (Belly mount (concept v1)) | v1 round 2 (concept) | **DESIGN** (concept, to re-review) | `runs/scout_belly_mount/v1/belly_mount__petg_.stl` (concept, solid_check PASS) | 25.0 (E) | 27 Oct round 2: 2 yokes between plate and receiver, nothing beside the FC (ESC vents 641 mm²), flow on a bipod, options drawn; receiver 4 M3 inserts, 4 new plate M3; L crash worst 0.23 E (inserts 600 N, prying 3.3x); system_check PASS, CG 0.2 / 2.2 C. Open (Spark): FC A as built + soft-mount req (rib ≤ 6.5) or B on the plate top; flow clear-air method. Next: re-review, piece pass |
| Frame plate | dimensions C | Bee35 carbon 3.5, cut down | **ON HAND** | n/a | 24 to 32 (E) | Weigh (P) |

## Overseer
| Part | Doc / scripts | Version | State | File (`print/`) | g | Next (owner) |
|---|---|---|---|---|---|---|
| Overseer (scope) | `overseer/README.md`; hardware `dimensions.md` O | | **DESIGN** | none | | Brief filled 23 Oct, Spark's answers in (generic S500, printed shorter arms, camera 30° up, flies in Position). First parts: arms, lidar + front camera mount. Tune backup `claude/overseer_params_2026-09-26.params`, never delete |
| Lidar mount | not started; lidar `dimensions.md` M (Unitree L2) and O | | **DESIGN** | none | | Generate with `nox/topo` on `main` (the default engine, organic finish; `docs/generative.md`), never `noxopt`. Before READY, check the run used the newest `nox/topo` on `main`; if the engine changed after the run, rerun |
| Overseer cage | `overseer/cage_equal.py` (reduce, merge) + `overseer/layout_v5.py`; `dimensions.md` O Cage v5; method `docs/generative.md` rule 0 Geodesic cage | v5c (27 Oct: 3-rod head; base loop z -79.9; v3 halved) | **DESIGN** | `runs/overseer_layout/v5/motion.html` | ~622 (E: shell 497 + links 125) | Spark 27 Oct: half the tubes, small triangles merged. 24 nodes, 63 tubes, loop 6 nodes at z -79.9 (core cartridge bottom - 3), TPU foot caps under them; frame: 25 of 31 links 6/4, worst link 0.70, worst tube 1.49 (F, reported); system_check PASS (cage first 9.6, access all clear; the arm v8 third screw checked when it and core v4 merge). Nodes: saved v5 (row Overseer cage nodes, 289.4 g M). Next: nodes; funnel. |
| Overseer cage nodes | `overseer/cage_node.py <n> --drawn` + `overseer/cage_nodes_save.py`; `runs/cage_nodes/v5/summary.md` | v5 (28 Oct: drawn first, 2.0 walls; v4 2.5 walls 345 g) | **READY** | `print/overseer_cage_node_{0,1,2,3,4,5,6,7,8,9,10,11,12,13,14,15,16,17,18,19,20,21,22,23}_v5.stl` | 289.4 (M, 24 nodes) | 24 PETG nodes (9 mirror files), each solid_check PASS, worst index 0.252 on the frame loads (F); socket mouth on the bed, 5 mm brim, tree supports. Next: print (Spark), epoxy the 6/4 tubes and 3.0 rods. |
| Overseer sensor head mount | `overseer/head_mount.py head` (one piece); requirements `runs/overseer_layout/v5/head_system.json`; `dimensions.md` O Lidar, Camera | v5 (27 Oct, 3 rods) | **DESIGN** | none yet | 143.7 (E, v4 M) | Spark 27 Oct: the L2 and both cameras on one PETG print, on 3 rods to the cage (max 3; no ring, braces, keels or struts): 128.4 Hz on PETG joints (F on E); drawn only the bolt and insert bosses and 3 sockets (21.6 g C). v3: solid FAIL (socket-rim specks); v4 (run/head_mount-v4): 143.7 g M, worst 1.06, solid FAIL (8 specks at the socket floors: the boss ended on the bore floor); fixed: a 3.0 floor behind each socket; Spark: v4 flimsy, the ring does nothing: back to the system pass. Next: v5 sizing sweep (h 4, gen 25/40/60) in the run session, then the fine run. |
| Rod socket coupons | `overseer/rod_coupons.py v2`; `runs/rod_coupons/v2/summary.md` (v1 `runs/rod_coupons/v1/`) | v2 (27 Oct) | **DONE** (picked) | `print/rod_coupon_6mm_v2.stl`, `print/rod_coupon_3mm_v2.stl` | 16.0 + 7.8 (M, PETG) | Spark 27 Oct: v1 loose in PETG; v2 printed (Gideon): the largest fits, standing and sideways, so every socket bore is 6.2 (6 mm tube) / 3.2 (3 mm rod) |
| Overseer layout | `overseer/layout_v5.py` + `layout_v5_view.py` (v0..v4 kept) | v5c (27 Oct: 3-rod head, no ring, keels or braces) | **DESIGN** | `runs/overseer_layout/v5/motion.html` | ~3226 (E) | v2 as designed (L2 nose, motors forward, catch 30 aft), 2 cameras on the one-piece head outside the disk cage; motors ~67 ahead. T/W 2.04 (E): Spark to weigh. Link ends: arm nodes; the head on 3 rods to the cage (no braces or keels); frame: rear arm node 1932 N (F); core parts (hub deck v9) in the assembly; the body tie roots (front, rear y ±12, side, bay) parked (Spark 27 Oct). Next: rebalance once the head v5 saves. |
| Overseer core (system pass) | `overseer/core_v4.py` (v3 `core_v3.py` + `core_v3_view.py`, v2 `core_v2.py`, v1 `core_v1.py`); `dimensions.md` System Overseer core; assembly `overseer/overseer_core.assembly.json` | v4 (27 Oct, no head load: the cage hangs the L2 on 3 rods to its nodes) | **DESIGN** | `runs/overseer_core/v4/preview.png`, artifact https://claude.ai/artifact/JSamk2HosoRiVZgo3KHBH3 | ~3223 drone (E) | Spark 27 Oct: everything inside the cage but the arms and the nodes; battery side an empty slot (no sled). 2 pieces: hub deck + flow clip; 6 M3 up into inserts; RX 6 to +y off arm 2's top screw. Context: main with the cage's head rods (PR 165); hub deck v12 READY, flow clip READY; body tie roots parked (Spark) |
| Overseer hub deck | `overseer/core_topo_v4.py hub_deck` (v9..v11 `core_topo_v3.py`); `runs/overseer_hub_deck/v12/summary.md`; `dimensions.md` System Overseer core | v12 (27 Oct, core v4: no head load; v9 tower superseded, v10 audit FAIL, v11 lost, v11b stopped) | **READY** | `overseer_hub_deck_v12.stl` | 37.1 (M) | solid_check PASS; worst 0.17; first mode 432 Hz; FE bolts <= 11.4 N; plate face down, tree supports; assembled recheck on main PASS (fit 0, access 39/39) |
| Overseer flow clip | `overseer/core_coupons_v2.py`; `dimensions.md` System Overseer core | v1 (27 Oct, drawn) | **READY** | `overseer_flow_clip_v1.stl` | 5.0 (M) | solid_check PASS; MTF-02P under the front wing, 3.0 flange under the deck's 2 front M3 x 10; floor down; its fit waits on the cage moving its parked front tie node (28 mm³; fallback: the sensor turned 90° at x 92) |
| Overseer core mounting coupons | `overseer/core_coupons_v1.py` (v1), `overseer/core_coupons_v2.py` (v2); `runs/overseer_core_coupons/` | v1 hub deck (27 Oct); v2 keel hub superseded (core v4: no keels); the v1 sled coupon superseded (no sled in core v2) | **READY** (v1 only) | `overseer_core_coupon_hub_deck_v1.stl` (`overseer_core_coupon_keel_hub_v2.stl`, `overseer_core_coupon_sled_v1.stl`: superseded, do not print) | 16.0 / 13.0 (M) | solid_check PASS on each. v1 checks the plate holes, Pi posts and clearance; v2 the 4 front holes, inserts and a 6 mm tube in each keel socket |
| Overseer arms (printed, x4) | `overseer/arms.md`; `overseer/arm_topo_v5d.py` (chain to `arm_topo_v1.py`), `arm_rebuild_v5c.py`, `arm_strength_band.py`; `dimensions.md` System Overseer: arms; `runs/overseer_arm_rear/v5d/summary.md`, `runs/overseer_arm_front/v5d/` | v5d (6/4 carbon tube chords with sleeves, cage spoke node, no brace sockets; cage arm_loads) | **rear HOLD** (v5d: solid PASS; assembled CG 5.8 mm, gate 3: reruns after the layout rebalance), front DESIGN (v6) | rear: `print/overseer_arm_rear_v5d.stl`, `print/overseer_arm_rear_v5d_mirror.stl` | rear 187 (M) + tubes | Rear: DO NOT PRINT (HOLD until the layout rebalance and rerun). Solid PASS, modes 435 Hz, cage crash 0.94 at the top plate corner (joint, assumed), 0.77 in the arm (target 0.5: reported). Front v5d (228 g, strength 0.62, solid PASS) misses the mode target (131 Hz vertical / 162 lateral vs 190): third front strike, back to the system pass (carbon space frame: 4 x 6/4 chords + 12 x 3.0 diagonals, what-if 193..200 Hz). |
| Scan stick head | `nox/overseer/scan_stick/scan_stick.md`, `head_topo_v8.py` (nox/topo layout) + `head_topo_v13.py` (rebuild: cable hole, Ø6.0 counterbores, camera block with its holes at z 6, key holes) | v13 (23 Oct; v1-v12 retired, runs in `runs/scan_stick/`) | **READY** | `print/scan_stick_head_v13.stl` | 42.0 (M) | print after the base, bolt on turned -90° (camera over the Pi), M4s in sideways + 3 mm key from the top; camera lens / board thickness (Q3) |
| Scan stick thread test | `nox/overseer/scan_stick/scan_stick.scad` (part thread_test; `thread_cut.scad` exports the thread the base cuts) | v1 | **READY** | `print/scan_stick_thread_test_v1.stl` | 8.3 (M) | print first, screw on the pole, tune `acme_clear` |
| Scan stick cam bracket | `nox/overseer/scan_stick/scan_stick.md`, `cam_topo_v7.py` (nox/topo) | v7 (topology, 24 Oct: 10 mm standoffs, M2.5 inserts, 6 mm plate; v1 drawn retired, v2 / v3 FAILED the gate, v4 4 mm posts superseded, v5 web wrapped the posts, v6 stopped) | **READY** | `print/scan_stick_cam_v7.stl` | 13.35 (M) | 2x M3 x 12 to the head, 4x M2.5 x 6 for the camera; camera lens / board thickness (Q3) |
| Scan stick base | `nox/overseer/scan_stick/scan_stick.md`, `base_topo_v7.py` (nox/topo layout) + `base_topo_v17.py` (rebuild: exact cuts, Ø40 boss, Pi tray, UBEC bay, switch strip beside the tube) | v17 (23 Oct; cradle v1 and base v2-v16 retired, runs in `runs/scan_stick_base/`) | **READY** | `print/scan_stick_base_v17.stl` | 340.1 (M) | print first (thread test ring before it), then the head; UBEC / buck bodies (Q4, bay 28 wide), pack mass (Q9) |

## System recheck (Spark 24 Oct: every READY, BUILT, HOLD and DESIGN part, `docs/generative.md` The rule, 0)
| System | Pieces (rows above) | System pass + recheck (owner) |
|---|---|---|
| Scout v3 | frame, every printed Scout part, where the receiver sits on the drone (pogo pads, KW11, underside stack) | Scout v3 chat |
| Overseer | layout, arms, cage, lidar mount, scan stick mount, where its receiver sits | Overseer arms chat |
| Scan stick | head, cam bracket, base, thread test | scan stick chat (its mount loads from the Overseer section) |
| Box top: the catch (concept F, PR 125: push bars on a flat deck; was funnel panels, hub + corner blocks, hook latch, superseded) | deck, end pads + sprung slide, carriage on T8 x 2 + NEMA 17, lever + pinion, side bars + lips; the Scout's side-rod sleeves | design center session_01EtHMZMB13ed4juqR8ktuXy (concept); the box catch session draws it when Spark starts design; master view https://claude.ai/artifact/RX2CexkfhB5UoQHnGTVgCC, 3D https://claude.ai/artifact/VyTyzuieTjrbBnURYPDgmG |
| Box swap (arm + battery latch) | arm set, hub / detent / pinion, arm v5 (hub, heads + grabber, detent, rails, wheels, pinions, bushes), heads A / B, belt clamp coupons; **battery latch and cartridge, one standard for every pack (Scout and Overseer): cartridge, receiver latch block used in the drone and in every bay, XT60 float carrier**; the grabber follows the latch | box master session_01EtHMZPwaEwEqxCkwFCWf7X (Spark 27 Oct: no design work yet; the arm and latch sessions were stopped and archived) |
| Box structure | stand, ring frames, enclosure, bay module bodies (the latch block from Box swap), the whole-box model (`box_system.py`, from `box_assembly.py`) the other box systems hang on; the top frame carries the landing's interface | box master session_01EtHMZPwaEwEqxCkwFCWf7X (Spark 27 Oct: no design work yet; the structure and electronics sessions were stopped and archived) |

## Tests
| Part | Doc / scripts | Version | State | File (`print/`) | g | Next (owner) |
|---|---|---|---|---|---|---|
| Strength calibration coupons: post pull, layer pull, glue lap, socket | `docs/tests.md`; `nox/tests/coupons.py`; `runs/test_*/`; numbers `dimensions.md` T | post pull v1 (x2: A 100 %, B 4 walls 15 % gyroid), layer pull v1, glue lap v1 (x12), socket coupon v2 | **HOLD** (Spark 24 Oct: use assumed numbers, no tests) | `test_post_pull_v1.stl`, `test_layer_pull_v1.stl`, `test_glue_lap_v1.stl`, `test_socket_coupon_v2.stl` | 34.6 / 28.6 / 3.9 / 7.9 (M) | Not planned. Files kept in `print/` for later; the assumed strengths and factor 1.0 (E) in `dimensions.md` T stand |

## Spark
Each line carries its best answer; a session that cannot wait takes it as DEFAULT.
- **Measure** (caliper, into `dimensions.md`): idler bore, slip-ring flange OD + holes, MG90S ear spacing, 80T body width.
- **On hand?** NEMA17 x3, MG90S x2 (hook latch needs 4), 1000 µF cap, INA226, a 10 A load; 3.0 carbon rod length (v2 cage needed 2.48 m C; decides whether to buy rod). Not recorded: Scout motor KV, spare packs, FC grommet size; Overseer S500 variant, ESCs, RC receiver; KW11 and pogo counts per bay, 5 V buck and relay models. Ordered 15 Oct, arrival not recorded: MG995 x2, GT2 80T pulley, GT2 belt 2 m.
- **Decide:** New funnel round the Overseer shell (box catch session; the Scout cage follows the same rule). drill 3 holes in the 80T pulley web [yes]; skid strips 3.0 proud instead of 2.5 [yes, before the first catch]; funnel size levers: measure hover scatter first [yes]. Arm v5 stack (`box/box-arm.md` v5): Y_C 175 with the sliced v4i modules (enclosure 403), Scout-length modules Y_C 138 (366), or also rails on the motor plate Y_C 118 (346) [Y_C 118 as the next module version; the v4i modules serve the demo at 175 until then].
- **Buy:** XT60 swap (23 Oct): 3 x XT60E1-M; hook latch: 4 x MG90S (or 2 if 2 are on hand) (`parts-list.md`); 4 x M5 x 12 ISO 7380 (stub); enclosure sheets and hardware (row above); 3.0 carbon rod only if short; SH1.0 4-pin pigtail and a 90° USB-C for the Scout.
- **Tests:** strength and XT60 force tests dropped (Spark 24 Oct: use assumed numbers; `docs/tests.md` kept for later). **Head brake bench drop (needed before the first Overseer swap): a head carrying an Overseer cartridge (~930 g, E), driver off, brake on, creeps ≤ ~25 mm/s (E) and lands quietly; then a Scout one (391 g, E) (`box-electronics.md` Head brake).** Still useful when convenient: hook latch first fit (real drone seated, push up by hand); latch 50 cycles on the real cartridge; hover ulog over the box, vibration log, flight current log.
- **Later:** patent attorney on the swap and the squeeze latch before selling (`claude/research/2026-10-13-patents-swap.md`).
