sparkiscool/nox/archive/scout-v2/current-parts.md

# Scout v2: parts table, frozen 23 Oct 2026 (retired)

Scout v2 is retired (`ARCHIVED.md`). This is its last live table, moved out of `nox/current-parts.md` unchanged on 23 Oct 2026; states are as of that date and no longer move. The frame plate row stays live in `nox/current-parts.md` (carried into v3). "Nox Print Files" was a claude.ai artifact; the `s2_*` files now live in `archive/scout-v2/print/`; "Nox Source" was an artifact, the scripts are in this folder; `latest\` and `F:\` are the CAD laptop and its SD card.

**Orientation and supports on every part (Spark 17 Oct 16:36 + 18:05): rule in `nox/README.md` Printing, "Orientation and supports"; check with `nox/print_orient.py`.** Largest flat face down, tree(auto) supports, bed contact (M) with every slice.
**Attachments are drawn, not generated, from 17 Oct 17:30 (Problem 46).** Two parts snapped at their plate attachment today.
**No disconnected structures, from 20 Oct 01:08 (Spark): no part is READY unless `nox/solid_check.py` reads PASS on its exact file (one body after a 0.9 mm erosion, every drawn feature in it, no wall under 1.8, and since 20 Oct 14:45 no blob hanging on a neck under 3 mm: a piece that splits off at a 1.2 or 1.5 mm erosion, is ≥ 1.6 thicker than the neck and joins the rest over less than 4 x its thickness² fails). Rule: `nox/README.md` Rules, "Solid parts". Rows below that predate it: the stand set was checked 20 Oct 14:45 with the neck test (all PASS but bracket_e v7b / v8, replaced by v7c); every other READY part gets checked by its owner chat before its next print.**
**Every carbon rod in the project is 3.0 solid from 17 Oct 21:33 / 21:45 (Spark; dimensions G "Carbon rods"): cage rings, spokes, skirt, wheel pins, any coupon rod. One stock size.** Rod socket = 3.3 bore (epoxied) on the v3.2 / v4 cage; **socket v2 from cage v12 (Spark 20 Oct 02:42, wider, resin, slides in): 3.6 bore, 4 ribs on 3.3, 2 lock rings 3.9, bleed slot, 45° lead-in, closed 2.0 floor, OD 7.9 (`archive/scout-v2/s2-layout.md` Socket v2); bore size confirmed by the coupon (test 21)**; wheel bore 3.4 (rolls on the pin). Anything drawn for 2.5 or 2.0 rods (cage v3 / v3.1 nodes and wheels, receiver v3.3 skirt sockets) is superseded for those features (Problem 49); cage v3.2 has the 3.0 holes.
**Final-part renders (18 Oct 00:50): artifact "Nox Box Final Parts" (three views of every saved box print file + the assembled arm; `nox/box/final_parts_render.py` in Nox Source). Rerun it when stub v3 and the heads are saved.**

## Scout v2
| Part | Doc / scripts | Version | State | Saved file (Nox Print Files) | g | Next (owner) |
|---|---|---|---|---|---|---|
| S2 receiver (merged with the underside) | `archive/scout-v2/s2-receiver.md`; scripts `archive/scout-v2/receiver_v34.py` (Nox Source), skirt interface `archive/scout-v2/cage_v2/receiver_skirt.py` + `.json` (cage chat); dimensions E / H | **v3.4** (18 Oct 00:20: plate attachment drawn per Problem 46, 3.3 x 10 skirt sockets aimed at (±3.2, ±112, 33.2), 3.0-rod skirt loads, lead channel rerouted, camera keep-out = mount v2 envelope, bosses down) | **READY** | `s2_receiver_v34.stl.b64.txt` (sha 28fe49d9da09, **print pose: pads on the bed, z up**); laptop `latest\s2_receiver.stl` synced 18 Oct 01:13 (sha match), project `latest\s2_receiver.3mf`; **sliced: `latest\s2_receiver_v34_supports.gcode.3mf` = `F:\s2_receiver_v34_supports.gcode.3mf` on the SD card (50.01 g incl. 9.96 supports, 3 h 27 min, 0.20 Strength 6 walls, tree(auto) 30°, brim 5)** | 45.7 (M; v3.3 43.7, +2.0: drawn attachment +2.3, bed columns −1.3, pocket posts 3.0 +0.7, generated −1.3); 40.05 model + 9.96 supports (slicer) | `print_orient.py`: saved face 599 mm² (M) on the bed, 3 islands (155 / 222 / 222), no thin islands, best of the 6; tree supports (4453 mm² overhang M). Recheck (M, as built): one body, thin 0, function 0.1/0/0; **worst non-misuse 0.62 in the skirt pole hit (generated member at x −22, y 39, z 43); attachment ≤ 0.43 on every crash / flight case, 0.67 in the pinch 20 N misuse**; worst overall 1.25 pinch 20 N (misuse, v3.3 1.36). **Spark: start `F:\s2_receiver_v34_supports.gcode.3mf` on Gideon when the v3.3 fit print is off the bed.** After print: no drilling (sockets are 3.3), hand pull + twist at the bosses, then epoxy the 4 skirt rods (90.1 each, cage cut list). Flight-critical (queue 1) |
| S2 receiver **v3.3** (fit print, superseded by v3.4) | `archive/scout-v2/receiver_v33.py`, `_build.py` (Nox Source) | v3.3 + tail columns (17 Oct 16:12), bosses down, tree supports | **PRINTING** | laptop only: `latest\s2_receiver_v33_flipped_supports.gcode.3mf` (sha e58b86646d40, 48.24 g incl. 9.34 supports, 3 h 21 min, 596 mm² M on the bed), on an SD card 22:07; **`F:\s2_receiver_v33_supports.gcode.3mf` (mouth down, snapped) is still on the card 18 Oct 02:00: Spark deletes it by hand**; `latest\s2_receiver_plate.gcode.3mf` (no supports): don't print | 43.7 (M) | Printing (Spark 23:06; the 17:27 mouth-down print is in the failure log). Use it for the latch / fit tests and as the DubHacks fallback. Known: two 3.2 mm² (M) necks where the nose nut cup meets the deck's end bar (the v3.4 fix); the two tail skirt sockets are only ~6.5 deep (the lead channel cut through them, C); all 4 sockets 2.8 bore: **drill to 3.3 by hand, rod as the guide (1.85° off, Problem 48)**; hand pull + twist at the bosses before any flight. Spark: photo of the 17:27 break + weigh the piece (P). This row moves to PRINTED / TESTED / FAILED with Spark's report; the row above is the design |
| S2 cartridge: tray + block + 2 feeler blades | `archive/scout-v2/s2-cartridge.md` | tray v11 (run 9a), block v4 | **READY** | `s2_tray_v11.stl.zip.b64.txt`, `s2_cartridge_block_v4.stl.zip.b64.txt`; laptop `latest\s2_tray.stl`, `s2_cartridge_block.stl`; **tray alone with tree supports: `latest\s2_tray_v11_supports.gcode.3mf` (16:47), on the SD card 17:24**. Old plates without supports (`s2_cartridge_v11_v4_plate…`, `latest\s2_cartridge_plate.gcode.3mf`, `F:\s2_cartridge_run9_block_v4.gcode.3mf`): don't print | 15.8 + 6.26 + 2.16 = 24.2 (M/C); tray reprint 14.17 model + 5.17 supports slicer | Orientation checked 18:20 (`print_orient.py`): tray closed end down is the best of the 6 faces (813 mm² M on the bed, 1543 mm² overhang, no thin islands), block flat as saved (378 mm² M): both keep. The 15:22 plate snapped, printed without supports (failure log); block + blades from it are on hand (Spark 16:43). Spark: print `F:\s2_tray_v11_supports.gcode.3mf` (2 h 7 min); cut 2 blades 35.5; twist by hand vs v8. Latch test on these real parts + the receiver (decision 15): `archive/scout-v2/s2-bottom-latch.md` tests 1 to 5 |
| S2 top case | `archive/scout-v2/s2-top-case.md`, `archive/scout-v2/s2_top_case/` | v1 (run h, 17 Oct 16:50) | **PRINTED** | `s2_top_case_v1.stl.zip.b64.txt` (sha e7e950b79f7e, right side down); laptop `latest\s2_top_case.stl`; **sliced with tree supports: `latest\s2_top_case_v1_supports.gcode.3mf` (16:58, re-exported 18:20 same numbers), on the SD card 17:24**; flat alternative `latest\s2_top_case_v1_flat_supports.gcode.3mf` (367 mm² M on the bed, 11.48 + 2.92 g, 1 h 21 min) only if a reprint wobbles | 12.85 (M); 11.48 model + 5.06 supports slicer | Done and good (Spark 23:06); weigh it (P). Saved face has 3 mm² (M) on the bed (`print_orient.py`); brim + tree supports carried it. **Check before a v2 (Problem 46):** its three plate attachments are 3.8 x 3.0 side posts and a 3.7 x 4 nose post, 11 to 14 tall, the same class that snapped on the receiver. Top case chat: v2 with drawn posts ≥ 6 x 6 + gussets (or a 2.0 skirt down to the pads), index ≤ 0.5 there, rerun (~1 h), saved on its flattest face. After print: clip the UBEC pins; side bolts +4; `SENS_BOARD_ROT 0` + level cal. Cage check done (cage chat 21:15, cage row): crown pads Ø7 on the Ø7 bosses at 68.11, spacers Ø9.5 x 4 under the Ø9.5 side pads. **Nose bolt (top case chat flag 22:07): cage v3.2's nose spokes pass 0.15 off the key lane, so the bolt goes in before the nose spokes are epoxied** |
| S2 camera mount | no part doc: `archive/scout-v2/s2_camera/run_cam.py`, pose `cam_place.py` / `cam_place.json` | v2 (4°, 17 Oct 17:10; v1 13° superseded, not printed) | **READY** | `s2_camera_mount_v2.stl.b64.txt` (sha 12419b7a720f; STL already in print orientation, lower boss flats on the bed); laptop `latest\s2_camera_mount.stl` (synced 18:09), project `latest\s2_camera_mount.3mf`; **sliced: `latest\s2_camera_mount_v2_supports.gcode.3mf` (18:23, 4.01 g incl. 0.72 supports, 48 min)**; not on the SD card yet | 3.47 (M; v1 3.61) | Orientation checked 18:20: saved face 115 mm² (M) on the bed, least overhang of the 6 (397 mm²), keep. Spark: copy to the SD card, print after the receiver. Hangs from one nose bolt pad (Ø11, Problem 46 applies: camera chat checks the pad web ≥ 2.0 all round before v3). Receiver v3.4 keeps the mount's whole v2 envelope clear (drone x 52..70, |y| ≤ 21, z −13.5..26, plus the nose pad hull): the x 52..54 clash with v3.3 is gone. Spark: measure the camera back (bosses 8 E). **Stays a separate part (Spark 23:06 "camera mount is fine"; decision 24 closed)** |
| S2 cage | `archive/scout-v2/s2-cage-v2.md` | **v3.2** (17 Oct 22:36, Spark 22:32 "just need the holes to fit 3mm": the v3.1 nodes, layout C3, all PETG, with every hole re-cut for 3.0 rods and pins); v4 node set below | **PRINTING** | `s2_cage_PETG_plate_v3.2.3mf.b64.txt` (19 parts, sha a06ab1709693) + singles `s2_cage_corner_node_v3.2`, `_vtee_v3.2`, `_side_node_v3.2`, `_side_node_M_v3.2`, `_crown_v3.2`, `_wheel_v3.2` (`.stl.b64.txt`); spacer unchanged (`s2_cage_side_spacer_v3`, laptop only); v3 / v3.1 files deleted from Nox Print Files. Laptop `latest\s2_cage_plate.3mf` + `latest\s2_cage_<part>.stl`, `LATEST.md` 22:47; **sliced: `latest\s2_cage_plate_v32_supports.gcode.3mf` (sha 47aa59aace92, 37.09 g, 2 h 46 min, 6 walls, tree supports on, 0 g generated)**; **on the SD card 22:50 as `F:\s2_cage_plate_v32_supports.gcode.3mf` (read back, sha matches; the 22:46 try hit an I/O error, card re-seated)**. Don't print `latest\s2_cage_plate_v31_supports.gcode.3mf` (2.8 holes) | 40.7 printed (M, 19 parts) + 27.2 rods (C, 2.48 m of 3.0) + ~1.5 epoxy (E) = **~69.4 g vs the 55 budget (+14)** | Printing, nodes + crown (Spark 23:06). **v3.2 holes (M, measured after the cut):** every rod socket 3.3 + 0.6 lead-in; walls 1.75 to 2.14, **1.1 on the lower-ring sockets' collar-face side** (corner + side node; the 1.0 face clearance sets it) and **0.95 at one spot on each crown side-spoke socket** (p5 1.74); corner cheek holes 3.3, wall 1.36; no breakouts, every part one watertight body. Wheels stay **R 4** (they fit the v3 pockets), bore 3.4 on the 3.0 pin, rim wall 2.3; wheel centres as v3, so the rim now stands 2.25 proud of the 3.0 rod surface (C; was 2.5 of the 2.5 rod): the catch is unchanged. **Not rechecked for strength:** v3 was already over Problem 46 (corner 1.13, crown 0.81, F) and v3.2 has thinner socket walls and 3.0-rod loads (frame model at 3.0: rods to index 1 at 0.89 m/s, 1 m/s hit 1.13, skirt 183 N on the receiver): fly gently, inspect after any hit. **Nose bolt:** the v3 nose spokes still pass 0.15 off the nose bolt key lane, so fit the nose bolt before epoxying the nose spokes (v4 reroutes them, lane r 3.5). Cut list (C, socket bottom to socket bottom less 0.5, v3 axes): 8 x 188.5 rings, 4 x 98.1 nose / tail spokes, 2 x 81.8 side spokes, 4 x 90.1 skirt, 8 x 7.5 wheel pins = 2.48 m of 3.0 |
| S2 cage **v4 node set** (regenerated nodes for 3.0 rods, optional upgrade of v3.2; same C3 axes, rods and crown) | `archive/scout-v2/s2-cage-v2.md` v4 section; scripts `archive/scout-v2/cage_v2/node_gen.py` (`CAGE_LAYOUT=layout_C4.json`, `NOX_OVERHANG=0`, `SNODE_TIE`), `layout_C4.json`, `export_c4.py` (status chat 18 Oct, not yet in Nox Source) | v4 (18 Oct 06:30): corner node, vtee, side node L / R regenerated at 3.0 rods (3.3 sockets, 3.3 cheek holes), wheels **R 5** bore 3.4; crown stays v3.2 (its v4 run came out in pieces) | **READY** | `s2_cage_v4_corner_node.stl.zip.b64.txt` (sha eb9ce156795f), `s2_cage_v4_vtee.stl.zip.b64.txt` (9dcde211e0a6), `s2_cage_v4_side_node.stl.zip.b64.txt` (f255ef018e62), `s2_cage_v4_side_node_M.stl.zip.b64.txt` (673f7bc8d234), `s2_cage_v4_wheel.stl.zip.b64.txt` (d29ad6bcdbed); all in print pose (corner / vtee drone-bottom down, side node outer side down, wheel flat). Not on the laptop (no link from this chat) | corner 6.10 x4, vtee 2.99 x2, side 4.97 x2, wheel 0.25 x8 (M) = 42.3 + crown 7.67 + spacers 0.64 = 50.6 printed; + rods 27.1 (C) = 77.7 | Worst index (M, as built, 3.0-rod loads at 0.89 m/s): **corner 0.99** (v3 1.13; 3 reinforcement passes, 204 hot cells), **side node 0.38**, **vtee 0.06**; every part one watertight body, thin 0, function 0/0/0. Corner still over Problem 46's 0.5 on socket members (noted). `print_orient.py`: corner 118 mm² M on the bed (4 islands, thin-island run 8 mm, under the 10 limit), vtee 152, side node 101. Print only if v3.2 breaks or Spark wants the stronger set: v3.2 nodes and v4 nodes are interchangeable on the same rods and crown except the wheels (v4 corner pockets take the R 5 wheels only). Catch sim at R 5: 95 % at μ 0.4 vs 100 % for R 4 at ±40 (axle drag, pin r 1.5); inside the ±30 gate both 100 % (E). Crown v4: deferred (regen grew 9 bodies and died in the print check; v3.2 crown has 3.3 bores already). Side node needed the overhang filter off (`NOX_OVERHANG=0`): with it on, the −y build starved the bridge between the ring sleeves to 2 % volume three times |
| S2 cage **v13 lantern** (replaces the C3 cage: 29 rods + 17 printed parts) | `archive/scout-v2/s2-layout.md`; Nox Source `archive/scout-v2/lantern/` (`node_topo3.py`, `run_v13.py`, `smooth14.py`, `sharp14.py`, `prep14.py`, `assemble14.py`, `s21_lantern12.py`); artifact "Scout v2.1 Layout" | v13 finish v2 (21 Oct 03:10; Spark: thicker topology parts round the prop guard, rods stay 3.0; 20:23 flat feet; 22:16 smooth, one body, no sharp edges; 23:41 much smoother): corner columns x4, side columns x2, nose column (camera pads), tail column, hub (ring r 36 x 6 x 6), nose legs x2 and sled tails x2 with flat feet (bottoms z −52), tail knees x2, rail sleeves x2 (glove socket at tip 7); fillet 2.0 inside / round 0.9 outside, field low-pass 0.8, exact sockets blended back; PA12-CF, socket v2 | **DESIGN** | none (STLs in the layout chat; publish after the coupon sets the bore and the h 1.0 pass) | 100.0 printed (M) + 36 rods (C) + ~16 sleeves / strips / grommets / epoxy / side hubs (E) = **~152 g E** (v12 ~125) | All 17: one body, watertight, **`solid_check.py` current version (neck test) PASS** (hub turned 0.12°), index 0.11..0.44, every edge over 60° on a function surface (bores, pad holes, foot plane) but 4 spots of ~0.1 on the hub. Keep-outs on the assembly: collar 0.70, arm sweep 0.55, head lane 0.64, lens 0.32, props 12.05, yawed opening 3.95. Feet: stance 100 x 78, tip-over 35° / 36° / 47° (E). Then: coupon bore (test 21), finer pass h 1.0, D21 load, 25 g case, `print_orient.py`, publish. Box chat: nothing under a seated drone above z −52 outside the head lane |
| S2 socket v2 coupon | `archive/scout-v2/s2-layout.md` Socket v2; `archive/scout-v2/lantern/socket_coupon.py` (Nox Source) | v2 (20 Oct: v1 removed, its in-line lying sockets reamed each other) | **READY** | `s2_socket_v2_coupon_v2.stl.zip.b64.txt` (sha 25725f258d52, flat on the plate as saved) | 7.4 (M, PA12-CF; PETG fine for the fit check) | `solid_check.py` PASS (current version, neck test included). Bores 3.5 / 3.6 / 3.7 (1 / 2 / 3 notches), each standing and lying. Spark: dry-fit a 3.0 rod in each (slides in by hand, no wobble), then epoxy a rod into the standing 3.6, pull after 24 h (test 21); result sets the cage v12 bore |
| S2 contacts | `archive/scout-v2/s2-contacts.md` | on-hand parts (copper-clad strips, AA spring shoes) | **DESIGN** | none | 6 (E) | Receiver chat places the shoes; 50-swap bench test |
| Frame plate | dimensions C | Bee35 carbon 3.5, cut down | **ON HAND** | n/a | 24 to 32 (E) | Weigh (P) |

Dropped 17 Oct 15:50 (Spark, DEFAULTs): the S2 latch coupon v1 (its script `archive/scout-v2/s2_latch_coupon.py` deleted; the latch is tested on the real cartridge); the retired docs `archive/scout-v2/s2-guard.md` and `archive/scout-v2/s2-underside.md` (cage v2 and receiver v3.3 replace them).
