sparkiscool/nox/nox/overseer/s500/S500-C1_ASM.step

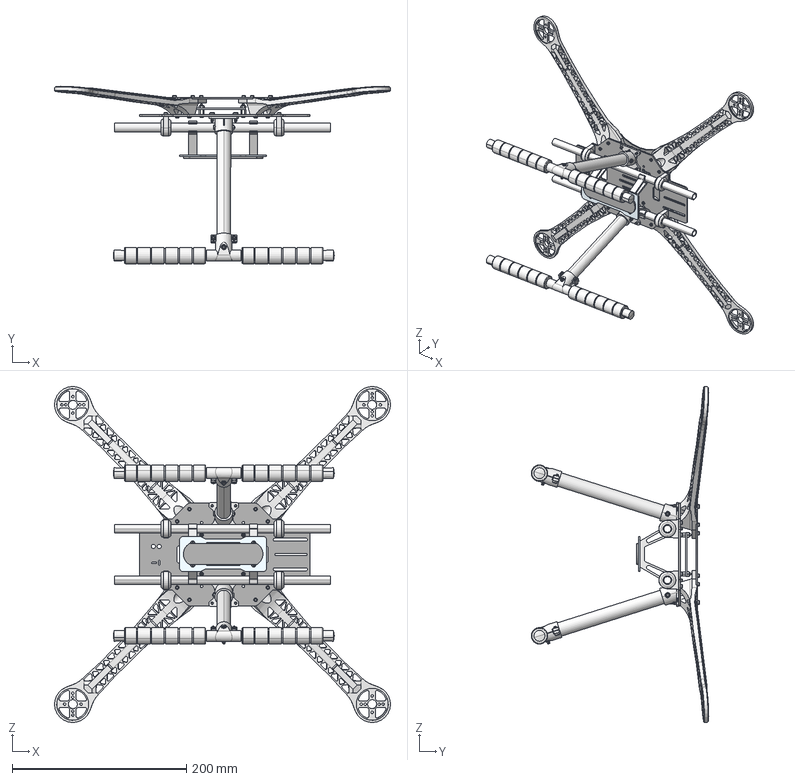
[picture p101: CAD file, 2026-10-24]
nox/overseer/s500/S500-C1_ASM.step
386.1 x 204.0 x 386.1 mm
BOTTOM-PLATE-S500
TOP-PLATE-S500
GB70-M2-5-6-DING x 28
JIA-GUAN x 4
HUAN-GUIJIAO x 4
CARBON-FIBER-TUBE x 4
JIA-LIANJIE x 2
GUAN-CHENG-S500 x 2
GB70-M3-25-DING x 2
LM-M3-DING x 8
GB70-M3-8-DING x 12
JIAO-LIANJIE x 2
JIAO-EVA x 4
MAO-JIAO x 4
GB70-M3-21-DING x 2
PYLONS x 2
BATTERY-MOUNTING-BOARD
BATTERY-PAD
M2-5-GB819-8-DING x 4
NILONG-GB818-M3 x 4
NILONGZHU-M3-6 x 4
PCB-POWER
LM-M3-NILONG x 4
