sparkiscool/nox/runs/scout_camera_mount/v1/camera_mount_assembled.stl

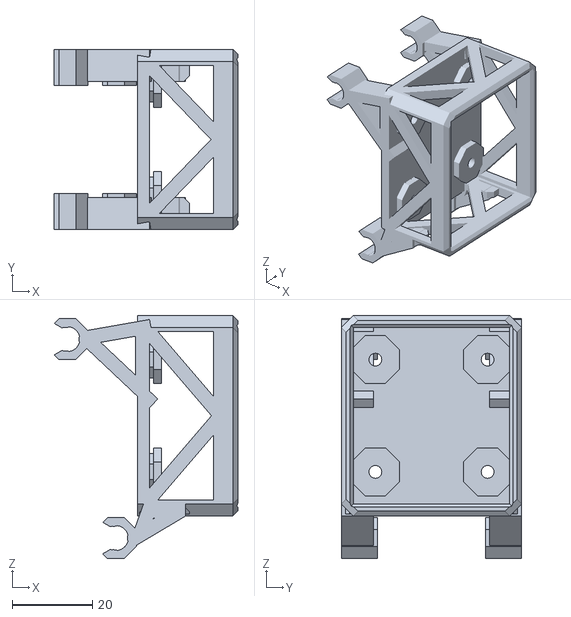
[picture p102: CAD file, 2026-10-27]
runs/scout_camera_mount/v1/camera_mount_assembled.stl
45.8 x 45.0 x 60.6
