sparkiscool/nox/runs/scout_camera_mount/v1/stop_collar_assembled_my.stl

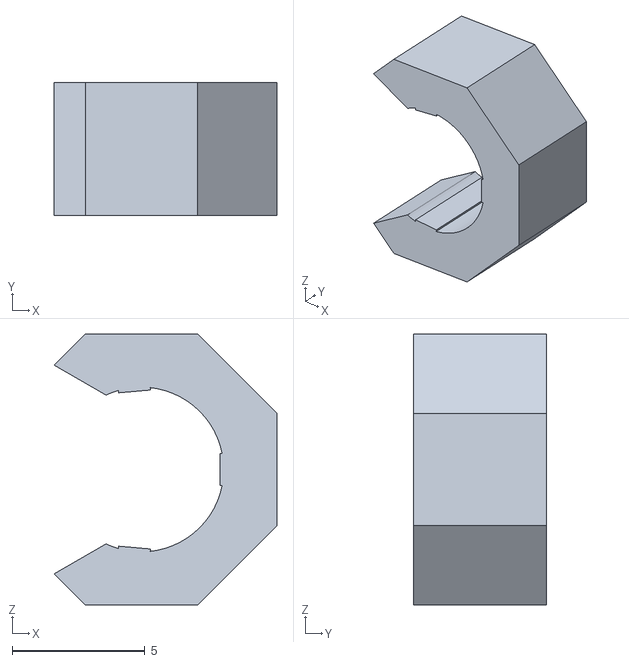
[picture p103: CAD file, 2026-10-27]
runs/scout_camera_mount/v1/stop_collar_assembled_my.stl
8.38 x 5.00 x 10.2
