sparkiscool/nox/nox/box/models/box_baymod_v4i_W.obj

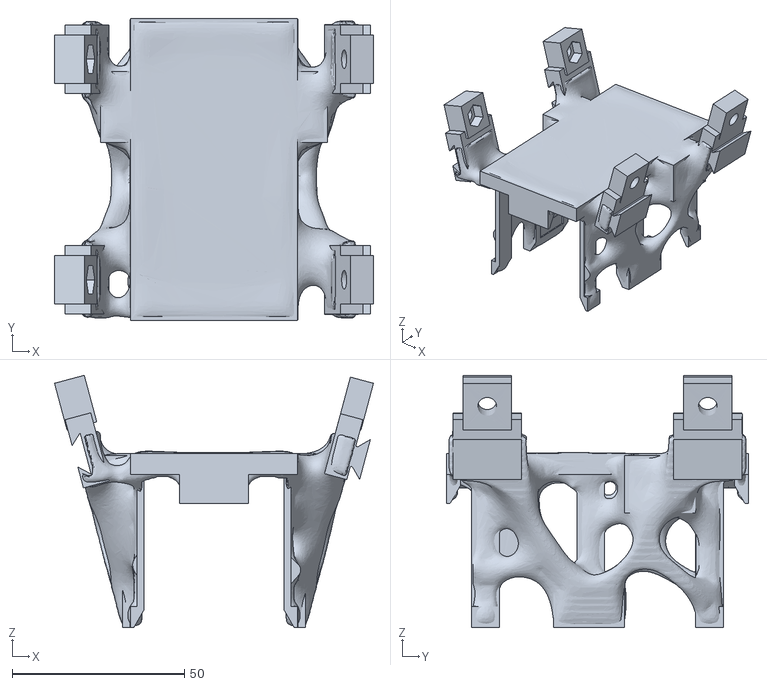
[picture p104: CAD file, 2026-10-21]
nox/box/models/box_baymod_v4i_W.obj
92.6 x 87.6 x 73.2
