sparkiscool/nox/print/overseer_cage_node_8_v5.stl

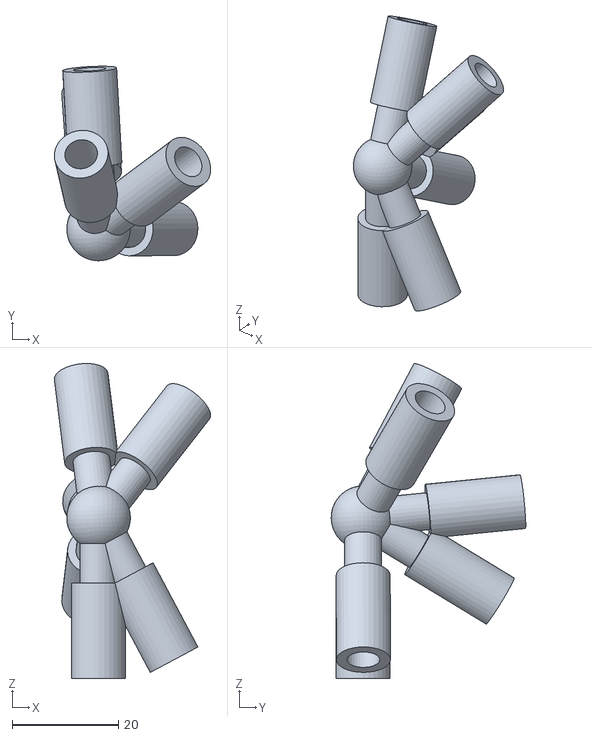
[picture p105: CAD file, 2026-10-28]
print/overseer_cage_node_8_v5.stl
29.5 x 36.7 x 59.4
