sparkiscool/nox/runs/arm/v7/asm/fingA_B.stl

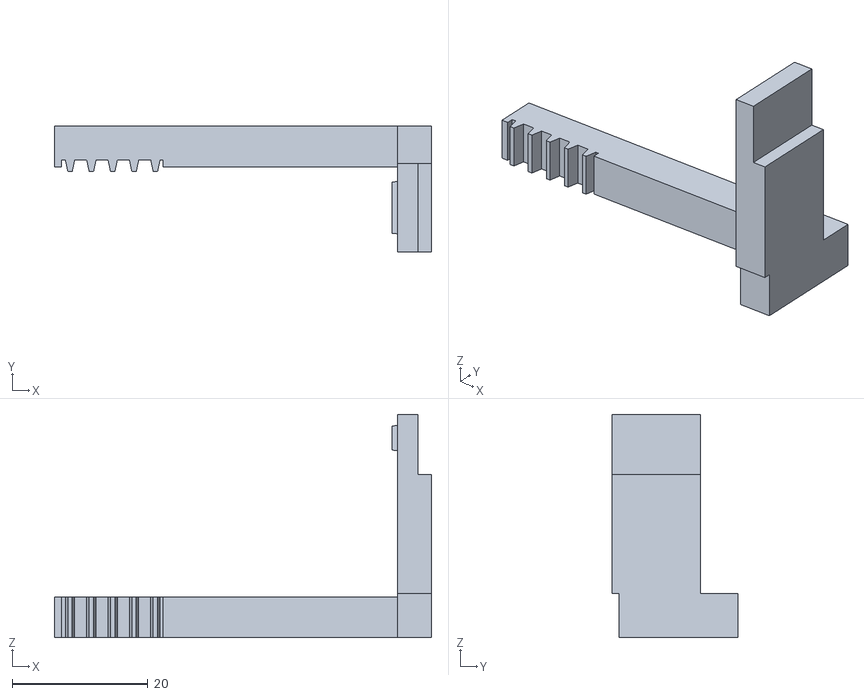
[picture p106: CAD file, 2026-10-24]
runs/arm/v7/asm/fingA_B.stl
55.5 x 18.5 x 32.9
