sparkiscool/nox/runs/arm/v7/asm_overseer/pack_charged.stl

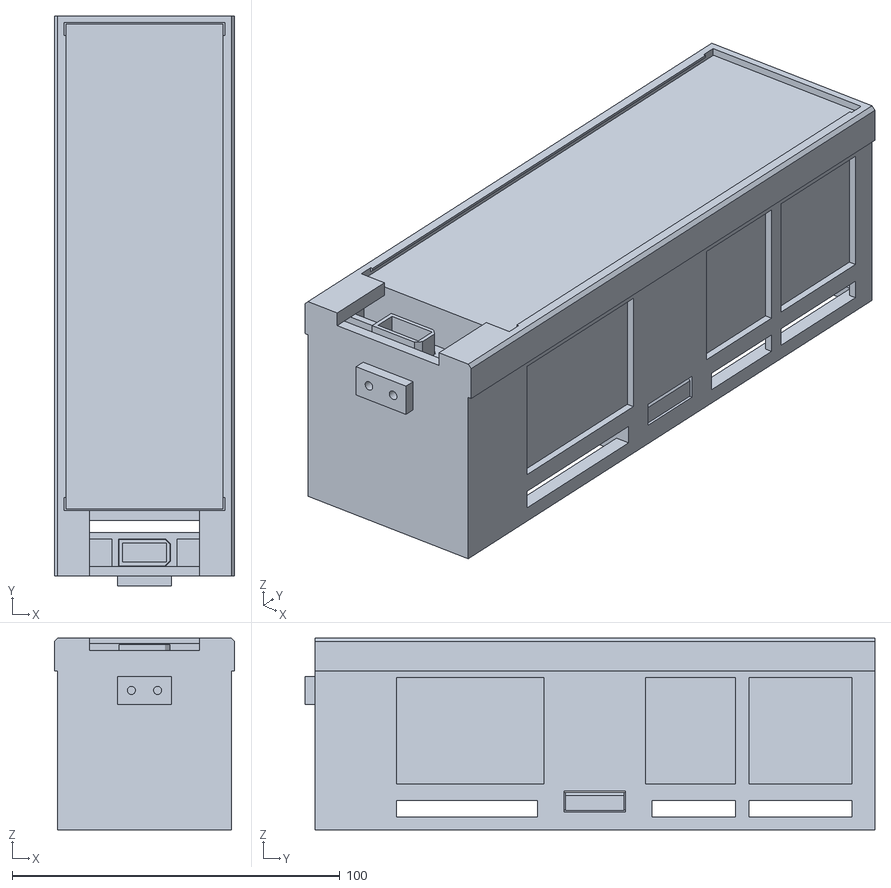
[picture p107: CAD file, 2026-10-24]
runs/arm/v7/asm_overseer/pack_charged.stl
55.0 x 174.0 x 58.6
