sparkiscool/nox/runs/arm_pinion16/v3/box_arm_pinion16_v3.stl

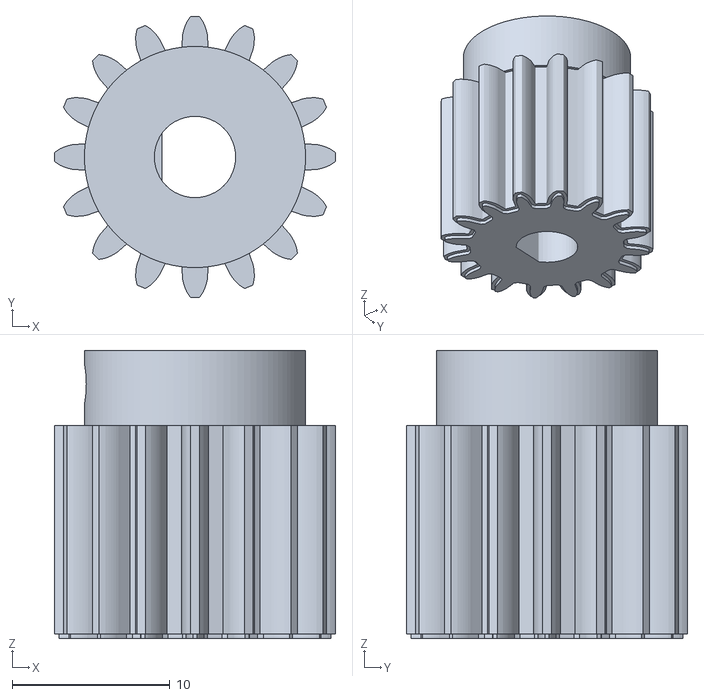
[picture p108: CAD file, 2026-10-24]
runs/arm_pinion16/v3/box_arm_pinion16_v3.stl
17.8 x 17.8 x 18.2
