sparkiscool/nox/runs/arm_rail/v5/arm_rail_A_v5_W.stl

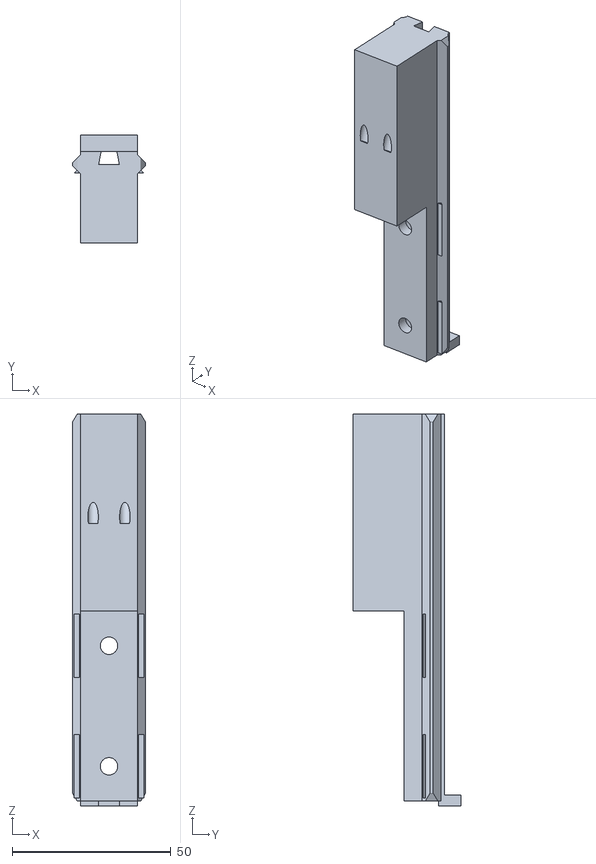
[picture p109: CAD file, 2026-10-24]
runs/arm_rail/v5/arm_rail_A_v5_W.stl
23.0 x 34.0 x 123.5
