sparkiscool/nox/runs/arm_v6_parts/detent_ring_v3_W.stl

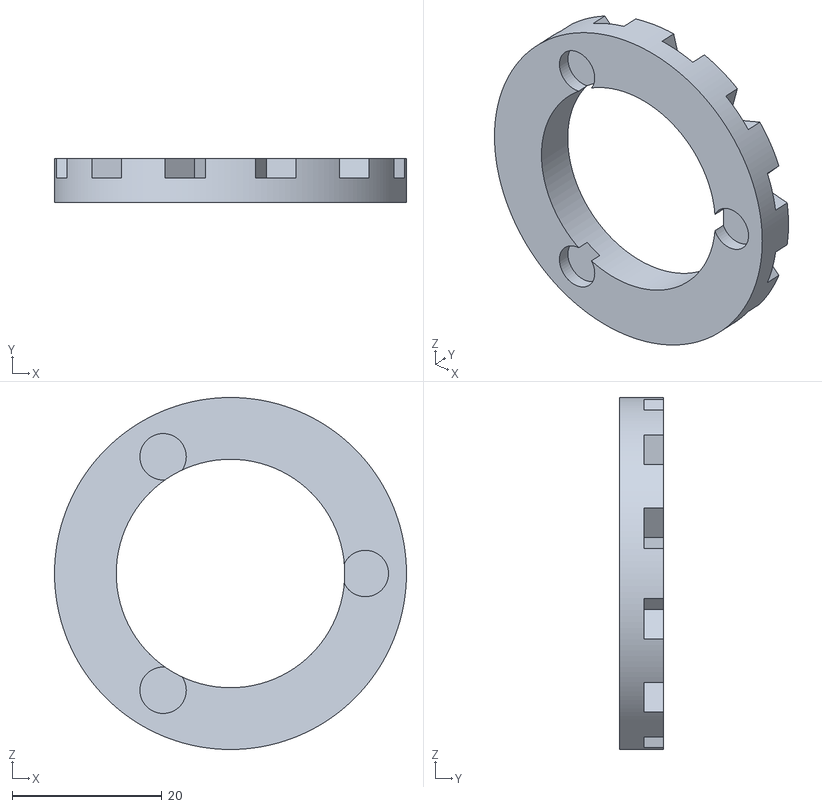
[picture p110: CAD file, 2026-10-24]
runs/arm_v6_parts/detent_ring_v3_W.stl
47.0 x 5.90 x 47.0
