sparkiscool/nox/runs/bar_half/organic-v2/bar_half.stl

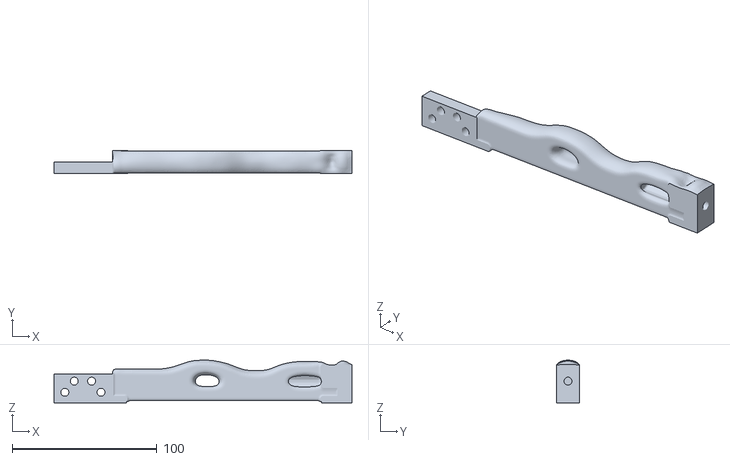
[picture p111: CAD file, 2026-10-24]
runs/bar_half/organic-v2/bar_half.stl
206.0 x 16.0 x 29.5
