sparkiscool/nox/runs/battery_latch/v4/manifest_overseer/pack.stl

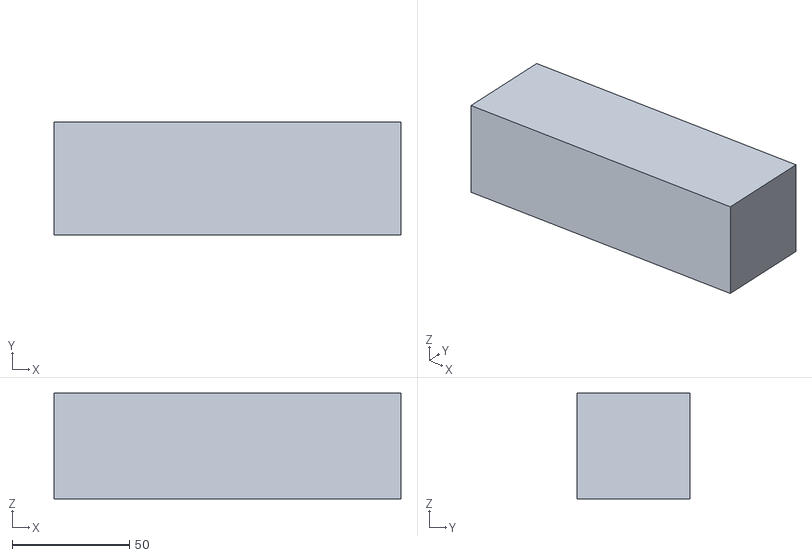
[picture p112: CAD file, 2026-10-24]
runs/battery_latch/v4/manifest_overseer/pack.stl
148.0 x 48.0 x 45.0
