sparkiscool/nox/runs/battery_latch/v4/manifest_scout/receiver_skid_nose.stl

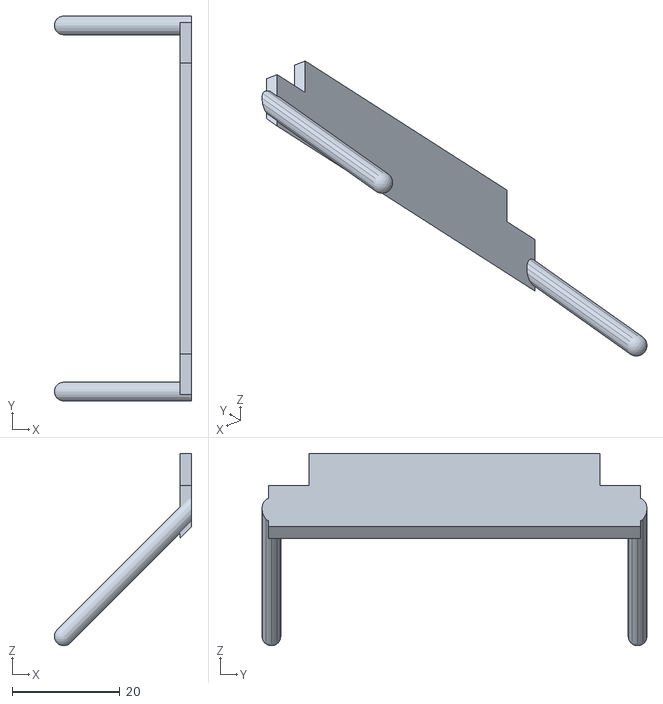
[picture p113: CAD file, 2026-10-24]
runs/battery_latch/v4/manifest_scout/receiver_skid_nose.stl
25.5 x 71.5 x 35.8
