sparkiscool/nox/runs/battery_latch/v4/stl/box_battery_skid_closed_scout_v2.stl

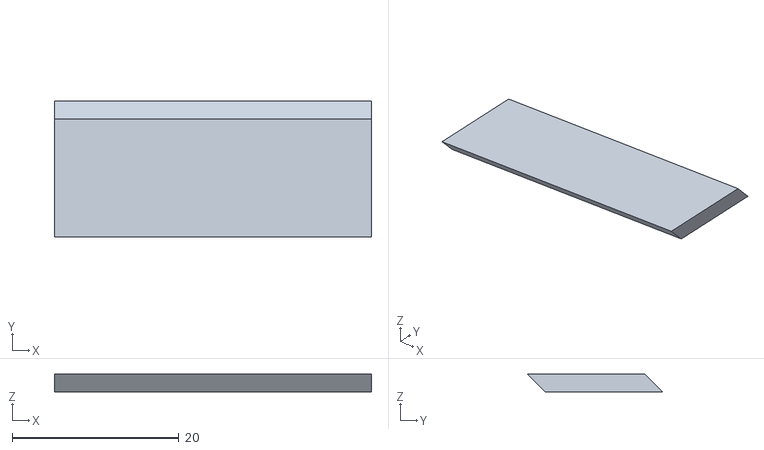
[picture p114: CAD file, 2026-10-24]
runs/battery_latch/v4/stl/box_battery_skid_closed_scout_v2.stl
38.0 x 16.3 x 2.12
