sparkiscool/nox/runs/box_catch_assembly/v2/funnel_panel_B_v9_plain_nx_seat.stl

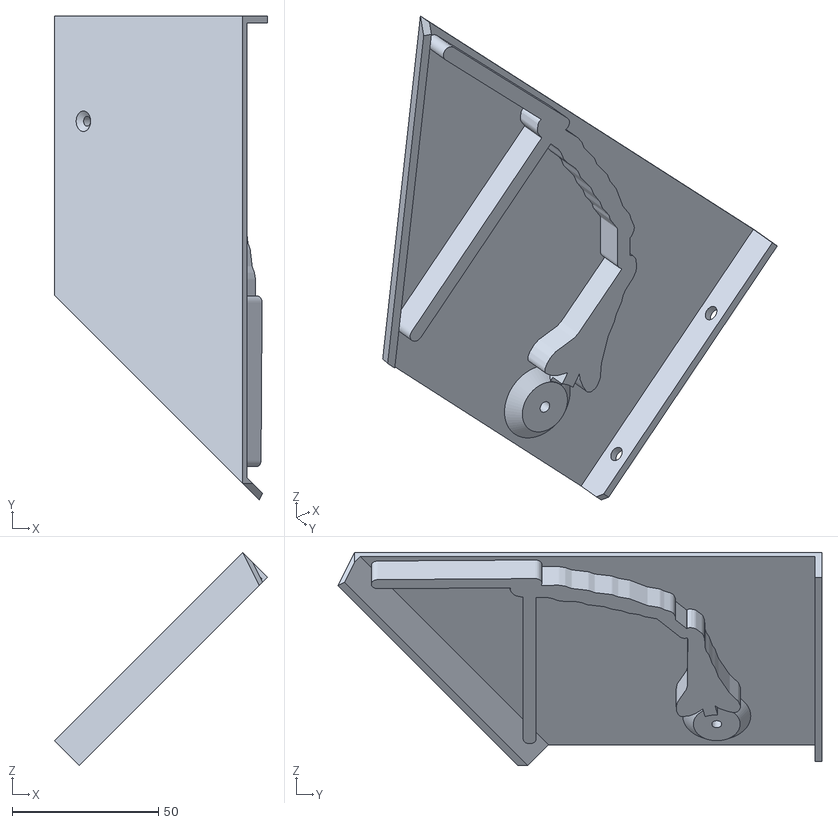
[picture p115: CAD file, 2026-10-24]
runs/box_catch_assembly/v2/funnel_panel_B_v9_plain_nx_seat.stl
72.9 x 165.6 x 72.9
