sparkiscool/nox/runs/box_system/v2/latch_ctx/overseer_receiver_c.stl

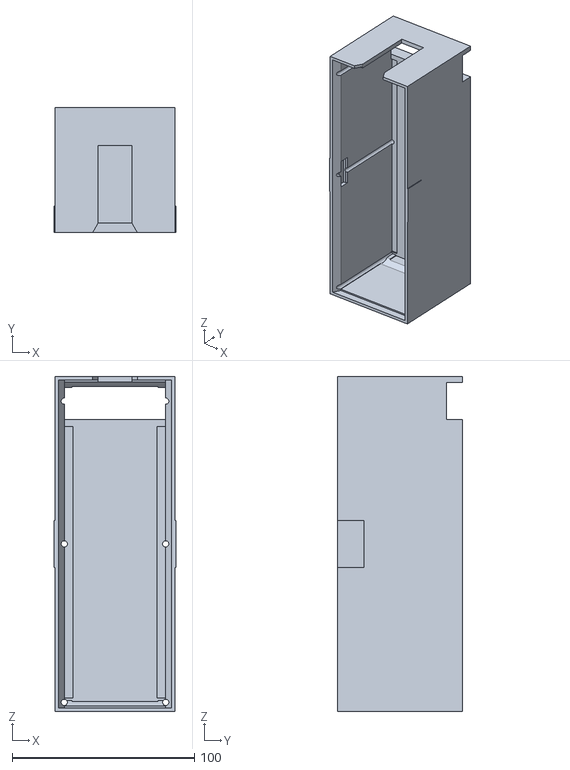
[picture p116: CAD file, 2026-10-24]
runs/box_system/v2/latch_ctx/overseer_receiver_c.stl
66.8 x 68.6 x 183.6
