sparkiscool/nox/runs/box_system/v2/layout/catch_W.stl

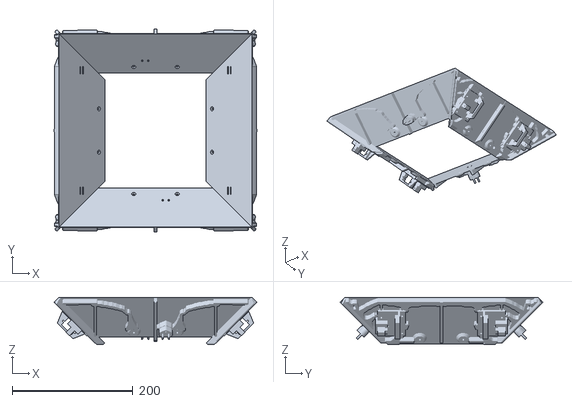
[picture p117: CAD file, 2026-10-24]
runs/box_system/v2/layout/catch_W.stl
336.8 x 336.8 x 78.4
