sparkiscool/nox/runs/box_system/v2/layout/parts/bay0_body_envelope.stl

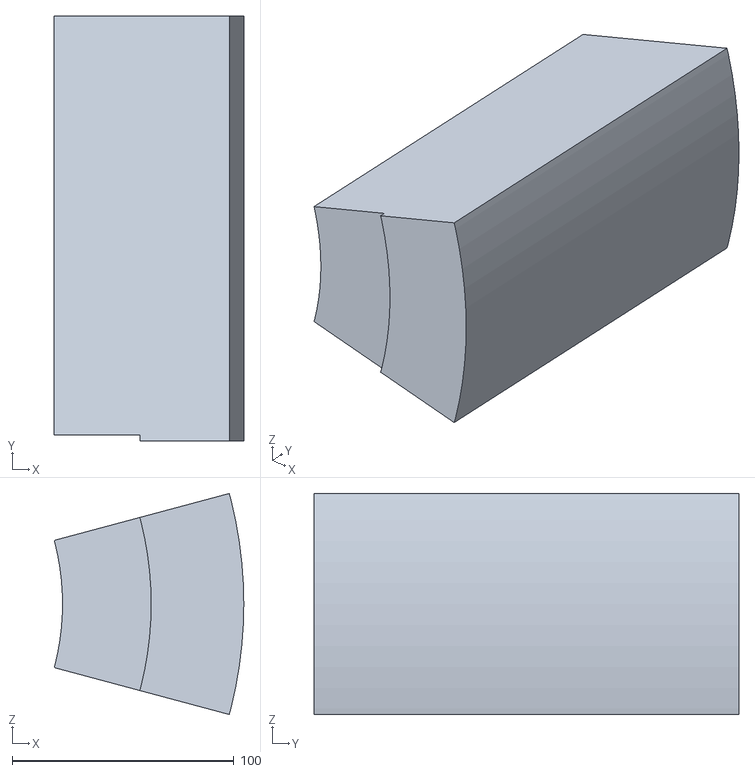
[picture p118: CAD file, 2026-10-24]
runs/box_system/v2/layout/parts/bay0_body_envelope.stl
85.6 x 191.6 x 99.7
