sparkiscool/nox/runs/box_system/v2/layout_bottom/drone_W.stl

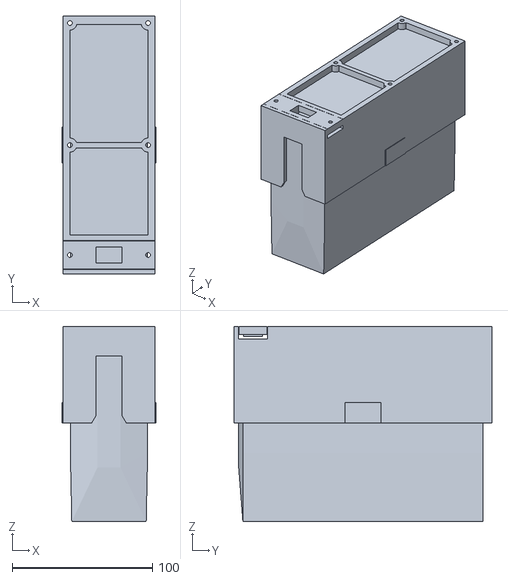
[picture p119: CAD file, 2026-10-24]
runs/box_system/v2/layout_bottom/drone_W.stl
66.8 x 183.6 x 138.8
