sparkiscool/nox/runs/box_system/v2/layout_bottom/parts/bay-210_cartridge.stl

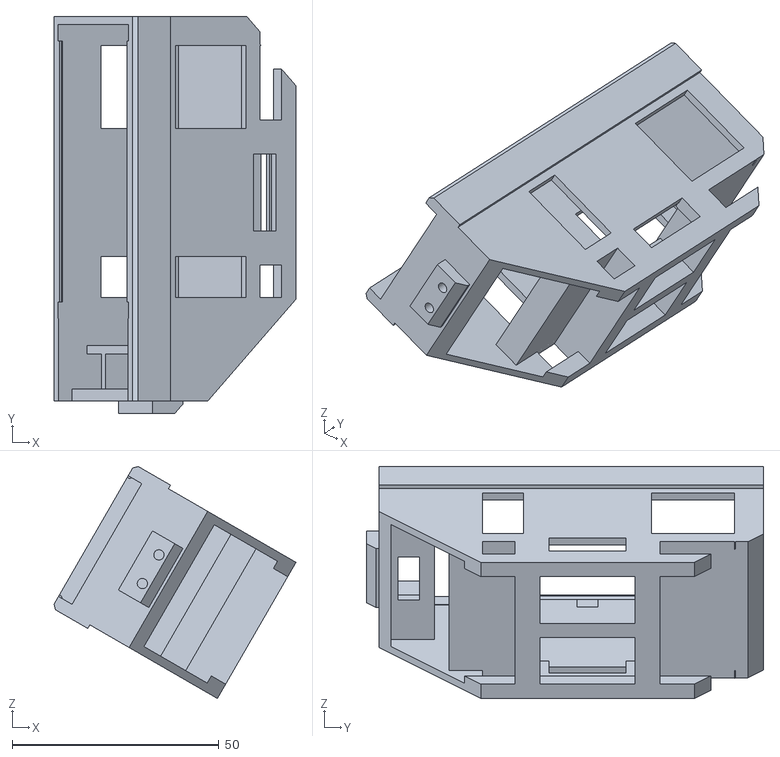
[picture p120: CAD file, 2026-10-24]
runs/box_system/v2/layout_bottom/parts/bay-210_cartridge.stl
58.5 x 96.0 x 56.1
