sparkiscool/nox/runs/box_system/v2/layout_clip_bottom/cartridge_paths_W.stl

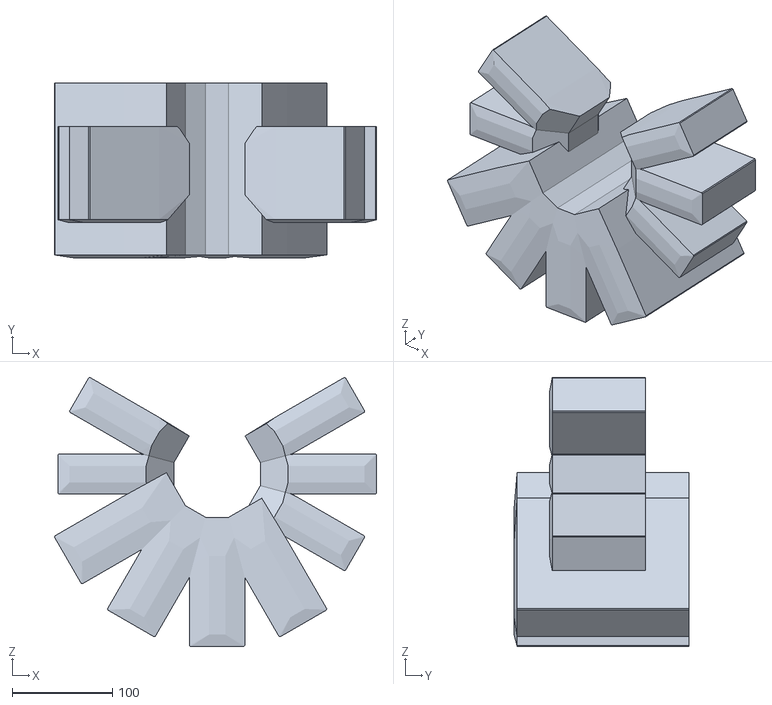
[picture p121: CAD file, 2026-10-24]
runs/box_system/v2/layout_clip_bottom/cartridge_paths_W.stl
320.5 x 174.0 x 267.7
