sparkiscool/nox/runs/box_system/v2/layout_clip_bottom/parts/bay-120_body_envelope.stl

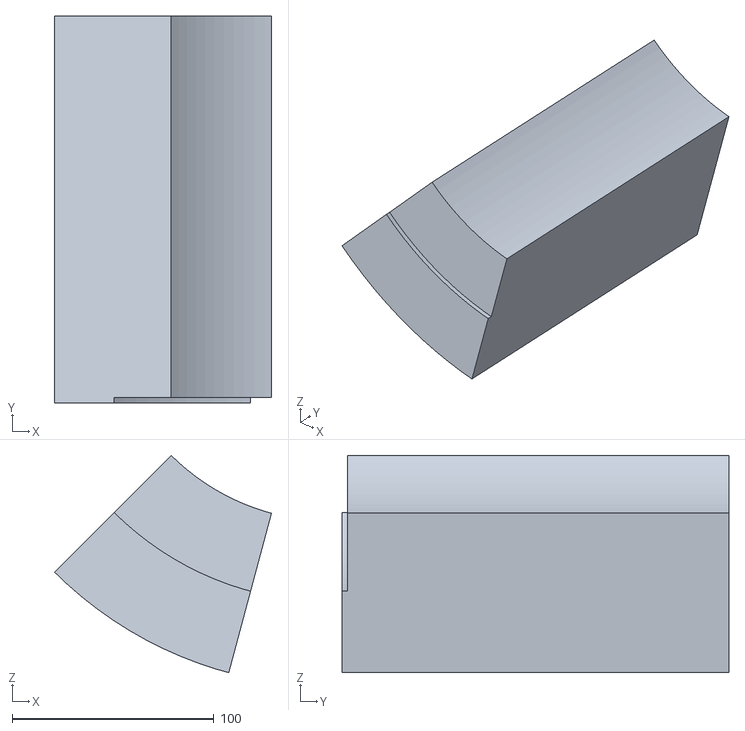
[picture p122: CAD file, 2026-10-24]
runs/box_system/v2/layout_clip_bottom/parts/bay-120_body_envelope.stl
107.6 x 191.6 x 107.7
