sparkiscool/nox/runs/box_system/v2/layout_R128_bottom/parts/bay-60_receiver.stl

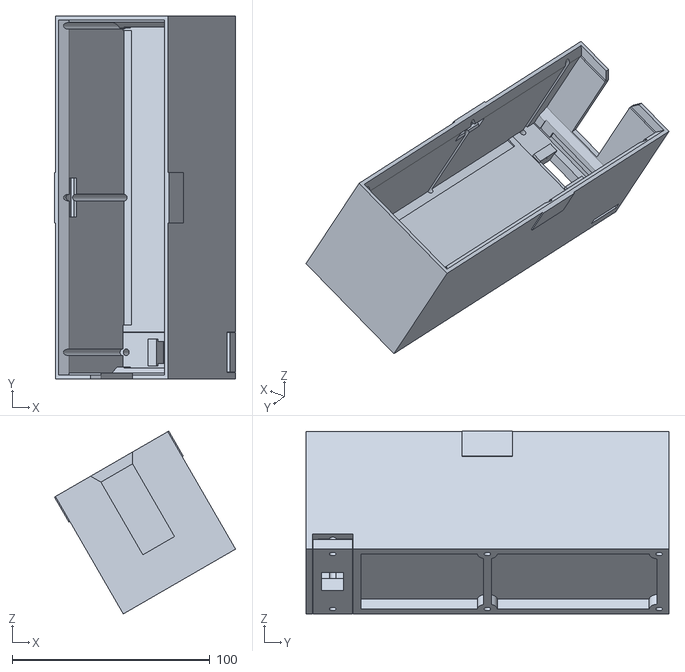
[picture p123: CAD file, 2026-10-24]
runs/box_system/v2/layout_R128_bottom/parts/bay-60_receiver.stl
91.6 x 183.6 x 92.5
