sparkiscool/nox/runs/box_system/v2/topo_r2/g2000/iso05.stl

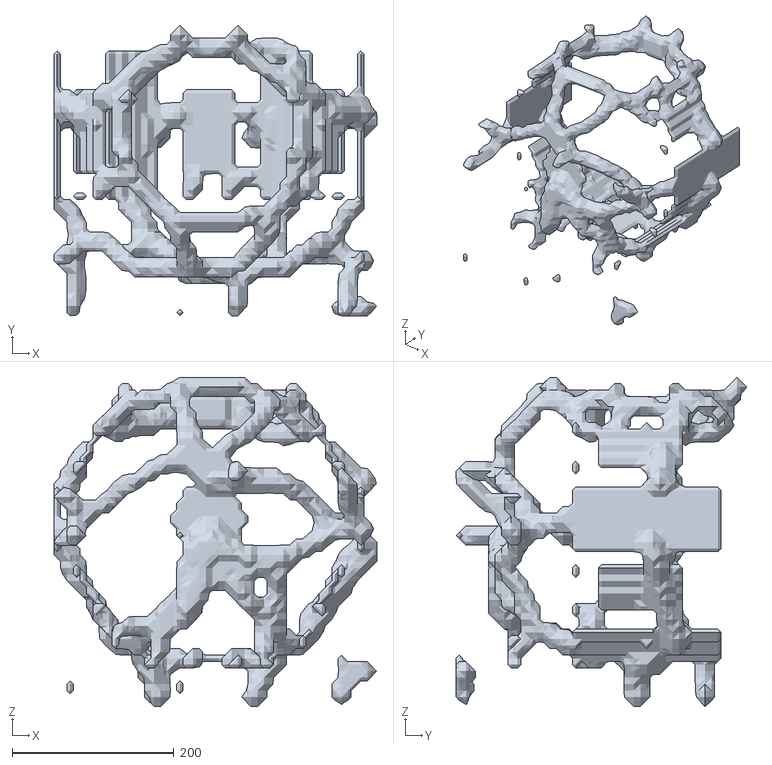
[picture p124: CAD file, 2026-10-24]
runs/box_system/v2/topo_r2/g2000/iso05.stl
400.0 x 359.9 x 408.0
