sparkiscool/nox/runs/box_system/v2/topo_r2/g3000/iso05.stl

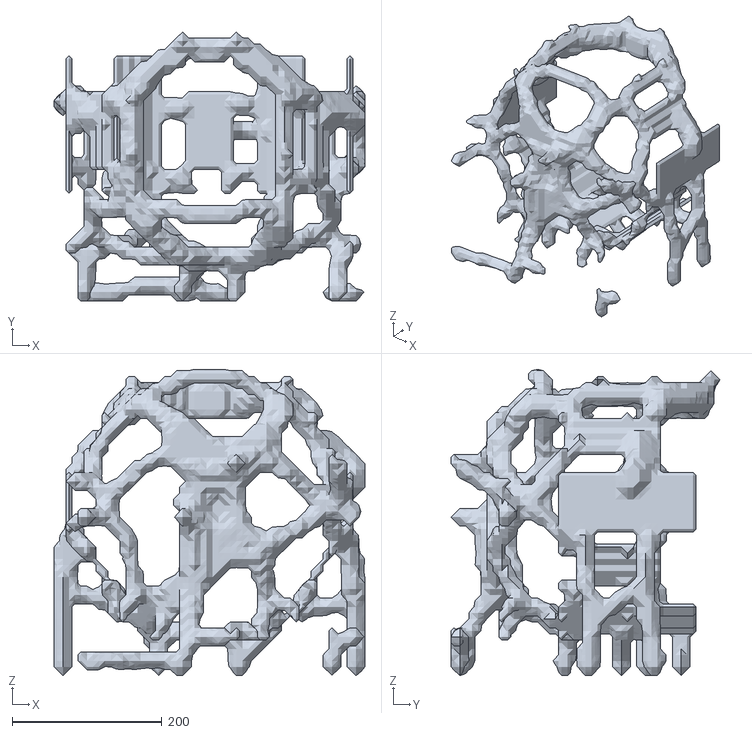
[picture p125: CAD file, 2026-10-24]
runs/box_system/v2/topo_r2/g3000/iso05.stl
416.0 x 359.9 x 409.9
