sparkiscool/nox/runs/box_system/v2/topo_r2/g3000_ring/iso05.stl

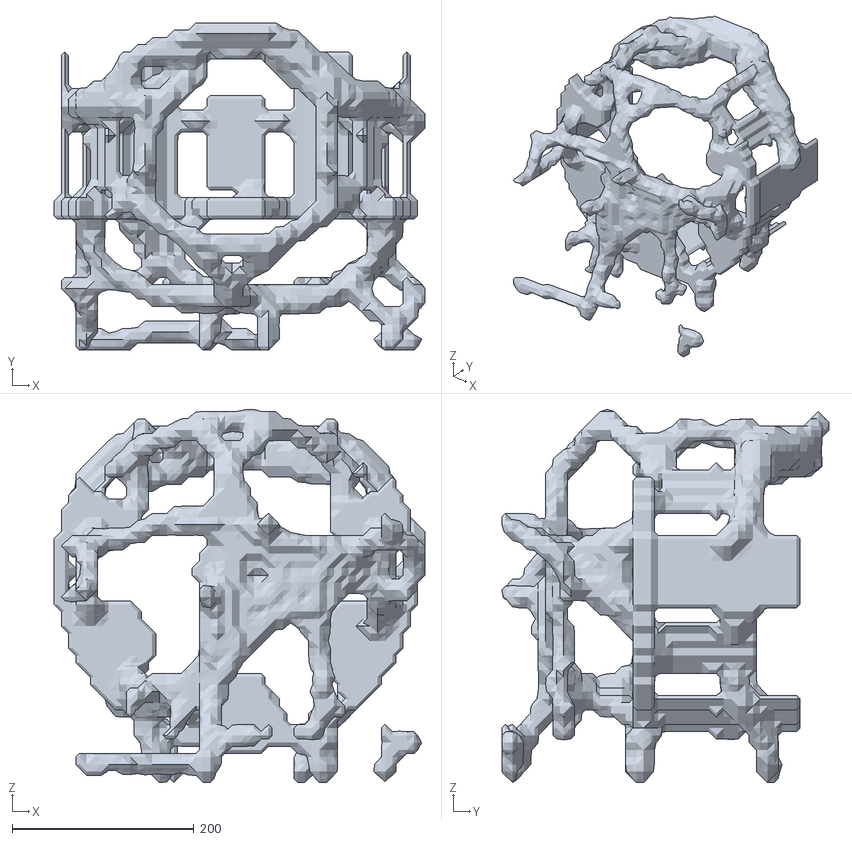
[picture p126: CAD file, 2026-10-24]
runs/box_system/v2/topo_r2/g3000_ring/iso05.stl
408.0 x 360.0 x 410.4
