sparkiscool/nox/runs/box_system/v2/topo_r2/g4000/iso05.stl

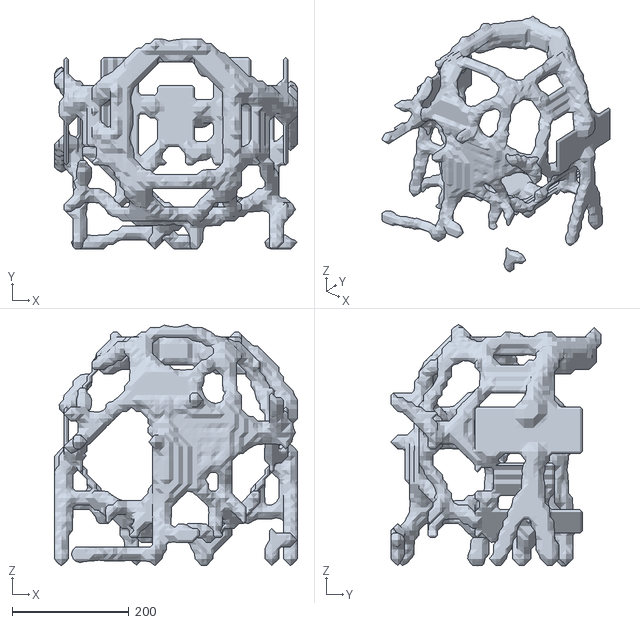
[picture p127: CAD file, 2026-10-24]
runs/box_system/v2/topo_r2/g4000/iso05.stl
416.0 x 360.0 x 413.5
