sparkiscool/nox/runs/bracket_jA/organic-v5/bracket_jA.stl

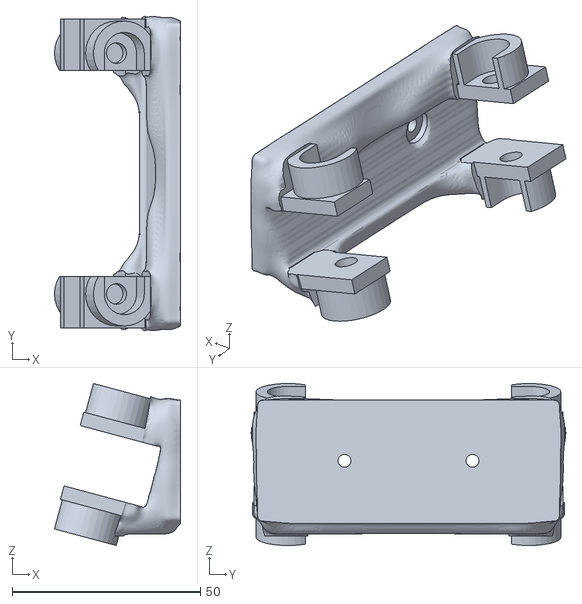
[picture p128: CAD file, 2026-10-24]
runs/bracket_jA/organic-v5/bracket_jA.stl
33.5 x 83.6 x 43.0
