sparkiscool/nox/runs/bracket_jA/topo-v4/bracket_jA_view.stl

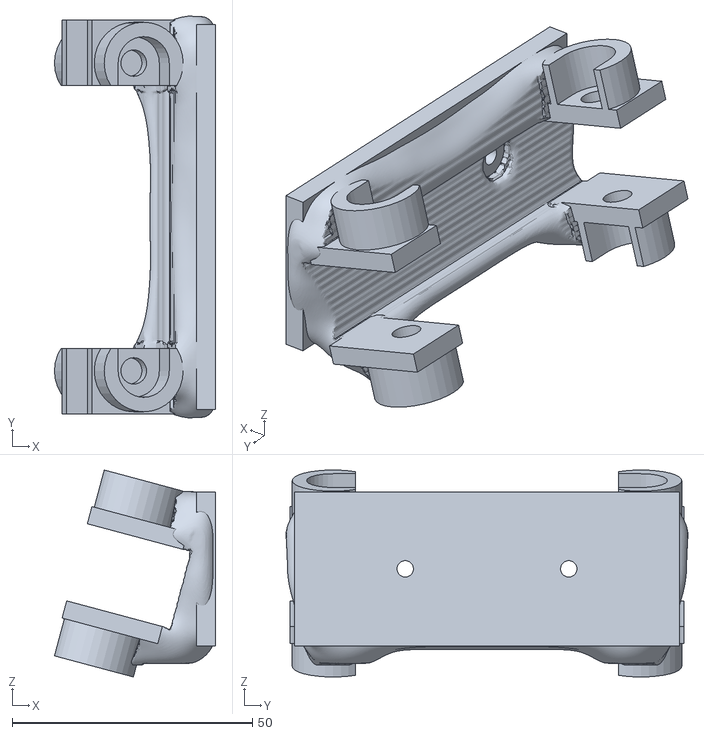
[picture p129: CAD file, 2026-10-23]
runs/bracket_jA/topo-v4/bracket_jA_view.stl
33.5 x 83.6 x 43.0
