sparkiscool/nox/runs/cage_nodes/v5/node_10/cage_node_10.stl

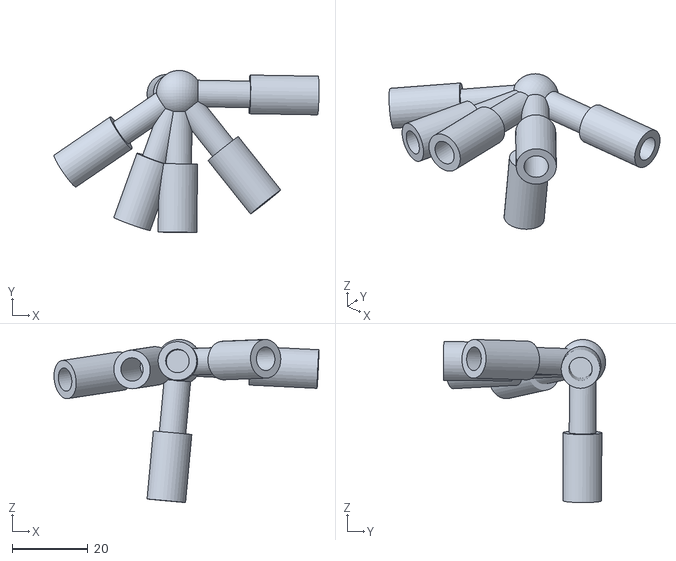
[picture p130: CAD file, 2026-10-28]
runs/cage_nodes/v5/node_10/cage_node_10.stl
69.8 x 42.7 x 43.0
