sparkiscool/nox/runs/cage_nodes/v5/node_11/cage_node_11.stl

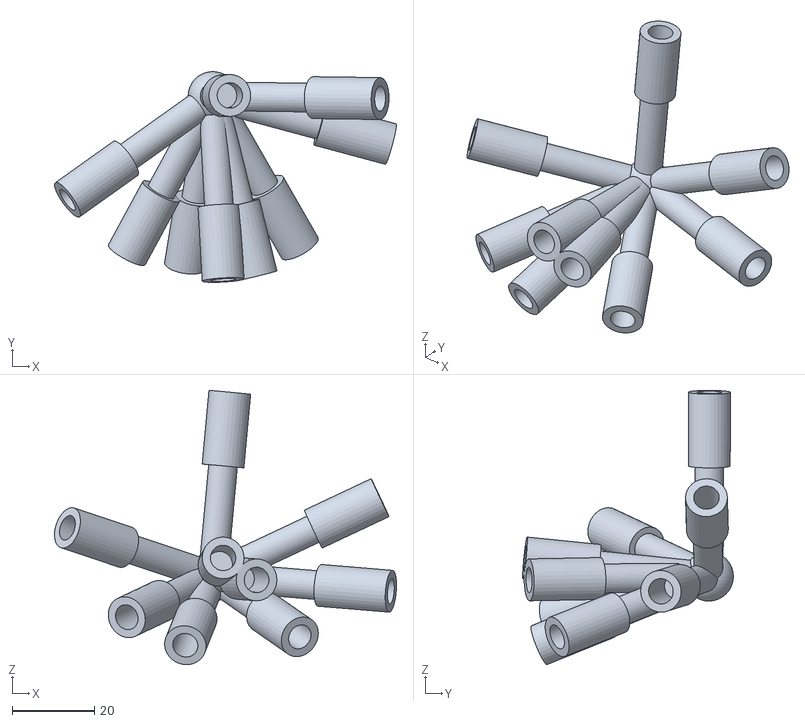
[picture p131: CAD file, 2026-10-28]
runs/cage_nodes/v5/node_11/cage_node_11.stl
83.2 x 51.3 x 66.7
