sparkiscool/nox/runs/cage_nodes/v5/node_13/cage_node_13.stl

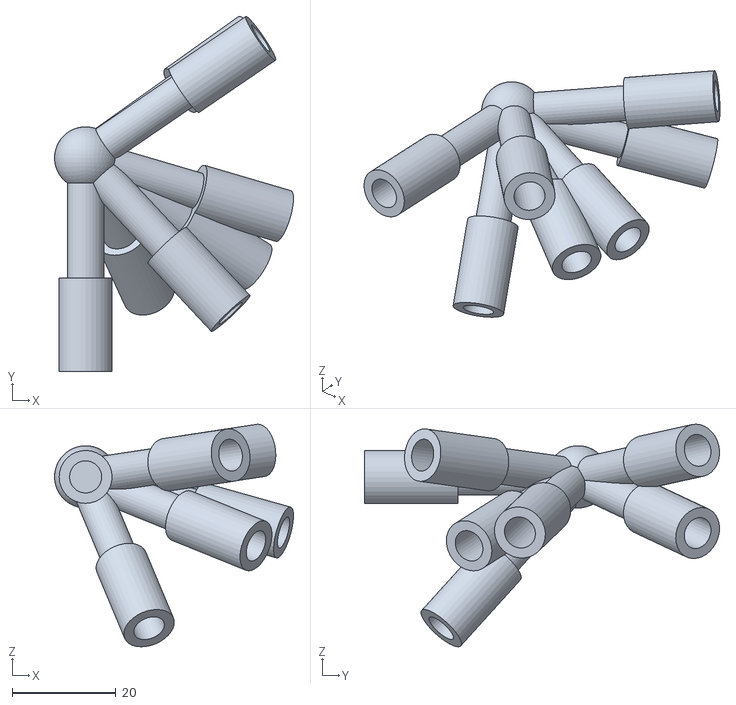
[picture p132: CAD file, 2026-10-28]
runs/cage_nodes/v5/node_13/cage_node_13.stl
46.1 x 68.4 x 42.9
