sparkiscool/nox/runs/cage_nodes/v5/node_15/cage_node_15.stl

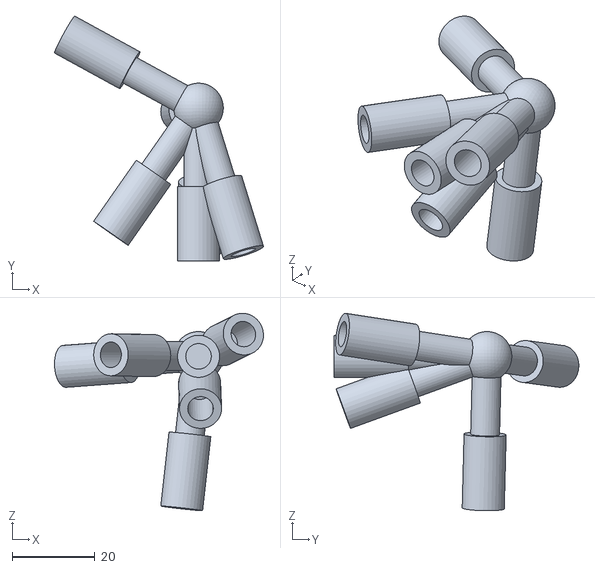
[picture p133: CAD file, 2026-10-28]
runs/cage_nodes/v5/node_15/cage_node_15.stl
50.6 x 59.2 x 47.8
