sparkiscool/nox/runs/cage_nodes/v5/node_17/cage_node_17.stl

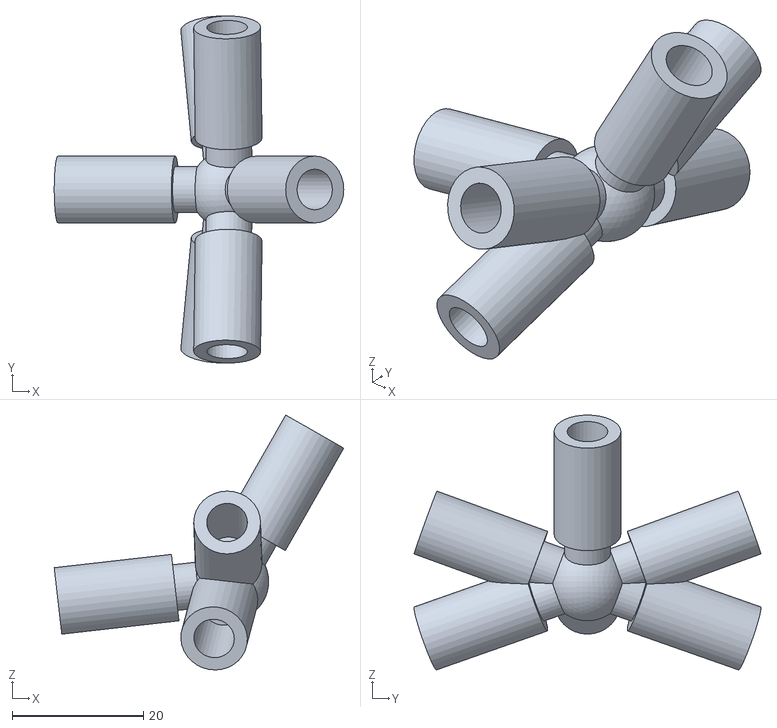
[picture p134: CAD file, 2026-10-28]
runs/cage_nodes/v5/node_17/cage_node_17.stl
44.2 x 52.9 x 38.9
