sparkiscool/nox/runs/cage_nodes/v5/node_18/cage_node_18.stl

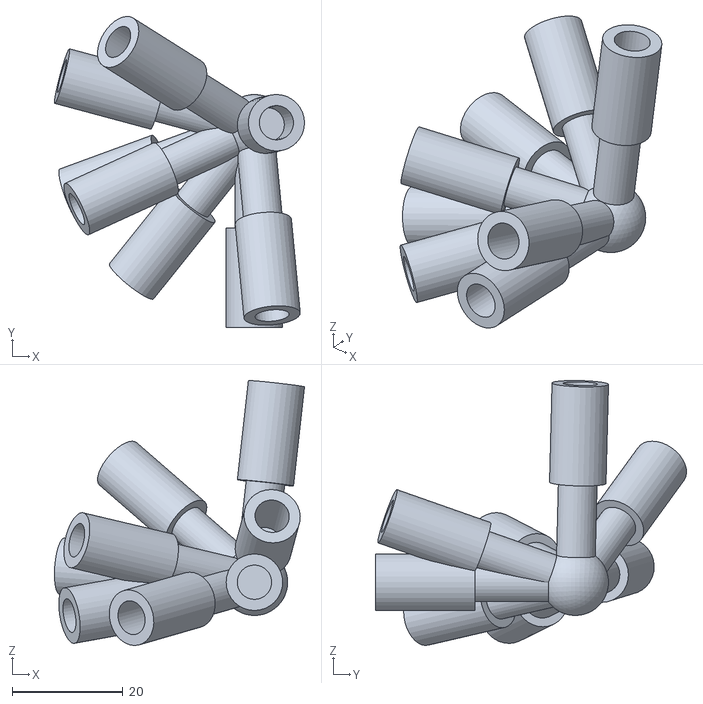
[picture p135: CAD file, 2026-10-28]
runs/cage_nodes/v5/node_18/cage_node_18.stl
45.1 x 56.1 x 47.8
