sparkiscool/nox/runs/cage_nodes/v5/node_2/cage_node_2.stl

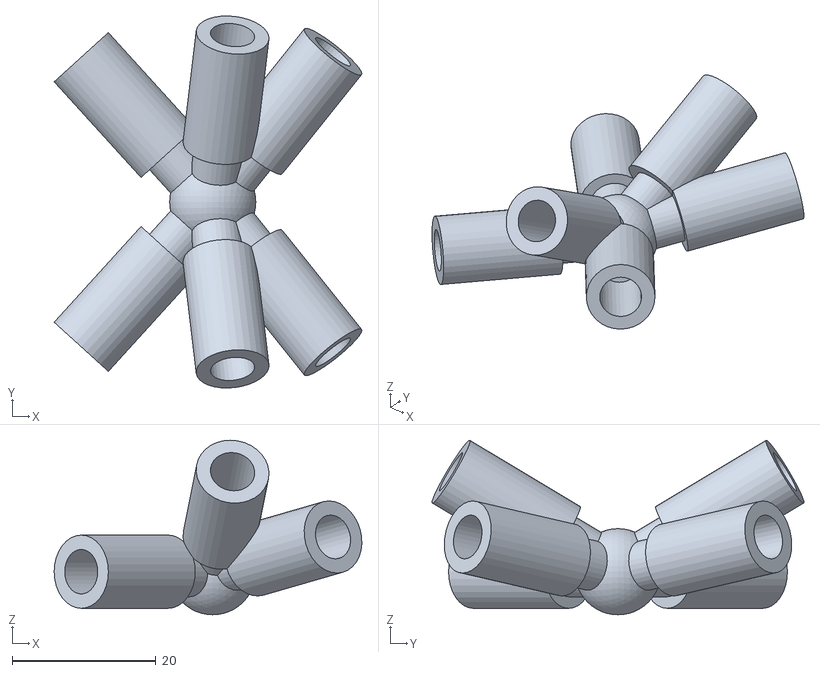
[picture p136: CAD file, 2026-10-28]
runs/cage_nodes/v5/node_2/cage_node_2.stl
42.9 x 51.8 x 24.3
