sparkiscool/nox/runs/cage_nodes/v5/node_20/cage_node_20.stl

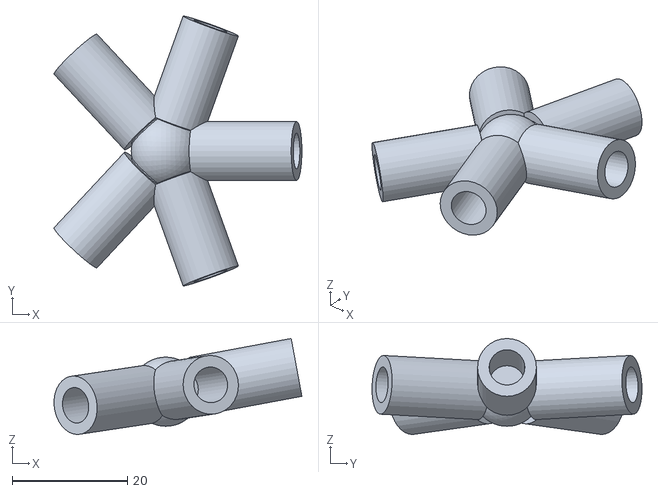
[picture p137: CAD file, 2026-10-28]
runs/cage_nodes/v5/node_20/cage_node_20.stl
43.0 x 46.8 x 16.7
