sparkiscool/nox/runs/cage_nodes/v5/node_21/cage_node_21.stl

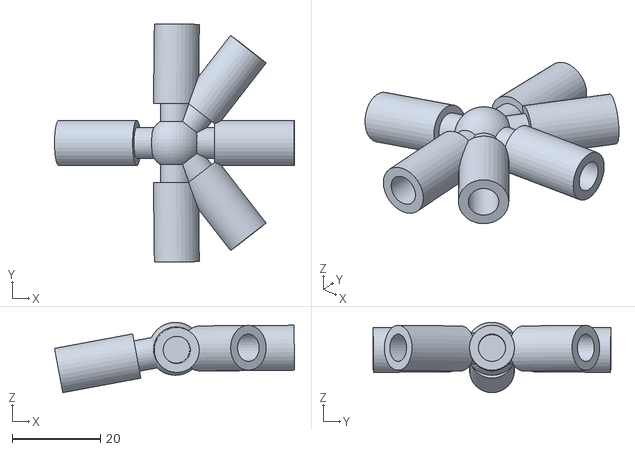
[picture p138: CAD file, 2026-10-28]
runs/cage_nodes/v5/node_21/cage_node_21.stl
54.3 x 54.0 x 15.9
