sparkiscool/nox/runs/cage_nodes/v5/node_23/cage_node_23.stl

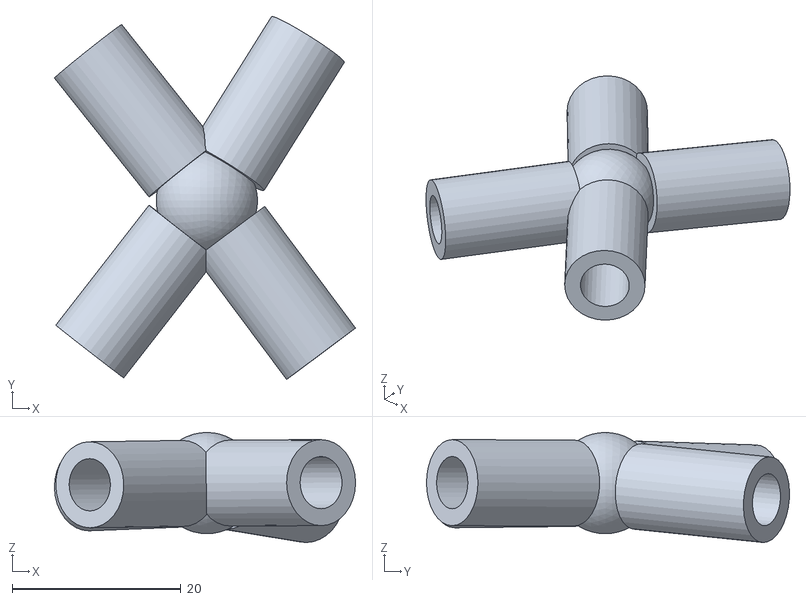
[picture p139: CAD file, 2026-10-28]
runs/cage_nodes/v5/node_23/cage_node_23.stl
35.7 x 43.0 x 13.0
