sparkiscool/nox/runs/cage_nodes/v5/node_3/cage_node_3.stl

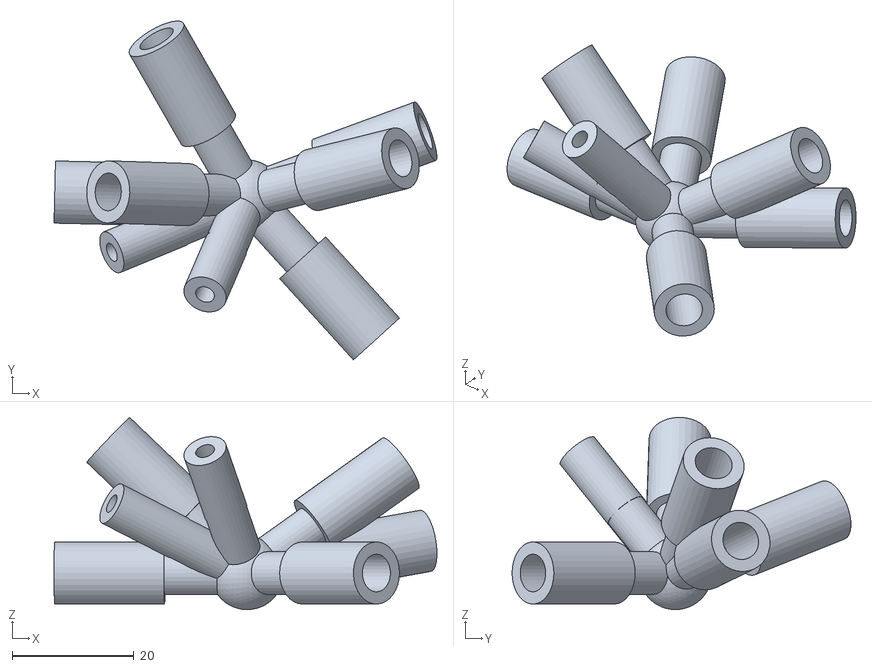
[picture p140: CAD file, 2026-10-28]
runs/cage_nodes/v5/node_3/cage_node_3.stl
62.8 x 55.6 x 31.5
