sparkiscool/nox/runs/cage_nodes/v5/node_4/cage_node_4.stl

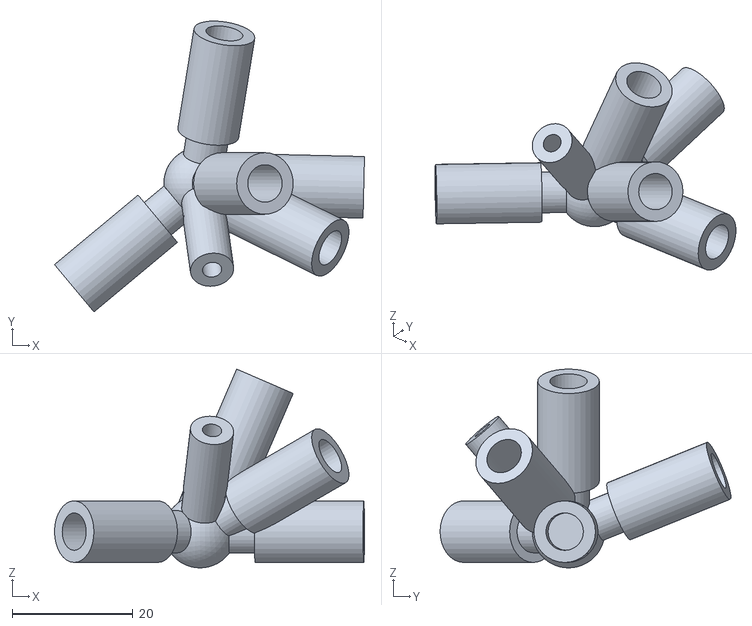
[picture p141: CAD file, 2026-10-28]
runs/cage_nodes/v5/node_4/cage_node_4.stl
51.3 x 48.2 x 32.9
