sparkiscool/nox/runs/cage_nodes/v5/node_5/cage_node_5.stl

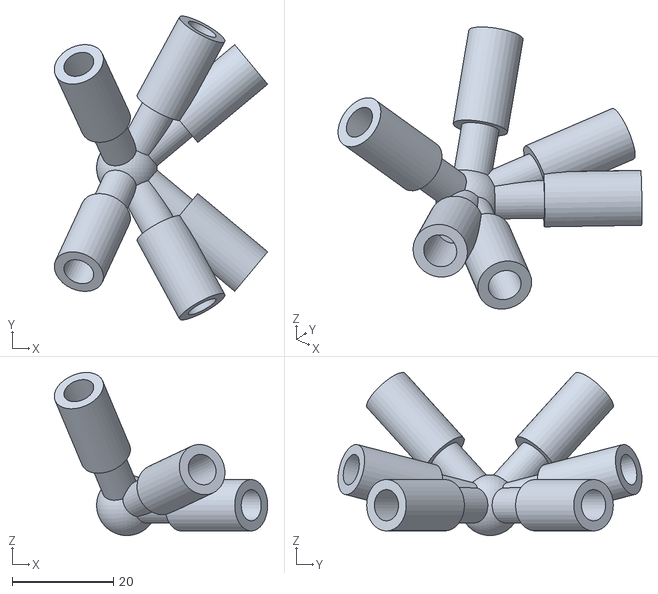
[picture p142: CAD file, 2026-10-28]
runs/cage_nodes/v5/node_5/cage_node_5.stl
42.2 x 60.2 x 32.3
