sparkiscool/nox/runs/cage_nodes/v5/node_6/cage_node_6.stl

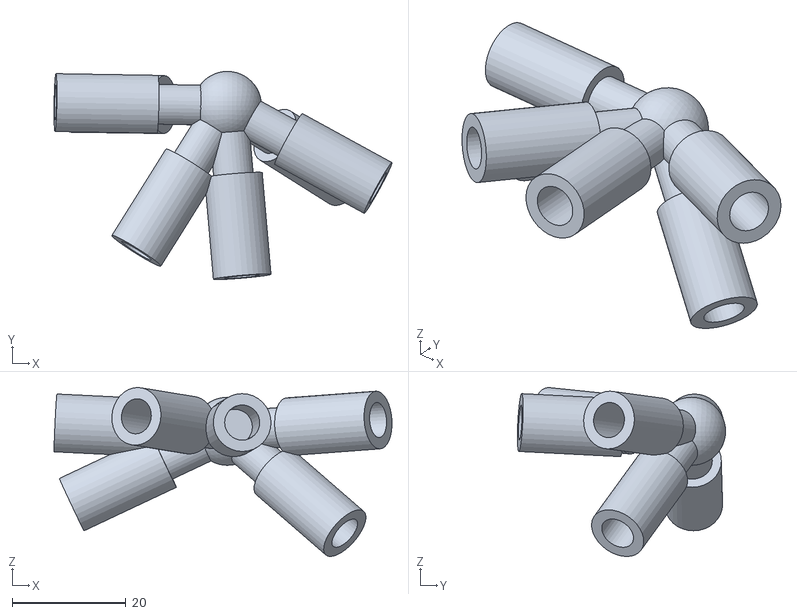
[picture p143: CAD file, 2026-10-28]
runs/cage_nodes/v5/node_6/cage_node_6.stl
59.6 x 36.7 x 29.8
