sparkiscool/nox/runs/cage_nodes/v5/node_7/cage_node_7.stl

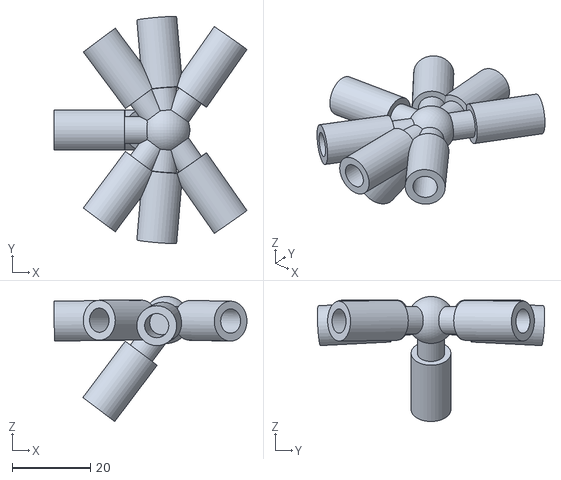
[picture p144: CAD file, 2026-10-28]
runs/cage_nodes/v5/node_7/cage_node_7.stl
49.3 x 58.0 x 31.9
