sparkiscool/nox/runs/detent/v6/box_detent_arm_v3.stl

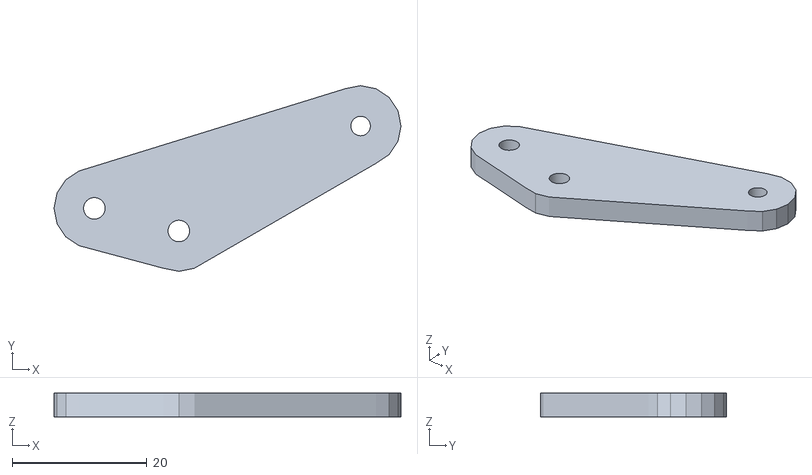
[picture p145: CAD file, 2026-10-24]
runs/detent/v6/box_detent_arm_v3.stl
51.6 x 27.6 x 3.50
