sparkiscool/nox/runs/funnel_panel/v7/box_funnel_panel_B_v7.stl

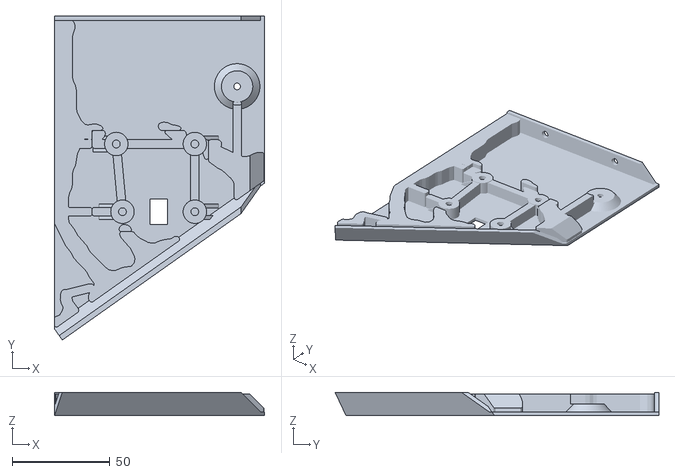
[picture p146: CAD file, 2026-10-24]
runs/funnel_panel/v7/box_funnel_panel_B_v7.stl
107.3 x 165.6 x 12.0
