sparkiscool/nox/runs/funnel_panel/v7/v6_gate/funnel_panel_B_v6.stl

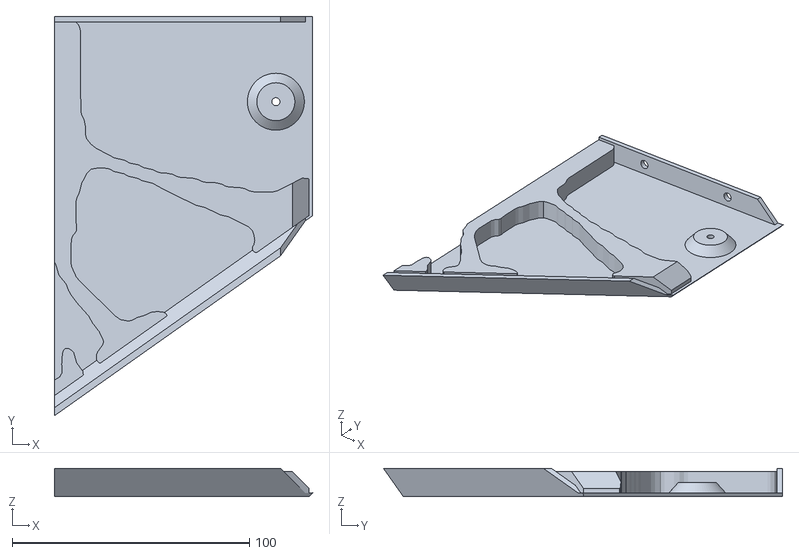
[picture p147: CAD file, 2026-10-24]
runs/funnel_panel/v7/v6_gate/funnel_panel_B_v6.stl
108.8 x 168.4 x 12.0
