sparkiscool/nox/runs/funnel_panel/v9_plain/box_funnel_panel_B_v9_plain_nx.stl

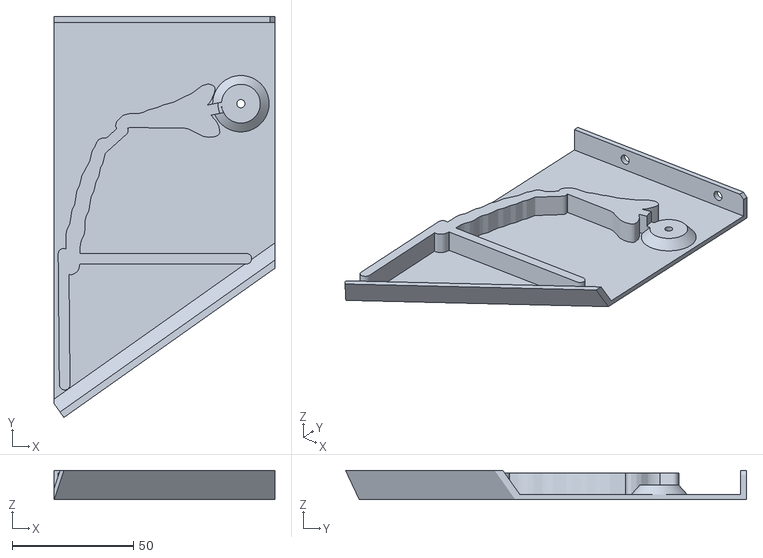
[picture p148: CAD file, 2026-10-24]
runs/funnel_panel/v9_plain/box_funnel_panel_B_v9_plain_nx.stl
91.1 x 165.6 x 12.0
