sparkiscool/nox/runs/holder/organic-v12/holder.stl

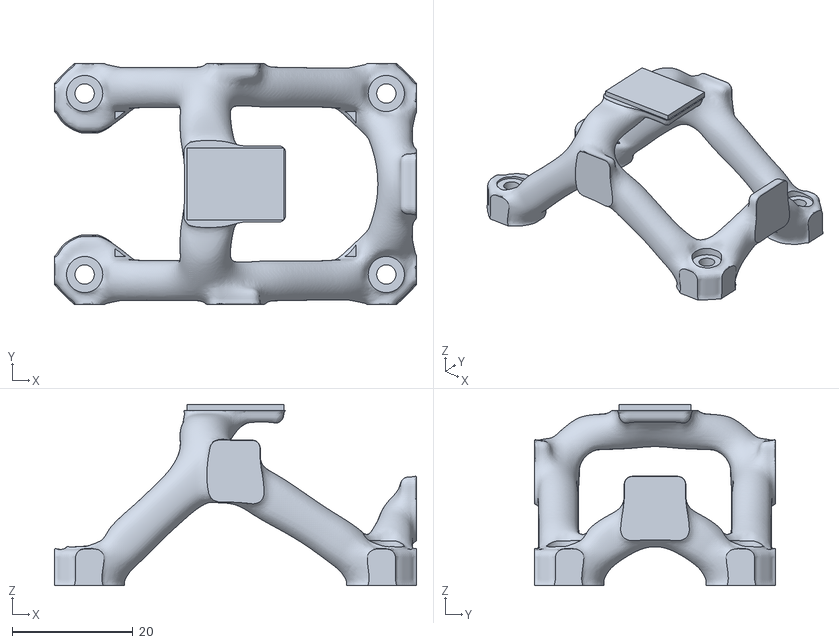
[picture p149: CAD file, 2026-10-24]
runs/holder/organic-v12/holder.stl
60.0 x 40.0 x 30.0
