sparkiscool/nox/runs/holder/topo-v1/holder.stl

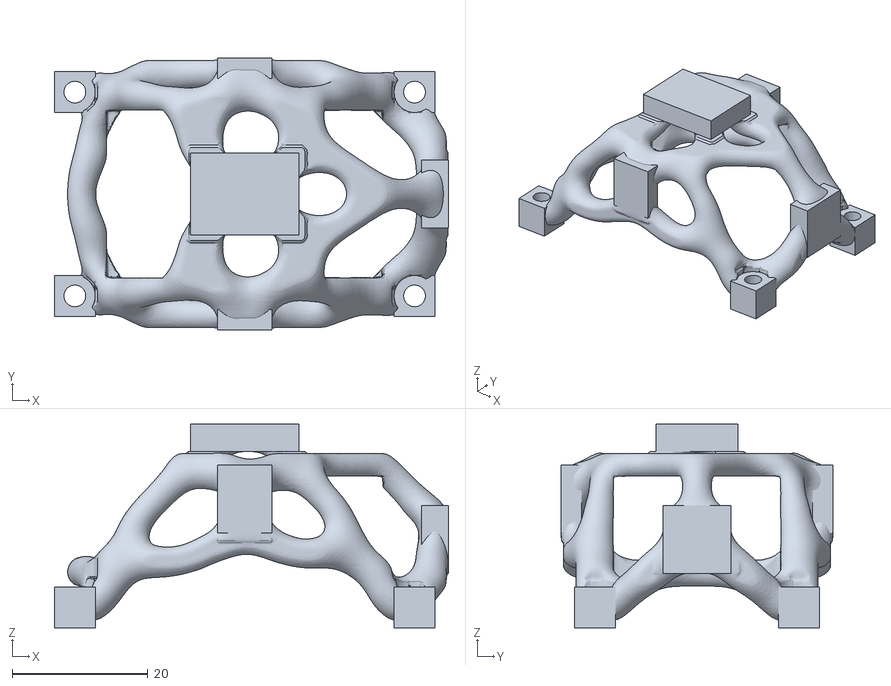
[picture p150: CAD file, 2026-10-23]
runs/holder/topo-v1/holder.stl
58.0 x 40.0 x 30.0
