sparkiscool/nox/runs/hook_latch/v2/box_hook_latch_plunger_A_v2.stl

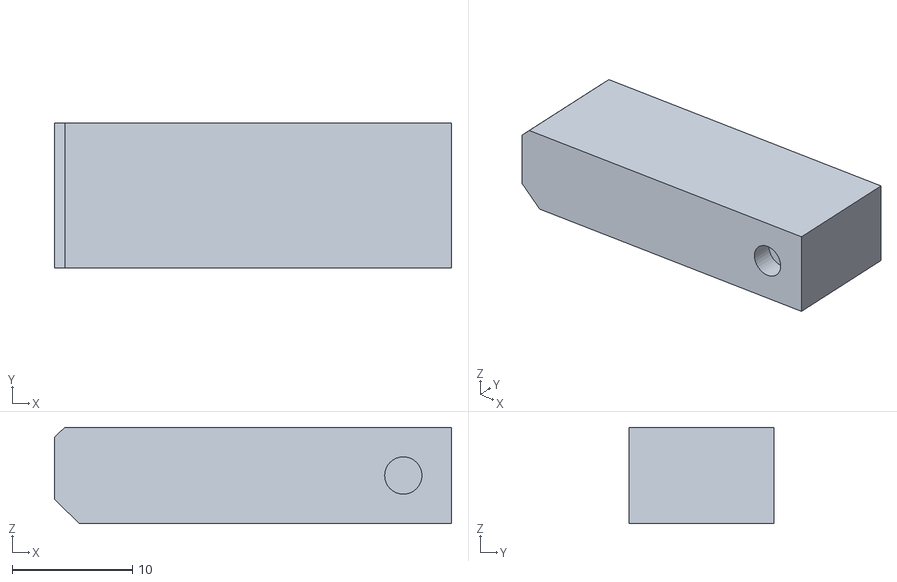
[picture p151: CAD file, 2026-10-24]
runs/hook_latch/v2/box_hook_latch_plunger_A_v2.stl
33.0 x 12.0 x 8.00
