sparkiscool/nox/runs/hub/v7/box_hub_v7_view.stl

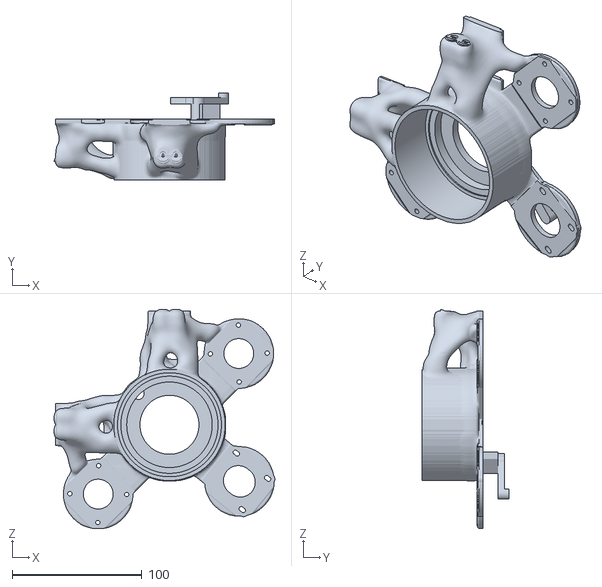
[picture p152: CAD file, 2026-10-24]
runs/hub/v7/box_hub_v7_view.stl
170.6 x 66.9 x 169.3
