sparkiscool/nox/runs/motor_mount/organic-v2/motor_mount_view.stl

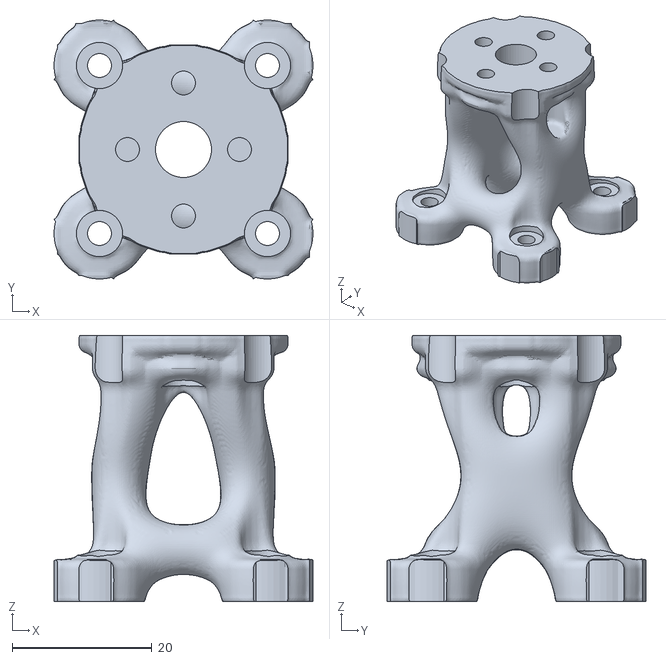
[picture p153: CAD file, 2026-10-24]
runs/motor_mount/organic-v2/motor_mount_view.stl
37.0 x 37.0 x 38.0
