sparkiscool/nox/runs/motor_mount/topo-v3/motor_mount_view.stl

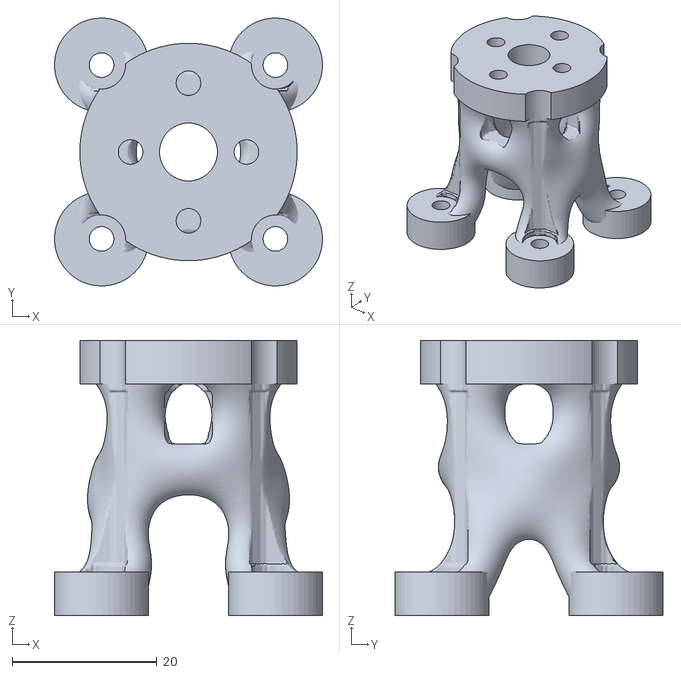
[picture p154: CAD file, 2026-10-23]
runs/motor_mount/topo-v3/motor_mount_view.stl
37.0 x 37.0 x 38.0
