sparkiscool/nox/runs/overseer_arm_rear/v5d/overseer_arm_rear.stl

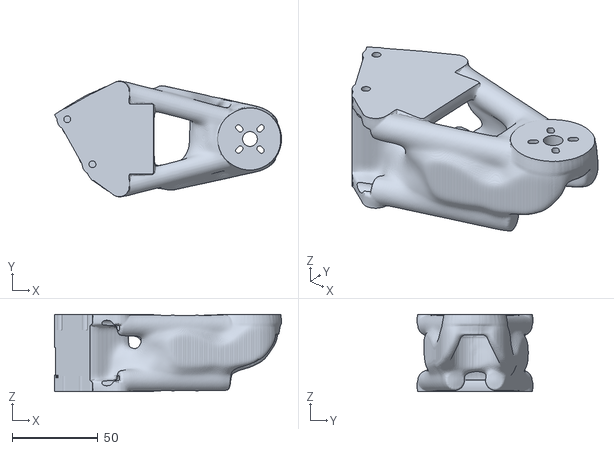
[picture p155: CAD file, 2026-10-27]
runs/overseer_arm_rear/v5d/overseer_arm_rear.stl
132.1 x 67.4 x 45.0
