sparkiscool/nox/runs/overseer_arms/v5d/place/arm_2_drone_frame.stl

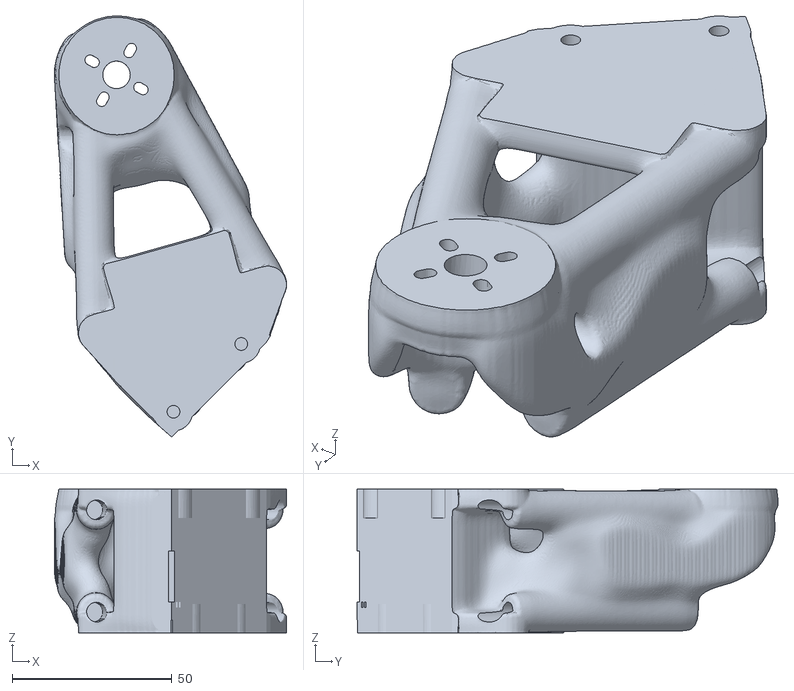
[picture p156: CAD file, 2026-10-27]
runs/overseer_arms/v5d/place/arm_2_drone_frame.stl
72.7 x 131.8 x 45.0
