sparkiscool/nox/runs/overseer_assembly/v0/front_camera.stl

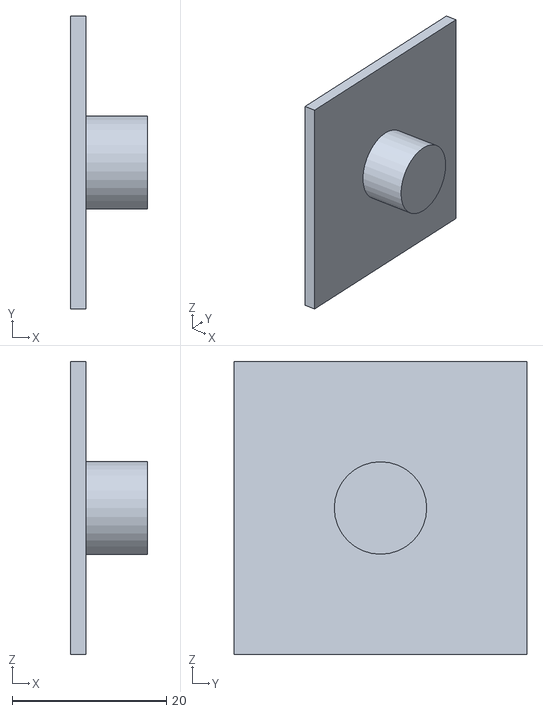
[picture p157: CAD file, 2026-10-24]
runs/overseer_assembly/v0/front_camera.stl
10.0 x 38.0 x 38.0
