sparkiscool/nox/runs/overseer_core/v4/parts/sensor_head_mount_without_front_hub.stl

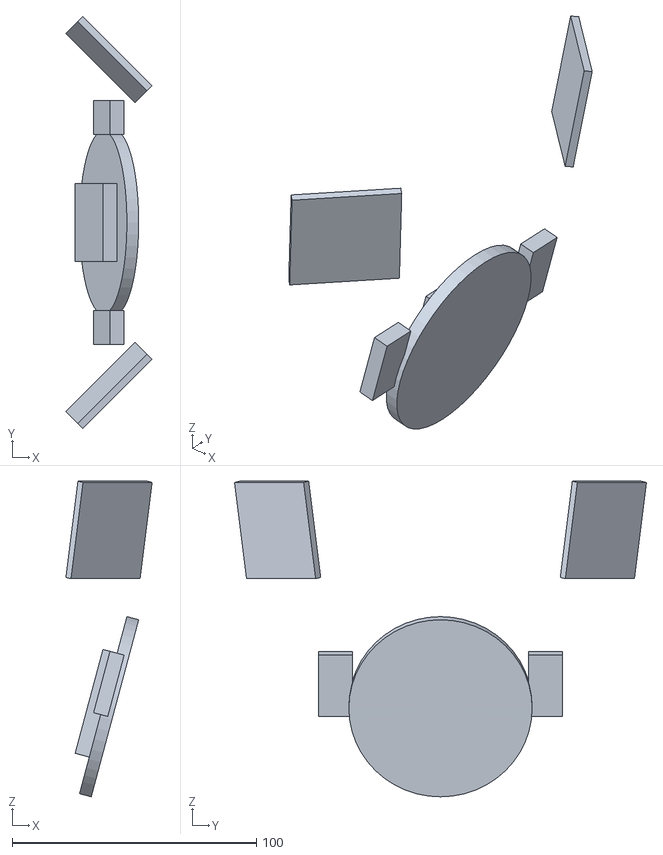
[picture p158: CAD file, 2026-10-28]
runs/overseer_core/v4/parts/sensor_head_mount_without_front_hub.stl
35.3 x 168.6 x 129.2
