sparkiscool/nox/runs/overseer_hub_deck/v12/overseer_hub_deck.stl

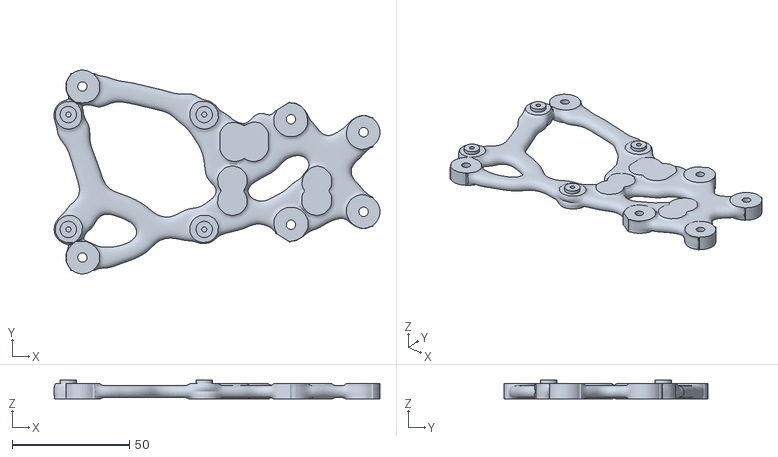
[picture p159: CAD file, 2026-10-28]
runs/overseer_hub_deck/v12/overseer_hub_deck.stl
139.1 x 87.0 x 8.00
