sparkiscool/nox/runs/overseer_layout/v5/parts/prop_2.stl

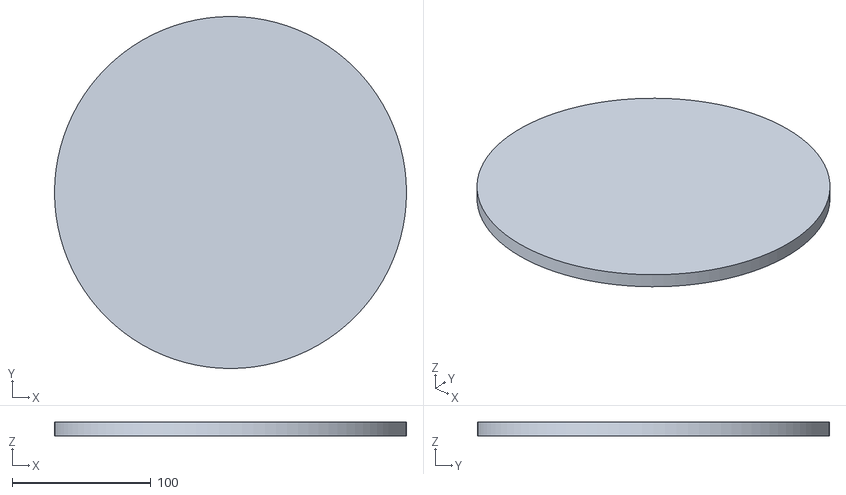
[picture p160: CAD file, 2026-10-28]
runs/overseer_layout/v5/parts/prop_2.stl
254.0 x 254.0 x 10.0
