sparkiscool/nox/runs/scan_stick/v13/scan_stick_head.stl

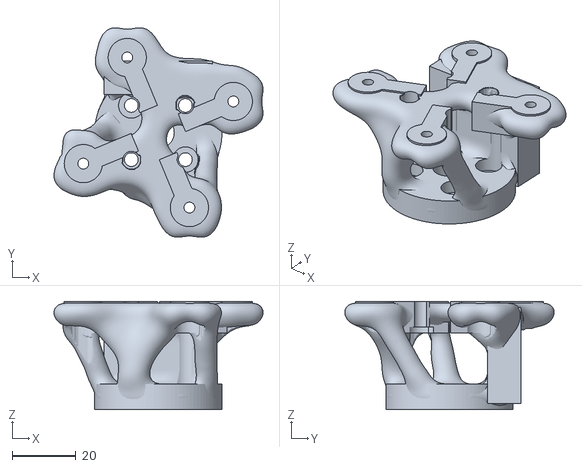
[picture p161: CAD file, 2026-10-23]
runs/scan_stick/v13/scan_stick_head.stl
65.6 x 65.7 x 34.0
