sparkiscool/nox/runs/scan_stick_base/v17/scan_stick_base_view.stl

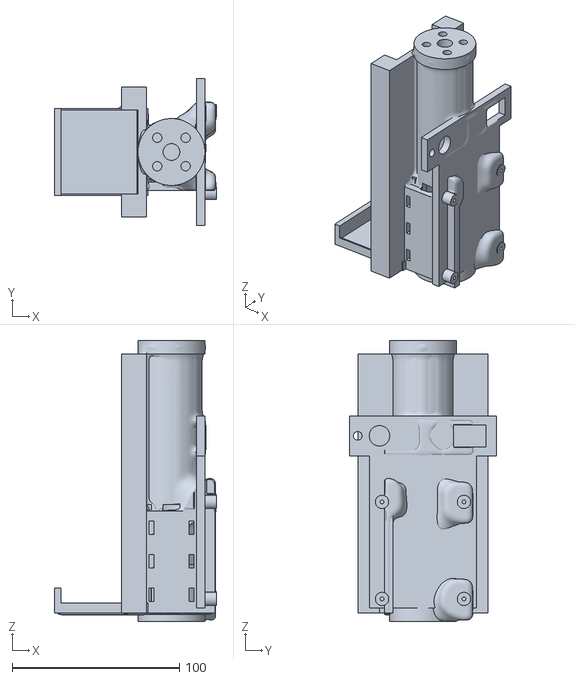
[picture p162: CAD file, 2026-10-23]
runs/scan_stick_base/v17/scan_stick_base_view.stl
97.0 x 88.0 x 168.0
