sparkiscool/nox/runs/scan_stick_cam/v7/scan_stick_cam_view.stl

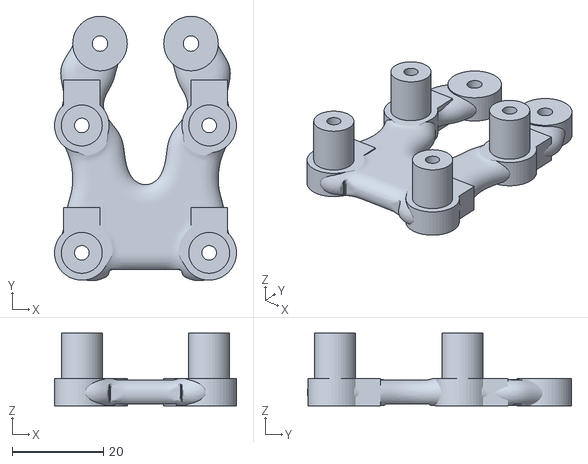
[picture p163: CAD file, 2026-10-24]
runs/scan_stick_cam/v7/scan_stick_cam_view.stl
40.0 x 58.1 x 16.0
