sparkiscool/nox/runs/scout_belly_mount/v1/belly_mount__petg_.stl

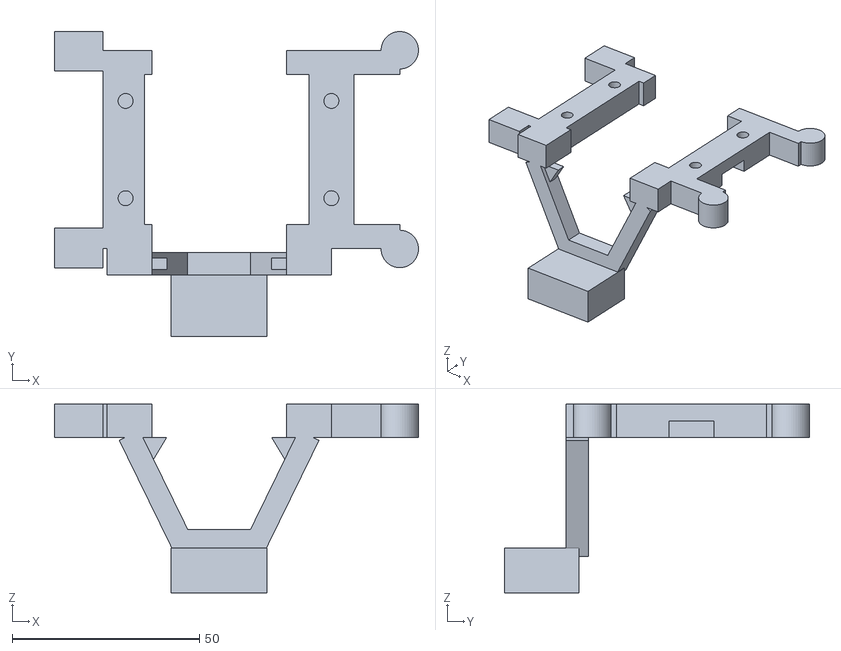
[picture p164: CAD file, 2026-10-27]
runs/scout_belly_mount/v1/belly_mount__petg_.stl
97.3 x 81.6 x 50.5
