sparkiscool/nox/runs/scout_electronics/v2/tail_carrier__petg_.stl

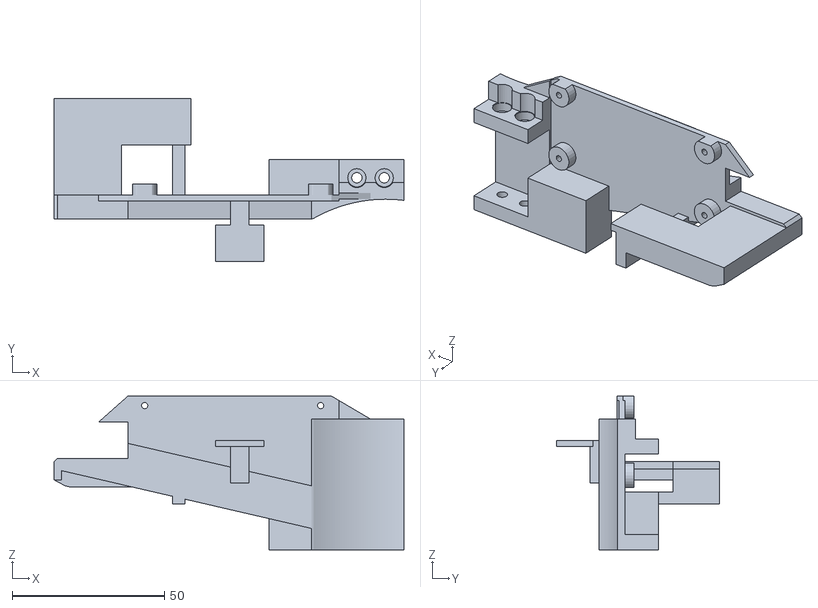
[picture p165: CAD file, 2026-10-27]
runs/scout_electronics/v2/tail_carrier__petg_.stl
115.1 x 53.6 x 50.5
