sparkiscool/nox/runs/scout_layout/v13/parts/cage_shell_tubes.stl

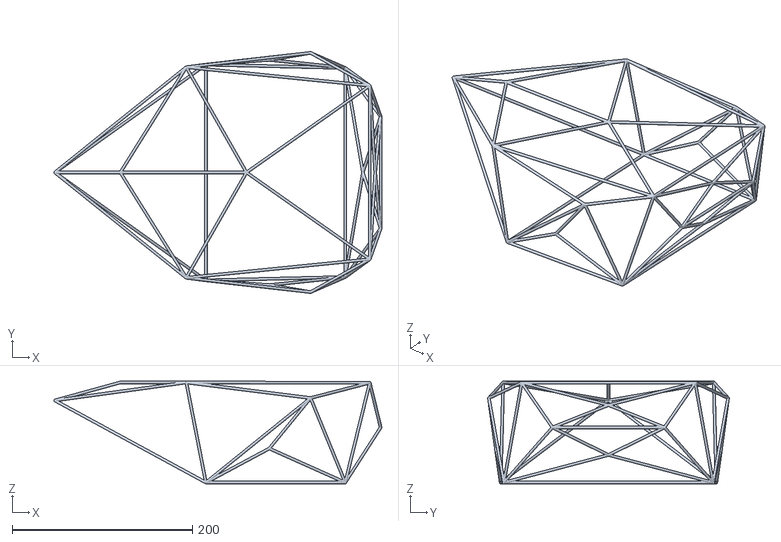
[picture p166: CAD file, 2026-10-28]
runs/scout_layout/v13/parts/cage_shell_tubes.stl
364.1 x 268.5 x 114.1
