sparkiscool/nox/runs/arm/v7/asm/rec-60.stl

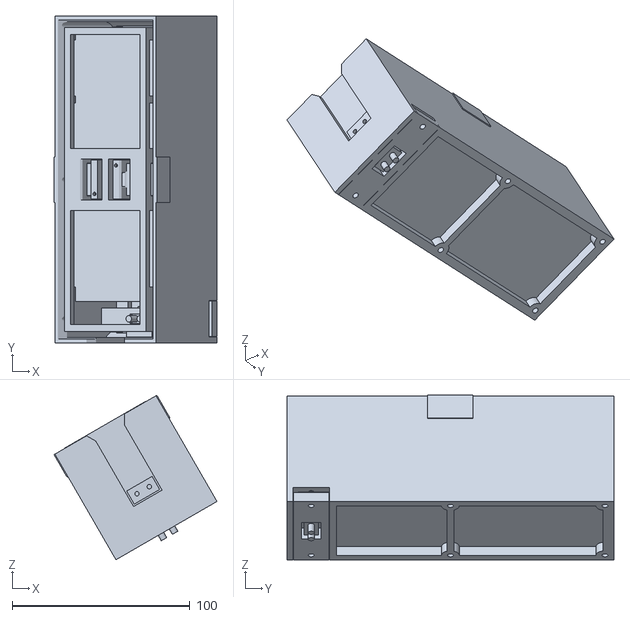
[picture p167: CAD file, 2026-10-24]
runs/arm/v7/asm/rec-60.stl
91.6 x 183.6 x 92.5
