sparkiscool/nox/runs/arm/v7/asm_overseer/gripB.stl

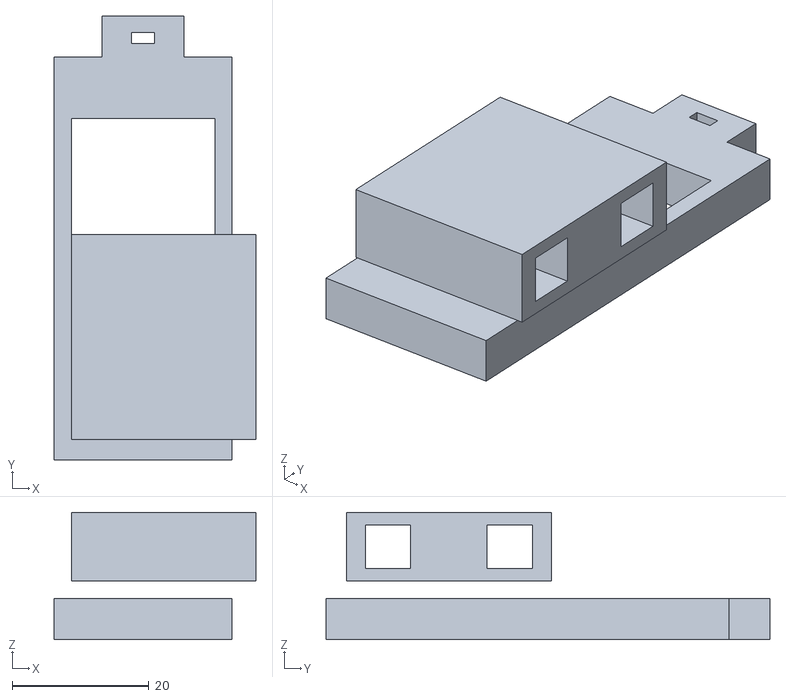
[picture p168: CAD file, 2026-10-24]
runs/arm/v7/asm_overseer/gripB.stl
29.5 x 65.0 x 18.6
