sparkiscool/nox/runs/arm_v6_parts/arm_rail_B_v2_W.stl

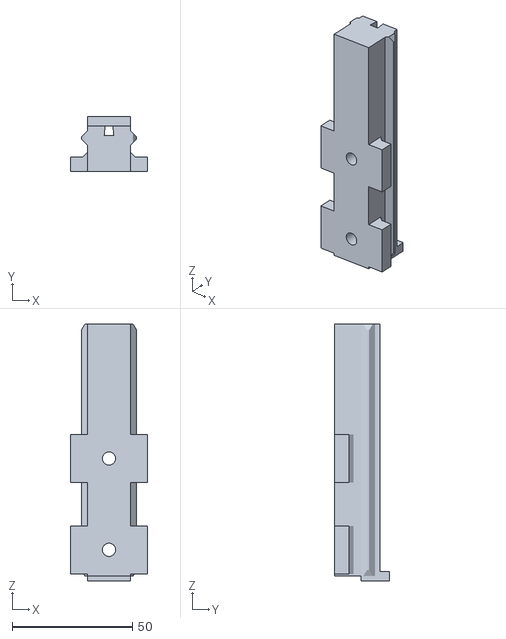
[picture p169: CAD file, 2026-10-24]
runs/arm_v6_parts/arm_rail_B_v2_W.stl
32.0 x 23.0 x 107.0
