sparkiscool/nox/runs/battery_latch/v4/manifest_overseer/slider_px.stl

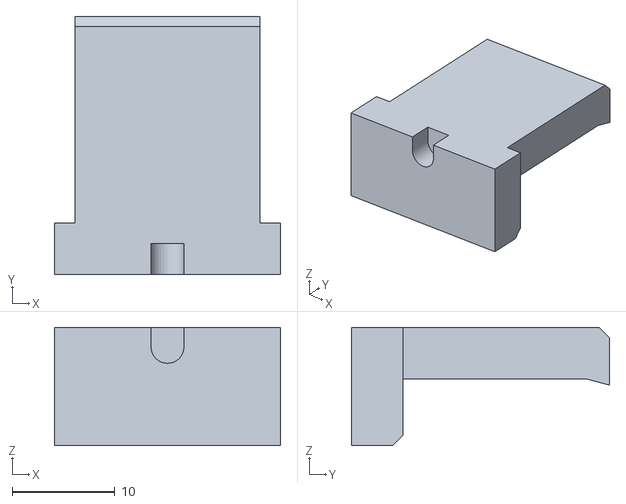
[picture p170: CAD file, 2026-10-24]
runs/battery_latch/v4/manifest_overseer/slider_px.stl
22.0 x 25.1 x 11.5
