sparkiscool/nox/runs/battery_latch/v4/manifest_scout/receiver_skid_tail.stl

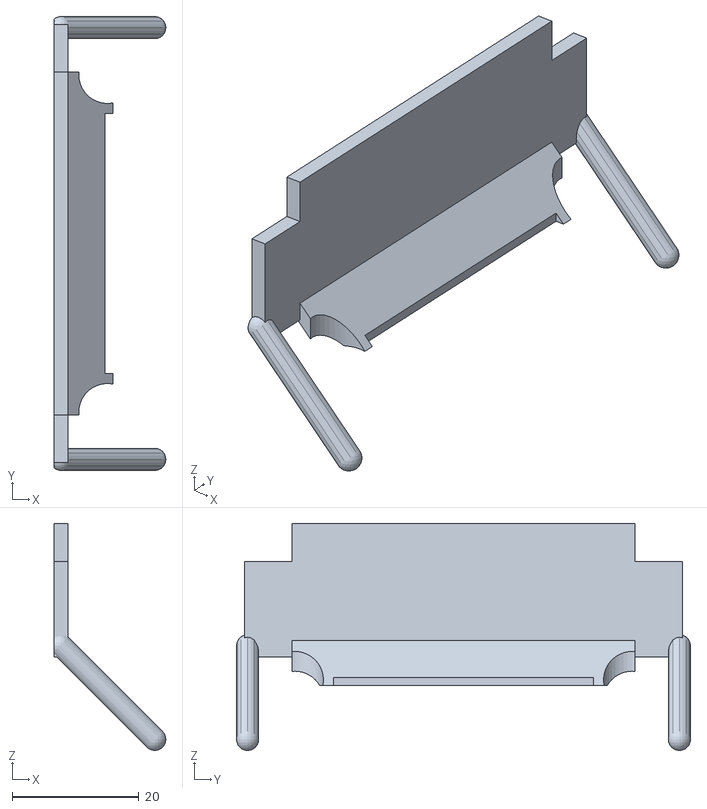
[picture p171: CAD file, 2026-10-24]
runs/battery_latch/v4/manifest_scout/receiver_skid_tail.stl
17.6 x 71.5 x 35.8
