sparkiscool/nox/runs/battery_latch/v4/stl/box_battery_skid_lead_scout_v2.stl

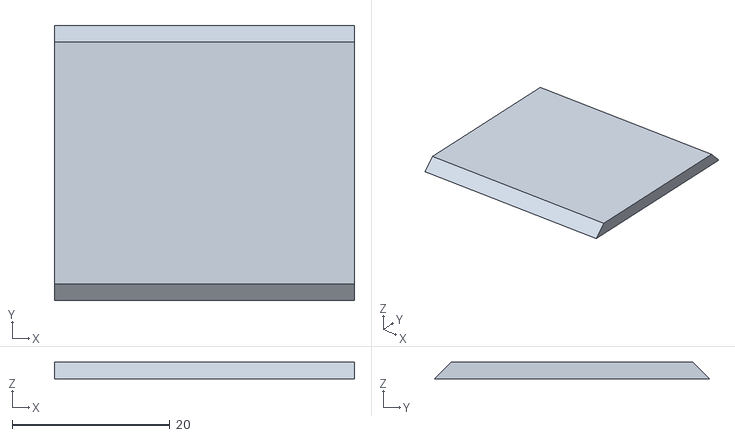
[picture p172: CAD file, 2026-10-24]
runs/battery_latch/v4/stl/box_battery_skid_lead_scout_v2.stl
38.0 x 34.9 x 2.12
