sparkiscool/nox/runs/box_catch_assembly/v2/probe_pin_u12_free_seat.stl

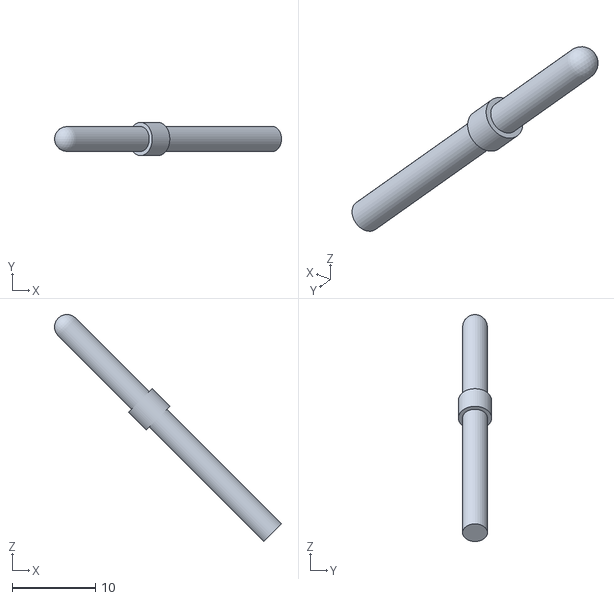
[picture p173: CAD file, 2026-10-24]
runs/box_catch_assembly/v2/probe_pin_u12_free_seat.stl
27.3 x 4.00 x 27.3
