sparkiscool/nox/runs/box_system/v2/latch_ctx/scout_receiver_c.stl

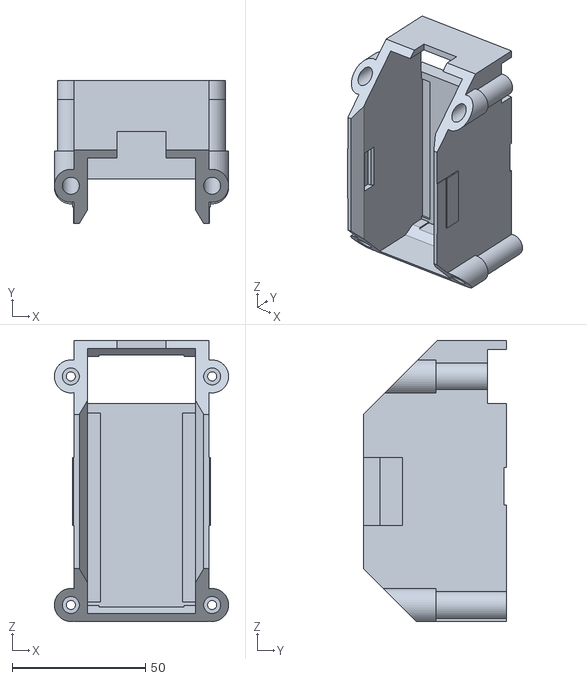
[picture p174: CAD file, 2026-10-24]
runs/box_system/v2/latch_ctx/scout_receiver_c.stl
65.5 x 53.9 x 105.6
