sparkiscool/nox/runs/box_system/v2/layout/parts/bay-90_body_envelope.stl

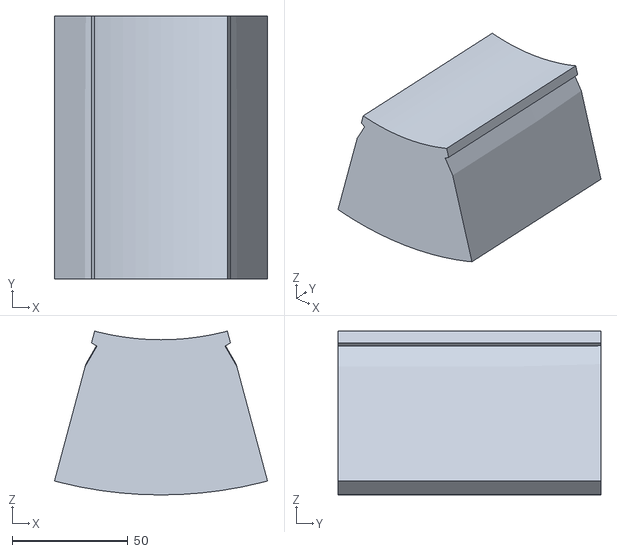
[picture p175: CAD file, 2026-10-24]
runs/box_system/v2/layout/parts/bay-90_body_envelope.stl
92.1 x 113.6 x 70.9
