sparkiscool/nox/runs/box_system/v2/layout_bottom/mount_pads_W.stl

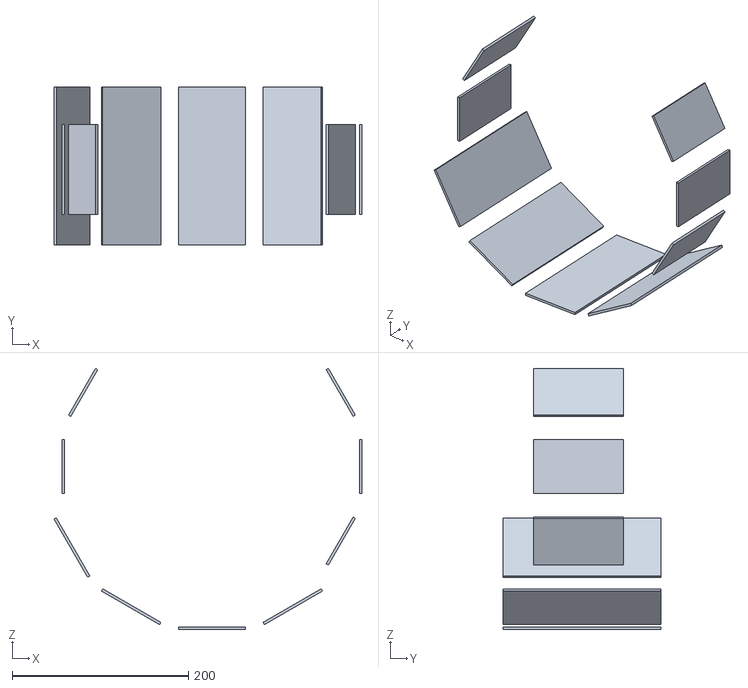
[picture p176: CAD file, 2026-10-24]
runs/box_system/v2/layout_bottom/mount_pads_W.stl
349.2 x 179.6 x 296.4
