sparkiscool/nox/runs/box_system/v2/layout_R128_bottom/mount_pads_W.stl

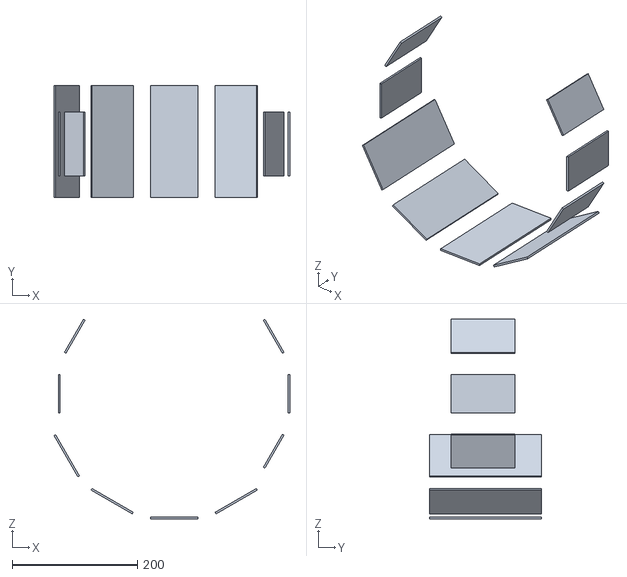
[picture p177: CAD file, 2026-10-24]
runs/box_system/v2/layout_R128_bottom/mount_pads_W.stl
377.2 x 179.6 x 318.9
