sparkiscool/nox/runs/box_system/v2/layout_R128_bottom/parts/bay-120_body_envelope.stl

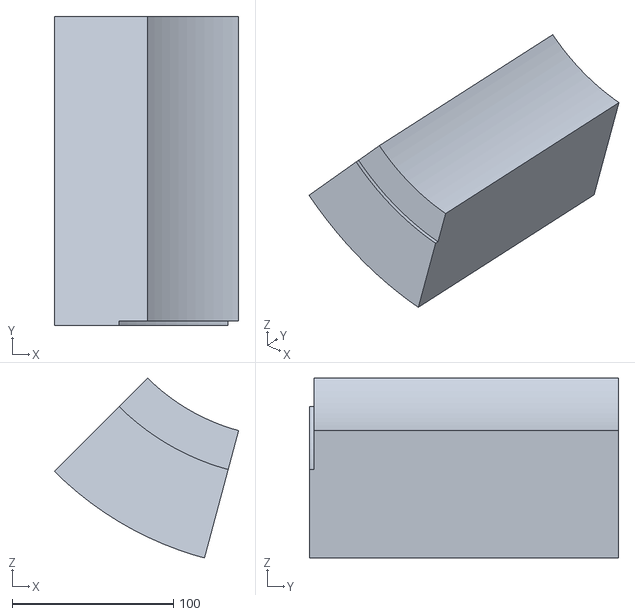
[picture p178: CAD file, 2026-10-24]
runs/box_system/v2/layout_R128_bottom/parts/bay-120_body_envelope.stl
114.3 x 191.6 x 111.5
