sparkiscool/nox/runs/funnel_panel/v7/collar_v7_seat_frame.stl

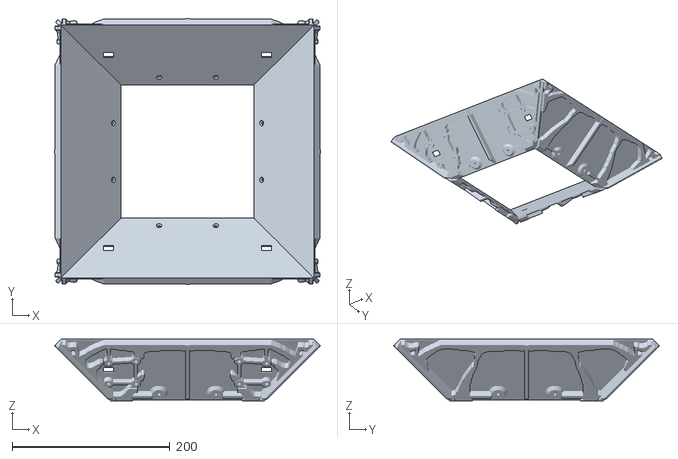
[picture p179: CAD file, 2026-10-24]
runs/funnel_panel/v7/collar_v7_seat_frame.stl
336.8 x 336.8 x 78.4
