sparkiscool/nox/runs/funnel_panel/v9_plain/collar_v9_seat_frame.stl

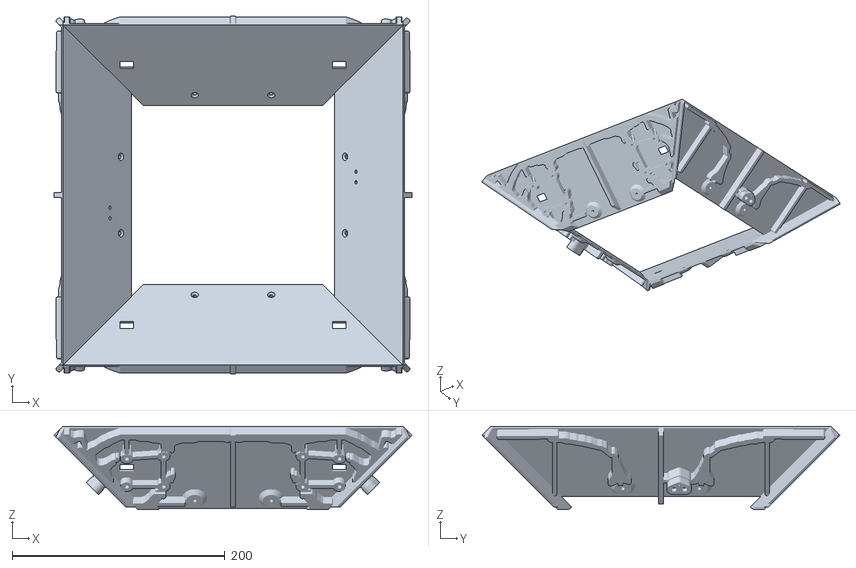
[picture p180: CAD file, 2026-10-24]
runs/funnel_panel/v9_plain/collar_v9_seat_frame.stl
336.8 x 336.8 x 78.4
