sparkiscool/nox/runs/hook_latch/v2/box_hook_latch_housing_B_v2.stl

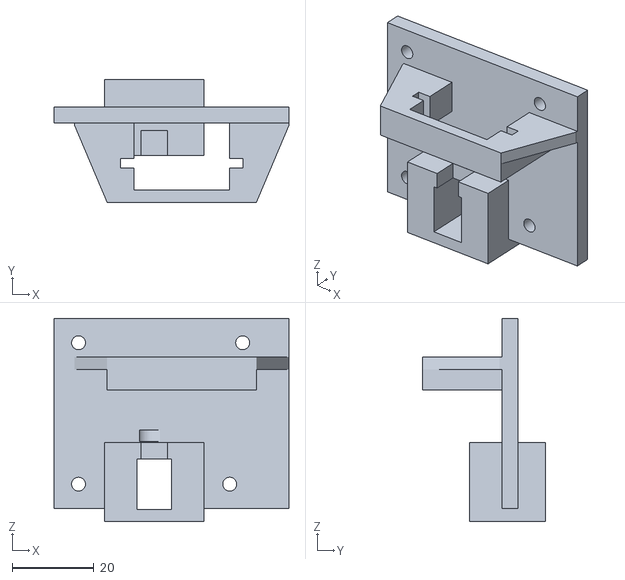
[picture p181: CAD file, 2026-10-24]
runs/hook_latch/v2/box_hook_latch_housing_B_v2.stl
57.5 x 30.1 x 49.8
