sparkiscool/nox/runs/overseer_arms/v5d/place/arm_1_drone_frame.stl

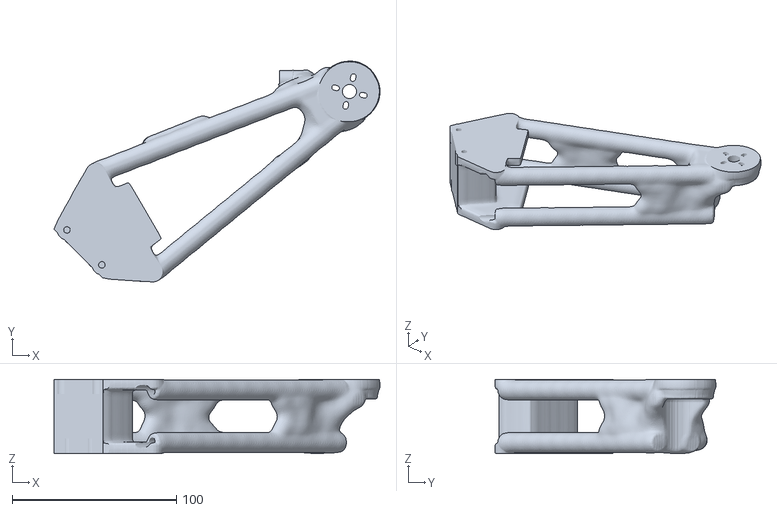
[picture p182: CAD file, 2026-10-27]
runs/overseer_arms/v5d/place/arm_1_drone_frame.stl
198.3 x 134.3 x 45.2
