sparkiscool/nox/runs/overseer_assembly/v0/cam_bracket.stl

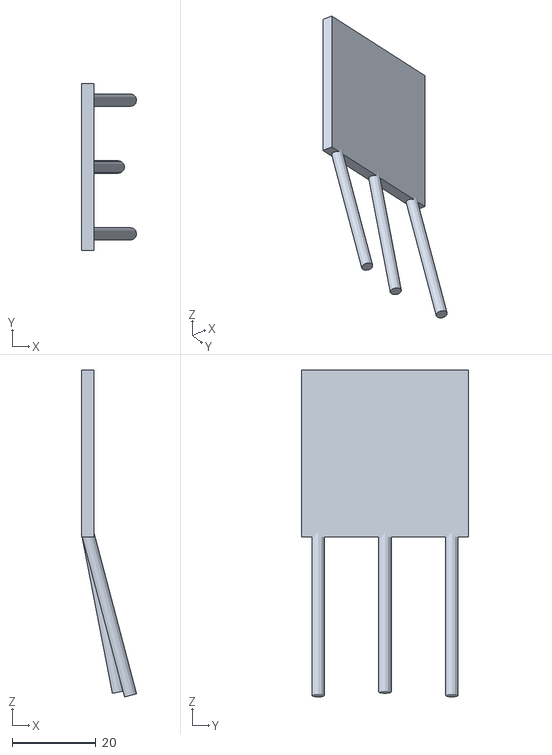
[picture p183: CAD file, 2026-10-24]
runs/overseer_assembly/v0/cam_bracket.stl
13.2 x 40.0 x 78.2
