sparkiscool/nox/runs/overseer_layout/v5/parts/motor_2.stl

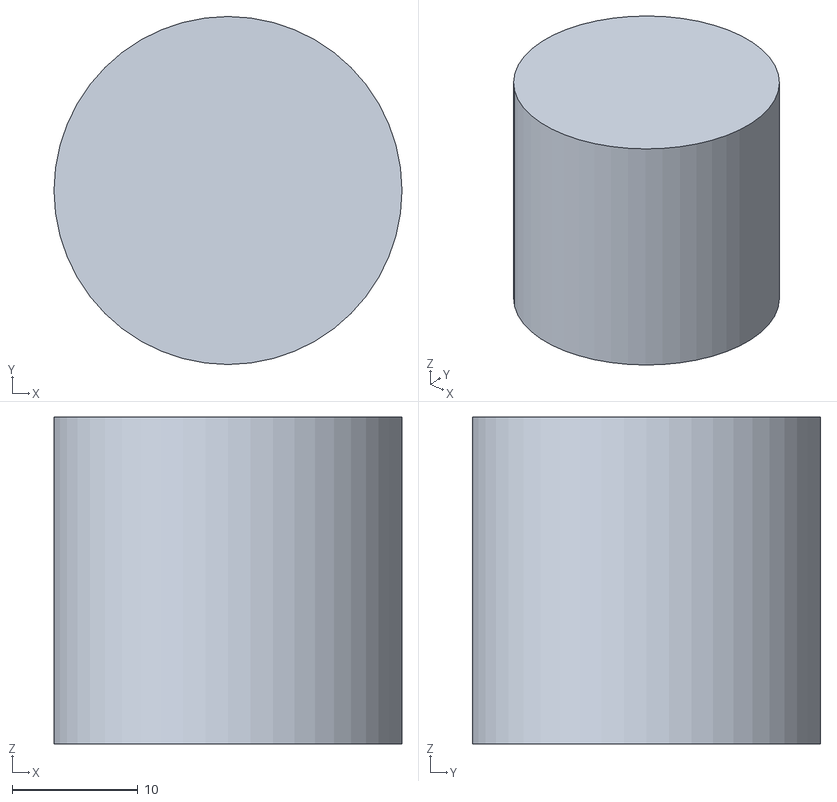
[picture p184: CAD file, 2026-10-28]
runs/overseer_layout/v5/parts/motor_2.stl
27.7 x 27.7 x 26.0
