sparkiscool/nox/runs/scout_electronics/v2/belly_mount_tail_block__petg_.stl

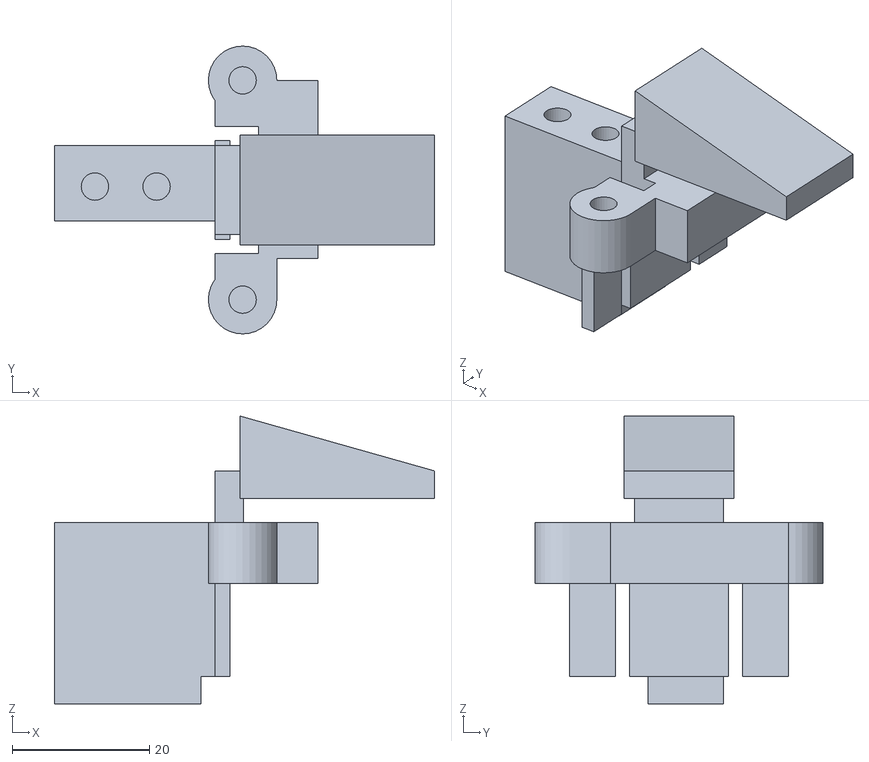
[picture p185: CAD file, 2026-10-27]
runs/scout_electronics/v2/belly_mount_tail_block__petg_.stl
55.4 x 42.0 x 42.0
