sparkiscool/nox/runs/scout_layout/v13/parts/spokes__bay_ties__core_ties__camera_guar.stl

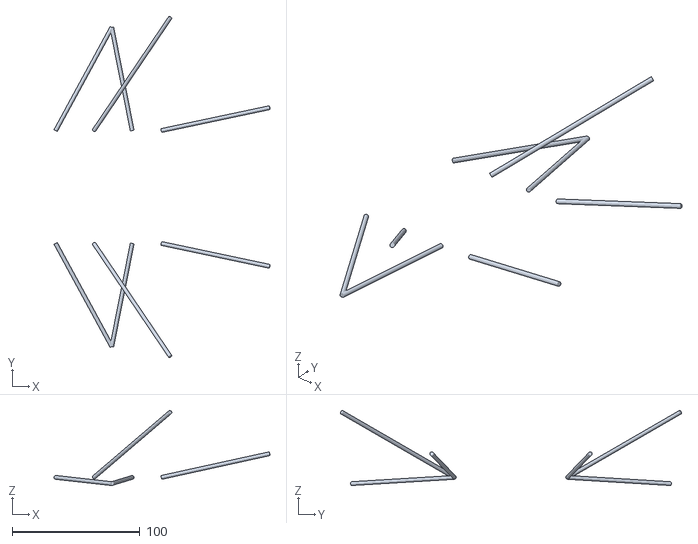
[picture p186: CAD file, 2026-10-28]
runs/scout_layout/v13/parts/spokes__bay_ties__core_ties__camera_guar.stl
169.3 x 267.5 x 58.9
