sparkiscool/nox/runs/arm/v7/asm_overseer/fingB_A.stl

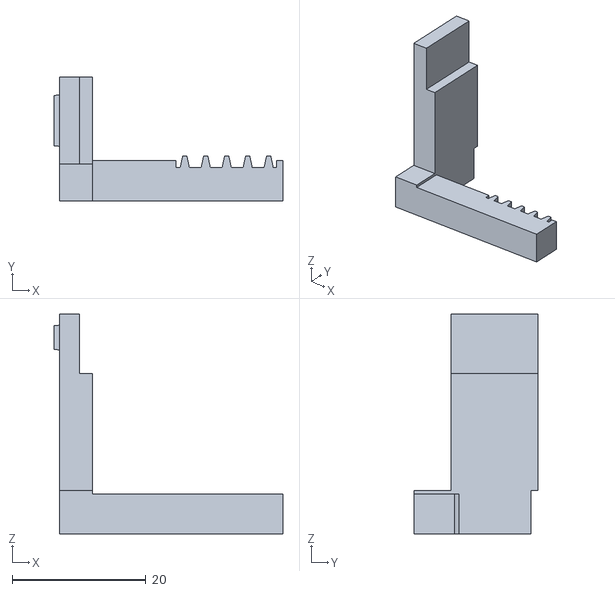
[picture p187: CAD file, 2026-10-24]
runs/arm/v7/asm_overseer/fingB_A.stl
34.3 x 18.5 x 32.9
