sparkiscool/nox/runs/arm_v6_parts/arm_pinion16_v2_W.stl

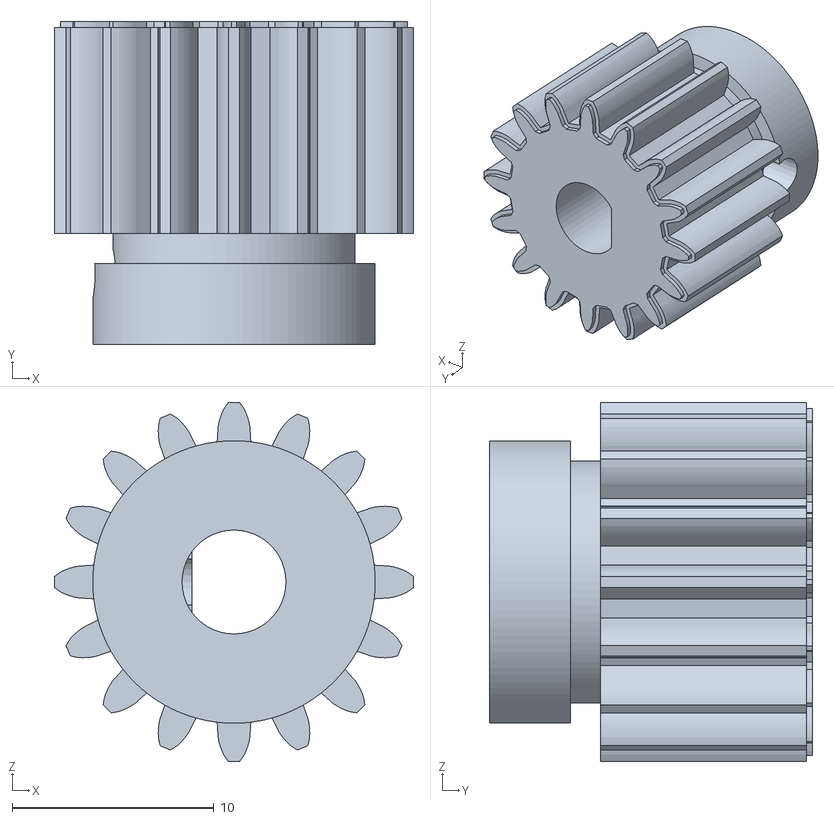
[picture p188: CAD file, 2026-10-24]
runs/arm_v6_parts/arm_pinion16_v2_W.stl
17.8 x 16.0 x 17.8
