sparkiscool/nox/runs/battery_latch/v4/manifest_overseer/drone_rest_standin.stl

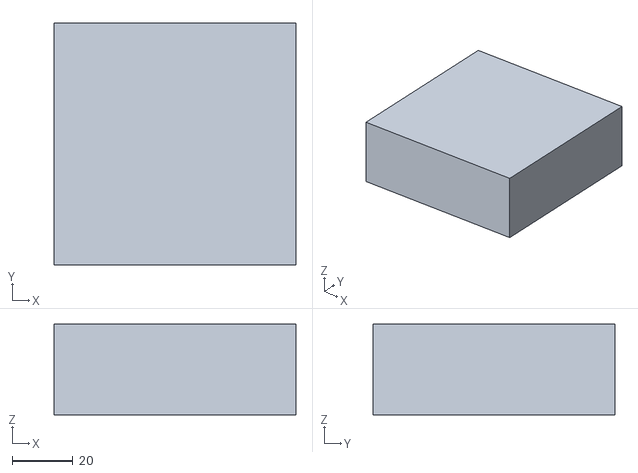
[picture p189: CAD file, 2026-10-24]
runs/battery_latch/v4/manifest_overseer/drone_rest_standin.stl
80.0 x 80.0 x 30.0
