sparkiscool/nox/runs/battery_latch/v4/manifest_scout/cartridge.stl

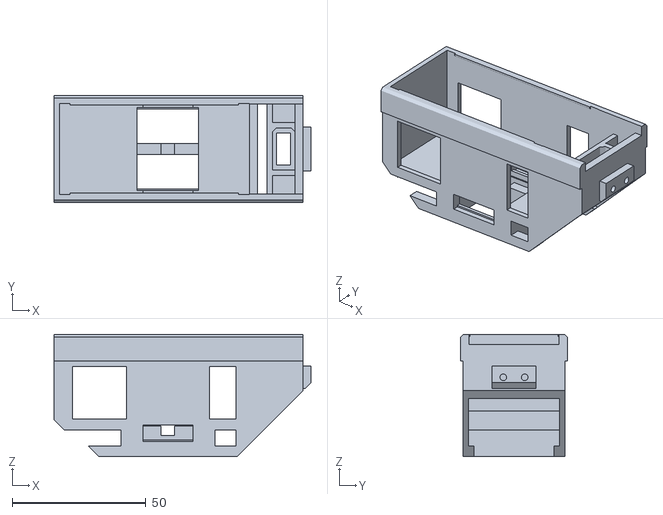
[picture p190: CAD file, 2026-10-24]
runs/battery_latch/v4/manifest_scout/cartridge.stl
96.0 x 40.0 x 45.6
