sparkiscool/nox/runs/battery_latch/v4/stl/box_battery_cartridge_overseer_v6.stl

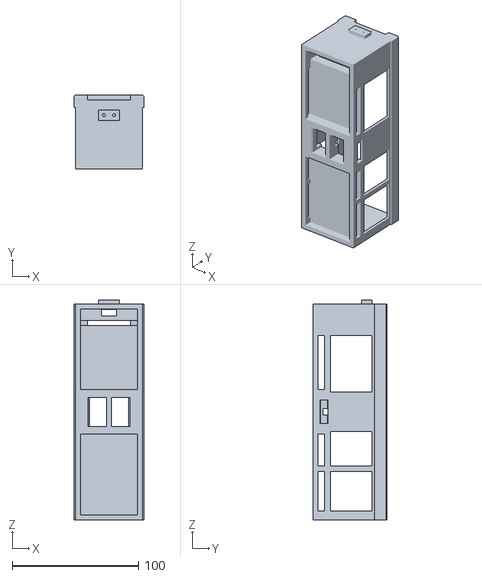
[picture p191: CAD file, 2026-10-24]
runs/battery_latch/v4/stl/box_battery_cartridge_overseer_v6.stl
55.0 x 58.6 x 174.0
