sparkiscool/nox/runs/box_system/v2/latch_ctx/overseer_receiver_lid_c.stl

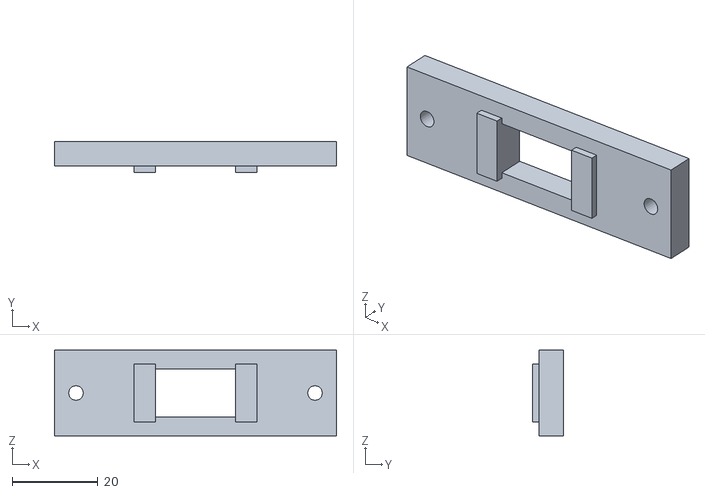
[picture p192: CAD file, 2026-10-24]
runs/box_system/v2/latch_ctx/overseer_receiver_lid_c.stl
65.6 x 7.20 x 20.0
