sparkiscool/nox/runs/box_system/v2/layout/bay_envelopes_W.stl

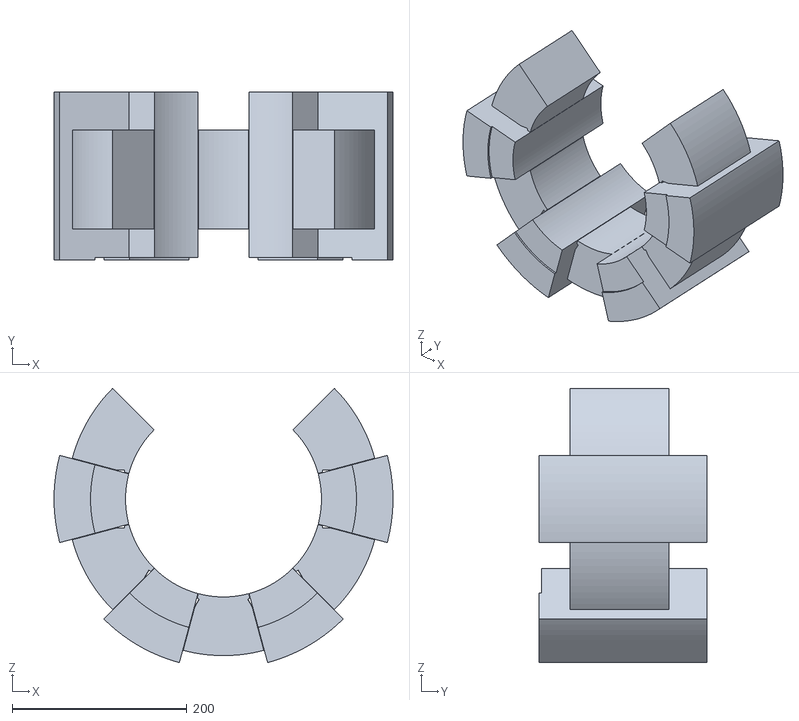
[picture p193: CAD file, 2026-10-24]
runs/box_system/v2/layout/bay_envelopes_W.stl
387.6 x 191.6 x 313.5
