sparkiscool/nox/runs/box_system/v2/layout_bottom/bay_envelopes_W.stl

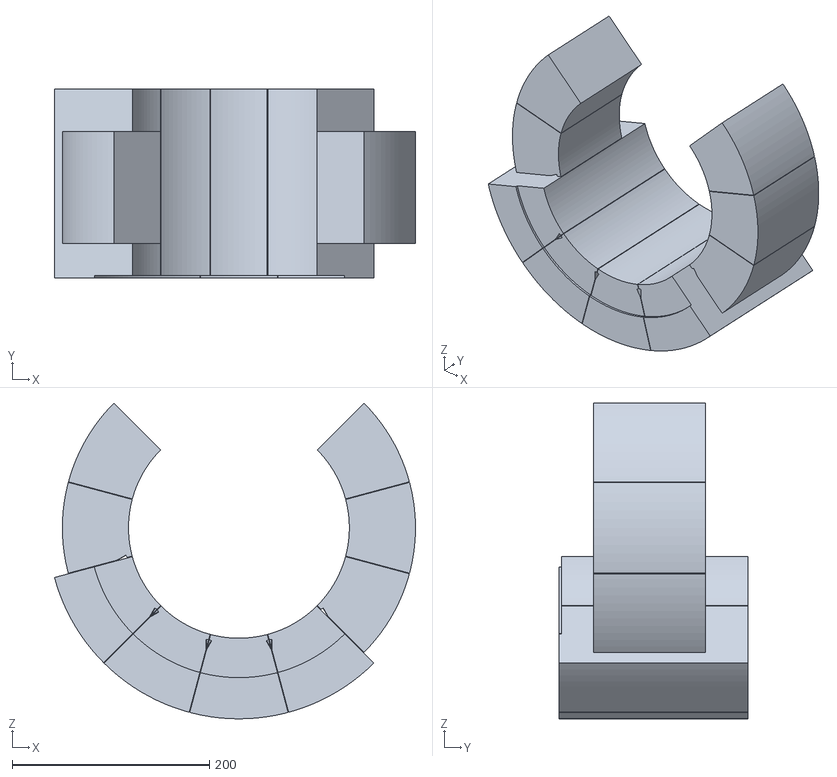
[picture p194: CAD file, 2026-10-24]
runs/box_system/v2/layout_bottom/bay_envelopes_W.stl
366.2 x 191.6 x 320.2
