sparkiscool/nox/runs/box_system/v2/layout_R128_bottom/bay_envelopes_W.stl

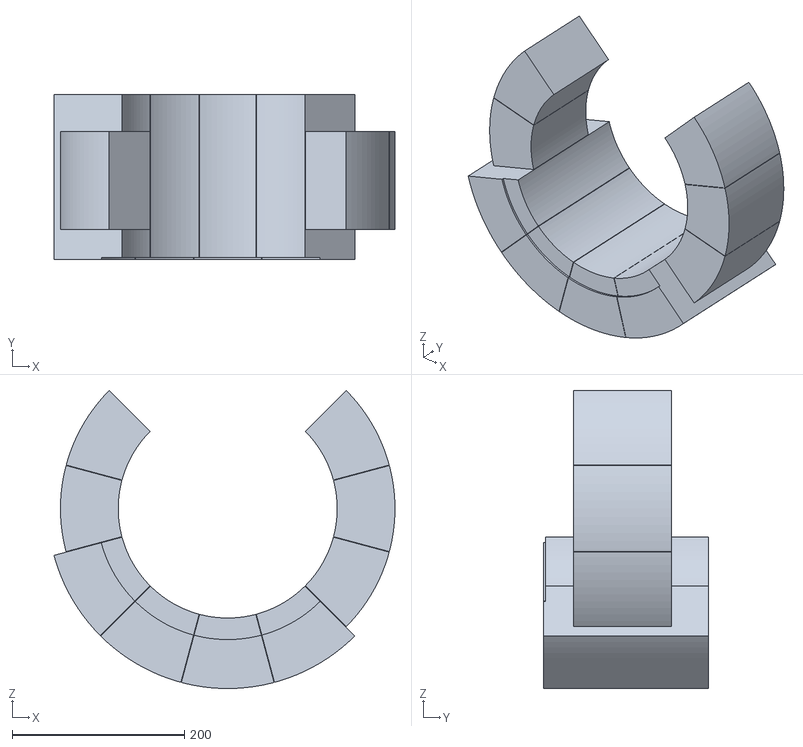
[picture p195: CAD file, 2026-10-24]
runs/box_system/v2/layout_R128_bottom/bay_envelopes_W.stl
395.7 x 191.6 x 345.8
