sparkiscool/nox/runs/detent/v6/box_detent_ring_v4.stl

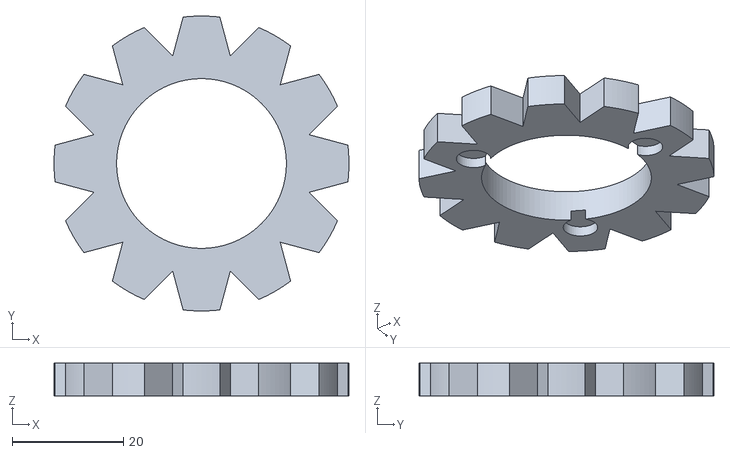
[picture p196: CAD file, 2026-10-24]
runs/detent/v6/box_detent_ring_v4.stl
53.0 x 53.0 x 5.90
