sparkiscool/nox/runs/funnel_panel/v9_plain/box_funnel_probe_cap_v9_plain.stl

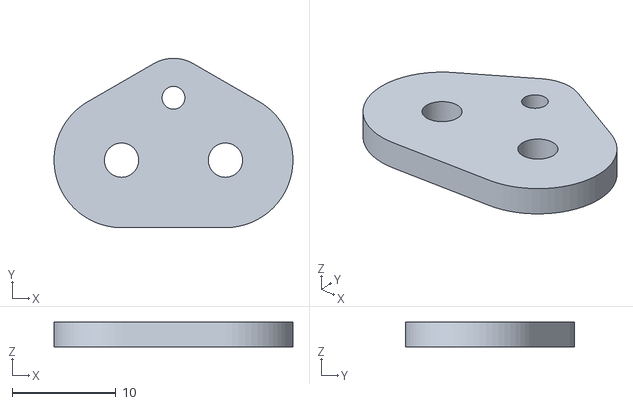
[picture p197: CAD file, 2026-10-24]
runs/funnel_panel/v9_plain/box_funnel_probe_cap_v9_plain.stl
23.0 x 16.3 x 2.40
