sparkiscool/nox/runs/overseer_assembly/v0/arm_1.stl

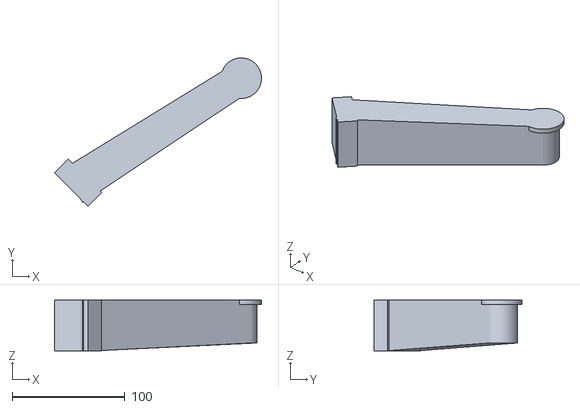
[picture p198: CAD file, 2026-10-24]
runs/overseer_assembly/v0/arm_1.stl
183.4 x 131.3 x 45.0
