sparkiscool/nox/runs/overseer_core/v4/parts/rx_xr2.stl

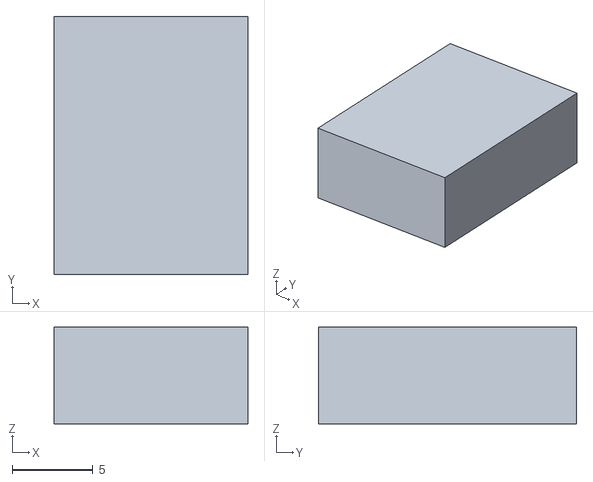
[picture p199: CAD file, 2026-10-28]
runs/overseer_core/v4/parts/rx_xr2.stl
12.0 x 16.0 x 6.00
