sparkiscool/nox/runs/scout_layout/v13/parts/pack_4s_1500.stl

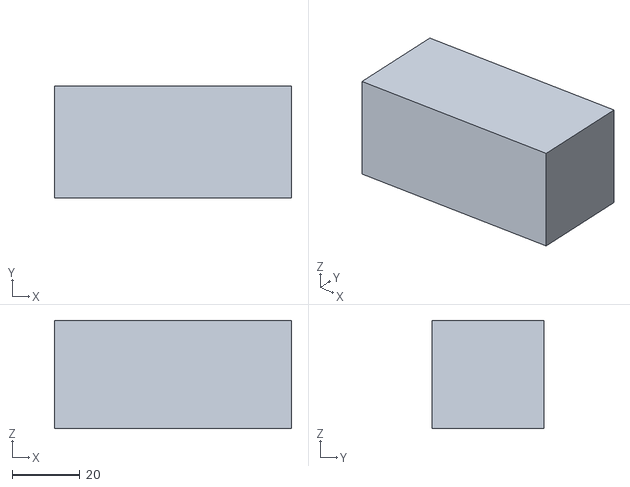
[picture p200: CAD file, 2026-10-28]
runs/scout_layout/v13/parts/pack_4s_1500.stl
70.0 x 33.0 x 32.0
