sparkiscool/nox/print/overseer_cage_node_3_v5.stl

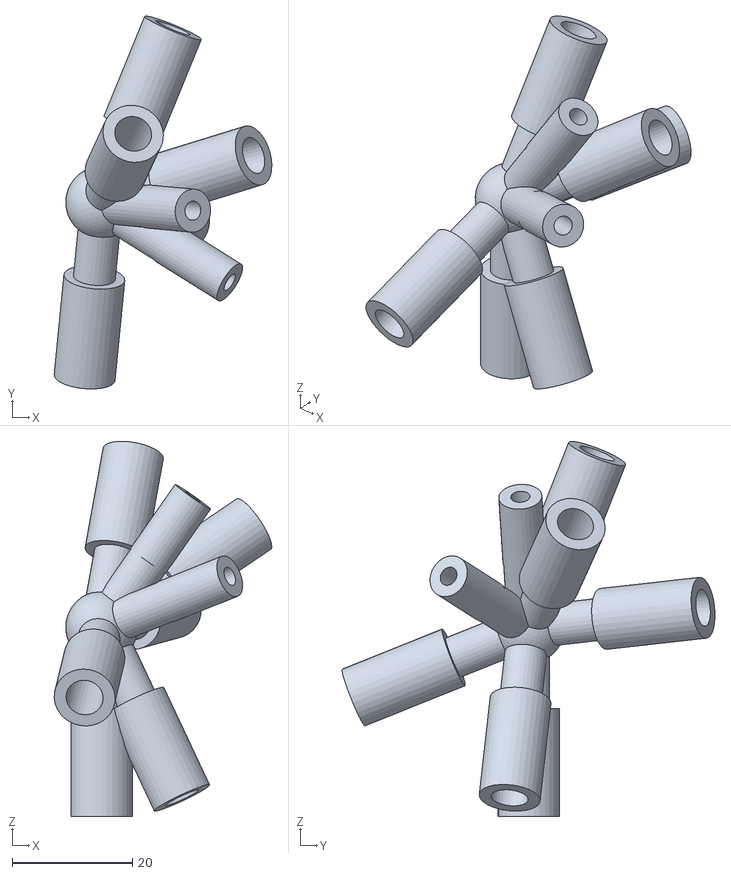
[picture p201: CAD file, 2026-10-28]
print/overseer_cage_node_3_v5.stl
36.3 x 62.1 x 62.5
