sparkiscool/nox/runs/arm/v7/asm/pack_charged.stl

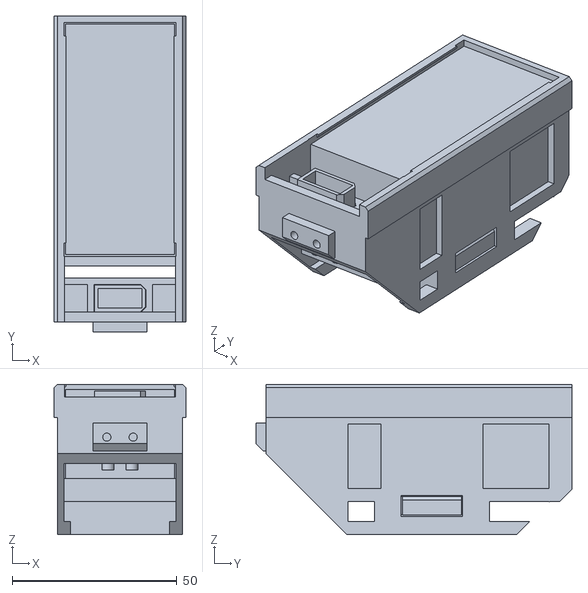
[picture p202: CAD file, 2026-10-24]
runs/arm/v7/asm/pack_charged.stl
40.0 x 96.0 x 45.6
