sparkiscool/nox/runs/arm/v7/asm_overseer/rec-30.stl

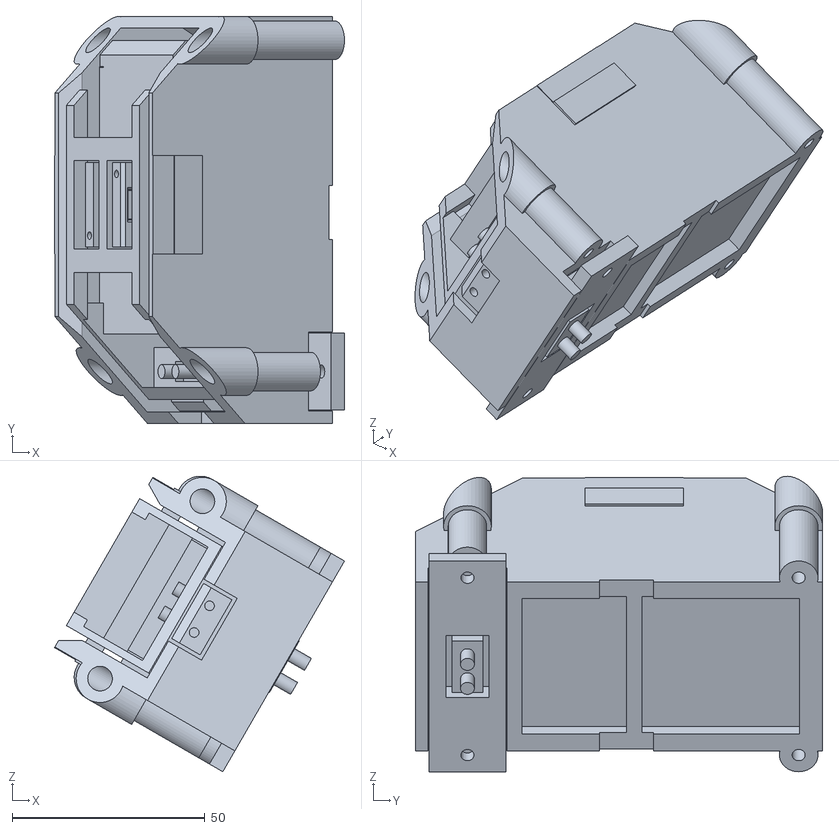
[picture p203: CAD file, 2026-10-24]
runs/arm/v7/asm_overseer/rec-30.stl
75.2 x 105.6 x 76.6
