sparkiscool/nox/runs/battery_latch/v4/manifest_scout/cartridge_strip_nx.stl

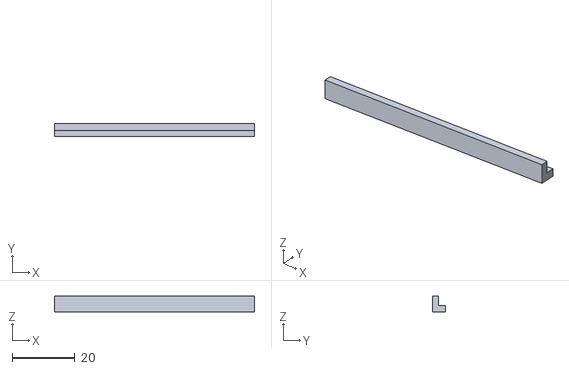
[picture p204: CAD file, 2026-10-24]
runs/battery_latch/v4/manifest_scout/cartridge_strip_nx.stl
64.0 x 4.20 x 5.00
