sparkiscool/nox/runs/battery_latch/v4/stl/box_battery_receiver_lid_scout_v2.stl

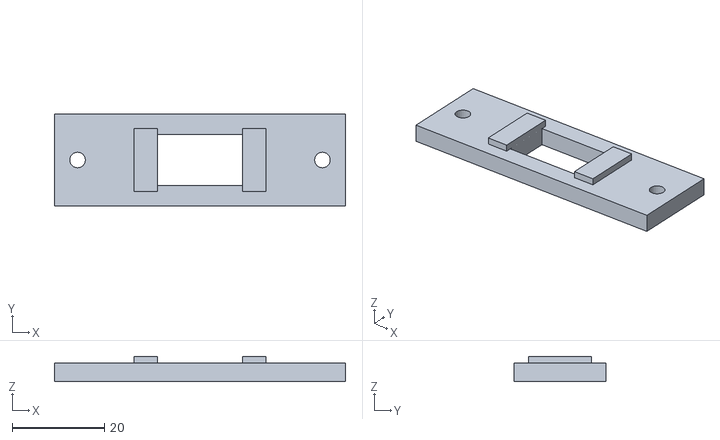
[picture p205: CAD file, 2026-10-24]
runs/battery_latch/v4/stl/box_battery_receiver_lid_scout_v2.stl
63.1 x 20.0 x 5.50
