sparkiscool/nox/(list of files, cad)

Other CAD files:
runs/scout_camera_mount/v1/stop_collar_assembled.stl
runs/box_system/v2/layout_R128_bottom/catch_W.stl
runs/overseer_layout/v5/saved/cage_node_13.stl
print/overseer_cage_node_9_v5.stl
runs/arm_pinion16/v3/arm_pinion16_v3_W.stl
runs/arm_rail/v5/box_arm_rail_B_v5.stl
runs/bar_half/organic-v2/bar_half_view.stl
runs/box_system/v2/layout_bottom/parts/bay-180_body_envelope.stl
runs/box_system/v2/layout_clip_bottom/parts/bay-180_body_envelope.stl
runs/bracket_jA/topo-v4/bracket_jA.stl
runs/detent/v6/box_detent_arm_v3_W.stl
runs/funnel_panel/v7/v6_gate/funnel_panel_A_v6.stl
runs/holder/topo-v1/holder_view.stl
runs/hub/v7/box_hub_v7.stl
runs/motor_mount/organic-v2/motor_mount.stl
runs/motor_mount/topo-v3/motor_mount.stl
runs/overseer_arm_rear/v5d/overseer_arm_rear_view.stl
runs/overseer_hub_deck/v12/overseer_hub_deck_view.stl
runs/scan_stick/v13/scan_stick_head_view.stl
runs/scan_stick_base/v17/scan_stick_base.stl
print/overseer_cage_node_21_v5.stl
runs/arm/v7/asm/gripA.stl
runs/arm_rail/v5/box_arm_rail_A_v5.stl
runs/box_catch_assembly/v2/probe_pin_u22_free_seat.stl
runs/box_system/v2/layout/parts/bay-180_body_envelope.stl
runs/box_system/v2/layout_bottom/parts/bay-150_body_envelope.stl
runs/box_system/v2/layout_clip_bottom/mount_pads_W.stl
runs/box_system/v2/layout_clip_bottom/parts/bay-30_cartridge.stl
runs/box_system/v2/layout_R128_bottom/parts/bay-90_cartridge.stl
runs/funnel_panel/v7/box_funnel_panel_A_v7.stl
runs/hook_latch/v2/box_hook_latch_housing_A_v2.stl
runs/overseer_arms/v5d/place/arm_4_drone_frame.stl
runs/overseer_layout/v5/parts/motor_1.stl
runs/overseer_layout/v5/saved/cage_node_3.stl
runs/arm_rail/v5/arm_rail_B_v5_W.stl
runs/arm_v6_parts/arm_rail_A_v2_W.stl
runs/battery_latch/v4/manifest_overseer/slider_nx.stl
archive/scout-v2/print/s2_cage_PETG_plate_v3.2.3mf
archive/scout-v2/print/s2_cage_corner_node_v3.2.stl
archive/scout-v2/print/s2_cage_crown_v3.2.stl
archive/scout-v2/print/s2_cage_side_node_M_v3.2.stl
archive/scout-v2/print/s2_cage_side_node_v3.2.stl
archive/scout-v2/print/s2_cage_side_spacer_v3.stl
archive/scout-v2/print/s2_cage_v4_corner_node.stl
archive/scout-v2/print/s2_cage_v4_side_node.stl
archive/scout-v2/print/s2_cage_v4_side_node_M.stl
archive/scout-v2/print/s2_cage_v4_vtee.stl
archive/scout-v2/print/s2_cage_v4_wheel.stl
archive/scout-v2/print/s2_cage_vtee_v3.2.stl
archive/scout-v2/print/s2_cage_wheel_v3.2.stl
archive/scout-v2/print/s2_camera_mount_v2.stl
archive/scout-v2/print/s2_cartridge_block_v4.stl
archive/scout-v2/print/s2_receiver_v34.stl
archive/scout-v2/print/s2_top_case_v1.stl
archive/scout-v2/print/s2_tray_v11.stl
print/belt_clamp_coupon_set_v2.stl
print/box_arm_eccbush_v1.stl
print/box_arm_pinion16_v1.stl
print/box_arm_rail_A_v1.stl
print/box_arm_rail_B_v1.stl
print/box_arm_vwheel_v1.stl
print/box_bar_half_v8.stl
print/box_baymod_v4i.stl
print/box_bracket_jA_v8.stl
print/box_detent_arm_v1.stl
print/box_detent_ring_v1.stl
print/box_finger_A_for_head_A_v4.stl
print/box_finger_A_for_head_B_v4.stl
print/box_finger_B_for_head_A_v4.stl
print/box_finger_B_for_head_B_v4.stl
print/box_funnel_panel_A_v7.stl
print/box_funnel_panel_A_v7_plain.stl
print/box_funnel_panel_A_v9_plain_nx.stl
print/box_funnel_panel_A_v9_plain_px.stl
print/box_funnel_panel_B_v7_plain.stl
print/box_funnel_panel_B_v9_plain_px.stl
print/box_hook_latch_housing_A_v1.stl
print/box_hook_latch_housing_A_v2.stl
print/box_hook_latch_housing_B_v1.stl
print/box_hook_latch_plunger_B_v2.stl
print/box_hook_latch_plunger_v1.stl
print/box_hub_v5.stl
print/box_idler_end_A_v3.stl
print/box_idler_end_B_v3.stl
print/box_pinion_v4.stl
print/box_stub_v3.stl
print/box_sun_post_v1.stl
print/overseer_arm_rear_v5d.stl
print/overseer_arm_rear_v5d_mirror.stl
print/overseer_cage_node_0_v5.stl
print/overseer_cage_node_10_v5.stl
print/overseer_cage_node_11_v5.stl
print/overseer_cage_node_12_v5.stl
print/overseer_cage_node_13_v5.stl
print/overseer_cage_node_14_v5.stl
print/overseer_cage_node_15_v5.stl
print/overseer_cage_node_16_v5.stl
print/overseer_cage_node_17_v5.stl
print/overseer_cage_node_18_v5.stl
print/overseer_cage_node_19_v5.stl
print/overseer_cage_node_1_v5.stl
print/overseer_cage_node_20_v5.stl
print/overseer_cage_node_22_v5.stl
print/overseer_cage_node_23_v5.stl
print/overseer_cage_node_2_v5.stl
print/overseer_cage_node_4_v5.stl
print/overseer_cage_node_5_v5.stl
print/overseer_cage_node_6_v5.stl
print/overseer_cage_node_7_v5.stl
print/overseer_core_coupon_hub_deck_v1.stl
print/overseer_core_coupon_keel_hub_v2.stl
print/overseer_core_coupon_sled_v1.stl
print/overseer_flow_clip_v1.stl
print/rod_coupon_3mm_v1.stl
print/rod_coupon_3mm_v2.stl
print/rod_coupon_6mm_v1.stl
print/rod_coupon_6mm_v2.stl
print/s2_cage_PETG_plate_v3.2.3mf
print/s2_cage_corner_node_v3.2.stl
print/s2_cage_crown_v3.2.stl
print/s2_cage_side_node_M_v3.2.stl
print/s2_cage_side_node_v3.2.stl
print/s2_cage_side_spacer_v3.stl
print/s2_cage_v4_corner_node.stl
print/s2_cage_v4_side_node.stl
print/s2_cage_v4_side_node_M.stl
print/s2_cage_v4_vtee.stl
print/s2_cage_v4_wheel.stl
print/s2_cage_vtee_v3.2.stl
print/s2_cage_wheel_v3.2.stl
print/s2_camera_mount_v2.stl
print/s2_cartridge_block_v4.stl
print/s2_receiver_v34.stl
print/s2_top_case_v1.stl
print/s2_tray_v11.stl
print/scan_stick_base_v17.stl
print/scan_stick_cam_v4.stl
print/scan_stick_thread_test_v1.stl
print/scout_camera_mount_collar_v1.stl
print/scout_camera_mount_v1.stl
print/test_glue_lap_v1.stl
print/test_layer_pull_v1.stl
print/test_post_pull_v1.stl
print/test_socket_coupon_v2.stl
runs/arm/v6/asm/axlesA.stl
runs/arm/v6/asm/axlesB.stl
runs/arm/v6/asm/bay3.stl
runs/arm/v6/asm/bushA.stl
runs/arm/v6/asm/bushB.stl
runs/arm/v6/asm/detent_arm.stl
runs/arm/v6/asm/detent_roller.stl
runs/arm/v6/asm/detent_springs.stl
runs/arm/v6/asm/detent_tower.stl
runs/arm/v6/asm/fingA_A.stl
runs/arm/v6/asm/fingA_B.stl
runs/arm/v6/asm/fingB_A.stl
runs/arm/v6/asm/fingB_B.stl
runs/arm/v6/asm/gripA.stl
runs/arm/v6/asm/gripB.stl
runs/arm/v6/asm/headA.stl
runs/arm/v6/asm/headB.stl
runs/arm/v6/asm/hub.stl
runs/arm/v6/asm/pack_charged.stl
runs/arm/v6/asm/pack_dead.stl
runs/arm/v6/asm/pin16_B.stl
runs/arm/v6/asm/railA.stl
runs/arm/v6/asm/railB.stl
runs/arm/v6/asm/servo_A.stl
runs/arm/v6/asm/servo_B.stl
runs/arm/v6/asm/strip0.stl
runs/arm/v6/asm/strip1.stl
runs/arm/v6/asm/strip2.stl
runs/arm/v6/asm/strip4.stl
runs/arm/v6/asm/strip5.stl
runs/arm/v6/asm/strip6.stl
runs/arm/v6/asm/strip7.stl
runs/arm/v6/asm/strip8.stl
runs/arm/v6/asm/wheelsA.stl
runs/arm/v6/asm/wheelsB.stl
runs/arm/v7/asm/axlesA.stl
runs/arm/v7/asm/axlesB.stl
runs/arm/v7/asm/belt_axle.stl
runs/arm/v7/asm/brg0.stl
runs/arm/v7/asm/brg1.stl
runs/arm/v7/asm/bushA.stl
runs/arm/v7/asm/bushB.stl
runs/arm/v7/asm/detent_arm.stl
runs/arm/v7/asm/detent_ring.stl
runs/arm/v7/asm/detent_roller.stl
runs/arm/v7/asm/detent_springs.stl
runs/arm/v7/asm/detent_tower.stl
runs/arm/v7/asm/fingA_A.stl
runs/arm/v7/asm/fingB_B.stl
runs/arm/v7/asm/headA.stl
runs/arm/v7/asm/headB.stl
runs/arm/v7/asm/hub.stl
runs/arm/v7/asm/motor_A.stl
runs/arm/v7/asm/motor_B.stl
runs/arm/v7/asm/motor_axle.stl
runs/arm/v7/asm/p20_axle.stl
runs/arm/v7/asm/p80.stl
runs/arm/v7/asm/pin16_A.stl
runs/arm/v7/asm/pin16_B.stl
runs/arm/v7/asm/pinion_A.stl
runs/arm/v7/asm/pinion_B.stl
runs/arm/v7/asm/post.stl
runs/arm/v7/asm/railB.stl
runs/arm/v7/asm/rec-120.stl
runs/arm/v7/asm/rec-150.stl
runs/arm/v7/asm/rec-180.stl
runs/arm/v7/asm/rec-210.stl
runs/arm/v7/asm/rec-90.stl
runs/arm/v7/asm/rec0.stl
runs/arm/v7/asm/rec30.stl
runs/arm/v7/asm/servo_A.stl
runs/arm/v7/asm/servo_B.stl
runs/arm/v7/asm/shaft_A.stl
runs/arm/v7/asm/shaft_B.stl
runs/arm/v7/asm/shaft_axle.stl
runs/arm/v7/asm/stub.stl
runs/arm/v7/asm/stub_bolts.stl
runs/arm/v7/asm/tiesA.stl
runs/arm/v7/asm/tiesB.stl
runs/arm/v7/asm/wheelsA.stl
runs/arm/v7/asm/wheelsB.stl
runs/arm/v7/asm_overseer/axlesA.stl
runs/arm/v7/asm_overseer/axlesB.stl
runs/arm/v7/asm_overseer/belt_axle.stl
runs/arm/v7/asm_overseer/brg0.stl
runs/arm/v7/asm_overseer/brg1.stl
runs/arm/v7/asm_overseer/bushA.stl
runs/arm/v7/asm_overseer/bushB.stl
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
