sparkiscool/nox/print/README.md

# Print files

Every print-ready file, at `print/<part>_<version>.<ext>`, in print pose. Moved from the "Nox Print Files" artifact 22 Oct 2026; sha256[:12] matches the Saved file cells. Live state of each part: `nox/current-parts.md` (only place). Not carried over: `s2_camera_mount_v1` (superseded) and `s2_cartridge_v11_v4_plate.gcode.3mf` (no supports, do not print). Scout v2 files (`s2_*`) moved to `archive/scout-v2/print/` on 22 Oct 2026 (Scout v2 retired); do not print them. `scan_stick_cam_v4.stl` is superseded by `scan_stick_cam_v7.stl` (10 mm standoffs, M2.5); do not print it. `box_hook_latch_*_v1.stl` are superseded by v2 (funnel panel v7 skin 2.0); do not print them. `box_funnel_panel_*_v7_plain.stl` are DESIGN, superseded by v8 plain (DESIGN, kept in `runs/funnel_panel/v8_plain/` only) and v9 plain (next PR); do not print them. `rod_coupon_6mm_v1.stl` and `rod_coupon_3mm_v1.stl` are superseded by v2 (smaller bores, standing and sideways rows; v1 loose in PETG); do not print them.

| File | Bytes | sha256[:12] |
|---|---|---|
| `belt_clamp_coupon_set_v2.stl` | 188984 | 631789a3a0d4 |
| `box_arm_eccbush_v1.stl` | 32484 | 56d7cf047327 |
| `box_arm_pinion16_v1.stl` | 193284 | c33d2cf9f5fa |
| `box_arm_rail_A_v1.stl` | 51784 | c0a489b144ea |
| `box_arm_rail_B_v1.stl` | 54084 | acc67e255b6b |
| `box_arm_vwheel_v1.stl` | 153684 | cc313523122a |
| `box_bar_half_v8.stl` | 13473184 | aacd009b7ae1 |
| `box_baymod_v4i.stl` | 2996384 | 472f8808ea9c |
| `box_bracket_e_v7c.stl` | 78484 | 55f717ab05f8 |
| `box_bracket_jA_v8.stl` | 3599584 | 21af8faad391 |
| `box_bracket_jB_v7.stl` | 53484 | a48119676bb0 |
| `box_cradle_keel_v6.stl` | 183384 | c360aed46fc8 |
| `box_detent_arm_v1.stl` | 48884 | 9d379e57747a |
| `box_detent_ring_v1.stl` | 156284 | cf619ecdfdf7 |
| `box_funnel_panel_A_v7.stl` | 287284 | 5ff1a1f036d7 |
| `box_funnel_panel_B_v7.stl` | 287684 | 363001539b9c |
| `box_funnel_panel_A_v7_plain.stl` | 154084 | 8021dea5c6a2 |
| `box_funnel_panel_B_v7_plain.stl` | 154484 | 43190158f0f8 |
| `box_funnel_panel_A_v9_plain_nx.stl` | 240684 | c40204963433 |
| `box_funnel_panel_A_v9_plain_px.stl` | 240284 | b5db231cf5d0 |
| `box_funnel_panel_B_v9_plain_nx.stl` | 149484 | 4f033466db81 |
| `box_funnel_panel_B_v9_plain_px.stl` | 149084 | 34eef1c9ddc9 |
| `box_funnel_probe_cap_v9_plain.stl` | 42684 | 3ce3102a8313 |
| `box_finger_A_for_head_A_v4.stl` | 9084 | 088889b387a2 |
| `box_finger_A_for_head_B_v4.stl` | 9084 | 466037734cec |
| `box_finger_B_for_head_A_v4.stl` | 9284 | 5db3beea23f7 |
| `box_finger_B_for_head_B_v4.stl` | 9084 | 07151909ca2b |
| `box_frame_endL_v7b.stl` | 143384 | 35d3bdd29e25 |
| `box_frame_endR_v7b.stl` | 137484 | 5bdbb4a9a085 |
| `box_frame_mid_v6.stl` | 120984 | 01ff810f6f31 |
| `box_hook_latch_housing_A_v1.stl` | 47784 | dd7251ea8694 |
| `box_hook_latch_housing_A_v2.stl` | 47984 | af8e6a21b624 |
| `box_hook_latch_housing_B_v1.stl` | 47784 | b1820a2637ba |
| `box_hook_latch_housing_B_v2.stl` | 47984 | 4d9ee42f4490 |
| `box_hook_latch_plunger_A_v2.stl` | 8684 | 2047342632fe |
| `box_hook_latch_plunger_B_v2.stl` | 8684 | a54921baf061 |
| `box_hook_latch_plunger_v1.stl` | 8684 | e3a62391d276 |
| `box_hub_v5.stl` | 10335384 | 6d6b9344e7f6 |
| `box_idler_end_A_v3.stl` | 60284 | 83a90e7a20c5 |
| `box_idler_end_B_v3.stl` | 60084 | e2912f039297 |
| `box_kb_v7b.stl` | 116584 | f718facc8b4c |
| `box_mast_v6.stl` | 125084 | 1fa9e08c17d0 |
| `box_pinion_v4.stl` | 24084 | e5d41ee26516 |
| `box_post_seg_v7.stl` | 48684 | 5cab526b8391 |
| `box_stub_v3.stl` | 416684 | e5b73c7c9588 |
| `box_sun_post_v1.stl` | 184084 | c43f58f5d93a |
| `box_toe_v7b.stl` | 59884 | 74892913179a |
| `scan_stick_base_v17.stl` | 17832284 | 0eab574096d4 |
| `scan_stick_cam_v7.stl` | 2173084 | cf092d1aba74 |
| `scan_stick_head_v13.stl` | 10370984 | 249eec82eca0 |
| `scan_stick_thread_test_v1.stl` | 3905473 | 7b35ab438606 |
| `test_glue_lap_v1.stl` | 20484 | 588cd8a923d4 |
| `test_layer_pull_v1.stl` | 98684 | 2b4685484f5f |
| `test_post_pull_v1.stl` | 131284 | eb2934d4a73f |
| `test_socket_coupon_v2.stl` | 414884 | 25725f258d52 |
