sparkiscool/nox/nox/print-log.md

# Nox print log

Every print job, newest first. Rule (Spark, 5 Oct 13:47): add a row the moment Spark tells a session to print a part, or a job is sent from Bambu Studio to the printer. Sent counts as printed. A failed or cancelled print gets its own new row, the old row stays. Re-read right before writing; add rows only at the top.

**All prints go through a chat using computer control (Spark, 5 Oct 13:49).** The session that clicks send in Bambu Studio writes the row in the same turn, before it replies. No print is sent any other way, so a missing row means a session skipped the rule.

**One Bambu Studio window per print (Spark, 11 Oct 13:56; 17 Oct 15:34):** never launch Bambu Studio while it is running (an "open app" call starts a second copy; 9 piled up on 17 Oct): click the open window instead. Before opening or slicing the next print, close every other Bambu Studio project window / print tab (save first if unsaved), so only the job being sent is open. Several open projects crashed the PC on 11 Oct.

**Supports on every part (Spark, 17 Oct 16:36):** tree(auto), enabled globally, none switched off per object. Rule in `docs/generative.md`.

**Remote typing (18 Oct 01:25, 01:37, 05:13):** the remote "type" action pastes through the shared clipboard, so a path typed into a Bambu dialog can come out as whatever Spark last copied. Backslash paths fail most often; a bare file name (dialog already in the right folder) or forward slashes go through. Zoom on the file name field before every Enter; one bad name was caught twice that night and twice more on the 18th.

**SD card I/O errors (17 Oct 16:34, 22:46; 18 Oct 02:28, 02:39, 05:14, 05:17):** a freshly inserted card often shows F: with "I/O device error" and is missing from This PC until it is re-seated; when Windows pops an Explorer window for it, the card is readable. If the Explorer window steals the front, click into the Bambu dialog's File name box to get back (never `open_application`).

**Arrange spacing (18 Oct 04:53):** Bambu's default arrange packed the seat pads so close that their 60° flares crossed at layer 10 (slicer "conflicts of gcode paths"). Re-arrange, or lay out the plate in a geometry-only 3mf, and check the slicer warning before exporting.

| Sent | Part + version | File | Material | Sent by | Result / weight (P) |
|---|---|---|---|---|---|
| 27 Oct 00:00 (LAN, printer **Gideon**, A1 mini) | **Rod socket coupons v2, PETG** (6 mm + 3 mm, standing + sideways rows), one plate | `print/rod_coupon_6mm_v2.stl` + `print/rod_coupon_3mm_v2.stl` from branch `claude/gracious-mccarthy-5rctc9` (86f5157), copied to `latest\`; imported as saved (base down), arranged then spread apart (default spacing gave a layer-6 gcode path conflict); project `latest\rod_coupons_v2_blocker.3mf`, sliced file `latest\rod_coupons_v2_petg_final.gcode.3mf` | Bambu PETG Basic (Ext) | Claude (print session, Spark 23:39 "Go ahead and print those once sliced") | **PRINTING.** 1 h 8 min 33 s, 20.11 g, 0 g supports (slicer); mesh 16.0 + 7.8 g (M). 0.20 mm Strength @BBL A1M, 6 walls, 25 % gyroid, tree(auto) 30° global, no brim, textured PEI. First slice put 0.06 g of tree support growing from the plate into the 6.0 sideways socket mouth: support blocker box 52 x 21 x 11.5 over the 6 mm coupon's sideways row (added in the project 3mf, the remote session cannot see Bambu's right-click menu); 3 mm coupon needed none. Gcode check: no support anywhere, all 12 sockets (standing + sideways) and vents open, 1 / 2 / 3 dots recessed on the base and on top of the sideways blocks |
| 26 Oct 22:47 (LAN, printer **Gideon**, A1 mini) | **Rod coupons v1, PETG set** (6 mm + 3 mm socket coupons), one plate | `print/rod_coupon_6mm_v1.stl` + `print/rod_coupon_3mm_v1.stl` from branch `claude/gracious-mccarthy-5rctc9` (6f60896), copied to `latest\`; new project, imported as saved (base down, sockets up), arranged; sliced file `latest\rod_coupons_v1_petg.gcode.3mf`. TPU slice of the same plate exported as `latest\rod_coupons_v1_tpu.gcode.3mf` (57 min 21 s, 10.92 g, 0 g supports), not sent: both printers have PETG on the spool | Bambu PETG Basic (Ext) | Claude (print session, Spark 22:39 "go ahead and print when ready both are free") | **PRINTING.** 39 min 13 s, 10.52 g, 0 g supports (slicer; gcode has no support lines); mesh 7.7 + 4.1 g TPU (M). 0.20 mm Strength @BBL A1M, 6 walls, 25 % gyroid, tree(auto) 30° global, no brim (bed contact 1084 / 671 mm²), textured PEI. Gcode check: all 6 sockets open every layer (wall centreline at bore r + 0.2), floor vents open (Ø1.6 / Ø1.2), size dots recessed in the top 2 base layers |
| 24 Oct 16:39 (LAN, printer **Jarvis**, A1 mini) | **Scan stick cage nodes v2 x8** (low back neg/pos, low front neg/pos, top back neg/pos, top front neg/pos), one plate | `print/scan_stick_node_*_v2.stl` from branch `claude/zen-mccarthy-vqak7h` (c2ea355), in `latest\`; new project, imported as saved (cube face down), Arrange 5 mm; TPU slice exported as `latest\scan_stick_nodes_v2_x8_tpu.gcode.3mf`, then re-sliced in PETG and sent | **Bambu PETG Basic** (Ext). Designed for TPU 95A; Spark 16:37 "just use petg" (Jarvis had PETG loaded) | Claude (print session, Spark 16:36 "send it to jarvis") | **PRINTING.** 1 h 37 min, 26.06 g incl. 0.44 g supports (slicer). 0.20 mm Strength @BBL A1M, 3 walls, 30 % gyroid, tree(auto) 30°, 5 mm outer brim (144 mm² bed contact each). Supports only z 0.2 to 1.6, no support inside any Ø3.6 socket (gcode loop check on the TPU slice, same geometry). **PETG nodes are rigid: they do not flex or absorb crashes like the TPU design; reprint in TPU 95A for flight** |
| 24 Oct 03:38 (LAN, printer **Jarvis**, A1 mini) | **Scan stick adapter v2** (plate 2 of the v6 set), lip face down as saved | `print/scan_stick_adapter_v2.stl` from branch `claude/zen-mccarthy-vqak7h` (c2ea355), copied to `latest\`; project `latest\scan_stick_v6_petg_project.3mf`, sliced file `latest\scan_stick_v6_petg_2plates_final.gcode.3mf` (plate 2) | Bambu PETG Basic (filament 1, Ext) | Claude (print session, Spark 03:36 "send the larger plate to Gideon and the other one to jarvis") | **PRINTING.** 2 h 50 min, 57.14 g incl. 3.42 g supports (slicer); model 131.6 g solid (M). 0.20 mm Strength @BBL A1M, 4 walls, 15 % gyroid, tree(auto) 30°, no brim, textured PEI. Support blocker Ø24 x 29 on the bore axis: first slice grew tree supports through the Ø20.8 threaded bore z 0.2 to 27.6; after the blocker the gcode check finds no support inside any bore or hole |
| 24 Oct 03:37 (LAN, printer **Gideon**, A1 mini) | **Scan stick spine v3 + head v18** (plate 1 of the v6 set) | `print/scan_stick_spine_v3.zip` (unzipped) + `print/scan_stick_head_v18.stl` from branch `claude/zen-mccarthy-vqak7h` (c2ea355); sent to the laptop as geometry-only 3mf (STL too big for the bridge, same coordinates), imported as saved, Arrange 3 mm (all three parts did not fit one bed, so spine + head here, adapter on plate 2); sliced file `latest\scan_stick_v6_petg_2plates_final.gcode.3mf` (plate 1) | Bambu PETG Basic (filament 1, Ext) | Claude (print session, Spark 03:36) | **PRINTING.** 12 h 37 min, 316.50 g incl. 26.5 g supports (slicer); model 419 + 168 g solid (M). Same settings as plate 2. Orientation: saved poses beat all 6 axis poses (print_orient: most bed contact, least overhang). Support blockers: Ø40 x 3.2 in the spine's Ø36.6 spigot recess, Ø14 x 18 over the head pocket + L2 screw bore at (12, 23.6) (a tree trunk ran up through the pocket to the bore until the blocker reached z 18); gcode check: no support inside any bore, hole or recess. Spine has 1 non-manifold edge, head 6 (slicer handled, mesh untouched). Filament slot had flipped to 10 (also PETG Basic) twice from stray keys; reset to 1 before slicing |
| 23 Oct ~21:36 (LAN, printer **Gideon**, A1 mini; row added late, 24 Oct 03:40) | **Scan stick thread test v3** | `print/scan_stick_thread_test_v3.stl` from branch `claude/zen-mccarthy-vqak7h`, copied to `latest\`; imported as saved (thread end down) | Bambu PETG Basic | Claude (print session, Spark 21:33 "send it to print after") | **Finished** (Device tab, 24 Oct 02:35). 1 h 13 min, 20.00 g (slicer). 0.20 mm Strength, 4 walls, 15 % gyroid, supports off, outer brim 5 mm |
| 18 Oct 05:20 (laptop only; SD card unreadable) | **Box stand v5e funnel seat pads A x2 + B x2** (what the funnel mounts on), 2 plates in one file (Bambu's arrange spread them 3 + 1) | `box_seat_pad_v5e_A/B.stl.b64.txt` from Nox Print Files decoded (sha 89b25fa06196 / a06aec1ec8b7 = the saved v5e), committed to `latest\box_seat_pad_A.stl`, `box_seat_pad_B.stl` (+ `box_bay_cradle.stl`, sha 5d82b70b7f72, not sliced yet); imported as saved via `latest\box_seat_pads_x4_layout.3mf` (geometry only), arranged; exported as `latest\box_seat_pads_v5e_x4_2plates_supports.gcode.3mf` (both plates) and `latest\box_seat_pads_v5e_plate1_3pads_supports.gcode.3mf` (plate 1 alone). **Export to F: failed twice (I/O device error at 05:14 and 05:17; F: unreadable since): copy to the card once it is re-seated.** Project not saved (Ctrl+S blocked by a focus-stealing window) | Bambu PETG Basic (filament 1) | Claude (hub-status chat, Spark 04:41 "whatever mounts the funnel lets print that upload to current sd card") | Exported, not on the card, not started. Plate 1 (3 pads) 1 h 42 min, 46.75 g incl. 3.13 g supports; plate 2 (1 pad) 50 min 49 s; total 2 h 33 min, 62.38 g incl. 4.18 g supports (slicer); model 58.20 g. 0.28 mm Extra Draft @BBL A1M, **4 walls** (per the queue row 8), 15 % gyroid, tree(auto) supports 30°, textured PEI; pads on their outer Y face as saved. First slice at Bambu's default spacing had a layer-10 path conflict between two pads (the 60° flares): re-arranged, clean. **Note 04:46: an `open_application` call launched a second Bambu Studio copy again (splash "Loading configuration"); no second window showed afterwards** |
| 18 Oct 02:46 (SD card #2) | **S2 cartridge: tray v11 (run 9a) + latch block v4**, one plate, with tree supports (second cartridge, Spark 02:24) | Project `latest\s2_tray.3mf` (tray, supports on) re-opened, `latest\s2_cartridge_block.stl` (4,925.3 mm³ = v4) imported, arranged, sliced; exported as `latest\s2_cartridge_v11_block_v4_supports.gcode.3mf` (02:37) and `F:\s2_cartridge_v11_block_v4_supports.gcode.3mf` (02:46, the new card: F: gave I/O errors until Spark re-seated it at 02:44); project re-saved as `s2_tray` (now tray + block). Not in `LATEST.md` yet (no shell on the laptop this session) | Bambu PETG Basic (filament 1) | Claude (stand chat, Spark 02:24 "new sd card in upload the cartridge into this so i can print a second one", 02:33 "make the body and the other parts on one plate") | Exported, not started. 2 h 20 min, 24.45 g incl. 5.17 g supports (slicer); model 19.28 g. 0.20 mm Strength @BBL A1M, 3 walls, 40 % gyroid, tree(auto) supports 30°, textured PEI; tray closed end down, block flat as saved. Blades are not printed (2 x 35.5 feeler gauge). **Note 02:44: an `open_application` call during the card swap launched a second Bambu Studio copy (splash stuck on "Loading configuration"), against the one-window rule; no second window showed afterwards, but check the taskbar before the next print** |
| 18 Oct 02:11 (SD card) | **Box detent ring v1 + roller arm v1 + gripper pinion v4 (1 of 2)**, one plate | New project from `latest\box_detent_ring.stl`, `box_detent_arm.stl`, `box_pinion.stl` as saved; arranged; exported as `F:\box_detent_ring_arm_pinion_v1.gcode.3mf` and `latest\box_detent_ring_arm_pinion_v1.gcode.3mf`; project saved as `box_detent_ring` | Bambu PETG Basic (filament 1) | Claude (stand chat, Spark 01:00 "if there are any parts ready to print slice it and upload to sd card") | Exported, not started. 24 min 30 s, 6.36 g incl. 0.19 g supports (slicer); model 6.18 g. 0.28 mm Extra Draft @BBL A1M, 3 walls, 15 % gyroid, tree(auto) supports 30°, textured PEI |
| 18 Oct 02:05 (SD card) | **Box arm small set: sun post v1, idler ends A + B v3, fingers A/B for heads A/B v4, pinion v4 (1 of 2)**, 3 plates in one file | Imported from `latest\` as saved (10 files; the ring, arm and second pinion deleted after layer-2 path conflicts between tree bases and moved to their own file); Bambu's arrange spread the rest over 3 plates; Slice all; exported with "Export all plate sliced file" as `F:\box_arm_small_v1_3plates.gcode.3mf` and `latest\box_arm_small_v1_3plates.gcode.3mf`; project saved as `box_sun_post` | Bambu PETG Basic (filament 1) | Claude (stand chat, same request) | Exported, not started. Plate 1 (4 fingers + pinion) 48 min 31 s, plate 2 48 min 53 s, plate 3 24 min 38 s; 38.52 g incl. 2.48 g supports (slicer); model 36.04 g. 0.28 mm Extra Draft @BBL A1M, 3 walls, 15 % gyroid, tree(auto) supports 30°, textured PEI. Pick the plate on the printer |
| 18 Oct 01:37 (SD card) | **Box swap arm hub v5** | New project from `latest\box_hub.stl` (168,679 mm³, 171.5 x 171.3 x 67 in Bambu Studio, 206,706 triangles = the saved v5), sleeve end down as saved; exported as `latest\box_hub_v5_supports.gcode.3mf` and `F:\box_hub_v5_supports.gcode.3mf`; project saved as `box_hub` | Bambu PETG Basic (filament 1) | Claude (stand chat, same request) | Exported, not started. 6 h 18 min, 151.58 g incl. **37.59 g supports** (slicer); model 113.99 g. 240 layers, 67 tall. 0.28 mm Extra Draft @BBL A1M, 3 walls, 15 % gyroid, tree(auto) supports 30°, textured PEI. **Supports are 33 % of the model, over the README's ~25 % line: Spark's call before it goes on a bed** |
| 18 Oct 01:26 (SD card) | **Box bay modules v4i x2**, one plate | New project from `latest\box_baymod.stl` (65,660.1 mm³, 92.56 x 73.23 x 87.6 in Bambu Studio, 59,926 triangles), cloned, arranged (both rotated 90° about Z, same bed face); exported as `latest\box_baymod_v4i_x2_supports.gcode.3mf` and `F:\box_baymod_v4i_x2_supports.gcode.3mf` (`latest\box_baymod.gcode.3mf` = the same slice under the default name, delete); project saved as `box_baymod` | Bambu PETG Basic (filament 1) | Claude (stand chat, same request) | Exported, not started. 5 h 54 min, 144.92 g incl. 29.12 g supports (slicer); model 115.80 g. 313 layers. 0.28 mm Extra Draft @BBL A1M, **4 walls** (the mounted bay needs them, `box-stand.md` Problem 6), 15 % gyroid, tree(auto) supports 30°, textured PEI |
| 18 Oct 01:13 (SD card) | **S2 receiver v3.4** (plate attachment drawn, 3.3 sockets), with tree supports | `s2_receiver_v34.stl.b64.txt` from Nox Print Files decoded (sha 28fe49d9da09 = the saved v3.4), committed to `latest\s2_receiver.stl`; new project, imported as saved (pads down, z up; 35,947.5 mm³, 81 x 117.441 x 61 in Bambu Studio, 118,282 triangles); exported as `latest\s2_receiver_v34_supports.gcode.3mf` and `F:\s2_receiver_v34_supports.gcode.3mf`; project saved as `s2_receiver` (overwrites the v3.3 project) | Bambu PETG Basic (filament 1) | Claude (stand chat, same request) | Exported, not started. 3 h 27 min, 50.01 g incl. 9.96 g supports (slicer); model 40.05 g. 305 layers, 61 tall. 0.20 mm Strength @BBL A1M, 6 walls, tree(auto) supports 30°, outer + inner brim 5 mm, textured PEI. Goes on Gideon after the v3.3 fit print |
| 17 Oct 16:58 (laptop only) | **S2 top case v1** (run h), with tree supports | `s2_top_case_v1.stl.zip.b64.txt` from Nox Print Files, unzipped (sha e7e950b79f7e = the saved v1), copied to `latest\s2_top_case.stl`; new project, imported as saved (right side down; 10,115.2 mm³, 65.95 x 46.11 x 79.93 in Bambu Studio). Exported as `latest\s2_top_case_v1_supports.gcode.3mf` (sha 044a9b6f6086), project saved as `s2_top_case`. Not on the SD card (card not reading at 16:46) | Bambu PETG Basic (filament 1) | Claude (receiver SD chat, Spark 16:48 "check the other scout parts are they done if so slice and support all of them") | Exported, not started. 1 h 52 min, 16.54 g incl. 5.06 g supports (slicer); model 11.48 g. 400 layers, 80.0 tall. 0.20 mm Strength @BBL A1M, 6 walls, 25 % grid (profile), tree(auto) supports threshold 30°, outer brim 5 mm, textured PEI |
| 17 Oct 16:47 (laptop only; SD export failed) | **S2 tray v11 (run 9a) alone, with tree supports** (reprint of the snapped cartridge body; block v4 + blades already on hand, Spark 16:43) | New project: `latest\s2_tray.stl` (12,435.9 mm³, 40.4 x 48 x 79 in Bambu Studio, checked = run 9a), as saved (closed end down). Export to `F:\s2_tray_v11_supports.gcode.3mf` failed (I/O device error: card not reachable); saved instead as `latest\s2_tray_v11_supports.gcode.3mf`, project saved as `s2_tray` | Bambu PETG Basic (filament 1) | Claude (receiver SD chat, Spark 16:43 "redo and add supports for the cartridge ... only do the cartridge body that snapped") | Exported, not on the card yet, not started. 2 h 7 min, 19.34 g incl. 5.17 g supports (slicer); model 14.17 g. 395 layers, 79.0 tall. 0.20 mm Strength @BBL A1M, 3 walls, 40 % gyroid (as the 15:22 plate), tree(auto) supports threshold 30°, brim auto, textured PEI |
| 17 Oct 16:38 (SD card) | **S2 receiver v3.3** (tail columns, 16:12), **with tree supports** (first part under the 16:36 supports rule) | The open unsaved `s2_receiver` project was saved as `latest\s2_receiver.3mf` (16:30) before switching; re-opened, sliced without supports and checked against `latest\s2_receiver_plate.gcode.3mf` (39.03 g, 2 h 35 min: same), then Enable support on (global, tree(auto), threshold 30°), re-sliced, exported as `F:\s2_receiver_v33_supports.gcode.3mf`, project re-saved with supports on. First export try 16:34 failed (F: I/O device error: card not in the laptop) | Bambu PETG Basic (filament 1) | Claude (receiver SD chat, Spark 16:25 "put the new scout end reciever onto the sd card", 16:36 "try now, also we need supports for all parts from now on") | Exported, not started. 3 h 25 min, 50.21 g incl. 11.25 g supports (slicer); model 38.96 g. 0.20 mm Strength @BBL A1M, brim as saved (outer + inner 5 mm), textured PEI, mouth down as saved. Slicer still warns 'floating cantilever'. `latest\s2_receiver_plate.gcode.3mf` (no supports) is superseded: don't print it |
| 17 Oct, reported by Spark 16:25 | S2 tray v11 + block v4, the 15:22 SD plate (row below) | as the 15:22 row | Bambu PETG Basic | - | **Failed: snapped (Spark); printed with no supports.** Where it snapped not recorded. Led to the supports-on-every-part rule (Spark 16:36) |
| 17 Oct 15:22 (SD card) | **S2 tray v11 (run 9a) + latch block v4**, one plate | `dubhacks\s2_tray_v11_run9.stl` (12,435.9 mm³ in Bambu Studio) + `s2_cartridge_block_v4.stl` (4,925.3 mm³), replacing the old 02:51 `s2_tray_v11.stl` on the other chat's plate. Export saved as `dubhacks\Resume head A v5 ….gcode.3mf` (clipboard clash with another chat), contents checked (both objects, A1 mini, 19.27 g), copied to `F:\s2_cartridge_run9_block_v4.gcode.3mf` and `latest\s2_cartridge_plate.gcode.3mf` (sha 601734e5…). Project not saved | Bambu PETG Basic (filament 1) | Claude (cartridge chat, Spark 14:52 "get this sliced and sent to the sd card") | Exported, not started. 2 h 5 min, 19.27 g (slicer), 0 g supports (support off per object). 0.20 mm Strength @BBL A1M, 3 walls, 40 % gyroid, textured PEI; tray closed end down, block flat. Slicer warns of floating regions: the two 14 mm ledges over the block window (shave if they sag). Never send `s2_cartridge_v11_block_v4.gcode.3mf` (14:49): it holds the old tray |
| 17 Oct 14:29 (SD card) | **Funnel panels A v6 x2 + B v6 x2** (panels 5 to 8 of 8: the remaining two A + two B after A #1, A #2, B #1 printed and B #2 on the card), one file per panel | A v6 re-sliced from `Documents\Nox\dubhacks\funnel_panel_A_v6.stl` and exported as `F:\funnel_panel_A_v6_3.gcode.3mf`, copied to `funnel_panel_A_v6_4.gcode.3mf`; B from the laptop's `funnel_panel_B_v6_SLICED.gcode.3mf` (same slice as the 12:58 card file), copied to `F:\funnel_panel_B_v6_3.gcode.3mf` and `_4`. Same F: card as funnel_panel_B_v6. Project not saved | Bambu PETG Basic (filament 1) | Claude (funnel SD chat, Spark 14:14 "upload each new plate of the funnel thats left into the current sd card") | Exported, not started. A: 1 h 38 min, 62.71 g; B: 1 h 38 min, 62.56 g (slicer), no supports (0 g). 0.28 mm Extra Draft @BBL A1M, 3 walls, 100 % (zig-zag, forced by Bambu Studio at 100 %), textured PEI, contact face down. Flow cal Off and Ludicrous set on the printer at start. Supersedes the queue's "hold until the first face passes" (Spark's call) |
| 17 Oct 13:18 (SD card) | **Box arm belt clamp coupon set v1 (bed end + land + hang tab, and its plate) + clamp plate v1 x2** (one per head; same part for A and B), one plate | Built from `nox/box/belt_clamp.py` (coupon 3.16 g, coupon plate 1.78 g, clamp plate 3.03 g, M; one watertight body each), committed to `Documents\Nox\dubhacks\belt_clamp_coupon_v1.stl`, `belt_clamp_coupon_plate_v1.stl`, `belt_clamp_plate_v1.stl`. Exported as `F:\belt_clamp_coupon_v1_plates.gcode.3mf` (the same F: card that holds funnel_panel_B_v6). Project not saved | Bambu PETG Basic (filament 1) | Claude (print status chat, Spark 13:11 "okay upload those to the new sd card") | Exported, 33 min 34 s, 8.69 g (slicer), 40 layers, 8.00 tall, no supports. 0.20 mm Strength @BBL A1M, 6 walls, profile infill, textured PEI; coupon and plates back face down as exported. Next: 10 kg hang test on the coupon (`nox/box-arm.md` belt clamp); gates heads A / B v5 |
| 17 Oct 12:58 (SD card) | **Funnel panel B v6** (panel 2 of the A + B face; seat block, M3 countersunk from above) | Project `Documents\Nox\dubhacks\funnel_panel_B_v6.3mf` (12:18, other print chat), re-sliced and exported as `F:\funnel_panel_B_v6.gcode.3mf` on the printer's SD card (not sent over the network: no cloud link at the venue). Printer not recorded: Spark loads it at the printer | Bambu PETG Basic (external spool) | Claude (funnel chat, Spark 12:55 "i plugged in the sd card put the next print on it") | Exported, 1 h 38 min, 62.56 g (slicer), 43 layers, no supports. 0.28 mm Extra Draft @BBL A1M, 3 walls, 100 % rectilinear, textured PEI, contact face down. Flow cal Off and Ludicrous are set on the printer at start (SD prints). Not logged by other chats (from chat history, E): B v6 #1 to Jarvis ~02:10, done ~03:11; a second A v6 sliced 03:11 and on the bed before this job |
| 17 Oct 01:02 | **Funnel panel A v6** (first article, panel 1 of the A + B face; seat block, M3 countersunk from above) | `Documents\Nox\dubhacks\funnel_panel_A_v6.stl` (53,506 mm³, 108.8 x 170.6 x 12.0 in Bambu Studio, 1884 triangles, checked). Job name on the printer: funnel_panel_A_v6 (renamed from the project name). Project not saved | Bambu PETG Basic (external spool) | Claude (funnel chat, Spark 01:01 "send i[t]" after clearing the bed), to Jarvis | Sent, 1 h 38 min, 62.71 g (slicer), no supports. 0.28 mm Extra Draft @BBL A1M, 3 walls, 100 % rectilinear, textured PEI, contact face down as exported; timelapse off, auto bed levelling on, flow calibration off. Downloading (99 %) at 01:02 with the bed heating to 65; ETA ~02:40 |
| 17 Oct ~00:55 | Funnel panel A v5, the 00:39 job (row below) | as the 00:39 row | Bambu PETG Basic | Spark | **Cancelled by Spark ~10 min in:** mount changed to screws from above (v6) |
| 17 Oct 00:39 | **Funnel panel A v5** (first article, panel 1 of the A + B face; seat pad with M3 heat-set insert hole) | `Documents\Nox\dubhacks\funnel_panel_A_v5.stl` (55,910 mm³, 109.0 x 170.6 x 13.9 in Bambu Studio, 1932 triangles, checked). Job name on the printer: funnel_panel_A_v5. Project not saved | Bambu PETG Basic (external spool) | Claude (funnel chat, Spark 16 Oct 23:56 "send it to the printer", 17 Oct 00:36 "fix the z axis issue, no problem I can see"), to Jarvis | Sent, 1 h 44 min, 65.48 g (slicer), no supports. 0.28 mm Extra Draft @BBL A1M, **3 walls, 100 % rectilinear** (queue: the FE assumes solid ribs), textured PEI, contact face down as exported; timelapse off, auto bed levelling on, flow calibration off. Downloading (100 %) at 00:39 with the bed heating to 65. Before the send: cleared the Z error (row below) and ran auto homing from Bambu Studio, which finished clean; camera showed the bed empty |
| 16 Oct ~23:46 (seen 17 Oct 00:34) | Funnel panel A v4 (job from `dubhacks\funnel_panel_A_v4.3mf`, saved 23:46; sender not recorded) | `dubhacks\funnel_panel_A_v4.3mf` | PETG | not logged | **Failed before printing: "Z axis homing failed; the task has been stopped" (HMS 0300-4000 003417: Z motor stuck during movement).** Spark saw nothing wrong at the printer; a remote re-home at 00:38 finished clean. Panel v4 is superseded by v5 (seat pads), so it was not resent |
| 11 Oct 13:59 | **Scout swap arm carrier v1 (arm A) + gripper pinion v3**, one plate | `swap-station\cad\wip\swap_arm_v1\swap_arm_carrier_v1_PRINT.3mf` (carrier 102.5 x 103.3 x 42, 49,879.6 mm³; pinion 40 x 39.8 x 10, 8,971.8 mm³ in Bambu Studio; arranged 10 Oct 22:36). Job name on the printer: swap_arm_carrier_v1_PRINT | Bambu PETG Basic (external spool) | Claude (gripper assembly chat, Spark 13:52 "send it bed ready"; first try lost the computer link mid-load, Bambu Studio had closed; retried 13:56 "retry" in a freshly started single window), to Jarvis | Sent, 4 h 26 min, 71.40 g incl. 7.67 g supports (slicer); model 63.73 g. 0.20 mm Strength @BBL A1M (6 walls), tree(auto) supports, textured PEI; timelapse off, auto bed levelling on, flow calibration on. Downloading (15 %) at 13:59 with the bed heating to 65; ETA ~18:25. Before the send Jarvis showed the float top v2 finished (100 %, 325 / 325) |
| 10 Oct 23:21 | **Scout swap arm float top v2 (arm A)** | `swap-station\cad\wip\swap_arm_v2\swap_arm_A_next_2_plates_SLICED.3mf`, **plate 2** (the file's plate 2 is the float top and plate 3 the carrier; current-parts said the reverse). Plate re-sliced on open. Job name on the printer: swap_arm_A_next_2_plates_SLICED_plate_2 | Bambu PETG Basic (external spool) | Claude (gripper assembly chat, Spark 22:33 "go ahead" on the overnight plan; bed "clesar" 23:18), to Jarvis | Sent, 3 h 23 min, 51.34 g incl. 12.01 g supports (slicer); model 39.33 g. 325 layers, 65.0 tall. 0.20 mm Strength @BBL A1M (6 walls), tree(auto) supports, textured PEI; timelapse off, auto bed levelling on, flow calibration on. Downloading (20 %) at 23:21 with the bed heating to 65. Before the send Jarvis showed the Y carriage v1 finished (100 %, 640 / 640). Overnight plan: next carrier v1 + pinion v3 (`swap_arm_v1\swap_arm_carrier_v1_PRINT.3mf`, 4 h 26, 71.40 g incl. 7.67 g supports, sliced 22:36), then Z bracket v2 (`swap_arm_v2\swap_arm_z_bracket_v2_PRINT.3mf`, 5 h 24, 101.26 g incl. 13.73 g supports, sliced 22:39) |
| 8 Oct 21:47 | **Shop tool, not a Nox part: resin cups x6 (2.4 ml, 16 ID x 12 deep, 28 base) + resin picks x6 (100 long, 2.0 thick, 1.0 tip / 6 paddle)**, one plate | `misc\resin_plate.stl` (16,977 mm³, 109 x 112 x 13.6 in Bambu Studio, checked). Job name on the printer: resin_plate. Project not saved | Bambu PETG Basic (external spool) | Claude (resin applicator chat, Spark's go 21:36 "go"), to Jarvis | Sent, 52 min 47 s, 19.79 g (slicer), no supports. 68 layers, ETA 22:39. 0.20 mm Strength @BBL A1M profile defaults, textured PEI. Heatbed preheating at 21:47 (0 %, Bambu Studio). Before the send Jarvis showed the soldering wire holder finished (100 %, 365 / 365); bed not confirmed clear from here. Opened in a second Bambu Studio window; the unsaved Soldering_wire_holder project in the first window was left untouched |
| 8 Oct 11:57 | **Latch arm V6, reprint: 3 hook blocks + 3 tenons (2 + 1 spare) + glue jig**, one plate | `scout\cad\wip\latch_arm_v6\scout_latch_arm_V6_plate_x3_jig.stl` (new plate of the unchanged V6 block / tenon / jig meshes, parts 24 apart; 2894.69 mm³, 89 x 41 x 12.7 in Bambu Studio, checked). Job name on the printer: scout_latch_arm_V6_plate_x3_jig. Project not saved | Bambu PETG Basic (external spool) | Claude (hook reprint chat, Spark 11:42 "three hooks one spare and print it again this time with better support and also the mold as well"; go 11:56 "go for it just try your best to make it stable i added glue"), to Jarvis | Sent, 32 min 7 s, 4.03 g incl. 0.09 g supports (slicer); model 3.94 g. 79 layers, ETA 12:29 at standard speed, 13:00 on Silent. 0.16 mm Optimal, 4 walls, 100 % rectilinear, **tree(auto) supports on everything, threshold 45°, "remove small overhangs" off; outer and inner brim 6 mm** (the failed job: no supports on the arm set, auto brim), textured PEI + glue (Spark). Blocks on their side, tenons upright, as exported. **Speed set to Silent at 11:57 during preheat; read back 50 % at 11:58 (2 %, cleaning the nozzle tip), printer ETA 13:00.** The previous project (Radxa mount v1) was closed without saving |
| 8 Oct, reported by Spark 11:42 | Latch arm V6 set, from the 02:45 job (row below) | as the 02:45 row | Bambu PETG Basic | - | **Failed: all the hook blocks broke during the print (Spark). Where they broke not recorded.** Printed with no supports and auto brim on Silent; each block stands 12.7 tall on ~9 mm² (M). Cartridge v18 and pack bar v3 from the same plate: not reported |
| 8 Oct 10:08 | Radxa mount v1 | `scout\cad\wip\radxa_mount_v1\scout_radxa_mount_v1.stl` (3398.87 mm³, 108.174 x 51.4997 x 7 in Bambu Studio, checked). Job name on the printer: scout_radxa_mount_v1. Project not saved | Bambu PETG Basic (external spool) | Claude (Radxa mount chat, Spark's go 09:54 "print it"; bed "Clear, send it" confirmed by Spark ~10:07), to Jarvis | Sent, 27 min 48 s, 4.01 g (slicer), no supports. 43 layers, ETA 10:35. 0.16 mm Optimal, 4 walls, 100 % (Bambu Studio changed the pattern from grid when 100 % was set; pattern not read back), brim setting left at the profile default (not checked), textured PEI. Flat on its back as exported. Speed 100 %. Heatbed preheating at 10:08 (0 %, Bambu Studio). The previous project (cartridge v18 plate) was closed without saving |
| 8 Oct 02:45 | **Cartridge v18 + latch arm V6 set (4 blocks, 4 tenons, glue jig) + pack bar v3**, one plate | `scout\cad\wip\cartridge_v18\scout_cartridge_v18.stl` (19,866.1 mm³, 96 x 56.94 x 40 in Bambu Studio, checked), `latch_arm_v6\scout_latch_arm_V6_plate_x4_jig.stl` (3211.32 mm³, 83 x 41 x 12.7, checked), `pack_bar_v3\scout_pack_bar_v3.stl` (543.2 mm³, 6.61 x 46.39 x 3, checked). Job name on the printer: scout_cartridge_v18. Project not saved | Bambu PETG Basic (external spool) | Claude (cartridge v18 chat, Spark's go 02:36 "print this along with the top bar and the side clips for feeler gauge and put it on slow mode"), to Jarvis | Sent, 2 h 26 min, 31.04 g incl. 3.74 g supports (slicer); model 27.30 g. 250 layers, ETA 05:10 at standard speed. 0.16 mm Optimal, 4 walls, 30 % gyroid, tree(auto) supports on the cartridge only (supports off per object on the arm set and the bar; arm set infill 100 %), auto brim, textured PEI. **Speed set to Silent (50 %) at 02:45 during preheat (Spark: slow mode): expect about 4 to 5 h (E); check it still reads 50 % once printing.** First slice warned of a path conflict between the bar and the cartridge at layer 2: bar moved, re-sliced clean. Bed not confirmed clear or glued from here (camera view not loaded); the printer showed pocket v19 finished before the send |
| 7 Oct 15:39 | Pocket v19 | `scout\cad\wip\pocket_v19\scout_pocket_v19.stl` (49,111.7 mm³, 152.427 x 93.17 x 48.40 in Bambu Studio, checked). Job name on the printer: scout_pocket_v19. Project not saved | Bambu PETG Basic (external spool) | Claude (pocket chat, Spark's go 04:09 "once the design is done send it to the printer" and 14:0x "yeah run that"; bed "cleared and glued, send it" confirmed by Spark 15:38), to Jarvis | Sent, 4 h 37 min, 67.59 g incl. 16.74 g supports (slicer); model 50.85 g. 242 layers, ETA 20:15. 0.20 mm Standard, 4 walls, 30 % gyroid, tree(auto) supports, auto brim, textured PEI + glue (Spark). Upright as exported. Running at 15:41 (0 %, Bambu Studio) |
| 7 Oct 12:32 | Underside v6 | `scout\cad\wip\underside_v6\scout_underside_v6.stl` (1878.36 mm³, 27.039 x 70.199 x 17 in Bambu Studio, checked). Job name on the printer: scout_underside_v6. Project not saved | Bambu PETG Basic (external spool) | Claude (underside chat, Spark's go 12:28 "print it"), to Jarvis | Sent, 40 min 34 s, 3.59 g incl. 1.38 g supports (slicer); model 2.21 g. 106 layers, ETA 13:12. 0.16 mm Optimal, 4 walls, 100 % rectilinear, tree(auto) supports, auto brim, textured PEI. Plate face on the bed as exported. Bed not confirmed clear from here (camera view not loaded); no glue confirmed |
| 7 Oct 01:17 | Cartridge v17b | `scout\cad\wip\cartridge_v17\scout_cartridge_v17b.stl` (20,012.3 mm³, 96 x 58.6 x 40 in Bambu Studio, checked). Job name on the printer: scout_cartridge_v17b. Project not saved | Bambu PETG Basic (external spool) | Claude (noxopt chat, Spark's go 01:04; bed "clear and glued" confirmed by Spark 01:13), to Jarvis | Sent, 2 h 35 min, 28.27 g incl. 5.11 g supports (slicer); model 23.17 g. 0.16 mm Optimal, 4 walls, 30 % gyroid, tree(auto) supports, auto brim, textured PEI + glue (Spark). Upright as exported |
| 6 Oct 22:48 | Latch arm V5c, plate of 4 (2 + 2 spares) | `scout\cad\wip\latch_arm_v5\scout_latch_arm_V5c_x4.3mf` (geometry only; 3735 mm³, 35.6 x 36.2 x 12.7 in Bambu Studio, checked) | Bambu PETG Basic (external spool) | Claude (Spark's go 22:44, "side tabs for the cartridge"), to Jarvis | Sent, 33 min, 4.39 g (slicer), 79 layers, ETA 23:22. 0.16 mm Optimal, 4 walls, 100 % rectilinear, on its side as exported, no supports, auto brim, textured PEI. Before the send Jarvis showed the cartridge v16 reprint finished (100 %, 250 / 250 layers); bed not confirmed clear from here (camera view unusable). Finished: Bambu Studio showed 100 %, 79 / 79 layers at 01:08 on 7 Oct |
| 6 Oct 15:22 | Cartridge v16, reprint | `scout\cad\wip\cartridge_v16\scout_cartridge_v16.stl` (15.32 cm³ in Bambu Studio, checked) | Bambu PETG Basic (external spool) | Claude (pocket + cartridge chat, Spark's go 15:11), to Jarvis | Sent, 2 h 18 min, 22.59 g incl. 5.07 g supports (slicer). 0.16 mm Optimal, 4 walls, 30 % gyroid, **tree(auto) supports** (Spark: the normal zig-zag ones were too hard to remove), auto brim, textured PEI + glue (Spark) |
| 6 Oct, reported by Spark 15:11 | Cartridge v16, the 13:50 job | as the row below | Bambu PETG Basic | - | **Failed: kept peeling off the bed.** No glue, no supports |
| 6 Oct 13:50 | **Cartridge v16** (sent by mistake as "v15": Spark's go was for v15) | `scout\cad\wip\cartridge_v15\scout_cartridge_v15.stl` as it was at 13:46, which held the v16 mesh (16,878,584 bytes, same as `cartridge_v16\scout_cartridge_v16.stl`; Bambu Studio read 15.32 cm³). Job name on the printer: scout_cartridge_v15 | Bambu PETG Basic (external spool) | Claude (pocket + cartridge chat, Spark's go 13:41 / 13:44), to Jarvis | Sent, 1 h 51 min, 17.55 g (slicer), no supports. 0.16 mm Optimal, 4 walls, 30 % gyroid, textured PEI. Slicer warned of floating regions (bridges). The v15 files were re-committed to `cartridge_v15\` at 13:52, after the send |
| 5 Oct 22:19 | Pocket v13 | `scout\cad\wip\pocket_v13_NOT_FOR_PRINT_YET\scout_pocket_v13.3mf` (project saved with the slice settings) | Bambu PETG Basic (external spool) | Claude (pocket chat, Spark's go 22:12), to Jarvis | Sent, 6 h 36 min, 107.5 g incl. 42.0 g supports (slicer); model 65.5 g. 0.20 mm Standard, 4 walls, 30 % gyroid, normal(auto) supports, auto brim, textured PEI |
| 5 Oct 18:30 | Cage v8c nodes v3, plate 2 of 2 (4 top + 4 bottom) | `scout\cage\wip\cage_v8\drawn\print_set_v3\PLATE1_v8c_equator_x8_mid_x4.3mf`, plate 2 | Bambu TPU for AMS (external spool) | Claude (cage chat, Spark's go 18:27), to Jarvis | Finished (Bambu Studio showed 100 %, 153 / 153 layers at 22:12). 3 h 06 min, 55.25 g (slicer) |
| 5 Oct 14:25 | Cage v8c nodes v3, plate 1 of 2 (8 equator corner + 4 mid) | `scout\cage\wip\cage_v8\drawn\print_set_v3\PLATE1_v8c_equator_x8_mid_x4.3mf`, plate 1 | Bambu TPU for AMS (external spool; design assumed TPU 95A) | Claude (cage chat, Spark's go 14:21), to Jarvis | Finished (Bambu Studio showed 100 %, 89 / 89 layers at 18:28). 3 h 12 min, 50.55 g (slicer). Not weighed |
| 5 Oct, time not recorded (reported by Spark 13:47) | Underside v5 | `scout\cad\current\scout_underside_v5.3mf` | PETG | Spark | Printed. Not yet fitted or weighed; 7.1 g (M) |
| 5 Oct 01:46 | Pocket v12 | `scout\cad\wip\pocket_v12_NOT_FOR_PRINT_YET\scout_pocket_v12.stl` | PETG | Jarvis | ETA was ~09:35; finish not confirmed. 109 g incl. 13 g supports (slicer) |

Not confirmed either way: pack bar v2 (sliced, 0.70 g).
