sparkiscool/nox/archive/scout-v2/print/README.md

# Scout v2 print files (retired 22 Oct 2026)

History only: Scout v2 is retired and Scout v3 replaces it. Do not print these. Moved here from `print/` with their rows from `print/README.md`.

| File | Bytes | sha256[:12] |
|---|---|---|
| `s2_cage_corner_node_v3.2.stl` | 4098884 | 68ebc8251d12 |
| `s2_cage_crown_v3.2.stl` | 3495884 | ab40a919f307 |
| `s2_cage_side_node_M_v3.2.stl` | 1855884 | 25b12c24622e |
| `s2_cage_side_node_v3.2.stl` | 1855884 | f677a18af5b5 |
| `s2_cage_side_spacer_v3.stl` | 28884 | 897777d81145 |
| `s2_cage_v4_corner_node.stl` | 14687884 | eb9ce156795f |
| `s2_cage_v4_side_node.stl` | 8051784 | f255ef018e62 |
| `s2_cage_v4_side_node_M.stl` | 8051784 | 673f7bc8d234 |
| `s2_cage_v4_vtee.stl` | 7640684 | 9dcde211e0a6 |
| `s2_cage_v4_wheel.stl` | 48084 | d29ad6bcdbed |
| `s2_cage_vtee_v3.2.stl` | 1514984 | ebf0d34b3a2a |
| `s2_cage_wheel_v3.2.stl` | 64084 | e33a89d8d09a |
| `s2_camera_mount_v2.stl` | 3627884 | 12419b7a720f |
| `s2_cartridge_block_v4.stl` | 58884 | fdaffa184c3b |
| `s2_receiver_v34.stl` | 5914184 | 28fe49d9da09 |
| `s2_socket_v2_coupon_v2.stl` | 414884 | 25725f258d52 |
| `s2_top_case_v1.stl` | 10055684 | e7e950b79f7e |
| `s2_tray_v11.stl` | 13519384 | 8a159ddbd993 |
| `s2_cage_PETG_plate_v3.2.3mf` | 9693098 | a06ab1709693 |
