sparkiscool/nox/runs/scan_stick_cam/v5/solid_print.txt

print/scan_stick_cam_v5.stl PASS {'bodies_plain': 1, 'bodies_eroded': 1, 'eroded_volumes_mm3': [6135.1], 'necks': [], 'drawn_not_in_main': [], 'thin_walls': [], 'acute_edges': 0, 'ok': True}
