sparkiscool/nox/runs/scan_stick/v8/solid_print.txt

print/scan_stick_head_v8.stl PASS {'bodies_plain': 1, 'bodies_eroded': 1, 'eroded_volumes_mm3': [22646.7], 'necks': [], 'drawn_not_in_main': [], 'thin_walls': [], 'acute_edges': 0, 'ok': True}
