sparkiscool/nox/runs/scan_stick/v9/solid_print.txt

print/scan_stick_head_v9.stl PASS {'bodies_plain': 1, 'bodies_eroded': 1, 'eroded_volumes_mm3': [21972.3], 'necks': [], 'drawn_not_in_main': [], 'thin_walls': [], 'acute_edges': 0, 'ok': True}
