sparkiscool/nox/runs/scan_stick_base/v10/solid_print.txt

print/scan_stick_base_v10.stl FAIL {'bodies_plain': 2, 'bodies_eroded': 1, 'eroded_volumes_mm3': [170466.5], 'necks': [], 'drawn_not_in_main': [], 'thin_walls': [], 'acute_edges': 37, 'ok': False}
