sparkiscool/nox/runs/scan_stick_base/v15/solid_print.txt

print/scan_stick_base_v15.stl PASS {'bodies_plain': 1, 'bodies_eroded': 1, 'eroded_volumes_mm3': [199905.7], 'necks': [], 'drawn_not_in_main': [], 'thin_walls': [], 'acute_edges': 37, 'ok': True}
