sparkiscool/nox/runs/scan_stick_base/v16/solid_print.txt

print/scan_stick_base_v16.stl PASS {'bodies_plain': 1, 'bodies_eroded': 1, 'eroded_volumes_mm3': [203005.6], 'necks': [], 'drawn_not_in_main': [], 'thin_walls': [], 'acute_edges': 38, 'ok': True}
