sparkiscool/nox/runs/cage_nodes/v4/node_13/print_orient.txt

runs/cage_nodes/v4/node_13/cage_node_13.stl extents [46.3 68.9 43.8] g PETG 17.94 watertight True
   saved: bed      0 mm2  overhang   2733 mm2  height  43.8  first layer 1 islands [1.6] (total 1.6)  thin-island run 1 mm
