sparkiscool/nox/runs/cage_nodes/v4/node_18/print_orient.txt

runs/cage_nodes/v4/node_18/cage_node_18.stl extents [45.8 56.6 48.4] g PETG 18.46 watertight True
   saved: bed      0 mm2  overhang   2518 mm2  height  48.4  first layer 1 islands [3.8] (total 3.8)  thin-island run 0 mm
