sparkiscool/nox/runs/cage_nodes/v4/node_11/print_orient.txt

runs/cage_nodes/v4/node_11/cage_node_11.stl extents [83.7 51.3 67.2] g PETG 24.08 watertight True
   saved: bed      0 mm2  overhang   3317 mm2  height  67.2  first layer 1 islands [2.0] (total 2.0)  thin-island run 2 mm
