sparkiscool/nox/runs/cage_nodes/v4/node_4/print_orient.txt

runs/cage_nodes/v4/node_4/cage_node_4.stl extents [51.7 48.7 32.9] g PETG 10.97 watertight True
   saved: bed      3 mm2  overhang   1506 mm2  height  32.9  first layer 1 islands [10.4] (total 10.4)  thin-island run 0 mm
