sparkiscool/nox/runs/cage_nodes/v4/node_6/print_orient.txt

runs/cage_nodes/v4/node_6/cage_node_6.stl extents [59.8 36.8 30.7] g PETG 12.76 watertight True
   saved: bed      0 mm2  overhang   2046 mm2  height  30.7  first layer 1 islands [1.6] (total 1.6)  thin-island run 1 mm
