sparkiscool/nox/runs/cage_nodes/setup/nodes_18_2.png

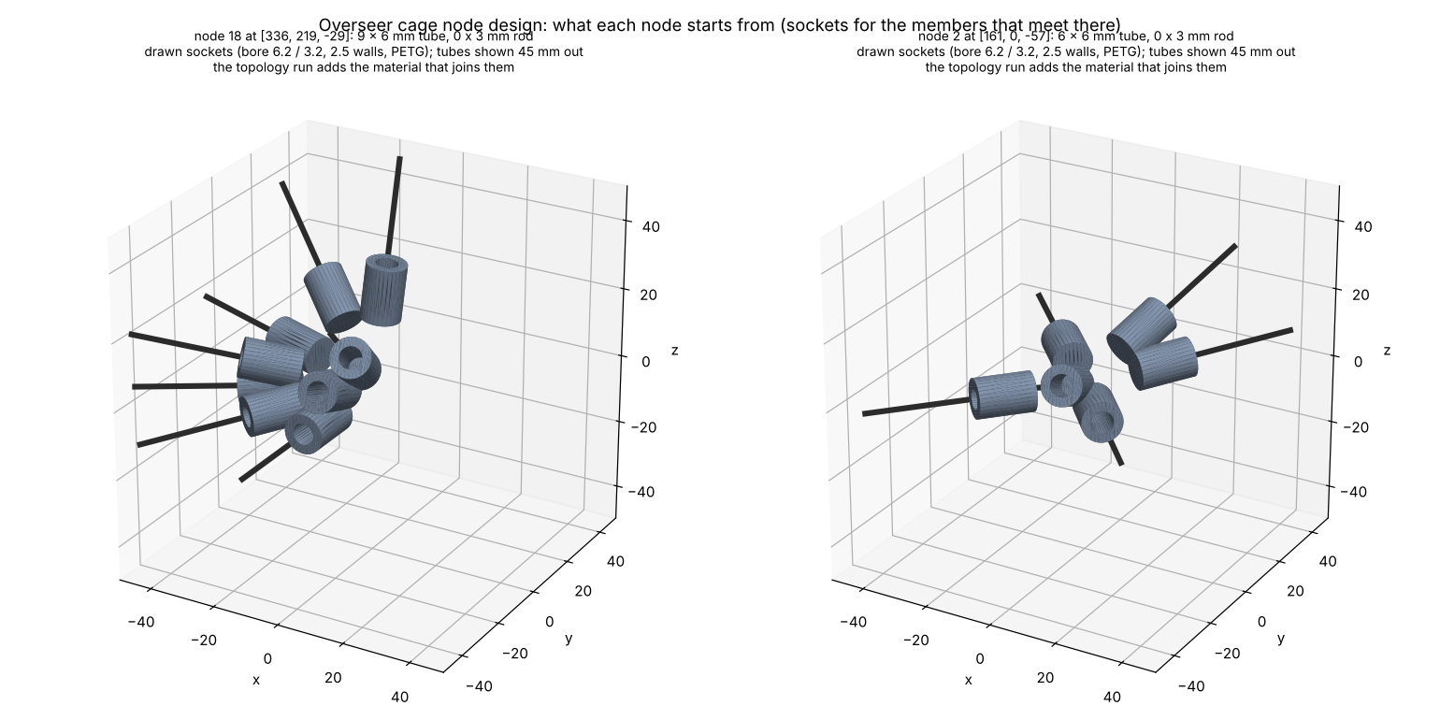
runs/cage_nodes/setup/nodes_18_2.png
