sparkiscool/nox/runs/head_mount/setup/head_setup.png

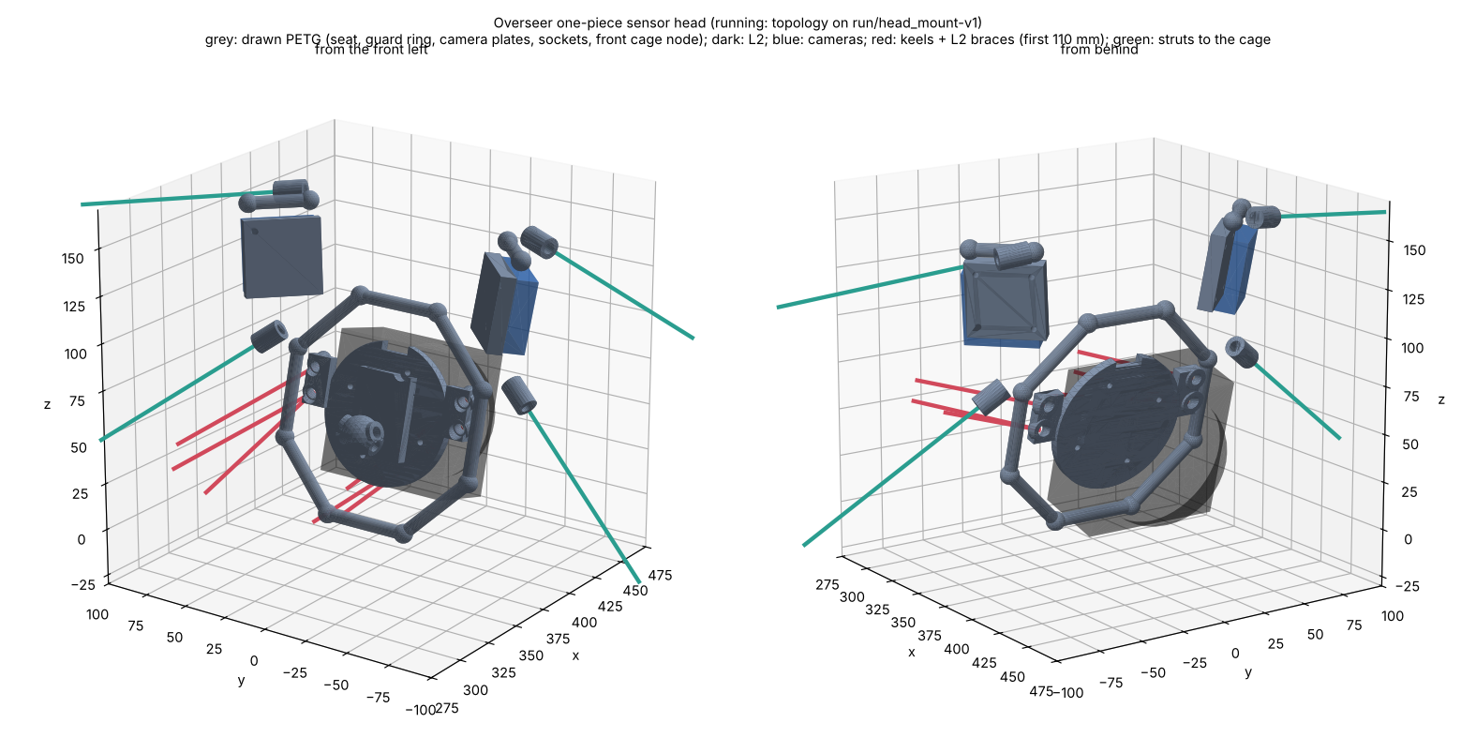
runs/head_mount/setup/head_setup.png
