sparkiscool/nox/runs/head_mount/v5_setup/setup.png

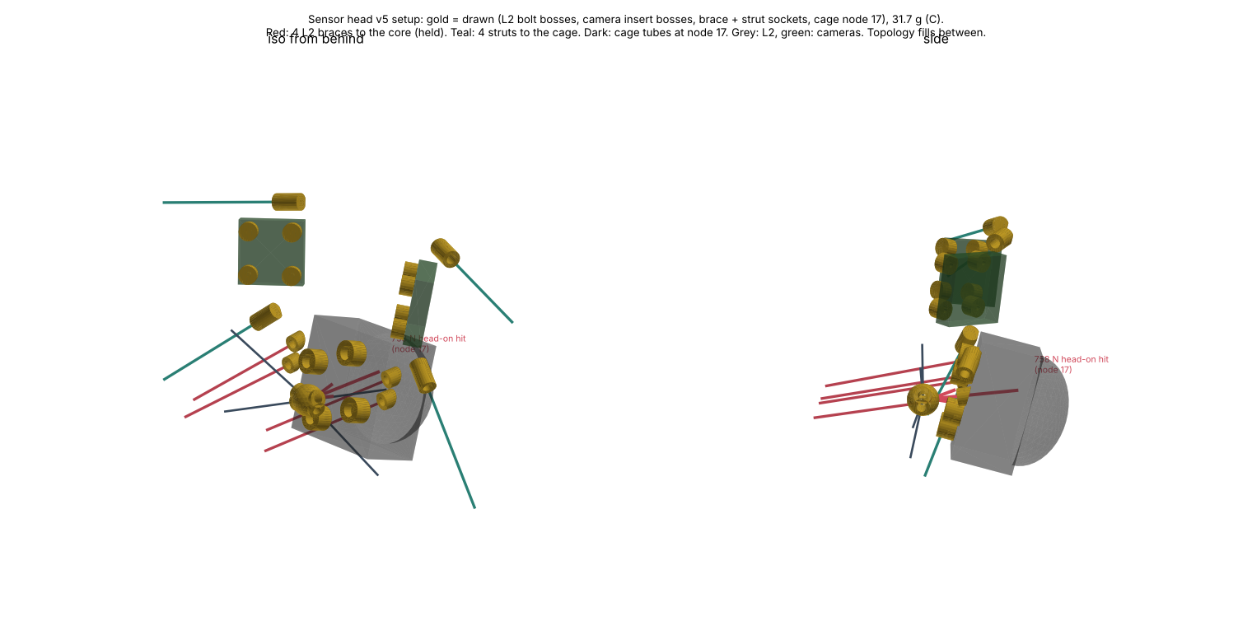
runs/head_mount/v5_setup/setup.png
