sparkiscool/nox/runs/scan_stick/v13/preview_print.png

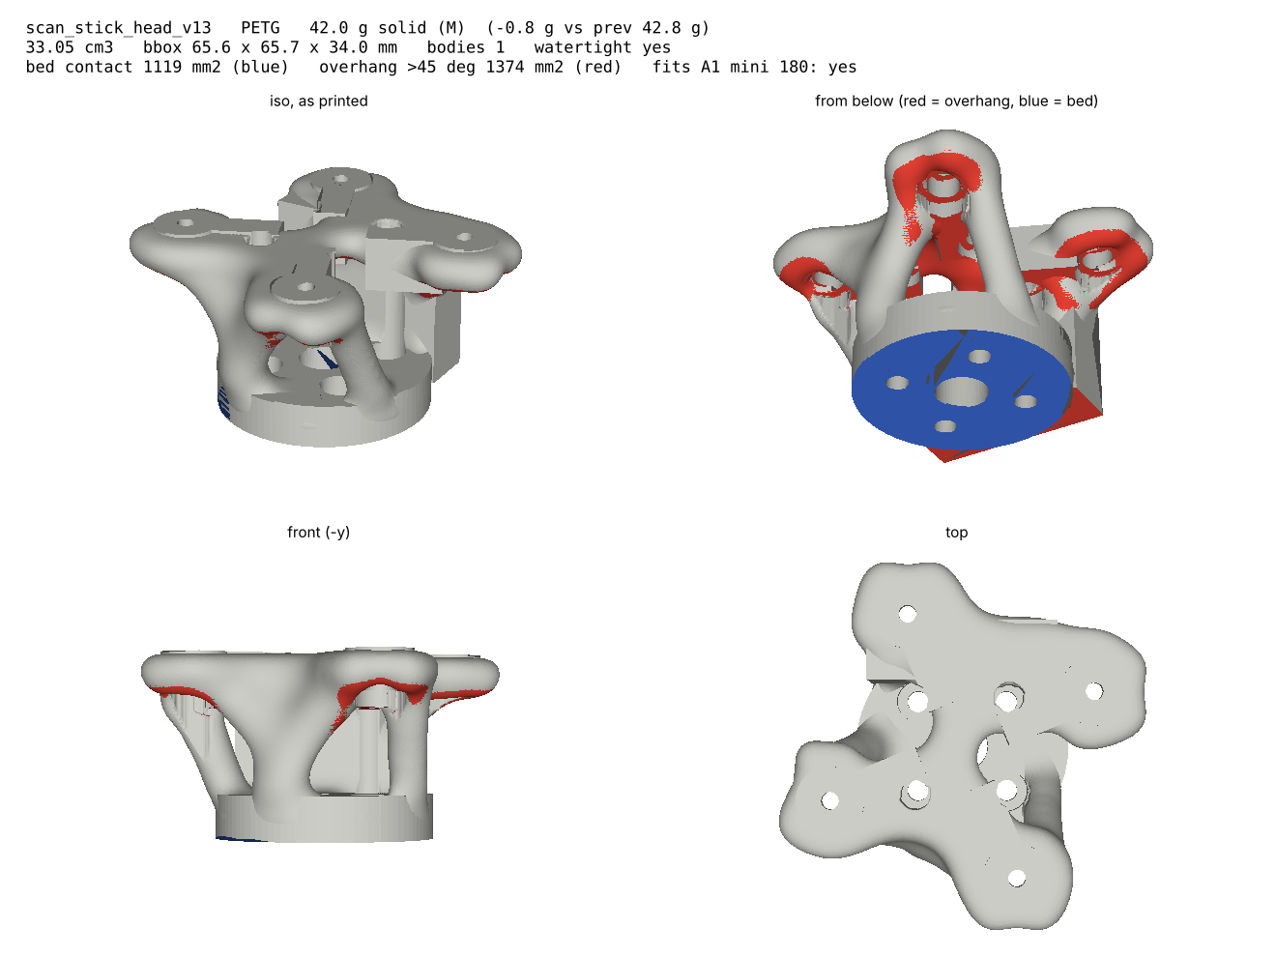
runs/scan_stick/v13/preview_print.png
