sparkiscool/nox/runs/scan_stick_base/v17/preview_print.png

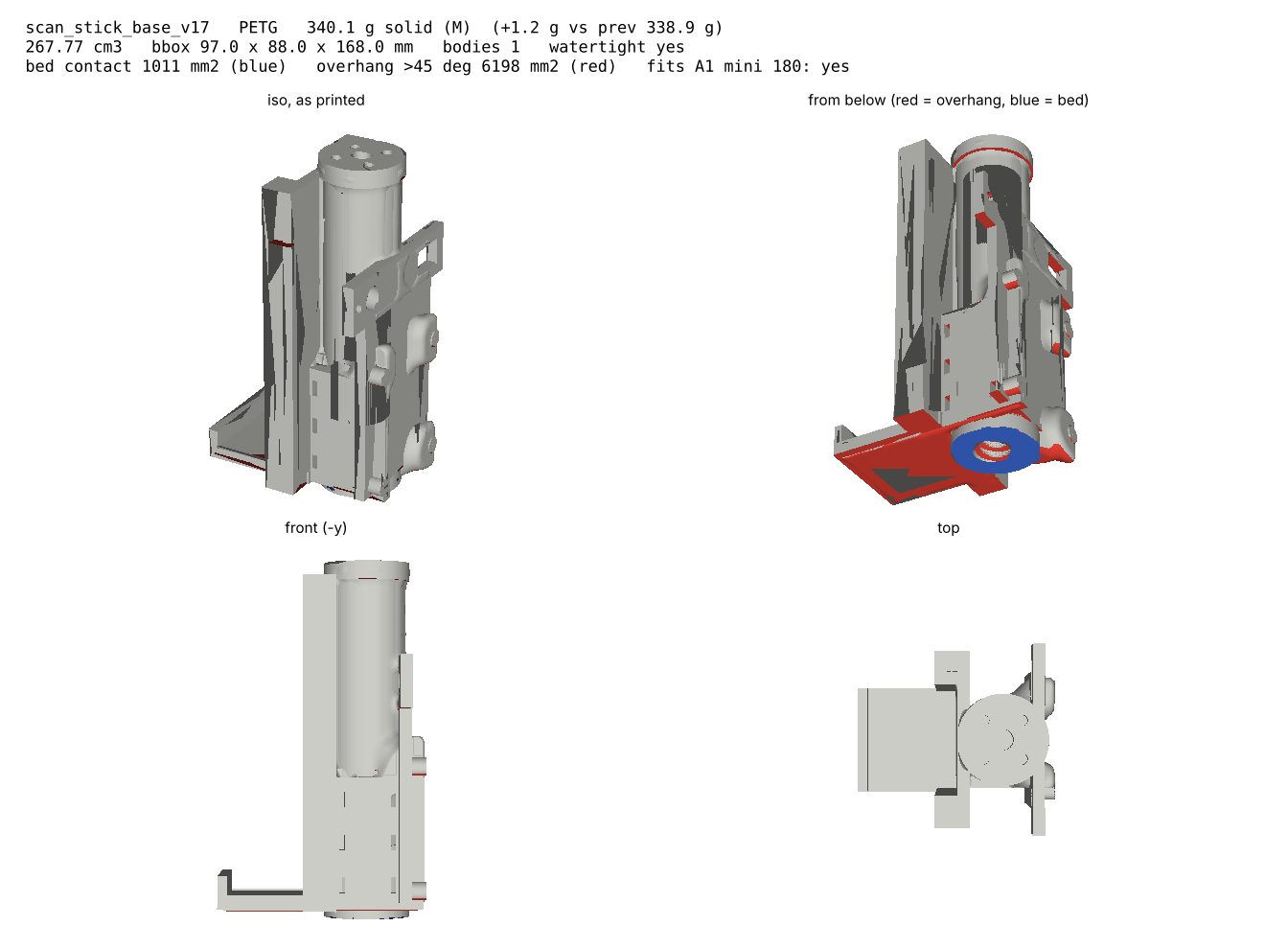
runs/scan_stick_base/v17/preview_print.png
