sparkiscool/nox/runs/scan_stick_cam/v7/preview_print.png

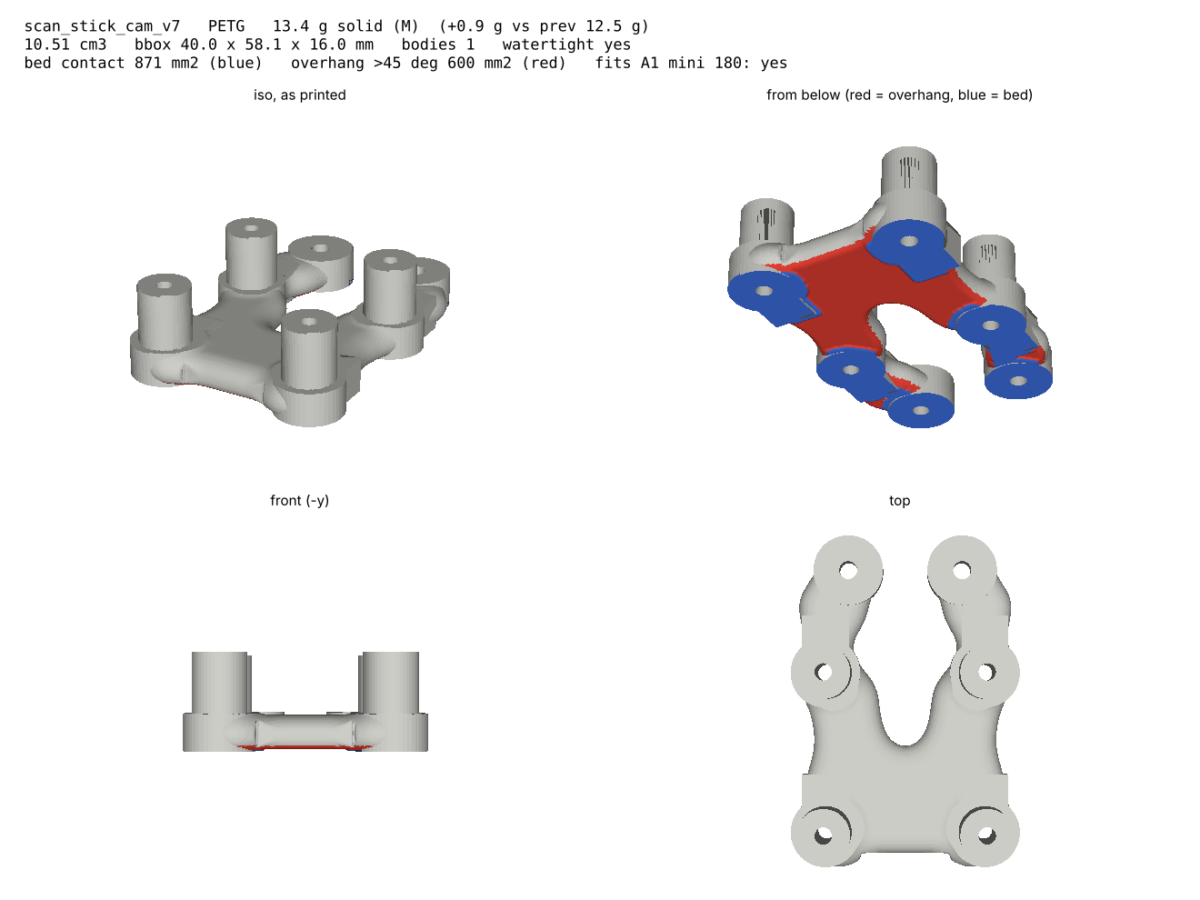
runs/scan_stick_cam/v7/preview_print.png
