sparkiscool/nox/runs/hub/v7/result.html

# Hub v7 result

Nox swap arm hub after the three-strikes system pass: the generated part (PETG, sleeve end on the bed). DESIGN: hub v7 strike 1 on swap, and the assembled recheck waits on the latch v4 receiver.

hub v7 preview: iso, from below, front and top

Check | Hub v7 | Target
solid_check on the file | PASS, 1 body (M) | PASS | met
Mass | 213.3 g (M) | 215 g soft (v5 214 g) | met
Sustained, detent springs | 0.596 (F) | ≤ 1.0 (v6 run 3: 1.075) | met
Misuse, hand on rail tip | 0.468 (F) | ≤ 1.0 | met
Swap, Overseer pull at bay −60 | 0.524 (F) at the sleeve-to-plate corner | ≤ 0.5 (estimate was 0.46, E) | strike 1
Print | sleeve end down: bed 743 mm², 66.9 tall, 170.6 x 169.3 (M) | A1 mini 180 | fits

Next (DEFAULT): an FE on the saved mesh with the 6010 seats compliant, to tell the model's rigid seats and voxel corner from the design; alt: a drawn fillet at r 43 / Y 47.5, then a rerun. Concept page: the options at belt height.

Source runs/hub/v7/ (summary, result.json, preview.png); rows nox/dimensions.md "System box swap: arm", Hub v7.
