sparkiscool/nox/runs/scan_stick/v1/solid_thread_test.txt

nox/overseer/scan_stick/out/scan_stick_thread_test.stl PASS {'bodies_plain': 1, 'bodies_eroded': 1, 'eroded_volumes_mm3': [4073.2], 'necks': [], 'drawn_not_in_main': [], 'thin_walls': [], 'acute_edges': 15, 'ok': True}
