sparkiscool/nox/runs/test_glue_lap/v1/preview.png

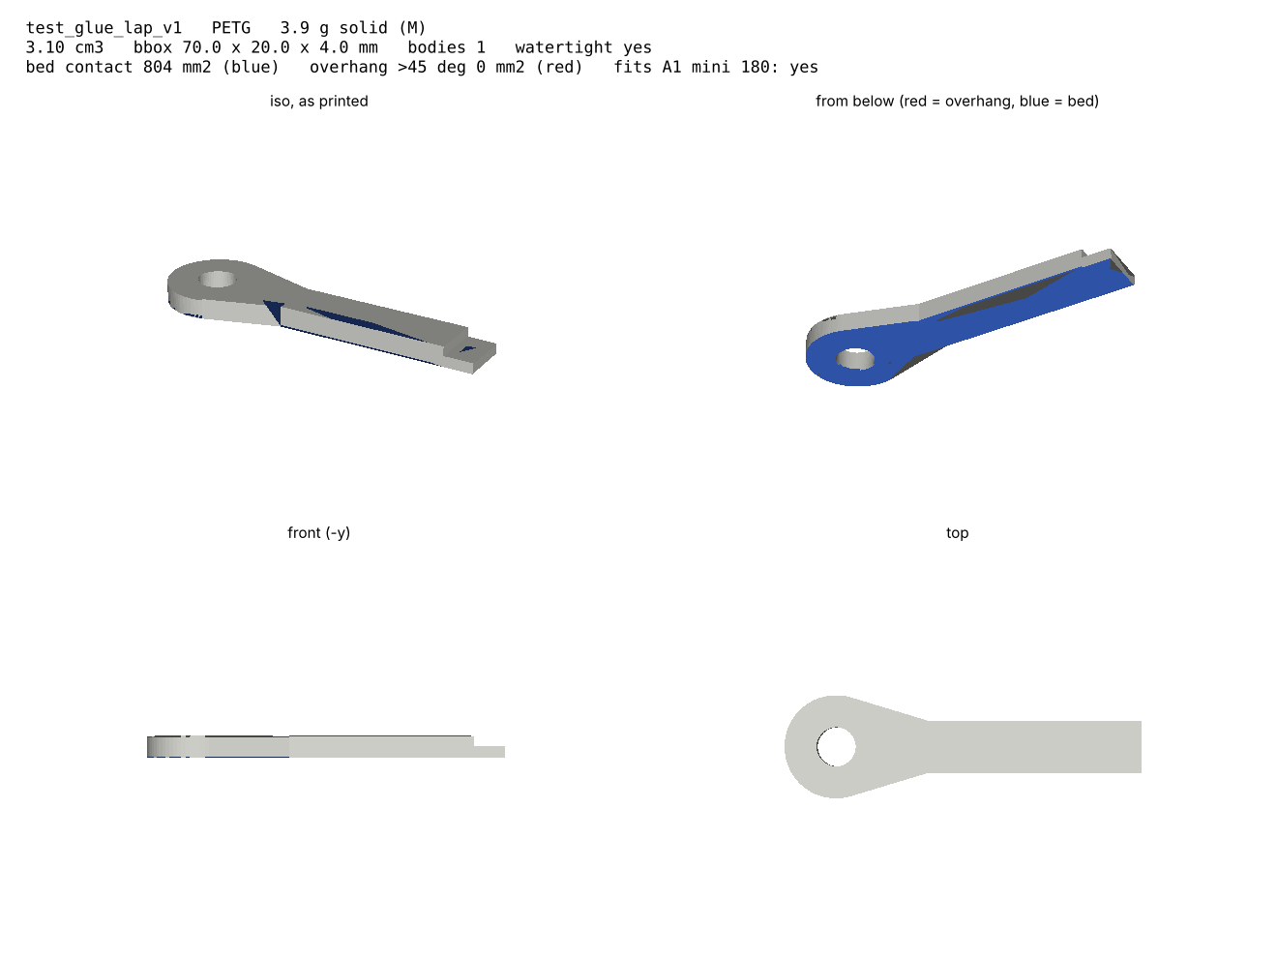
runs/test_glue_lap/v1/preview.png
