sparkiscool/nox/runs/test_post_pull/v1/preview.png

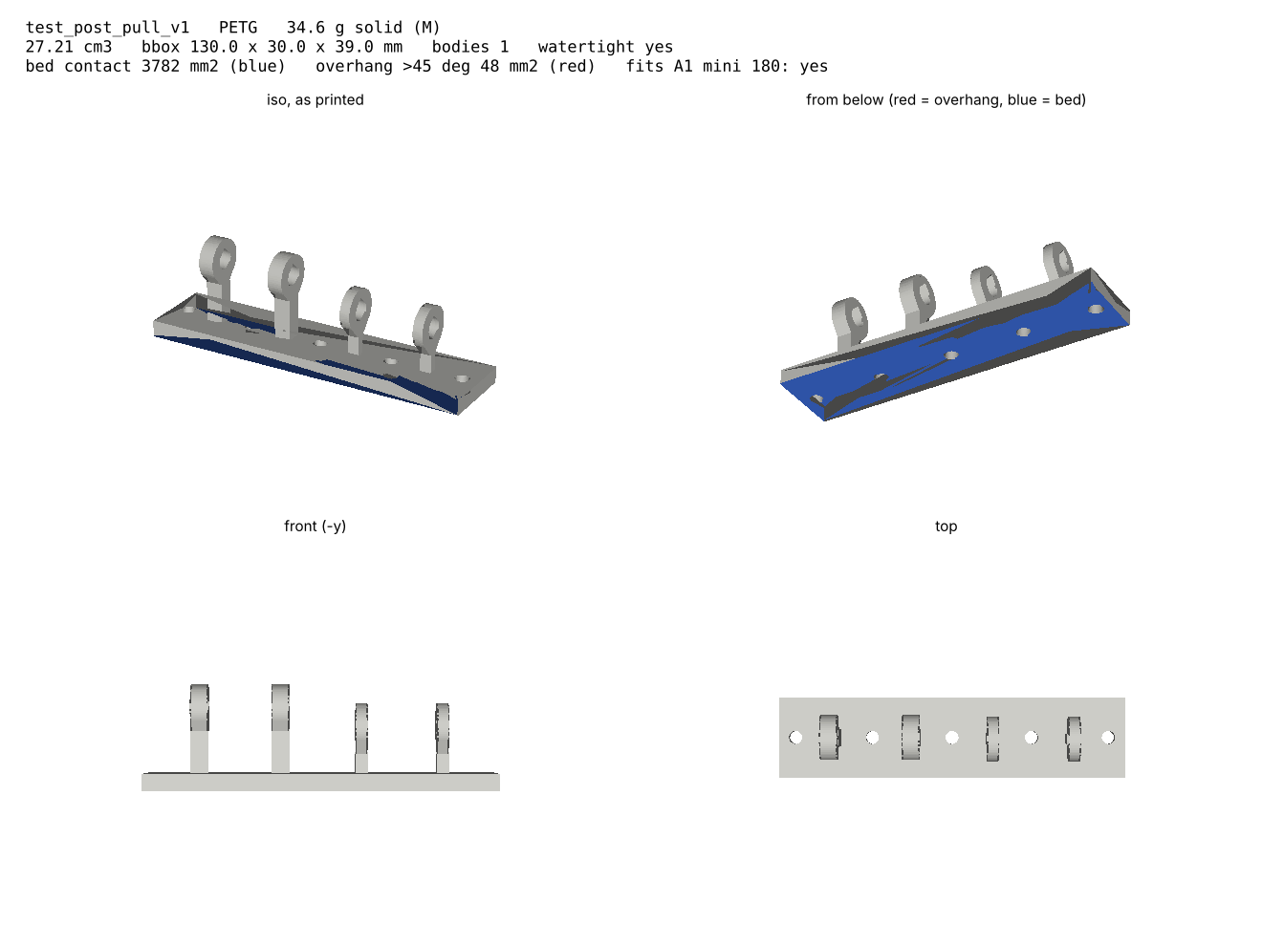
runs/test_post_pull/v1/preview.png
