sparkiscool/nox/runs/test_socket_coupon/v2/preview.png

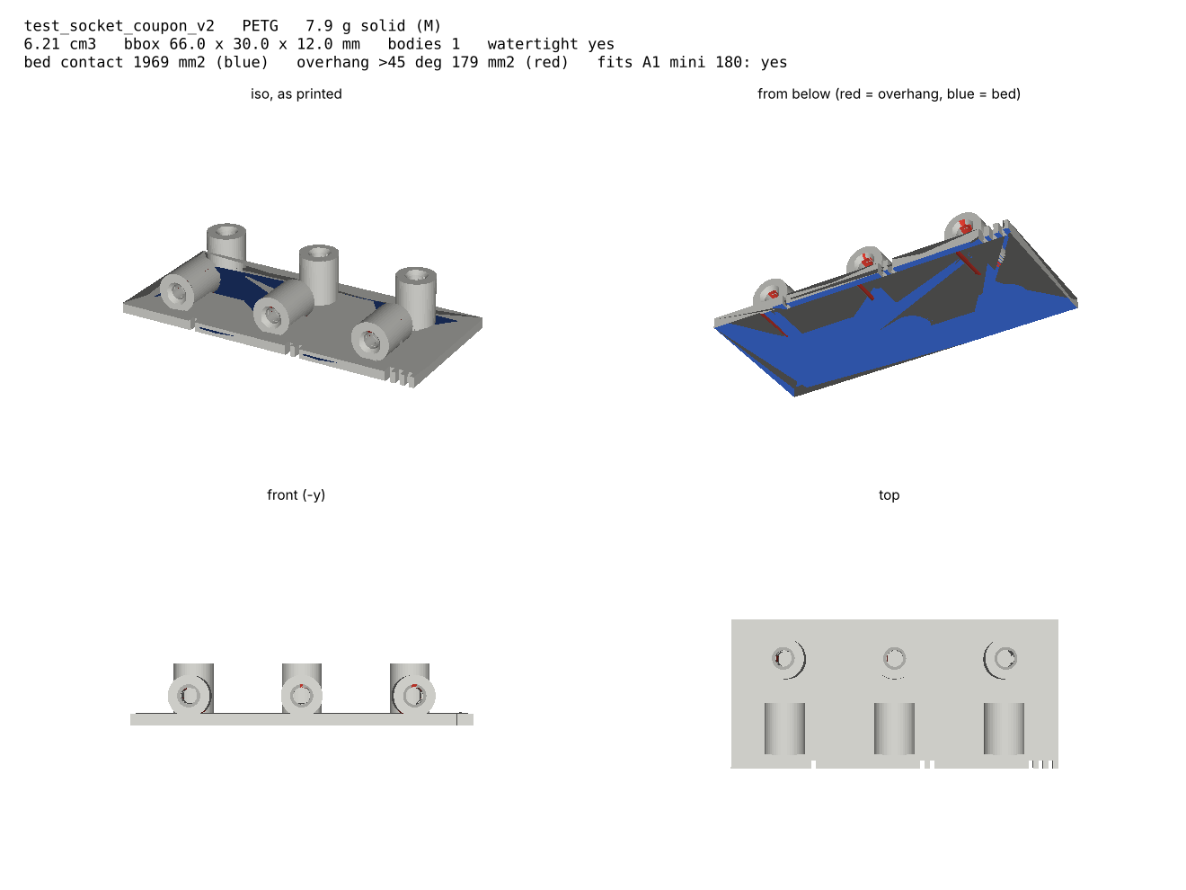
runs/test_socket_coupon/v2/preview.png
