sparkiscool/nox/claude/overseer_params_2026-09-26.params

1	1	BAT1_A_PER_V	78.43	9
1	1	BAT1_CAPACITY	6e+03	9
1	1	BAT1_I_FILT	0	9
1	1	BAT1_I_OVERWRITE	0	9
1	1	BAT1_N_CELLS	4	6
1	1	BAT1_R_INTERNAL	-1	9
1	1	BAT1_SOURCE	0	6
1	1	BAT1_V_CHANNEL	-1	6
1	1	BAT1_V_CHARGED	4.2	9
1	1	BAT1_V_DIV	21.12	9
1	1	BAT1_V_EMPTY	3.5	9
1	1	BAT1_V_FILT	0	9
1	1	BAT_AVRG_CURRENT	15	9
1	1	BAT_CRIT_THR	0.07	9
1	1	BAT_EMERGEN_THR	0.05	9
1	1	BAT_LOW_THR	0.15	9
1	1	BAT_V_OFFS_CURR	0	9
1	1	CA_AIRFRAME	0	6
1	1	CA_ROTOR0_AX	0	9
1	1	CA_ROTOR0_AY	0	9
1	1	CA_ROTOR0_AZ	-1	9
1	1	CA_ROTOR0_CT	6.5	9
1	1	CA_ROTOR0_KM	0.05	9
1	1	CA_ROTOR0_PX	1	9
1	1	CA_ROTOR0_PY	1	9
1	1	CA_ROTOR0_PZ	0	9
1	1	CA_ROTOR10_AX	0	9
1	1	CA_ROTOR10_AY	0	9
1	1	CA_ROTOR10_AZ	-1	9
1	1	CA_ROTOR10_CT	6.5	9
1	1	CA_ROTOR10_KM	0.05	9
1	1	CA_ROTOR10_PX	0	9
1	1	CA_ROTOR10_PY	0	9
1	1	CA_ROTOR10_PZ	0	9
1	1	CA_ROTOR11_AX	0	9
1	1	CA_ROTOR11_AY	0	9
1	1	CA_ROTOR11_AZ	-1	9
1	1	CA_ROTOR11_CT	6.5	9
1	1	CA_ROTOR11_KM	0.05	9
1	1	CA_ROTOR11_PX	0	9
1	1	CA_ROTOR11_PY	0	9
1	1	CA_ROTOR11_PZ	0	9
1	1	CA_ROTOR1_AX	0	9
1	1	CA_ROTOR1_AY	0	9
1	1	CA_ROTOR1_AZ	-1	9
1	1	CA_ROTOR1_CT	6.5	9
1	1	CA_ROTOR1_KM	0.05	9
1	1	CA_ROTOR1_PX	-1	9
1	1	CA_ROTOR1_PY	-1	9
1	1	CA_ROTOR1_PZ	0	9
1	1	CA_ROTOR2_AX	0	9
1	1	CA_ROTOR2_AY	0	9
1	1	CA_ROTOR2_AZ	-1	9
1	1	CA_ROTOR2_CT	6.5	9
1	1	CA_ROTOR2_KM	-0.05	9
1	1	CA_ROTOR2_PX	1	9
1	1	CA_ROTOR2_PY	-1	9
1	1	CA_ROTOR2_PZ	0	9
1	1	CA_ROTOR3_AX	0	9
1	1	CA_ROTOR3_AY	0	9
1	1	CA_ROTOR3_AZ	-1	9
1	1	CA_ROTOR3_CT	6.5	9
1	1	CA_ROTOR3_KM	-0.05	9
1	1	CA_ROTOR3_PX	-1	9
1	1	CA_ROTOR3_PY	1	9
1	1	CA_ROTOR3_PZ	0	9
1	1	CA_ROTOR4_AX	0	9
1	1	CA_ROTOR4_AY	0	9
1	1	CA_ROTOR4_AZ	-1	9
1	1	CA_ROTOR4_CT	6.5	9
1	1	CA_ROTOR4_KM	0.05	9
1	1	CA_ROTOR4_PX	0	9
1	1	CA_ROTOR4_PY	0	9
1	1	CA_ROTOR4_PZ	0	9
1	1	CA_ROTOR5_AX	0	9
1	1	CA_ROTOR5_AY	0	9
1	1	CA_ROTOR5_AZ	-1	9
1	1	CA_ROTOR5_CT	6.5	9
1	1	CA_ROTOR5_KM	0.05	9
1	1	CA_ROTOR5_PX	0	9
1	1	CA_ROTOR5_PY	0	9
1	1	CA_ROTOR5_PZ	0	9
1	1	CA_ROTOR6_AX	0	9
1	1	CA_ROTOR6_AY	0	9
1	1	CA_ROTOR6_AZ	-1	9
1	1	CA_ROTOR6_CT	6.5	9
1	1	CA_ROTOR6_KM	0.05	9
1	1	CA_ROTOR6_PX	0	9
1	1	CA_ROTOR6_PY	0	9
1	1	CA_ROTOR6_PZ	0	9
1	1	CA_ROTOR7_AX	0	9
1	1	CA_ROTOR7_AY	0	9
1	1	CA_ROTOR7_AZ	-1	9
1	1	CA_ROTOR7_CT	6.5	9
1	1	CA_ROTOR7_KM	0.05	9
1	1	CA_ROTOR7_PX	0	9
1	1	CA_ROTOR7_PY	0	9
1	1	CA_ROTOR7_PZ	0	9
1	1	CA_ROTOR8_AX	0	9
1	1	CA_ROTOR8_AY	0	9
1	1	CA_ROTOR8_AZ	-1	9
1	1	CA_ROTOR8_CT	6.5	9
1	1	CA_ROTOR8_KM	0.05	9
1	1	CA_ROTOR8_PX	0	9
1	1	CA_ROTOR8_PY	0	9
1	1	CA_ROTOR8_PZ	0	9
1	1	CA_ROTOR9_AX	0	9
1	1	CA_ROTOR9_AY	0	9
1	1	CA_ROTOR9_AZ	-1	9
1	1	CA_ROTOR9_CT	6.5	9
1	1	CA_ROTOR9_KM	0.05	9
1	1	CA_ROTOR9_PX	0	9
1	1	CA_ROTOR9_PY	0	9
1	1	CA_ROTOR9_PZ	0	9
1	1	CA_ROTOR_COUNT	4	6
1	1	MC_PITCHRATE_D	0.003	9
1	1	MC_PITCHRATE_FF	0	9
1	1	MC_PITCHRATE_I	0.2	9
1	1	MC_PITCHRATE_K	0.4	9
1	1	MC_PITCHRATE_MAX	2.2e+02	9
1	1	MC_PITCHRATE_P	0.15	9
1	1	MC_PITCH_P	4	9
1	1	MC_ROLLRATE_D	0.003	9
1	1	MC_ROLLRATE_FF	0	9
1	1	MC_ROLLRATE_I	0.2	9
1	1	MC_ROLLRATE_K	0.35	9
1	1	MC_ROLLRATE_MAX	2.2e+02	9
1	1	MC_ROLLRATE_P	0.15	9
1	1	MC_ROLL_P	4	9
1	1	MC_YAWRATE_D	0	9
1	1	MC_YAWRATE_FF	0	9
1	1	MC_YAWRATE_I	0.1	9
1	1	MC_YAWRATE_K	1.2	9
1	1	MC_YAWRATE_MAX	3.6e+02	9
1	1	MC_YAWRATE_P	0.2	9
1	1	MC_YAW_P	2.8	9
1	1	MC_YAW_TQ_CUTOFF	2	9
1	1	MC_YAW_WEIGHT	0.4	9
1	1	MOTFAIL_C2T	35	9
1	1	MOTFAIL_OFF	1e+01	9
1	1	MOTFAIL_TIME	1	9
1	1	PWM_MAIN_CENT1	-1	6
1	1	PWM_MAIN_CENT10	-1	6
1	1	PWM_MAIN_CENT11	-1	6
1	1	PWM_MAIN_CENT12	-1	6
1	1	PWM_MAIN_CENT13	-1	6
1	1	PWM_MAIN_CENT14	-1	6
1	1	PWM_MAIN_CENT2	-1	6
1	1	PWM_MAIN_CENT3	-1	6
1	1	PWM_MAIN_CENT4	-1	6
1	1	PWM_MAIN_CENT5	-1	6
1	1	PWM_MAIN_CENT6	-1	6
1	1	PWM_MAIN_CENT7	-1	6
1	1	PWM_MAIN_CENT8	-1	6
1	1	PWM_MAIN_CENT9	-1	6
1	1	PWM_MAIN_DIS1	1000	6
1	1	PWM_MAIN_DIS10	1000	6
1	1	PWM_MAIN_DIS11	1000	6
1	1	PWM_MAIN_DIS12	1000	6
1	1	PWM_MAIN_DIS13	1000	6
1	1	PWM_MAIN_DIS14	1000	6
1	1	PWM_MAIN_DIS2	1000	6
1	1	PWM_MAIN_DIS3	1000	6
1	1	PWM_MAIN_DIS4	1000	6
1	1	PWM_MAIN_DIS5	1000	6
1	1	PWM_MAIN_DIS6	1000	6
1	1	PWM_MAIN_DIS7	1000	6
1	1	PWM_MAIN_DIS8	1000	6
1	1	PWM_MAIN_DIS9	1000	6
1	1	PWM_MAIN_FAIL1	-1	6
1	1	PWM_MAIN_FAIL10	-1	6
1	1	PWM_MAIN_FAIL11	-1	6
1	1	PWM_MAIN_FAIL12	-1	6
1	1	PWM_MAIN_FAIL13	-1	6
1	1	PWM_MAIN_FAIL14	-1	6
1	1	PWM_MAIN_FAIL2	-1	6
1	1	PWM_MAIN_FAIL3	-1	6
1	1	PWM_MAIN_FAIL4	-1	6
1	1	PWM_MAIN_FAIL5	-1	6
1	1	PWM_MAIN_FAIL6	-1	6
1	1	PWM_MAIN_FAIL7	-1	6
1	1	PWM_MAIN_FAIL8	-1	6
1	1	PWM_MAIN_FAIL9	-1	6
1	1	PWM_MAIN_FUNC1	101	6
1	1	PWM_MAIN_FUNC10	0	6
1	1	PWM_MAIN_FUNC11	0	6
1	1	PWM_MAIN_FUNC12	0	6
1	1	PWM_MAIN_FUNC13	0	6
1	1	PWM_MAIN_FUNC14	0	6
1	1	PWM_MAIN_FUNC2	102	6
1	1	PWM_MAIN_FUNC3	103	6
1	1	PWM_MAIN_FUNC4	104	6
1	1	PWM_MAIN_FUNC5	0	6
1	1	PWM_MAIN_FUNC6	0	6
1	1	PWM_MAIN_FUNC7	0	6
1	1	PWM_MAIN_FUNC8	0	6
1	1	PWM_MAIN_FUNC9	0	6
1	1	PWM_MAIN_MAX1	2000	6
1	1	PWM_MAIN_MAX10	2000	6
1	1	PWM_MAIN_MAX11	2000	6
1	1	PWM_MAIN_MAX12	2000	6
1	1	PWM_MAIN_MAX13	2000	6
1	1	PWM_MAIN_MAX14	2000	6
1	1	PWM_MAIN_MAX2	2000	6
1	1	PWM_MAIN_MAX3	2000	6
1	1	PWM_MAIN_MAX4	2000	6
1	1	PWM_MAIN_MAX5	2000	6
1	1	PWM_MAIN_MAX6	2000	6
1	1	PWM_MAIN_MAX7	2000	6
1	1	PWM_MAIN_MAX8	2000	6
1	1	PWM_MAIN_MAX9	2000	6
1	1	PWM_MAIN_MIN1	1000	6
1	1	PWM_MAIN_MIN10	1000	6
1	1	PWM_MAIN_MIN11	1000	6
1	1	PWM_MAIN_MIN12	1000	6
1	1	PWM_MAIN_MIN13	1000	6
1	1	PWM_MAIN_MIN14	1000	6
1	1	PWM_MAIN_MIN2	1000	6
1	1	PWM_MAIN_MIN3	1000	6
1	1	PWM_MAIN_MIN4	1000	6
1	1	PWM_MAIN_MIN5	1000	6
1	1	PWM_MAIN_MIN6	1000	6
1	1	PWM_MAIN_MIN7	1000	6
1	1	PWM_MAIN_MIN8	1000	6
1	1	PWM_MAIN_MIN9	1000	6
1	1	PWM_MAIN_TIM0	-4	6
1	1	PWM_MAIN_TIM1	400	6
1	1	PWM_MAIN_TIM2	400	6
1	1	PWM_MAIN_TIM3	400	6
1	1	PWM_MAIN_TIM4	400	6
1	1	SYS_AUTOSTART	4001	6
