sparkiscool/nox/(commit log)

2026-10-21 Nox repo: code from Nox Source (271 files, sha-verified), core docs, CLAUDE.md, agents, cloud setup
    Claude-Session: https://claude.ai/code/session_01PcJFes6kakb6CNkDUsdzSY
    [box_baymod_v4i_W.obj, overseer_params_2026-09-26.params, scout_B9_B10_2026-10-04.params]
2026-10-21 docs: nox/box-arm.md from Project
2026-10-21 docs: nox/box-case.md from Project
2026-10-21 docs: nox/box-wiring.md from Project
2026-10-21 docs: nox/nox-print-log.md from Project
2026-10-21 docs: nox/v2/s2-top-case.md from Project
2026-10-22 docs: port cage v13 finish lines (20 Oct 22:45, 21 Oct 03:10) from the Project into current-parts and log
    Claude-Session: https://claude.ai/code/session_01FPLzKq6qrVE2sHy7XBQsX1
2026-10-22 print: print/box_bar_half_v8.stl and others from Nox Print Files
    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
    [belt_clamp_coupon_set_v2.stl, box_bar_half_v8.stl, box_baymod_v4i.stl, box_bracket_e_v7c.stl, box_bracket_jA_v8.stl, box_bracket_jB_v7.stl, box_cradle_keel_v6.stl, box_detent_arm_v1.stl]
2026-10-22 print: print/s2_cage_v4_corner_node.stl and others from Nox Print Files
    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
    [s2_cage_v4_corner_node.stl, s2_cage_v4_side_node.stl, s2_cage_v4_side_node_M.stl, s2_cage_v4_vtee.stl, s2_cage_v4_wheel.stl]
2026-10-22 print: print/s2_cage_corner_node_v3.2.stl and others from Nox Print Files
    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
    [s2_cage_PETG_plate_v3.2.3mf, s2_cage_corner_node_v3.2.stl, s2_cage_crown_v3.2.stl, s2_cage_side_node_M_v3.2.stl, s2_cage_side_node_v3.2.stl, s2_cage_side_spacer_v3.stl, s2_cage_vtee_v3.2.stl, s2_cage_wheel_v3.2.stl]
2026-10-22 reorg: retire Scout v2, start Scout v3 and Overseer folders
    - archive/scout-v2/: every Scout v2 doc, script and s2_* print file (history only)
    - nox/box/: box docs moved in beside the box code, content unchanged;
    box collar funnel doc + its scripts (catch_v4 funnel files) kept with the box
    - nox/scout/: scout.md, plus v3/ (new scope stub)
    - nox/overseer/: new scope stub
    - nox/current-parts.md, nox/dimensions.md, nox/log.md moved up from nox/v2/
    - path references updated in CLAUDE.md, nox/README.md, agents and live docs;
    history logs, research notes and code left as written
    [s2_cage_PETG_plate_v3.2.3mf, s2_cage_corner_node_v3.2.stl, s2_cage_crown_v3.2.stl, s2_cage_side_node_M_v3.2.stl, s2_cage_side_node_v3.2.stl, s2_cage_side_spacer_v3.stl, s2_cage_v4_corner_node.stl, s2_cage_v4_side_node.stl]
2026-10-22 topo v1: new topology engine (robust 3-field, anchored-core erosion, geometric length scale, multigrid)
    nox/topo replaces noxopt / noxopt_local / printopt for generated parts:
    - anchored-core erosion: drawn skins erode in the eroded design, so pads cannot hang on necks
    - constant-normalised cone filter (length scale holds against keep-outs)
    - min member in mm, filter radius from a 3D calibration; Zhou 2015 geometric constraints
    - reachability check before the run
    - one Solver: Pardiso on active dofs, Galerkin multigrid CG beyond the RAM budget
    - coarse-grid warm start, time-aware continuation, git checkpoints
    - surface from the filtered field, exact booleans, solid_check gate, as-built stren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
2026-10-22 docs: full parts list and mounting dimensions of bought parts
    - nox/parts-list.md: every part of the box, Scout and Overseer, bought and
    printed, with qty, role and status (on hand / ordered / to buy / CHECK)
    - nox/dimensions.md section M: body sizes and mounting holes of every bought
    part a mount bolts to, from maker datasheets, drawings and CAD (tagged
    spec / listing / typical / derived / CHECK); 6 conflicts with existing rows
    listed for Spark, existing rows unchanged
    - claude/research/2026-10-22-mounting-dimensions.md: the full tables with
    every source URL
    - CLAUDE.md, nox/README.md, nox/log.md: links and one log line
2026-10-22 topo: multigrid CG fixes (dead-node mask shape, batched dot, Jacobi damping from lam_max, exact support elimination)
    - fmask broadcast (nshape) against (nshape, 3): crashed every mg solve.
    - einsum 'k...,k...->k' is invalid numpy; batched dot via reshape-sum.
    - Jacobi(0.6) diverges on 3D hex elasticity (lam_max of D^-1 K is 4.4 to 5.4 here), so the V-cycle was not an SPD
    preconditioner and CG stalled at 300 its. omega is now min(0.6, 4/(3 lam_max)) per level, lam_max by warm-started
    power iteration.
    - residual, search directions and preconditioned residual are projected onto the free dofs, so supports are eliminated
    exactly instead of by 1e4 springs (compliance error 2e-5 -> 7e-14 vs P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
2026-10-22 topo: calibration test against brute-force 3D cone filter
    The old threshold 'plate = 1.0 R analytically' is the 1D hat-filter result. The 3D cone integrated over a plane has the
    cubic profile (1-a)^2(1+2a), whose robust plate blueprint is 0.881 R; rods come out 0.970 R, not 1 to 2 R. The
    calibration code was right. The test now voxelises the exact cone at R = 40 cells, filters a plate and a rod of the
    calibrated input sizes, and requires the blueprint widths within 0.03 R and the centres at eta_e (stricter than before).
2026-10-22 topo: neck test measures anchored erosion where it differs from frozen pads
    The old second condition (anchored ratio > 10 x frozen ratio, same generated 2 mm neck) cannot hold under the
    documented method: skins are input 1 in both modes, so x_tilde is identical, and the constant-normalised filter erodes a
    2 mm generated neck in the design itself. Frozen pads punish it too (2.5e3 vs 2.9e3); a scan of neck positions, widths
    and lengths never separated the two modes by more than 16 %. Anchoring only changes rho_e on drawn skins, so the test
    now also hangs the pad on a 2 mm drawn stem: anchored 3.3e3, frozen 2.7 (> 10x, > 50 required). The generated-neck
    check (> 50) stays.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
2026-10-22 topo: reset V* to its fixed point at every beta step and at the warm start
    The fine stage started with V* = volfrac although the coarse stage had adapted it to 0.195 (dilated / nominal ratio
    1.5 at beta 4). The dilated constraint read +69 % violated, MMA stripped the design (nominal volume 0.10 -> 0.04, J
    10 -> 124 in 4 iterations, eroded compliance 2.4e5 x solid). The same happened in milder form at every beta step,
    since the damped update (gain 0.3 every 5 its) needs ~15 iterations to catch up. V* is now set to
    volfrac * vd / vn for the current design whenever beta changes or a run starts; the damped update still runs between.
2026-10-22 ckpt final
    [holder.stl, holder_view.stl]
2026-10-22 topo: minimum member from the solid gate (gate_member_mm)
    holder topo-v1 failed solid_check's per-body test: it erodes the part by clip(0.8 x depth, 0.9, 2.0) mm round each
    drawn body (depth in the finished part, where generated material fuses on), and the 3.2 mm frame split into 72 pieces
    at 2.0 mm, leaving the pad and hook cores out of the main body. A fixed 3.2 mm length scale cannot pass that gate
    round any drawn body deeper than ~2 mm. optimise() now raises min_member_mm to 2 x gate depth + 1.0 mm (5.0 mm for
    holder and motor_mount), lowered to the largest member the design space routes to every drawn body (bisection on the
    same reachability test), with a log WARNING when the setup cann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
2026-10-23 topo: demos holder + motor_mount done
2026-10-23 topo demos: motor_mount v2 geometry (pads Ø13 x 5, 6 mm seat) so the drawn bodies keep a core under the solid gate
2026-10-23 docs: section M keeps only close values; the rest are open questions
    Spark 22 Oct: where sources are not close (or none has the value), leave it
    as an open question settled when a mount for the part is designed. Close
    conflicts applied: row A FC 36 x 36, motor shaft 3 mm; row O FC hole sizes.
2026-10-23 topo: drawn-masked eroded filter (default; anchored erosion kept as an option, off)
    Claude-Session: https://claude.ai/code/session_01VAzBXjKosn4enmMBhgDPR6
2026-10-23 topo: Part.elems falls back to the cells a thin region intersects (fixes bracket_e's coarse stage)
    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
2026-10-23 topo: geometric constraints only where they can be met (reachability masks); off by default
    bar_half topo-v1 read +294 at beta 32: all 977 counted cells sat at x = 1, 1 to 2 cells off a cut, where the
    constant-normalised filter cannot reach eta_e. With the masks the same density reads 0.002 eps (solid), so the
    robust formulation already holds the solid length scale; void stays at +3.6 to +4.6 and MMA held it constant for
    25+ iterations. Off by default; on with Settings(geometric=True).
    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
2026-10-23 topo: voxelise from below the mesh, not the grid (bracket_jA build volume loss)
    The stand setups' ring cut (r 180 about Y) and BIG half spaces reach under the grid, so the old ray origin
    (zs[0] - 5) sat inside them and inverted those columns: bracket_jA topo-v1 had 64.8 cm3 of design cells of which
    43,352 were inside the ring keep-out. The optimiser put 10.9 cm3 of its 12 there; the exact build (env - cuts) cut
    it away, leaving ~2.4 cm3 generated. Now 21.5 cm3 design, the env - cuts voxels match the masks exactly.
    bar_half and motor_mount masks are unchanged; bracket_e's design space drops from 662 to 515 cm3.
    Claude-Session: https://c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
2026-10-23 topo: compare.py, old vs new part on the same Part grid and load cases
    The print file goes back to W by the inverse of the repo's print-pose rotation (stand_v7_parts.print_pose;
    bar_half 45.12 deg from stand_v8_bar_export.py) and a translation fitted by overlaying the drawn bodies (voxel
    cross-correlation, then Nelder-Mead on exact volumes). Fit on both v8 parts: 0.0 mm3 drawn missing, 0.0 in cuts,
    0.0 outside the envelope. Same grid (h 1.0): bracket_jA v8 38.37 g worst 0.133; bar_half v8 77.58 g worst 0.929.
    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
2026-10-23 topo: motor_mount demo pads 6 mm tall (PAD_T 6.0) so the gate keeps a 2 mm core
    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
2026-10-23 topo: gate ties: thin held drawn bodies count by their cover, unheld bodies tie to one of them
    bracket_jA topo-v2 (masked filter) failed the gate only because the two arms joined through the 4 mm drawn
    flange (half thickness 2.00 mm) that the gate's 2.0 mm erosion removes where nothing covers it: two 2.0 mm
    components of 3903 / 3890 mm3, flange core split 0.501. A held body thinner than the gate erosion now counts in the
    eroded realization by the density of the design material next to it, and a second tie set holds the largest unheld
    body: the others must join it through generated material. Self-test: cover gradient exact, legs-only gate tie
    ratio 5.7e5 vs 15 with a bridge.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
2026-10-23 docs: tier the session reads (CLAUDE.md, docs/, current-parts, open.md)
    Every session loaded a 7 KB CLAUDE.md that repeated a 24 KB rule book, then
    was told to read its row in a 48 KB current-parts.md whose rows carried
    history, retired Scout v2 parts and dead artifact paths.
    Tier 0 (auto): CLAUDE.md, now the loop, a read-when table and the rules.
    Tier 1 (per task): current-parts.md (box rows, current facts only), open.md
    (problems + Spark questions, numbers kept), dimensions.md (headings cleaned,
    rows untouched), parts-list.md.
    Tier 2 (per kind of work): docs/rules.md, workflow.md, generative.md,
    printing.md, README.md map.
    Tier 3 (history): archive/ gains the frozen Scout v2 rows and the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
    [export_hub_set.py, kb_setup_check.py]
2026-10-23 topo: bracket_jA topo-v3 same-grid compare (36.04 g, worst 0.125 vs v8 38.37 g, 0.133)
    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
2026-10-23 topo: build keeps sealed cavities; run --rebuild-from builds again from a finished layout
    bar_half topo-v2's nominal field is a hollow box beam (sealed cavity 3.8 cm3, 72 x 6 x 13 mm). assemble read the
    inverted shell as a negative speck and filled it: +4.8 g at the same worst index (0.804 both). Cavities now stay.
    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
2026-10-23 topo: bar_half topo-v3 = topo-v2 layout rebuilt with its cavity: 71.23 g, gate PASS, worst 0.804 (v8 77.58 g, 0.929 same grid)
    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
    [bar_half.stl, bar_half_view.stl]
2026-10-23 topo: organic finish (default): drawn bodies kept as functional skins, part built as one smooth field
    Spark 23 Oct: the whole structure smooth; only flat contact faces and mounting holes geometric. Built into the engine
    so every part gets it: Layout keeps a drawn body passive only within skin_mm of a cut or the envelope's outside
    (Part.functional_skin), the rest becomes design space; build smooth-unions the generated field with the skins
    (fillet_mm) and cuts holes and contact faces exactly with ^ env - cuts. The function check measures the skins.
    finish=drawn keeps the v1 behaviour; unit tests and compare pin it.
2026-10-23 docs: cut session reads to CLAUDE.md, current-parts, generative
    Spark's keep-or-drop pick. CLAUDE.md is the session loop, 5 hard rules
    and a where-things-are list. open.md and parts-list.md fold into
    current-parts.md (rows + a Spark section). printing.md, rules.md and
    workflow.md fold into generative.md and CLAUDE.md, then go. print/latest
    is dropped: print/ plus the File cell is the source. claude/ research
    stays as a citation only. dimensions.md numbers untouched (three
    pointer phrases only). Every live pointer updated.
    Claude-Session: https://claude.ai/code/session_01EnYSpVzQZcUTgt365k3Gmx
2026-10-23 arm v5-layout: printed V-rails, bearing carriages, rack and pinion replace the 2040 bars and belts
    Layout script arm_v5_layout.py (pure python): rails on hub v5's posts, 3-wheel 625ZZ
    carriages with one eccentric, 16T m1 pinion per head motor on a 71 rack in the head;
    motors v5 A (53.5, 55) / B (-55, -53.5) / axle at -39 deg (balance search); every 2D
    gap >= 1.0 over the stroke; detent re-placement candidates (-45 deg, ring unchanged);
    compaction table (Y_C 175 / 138 / 118, enclosure 403 / 366 / 346). Docs: box-arm.md v5
    section + Problems 24 / 25, dimensions I rows, current-parts DESIGN row + Spark 35, log,
    parts-list, runs/arm/v5-layout.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
2026-10-23 arm v5-layout: box mechanism page in the repo, v4 / v5 / v5-compact toggle
    nox/box/box_mechanism_page.html is the source of the artifact "Nox Box Mechanism" (was
    chat-only): arm version toggle (v4 belts, v5 rails + rack and pinion, v5 compact stack
    Y_C 118), stub v3, stand v7 envelope (mast, keel, cross bar, toe, ring frames, sheets),
    the -90 deg bay cycle (22 s).
    Claude-Session: https://claude.ai/code/session_01DxPBF5EPyWxXir9rTo1kVn
2026-10-23 bracket_jA organic-v1: run log
    Claude-Session: https://claude.ai/code/session_018wGHJyWaFvrQ2JFmEG4Dc8
2026-10-23 topo: organic build without voxel steps (fast-marching distances), rounded skin rims and keep-out fillet; gen_cm3 means the same in both finishes
    organic-v1 (bracket_jA): terraces on every generated face (binary-mask distances), sharp skin rims, a creased flat
    face against the envelope, and gen 20 cm3 filled 85 % of the design space (43.5 g, a solid box beam).
    - signed distances by scikit-fmm from the continuous filtered field and from blurred masks
    - keep-out clip as a smooth max (fillet_mm), skins opened by skin_round_mm (1.0) so their free rims are round
    - function check holds the skins less the rounded free rim
    - Layout adds the drawn volume the organic finish opens to gen_cm3; bracket_j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
2026-10-23 engine: motion.py + /part skill: one prompt to a saved part with its motion artifact
    - nox/motion.py + motion_template.html: any meshes + a pose function or frame
    list -> one self-contained HTML page (scrub, speed, views, groups, printed-only,
    exploded, wireframe, readout strip) and headless mp4 / gif / png via Playwright
    Chromium + ffmpeg. Meshes decimated and quantised (int16 positions, int8
    normals) like the arm page; three.js vendored from npm for the headless
    render because the CDNs are blocked in cloud boxes.
    - .claude/skills/part/SKILL.md: /part <part> <version>: <brief> runs the chain
    branch -> script -> solid_check gate -> print_orient -> preview -> motion
    artifact ->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
2026-10-23 bracket_jA organic-v2: compare
    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
2026-10-23 bracket_jA organic: compare for v1 and v3, summary (final organic-v3)
    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
2026-10-23 topo: gate ties run on their own realization; real cases and ties keep thin held bodies whole
    Crediting a thin held body by its cover in every case let the optimiser drop a held bolt boss entirely: the holder
    end-to-end smoke test built 2 bodies (a 183 mm3 boss loose). Now only the gate ties see the cover (rho_g, one extra
    solve group); the real cases and the ordinary ties see the body whole (rho_e). Smoke test one body again; self-test
    15 / 15. Also: motor_mount topo-v3 summary (gate PASS, 17.21 g), runs index.
    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
2026-10-23 topo: bracket_jA topo-v4 (gate PASS, 36.02 g, worst 0.124 vs v8 38.37 g, 0.133); round 2 write-up
    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
2026-10-23 tools amazon-parts-mcp: Amazon connector for buying parts from chat
    Adds the amazon-parts MCP server under tools/amazon-parts-mcp/ with a root
    .mcp.json so every session on this repo can list, price and order bought
    parts for the scout, overseer and box. Parts are kept by ASIN in
    catalog.json; build_restock_cart / build_cart return a one-click Amazon
    Add to Cart link; log_order records what was bought. PA-API live prices
    and Amazon Business direct ordering are optional and off until keys are
    set. cloud/session_start.sh installs the two packages (mcp, httpx);
    .claude/settings.json enables project MCP servers without a prompt; the
    drone-parts skill describes the ordering flow. CLAUDE.md row an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
2026-10-23 tools pr.py: try the branch delete, check it, print the true outcome (review findings)
    Claude-Session: https://claude.ai/code/session_01BM2yuA3kQKZsBjkowbQMJR
2026-10-23 lidar mount: row added, must be generated with nox/topo (latest engine)
    Claude-Session: https://claude.ai/code/session_01D8guzRrP1URCLfMcDMgaea
2026-10-23 arm v5-layout: review fixes (log line on top, stack question points at the Spark section, C tags on layout numbers)
    Claude-Session: https://claude.ai/code/session_01LRqqX3hGbyFdWRJUkRPUc5
2026-10-23 arm v5-layout: tidy the stack question pointer in box-arm.md
    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
2026-10-23 arm v5-layout: log line points at the Spark section
    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
2026-10-23 docs: solid_check backlog on every print file (5 FAIL rows back to DESIGN)
    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
2026-10-23 scan_stick v1: Overseer L2 + camera + Pi 5 + 4S 6000 on the ACME paint pole: head, thread test, cam bracket, cradle (solid_check PASS), pi recorder, docs
    Claude-Session: https://claude.ai/code/session_01UMo1RcppftL7MxN1iw7sNK
    [scan_stick.scad, scan_stick_cam.stl, scan_stick_cam_v1.stl, scan_stick_cradle.stl, scan_stick_cradle_v1.stl, scan_stick_head.stl, scan_stick_head_v1.stl, scan_stick_thread_test.stl]
2026-10-23 scan_stick v1: review fixes (rear notch removed, tags, chamfer note, feature reasons, result.json keys)
    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
    [scan_stick.scad, scan_stick_head.stl, scan_stick_head_v1.stl]
2026-10-23 scan_stick_head v2: topology run result, 61.9 g, worst 0.03, solid_check PASS, saved
    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
    [scan_stick_head.stl, scan_stick_head_v2.stl, scan_stick_head_v2_runframe.stl]
2026-10-23 scan_stick_head v2: log duplicate removed, Power row restored, tags
2026-10-23 scan_stick v2: assembly motion artifact (assembly_view.py, motion.html/mp4/gif/png)
    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
2026-10-23 scan_stick: head v4 (bolt flange, impact cases), base v2 (one bolted unit on the pole tip), overnight queue
2026-10-23 scan_stick: part doc, dimensions S and parts list for the one-piece layout; assembly view for base v2 + head v4
2026-10-23 topo: holder demo bosses 10 mm round (1.4 mm walls failed the gate)
2026-10-23 scan_stick_cam v3: thicker plate and posts after the v2 gate FAIL; second queue
2026-10-23 topo: holder demo keep-out under the pack from z 27 (5 mm layer under the pad); organic-v1 summary
2026-10-23 scan_stick: cam v3 FAILED (posts), cam v4 Ø12 posts; flange bolts on a 24 square (counterbore wall); queue 4
2026-10-23 scan_stick: head v5 FAILED (keep-out sheet) -> v6; base v3 crashed (support band) -> v4 no coarse stage; queues 5 and 6
2026-10-23 scan_stick_cam v4: ready to print, 12.5 g, worst 0.28, solid_check PASS
    [scan_stick_cam_v4.stl]
2026-10-23 topo: nudge exact-zero build samples off the level (degenerate MC faces, spikes, slivers)
2026-10-23 topo: gate member size over the 0.8 built / blueprint ratio (6.25 mm on the demos)
2026-10-23 scan_stick: head v6 hung in Pardiso (coarse grid), killed; head v7 no coarse stage, queue 7
2026-10-23 scan_stick_base v4 FAILED (bars in the keep-out, 3.5 plates, worst 5.5); v5 thicker plates + web + 60 cm3, queue 8
2026-10-23 topo: gate member margin 2.25 mm (states the 6.25 mm rule on strut evidence, not a built ratio)
2026-10-23 topo: holder demo keep-out under the pack from z 28 (6 mm layer under the pad)
2026-10-23 scan_stick_head v7 FAILED on the insert-hole floor speck (worst 0.36); v8 holes 6 deep, queue 9
2026-10-23 topo: holder demo bosses 12 mm round cut by the envelope (4.4 mm walls)
2026-10-23 scan_stick_base v5 FAILED (worst 2.3 at the flange joint, bar detached); v6 drawn tube column + slotted rails, 30 cm3, started
2026-10-23 scan_stick_base v6 FAILED (slot cheeks, pack side impact 2.2); v7 back plate + 14 rails, 25 cm3, started
2026-10-23 topo: holder demo keep-out under the pack from z 29 (7 mm layer under the pad)
2026-10-23 scan_stick_head v8: ready to print, 40.8 g, worst 0.36, solid_check PASS
    [scan_stick_head_v8.stl]
2026-10-23 scan_stick_base v7 FAILED on voxel specks only (worst 0.58); v8 rebuild with the cut faces off the drawn faces
2026-10-23 scan_stick: retire v1/v2 print files, SCAD trimmed to the thread, dimensions S for the tube base, visual on the final files
    [scan_stick.scad, scan_stick_cam_v1.stl, scan_stick_cradle_v1.stl, scan_stick_head_v1.stl, scan_stick_head_v2.stl]
2026-10-23 scan_stick: head v9 and base v9 rebuilds with the cable hole and tube window; queue 10
2026-10-23 scan_stick_base v8/v9 FAILED (zip-slot slivers); v10 rebuild with the slots at ±12, started
    [scan_stick_base.stl, scan_stick_base_view.stl, scan_stick_head.stl, scan_stick_head_view.stl]
2026-10-23 scan_stick_head v9: ready to print, 40.0 g, worst 0.36, cable hole, solid_check PASS; v8 superseded
    [scan_stick_head_v8.stl, scan_stick_head_v9.stl]
2026-10-23 topo: holder demo bosses 11.5 mm round, centred 0.75 mm toward the part (one core at 2.0 mm erosion)
2026-10-23 scan_stick_base v10 FAILED on one stray voxel; v11 rebuild at 24.5 cm3 started
    [scan_stick_base.stl, scan_stick_base_view.stl]
2026-10-23 scan_stick_base v11 FAILED (same feather); v12 rebuild with a Ø40 exact boss, started
    [scan_stick_base.stl, scan_stick_base_view.stl]
2026-10-23 scan_stick base v12: READY, 300.1 g, worst 0.56, solid PASS on the exact file
    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
    [scan_stick_base.stl, scan_stick_base_v12.stl, scan_stick_base_view.stl]
2026-10-23 scan_stick: assembly visual on base v12 + head v9 (camera bracket placed hanging from the block), doc to the final files
    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
2026-10-23 scan_stick: review fixes in flight (base v13 Pi tray + UBEC bay, head v10 3.0 pad wall, head turned 90 in the assembly, dimensions S corrected)
    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
2026-10-23 topo: case_norm frame: every case renormalised on the first frame the run reaches
2026-10-23 scan_stick head v10: READY, 40.0 g, 3.0 pad wall round the counterbores; base v13 FAILED (envelope clipped the tray), v14 running
    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
    [scan_stick_base.stl, scan_stick_base_view.stl, scan_stick_head.stl, scan_stick_head_v10.stl, scan_stick_head_v9.stl, scan_stick_head_view.stl]
2026-10-23 scan_stick base v14 FAILED (bare envelope clipped the rails), v15 = envelope + drawn bodies, running
    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
    [scan_stick_base.stl, scan_stick_base_view.stl]
2026-10-23 scan_stick base v15: READY, 334.3 g, worst 0.26, solid PASS on the exact file; head turned -90 in the assembly, fit check 0 mm3
    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
    [scan_stick_base.stl, scan_stick_base_v12.stl, scan_stick_base_v15.stl, scan_stick_base_view.stl]
2026-10-23 scan_stick: review round 2 in flight (base v16 switch strip off the tube + M4 Ruthex holes, head v11 10 thick camera block, fastener lengths, cam centre 32, tags)
    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
2026-10-23 scan_stick base v16 + head v11: READY (switch strip off the tube, Ruthex insert depths, fastener lengths), fit check 0 mm3 incl. bracket x board
    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
    [scan_stick_base.stl, scan_stick_base_v15.stl, scan_stick_base_v16.stl, scan_stick_base_view.stl, scan_stick_head.stl, scan_stick_head_v10.stl, scan_stick_head_v11.stl, scan_stick_head_view.stl]
2026-10-23 scan_stick base v17 + head v12: READY (strip to y ±44, 12 thick camera block, M4 key holes); fit check 0 mm3
    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
    [scan_stick_base.stl, scan_stick_base_v16.stl, scan_stick_base_v17.stl, scan_stick_base_view.stl, scan_stick_head.stl, scan_stick_head_v11.stl, scan_stick_head_v12.stl, scan_stick_head_view.stl]
2026-10-23 topo: case_norm solid by default (frame did not lower the worst index)
2026-10-23 scan_stick head v13: READY (camera bolt holes at z 6, clear of the M4 pockets and the pad clearances); render.sh trimmed; fit check 0 mm3
    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
    [scan_stick_head.stl, scan_stick_head_v12.stl, scan_stick_head_v13.stl, scan_stick_head_view.stl]
2026-10-23 topo: bracket_jA organic-v4 on the final engine (PASS, 36.82 g, same-grid worst 0.113)
2026-10-23 overseer cameras: front + underside, lidar coloured by yaw
    Claude-Session: https://claude.ai/code/session_019cLdmnXxfT61oJjQYZxdet
2026-10-23 scan_stick cam v5: 10 mm standoffs with M2.5 inserts (Spark), run started; UBEC taped (Q4 closed); docs, parts list, visual
    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
2026-10-23 topo: organic finish keeps the bodies the main support holds whole (mounting features)
2026-10-23 topo: motor_mount organic-v1 log restored from the run's stdout
2026-10-23 topo: bracket_jA organic-v5 on the final engine (PASS, 36.85 g, same-grid 0.127); motor_mount organic-v1 summary
2026-10-23 docs: Spark's answers into the Scout v3 and Overseer briefs (XT60 back, printed Overseer arms)
    Claude-Session: https://claude.ai/code/session_01UtAnwd6yCFDq4sBWQEyt5j
2026-10-23 config: tidy settings allow list, full connector access
    Claude-Session: https://claude.ai/code/session_019Q9NMAoLSYkxFsHevdz941
2026-10-23 scan_stick cam v5: gate PASS but the web wrapped the standoffs, not saved; v6 (plate-only envelope, board keep-out) started
    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
2026-10-23 topo: holder demo battery channel top edges rounded r 3 mm (approved by Spark 23 Oct)
    Claude-Session: https://claude.ai/code/session_01Mq3TsmHnbqJ1VM7sUYEsGR
2026-10-23 overseer arms: wheelbase sweep, tall root hub for the electronics
    Claude-Session: https://claude.ai/code/session_01W4ha4nNpfnRCJNoGVXQxAF
2026-10-23 scan_stick cam v7: 6 mm plate layer (v6's 4 mm was under the robust plate), run started
    Claude-Session: https://claude.ai/code/session_01H5xwyF6UT3XkacoWwEcWVi
2026-10-23 scan_stick cam v7: docs for the 6 mm plate (M3 x 12, board 2 mm out), run in progress
    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
2026-10-23 overseer arms: S500 listing data (PCB version, carbon gear)
    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
2026-10-23 docs: ready to print ends with a laptop slicing-session prompt (Spark)
    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
2026-10-24 hook_latch v1: 4 face plungers hold the drone through the XT60 swap (no magnets, no steel belly)
    Claude-Session: https://claude.ai/code/session_01VqoFDZzHtrCvyCFHqSNfwA
    [box_hook_latch_housing_A_v1.stl, box_hook_latch_housing_B_v1.stl, box_hook_latch_plunger_v1.stl]
2026-10-24 overseer arms: S500 plate interface from the Holybro S500 STEP
    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
    [S500-C1_ASM.step]
2026-10-24 topo: motor_mount organic-v2 on the final engine (PASS, 18.03 g, worst 0.122)
2026-10-24 scan_stick cam v7: saved, READY (Ø9 x 10 standoffs, 6 mm plate, 13.35 g, worst 0.32, gate PASS); print README lists the scan stick files
    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
    [scan_stick_cam_v7.stl]
2026-10-24 hook_latch v1: review fixes + wider error tolerance (8 x 12 plunger, out 11, lead-in; bolts reachable; open ear slots)
    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
    [box_hook_latch_housing_A_v1.stl, box_hook_latch_housing_B_v1.stl, box_hook_latch_plunger_v1.stl]
2026-10-24 holder organic-v12: solid PASS, 12.5 g, worst 0.481 (rounded battery channel edge)
    Claude-Session: https://claude.ai/code/session_01QiFBmRWx8TT1dWBFnUQT9W
2026-10-24 overseer layout v0: rough design, everything between the plates
    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
2026-10-24 hook_latch v1: review round 2 fixes (bosses clear the guide, honest tolerance band, hall switch per plunger)
    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
    [box_hook_latch_housing_A_v1.stl, box_hook_latch_housing_B_v1.stl, box_hook_latch_plunger_v1.stl]
2026-10-24 ckpt 3: layout v1 front arms 32 wide 30 deep, camera 30 behind the L2 plane
    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
2026-10-24 topo: holder organic-v11 summary corrected (ran with the approved r 3 mm channel edge); v12 and bar_half rows
2026-10-24 hook_latch v1: review round 3 fixes (walls >= 2.0 at the hall recess, magnet and yoke pockets)
    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
    [box_hook_latch_housing_A_v1.stl, box_hook_latch_housing_B_v1.stl, box_hook_latch_plunger_v1.stl]
2026-10-24 overseer layout v1: review fixes (camera row, stale O rows, tags, run notes, board row)
    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
2026-10-24 ckpt 5: layout v1 follows the hook latch (no steel plate, R 5 wheels, plunger keep-out)
    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
2026-10-24 ckpt 6: layout v1 legs knee inboard past the hook latch plungers
    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
2026-10-24 ckpt 7: layout v1 front arms 34 wide, 38 deep at the motor
    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
2026-10-24 overseer layout v1: hook latch update (no steel plate, R 5 wheels, plunger keep-out), deeper front arms
    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
2026-10-24 overseer README: belly sled carries the pogo pads, no steel plate
    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
2026-10-24 box_electronics v1: power, Pi I/O, keep-alive, live bays, swap state machine
    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
    [box_electronics.py]
2026-10-24 arm_rail v1: rails A / B, V-wheel, 16T pinion, eccentric bush drawn and saved; v5 layout fixes
    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
    [arm_eccbush_v1_W.stl, arm_pinion16_v1_W.stl, arm_rail_A_v1_W.stl, arm_rail_B_v1_W.stl, arm_vwheel_v1_W.stl, box_arm_eccbush_v1.stl, box_arm_pinion16_v1.stl, box_arm_rail_A_v1.stl]
2026-10-24 arm_rail v1: review fixes (counterbore through the stop, dimples, carriage 6 inward for the reach, bush boss 3.0, pinion tip relief and neck, real bolt tails, tags, new layout run folder)
    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
    [arm_pinion16_v1_W.stl, arm_rail_A_v1_W.stl, arm_rail_B_v1_W.stl, box_arm_pinion16_v1.stl, box_arm_rail_A_v1.stl, box_arm_rail_B_v1.stl]
2026-10-24 funnel_panel v7: hook latch windows, bosses, re-optimized ribs (skin 2.0)
    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
    [box_funnel_panel_A_v7.stl, box_funnel_panel_B_v7.stl, collar_v7_seat_frame.stl]
2026-10-24 heads v6: carriage from arm_v5_cad (wheels 6 inward, plate u 0..40), bush keep-outs; run restarted
    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
2026-10-24 hook_latch v2 (wip): built on the panel v7 skin 2.0
    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
    [box_hook_latch_housing_A_v2.stl, box_hook_latch_housing_B_v2.stl, box_hook_latch_plunger_v2.stl]
2026-10-24 ckpt 4: cage camera bracket on three 3.0 rods
    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
2026-10-24 ckpt 5: cage layout v2 run outputs (single case, pre-search)
    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
2026-10-24 overseer_cage v0: 3.0 rod cage layout, L2 on the cage, fits the funnel
    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
2026-10-24 funnel_panel v7: v7 plain panel for the unlatched faces (skin 2.0, no latch features)
    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
    [box_funnel_panel_A_v7_plain.stl, box_funnel_panel_B_v7_plain.stl, collar_v7_seat_frame.stl]
2026-10-24 docs: system first, then cut; design the assembled system, split into pieces after
    Claude-Session: https://claude.ai/code/session_01BEtJ8Y7dCsuQ6ko5SnvzNr
2026-10-24 box_assembly v1 (wip): drone landing + latch cycle, cut-away enclosure
    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
2026-10-24 docs: system first applies to every current part; system pass writes piece requirements, pieces run topo in their own sessions
    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
2026-10-24 hook_latch v2 (wip): catch system model (drone + wheels + collar + 4 latches, joint reactions per case)
    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
2026-10-24 hub v6 / heads v6: topo engine setups (system joints as supports and loads), noxopt scripts dropped
    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
2026-10-24 box_assembly v1 (wip): arm v5 through the swap cycle, drone synced
    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
    [box_assembly.py]
2026-10-24 arm v5: detent CHOSEN_V5 + arm v2, cycle v5, sweep 0 overlaps, motion (handoff, WIP)
    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
    [box_detent_arm_v2.stl, detent_arm_v2_W.stl, detent_tower_v5_W.stl]
2026-10-24 docs: box owners without overlap; control session owns arm + battery latch
    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
2026-10-24 tools: system_check.py (cage first, compact, fit, mass/CG on the assembled model)
    Claude-Session: https://claude.ai/code/session_011MGpg8zx6nzatcVg46CaCK
2026-10-24 docs: every drone design, ordered list (Spark 24 Oct), dimensions L standard cases, mount rule
    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
2026-10-24 hook_latch v2: on the panel v7 skin 2.0, catch system pass (joint reactions, compact, cage first)
    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
    [box_hook_latch_housing_A_v2.stl, box_hook_latch_housing_B_v2.stl, box_hook_latch_plunger_v2.stl]
2026-10-24 hook_latch v2: catch manifest through nox/system_check.py (fit, the catch's cage rule as clearances, compact)
    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
    [catch_system.py]
2026-10-24 docs: mass budget per drone (dimensions L), piece slots, review check 7
    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
2026-10-24 chore: slim retired run meshes (46 runs, 741 MB out of the tree)
    Meshes, npz, npy, mp4 and nohup logs removed from 46 retired run folders; RETIRED.md in each has the recovery command. History untouched.
    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
    [bracket_jA.stl, bracket_jA_view.stl, holder.stl, holder_view.stl, motor_mount.stl, motor_mount_view.stl, scan_stick_base.stl, scan_stick_base_view.stl]
2026-10-24 docs: quiet workers, one hub reporter every 30 min; board data tool
    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
2026-10-24 box_structure v1: system model wip (placement, fit, mass, assembled FE)
    Claude-Session: https://claude.ai/code/session_01XNrFXXSRMQV274gBX4znHJ
2026-10-24 tools: assembly.py, one assembly file per system
    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
    [apex.stl, arm_1.stl, arm_2.stl, arm_3.stl, arm_4.stl, bottom_plate.stl, cage_lower.stl, cage_upper.stl]
2026-10-24 tools: system_check access paths + crash probes + mass budget
    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
2026-10-24 hook_latch v2: plunger A / B (the plunger is chiral; B units get the mirrored file)
    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
    [box_hook_latch_plunger_A_v2.stl, box_hook_latch_plunger_B_v2.stl]
2026-10-24 swap arm v6: system model WIP (stack search, frame), hub v6 on the plate
    [hub_v6.py]
2026-10-24 box_catch.assembly.json: hook latch v2 (housings A / B, plungers A / B) posed from catch_system.update_assembly
    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
2026-10-24 test coupons v1: post pull, layer pull, glue lap + socket v2, calibration protocol
    Drawn coupons (nox/tests/coupons.py), solid_check PASS on all 4 files,
    predicted break loads from nox/topo's as-built strength report (h 1.0 / 0.5)
    and hand calcs; docs/tests.md protocol, tools/calibrate.py, dimensions.md T,
    current-parts Tests row.
    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
    [test_glue_lap_v1.stl, test_layer_pull_v1.stl, test_post_pull_v1.stl, test_socket_coupon_v2.stl]
2026-10-24 funnel_panel v7: review 1 fixes (insert holes, lips, square ends, tags, overhang, v6 gate evidence, system loads, cage first)
    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
    [box_funnel_panel_A_v7.stl, box_funnel_panel_A_v7_plain.stl, box_funnel_panel_B_v7.stl, box_funnel_panel_B_v7_plain.stl, collar_v7_seat_frame.stl, funnel_panel_A_v6.stl, funnel_panel_B_v6.stl]
2026-10-24 docs: calibration tests dropped, assumed numbers stand (Spark 24 Oct)
    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
2026-10-24 ckpt: worker WIP saved after container restart (unverified)
    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
    [arm_pinion16_v2_W.stl, arm_rail_A_v2_W.stl, arm_rail_B_v2_W.stl, box_arm_pinion16_v2.stl, box_arm_rail_A_v2.stl, box_arm_rail_B_v2.stl, box_detent_ring_v2.stl, detent_ring_v2_W.stl]
2026-10-24 box_assembly v1 (wip): all cartridge slots built (Spark 24 Oct, DubHacks over): bay modules at every mid position (preview; bays are the structure session's)
    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
2026-10-24 box_assembly v1 (wip): 9 bays, 4 Overseer + 5 Scout (Spark 24 Oct), Overseer at the 4 bottom slots (DEFAULT preview)
    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
2026-10-24 swap arm v6: ignore .cache (latch module staged from its branch)
    Claude-Session: https://claude.ai/code/session_01Uh4XWZg9CPE6hWEiUfbW2L
2026-10-24 battery latch v1: concept check doc, WIP rerun verified
    Claude-Session: https://claude.ai/code/session_01MaK9mf9AZsHwQbiCFQxZ1G
    [box_battery_receiver_overseer_v1.stl]
2026-10-24 battery latch v1: System box swap: latch requirements, receiver topology setup
    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
    [battery_latch_topo.py]
2026-10-24 detent v5: ring v3 keyed on the 80T bolt heads (ring v2 broke the 2.0 rule, strike 2), solid_check PASS; rails / pinion v2 rechecked PASS
    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
    [box_detent_ring_v2.stl, box_detent_ring_v3.stl, detent_ring_v2_W.stl, detent_ring_v3_W.stl]
2026-10-24 swap arm v6: system model on the latch cartridge (receiver-guided insert, motor slip, power-cut bumper, Overseer radius), ties dropped, v6 sweep parts
    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
    [arm_rail_A_v2_W.stl, arm_rail_B_v2_W.stl, box_arm_rail_A_v2.stl, box_arm_rail_B_v2.stl]
2026-10-24 hub v6: topo setup loaded by the system frame's joint reactions (12 cases + detent springs)
    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
2026-10-24 funnel_panel v7: log line within 400 chars, current numbers (review round 2)
    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
2026-10-24 swap arm v6: fixed-wheel axles M5 x 20, rack tail stepped to Y 63 over the axle loop (sweep: hub / axle stacks and loop / rack cleared)
    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
2026-10-24 battery latch v1: concept review fixes (overlap 2.3, undercut 15, Overseer tab-line bosses, FE-sized ends), FE v1, hall read, asym squeeze, Scout system run
    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
    [FC.stl, Radxa_Zero_3W.stl, UBEC.stl, XR2.stl, box_battery_cartridge_overseer_v5.stl, box_battery_cartridge_scout_v5.stl, box_battery_receiver_overseer_v1.stl, box_battery_receiver_scout_v1.stl]
2026-10-24 hook_latch v2: catch assembly on panels v7 / v7 plain (fit 0.0 mm³ in and out), System line from assembly.py --check
    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
    [funnel_panel_A_v7_plain_seat.stl, funnel_panel_A_v7_seat.stl, funnel_panel_B_v7_plain_seat.stl, funnel_panel_B_v7_seat.stl]
2026-10-24 swap arm v6: dimensions System box swap: arm (cases, stack, Y_C 129.1, receiver and head requirements, Overseer finding); commanded insert 96.6; latch receiver at the demo bay in the sweep
    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
2026-10-24 battery latch v1: corner-bearing end plates (FE: crash 0.36 / 0.44), Overseer receiver 179.6 long for the bed, topo setup to match
    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
    [battery_latch.py, battery_latch_topo.py]
2026-10-24 swap arm v6: assembly file box_swap_arm.assembly.json, system_check at 5 poses (fit 0, access 9/9 with 3 x M3 on the axle motor), sweep v6 298 states 0 overlaps
    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
    [axlesA.stl, axlesB.stl, bay3.stl, belt_axle.stl, brg0.stl, brg1.stl, bushA.stl, bushB.stl]
2026-10-24 swap arm v6: layout artifact (concept check), arm_v6_motion on the v6 cycle
    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
    [arm_v6_motion.py]
2026-10-24 hook_latch v2: review fixes (assembled worst over every piece, System Box catch, concept check, 4 files, tags); whole-box preview moved to its own handoff PR
    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
    [box_assembly.py, catch_system.py]
2026-10-24 swap arm v6: READY v5 parts rechecked (wheels / bush pass; rails v1 / pinion v1 fail, superseded by v2); ring v3 bottom down (916 mm2); previews
    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
    [box_detent_ring_v3.stl]
2026-10-24 swap arm v6: box-arm.md v6 system pass section
    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
2026-10-24 hook_latch v2: review optional fixes (stale doc lines, tags, n/a panel cases, one log line, index untouched)
    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
    [catch_system.py]
2026-10-24 battery latch v1: final rerun, print files, previews
    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
    [box_battery_cartridge_overseer_v5.stl, box_battery_cartridge_scout_v5.stl, box_battery_receiver_lid_overseer_v1.stl, box_battery_receiver_lid_scout_v1.stl, box_battery_receiver_overseer_v1.stl, box_battery_receiver_scout_v1.stl, box_battery_receiver_strip_overseer_v1.stl, box_battery_receiver_strip_scout_v1.stl]
2026-10-24 swap arm v6: concept review fixes: receiver as gap + spring, free cases as misuse bound, insert ends on the stall (+2.7), power cut carrying + head brake requirement, receiver moment in L Swap
    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
    [hub_v6_topo.py]
2026-10-24 swap arm v6: summaries for rails v2, pinion16 v2, detent ring v3; checks refreshed
    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
2026-10-24 rules: picture of every print file in a ready-to-print reply (Spark 24 Oct)
    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
2026-10-24 battery latch v1: docs, System box swap: latch final numbers, summary, row, log, figures
    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
    [battery_latch_figure.py]
2026-10-24 battery latch v1: drop the stale WIP stand-in system check
    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
2026-10-24 battery latch topo: Scout crash at 15.3 g (cage suspension cap), Overseer 35 g
    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
    [battery_latch_topo.py]
2026-10-24 box catch: Overseer layout B recheck (pack in / out CG): landing on 8 wheels, latch worst 0.89, G (7) node loads 34 / 175 N
    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
2026-10-24 battery latch v1: re-review follow-ups (two halls per tab swept, keel node 4 stand-in clears cage first, free-fall side hit, Overseer budget slots and clash owners)
    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
2026-10-24 battery latch v1: previews from the exact print files, named in summary.md; merge origin/main
    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
2026-10-24 swap arm v6: concept FAIL x2 recorded with the options table, Overseer at R 113 and 9 bays, head brake on driver enable, pushing-head reporting; rows, log, motion artifact
    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
    [hub_v6_topo.py]
2026-10-24 funnel_panel v7: one preview per print file (A, B, A plain, B plain)
    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
2026-10-24 battery latch v1: sliders print bar top down (largest face), previews from the print files
    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
    [box_battery_slider_overseer_v5.stl, box_battery_slider_scout_v5.stl]
2026-10-24 swap arm v6: per-file previews (rule PR 68); Overseer drone seat 30 behind its thrust axis in the system model (only +Y works, grip tabs on the thrust axis)
    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
2026-10-24 box catch: Overseer recheck review 2 notes (wheel spot v40, allowable, governing case)
    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
2026-10-24 battery latch v1: XT60 end at the arm side (hub, arm v6 pitch), Scout set turned 180, R 113; rerun
    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
    [box_battery_cartridge_scout_v5.stl, cage_standin.stl, cartridge.stl, drone_rest_standin.stl, pack.stl, receiver.stl, receiver_lid.stl, receiver_strips.stl]
2026-10-24 box_structure v1: system pass (whole-box model, 18 cases, assembled piece rechecks, requirements)
    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
    [box_bar_half_v8_W.stl, box_bracket_e_v7c.stl, box_bracket_e_v7c_W.stl, box_bracket_jA_v8_W.stl, box_bracket_jB_v7.stl, box_bracket_jB_v7_W.stl, box_cradle_keel_v6.stl, box_cradle_keel_v6_W.stl]
2026-10-24 swap arm v7: system model (R 113, both packs, ties, XT60 at the closed end, Y_C 138, head B short rack tail, detent tower (31.1, -31.1)), rails v3, sweeps 0 arm overlaps, checks at 5 poses
    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
    [arm_rail_A_v3_W.stl, arm_rail_B_v3_W.stl, axlesA.stl, axlesB.stl, belt_axle.stl, box_arm_rail_A_v3.stl, box_arm_rail_B_v3.stl, brg0.stl]
2026-10-24 battery latch v1: Overseer tab line on its thrust axis (swap CG + 30 toward the XT60 end, arm v6 common grip, Spark B), grip moment check; rerun
    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
    [box_battery_cartridge_overseer_v5.stl, box_battery_receiver_overseer_v1.stl, box_battery_slider_overseer_v5.stl, cage_standin.stl, cartridge.stl, pack.stl, receiver.stl, receiver_lid.stl]
2026-10-24 swap arm v7: requirements (dimensions System box swap: arm v7), box-arm v7 section, layout artifacts, hub topo setup on v7 cases
    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
    [arm_v6_motion.py, hub_v6_topo.py]
2026-10-24 rails v3: summary, previews, print_orient (bottom 2681 mm2)
    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
2026-10-24 box_structure v1: review fixes (HOLD for v2-bound parts, probes DEFAULT logged, tags, fit and CG notes, pkl untracked)
    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
    [box_system.py]
2026-10-24 swap arm v6: review fixes: v6 pieces DESIGN (pinion16 v2, ring v3, rails v2 out of print/, arm v2 do not print), wheels / bush READY conditional on the head brake, System lines in form, one log line 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
    [box_arm_pinion16_v2.stl, box_arm_rail_A_v2.stl, box_arm_rail_B_v2.stl, box_detent_ring_v3.stl]
2026-10-24 swap arm v6: review round 3 fixes: detent arm v2 out of print/, wheels / bushes DESIGN until the head brake, System lines with the power cut worst, stale print paths, tags, runs/arm/v6/summary.md, dr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
    [detent_arm_v2_print_pose.stl]
2026-10-24 box_structure v2: layout (9 bays at R 113, latch v1 receivers, catch at the new seat, enclosure sized round it)
    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
    [bay_envelopes_W.stl, cartridge_paths_W.stl, catch_W.stl, drone_W.stl, mount_pads_W.stl, overseer_cartridge_c.stl, overseer_pack_c.stl, overseer_receiver_c.stl]
2026-10-24 box_structure v2: layout on the hub DEFAULT (alternating bays, Y_C 138), alternatives
    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
    [bay_envelopes_W.stl, cartridge_paths_W.stl, catch_W.stl, drone_W.stl, mount_pads_W.stl, receivers_W.stl]
2026-10-24 box_electronics v1: head brake (NC relays short each head-motor coil when its driver is off)
    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
2026-10-24 battery latch v1: Overseer receiver 66.8 wide (bosses on the deck, arm v7 alternating bays), numbers refreshed
    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
    [box_battery_receiver_lid_overseer_v1.stl, box_battery_receiver_overseer_v1.stl, box_battery_receiver_scout_v1.stl, cage_standin.stl, drone_rest_standin.stl, receiver.stl, receiver_lid.stl]
2026-10-24 swap arm v7 round 2 (after strike 3): alternating bays, axle driver on for inserts and pulls, detent x1.25, bay cases at every real angle, Overseer cycle assembly checks, XT60 tolerance stack, brake 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
    [axlesA.stl, axlesB.stl, belt_axle.stl, brg0.stl, brg1.stl, bushA.stl, bushB.stl, detent_arm.stl]
2026-10-24 swap arm v7 round 2: layout artifacts, stale sweeps dropped
    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
2026-10-24 battery latch v1: Overseer set vs the 168 funnel opening (162 unreachable with the 148 pack; v1 needs 190.7), recorded
    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
2026-10-24 box_structure v2: concept review fixes (funnel-centre finding, access paths, arm envelopes, envelope trims, tags)
    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
    [bay-120_body_envelope.stl, bay-120_cartridge.stl, bay-120_receiver.stl, bay-150_body_envelope.stl, bay-150_cartridge.stl, bay-150_receiver.stl, bay-180_body_envelope.stl, bay-180_cartridge.stl]
2026-10-24 battery latch v1: hub DEFAULT recorded (v1 stays; catch widens the opening, arm moves its plate)
    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
2026-10-24 box_electronics v1: head brake review fixes (own output pin sequenced against the enable, 2 relays, bare ULN2003A, Overseer drop case)
    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
2026-10-24 swap arm v7: pin the staged latch module to bc69935 (round 2 on the v7 spans)
    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
2026-10-24 box_electronics v1: head brake review optional fixes (MANUAL_STEPPER enable, park-stop disable, tags)
    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
2026-10-24 box_structure v2: room for an asymmetric funnel v8 (+Y 32.5: the Overseer set is lopsided), review fix
    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
    [box_layout_v2.py]
2026-10-24 battery latch v1: receiver topology attempt recorded (Scout FAIL, drawn v1 stays)
    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
2026-10-24 swap arm v7 round 3: latch d0cd1a1 orientation, low carriage stack + rail v4 keel, structure v2 bays, belt lever and park-stop fixes, head-out power cut, XT60 mate at every bay with gravity
    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
    [arm_rail_A_v4_W.stl, arm_rail_B_v4_W.stl, box_arm_rail_A_v4.stl, box_arm_rail_B_v4.stl]
2026-10-24 swap arm v7 round 3: sweeps both cycles 0 overlaps on the low stack, 5:1 axle + detent x1.5, layout pages
    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
2026-10-24 swap arm v7 round 3: requirements, rows, log line, rail v4 summary; v3 rails out of print/
    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
    [axlesA.stl, axlesB.stl, box_arm_rail_A_v3.stl, box_arm_rail_B_v3.stl, bushA.stl, bushB.stl, headA.stl, headB.stl]
2026-10-24 funnel_panel v8_plain: ±x panels end at seat z 12.8 (opening 191 x 168), ribs rerun, FE, collar fit, assembly + catch system
    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
    [box_funnel_panel_A_v8_plain.stl, box_funnel_panel_B_v8_plain.stl, collar_v8_seat_frame.stl, funnel_panel_A_v8_plain_seat.stl, funnel_panel_B_v8_plain_seat.stl]
2026-10-24 box_structure v2: arm round 3 requirements (stub stiffness, bay datum to the mast, rail disc keep-out)
    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
    [bay-120_body_envelope.stl, bay-150_body_envelope.stl, bay-180_body_envelope.stl, bay-30_body_envelope.stl, bay-60_body_envelope.stl, bay-90_body_envelope.stl, bay0_body_envelope.stl, bay30_body_envelope.stl]
2026-10-24 box_structure v2: stub target 5 mrad (hub DEFAULT pitch guidance), catch file in W used as is
    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
2026-10-24 funnel_panel v8_plain: box_catch.assembly.json posed in box W of box structure v2 (SEAT_TO_W in catch_system), merge main
    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
2026-10-24 swap arm v7 round 3b: tab line on the latch set centre (latch 0c13edb), Y_C 165 (DEFAULT, hub funnel constraint)
    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
2026-10-24 ckpt 1: swap arm v7 round 3b runs in progress
    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
2026-10-24 ckpt 2: swap arm v7 round 3b run logs
    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
2026-10-24 box_electronics v1: brake on the axle motor (3 relays), boot self-test, live bays on the v2 ring
    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
2026-10-24 swap arm v7 round 3b: receiver pitch guidance in the XT60 budget (hub DEFAULT)
    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
    [fingA_A.stl, fingA_B.stl, fingB_A.stl, fingB_B.stl, gripA.stl, gripB.stl, pack_charged.stl, pack_dead.stl]
2026-10-24 ckpt 3: swap arm v7 round 3b run logs
    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
2026-10-24 swap arm v7 round 3b: sweeps at Y_C 165
    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
2026-10-24 box_structure v2: rerun every layout variant after the disc trim, drone lane over the carriage's Y only, catch frame test per file with R / Y offsets
    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
    [bay-120_body_envelope.stl, bay-150_body_envelope.stl, bay-180_body_envelope.stl, bay-30_body_envelope.stl, bay-60_body_envelope.stl, bay-90_body_envelope.stl, bay_envelopes_W.stl, drone_30.stl]
2026-10-24 box_structure v2: Y_C 165 (funnel on the grip line, funnel v8 room 11.5), drone lane with the grabber, stub 5 mrad only; new: -Y panel vs carriage wheels
    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
    [bay-120_body_envelope.stl, bay-120_cartridge.stl, bay-120_receiver.stl, bay-150_body_envelope.stl, bay-150_cartridge.stl, bay-150_receiver.stl, bay-180_body_envelope.stl, bay-180_cartridge.stl]
2026-10-24 box_system v2 topo: asymmetric funnel, rail disc, stub tilt case, h 8
2026-10-24 battery latch v1: review fixes: Scout System line from the Scout refit (access 7/7, bolts up from below), Overseer set DESIGN (out of print/), first mode, tags and stale numbers
    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
    [FC.stl, Radxa_Zero_3W.stl, UBEC.stl, XR2.stl, XT60E1-M.stl, box_battery_cartridge_overseer_v5.stl, box_battery_receiver_lid_overseer_v1.stl, box_battery_receiver_overseer_v1.stl]
2026-10-24 battery latch v1: doc number
    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
2026-10-24 box_electronics v1: review fixes (self-test in a slow spreadCycle move, idle = brake order, axle 5:1, arm v7 wording) + keep-alive through the funnel panel probes, seat sense on GPIO 24
    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
2026-10-24 box_structure v2: drone-insert keep-outs from the arm v7 head (carriage from Y 53.75, grabber X +-47.5), as two parts; Y_C alt logged
    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
    [drone_30.stl, drone_31.stl]
2026-10-24 box_electronics v1: review fixes (TMC stepper names, 50 ms brake dwell, seat sense 2.2 kOhm + 1k + TVS, panel probe leads, script rerun)
    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
    [box_electronics.py]
2026-10-24 swap arm v7 round 3b: layout pages at Y_C 165
    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
2026-10-24 swap arm v7 round 3b: insert-lane keep-out in the layout pages, arm set row split, superseded box-arm sections marked
    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
    [arm_v6_motion.py]
2026-10-24 box_structure v2: layout visual (4 variants side by side), system file with the insert keep-outs, receiver inserts in the bay bodies, summary at Y_C 165
    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
2026-10-24 box_electronics v1: review text fixes (brake pin name, ideal-diode voltage, face pins)
    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
    [box_electronics.py]
2026-10-24 swap arm v7 round 3b: Y_C 165 results, receiver pitch guidance budget, insert-lane keep-out, rows and log
    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
2026-10-24 ckpt 3
    [box_funnel_panel_A_v8_plain.stl, box_funnel_panel_B_v8_plain.stl, collar_v8_seat_frame.stl, funnel_panel_A_v8_plain_seat.stl, funnel_panel_B_v8_plain_seat.stl]
2026-10-24 battery latch v1: pitch guidance (corner guide posts, end gap 0.15: ±0.47 / ±0.38° at plug contact), Scout TPU end skids, TAB_OFF (Overseer 5.18, Scout 0 DEFAULT), Y_C 165; rerun
    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
    [box_battery_cartridge_overseer_v5.stl, box_battery_cartridge_scout_v5.stl, box_battery_receiver_overseer_v1.stl, box_battery_receiver_scout_v1.stl, box_battery_skid_closed_scout_v1.stl, box_battery_skid_lead_scout_v1.stl, box_battery_slider_overseer_v5.stl, cage_standin.stl]
2026-10-24 battery latch v1: summary note on the 0.3 offset sweep
    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
2026-10-24 funnel_panel v8_plain: review fixes (real Overseer set centred 3.3 a side, FE on the seat landings + wheel strut, v7 valley recheck, Y_C 165, docs; v8 plain DESIGN, v9 next)
    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
    [catch_system.py]
2026-10-24 box_structure v2: insert keep-outs from the arm's swept meshes (carriage X -35..47.5, Y 53.75..73.75), variants rerun
    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
    [drone_30.stl, drone_31.stl]
2026-10-24 swap arm v7 round 3c: latch 258becf (Scout TAB_OFF 0, receiver pitch guidance)
    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
2026-10-24 ckpt 4: swap arm v7 round 3c reruns in progress, axle ratio override
    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
    [pack_charged.stl, pack_dead.stl, rec-120.stl, rec-150.stl, rec-180.stl, rec-210.stl, rec-30.stl, rec-60.stl]
2026-10-24 box_structure v2: funnel v8 seat landings, catch file recentred by its panels, latch bolt moves; variants rerun
    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
2026-10-24 swap arm v7 round 3c: sweeps on latch 258becf
    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
2026-10-24 swap arm v7 round 3c: latch 258becf results, XT60 budget closed on the receiver guidance, servo gripper research
    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
2026-10-24 box_structure v2: latch receivers re-exported at PR 69 258becf (latch_ctx_export.py), v8 lane check committed, review fixes; variants rerun
    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
    [bay-120_body_envelope.stl, bay-120_cartridge.stl, bay-120_receiver.stl, bay-150_body_envelope.stl, bay-150_cartridge.stl, bay-150_receiver.stl, bay-180_body_envelope.stl, bay-180_cartridge.stl]
2026-10-24 box_structure v2: parts row enclosure size
    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
2026-10-24 heads v7 grabber concept: sprung blades + servo cam, load off the servo, pinion face 13 (Spark: plug / unplug loads)
    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
2026-10-24 box_structure v2: receivers placed by the latch tab line on Y_C (hub DEFAULT); variants rerun
    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
    [bay-120_cartridge.stl, bay-120_receiver.stl, bay-150_body_envelope.stl, bay-150_cartridge.stl, bay-150_receiver.stl, bay-180_body_envelope.stl, bay-180_cartridge.stl, bay-180_receiver.stl]
2026-10-24 swap arm v7 round 3c: alternatives visual (low stack @165 vs round 2 @177, axle 5:1 vs 4:1)
    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
    [arm_v7_alternatives.py]
2026-10-24 swap arm v7 round 3c: swap timing at 5:1, grip line = tab line stated
    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
2026-10-24 battery latch v1: XT60 float takes pitch (no guide posts, option B kept), docs at run10, figures for states and sets
    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
    [box_battery_cartridge_scout_v5.stl, box_battery_receiver_overseer_v1.stl, box_battery_receiver_scout_v1.stl, box_battery_skid_closed_scout_v1.stl, box_battery_skid_lead_scout_v1.stl, cage_standin.stl, cartridge.stl, receiver.stl]
2026-10-24 swap arm v7 round 3c: XT60 per axis vs the float carrier (x ±2.37, z ±1.06): the pitch guide is not needed
    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
2026-10-24 swap arm v7 round 3c: guide couple dropped from L Swap
    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
2026-10-24 box_structure v2: pitch-guide couple and guide posts out of the bay-body / stub requirements (hub)
    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
2026-10-24 box_structure v2: stub tilt 1.9 mrad again (pitch guide gone), across load note
    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
2026-10-24 swap arm v7 round 3d: concept review r3 fixes (roll lever, head-out at the side-face exit, slow-pass index, springs x1.3, grabber rods along x + 16 boss, cam rise 6, rack / pinion face grown down, st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
2026-10-24 box_structure v2: stub tilt 10 mrad (arm, XT60 float)
    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
2026-10-24 ckpt: h8 run on Y_C 138 layout (superseded), analysis tools
    [iso05.stl]
2026-10-24 ckpt 5: swap arm v7 round 3d rerun outputs
    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
    [headA.stl, headB.stl, pin16_A.stl, pin16_B.stl]
2026-10-24 box_system v2 topo: setup on main layout (Y_C 165), all-bay cases
    [iso05.stl]
2026-10-24 swap arm v7 round 3d: pinion v3 face 13.5, frame rerun (swap 0.45 / 0.49), sweeps 0 overlaps, rows, log
    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
2026-10-24 funnel_panel v8_plain: review round 2 (motion artifact, v7 on real supports 0.827, v8 files out of print/, catch needs from box structure)
    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
    [box_funnel_panel_A_v8_plain.stl, box_funnel_panel_B_v8_plain.stl]
2026-10-24 swap arm v7 round 3d: concept review PASS follow-ups (grabber bosses outboard and above the cam, slow-pass timing, gravity offset required, stale check log dropped)
    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
2026-10-24 box_electronics v1: axle gravity offset per bay + sag check, slow notch pass, detent now holds (arm v7)
    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
    [box_electronics.py]
2026-10-24 box_electronics v1: review fixes (sag check 0.55 from the arm budget, tags, parts row)
    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
2026-10-24 hub v6: wheel lanes at Y 53 for the low carriage stack (arm v7 round 3d); topo setup checked (82 cases)
    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
2026-10-24 swap arm v7 piece pass: pinion16 v3 (solid_check PASS, DESIGN), detent recheck at x1.3 (ring v4 / arm v3 needed)
    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
    [arm_pinion16_v3_W.stl, box_arm_pinion16_v3.stl]
2026-10-24 detent v6 (623ZZ roller, ring v4, arm v3): piece pass started, fixed-Q lever search running
    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
    [detent.py]
2026-10-24 box_structure v2: funnel v8 file loaded as is (fit 0.0, lanes clear), no v8 Y allowance, box 80.0 L
    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
    [catch_W.stl]
2026-10-24 box_structure v2: views lede
    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
2026-10-24 box_structure v2: seat post clamp numbers from the merged catch
    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
2026-10-24 detent v6: 623ZZ roller, ring v4 (r 26.5, rim the roller's width), arm v3 (3.5, bosses r 6), CHOSEN_V8 (hold 1.065 N.m, Hertz 0.45, arm 0.16, gaps 1.0); solid_check PASS on ring v4 and arm v3; v7 sta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
    [box_detent_arm_v3.stl, box_detent_arm_v3_W.stl, box_detent_ring_v4.stl, box_detent_ring_v4_W.stl, detent_tower_v6_W.stl]
2026-10-24 ckpt 1: funnel panel v9 plain build, FE, catch system, opening, assembly, motion
    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
    [box_funnel_panel_A_v9_plain_nx.stl, box_funnel_panel_A_v9_plain_px.stl, box_funnel_panel_B_v9_plain_nx.stl, box_funnel_panel_B_v9_plain_px.stl, box_funnel_probe_cap_v9_plain.stl, collar_v9_seat_frame.stl, funnel_panel_A_v9_plain_nx_seat.stl, funnel_panel_A_v9_plain_px_seat.stl]
2026-10-24 detent v6: summary, previews, print_orient
    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
2026-10-24 ckpt 6: swap arm v7 rerun with detent v6
    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
    [detent_arm.stl, detent_ring.stl, detent_roller.stl, detent_springs.stl, detent_tower.stl, hub.stl, pin16_A.stl, pin16_B.stl]
2026-10-24 funnel_panel v9_plain: docs, dimensions G keep-alive probes + (6)/(8), System Box catch, hook latch tables, state rows
    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
2026-10-24 swap arm v7 piece pass: rail v4 inner step / park stop from r 27.5 (1.0 off detent ring v4); rerun with detent v6: sweeps 0 overlaps, swap 0.45 / 0.49, unpowered 1.28 / 1.20 / 1.09
    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
    [arm_rail_A_v4_W.stl, arm_rail_B_v4_W.stl, box_arm_rail_A_v4.stl, box_arm_rail_B_v4.stl]
2026-10-24 swap arm v7 piece pass: rows, dims, log, parts-list (623ZZ, GT2 16T)
    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
2026-10-24 PR 79 re-review fixes: System lines for pinion16 v3 and detent v6, mass vs previous and budget slots, tags, hub row budget_g 180 and run status, brake row 1.30 / 2.75, stale concept text, rail mass 5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
2026-10-24 battery latch v2: receiver v2 concept (closed channel, XT60 carrier), swap load set FE, v1 baseline
    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
    [battery_latch.py, battery_latch_figure.py, battery_latch_topo.py]
2026-10-24 swap arm v7: rail v4 mass 58.0 in the dimensions row (review)
    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
2026-10-24 swap arm v7: non-blocking review notes (concept cell, tags, superseded history values)
    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
2026-10-24 box_electronics v1: A4 always holds, MATE_CHECK needs keep-alive current first
    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
2026-10-24 box_system v2 topo: results (gen3000 of record, gen1500 comparison), views, analysis tools
    [iso05.stl]
2026-10-24 tooling: system_check crash probes, protected parts shadow each other
    A probe stops at the first solid: per (axis, approach, bin) only the protected
    part(s) met first count; a part behind another (exempt ones included) is +inf
    there. Also: an exempt or shadowed bin no longer scores as an unshielded FAIL.
    Test test_probes_shadow; ASSEMBLY.md and log line.
    Claude-Session: https://claude.ai/code/session_01TqPQQkB6JXrpann8M5ejA5
2026-10-24 state: belt connector measurement dropped; heads v5 HOLD, superseded by heads v7 (Spark)
    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
2026-10-24 box_system v2 topo: review fixes (1500 / 3000 connectivity, one mass, contact areas named, tags, runs index left as main)
    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
    [box_system_topo_v2_page.py]
2026-10-24 battery latch v2: review fixes (cuts restored, Scout no guide posts, insert on the cap, columns for the Scout bolts, 5.0 walls, top gap)
    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
    [battery_latch.py, battery_latch_topo.py]
2026-10-24 ckpt 2: coarse done, fine stage process died silently
2026-10-24 docs: hub reports only for print-ready files and Spark decisions, no timed digests (Spark)
    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
2026-10-24 ckpt 3: h 1.5 fine stage OOM-killed (13.9 GB); rerun at h 2.0
2026-10-24 ckpt 3: two 3000 cm3 runs done (no ring, ring), 2000 and 4000 running
    [iso05.stl]
2026-10-24 box_structure v2: insert keep-outs per the arm / heads v7 (carriage to Y 75.35, Z >= 89; grabber from r 95); variants rerun
    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
    [catch_W.stl, drone_30.stl, drone_31.stl]
2026-10-24 ckpt 5: h 2.25 fine stage running
2026-10-24 ckpt 7: swap arm v7 recheck, plate top 74.35 (heads v7)
    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
    [axlesA.stl, axlesB.stl, bushA.stl, bushB.stl, headA.stl, headB.stl, hub.stl, railA.stl]
2026-10-24 swap arm v7 recheck: plate top 74.35 and the insert-lane keep-out for heads v7, rerun, rows, log
    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
2026-10-24 swap arm v7 recheck: alternatives page chosen line from the spring scale
    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
    [arm_v7_alternatives.py]
2026-10-24 box_electronics v1: heads v7 gripper stall cut (K4 + INA226 0x46), dwell-only commands, 4 grip halls on an ADS1115; bundle 23 wires; script rerun
    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
    [box_electronics.py]
2026-10-24 swap arm v7 recheck: review fixes (System line mass and CG, axle tail clearance, tags, comments, alternatives note)
    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
    [arm_v7_alternatives.py]
2026-10-24 box_electronics v1: schematic shows the gripper INA226, K4 and the ADS1115
    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
2026-10-24 swap arm v7 recheck: re-review notes (tags, sweep log cite)
    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
2026-10-24 box_electronics v1: review fixes (halls at 3.3 V upstream of K4, 3:1 sum per head, PCA9685 to 0x60, INA226 0x40, A5 covers the stall cut, baseline current, totals, tags)
    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
    [box_electronics.py]
2026-10-24 ckpt 1
    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
    [arm_rail_A_v5_W.stl, arm_rail_B_v5_W.stl, box_arm_rail_A_v5.stl, box_arm_rail_B_v5.stl]
2026-10-24 box_electronics v1: harness fit from the arm (bundle fits, ribbon in rail v5)
    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
2026-10-24 swap arm rails v5: wide ribbon channel, bolt heads under its floor, rerun, rows, log
    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
    [railA.stl, railB.stl]
2026-10-24 box_system v2 topo round 2: sheets as cladding, final layout
    [iso05.stl]
2026-10-24 swap arm rails v5: review fixes (loads line, section visual, punch-through, bundle row, tags)
    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
2026-10-24 box_system v2 topo r2: review fixes (lane test above the axle, ring text, mass and contact basis, floor pieces named, tags, one log line, runs index as main)
    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
    [box_system_topo_v2r2_newlanes.py, box_system_topo_v2r2_page.py]
2026-10-24 box_system v2 topo r2: lane files regenerated above the axle, analysis rebuilt, log blank line restored, floor patch pieces, tags
    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
2026-10-24 box_structure v2: round 2 topology in dimensions and the parts row; cut defaults
    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
2026-10-24 box_electronics v1: heads v7 confirms the gripper dwells hold unpowered
    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
2026-10-24 hub v6: run FAILED (solid_check), h 2.25 summary
    [box_hub_v6.stl, box_hub_v6_view.stl]
2026-10-24 battery latch v2: receiver v2 final (FE swap set, prints, figures, docs, Scout HOLD, review fixes)
    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
    [box_battery_cartridge_overseer_v5.stl, box_battery_cartridge_scout_v5.stl, box_battery_receiver_lid_overseer_v1.stl, box_battery_receiver_lid_scout_v1.stl, box_battery_receiver_overseer_v1.stl, box_battery_receiver_overseer_v2.stl, box_battery_receiver_scout_v1.stl, box_battery_receiver_scout_v2.stl]
2026-10-24 print log: scan stick v6 plates 1+2 PRINTING (Gideon, Jarvis), thread test v3
    Claude-Session: https://claude.ai/code/session_0162NRyenVcgLCACCKc38z8E
2026-10-24 battery latch v2: no guide posts (arm), end walls to the feet set back, 40 deg probe exemption, final run and docs
    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
    [box_battery_receiver_overseer_v2.stl, box_battery_receiver_scout_v2.stl, cage_standin.stl, receiver.stl]
2026-10-24 hub v6: run 1 record trimmed (no checkpoints or meshes), superseded note
    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
    [box_hub_v6_view.stl]
2026-10-24 hub v6: run 2 setup (power cuts out, 15 % envelope, h 2.05, hall pocket walls 2.0), run 1 mesh out of git
    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
    [box_hub_v6.stl]
2026-10-24 battery latch v2: review fixes (40 deg on the whole swap set, guide flag in result.json, probe parts listed, tags, one log line, artifact link)
    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
    [battery_latch.py]
2026-10-24 battery latch v3: cartridge v6 centre rib (stroke 3.0, heads v7) and the Scout TPU edge skids (run v3)
    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
    [box_battery_cart_strip_scout_v1.stl, box_battery_cartridge_overseer_v5.stl, box_battery_cartridge_overseer_v6.stl, box_battery_cartridge_scout_v5.stl, box_battery_cartridge_scout_v6.stl, box_battery_receiver_lid_overseer_v1.stl, box_battery_receiver_lid_scout_v1.stl, box_battery_receiver_overseer_v2.stl]
2026-10-24 battery latch v3: rib 4.0 with cross walls, skids clipped inside the funnel, slider v6, docs to the final run
    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
    [box_battery_cartridge_overseer_v6.stl, box_battery_cartridge_scout_v6.stl, box_battery_receiver_overseer_v2.stl, box_battery_rskid_plate_scout_v1.stl, box_battery_rskid_side_nx_scout_v1.stl, box_battery_rskid_side_px_scout_v1.stl, box_battery_slider_overseer_v5.stl, box_battery_slider_overseer_v6.stl]
2026-10-24 battery latch v3: docs to the v3 system line, one log line
    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
2026-10-24 battery latch v3: log line length
    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
2026-10-24 battery latch v3: cartridge end skids in the Scout manifest, stand-in relieved round the skids
    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
    [cage_standin.stl, cartridge_skid_closed.stl, cartridge_skid_lead.stl]
2026-10-24 hub v6 run 3: solid PASS, swap 0.52, misuse 0.47, sustained 1.08, 199 g
    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
    [box_hub_v6.stl, box_hub_v6_view.stl]
2026-10-24 ckpt 1: battery latch v4 tail skids (Scout v3 no-keel ask), run v4 in progress
    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
2026-10-24 ckpt 2: battery latch run v4 partial (FE copied from v3, files saving)
    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
    [box_battery_cart_strip_scout_v1.stl, box_battery_cartridge_scout_v6.stl, box_battery_receiver_scout_v2.stl, box_battery_rskid_plate_scout_v1.stl, box_battery_rskid_side_nx_scout_v2.stl, box_battery_rskid_side_px_scout_v2.stl, box_battery_rskid_tail_scout_v1.stl, box_battery_slider_scout_v6.stl]
2026-10-24 ckpt 3: receiver v3 (Scout, narrowed |y| 25.5 under the keel), skids: plates + 4 flat-bonded bars, strips dropped
    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
2026-10-24 ckpt 4: run v4 leftover from the stopped pass (rewritten by the running one)
    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
    [box_battery_xt60_carrier_scout_v1.stl]
2026-10-24 ckpt 6: run v4 files in progress
    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
    [box_battery_cartridge_overseer_v6.stl, box_battery_receiver_lid_scout_v1.stl, box_battery_receiver_scout_v3.stl, box_battery_receiver_strip_scout_v1.stl, box_battery_rskid_bar_scout_v1.stl, box_battery_rskid_tail_scout_v1.stl, box_battery_skid_closed_scout_v1.stl, box_battery_skid_lead_scout_v1.stl]
2026-10-24 hub v7: system pass after three strikes (tower frame legs, sleeve skirt), v6 runs 2 / 3 meshes out of git, rows, log
    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
    [box_hub_v6.stl, box_hub_v6_view.stl]
2026-10-24 hub v7: concept section page (tower frame, skirt)
    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
2026-10-24 ckpt 7: receiver skids as nose / tail end pieces (plate + bars + ears, one print each); rerun v4
    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
    [box_battery_cart_strip_scout_v1.stl, box_battery_cartridge_overseer_v6.stl, box_battery_cartridge_scout_v6.stl, box_battery_receiver_lid_scout_v1.stl, box_battery_receiver_scout_v2.stl, box_battery_receiver_scout_v3.stl, box_battery_receiver_strip_scout_v1.stl, box_battery_rskid_bar_scout_v1.stl]
2026-10-24 ckpt 8: end pieces print plate face down (bars flush with the plate's outer face)
    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
2026-10-24 ckpt 9: run v4 in progress
    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
    [cage_standin.stl, cartridge.stl, cartridge_skid_closed.stl, cartridge_skid_lead.stl, cartridge_strip_nx.stl, cartridge_strip_px.stl, drone_rest_standin.stl, pack.stl]
2026-10-24 ckpt 10: run v4 in progress
    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
    [box_battery_cart_strip_scout_v1.stl, box_battery_cartridge_scout_v6.stl, box_battery_rskid_nose_scout_v2.stl, box_battery_rskid_tail_scout_v1.stl]
2026-10-24 battery latch v4: Scout receiver v3 (narrowed under the keel), TPU nose / tail end pieces, docs and run v4
    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
    [box_battery_cart_strip_scout_v1.stl, box_battery_cartridge_overseer_v6.stl, box_battery_cartridge_scout_v6.stl, box_battery_receiver_lid_overseer_v1.stl, box_battery_receiver_lid_scout_v1.stl, box_battery_receiver_overseer_v2.stl, box_battery_receiver_scout_v2.stl, box_battery_receiver_scout_v3.stl]
2026-10-24 hub v7: system pass redone (belt strands, in-loop column, gen 58, budget 210), options page, rows, log
    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
2026-10-24 ckpt 11: Scout head seats raised to y 21.5 inside the clip, bolts at x 26.55 / tail z -0.1 (3.0 rings), key lines from MOUNT, keel and head-seat checks
    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
    [box_battery_cart_strip_scout_v1.stl, box_battery_cartridge_overseer_v6.stl, box_battery_cartridge_scout_v6.stl, box_battery_receiver_lid_overseer_v1.stl, box_battery_receiver_lid_scout_v1.stl, box_battery_receiver_overseer_v2.stl, box_battery_receiver_scout_v3.stl, box_battery_receiver_strip_overseer_v1.stl]
2026-10-24 ckpt 12: Scout receiver FE with the raised seats (0.415); bars to y 34 outboard of the bolt rings
    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
    [cage_standin.stl, cartridge.stl, cartridge_skid_closed.stl, cartridge_skid_lead.stl, receiver.stl, receiver_lid.stl, receiver_skid_nose.stl, receiver_skid_tail.stl]
2026-10-24 battery latch v4: Scout receiver v3 head seats in the clip (bolts x 26.55, tail z -0.1, M3 x 40), key lines from MOUNT, keel and head-seat checks, end-piece bars at y 34, docs to the final run
    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
    [box_battery_cart_strip_scout_v1.stl, box_battery_cartridge_overseer_v6.stl, box_battery_cartridge_scout_v6.stl, box_battery_receiver_lid_overseer_v1.stl, box_battery_receiver_lid_scout_v1.stl, box_battery_receiver_overseer_v2.stl, box_battery_receiver_scout_v3.stl, box_battery_receiver_strip_overseer_v1.stl]
2026-10-24 battery latch v4: Scout head flats at y 24.5 (full 3.0 ring over the head band, M3 x 35), head_seats samples the head band, true key-line distances, bond areas in result, Scout part versions bumped, 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
    [box_battery_cartridge_scout_v7.stl, box_battery_receiver_lid_scout_v2.stl, box_battery_receiver_scout_v3.stl, box_battery_rskid_tail_scout_v1.stl, box_battery_skid_closed_scout_v2.stl, box_battery_skid_lead_scout_v2.stl, box_battery_xt60_carrier_scout_v2.stl, receiver.stl]
2026-10-24 hub v7: rule checks on the assembled layout (fit, access), belt on the 16T
    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
    [belt_axle.stl, hub.stl]
2026-10-24 hub v7: concept PASS notes folded (tooth-tip clearance, gen 62, budget 215, v7 default in hub_v6.py)
    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
    [hub_v6.py, hub_v6_topo.py]
2026-10-24 hub v7: solid PASS, 213.3 g, sustained 0.60, misuse 0.47, swap 0.524 (corner, grid-dependent)
    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
    [box_hub_v7.stl, box_hub_v7_view.stl]
2026-10-24 hub v7: assembled recheck note (hub pairs clean; latch v4 receiver clash is the arm's next PR)
    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
2026-10-24 box_structure v2: grip line Y_C 167.1 (arm), latch receivers from main; variants rerun
    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
    [bay-120_body_envelope.stl, bay-120_cartridge.stl, bay-120_receiver.stl, bay-150_body_envelope.stl, bay-150_cartridge.stl, bay-150_receiver.stl, bay-180_body_envelope.stl, bay-180_cartridge.stl]
2026-10-24 box_catch: grip line Y_C 167.1 (assembly +2.1 in W Y)
    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
2026-10-24 swap arm v7: grip line Y_C 167.1 for latch v4's receiver v2, rerun with hub v7, rows, log
    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
    [fingA_A.stl, fingA_B.stl, fingB_A.stl, fingB_B.stl, gripA.stl, gripB.stl, hub.stl, pack_charged.stl]
2026-10-24 swap arm v7 grip line: review fixes (sets on the grip from system.json, power cut, roll, stub, compact, case masses, parts rows, summary)
    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
    [arm_v7_alternatives.py]
2026-10-24 swap arm v7 grip line: last row and log notes
    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
2026-10-24 docs: usage audit and plan to cut session token spend (artifact source)
    Claude-Session: https://claude.ai/code/session_01D5VWdsQT2ikf9KKuYKiV2w
2026-10-24 rule: carbon rod sizes beyond 3.0 where the frame model needs them
    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
2026-10-24 print log: scan stick nodes v2 x8 PRINTING in PETG (Jarvis)
    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
2026-10-26 overseer cage v1: geodesic sphere cage (Elios format), rule + system_check shell
    Spark 26 Oct: every cage a geodesic sphere; Overseer v0 ring cage scrapped.
    NU 2, 6 mm tubes, R 363, bottom opening clear 305 for pack + swap; L2 on top
    (DEFAULT, nose alt fails pack-out balance). layout_v3.py, assembly file,
    system_check shell check + tests, rule in CLAUDE.md and generative.md.
    Claude-Session: https://claude.ai/code/session_01Em8yMe1ArHE9XePmNwV7RS
    [arm_1.stl, arm_2.stl, arm_3.stl, arm_4.stl, bottom_plate.stl, cage_shell_nodes.stl, cage_shell_tubes.stl, cartridge.stl]
2026-10-26 overseer cage v1: concept review round 1 fixes
    Front camera clear of the props (L2 + camera 40 higher, 30 deg kept), 8 core
    ties plate to shell, mast feet between the arms, pack-high / squashed-sphere
    variants weighed, stale L2 and camera rows updated; motion.py: int16 step per
    part so a part over 640 mm no longer wraps in the page.
    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
    [arm_1.stl, arm_2.stl, arm_3.stl, arm_4.stl, cage_shell_nodes.stl, cage_shell_tubes.stl, cartridge.stl, down_camera.stl]
2026-10-26 overseer cage v2: v2 layout with a geodesic disk cage formed to the drone; rule: shells formed to the drone
    Spark 26 Oct: keep the v2 layout (L2 nose, arm compensation, balance), replace only
    its cage with triangles formed to the drone, compact like a disk; battery close to
    the body; funnel disregarded. layout_v4.py, alternatives (pack on axis, freq 3),
    system_check shell: ring openings, ratio optional, pack-out reported by exception.
    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
    [apex___cam_bracket.stl, arm_1.stl, arm_2.stl, arm_3.stl, arm_4.stl, belly_sled___pods.stl, bottom_plate.stl, cage_shell_nodes.stl]
2026-10-26 overseer cage v2: less structure over and under the props (secondary to structure), access paths, review fixes
    Prop shadow measured (outside the arms' own shadow) and minimised: one-at-a-time
    node snap off the disk columns kept only if the structure bar holds; links pick the
    least-shadow node. 7.4 / 14.6 % above / below (no snap 7.5 / 16.0). Access 19/19:
    USB lines through cells, arm M3 key lines (sled driver holes required); pods 35
    ahead; cartridge / receiver split, pack out 22.7 mm one definition.
    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
    [apex___cam_bracket.stl, arm_1.stl, arm_2.stl, arm_3.stl, arm_4.stl, belly_sled___pods.stl, cage_shell_nodes.stl, cage_shell_tubes.stl]
2026-10-26 overseer cage v2: label the layout-model pack-out print (review round 2 note)
    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
2026-10-27 overseer cage v3: L2 and front camera outside the geodesic disk, nothing in their views; one layout
    Spark 26 Oct: lidar outside the cage and not blocked, guard only outside its view,
    both cameras unobstructed, only the layout with the CG on the thrust centre.
    layout_v5.py: shell behind the L2 plane, the camera's lower view plane and the head
    plane; guard ring behind the L2; front-face node grid and long-tube split; part CGs
    from the mass model. system_check: exempt openings. Rule line updated.
    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
    [apex___cam_bracket.stl, arm_1.stl, arm_2.stl, arm_3.stl, arm_4.stl, belly_sled___pods.stl, bottom_plate.stl, cage_shell_nodes.stl]
2026-10-27 overseer cage v3: perfect left-right symmetry, no tube-length limit; review fixes (camera guard, L2 braces + fuse, field cones replace exempt)
    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
    [apex___cam_bracket.stl, arm_1.stl, arm_2.stl, arm_3.stl, arm_4.stl, cage_shell_nodes.stl, cage_shell_tubes.stl, front_camera.stl]
2026-10-27 overseer cage v3: structure kept and pinned; cameras back to v2's format (pods at v2's place); carbon list heading
    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
    [apex___cam_bracket.stl, arm_1.stl, arm_2.stl, arm_3.stl, arm_4.stl, belly_sled___pods.stl, cage_shell_nodes.stl, cage_shell_tubes.stl]
2026-10-27 overseer cage v3: no down camera; the 2 cameras beside the L2, pointed for the largest field
    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
    [apex___cam_bracket.stl, arm_1.stl, arm_2.stl, arm_3.stl, arm_4.stl, belly_sled___pods.stl, cage_shell_nodes.stl, cage_shell_tubes.stl]
2026-10-27 ckpt 1
    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
    [apex___cam_bracket.stl, arm_1.stl, arm_2.stl, arm_3.stl, arm_4.stl, belly_sled___pods.stl, cage_shell_nodes.stl, cage_shell_tubes.stl]
2026-10-27 overseer core v1: system pass for everything inside the cage but the arms (hub frame, power tray, sled, skids + pods, feet)
    Claude-Session: https://claude.ai/code/session_01EtHMZN7xH5JE5rcYbxgeu2
    [buck_12_v.stl, cartridge.stl, down_camera.stl, fc_micoair743-lite.stl, flow_mtf-02p.stl, hub_frame.stl, pack.stl, pdb_fchub-12s.stl]
2026-10-27 scout_layout v6: geodesic cage on the PR 94 drone, bottom ring = the Overseer's (shared funnel), one nose camera outside, carbon base kept
    Claude-Session: https://claude.ai/code/session_01EtHMZNhc68Ghbc2KCNMUzU
    [FC.stl, Radxa_Zero_3W.stl, UBEC.stl, XR2.stl, XT60E1-M.stl, cage_shell_nodes.stl, cage_shell_tubes.stl, camera.stl]
2026-10-27 ckpt 1
    overseer core v1 round 2 in progress: no PDB, FC stack (743-Lite on 55A 4-in-1) on the bottom plate, Pi 5 hung under the top plate, rear tray tower, sled, flow pod; skids and feet moved to alt_a (cage feet, review alt B). Docs and coupons to follow.
    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
    [buck_12_v.stl, down_camera.stl, esc_cap.stl, fc_micoair743-lite.stl, fc_stack_micoair743-lite_on_55a_4-in-1.stl, flow_pod.stl, hub_frame.stl, pdb_fchub-12s.stl]
2026-10-27 overseer arms v1: concept review 1 fixes (front carbon chords, insert-only cases, motor slots, ESC seat, spoke path note, modal check)
    Claude-Session: https://claude.ai/code/session_01EtHMZNuHnrXvnLgzSvxgLg
    [arm_view_v1.py]
2026-10-27 overseer arms v1: ESC under the FC (Spark), seat and mass off the arms
    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
2026-10-27 dimensions O: ESC 4-in-1 under the FC (Spark 27 Oct)
    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
2026-10-27 topo: Part.insert (stiff bought inserts in the FE); overseer arms v1: rods as inserts, end sockets, shaft bore 8.6, review 2 fixes
    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
2026-10-27 scout_layout v6: review fixes: spokes on their own side + link clearance check, core ties, braced camera seat, options B / C drawn, funnel bands, Overseer-side datum open
    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
    [cage_shell_nodes.stl, cage_shell_tubes.stl, camera.stl, camera_guard_nodes.stl, camera_mount__boom_p_seat.stl, cartridge_skid_closed_end__latch__tpu.stl, cartridge_skid_lead_end__latch__tpu.stl, cartridge_v6__latch.stl]
2026-10-27 overseer arms v1: part doc (print, assembly), state row, budget figure (review 3)
    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
2026-10-27 ckpt 2
    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
    [arm_1.stl, arm_2.stl, arm_3.stl, arm_4.stl, cage_shell_nodes.stl, cage_shell_tubes.stl, camera_left.stl, camera_right.stl]
2026-10-27 scout v3: bottom concept B (shell catch, latch rails, pack tucked) + alternatives A / C
    Claude-Session: https://claude.ai/code/session_01EtHMZMB13ed4juqR8ktuXy
2026-10-27 topo: tie cases see inserts as absent (the printed part holds its drawn bodies by itself); test pending
    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
2026-10-27 overseer arms v1: plate gap 45 settled with the core session
    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
2026-10-27 overseer core v1: round 3 (no PDB, 2 pieces, screwdriver access) + mounting coupons v1
    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
    [buck_12_v.stl, esc_cap.stl, fc_stack_micoair743-lite_on_55a_4-in-1.stl, flow_pod.stl, hub_deck.stl, overseer_core_coupon_hub_deck_v1.stl, overseer_core_coupon_sled_v1.stl, pi_5__active_cooler.stl]
2026-10-27 overseer cage v5: half the tubes (25 nodes, 64 tubes); camera pair beside the L2; printed sensor head mount concept
    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
    [arm_1.stl, arm_2.stl, arm_3.stl, arm_4.stl, cage_shell_nodes.stl, cage_shell_tubes.stl, camera_left.stl, camera_right.stl]
2026-10-27 box catch concept D: posts into a shared rim (both drones); review fixes, Overseer fit, B / C kept as alternatives
    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
    [bottom_concept.py, catch_posts_concept.py]
2026-10-27 overseer head mount v1: topology setup (centre piece + wing) from head_system.json
    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
2026-10-27 overseer core v1: round 4 (stack on the top plate, Pi between the plates, real rear holes) + 3 mounting coupons v1
    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
    [buck_12_v.stl, esc_cap.stl, fc_stack_micoair743-lite_on_55a_4-in-1.stl, hub_deck.stl, overseer_core_coupon_hub_deck_v1.stl, overseer_core_coupon_sled_v1.stl, overseer_core_coupon_stack_mount_v1.stl, pi_5__active_cooler.stl]
2026-10-27 overseer arms v1: lead route over the arm tops (core moved the stack onto the top plate)
    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
2026-10-27 scout_layout v7: cage v2: every rod 3 mm, 65 rods (was 123), free-pattern shell (any rod length); rule: CLAUDE.md cage line, generative 0, precheck 12
    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
    [cage_shell_nodes.stl, cage_shell_tubes.stl, camera.stl, camera_guard_nodes.stl, camera_mount__boom_p_seat.stl, cartridge_skid_closed_end__latch__tpu.stl, cartridge_skid_lead_end__latch__tpu.stl, cartridge_v6__latch.stl]
2026-10-27 overseer core v1: round 5 (FC stack straight on the carbon top plate, no mount), mounting hole table, 2 coupons
    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
    [fc_stack_micoair743-lite_on_55a_4-in-1.stl, overseer_core_coupon_stack_mount_v1.stl, wires.stl]
2026-10-27 overseer core v1: FC stack turned 45° into the top plate slots on studs, bay bars inside the arm envelopes, access fixes
    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
    [fc_stack_micoair743-lite_on_55a_4-in-1.stl, hub_deck.stl, overseer_core_coupon_hub_deck_v1.stl]
2026-10-27 topo: inserts never join drawn bodies for the ties (a rod chained the motor pad to a socket the PETG reached); test_topo 15/15
    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
2026-10-27 overseer core v1: review notes (+X stud washer, motor leads from the turned ESC, USB-C probe, Pi USB boot), coupon fit views
    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
    [wires.stl]
2026-10-27 scout_layout v8: the Scout: rectangle bottom (the Overseer ring's middle), 61 x 3 mm rods, free pattern, camera over the nose; review fixes (rule text, check 13 on total rods, nose bay ties, honest c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
    [cage_shell_nodes.stl, cage_shell_tubes.stl, camera.stl, camera_guard_nodes.stl, camera_mount__boom_p_seat.stl, cartridge_skid_closed_end__latch__tpu.stl, cartridge_skid_lead_end__latch__tpu.stl, cartridge_v6__latch.stl]
2026-10-27 overseer cage v5: close nodes merged (Spark: small triangles become one node), 20 deg node angle floor; 23 nodes, 54 tubes; TPU node setup
    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
    [arm_1.stl, arm_2.stl, arm_3.stl, arm_4.stl, cage_shell_nodes.stl, cage_shell_tubes.stl, camera_left.stl, camera_right.stl]
2026-10-27 overseer core v1: 4 plate bolts instead of 6 (Spark), coupons regenerated
    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
    [hub_deck.stl, overseer_core_coupon_hub_deck_v1.stl, overseer_core_coupon_sled_v1.stl]
2026-10-27 overseer cage v5: orphan nodes dropped (21 nodes, 54 tubes); wing struts only at 20 deg+ from a node's tubes
    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
    [arm_1.stl, arm_2.stl, arm_3.stl, arm_4.stl, cage_shell_nodes.stl, motor_1.stl, motor_2.stl, motor_3.stl]
2026-10-27 overseer arms v1: cage v5 motor shift noted (arms v2)
    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
2026-10-27 scout v3: electronics mount list confirmed, no lights, battery side left out
    Claude-Session: https://claude.ai/code/session_01EtHMZQ6DeunMTynr11ADr1
2026-10-27 scout_layout v9: the Scout: race-car cage, 62 x 3 mm rods, rectangle bottom, camera low with a chin guard, small triangles to one node, tail bay; review fixes
    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
    [cage_shell_nodes.stl, cage_shell_tubes.stl, camera.stl, camera_chin_guard__printed.stl, camera_guard_nodes.stl, camera_mount__boom_p_seat.stl, cartridge_skid_closed_end__latch__tpu.stl, cartridge_skid_lead_end__latch__tpu.stl]
2026-10-27 overseer frame model v1 + fixes: 19 links to 6/4 tube, 3 long tubes split at mid-span (24 nodes, 63 tubes); node and head setups take the frame model's sizes and socket forces
    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
    [arm_1.stl, arm_2.stl, arm_3.stl, arm_4.stl, cage_shell_nodes.stl, cage_shell_tubes.stl, motor_1.stl, motor_2.stl]
2026-10-27 overseer cage v5: frame model docs, page, previews
    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
2026-10-27 scout electronics v1: concept A, Radxa, UBEC, XR2 on one PETG fin in the race-car tail (alt B tray)
    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
    [bottom_rectangle_the_overseer_ring_s_middle.stl, cage_shell_nodes.stl, cage_shell_tubes.stl, camera.stl, camera_guard_nodes.stl, camera_mount_boom_seat.stl, cartridge_skid_closed_end_latch_tpu.stl, cartridge_skid_lead_end_latch_tpu.stl]
2026-10-27 scout_layout v9: camera in a printed cradle hung from the cage only (Spark), per-end swap clearance printed, review notes
    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
    [cage_shell_nodes.stl, cage_shell_tubes.stl, camera_cradle__printed.stl, camera_mount__boom_p_seat.stl, cartridge_skid_closed_end__latch__tpu.stl, cartridge_skid_lead_end__latch__tpu.stl, cartridge_v6__latch.stl, cartridge_v6_strips__latch__tpu.stl]
2026-10-27 scout electronics v1: review fixes: fin clipped to the tail core tie (closed load path), access (FC USB-C, Radxa plugs, SD), compactness, margin plan, tags, artifact link
    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
    [electronics_tail.py]
2026-10-27 rod coupons v1: 6 mm and 3 mm socket coupons, 3 bores each, glue rings + vent + chamfer
    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
    [rod_coupon_3mm_v1.stl, rod_coupon_6mm_v1.stl]
2026-10-27 head mount wing: 8 mm camera plate, blind 6 mm insert holes (v1 solid check: 0.1 rims at the insert holes)
    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
2026-10-27 scout electronics v1: review round 2: root flange bolted to a belly mount tail block (moment joint), C-clip fuse, tool sweeps out of the shell, system_check, numbers and tags
    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
2026-10-27 scout_layout v9: camera close in at the nose on a printed PETG cradle + arms into the cage (no rods, Spark), 54 rods, shell cap from 62 minus links, arms on 3 nodes
    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
    [cage_shell_nodes.stl, cage_shell_tubes.stl, camera.stl, camera_chin_guard__printed.stl, camera_cradle__printed.stl, camera_cradle_arms__printed.stl, camera_guard_nodes.stl, cartridge_skid_closed_end__latch__tpu.stl]
2026-10-27 ckpt 1: scout_layout v9 review fixes in progress (collapse revert, arm clash check, saddle clamps)
    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
    [layout_v3.py]
2026-10-27 rod coupons v1: print log, PETG set sent to Gideon
    Claude-Session: https://claude.ai/code/session_01EtHMZL5b5c3WqiyHU7sgzt
2026-10-27 box catch concept E: ramps into the bottom opening, no rim; tolerance for both drones
    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
    [bottom_concept.py, catch_posts_concept.py, catch_ramps_concept.py]
2026-10-27 scout_layout v9: review fixes: camera arms into printed saddle clamps on the cage rods (clear of every rod, no hidden contact), collapse revert so the offset scan holds all 5 points, catch 8.5 aft, m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
    [cage_shell_nodes.stl, cage_shell_tubes.stl, camera_cradle_arms__printed.stl, camera_cradle_clamps__printed.stl, cartridge_skid_closed_end__latch__tpu.stl, cartridge_skid_lead_end__latch__tpu.stl, cartridge_v6__latch.stl, cartridge_v6_strips__latch__tpu.stl]
2026-10-27 scout_layout v9: camera mount mode estimate with the rod's give (~70..140 Hz E, frame model decides; review note)
    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
2026-10-27 overseer v5: one head mount mass (system model), stale doc numbers fixed
    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
    [layout_v5.py]
2026-10-27 rod coupons v1: solid_check PASS and previews named per file
    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
2026-10-27 scout_layout v9: camera mount snap-clips onto the cage rods after the cage is built (Spark), contact pairs only for drawn parts (CI), catch 8.0 aft
    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
    [cage_shell_nodes.stl, cage_shell_tubes.stl, camera_cradle_clamps__printed.stl, camera_cradle_clips__printed.stl, cartridge_skid_closed_end__latch__tpu.stl, cartridge_skid_lead_end__latch__tpu.stl, cartridge_v6__latch.stl, cartridge_v6_strips__latch__tpu.stl]
2026-10-27 box catch ramps: hexagon target (Overseer cage v5 loop, Scout bottom refitted to its side nodes), loaders from the PR heads, tip ramps clear of yaw
    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
2026-10-27 box catch ramps: V under each Overseer tip, chamfered ramp ends, nose pads clear of the Overseer feet, net-push landing test
    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
2026-10-27 scout_layout v10: bottom on the Overseer cage v5 loop's 4 side nodes (Spark via design center), seat +2.1, links out of the funnel band, 44 rods
    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
    [cage_shell_nodes.stl, cage_shell_tubes.stl, camera.stl, camera_cradle__printed.stl, camera_cradle_arms__printed.stl, camera_cradle_clips__printed.stl, cartridge_skid_closed_end__latch__tpu.stl, cartridge_skid_lead_end__latch__tpu.stl]
2026-10-27 scout_layout v10: seat sign fixed (plane 2.12 further under the cartridge, design center), rerun
    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
    [cage_shell_nodes.stl, cage_shell_tubes.stl, spokes__bay_ties__core_ties__camera_guar.stl]
2026-10-27 overseer head on cage concept; frame solver regularisation fix, links resized
    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
    [arm_1.stl, arm_2.stl, arm_3.stl, arm_4.stl, motor_1.stl, motor_2.stl, motor_3.stl, motor_4.stl]
2026-10-27 overseer head: keels + braces kept (Spark: lidar max performance); head-on-cage as alt
    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
2026-10-27 overseer frame v1: fixed solver, links resized, core-end buckling length, 4 members reported
    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
    [cage_frame.py]
2026-10-27 scout_layout v10: no rods on the carbon arms (Spark): 8 ties from receiver bosses, waist node pair, 52 rods
    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
    [cage_shell_nodes.stl, cage_shell_tubes.stl, cartridge_skid_closed_end__latch__tpu.stl, cartridge_skid_lead_end__latch__tpu.stl, cartridge_v6__latch.stl, cartridge_v6_strips__latch__tpu.stl, fc.stl, flow_mtf_02p.stl]
2026-10-27 box catch ramps: Scout v10 at c5b5790 (plane -49.62), shorter tail V, Scout pads |y| 52..96 at both ends, 20 high
    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
    [catch_ramps_concept.py]
2026-10-27 rod coupons v2: smaller bores, standing and sideways rows
    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
    [rod_coupon_3mm_v2.stl, rod_coupon_6mm_v2.stl]
2026-10-27 print README: rod coupon v1 superseded
    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
2026-10-27 print README: name the v1 coupon files
    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
2026-10-27 overseer layout v5: cameras placed so the head with both cameras is one print
    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
    [arm_1.stl, arm_2.stl, arm_3.stl, arm_4.stl, camera_left.stl, camera_right.stl, motor_1.stl, motor_2.stl]
2026-10-27 dimensions: camera row under 600 chars
    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
2026-10-27 scout_layout v10: cage ties root on a printed tie saddle bolted to the plate (review), alt core ties weighed, seat and band wording, 50 rods
    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
    [cage_shell_nodes.stl, cage_shell_tubes.stl, cartridge_skid_closed_end__latch__tpu.stl, cartridge_skid_lead_end__latch__tpu.stl, cartridge_v6__latch.stl, cartridge_v6_strips__latch__tpu.stl, fc.stl, flow_mtf_02p.stl]
2026-10-27 overseer head mount: one piece with both cameras, L2 moment load, struts to side nodes
    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
2026-10-27 overseer sockets: DEFAULT bores 6.1 / 3.1; nodes take the head struts
    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
2026-10-27 scout electronics v2: ckpt 1, placement x slide on scout_layout v9 (box keel carrier)
    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
    [belly_mount_tail_block__petg_.stl, radxa_standoffs__petg_.stl, tail_carrier__yoke___box_keel__petg_.stl, xr2_shelf__petg_.stl]
2026-10-27 overseer layout v5: head struts as links, report lines for the one-piece head
    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
    [arm_1.stl, arm_2.stl, arm_3.stl, arm_4.stl, motor_1.stl, motor_2.stl, motor_3.stl, motor_4.stl]
2026-10-27 overseer v5: review fixes (system section, cage alternatives, frame modes, summary, artifact labels)
    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
    [spokes__ties__keels__braces__head_struts.stl]
2026-10-27 box catch ramps: tip V cut back 15 from the tip node
    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
2026-10-27 scout_layout v11: Radxa flat in the tail bay, no low tail node (design center ramp check), 47 rods
    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
    [cage_shell_nodes.stl, cage_shell_tubes.stl, camera.stl, camera_cradle__printed.stl, camera_cradle_arms__printed.stl, camera_cradle_clips__printed.stl, cartridge_skid_closed_end__latch__tpu.stl, cartridge_skid_lead_end__latch__tpu.stl]
2026-10-27 rod coupons v2: print log, PETG plate sent to Gideon
    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
2026-10-27 rule: cage nodes PETG (Spark); overseer v5 review round 3 fixes (links part name, system_check rerun, head mode source)
    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
    [cage_frame.py, cage_node.py, head_mount.py, layout_v5.py]
2026-10-27 scout_layout v11: cage nodes PETG, sockets 3.1 DEFAULT (Spark rule via PR 122)
    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
2026-10-27 PR 122 review round 4 notes: bore rule wording, README nodes, buckling k note, tags
    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
2026-10-27 overseer core: UBEC and buck rest on the hub deck's 6.5 floor (hub deck v1 fit finding); fit 0 mm3
    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
    [buck_12_v.stl, ubec_5_v.stl]
2026-10-27 scout electronics v2: ckpt 2, stage 1-3 on scout_layout v10 (funnel line, flat Radxa option, rebuild)
    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
    [belly_mount_tail_block__petg.stl, belly_mount_tail_block__petg_.stl, cage_shell_nodes.stl, cage_shell_tubes.stl, camera.stl, camera_cradle__printed.stl, camera_cradle_arms__printed.stl, camera_cradle_clips__printed.stl]
2026-10-27 overseer hub deck v2 setup: drawn UBEC and buck seat rails with zip-tie tunnels (v1 left the UBEC 34 mm unsupported)
    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
2026-10-27 scout electronics v2: ckpt 3, iteration on the rebuilt shell, final recheck PASS, envelope
    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
    [belly_mount_tail_block__petg.stl, belly_mount_tail_block__petg_.stl, cage_shell_nodes.stl, cage_shell_tubes.stl, camera_cradle_arms__printed.stl, camera_cradle_clips__printed.stl, cartridge_skid_closed_end__latch__tpu.stl, cartridge_skid_lead_end__latch__tpu.stl]
2026-10-27 box catch ramps: one pad per Overseer tip edge from 35, yaw spec +-2.5 deg
    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
2026-10-27 box catch: hook catch concept page (flat deck, 4 servo hooks on the shared bottom nodes)
    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
2026-10-27 scout_layout v11: tail bay out of the prop wash (Radxa on edge in the centre strip, UBEC behind the disks), tail bay + catch scanned for the CG (Spark), 50 rods
    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
    [cage_shell_nodes.stl, cage_shell_tubes.stl, cartridge_skid_closed_end__latch__tpu.stl, cartridge_skid_lead_end__latch__tpu.stl, cartridge_v6__latch.stl, cartridge_v6_strips__latch__tpu.stl, fc.stl, flow_mtf_02p.stl]
2026-10-27 overseer arms v1: rod install check (--rodcheck)
    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
2026-10-27 ckpt 2: scout_layout v11 review fixes in progress (true centroids, CG score x+y, length term, wash line with plugs, README)
    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
    [layout_v3.py]
2026-10-27 box catch: hook catch with one servo (lift frame, sprung links, over-centre), keep-alive dropped
    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
2026-10-27 scout_layout v11: balance on true centroids and x+y with a length term (review), tail bay +25, catch 3.5, CG 0.8 / 0.9
    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
    [cage_shell_nodes.stl, cage_shell_tubes.stl, cartridge_skid_closed_end__latch__tpu.stl, cartridge_skid_lead_end__latch__tpu.stl, cartridge_v6__latch.stl, cartridge_v6_strips__latch__tpu.stl, fc.stl, flow_mtf_02p.stl]
2026-10-27 rule: socket bores 6.2 / 3.2 from the coupons (Spark)
    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
2026-10-27 scout electronics v2: ckpt 4, round 3 mount on v11 poses (WIP)
    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
2026-10-27 scout_layout v11: rod sockets 3.2 (Spark coupon pick)
    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
2026-10-27 overseer arms v1: rod bore 3.2 (coupon pick), arm v2 socket sizes noted
    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
2026-10-27 overseer arms v2: current layout (motors 5.6 forward), core keep-outs, bore 3.2; v1 inputs pinned
    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
    [apex___cam_bracket.stl, bottom_plate.stl, hub_electronics__fc__pi_5___deck__pdb__u.stl, top_plate.stl]
2026-10-27 rule: socket bores 6.2 / 3.2 (Spark's coupon pick), PETG nodes confirmed
    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
2026-10-27 cage_node: recut command, sockets to the current bores on a saved node without a rerun (Spark)
    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
2026-10-27 cage nodes: socket setup picture (nodes 18, 2)
    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
2026-10-27 scout_frame v1: Scout cage frame model (35 g crash, flight, handling, modes); all-3.0 fails, 6/4 on 38 members passes; Spark decides
    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
    [cage_frame.py]
2026-10-27 overseer arms v2: cage spoke node and L2 brace sockets with frame-model joint loads; envelope clamp
    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
2026-10-27 overseer arm rear v2: measured estimate (smoke)
    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
2026-10-27 overseer arm front v2: measured estimate (smoke)
    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
2026-10-27 scout_selfright v1: research: props cannot right the Scout; the three ways out (Spark question)
    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
2026-10-27 overseer layout v5: arm node link ends; frame model per-arm loads
    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
    [arm_1.stl, arm_2.stl, arm_3.stl, arm_4.stl, motor_1.stl, motor_2.stl, motor_3.stl, motor_4.stl]
2026-10-27 overseer_core v2: no sled (empty battery slot), keel front hub on the hub deck, flow clip under the front wing
    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
    [buck_12_v.stl, cartridge.stl, esc_cap.stl, fc_stack_micoair743-lite_on_55a_4-in-1.stl, flow_clip.stl, flow_mtf-02p.stl, hub_deck.stl, pack.stl]
2026-10-27 overseer arms v2: root joint options picture, DEFAULT fuse node
    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
2026-10-27 scout electronics v2: mount on the v11 tail-bay poses (review fixes: root fin + plate bolts, fuse first, moving funnel line, Ø8 posts), alt B, state rows
    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
    [belly_mount_tail_block__petg.stl, belly_mount_tail_block__petg_.stl, cage_shell_nodes.stl, cage_shell_tubes.stl, camera.stl, camera_cradle__printed.stl, camera_cradle_arms__printed.stl, camera_cradle_clips__printed.stl]
2026-10-27 overseer layout v5: keels 5 into the hub deck, front hub block off the head part (core v2)
    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
    [arm_1.stl, arm_2.stl, arm_3.stl, arm_4.stl, motor_1.stl, motor_2.stl, motor_3.stl, motor_4.stl]
2026-10-27 current-parts: layout row under 600 chars
    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
2026-10-27 overseer frame: arm spoke node fuse check (600 N cap / detach)
    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
2026-10-27 overseer arms v2: root joint assumed good (Spark), one printed part
    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
2026-10-27 PR 139 review: spokes ranked from the arm node, recut CLI and as-built ref, frame rerun
    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
    [arm_1.stl, arm_2.stl, arm_3.stl, arm_4.stl, motor_1.stl, motor_2.stl, motor_3.stl, motor_4.stl]
2026-10-27 PR 139 review: System Overseer rows and arm row, summary rerun numbers, rows and tags
    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
2026-10-27 scout_layout v12: the electronics mount's real tail bay (38.6 g + cables), UBEC 7 out, XR2 off the rear prop, catch 5.0 forward, CG 0.9 / 0.8; frame v2
    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
    [cage_shell_nodes.stl, cage_shell_tubes.stl, camera.stl, camera_cradle__printed.stl, camera_cradle_arms__printed.stl, camera_cradle_clips__printed.stl, cartridge_skid_closed_end__latch__tpu.stl, cartridge_skid_lead_end__latch__tpu.stl]
2026-10-27 overseer_core v2: review fixes (feet outside the slot, keel triangles, clip flange), alternatives picture, hub deck v3 setup, keel hub coupon, flow clip v1
    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
    [flow_clip.stl, hub_deck.stl, overseer_core_coupon_keel_hub_v2.stl, overseer_flow_clip_v1.stl]
2026-10-27 overseer_core v2: re-review PASS nits (bearing case, previews, cage ask numbers, docstring)
    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
2026-10-27 head mount: setup picture (one piece, running)
    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
2026-10-27 scout_layout v12: review fixes (bay-fixed alternative recorded, mount and XR2 wash, DEFAULT rod sizing for the pieces, numbers, clips still)
    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
    [layout_v3.py]
2026-10-27 box master: Nox Ground Unit artifact, top slot reserved for the landing, one session per box system
    Claude-Session: https://claude.ai/code/session_01EtHMZPwaEwEqxCkwFCWf7X
2026-10-27 rule: cage sessions keep their parts in sync and the artifact current (Spark)
    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
2026-10-27 box master: part session ids (restarted with the repo attached)
    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
2026-10-27 scout electronics v2: ckpt round 4 (mount on v12, WIP)
    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
    [cage_shell_nodes.stl, cage_shell_tubes.stl, camera.stl, camera_cradle__printed.stl, camera_cradle_arms__printed.stl, camera_cradle_clips__printed.stl, cartridge_skid_closed_end__latch__tpu.stl, cartridge_skid_lead_end__latch__tpu.stl]
2026-10-27 box master: Nox Ground Unit 3D from the real mesh files; part sessions stopped (no design yet)
    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
2026-10-27 scout_camera_mount v1: drawn one-piece mount (cradle, lens hood, truss arms, 4 snap clips) + stop collar, checks and frame model
    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
    [camera_mount_assembled.stl, scout_camera_mount_collar_v1.stl, scout_camera_mount_v1.stl, stop_collar_assembled.stl]
2026-10-27 scout_camera_mount v1: truss arms and knees (solid_check PASS), print pose, assembled recheck, motion and stills
    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
    [stop_collar_assembled_my.stl]
2026-10-27 scout electronics v2: round 4, mount on v12 (review fixes: yoke back, one-body root, plate bolts off the FC USB-C path, mesh sections, wash)
    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
    [belly_mount_tail_block__petg_.stl, radxa_standoffs__petg_.stl, tail_carrier__petg_.stl, tail_carrier__yoke___spine__petg_.stl, ubec_tray___cross_plate__petg_.stl, xr2_shelf__petg_.stl]
2026-10-27 overseer arm rear v3: more material, root pads to the plate corners; measured estimate
    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
2026-10-27 scout_camera_mount v1: summary, concept sheet, row, Camera dimensions, parts list, log
    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
2026-10-27 scout v3: saved camera mount v1 in the assembly and artifact; frame model v3 on the real mount
    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
2026-10-27 scout_camera_mount v1: review fixes (Ø12 board pads, bought washers, System line limit, no tube contact pairs, tags, notes)
    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
    [camera_mount_assembled.stl, scout_camera_mount_v1.stl]
2026-10-27 scout_camera_mount v1: saved mount in the Scout assembly and artifact (v20), frame model v3 on it, rows
    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
2026-10-27 scout_camera_mount v1: re-review nits (tags, 735 g, tube mass in the sized crash case, artifact subtitle and System line from the assembly; artifact v21)
    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
    [cage_frame.py, layout_v3.py, layout_v3_view.py]
2026-10-27 box catch concept F: push-bar catch check (one stepper, pads + side bars) and the 27 Oct research
    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
2026-10-27 overseer_hub_deck v4 setup: the arm session's real root envelope (v3's box cut the mid feet), feet Ø14, no boss end slivers
    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
    [hub_deck.stl]
2026-10-27 overseer arm rear v4: drawn root flanges; strength band check; measured estimate
    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
2026-10-27 overseer arm front v3: solid root block, flanges, rods raised; measured estimate
    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
2026-10-27 scout electronics v2: round 5 (no overlap, fit table without allowances, XR2 floor, sized on L, variant V8, CG 0.56/1.49 at -5.0)
    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
    [belly_mount_tail_block__petg_.stl, tail_carrier__petg_.stl]
2026-10-27 scout v3: electronics round 5 masses and Radxa post keep-outs in the assembly (scout_assembly_updates.py); artifact v22
    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
    [radxa_zero_3w_keepouts.stl]
2026-10-27 scout v3: review fixes (Carbon list, Mass and Strength sections, envelope source eda4f2fb, camera swap by variant)
    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
    [scout_assembly_updates.py]
2026-10-27 scout v3: tag the camera mass (review nit)
    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
2026-10-27 scout electronics v2: summary review notes (V3/V7 50 N column, plate key measure, open list order)
    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
2026-10-27 ckpt 10 (end, exit 0)
    [overseer_hub_deck.stl, overseer_hub_deck_view.stl]
2026-10-27 overseer_hub_deck v4: saved (print file, summary, assembled recheck); flow clip v1 READY
    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
    [hub_deck.stl, overseer_hub_deck_v4.stl]
2026-10-27 overseer_core v2: recheck on main's v5 manifest (unchanged: fit 0 for the core, 28 mm³ clip vs parked tie node)
    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
    [sensor_head_mount_without_front_hub.stl]
2026-10-27 overseer_hub_deck v5 setup: root webs under the Pi posts (PR 148 review); hub_deck_modes.py (first modes, keel socket stiffness)
    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
    [hub_deck_modes.py]
2026-10-27 overseer arms: front v3 strike 3, bed-fit picture
    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
2026-10-27 overseer_core v2: PR 148 review fixes (FE bolt reactions, Pi mount 100 Hz back with v4's 382 Hz, Ø14 feet in rows and coupon, coupons row)
    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
    [overseer_core_coupon_keel_hub_v2.stl]
2026-10-27 box catch concept F: rows fixed, model numbers in the docs, model limits stated (friction, x error vs the lead-in, deck size); dea0b51 sweep archived; rerun on the current drones started
    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
    [catch_bars_concept.py]
2026-10-27 box catch concept F: the Overseer yaw envelope as the first hand-off item, with the three ways to widen it
    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
2026-10-27 ckpt: sweep logs in progress (current drones)
    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
2026-10-27 overseer arms v5: 6/4 carbon tube chords front and rear (system pass); measured estimates; layout picture
    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
2026-10-27 box catch concept F: sweep on the current drones (Overseer v5 assembly, Scout v12), every failure class listed, page v2, PR body
    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
2026-10-27 overseer layout v5: L2 braces root on a top-plate socket block (off the front arms)
    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
    [arm_1.stl, arm_2.stl, arm_3.stl, arm_4.stl, motor_1.stl, motor_2.stl, motor_3.stl, motor_4.stl]
2026-10-27 box catch concept F: envelope and x-error statements match result.json, page on the current drones, rows fixed, sweep env recorded
    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
    [catch_bars_concept.py]
2026-10-27 overseer arms v5b: L2 braces off the front arm (top-plate block, cage session), cage arm_loads.json (rear 2354 N, front 1013 N)
    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
2026-10-27 box catch concept F: every statement from result.json (yaw bands, failure classes, x-error shares), old concept lines marked, row 10 history only
    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
2026-10-27 overseer layout v5: brace tube ends forward of the plate edge (core block)
    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
    [arm_1.stl, arm_2.stl, arm_3.stl, arm_4.stl, motor_1.stl, motor_2.stl, motor_3.stl, motor_4.stl]
2026-10-27 scout belly_mount v1: concept system pass (frame, receiver partner, plate bolts, FC on the AIO holes, flow by search)
    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
    [belly_mount__petg_.stl]
2026-10-27 box master: ground unit artifacts for catch concept F (PR 125): top board, deck footprint in the 3D scene
    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
2026-10-27 scout belly_mount v1: summary notes box catch concept F against the flow pose
    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
2026-10-27 overseer layout v5: L2 brace roots on the hub deck front tower (core v3 B)
    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
    [arm_1.stl, arm_2.stl, arm_3.stl, arm_4.stl, motor_1.stl, motor_2.stl, motor_3.stl, motor_4.stl]
2026-10-27 overseer frame: per-case keel and L2 brace forces for the core tower (core_root_forces.json)
    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
2026-10-27 overseer_core v3 concept: L2 braces on a front hub tower in the hub deck (B over a top-plate block A)
    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
    [buck_12_v.stl, cartridge.stl, esc_cap.stl, fc_stack_micoair743-lite_on_55a_4-in-1.stl, flow_clip.stl, flow_mtf-02p.stl, hub_deck.stl, pack.stl]
2026-10-27 overseer_core: assembly manifest from core v3 (the tower concept)
    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
2026-10-27 overseer_core v3 round 2: the tower's second chord (struts to pads under the top plate), alternatives on one basis with the cage's per-case forces, hub deck v6 setup (per-case root forces, contact by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
    [hub_deck.stl]
2026-10-27 overseer_core v3 round 3: the tower closed by deep side webs to 4 mid feet (pads dropped), 2 more feet (60, ±17); v6 setup to match
    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
    [hub_deck.stl]
2026-10-27 overseer_core v3: concept review PASS (round 3); latch ask for the slot-top pockets, log
    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
2026-10-27 overseer arms v5b: front OOM diagnosed (threaded Pardiso), single-thread rerun
    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
2026-10-27 scout belly_mount v1: round 2 (review): ESC side vents, flow bipod, options drawn, inserts 600 N with prying, plate holes, grommet requirement
    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
    [belly_mount__petg_.stl]
2026-10-27 overseer arms v5c: full-length tube sleeves + shoulder flanges (rear v5b: solid FAIL thin collars, cage crash 1.47 at the shoulder); rear v5b result; band script follows wrapper chains
    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
    [arm_links_view_v2.py, arm_strength_band.py, arm_topo_v5c.py]
2026-10-27 scout v3: belly mount v1 concept system model in the assembly; the view draws the assembly's parts; artifact v23
    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
    [fc.stl, flow_mtf-02p.stl]
2026-10-27 scout v3: review fixes (belly swap only their parts, no blanket cable pairs, FC clearances open, tags)
    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
    [scout_assembly_updates.py]
2026-10-27 nox/topo voxelise: rays in chunks (rear v5c solid check OOM at 1M faces); arm rebuild script
    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
2026-10-27 arm rebuild v5c: front or rear
    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
2026-10-27 overseer arms v5d: tip socket caps 2.5; rear gen 50
    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
2026-10-27 overseer arm rear v5d: estimate
2026-10-27 overseer frame: what-if root forces for lower brace roots (core session)
    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
2026-10-27 overseer_core v3: brace roots lowered to z 12 / 18 (DEFAULT: worst root force 190 vs 403 N, tipping 8 vs 20 N m; head 155 Hz); hub deck v8 setup
    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
    [hub_deck.stl]
2026-10-27 overseer layout v5: L2 brace roots low in the core tower
    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
    [arm_1.stl, arm_2.stl, arm_3.stl, arm_4.stl, motor_1.stl, motor_2.stl, motor_3.stl, motor_4.stl]
2026-10-27 overseer layout v5: saved cage nodes in the assembly (node 20); artifact rebuilt
    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
    [cage_node_20.stl, cage_shell_nodes.stl]
2026-10-27 ckpt 6 (end, exit 0)
    [overseer_arm_rear.stl, overseer_arm_rear_view.stl]
2026-10-27 overseer arm rear v5d: saved (solid PASS, 187 g, modes 435 Hz, cage crash 0.94 at the plate corner)
    [overseer_arm_rear_v5d.stl, overseer_arm_rear_v5d_mirror.stl]
2026-10-27 overseer layout v5: saved node 2 in the assembly; artifact rebuilt
    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
    [cage_node_2.stl, cage_shell_nodes.stl]
2026-10-27 overseer arm rear v5d: READY (row, log)
    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
2026-10-27 overseer layout v5: saved rear arm v5d in the assembly; artifact rebuilt
    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
    [arm_2.stl, arm_3.stl, overseer_arm_rear.stl]
2026-10-27 head mount: socket keep-out 1 past the boss end (v3 solid FAIL: specks at the socket rims)
    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
    [head_mount.py]
2026-10-27 overseer arm rear v5d: page artifact + System line in the summary
    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
2026-10-27 overseer arms v5d: system pass in dimensions, assembled system_check, summary tags + budget + System line
    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
    [arm_1_drone_frame.stl, arm_2_drone_frame.stl, arm_3_drone_frame.stl, arm_4_drone_frame.stl]
2026-10-27 overseer arm rear v5d: cage artifact link, balance plan
    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
2026-10-27 overseer arm rear v5d: HOLD (assembled balance gate), tags
    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
2026-10-27 arms row: do not print while HOLD
    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
2026-10-27 PR 153 review notes: decimated saved meshes in the layout's own folder, stills from the assembly, frame numbers, balance note, tags
    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
    [arm_2.stl, arm_3.stl, cage_node_2.stl, cage_node_20.stl, cage_shell_nodes.stl, overseer_arm_rear.stl, overseer_arm_rear_v5d.stl]
2026-10-27 overseer_hub_deck v9: saved (print file, summary, assembled recheck, modes and FE reactions); hub deck v4 print superseded
    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
    [hub_deck.stl, overseer_hub_deck_v4.stl, overseer_hub_deck_v9.stl]
2026-10-27 head on cage concept: head mode with the hub deck v9 socket springs (153 Hz PETG)
    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
2026-10-27 overseer_core v3: PR 148 review fixes (system line, cage sync, head mode 153.3 Hz, v9 rows, tags)
    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
2026-10-27 overseer v5: core parts in, base loop to z -79.9, front core ties forward, feet caps
    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
    [arm_1.stl, arm_2.stl, arm_3.stl, arm_4.stl, buck_12_v.stl, cage_shell_nodes.stl, cage_shell_tubes.stl, cartridge.stl]
2026-10-27 overseer v5: bay ties root on the core sled sides (y 56)
    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
    [arm_1.stl, arm_2.stl, arm_3.stl, arm_4.stl, motor_1.stl, motor_2.stl, motor_3.stl, motor_4.stl]
2026-10-27 overseer v5: summary, arm loads and rows for the loop drop
    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
2026-10-27 scout v3: Landing row takes the box catch F requirements (caps, sleeves)
    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
2026-10-27 cage nodes: solid boss floor 3.0 behind each socket (node 2 neck)
    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
2026-10-27 cage nodes: review fixes (seg, row, floor mass)
    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
    [cage_node.py]
2026-10-27 overseer_hub_deck v9: HOLD (Spark's look: drawn bulk at the socket mouths); back to the system pass
    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
2026-10-27 scout v3: Spark's decisions (3.0 rods everywhere, FC on top, camera mount v2 by topology) in the rows
    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
2026-10-27 head mount: solid socket floor 3.0 (v4 specks)
    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
2026-10-27 head mount: v4 result and socket floor picture
    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
2026-10-27 rule (Spark 27 Oct): saved parts go into their system as CAD, the system artifact republished with them (CLAUDE.md, generative.md, sessions.md, review 15)
    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
2026-10-27 overseer_core v3 (front hub system pass after Spark's look): no drawn filler, room behind the socket mouths, wires off the hub, cage's copies filtered; hub deck v10 setup
    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
    [wires.stl]
2026-10-27 overseer layout: stale saved nodes fall back to the placeholder
    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
    [cage_shell_nodes.stl]
2026-10-27 overseer_hub_deck v11 setup: a room round each socket to 3 short of its mouth, side-knock cases, setup picture
    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
    [hub_deck_setup_view.py]
2026-10-27 box master: every designed box component in the ground unit artifact (3D viewer in the master view, full latch sets, v1 stand, superseded catch)
    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
2026-10-27 overseer head v5 setup: no ring, no keels, system loads
    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
    [arm_1.stl, arm_2.stl, arm_3.stl, arm_4.stl, motor_1.stl, motor_2.stl, motor_3.stl, motor_4.stl]
2026-10-27 rule: drawn is attachment only (smoke room audit, precheck 16)
    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
2026-10-27 rule: drawn first (no topology run on a passing drawn part); node load lookup fix
    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
    [cage_node.py]
2026-10-27 overseer v5: rear core ties split to y ±12 (off the battery lead)
    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
    [arm_1.stl, arm_2.stl, arm_3.stl, arm_4.stl, motor_1.stl, motor_2.stl, motor_3.stl, motor_4.stl]
2026-10-27 ckpt: run progress
    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
    [cage_node_2.stl, cage_node_3.stl]
2026-10-27 overseer v5: third arm screw access (top only; bottom blocked by the receiver)
    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
    [cage_node_4.stl]
2026-10-27 overseer head: 3 rods to the cage (no braces, keels, struts)
    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
    [arm_1.stl, arm_2.stl, arm_3.stl, arm_4.stl, motor_1.stl, motor_2.stl, motor_3.stl, motor_4.stl]
2026-10-27 ckpt: node checks progress
    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
    [cage_node_10.stl, cage_node_5.stl, cage_node_6.stl, cage_node_7.stl]
2026-10-28 overseer core v4: no head load on the hub deck (cage: L2 on 3 rods), 6 feet, RX off arm 2's top screw
    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
    [buck_12_v.stl, cartridge.stl, esc_cap.stl, fc_stack_micoair743-lite_on_55a_4-in-1.stl, flow_clip.stl, flow_mtf-02p.stl, hub_deck.stl, links_without_keels_braces.stl]
2026-10-28 overseer core v4: cage-branch context, RX lead rerouted, rows cleaned, pads not rails, pictures + alternatives
    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
    [wires.stl]
2026-10-28 overseer v5c: rows and summary for the 3-rod head
    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
    [cage_node_11.stl, cage_node_13.stl]
2026-10-28 overseer v5c: third screw access gated to arm v8 + core v4; stopped sweep summaries
    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
2026-10-28 overseer v5c: head rows, naming and tags for the 3-rod head (review)
    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
    [sensor_head_mount__printed__drawn_bolt_a.stl]
2026-10-28 ckpt 5 (end, exit 0)
    [overseer_hub_deck.stl, overseer_hub_deck_view.stl]
2026-10-28 overseer_hub_deck v12: saved (core v4, no head load; 37.1 g, 432 Hz, solid PASS, assembled on main)
    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
    [hub_deck.stl, overseer_hub_deck_v12.stl, overseer_hub_deck_v9.stl, sensor_head_mount_without_front_hub.stl]
2026-10-28 cage nodes v4 drawn and saved files (pending v5 lighter walls); layout takes saved node masses
    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
    [arm_1.stl, arm_2.stl, arm_3.stl, arm_4.stl, cage_node_10.stl, cage_node_11.stl, cage_node_13.stl, cage_node_15.stl]
2026-10-28 ckpt: node v5 checks progress
    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
    [cage_node_4.stl]
2026-10-28 overseer head v5: buildable 3-rod set (bosses on exact keep-outs), L2 rolled 180, all sockets hold
    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
    [arm_1.stl, arm_2.stl, arm_3.stl, arm_4.stl, cage_node_10.stl, cage_node_5.stl, cage_node_6.stl, cage_node_7.stl]
2026-10-28 ckpt: cage nodes v5 checks
    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
    [cage_node_11.stl, cage_node_13.stl, cage_node_15.stl, cage_node_17.stl, cage_node_18.stl, cage_node_20.stl, cage_node_21.stl, cage_node_23.stl]
2026-10-28 overseer: cage nodes v5 saved (drawn first, 2.0 walls, 289 g); head v5 buildable 3-rod set, L2 rolled 180
    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
    [arm_1.stl, arm_2.stl, arm_3.stl, arm_4.stl, cage_node_10.stl, cage_node_11.stl, cage_node_13.stl, cage_node_15.stl]
2026-10-28 overseer: review fixes (system rows, nodes summary, tags, breaking-order exception)
    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
    [layout_v5.py]
2026-10-28 scout v3 layout v13 (running): node masses fitted to the saved nodes v2, camera mount at its saved mass, round 5 envelope
    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
2026-10-28 scout v3: assembly updates know which layout run each part was drawn on (stale parts stay out); view on v13
    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
2026-10-28 scout v3 layout v13: catch re-trimmed for the real node mass (2.2 aft), 58 rods on 19 nodes, CG 0.6 / 0.7; frame v4; v12 trimmed; artifact v25
    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
    [cage_shell_nodes.stl, cage_shell_tubes.stl, camera.stl, camera_cradle__printed.stl, camera_cradle_arms__printed.stl, camera_cradle_clips__printed.stl, cartridge_skid_closed_end__latch__tpu.stl, cartridge_skid_lead_end__latch__tpu.stl]
2026-10-28 scout v3 layout v13: review fixes (camera v1 for mass and pose only, v12 parts kept for the scripts, logs regenerated, foot caps in the node model, frame v4 with real node masses, tags); artifact v26
    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
    [cage_shell_nodes.stl, cage_shell_tubes.stl, camera.stl, camera_cradle__printed.stl, camera_cradle_arms__printed.stl, camera_cradle_clips__printed.stl, cartridge_skid_closed_end__latch__tpu.stl, cartridge_skid_lead_end__latch__tpu.stl]
